Yustnust/AQUA-EXPO/docs/O1CN01f1KN331kBSWhVPPSg_!!385014645.webp

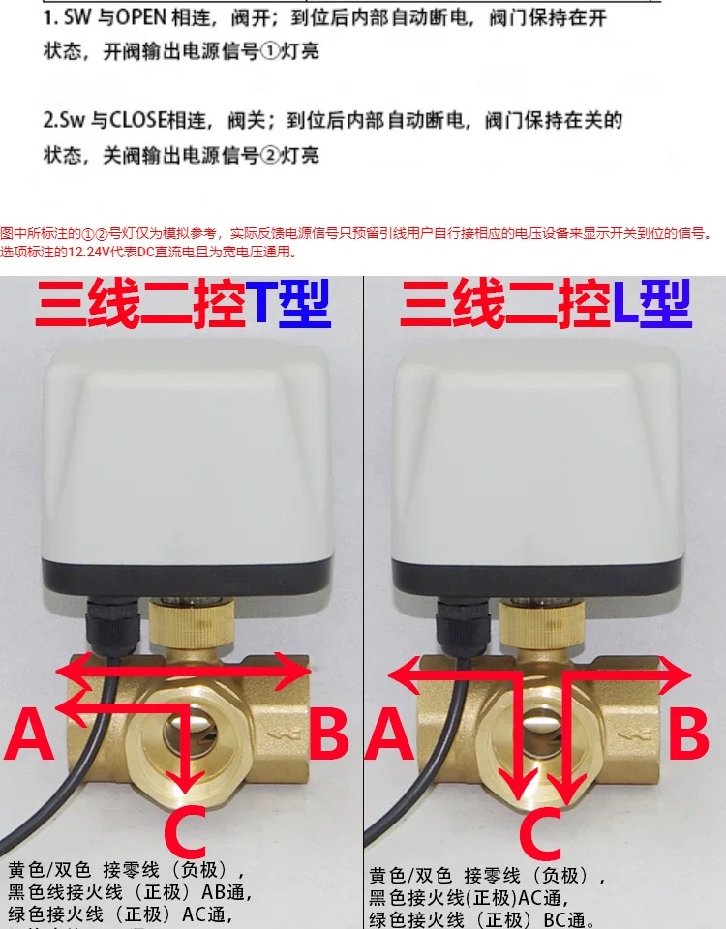
docs/O1CN01f1KN331kBSWhVPPSg_!!385014645.webp
