Yustnust/AQUA-EXPO/docs/picture/State_fail-1.jpg

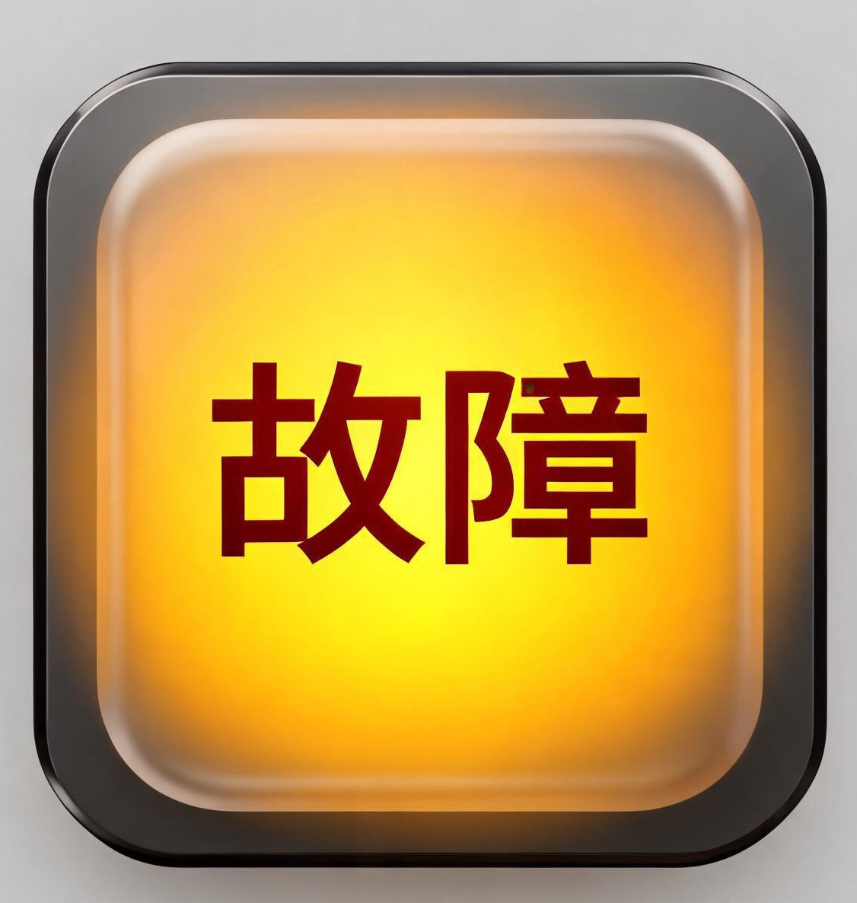
docs/picture/State_fail-1.jpg
