Yustnust/AQUA-EXPO/docs/需求追溯矩阵_v1.0.md

# 药液配置加注控制系统 — 需求追溯矩阵 v1.2

| 项目 | 内容 |
|---|---|
| 文档名称 | 需求追溯矩阵（RTM） |
| 版本号 | v1.2 |
| 编制日期 | 2026-07-18 |
| 修订日期 | 2026-08-27 |
| 修订内容 | v1.1: 新增 REQ-059;**v1.2: 新增 REQ-060 S4 等待计时、REQ-061 S4 等待超时报警、REQ-062 S6 转 S6 阈值补偿** |
| 适用范围 | 单套缸单元（8套架构中任一套，PLC程序完全相同，仅IP不同） |
| 修订日期 | 2026-08-27 |
| 修订内容 | 新增 REQ-059 S4 下缸空互锁需求;REQ-006(S4 上→下转移)实现说明补充 v1.1 互锁逻辑;测试用例基线增至 111 条(TC-04-013~017) |
| 追溯范围 | 需求 → Story → 代码（FC）→ 变量地址 → 测试用例 → 状态 |
| 配套文档 | 《药液配置加注控制系统_PLC设计文档》v9.3;《HMI-PLC变量地址表》v1.0;《SAT_FAT验收测试用例》v1.1;《项目交付文档总索引》v1.0;plc/stl/ 下20个FC源文件(v1.1) |
| PLC代码基线 | commit 48426d5(v1.0),v1.1 在 master 分支新增 S4 互锁 |
测试用例基线 | 114条(必测 109 + 选测 5)

---

## 0. 追溯范围说明与图例

### 0.1 追溯范围说明

本文档建立"需求→Story→代码→变量→测试用例→状态"的完整双向追溯链，覆盖：

1. **需求侧**：从《PLC设计文档》v9.3 第1~12章提取的功能需求（共58条，REQ-001~REQ-058）
2. **Story侧**：项目已规划的7个Story（Story 1.1~1.7，对应AQEX-2~AQEX-11，AQEX-1为项目设计文档定稿）
3. **代码侧**：plc/stl/ 下20个FC源文件（OB1 + FC0/1/2/3/4 + FC10~19 + FC30/31/32 + FC40）
4. **变量侧**：依据《HMI-PLC变量地址表》v1.0，逐FC映射关键变量地址（V区/I区/Q区/DT区）
5. **测试侧**：《SAT_FAT验收测试用例》v1.0 的106条用例（TC-03-001~TC-11-005）

### 0.2 状态图例

| 实现状态 | 含义 |
|---|---|
| ✅ 已实现 | 代码已完整实现该需求，逻辑正确 |
| 🟡 部分实现 | 代码骨架已搭建，但部分逻辑未完成（如FC4 Modbus轮询待Story 1.1填充） |
| ❌ 未实现 | 设计文档有要求，但代码尚未实现（如手动控制） |
| ➖ 不适用 | 该需求不在当前Story交付范围内 |

| 测试状态 | 含义 |
|---|---|
| ✅ 已覆盖 | 至少1条测试用例覆盖该需求 |
| ❌ 未覆盖 | 无任何测试用例覆盖该需求（风险项，见第6章） |

---

## 第1章 需求清单

从《PLC设计文档》v9.3 各章节提取的58条功能需求，每项含：需求ID、描述、来源章节、优先级、验收标准。

### 1.1 顶层状态机需求（REQ-001~REQ-011）

| 需求ID | 需求描述 | 来源（设计文档章节） | 优先级 | 验收标准 |
|---|---|---|---|---|
| REQ-001 | S0 初始化状态：上下缸状态强制置空，所有阀门/泵输出复位为OFF，等待HMI启动命令 | 第四章 S0 | 高 | VW2=0；V1.6=0；V1.7=0；QB0=0；CMD_Start上升沿转S1 |
| REQ-002 | S1 上缸进水：阀A开启，差值法计量进水量，达标关阀，漫溢监测 | 第四章 S1 | 高 | VW2=1；Q0.2=1；VD82=快照；VD90≥目标进水量→关阀 |
| REQ-003 | S2 潜水泵预循环搅拌：潜水泵1/2开启，按VD_S2_Target计时 | 第四章 S2 | 高 | VW2=2；Q0.0=1；Q0.1=1；T38≥VD_S2_Target→转S3 |
| REQ-004 | S3 加药：步数控制（VD_Dose_Steps）+Modbus下发抽/排液指令+状态码轮询 | 第四章 S3 | 高 | VW2=3；VW204/VW206写入步数；VW4=0→转S3.5 |
| REQ-005 | S3.5 静止等候：按VD_RestTime_Target计时沉降 | 第四章 S3.5 | 高 | VW2=4；T39≥VD_RestTime_Target→转S4 |
| REQ-006 | S4 上→下转移:阀B开启,四态诊断+液位计B漫溢保护,正常排空后转S5;**v1.1新增** 开阀B前需 V1.7=0(下缸已排空),否则静默等待 S6 排空后自动开阀,节拍保持并行 | 第四章 S4 | 高 | VW2=5;Q0.3=1;VW268=1→转S5;V1.7=1;DT10写入;**v1.1** `AN V1.7` 互锁;**v1.2** S4 等待时长记录到 VD380(VD_S4Wait_Time),S4 完成时清零;FC16 转 S6 阈值减去 VD380 补偿 |
| REQ-007 | S5 实验运行：换水周期计时（VD_S5_Elapsed）+实验时长累加+预规划上升沿触发 | 第四章 S5 | 高 | VW2=6；VD_S5_Elapsed累加；达周期→转S6；达实验时长→转S7 |
| REQ-008 | S6 下缸排水：阀C开启，四态诊断，正常排空后滚动更新VD_S6_Rolling并返回S5 | 第四章 S6 | 高 | VW2=7；Q0.4=1；VW270=1→转S5；VD78=实测时长；V1.7=0 |
| REQ-009 | S7 实验结束：状态机锁定，所有输出停，HMI确认CMD_Start才能回S0 | 第四章 S7 | 高 | VW2=8；QB0=0；CMD_Start上升沿→VW2=0 |
| REQ-010 | S_ERROR 故障锁定：急停/最高级报警触发，强制QB0=0，需系统复位 | 第四章 + 第九章 | 高 | VW2=99；QB0=0；V300.4置位；I0.3上升沿+I1.1=ON→回S0 |
| REQ-011 | 非法状态值处理：VW2为非法值（非0~8/99）时强制回S0 | FC1设计 | 中 | 强制VW2=50→下一扫描周期VW2=0 |

### 1.2 阀A诊断需求（REQ-012~REQ-015）

| 需求ID | 需求描述 | 来源（设计文档章节） | 优先级 | 验收标准 |
|---|---|---|---|---|
| REQ-012 | 阀A差值法计量：流量计无清零功能，阀A开瞬间快照VD_FlowMeter_Snapshot，差值计算进水量 | 第二章 + 第四章S1 + 第五章 | 高 | VD82=开阀瞬间值；VD90=VD86−VD82；VD90≥目标→关阀 |
| REQ-013 | 阀A关后延时验证4项并行：流量开关A=OFF / 内漏差值不增 / 关到位I8.1=ON / 关到位但仍有流交叉验证 | 第五章 | 高 | 4项全通过→VW266=1；任一失败→报警+S_ERROR |
| REQ-014 | 阀A开到位反馈交叉诊断：I8.0超时→V301.4；开到位但无流→V301.5 | 第五章 | 高 | I8.0超时→V301.4=1；I8.0=ON且I0.0=OFF→V301.5=1 |
| REQ-015 | 阀A漫溢保护：液位计A-高位I0.5=ON→关阀A+NC球阀上缸+报警 | 第五章 + 第八章 | 高 | I0.5=ON→V300.0=1；V300.2=1；Q0.5=1；Q0.2=0；VW2=99 |

### 1.3 阀B诊断需求（REQ-016~REQ-019）

| 需求ID | 需求描述 | 来源（设计文档章节） | 优先级 | 验收标准 |
|---|---|---|---|---|
| REQ-016 | 阀B四态诊断：流量开关B+液位计A-低位四态扫描，OFF+OFF→设备故障报警 | 第六章 阀B | 高 | I0.1=OFF且I0.6=OFF→V302.0=1+S_ERROR |
| REQ-017 | 阀B开关到位交叉诊断：I8.2开到位超时→V302.1；I8.3关到位但仍有流→V302.4 | 第六章 阀B | 高 | I8.2超时→V302.1；I8.3=ON且I0.1=ON→V302.4 |
| REQ-018 | 阀B超时保护：T53开到位超时+T54流量开关超时（两套独立判据） | 第六章 阀B | 高 | T53超时→V302.1；T54超时且I0.1=OFF→V302.2 |
| REQ-019 | 阀B漫溢保护：液位计B-高位I0.7=ON→关阀B+NC球阀下缸+报警 | 第六章 阀B | 高 | I0.7=ON→V300.1=1；V300.3=1；Q0.6=1；Q0.3=0；VW2=99 |

### 1.4 阀C诊断需求（REQ-020~REQ-022）

| 需求ID | 需求描述 | 来源（设计文档章节） | 优先级 | 验收标准 |
|---|---|---|---|---|
| REQ-020 | 阀C四态诊断：流量开关C+液位计B-低位四态扫描，OFF+OFF→设备故障报警 | 第六章 阀C | 高 | I0.2=OFF且I1.0=OFF→V302.5=1+S_ERROR |
| REQ-021 | 阀C开关到位交叉诊断：I8.4开到位超时→V302.6；I8.5关到位但仍有流→V303.1 | 第六章 阀C | 高 | I8.4超时→V302.6；I8.5=ON且I0.2=ON→V303.1 |
| REQ-022 | 阀C超时保护：T56开到位超时+T57流量开关超时（阀C无漫溢保护） | 第六章 阀C | 高 | T56超时→V302.6；T57超时且I0.2=OFF→V302.7 |

### 1.5 泵与Modbus通讯需求（REQ-023~REQ-026）

| 需求ID | 需求描述 | 来源（设计文档章节） | 优先级 | 验收标准 |
|---|---|---|---|---|
| ~~REQ-023~~ | ~~潜水泵1/2超时保护：启动后VD_Timeout_Pump1/2内流量开关未到→报警~~ | ~~第六章 泵超时~~ | ~~中~~ | **已移除**（潜水泵1/2流量开关取消，I0.3/I0.4不再使用） |
| REQ-024 | 注射泵Modbus寄存器读写：40002强停/40003复位/40006抽液/40007排液步数 | 第二章 + 第十一章 | 高 | VW200=1→40002=1；VW204=步数→40006；VW206=步数→40007 |
| REQ-025 | 注射泵状态码轮询：41001→VW4映射，0=完成/1=运行/2=抽液/3=排液/其他=错误→V303.4 | 第二章 + 第十一章 | 高 | VW4=0→可下发；VW4≥4→V303.4=1+S_ERROR |
| REQ-026 | 流量计Modbus差值法读取：0x0009累计值只读无清零，差值法计算 | 第二章 + 第十一章 | 高 | VD86=当前累计值；VD90=VD86−VD82 |

### 1.6 报警系统需求（REQ-027~REQ-034）

| 需求ID | 需求描述 | 来源（设计文档章节） | 优先级 | 验收标准 |
|---|---|---|---|---|
| REQ-027 | 32位报警字编码：VB300~VB303按位编码，HMI解析活动报警 | 第八章 8.1 + 变量表9.1 | 高 | 32位定义完整，VB300~303每位对应1个报警类型 |
| REQ-028 | 报警优先级链计算VW6：99>10~14>20~21>30~36>40~47>60~66 | 第八章 8.1 | 高 | 同步触发多个报警时VW6保存最高优先级 |
| REQ-029 | 消音逻辑：I0.4就地按钮或V0.4 HMI命令上升沿，仅关Q0.7声音，灯光报警保持 | 第八章 8.2 | 高 | I0.4/V0.4上升沿→Q0.7=0；Q8.0保持；V1.4=1握手 |
| REQ-030 | 消光逻辑：V0.3 HMI确认上升沿，根本原因消失才复位报警位+Q8.0 | 第八章 8.2 | 高 | V0.3上升沿+条件消失→R报警位；下周期VW6=0→Q8.0=0 |
| REQ-031 | 自动恢复模式（V200.0=0）：一般故障级条件消失自动复位 | 第八章 8.1 | 中 | V200.0=0时V301.x/V302.x/V303.x条件消失自动R |
| REQ-032 | 人工确认模式（V200.0=1）：一般故障级需HMI V0.3确认才复位 | 第八章 8.1 | 中 | V200.0=1时条件消失报警位保持，需V0.3确认 |
| REQ-033 | 高优先级强制人工确认：漫溢/节奏滞后/继电器故障不受V200.0模式影响 | 第八章 8.1 | 高 | V300.0~5/V300.6/7不受自动恢复影响，强制人工确认 |
| REQ-034 | 报警日志：新报警触发写入VB500~599缓冲区，含时间戳+单元+报警码+动作 | 第八章 8.3 | 低 | 新报警VW6由0变非0→VB500起写入日志条目 |

### 1.7 急停与安全需求（REQ-035~REQ-039）

| 需求ID | 需求描述 | 来源（设计文档章节） | 优先级 | 验收标准 |
|---|---|---|---|---|
| REQ-035 | 急停双通道：第一组常闭→安全继电器硬线切断动力；第二组常闭→I1.1 PLC感知 | 第九章 9.1 | 高 | I1.1=OFF→V300.4=1+VW2=99；硬线独立于PLC |
| REQ-036 | 安全继电器反馈延时校验：T35=2秒，2秒内I1.2=ON正常，超时→V300.5 | 第九章 9.2 | 高 | V300.4=1且I1.2=OFF→T35计时；T35到→V300.5=1 |
| REQ-037 | 继电器故障最高级报警（V300.5）：优先级99，不允许任何自动恢复 | 第九章 9.4 | 高 | V300.5=1→VW6=99；系统复位按钮无效 |
| REQ-038 | 急停解除+系统复位按钮（I0.3）：I1.1=ON+I0.3上升沿+V300.5=0→回S0 | 第九章 9.3 | 高 | 三条件全满足→V300.4=0；V1.6/V1.7=0；VW2=0 |
| REQ-039 | 继电器故障HMI高权限确认（V0.7+I1.2）：V0.7上升沿+I1.2=ON→清V300.5 | 第九章 9.4 | 高 | V0.7上升沿+I1.2=ON→R V300.5；I1.2=OFF则保持 |

### 1.8 节奏纠偏需求（REQ-040~REQ-044）

| 需求ID | 需求描述 | 来源（设计文档章节） | 优先级 | 验收标准 |
|---|---|---|---|---|
| REQ-040 | 三层纠偏算法：第0层压缩静止等候→第1层压缩S2→第2层顺延周期 | 第七章 7.2 | 高 | 三层额度VD162/VD166/VD170按序扣减，输出VD120/124/128 |
| REQ-041 | S5上升沿预规划触发：Available≤T_Rolling上升沿，本轮仅触发1次 | 第七章 7.2 | 高 | M10.7锁存；FC40模式0；本轮不再重复触发 |
| REQ-042 | S1完成后二次校正：用S1实测值重核VD_S2_Target/VD_RestTime_Target | 第七章 7.3 | 高 | VW266=1→FC40模式1；VW182=1；VD_T_Rolling更新 |
| REQ-043 | 节奏滞后人工介入报警（V300.6）：三层额度用尽→V300.6=1+VW2=99 | 第七章 7.4 | 高 | Δ>三层额度→V300.6=1；VW184=4；VW2=99 |
| REQ-044 | T_Rolling滚动更新：取标称值（S1实测+S2标称+S3估算+S3.5标称） | 第七章 7.5 | 中 | VD112=VD70+VD28+VD174+VD36（取标称不取压缩值） |

### 1.9 断电恢复需求（REQ-045~REQ-049）

| 需求ID | 需求描述 | 来源（设计文档章节） | 优先级 | 验收标准 |
|---|---|---|---|---|
| REQ-045 | 冷启动全部清零（V304.0=0）：VW2/V1.6/V1.7/QB0/V300~303/VW6/VW8清零 | 第十章 + FC0 | 高 | V304.0=0→全部清零；V304.0置1 |
| REQ-046 | 断电恢复状态策略：S0/S5/S7/S_ERROR保持，S1~S6转S_ERROR+V300.4 | 第十章 | 高 | VW2=1~5/7→VW2=99+V300.4=1+QB0=0 |
| REQ-047 | VD_S5_Elapsed重算：仅保持S5且下缸=满时VD178=RTC秒−DT10秒 | 第十章 + FC0 NETWORK6 | 高 | V1.7=1且VW2=6→VD178=VD186−VD190 |
| REQ-048 | RTC丢失检测：开机RTC<DT10→V303.5=1+S_ERROR，DT10未写入则跳过 | 第十章 | 高 | RTC<DT10→V303.5=1；VB10=0→跳过 |
| REQ-049 | 断电保持区配置：超级电容典型7天/最小6天保持 | 第十章 + 变量表附录A | 高 | VB0~9/10~149/150~199/200~229/300~304/500~599/DT10断电保持 |

### 1.10 换水周期与实验时长需求（REQ-050~REQ-052）

| 需求ID | 需求描述 | 来源（设计文档章节） | 优先级 | 验收标准 |
|---|---|---|---|---|
| REQ-050 | 下缸变满时间戳DT10：阀B正常关闭完成时READ_RTC写入DT10 | 第十章 | 高 | VW268=1→READ_RTC VB900→VB10~17 |
| REQ-051 | 实验时长累加：仅下缸=满期间VD96每分钟+1 | 第十章 | 高 | V1.7=1时T47每60秒→VD96+1；V1.7=0停止 |
| REQ-052 | 实验结束判定：VD96≥VD_ExperimentTarget→转S7 | 第四章 + 第十章 | 高 | VD96≥VD24→VW2=8；QB0=0；M10.6=1 |

### 1.11 手动控制与HMI接口需求（REQ-053~REQ-055）

| 需求ID | 需求描述 | 来源（设计文档章节） | 优先级 | 验收标准 |
|---|---|---|---|---|
| REQ-053 | HMI手动控制（V306.0~V307.3）：仅S0/S_ERROR响应，安全联锁仍生效 | 变量表4.4 | 中 | V306.0~V307.3上升沿+VW2=0/99→执行；联锁校验 |
| REQ-054 | 系统命令位V0区：CMD_Start/Stop/AckAlarm/Mute/ForceTank/SafetyRelayAck | 变量表4.1 | 高 | V0.0~V0.7上升沿+握手V1.x |
| REQ-055 | 系统状态位V1区握手：V1.0~V1.5命令确认，V1.6/V1.7上下缸状态 | 变量表4.2 | 高 | PLC置V1.x=1确认；HMI读V1.6/V1.7显示 |

### 1.12 漫溢保护与NC阀需求（REQ-056~REQ-058）

| 需求ID | 需求描述 | 来源（设计文档章节） | 优先级 | 验收标准 |
|---|---|---|---|---|
| REQ-056 | NC球阀-上缸失效安全保护：常闭型，阀A失效时第二道保护，得电打开/失电关闭 | 第二章 2.2 + 第五章 | 高 | I0.5=ON→Q0.5=1（得电打开保护）；失电关闭=安全 |
| REQ-057 | NC球阀-下缸失效安全保护：常闭型，阀B/液位计B报警时第二道保护 | 第二章 2.2 + 第六章 | 高 | I0.7=ON→Q0.6=1；失电关闭=安全 |
| REQ-058 | 故障态输出强制安全双保险：FC2 NETWORK3（急停锁存时）+FC19 NETWORK1（S_ERROR态）每周期强制QB0=0 | 第九章 + FC19 | 高 | V300.4=1或VW2=99→QB0=0；Q0.7=1声音 |
| REQ-059 | **v1.1新增** S4 下缸空互锁:FC15 进入 S4/开阀 B 前校验 V1.7=0,下缸未空时静默等待(不报错、不停机),每周期轮询直至 S6 排空完成自动放行;节拍保持并行——S1~S3.5 上缸配液可与 S6 下缸排水同时进行 | 第四章 S4 (v1.1) | 高 | V1.7=0 开阀B;V1.7=1 屏蔽本FC所有S/R/计时/赋值指令;每周期重检 |
| REQ-060 | **v1.2新增** S4 等待计时:FC15 NETWORK 1 等待计时分支,下缸未空期间 V1.7=1 持续时间累加到 VD_S4Wait_Time(VD380),S4 完成时清零 | 第四章 S4 (v1.2) | 高 | V1.7=1 期间 VD380 每秒 +1;S4 完成时 VD380=0 |
| REQ-061 | **v1.2新增** S4 等待超时报警:VD_S4Wait_Time >= VD_S4WaitTimeout(VD382,默认 1800s=30min)→ V303.2 + VW6=49;仅报警不强制 S_ERROR | 第四章 S4 (v1.2) | 高 | T61(100ms)到 → 置位 V303.2;VW6=49;S4 继续等待;操作员 HMI 提示 |
| REQ-062 | **v1.2新增** S5 转 S6 阈值补偿:FC16 NETWORK 4 转 S6 判据 = `VD_S5_Elapsed >= CycleSetpoint×60 - VD_S4Wait_Time`,保证下缸有效实验时间严格按 VD_CycleSetpoint 跑满,不被 S4 等待压缩 | 第四章 S5 (v1.2) | 高 | 阈值减去 VD380;S5 进入(V1.7=1 后)实际下缸跑满 VD_CycleSetpoint 后即转 S6 |
| REQ-059 | S4 下缸空互锁:v1.1 新增需求,FC15 进入 S4/开阀 B 前校验 V1.7=0,下缸未空时静默等待(不报错、不停机),每周期轮询直至 S6 排空完成自动放行;节拍保持并行——S1~S3.5 上缸配液可与 S6 下缸排水同时进行 | 第四章 S4 (v1.1) | 高 | V1.7=0 开阀B;V1.7=1 屏蔽本FC所有S/R/计时/赋值指令;每周期重检 |
---

## 第2章 Story清单

依据《项目交付文档总索引》v1.0 第三章（PLC程序规格书）与第四章（PLC程序代码），7个Story与AQEX编号对应关系如下：

| Story编号 | AQEX编号 | Story标题 | 覆盖的需求ID | 交付的FC文件 |
|---|---|---|---|---|
| Story 1.1 | AQEX-2 | Modbus通讯轮询详细设计 | REQ-024, REQ-025, REQ-026 | FC4_ModbusPolling.stl（**仅骨架，未完整交付**） |
| Story 1.2 | AQEX-6 | 状态机骨架 | REQ-001~011, REQ-050~052, REQ-054, REQ-055, REQ-058 | OB1_MAIN.stl, FC0_SysInit.stl, FC1_StateDispatcher.stl, FC2_EStopHandling.stl, FC3_AlarmHandling.stl, FC4_ModbusPolling.stl, FC10~FC18（共15个FC） |
| Story 1.3 | AQEX-7 | 阀门诊断 | REQ-012~022, REQ-056, REQ-057 | FC30_ValveA_Diag.stl, FC31_ValveB_Diag.stl, FC32_ValveC_Diag.stl（FC11/15/17集成调用） |
| Story 1.4 | AQEX-8 | 节奏纠偏 | REQ-040, REQ-041, REQ-042, REQ-043, REQ-044 | FC40_RhythmCorrection.stl（FC11/FC16集成调用） |
| Story 1.5 | AQEX-9 | 急停详细 | REQ-035, REQ-036, REQ-037, REQ-038, REQ-039 | FC2_EStopHandling.stl（改写）, FC19_State_Error.stl |
| Story 1.6 | AQEX-10 | 报警详细 | REQ-027, REQ-028, REQ-029, REQ-030, REQ-031, REQ-032, REQ-033, REQ-034 | FC3_AlarmHandling.stl（改写） |
| Story 1.7 | AQEX-11 | 断电恢复 | REQ-045, REQ-046, REQ-047, REQ-048, REQ-049 | FC0_SysInit.stl（改写为双路径） |
| Story 1.7 扩展 | AQEX-51 | PLC 长时间停机后 HMI 校时 | REQ-045 扩展（断电恢复时 RTC 异常不直接进 S_ERROR，置 V303.7 请求 HMI 校时，5 分钟超时后进 S_ERROR） | FC0_SysInit.stl（新增 RTC 合法性检查+DT10 合法性检查+请求校时分支）、FC22_RTC_Sync.stl（新增）、OB1_MAIN.stl（调度顺序调整）、McgsPro 侧 V303.7/V0.6/VB900~VB905 共 8 个变量 |

> **说明**：
> 1. AQEX-1 为项目需求与PLC设计文档v9.3定稿Story，无FC交付，本文档不单独追溯。
> 2. Story 1.1（AQEX-2）的FC4仅为骨架（MBUS_CTRL已调用，MBUS_MSG调用注释"待Story 1.1确认站号后填入"），完整Modbus轮询时序、错误处理、超时检测**未交付**，见第6章缺口。
> 3. Story 1.2~1.7 六个迭代已交付完整PLC程序，经2轮校验10个问题全修复（commit 48426d5）。

---

## 第3章 追溯矩阵（主表）

每行一个需求，列含：需求ID、需求描述、Story、实现FC、关键变量地址、测试用例、实现状态、测试状态、备注。

### 3.1 状态机主线（REQ-001~REQ-011）

| 需求ID | 需求描述 | Story | 实现FC | 关键变量地址 | 测试用例编号 | 实现状态 | 测试状态 | 备注 |
|---|---|---|---|---|---|---|---|---|
| REQ-001 | S0 初始化状态 | 1.2 | FC10_State_S0_Init.stl | VW2, V0.0, V1.0, V1.6, V1.7, QB0, VW6 | TC-04-001, TC-09-001 | ✅ 已实现 | ✅ 已覆盖 | 等HMI启动，无报警才转S1 |
| REQ-002 | S1 上缸进水 | 1.2 | FC11_State_S1_Inlet.stl | VW2, Q0.2, VD82, VD86, VD90, M10.2, T37 | TC-04-002, TC-04-003 | ✅ 已实现 | ✅ 已覆盖 | 调FC30诊断+FC40二次校正 |
| REQ-003 | S2 潜水泵预循环 | 1.2 | FC12_State_S2_PreMix.stl | VW2, Q0.0, Q0.1, VD120, VW252, T38 | TC-04-004 | ✅ 已实现 | ✅ 已覆盖 | A1修复：PT转换；潜水泵1/2流量开关取消，泵超时保护移除 |
| REQ-004 | S3 加药步数控制 | 1.2 | FC13_State_S3_Dosing.stl | VW2, VD10, VD14, VD18, VD90, VD98, VD102, VW204, VW206, VW4, V303.4, M10.3 | TC-04-005, TC-10-002, TC-10-003 | 🟡 部分实现 | ✅ 已覆盖 | 注射泵速度/复位/超时未实现（待Story 1.1） |
| REQ-005 | S3.5 静止等候 | 1.2 | FC14_State_S35_Rest.stl | VW2, VD124, VW254, T39 | TC-04-006 | ✅ 已实现 | ✅ 已覆盖 | A2修复：PT转换 |
| REQ-006 | S4 上→下转移 | 1.2 | FC15_State_S4_Transfer.stl | VW2, Q0.3, V1.6, V1.7, VW268, DT10, VD178, M10.7, VD50, VW274 | TC-04-007 | ✅ 已实现 | ✅ 已覆盖 | 调FC31诊断，记录DT10时间戳 |
| REQ-007 | S5 实验运行 | 1.2 | FC16_State_S5_Run.stl | VW2, V1.7, VD178, VD20, VD116, VD112, VD150, VD96, VD24, M10.7, T60, T47, V0.2 | TC-04-008, TC-06-008, TC-06-009 | ✅ 已实现 | ✅ 已覆盖 | 调FC40预规划，实验时长累加 |
| REQ-008 | S6 下缸排水 | 1.2 | FC17_State_S6_Drain.stl | VW2, Q0.4, VW270, VD78, VD116, V1.7, M10.6, VD54, VW276 | TC-04-009 | ✅ 已实现 | ✅ 已覆盖 | 调FC32诊断，更新VD_S6_Rolling |
| REQ-009 | S7 实验结束 | 1.2 | FC18_State_S7_End.stl | VW2, QB0, Q0.7, Q8.0, VD96, M10.6, V0.0 | TC-04-010, TC-04-011 | ✅ 已实现 | ✅ 已覆盖 | 锁定态，HMI确认重启 |
| REQ-010 | S_ERROR 故障锁定 | 1.2+1.5 | FC19_State_Error.stl, FC2_EStopHandling.stl | VW2, QB0, Q0.7, V300.4, V300.5, V0.7, I1.1, I1.2, I0.3, V1.6, V1.7 | TC-04-012, TC-07-001, TC-07-008 | ✅ 已实现 | ✅ 已覆盖 | 双保险强制QB0=0 |
| REQ-011 | 非法状态值强制回S0 | 1.2 | FC1_StateDispatcher.stl (NETWORK 12) | VW2 | TC-04-012 | ✅ 已实现 | ✅ 已覆盖 | ELSE分支MOVB 0,VB2 |

### 3.2 阀A诊断（REQ-012~REQ-015）

| 需求ID | 需求描述 | Story | 实现FC | 关键变量地址 | 测试用例编号 | 实现状态 | 测试状态 | 备注 |
|---|---|---|---|---|---|---|---|---|
| REQ-012 | 阀A差值法计量 | 1.2+1.3 | FC11_State_S1_Inlet.stl, FC30_ValveA_Diag.stl | VD82(快照), VD86(当前), VD90(差值), VD316(目标), VW260, VW266 | TC-04-002, TC-04-003, TC-10-006, TC-10-007 | ✅ 已实现 | ✅ 已覆盖 | 流量计无清零，差值法 |
| REQ-013 | 阀A关后延时验证4项 | 1.3 | FC30_ValveA_Diag.stl (NETWORK 7~9) | T51, VW280, VD308, VD312, I0.0, I8.1, V301.0, V301.1, V301.2, V301.3 | TC-05-003, TC-05-004, TC-05-005, TC-05-006 | ✅ 已实现 | ✅ 已覆盖 | 内漏阈值0.1L待现场整定 |
| REQ-014 | 阀A开到位反馈诊断 | 1.3 | FC30_ValveA_Diag.stl (NETWORK 4~5) | T50, VW278, I8.0, I0.0, T52, V301.4, V301.5 | TC-05-001, TC-05-002 | ✅ 已实现 | ✅ 已覆盖 | 2s延时确认避免瞬时波动 |
| REQ-015 | 阀A漫溢保护 | 1.3 | FC30_ValveA_Diag.stl (NETWORK 1) | I0.5, V300.0, V300.2, Q0.5, Q0.2, VW2 | TC-03-006 | ✅ 已实现 | ✅ 已覆盖 | 全程最高优先级，转S_ERROR |

### 3.3 阀B诊断（REQ-016~REQ-019）

| 需求ID | 需求描述 | Story | 实现FC | 关键变量地址 | 测试用例编号 | 实现状态 | 测试状态 | 备注 |
|---|---|---|---|---|---|---|---|---|
| REQ-016 | 阀B四态诊断 | 1.3 | FC31_ValveB_Diag.stl (NETWORK 6) | VW262, I0.1, I0.6, Q0.3, V302.0, VW268 | TC-05-007 | ✅ 已实现 | ✅ 已覆盖 | 状态4需排除瞬时，加延时确认（待现场） |
| REQ-017 | 阀B开关到位交叉诊断 | 1.3 | FC31_ValveB_Diag.stl (NETWORK 4, 7) | I8.2, I8.3, T53, T55, V302.1, V302.3, V302.4 | TC-05-008, TC-05-009 | ✅ 已实现 | ✅ 已覆盖 | 关到位但仍有流=内漏 |
| REQ-018 | 阀B超时保护 | 1.3 | FC31_ValveB_Diag.stl (NETWORK 4) | T53, T54, VW274, VD50, V302.1, V302.2 | TC-05-008 | ✅ 已实现 | ✅ 已覆盖 | 两套独立判据互相印证 |
| REQ-019 | 阀B漫溢保护 | 1.3 | FC31_ValveB_Diag.stl (NETWORK 1) | I0.7, V300.1, V300.3, Q0.6, Q0.3, VW2 | TC-03-008 | ✅ 已实现 | ✅ 已覆盖 | 不管四态处于哪个状态 |

### 3.4 阀C诊断（REQ-020~REQ-022）

| 需求ID | 需求描述 | Story | 实现FC | 关键变量地址 | 测试用例编号 | 实现状态 | 测试状态 | 备注 |
|---|---|---|---|---|---|---|---|---|
| REQ-020 | 阀C四态诊断 | 1.3 | FC32_ValveC_Diag.stl (NETWORK 5) | VW264, I0.2, I1.0, Q0.4, V302.5, VW270 | TC-05-010 | ✅ 已实现 | ✅ 已覆盖 | 阀C无漫溢保护 |
| REQ-021 | 阀C开关到位交叉诊断 | 1.3 | FC32_ValveC_Diag.stl (NETWORK 3, 6) | I8.4, I8.5, T56, T58, V302.6, V303.0, V303.1 | TC-05-011, TC-05-012 | ✅ 已实现 | ✅ 已覆盖 | VW270用MOVW写完整WORD |
| REQ-022 | 阀C超时保护 | 1.3 | FC32_ValveC_Diag.stl (NETWORK 3) | T56, T57, VW276, VD54, V302.6, V302.7 | TC-05-010 | ✅ 已实现 | ✅ 已覆盖 | 阀C无漫溢保护 |

### 3.5 泵与Modbus通讯（REQ-023~REQ-026）

| 需求ID | 需求描述 | Story | 实现FC | 关键变量地址 | 测试用例编号 | 实现状态 | 测试状态 | 备注 |
|---|---|---|---|---|---|---|---|---|
| ~~REQ-023~~ | ~~潜水泵1/2超时保护~~ | ~~1.2+1.3~~ | ~~FC12_State_S2_PreMix.stl (NETWORK 2)~~ | ~~Q0.0, Q0.1, I0.3, I0.4, T44, T45, VW282, VW284, VD58, VD62, V303.2, V303.3~~ | ~~TC-03-004, TC-03-005~~ | **已移除** | **已移除** | 潜水泵1/2流量开关取消，I0.3/I0.4不再使用 |
| REQ-024 | 注射泵Modbus寄存器读写 | 1.1+1.2 | FC4_ModbusPolling.stl, FC13_State_S3_Dosing.stl | VW200, VW202, VW204, VW206, VW208, VW210, VW212, M10.3 | TC-10-001, TC-10-002, TC-10-003, TC-10-005 | 🟡 部分实现 | ✅ 已覆盖 | FC4仅骨架，MBUS_MSG待填参数 |
| REQ-025 | 注射泵状态码轮询与故障 | 1.1+1.2 | FC4_ModbusPolling.stl, FC13_State_S3_Dosing.stl (NETWORK 3) | VW4, V303.4, VW2 | TC-10-004, TC-10-008 | 🟡 部分实现 | ✅ 已覆盖 | VW4≥4→V303.4已实现；超时检测未实现 |
| REQ-026 | 流量计Modbus差值法 | 1.1+1.2 | FC4_ModbusPolling.stl, FC11_State_S1_Inlet.stl, FC30_ValveA_Diag.stl | VD86, VD82, VD90, VW228 | TC-10-006, TC-10-007 | 🟡 部分实现 | ✅ 已覆盖 | FC4轮询骨架；差值法计算已实现 |

### 3.6 报警系统（REQ-027~REQ-034）

| 需求ID | 需求描述 | Story | 实现FC | 关键变量地址 | 测试用例编号 | 实现状态 | 测试状态 | 备注 |
|---|---|---|---|---|---|---|---|---|
| REQ-027 | 32位报警字编码 | 1.6 | FC3_AlarmHandling.stl (NETWORK 1) | VB300, VB301, VB302, VB303 | TC-08-001~012, TC-03-027, TC-03-028 | ✅ 已实现 | ✅ 已覆盖 | V303.7预留位见第6章 |
| REQ-028 | 报警优先级链VW6 | 1.6 | FC3_AlarmHandling.stl (NETWORK 1) | VW6, V300.0~V303.5 | TC-08-001, TC-08-002, TC-08-003 | ✅ 已实现 | ✅ 已覆盖 | JMP nCode10~nCode66逐位赋值 |
| REQ-029 | 消音逻辑 | 1.6 | FC3_AlarmHandling.stl (NETWORK 3) | I0.4, V0.4, Q0.7, M11.1, V1.4 | TC-08-004, TC-08-005, TC-08-006, TC-03-018 | ✅ 已实现 | ✅ 已覆盖 | I0.4/V0.4等效，新报警重鸣 |
| REQ-030 | 消光逻辑 | 1.6 | FC3_AlarmHandling.stl (NETWORK 4) | V0.3, V1.3, V300.0~V303.5 | TC-08-007, TC-08-008, TC-08-009, TC-08-010 | ✅ 已实现 | ✅ 已覆盖 | 条件消失才复位 |
| REQ-031 | 自动恢复模式 | 1.6 | FC3_AlarmHandling.stl (NETWORK 5) | V200.0, V301.x, V302.x, V303.x | TC-08-007, TC-08-012 | ✅ 已实现 | ✅ 已覆盖 | V200.0=0时条件消失自动R |
| REQ-032 | 人工确认模式 | 1.6 | FC3_AlarmHandling.stl (NETWORK 4~5) | V200.0, V0.3 | TC-08-008 | ✅ 已实现 | ✅ 已覆盖 | V200.0=1时不自动R，需V0.3 |
| REQ-033 | 高优先级强制人工确认 | 1.6 | FC3_AlarmHandling.stl (NETWORK 4~5) | V300.0~5, V300.6, V300.7 | TC-08-009 | ✅ 已实现 | ✅ 已覆盖 | 不受V200.0影响 |
| REQ-034 | 报警日志 | 1.6 | FC3_AlarmHandling.stl (NETWORK 6) | VB500~599, VW6, M11.2, VB508~510 | TC-08-011, TC-11-004 | 🟡 部分实现 | ✅ 已覆盖 | 简化版固定VB500起，完整环形缓冲区未实现 |

### 3.7 急停与安全（REQ-035~REQ-039）

| 需求ID | 需求描述 | Story | 实现FC | 关键变量地址 | 测试用例编号 | 实现状态 | 测试状态 | 备注 |
|---|---|---|---|---|---|---|---|---|
| REQ-035 | 急停双通道 | 1.5 | FC2_EStopHandling.stl (NETWORK 1) | I1.1, V300.4, VW2, M10.7 | TC-03-010, TC-07-001 | ✅ 已实现 | ✅ 已覆盖 | 硬线+PLC双通道独立 |
| REQ-036 | 安全继电器反馈延时T35 | 1.5 | FC2_EStopHandling.stl (NETWORK 2) | V300.4, I1.2, T35, V300.5 | TC-07-002, TC-07-003 | ✅ 已实现 | ✅ 已覆盖 | 2秒延时（PT=20×100ms） |
| REQ-037 | 继电器故障最高级报警 | 1.5 | FC2_EStopHandling.stl (NETWORK 2, 4), FC19_State_Error.stl (NETWORK 2) | V300.5, VW6 | TC-07-003, TC-08-001 | ✅ 已实现 | ✅ 已覆盖 | VW6=99最高优先级 |
| REQ-038 | 急停解除+系统复位按钮 | 1.5 | FC19_State_Error.stl (NETWORK 3) | I1.1, I0.3, V300.4, V300.5, V1.6, V1.7, VW2, VW6, Q0.7 | TC-07-004, TC-07-005, TC-03-019 | ✅ 已实现 | ✅ 已覆盖 | 三条件全满足才回S0 |
| REQ-039 | 继电器故障HMI高权限确认 | 1.5 | FC19_State_Error.stl (NETWORK 4) | V0.7, I1.2, V300.5 | TC-07-006, TC-07-007, TC-07-009 | ✅ 已实现 | ✅ 已覆盖 | V0.7+I1.2双确认 |

### 3.8 节奏纠偏（REQ-040~REQ-044）

| 需求ID | 需求描述 | Story | 实现FC | 关键变量地址 | 测试用例编号 | 实现状态 | 测试状态 | 备注 |
|---|---|---|---|---|---|---|---|---|
| REQ-040 | 三层纠偏算法 | 1.4 | FC40_RhythmCorrection.stl (NETWORK 1~5) | VD150, VD154, VD158, VD162, VD166, VD170, VD120, VD124, VD128, VW184, VD28, VD32, VD36, VD40, VD44 | TC-06-001, TC-06-002, TC-06-003, TC-06-004, TC-06-005 | ✅ 已实现 | ✅ 已覆盖 | 纯数学算法，第0/1/2层顺序扣减 |
| REQ-041 | S5上升沿预规划触发 | 1.4 | FC16_State_S5_Run.stl (NETWORK 2), FC40_RhythmCorrection.stl | VD150, VD112, M10.7, VW182, VW184, V1.6, V301.6 | TC-06-006, TC-06-010 | ✅ 已实现 | ✅ 已覆盖 | M10.7锁存，本轮只触发1次 |
| REQ-042 | S1完成后二次校正 | 1.4 | FC11_State_S1_Inlet.stl (NETWORK 3), FC40_RhythmCorrection.stl | VW266, VD150, VD154, VW182, VD120, VD124, VD174, VD112, VD70, VD28, VD36 | TC-06-007 | ✅ 已实现 | ✅ 已覆盖 | 用S1实测值重核 |
| REQ-043 | 节奏滞后人工介入报警 | 1.4 | FC40_RhythmCorrection.stl (NETWORK 5) | V300.6, VW184, VW2 | TC-06-005, TC-08-002 | ✅ 已实现 | ✅ 已覆盖 | 三层用尽→V300.6=1+VW2=99 |
| REQ-044 | T_Rolling滚动更新 | 1.4 | FC11_State_S1_Inlet.stl (NETWORK 3) | VD112, VD70, VD28, VD174, VD36 | TC-06-007, TC-11-002 | ✅ 已实现 | ✅ 已覆盖 | 取标称值不取压缩值 |

### 3.9 断电恢复（REQ-045~REQ-049）

| 需求ID | 需求描述 | Story | 实现FC | 关键变量地址 | 测试用例编号 | 实现状态 | 测试状态 | 备注 |
|---|---|---|---|---|---|---|---|---|
| REQ-045 | 冷启动全部清零 | 1.7 | FC0_SysInit.stl (NETWORK 2) | V304.0, VW2, V1.6, V1.7, QB0, QB1, V300.4, VB300~303, VW6, V1.0~V1.5, VW8, VD178, M10.7 | TC-09-001, TC-09-010 | ✅ 已实现 | ✅ 已覆盖 | V304.0=0走冷启动路径 |
| REQ-046 | 断电恢复状态策略 | 1.7 | FC0_SysInit.stl (NETWORK 7) | V304.0, VW2, QB0, V300.4 | TC-09-002, TC-09-003, TC-09-004, TC-09-005 | ✅ 已实现 | ✅ 已覆盖 | S0/S5/S7/S_ERROR保持，S1~S6转S_ERROR |
| REQ-047 | VD_S5_Elapsed重算 | 1.7 | FC0_SysInit.stl (NETWORK 4~6) | V1.7, VW2, VD186, VD190, VD178, VB900~907, VB10~17 | TC-09-002, TC-09-008 | ✅ 已实现 | ✅ 已覆盖 | P7修复：加VW2==6条件 |
| REQ-048 | RTC丢失检测 | 1.7 | FC0_SysInit.stl (NETWORK 3) | VB900~907, VB10~17, V303.5, VD178, VW2 | TC-09-006, TC-09-007 | ✅ 已实现 | ✅ 已覆盖 | VB10=0跳过检测 |
| REQ-049 | 断电保持区配置 | 1.7 | 系统块配置（非FC代码） | VB0~9, VB10~149, VB150~199, VB200~229, VB300~304, VB500~599, DT10 | TC-09-009, TC-11-003 | ✅ 已实现 | ✅ 已覆盖 | 超级电容典型7天/最小6天 |

### 3.10 换水周期与实验时长（REQ-050~REQ-052）

| 需求ID | 需求描述 | Story | 实现FC | 关键变量地址 | 测试用例编号 | 实现状态 | 测试状态 | 备注 |
|---|---|---|---|---|---|---|---|---|
| REQ-050 | 下缸变满时间戳DT10 | 1.2 | FC15_State_S4_Transfer.stl (NETWORK 3) | VW268, VB900~907, VB10~17 (DT10) | TC-04-007 | ✅ 已实现 | ✅ 已覆盖 | READ_RTC写入DT10 |
| REQ-051 | 实验时长累加 | 1.2 | FC16_State_S5_Run.stl (NETWORK 3) | V1.7, T47, VD96 | TC-04-010, TC-11-002 | ✅ 已实现 | ✅ 已覆盖 | 仅下缸=满期间累加 |
| REQ-052 | 实验结束判定 | 1.2 | FC16_State_S5_Run.stl (NETWORK 5), FC18_State_S7_End.stl | VD96, VD24, VW2, M10.6 | TC-04-010 | ✅ 已实现 | ✅ 已覆盖 | VD96≥VD24→VW2=8 |

### 3.11 手动控制与HMI接口（REQ-053~REQ-055）

| 需求ID | 需求描述 | Story | 实现FC | 关键变量地址 | 测试用例编号 | 实现状态 | 测试状态 | 备注 |
|---|---|---|---|---|---|---|---|---|
| REQ-053 | HMI手动控制（V2.4~V3.3） | 1.2（计划） | **无对应FC** | V2.4~V3.3 | 无 | ❌ 未实现 | ❌ 未覆盖 | 见第6章缺口，需新增FC |
| REQ-054 | 系统命令位V0区 | 1.2 | FC10_State_S0_Init.stl, FC16_State_S5_Run.stl, FC3_AlarmHandling.stl, FC18_State_S7_End.stl, FC19_State_Error.stl | V0.0, V0.2, V0.3, V0.4, V0.7, V1.0~V1.5 | TC-04-002, TC-04-011, TC-08-005, TC-08-008, TC-07-007 | ✅ 已实现 | ✅ 已覆盖 | V0.1暂停/V0.5/V0.6预留 |
| REQ-055 | 系统状态位V1区握手 | 1.2 | 各状态FC | V1.0~V1.5, V1.6, V1.7 | TC-04-001, TC-04-002, TC-04-007 | ✅ 已实现 | ✅ 已覆盖 | V1.6/V1.7上下缸状态 |

### 3.12 漫溢保护与NC阀（REQ-056~REQ-058）

| 需求ID | 需求描述 | Story | 实现FC | 关键变量地址 | 测试用例编号 | 实现状态 | 测试状态 | 备注 |
|---|---|---|---|---|---|---|---|---|
| REQ-056 | NC球阀-上缸失效安全 | 1.3 | FC30_ValveA_Diag.stl (NETWORK 1) | I0.5, Q0.5, V300.2 | TC-03-006, TC-03-025 | ✅ 已实现 | ✅ 已覆盖 | 常闭型，得电打开保护 |
| REQ-057 | NC球阀-下缸失效安全 | 1.3 | FC31_ValveB_Diag.stl (NETWORK 1) | I0.7, Q0.6, V300.3 | TC-03-008, TC-03-026 | ✅ 已实现 | ✅ 已覆盖 | 常闭型，得电打开保护 |
| REQ-058 | 故障态输出强制安全双保险 | 1.5 | FC2_EStopHandling.stl (NETWORK 3), FC19_State_Error.stl (NETWORK 1) | V300.4, VW2, QB0, Q0.7 | TC-07-008 | ✅ 已实现 | ✅ 已覆盖 | FC2+FC19双保险 |

---

## 第4章 代码-需求反向追溯

每个FC（共20个）对应实现的需求ID，确认无"游离FC"（无需求对应的代码）。

| FC文件名 | 功能描述 | Story | 实现的需求ID | 关键NETWORK | 反向追溯结论 |
|---|---|---|---|---|---|
| OB1_MAIN.stl | PLC主循环调度 | 1.2 | REQ-001~058（间接，调度所有FC） | NETWORK 1~5：FC0→FC2→FC4→FC3→FC1 | ✅ 非游离FC（调度入口） |
| FC0_SysInit.stl | 系统初始化（冷启动+断电恢复） | 1.2+1.7 | REQ-045, REQ-046, REQ-047, REQ-048, REQ-049 | NW1判路径/NW2冷启动/NW3 RTC检测/NW4~5 BCD转秒/NW6 Elapsed重算/NW7状态策略/NW8完成 | ✅ 非游离FC |
| FC1_StateDispatcher.stl | 状态机调度 | 1.2 | REQ-001~011（间接，按VW2调度各状态FC） | NW1状态比较/NW2~12各状态入口/NW12非法态处理 | ✅ 非游离FC |
| FC2_EStopHandling.stl | 急停处理 | 1.2+1.5 | REQ-035, REQ-036, REQ-037, REQ-058 | NW1急停检测锁存/NW2 T35延时校验/NW3输出强制安全/NW4报警码 | ✅ 非游离FC |
| FC3_AlarmHandling.stl | 报警处理 | 1.2+1.6 | REQ-027, REQ-028, REQ-029, REQ-030, REQ-031, REQ-032, REQ-033, REQ-034 | NW1优先级链/NW2输出管理/NW3消音/NW4消光确认/NW5自动恢复/NW6日志 | ✅ 非游离FC |
| FC4_ModbusPolling.stl | Modbus轮询骨架 | 1.2（1.1待完成） | REQ-024, REQ-025, REQ-026（🟡 部分实现） | NW1 MBUS_CTRL/NW2轮询骨架（MBUS_MSG参数待填） | 🟡 非游离FC，但仅骨架 |
| FC10_State_S0_Init.stl | S0初始化态 | 1.2 | REQ-001, REQ-054 | NW1安全输出/NW2启动命令检测 | ✅ 非游离FC |
| FC11_State_S1_Inlet.stl | S1上缸进水 | 1.2+1.3+1.4 | REQ-002, REQ-012, REQ-042, REQ-044 | NW1首次进入（快照+开阀）/NW2调FC30/NW3诊断结果+二次校正+转S2 | ✅ 非游离FC |
| FC12_State_S2_PreMix.stl | S2预循环 | 1.2 | REQ-003 | NW1开泵+PT转换/NW2转S3 | ✅ 非游离FC |
| FC13_State_S3_Dosing.stl | S3加药 | 1.2 | REQ-004, REQ-025 | NW1计算步数/NW2下发指令/NW3轮询状态码 | ✅ 非游离FC |
| FC14_State_S35_Rest.stl | S3.5静止等候 | 1.2 | REQ-005 | NW1 PT转换+启动T39/NW2转S4 | ✅ 非游离FC |
| FC15_State_S4_Transfer.stl | S4上→下转移 | 1.2+1.3+1.4 | REQ-006, REQ-050 | NW1首次进入（开阀B+PT转换）/NW2调FC31/NW3诊断结果+DT10+清Elapsed+转S5 | ✅ 非游离FC |
| FC16_State_S5_Run.stl | S5实验运行 | 1.2+1.4 | REQ-007, REQ-041, REQ-051, REQ-052, REQ-054 | NW1 Elapsed累加/NW2 Available+预规划/NW3实验时长累加/NW4换水周期转S6/NW5实验结束转S7/NW6手动停止 | ✅ 非游离FC |
| FC17_State_S6_Drain.stl | S6下缸排水 | 1.2+1.3 | REQ-008 | NW1首次进入（开阀C+PT转换）/NW2调FC32/NW3诊断结果+更新S6_Rolling/NW4排水后转S5或S7 | ✅ 非游离FC |
| FC18_State_S7_End.stl | S7实验结束 | 1.2 | REQ-009, REQ-054 | NW1安全停机/NW2 HMI确认重启 | ✅ 非游离FC |
| FC19_State_Error.stl | S_ERROR故障态 | 1.2+1.5 | REQ-010, REQ-038, REQ-039, REQ-058 | NW1输出强制安全/NW2继电器故障检测/NW3系统复位按钮/NW4 V0.7高权限确认 | ✅ 非游离FC |
| FC30_ValveA_Diag.stl | 阀A诊断 | 1.3 | REQ-012, REQ-013, REQ-014, REQ-015, REQ-056 | NW1漫溢保护/NW2子状态调度/NW3 S0空闲/NW4 S1等开到位/NW5 S2开启完成/NW6 S3运行中差值法/NW7 S5延时验证/NW8 4项校验/NW9结果判定 | ✅ 非游离FC |
| FC31_ValveB_Diag.stl | 阀B诊断 | 1.3 | REQ-016, REQ-017, REQ-018, REQ-019, REQ-057 | NW1漫溢保护/NW2子状态调度/NW3 S0空闲/NW4 S1等开到位/NW5 S2开启完成/NW6 S3四态诊断/NW7 S4等关到位 | ✅ 非游离FC |
| FC32_ValveC_Diag.stl | 阀C诊断 | 1.3 | REQ-020, REQ-021, REQ-022 | NW1子状态调度/NW2 S0空闲/NW3 S1等开到位/NW4 S2开启完成/NW5 S3四态诊断/NW6 S4等关到位 | ✅ 非游离FC |
| FC40_RhythmCorrection.stl | 节奏纠偏 | 1.4 | REQ-040, REQ-041, REQ-042, REQ-043 | NW1计算三层额度/NW2判断是否需纠偏/NW3第0层扣减/NW4第1层扣减/NW5第2层扣减/NW6无需纠偏/NW7结束 | ✅ 非游离FC |

**反向追溯结论**：20个FC全部可追溯到至少1个需求，**无游离FC**。FC4虽为骨架，但已对应REQ-024/025/026，待Story 1.1完整实现。

---

## 第5章 测试-需求覆盖统计

### 5.1 覆盖率统计

| 统计项 | 数值 |
|---|---|
| 需求总数 | 58 |
| 有测试覆盖的需求数 | 57 |
| 无测试覆盖的需求数 | 1 |
| 测试覆盖率 | **98.3%**（57/58） |
| 测试用例总数 | 106 |
| 必测用例数 | 101 |
| 选测用例数 | 5 |

### 5.2 各Story测试用例分布

| Story | 测试章节 | 用例ID范围 | 用例数 |
|---|---|---|---|
| 通用 | 第三章 DI/DO点位 | TC-03-001~028 | 28 |
| Story 1.2 | 第四章 状态机 | TC-04-001~012 | 12 |
| Story 1.3 | 第五章 阀门诊断 | TC-05-001~012 | 12 |
| Story 1.4 | 第六章 节奏纠偏 | TC-06-001~010 | 10 |
| Story 1.5 | 第七章 急停 | TC-07-001~009 | 9 |
| Story 1.6 | 第八章 报警 | TC-08-001~012 | 12 |
| Story 1.7 | 第九章 断电恢复 | TC-09-001~010 | 10 |
| Story 1.1/1.2 | 第十章 Modbus通讯 | TC-10-001~008 | 8 |
| Story 1.2~1.7 | 第十一章 长时稳定性 | TC-11-001~005 | 5 |
| **合计** | | | **106** |

### 5.3 无测试覆盖的需求（风险项）

| 需求ID | 需求描述 | 实现状态 | 风险说明 | 建议补测 |
|---|---|---|---|---|
| REQ-053 | HMI手动控制（V306.0~V307.3） | ✅ 已实现（FC20+FC21） | v1.8已修复VW2地址重叠，PLC侧实现完毕；缺TC-手动控制章节 | 待补TC：手开阀A/B/C、手启泵1/2、注射泵单次/循环、联锁校验（阀B需上满下空、阀C需下满） |

### 5.4 有实现但测试覆盖偏弱的需求（提示项）

| 需求ID | 需求描述 | 现有测试 | 偏弱说明 |
|---|---|---|---|
| REQ-024/025/026 | Modbus通讯 | TC-10-001~008 | FC4为骨架，测试用例假设完整实现，待Story 1.1完成后回归 |
| REQ-034 | 报警日志 | TC-08-011, TC-11-004 | 仅简化版固定VB500起，完整环形缓冲区未实现 |
| REQ-056/057 | NC球阀 | TC-03-025, TC-03-026（仅DO点位） | 缺NC阀失效安全场景测试（断电失电关闭验证） |

---

## 第6章 缺口与风险

### 6.1 未实现需求

| 需求ID | 需求描述 | 缺口说明 | 影响等级 | 责任Story | 整改建议 |
|---|---|---|---|---|---|
| REQ-053 | HMI手动控制（V306.0~V307.3） | 设计文档变量表4.4定义了12个手动命令位（v1.8地址从V2.4~V3.7迁移至V306.0~V307.3以避开VW2状态机重叠，详见变量表v1.8历史背景），FC20_ManualControl.stl已实现阀门/泵10个命令位响应（开/关阀A/B/C、启/停潜水泵1/2），FC21_ManualSyringePump.stl已实现注射泵2个命令位响应（启动/停止） | 高 | ✅ 已实现（FC20+FC21） | 仅S0态响应；安全联锁校验（阀B需上缸满下缸空、阀C需下缸满）；McgsPro CSV导入"通道地址"列须同步改为3（VB306/VB307） |
| V303.6 | ~~流量开关瞬时异常（M_Alarm_FlowSwitch_Instant）~~ | **已删除（2026-09-08）** | N/A | **已删除** | 三个流量开关各自有独立报警位（V301.0~V303.1），不再需要汇总抖动检测 |
| FC4 Modbus完整轮询 | REQ-024/025/026完整实现 | FC4_ModbusPolling.stl仅MBUS_CTRL初始化+骨架，MBUS_MSG参数（站号/地址/功能码/Done位处理/超时检测）注释"待Story 1.1确认站号后填入" | 高 | Story 1.1（AQEX-2）未交付 | 完成FC4：注射泵站号0x01+流量计站号0x02，轮询时序基于Done位顺序执行，超时2000ms/1000ms |

### 6.2 未测试需求

| 需求ID | 需求描述 | 未测试原因 | 风险 |
|---|---|---|---|
| REQ-053 | HMI手动控制 | 见6.1，未实现故无测试 | HMI手动调试页无法验收 |

### 6.3 需求变更待确认项

| 待确认项 | 来源 | 当前状态 | 影响 |
|---|---|---|---|
| IP地址规划 | 设计文档12.2 + 变量表12.1 | 示例网段192.168.2.101~108，"需现场网络环境确认后定型" | 影响HMI连接配置，不影响PLC程序 |
| PLC↔HMI通讯协议 | 变量表12.4 | S7协议（推荐）或Modbus TCP，"待HMI选型（AQEX-24）确认" | 影响HMI驱动选择，不影响PLC程序 |
| HMI品牌型号 | 设计文档12.6 | 昆仑通态MCGS（二轮确认中），变量点数/报警容量待确认 | 影响HMI组态，不影响PLC程序 |
| 注射泵单步分辨率（VD_StepResolution） | 设计文档11.1 + 变量表6.1 | 默认0.2083µL/步（5ml进样器），"需按实际选配进样器容量规格核实" | 影响加药精度，VD18为HMI可调参数 |
| 流量计实际配置单位（0x0012） | 设计文档11.3 + 变量表14.1 | 默认0x03=升L，"需现场读取确认" | 影响差值法单位，VW228可现场读 |
| 流量计"计量值"寄存器溢出行为 | 设计文档11.4 | 长期运行溢出行为（回绕/停止/报错）待厂商确认 | 长时运行（>数月）可能影响差值法 |
| 阀A内漏阈值0.1L | FC30 NETWORK 8 | "阈值暂定0.1L=100ml，现场整定" | 影响内漏报警灵敏度 |
| 阀B四态诊断状态4瞬时排除 | FC31 NETWORK 6 | "需排除刚开始转移时的瞬时，简化：直接判定状态4" | 转移初期可能误报警，需加延时确认 |
| 注射泵速度参数映射 | 变量表8.4 | VD132/136/140与40009/40010/40011对应关系"已确认"，但FC13未写入速度参数 | 影响注射泵抽排速度曲线 |

### 6.4 技术债务

| 项目 | 说明 | 来源文档 |
|---|---|---|
| FC4 Modbus轮询未完整 | Story 1.1未交付，FC4仅骨架 | FC4注释 + 第6.1章 |
| 报警日志环形缓冲区未完整 | FC3 NETWORK 6简化版固定VB500起，未用指针AR1实现6条环形 | FC3 NETWORK 6注释 |
| ~~V303.6流量开关瞬时异常未置位~~ | **2026-09-08已删除** | 第6.1章 |
| 手动控制未实现 | V2.4~V3.3无FC处理 | 第6.1章 |
| V303.7预留报警位 | 变量表9.1标注"预留扩展"，无对应需求 | 变量表 |

---

## 第7章 追溯链示例

挑3个典型需求完整展示"需求→Story→FC→NETWORK→变量→测试用例→状态"全链。

### 7.1 示例1：阀A差值法计量（REQ-012）

```
【需求】REQ-012 阀A差值法计量
   │ 来源：PLC设计文档v9.3 第二章（流量计Modbus寄存器表）+ 第四章S1 + 第五章
   │ 描述：流量计"计量值"寄存器(0x0009)持续累加、只读、无清零功能，
   │       阀A开启瞬间快照VD_FlowMeter_Snapshot，进水过程差值计算本次进水量
   │ 验收标准：VD82=开阀瞬间值；VD90=VD86−VD82；VD90≥目标进水量→关阀
   │ 优先级：高
   ↓
【Story】Story 1.2 状态机骨架（AQEX-6）+ Story 1.3 阀门诊断（AQEX-7）
   │ Story 1.2 交付FC11骨架，Story 1.3 交付FC30完整诊断（含差值法）
   ↓
【FC】FC11_State_S1_Inlet.stl + FC30_ValveA_Diag.stl
   │ FC11负责状态转移调度，FC30负责诊断（含差值法）
   ↓
【NETWORK】
   │ FC11 NETWORK 1（S1首次进入）：
   │   MOVD VD86, VD82     ← 快照流量计当前值到VD_FlowMeter_Snapshot
   │   S    Q0.2, 1        ← 开阀A
   │ FC30 NETWORK 6（子状态3运行中）：
   │   MOVD VD86, AC0       ← 读当前累计值
   │   -D   VD82, AC0       ← 减快照值
   │   MOVD AC0, VD90       ← 写入VD_Current_InletVolume
   │   AR>= VD90, VD316     ← 比较≥目标进水量
   │   R    Q0.2, 1         ← 达标关阀A
   │   MOVD VD86, VD308     ← 快照关阀瞬间值（供内漏检测）
   ↓
【变量】
   │ VD82  = VD_FlowMeter_Snapshot（阀A开启瞬间快照，断电保持）
   │ VD86  = VD_FlowMeter_Current（流量计当前累计值，Modbus 0x0009映射）
   │ VD90  = VD_Current_InletVolume（本次进水量=VD86−VD82）
   │ VD308 = VD_FlowMeter_CloseSnapshot（关阀瞬间快照，供内漏检测）
   │ VD316 = 目标进水量（HMI设定）
   │ Q0.2  = 阀A DO输出
   │ VW260 = 阀A诊断子状态（3=运行中）
   │ VW266 = 阀A诊断结果（0进行中/1正常/2故障）
   ↓
【测试用例】
   │ TC-04-002 S0→S1启动转移：验证VD82=流量计当前值（快照）
   │ TC-04-003 S1→S2进水完成转移：模拟流量计累计值增长使VD90≥目标进水量
   │ TC-10-006 流量计计量值差值法读取：VD82=开阀瞬间值；VD90随累计值增长递增
   │ TC-10-007 流量计无清零功能验证：0x0009无清零指令，只能用差值法
   ↓
【状态】✅ 已实现 / ✅ 已覆盖（4条测试用例）
   │ 备注：流量计无清零功能已确认（v8），差值法为唯一可行方案
```

### 7.2 示例2：阀B四态诊断（REQ-016）

```
【需求】REQ-016 阀B四态诊断
   │ 来源：PLC设计文档v9.3 第六章 阀B
   │ 描述：阀B关闭逻辑持续扫描流量开关B(I0.1)+液位计A-低位(I0.6)四态：
   │   状态1：流量开关B=ON  且 液位计A-低位=OFF  → 正常转移中
   │   状态2：流量开关B=ON  且 液位计A-低位=ON   → 上缸即将排空
   │   状态3：流量开关B=OFF 且 液位计A-低位=ON   → 上缸已排空 → 允许关阀B
   │   状态4：流量开关B=OFF 且 液位计A-低位=OFF  → 设备故障 → 报警
   │ 验收标准：I0.1=OFF且I0.6=OFF→V302.0=1+S_ERROR
   │ 优先级：高
   ↓
【Story】Story 1.3 阀门诊断（AQEX-7）
   ↓
【FC】FC31_ValveB_Diag.stl
   │ 调用方：FC15_State_S4_Transfer.stl（S4状态）
   ↓
【NETWORK】
   │ FC31 NETWORK 1（漫溢保护，优先级最高）：
   │   LD  I0.7  →  S V300.1, S V300.3, S Q0.6, R Q0.3, VW2=99
   │ FC31 NETWORK 6（子状态3运行中-四态诊断）：
   │   状态3：LD I0.6, AN I0.1 → R Q0.3（关阀B）, VW262=4（等关到位）
   │   状态4：LD I0.1, NOT, AN I0.6 → S V302.0, VW2=99, VW268=2
   │   状态1/2：LD I0.1 → JMP nDiagB_End（继续转移中）
   ↓
【变量】
   │ I0.1  = DI_FlowSwitch_B（流量开关B，无源常开）
   │ I0.6  = DI_LevelA_Low（液位计A-低位，无源常开）
   │ I0.7  = DI_LevelB_High（液位计B-高位，漫溢保护）
   │ Q0.3  = DO_ValveB（阀B）
   │ Q0.6  = DO_NCValve_Bottom（NC球阀下缸）
   │ VW262 = Diag_State_B（阀B诊断子状态，0~4）
   │ VW268 = Diag_Result_B（阀B诊断结果，0/1/2）
   │ V300.1 = M_Alarm_Overflow_BHigh（下缸漫溢，漫溢级）
   │ V300.3 = M_Alarm_NCValve_Bottom（NC阀下缸动作，漫溢级）
   │ V302.0 = M_Alarm_ValveB_Diag（阀B四态诊断异常，一般级）
   ↓
【测试用例】
   │ TC-05-007 阀B四态诊断异常（OFF/OFF设备故障）报警：
   │   模拟I0.1=OFF且I0.6=OFF → V302.0=1, VW2=99, VW6=40
   │ TC-03-007 DI_LevelA_Low点位测试（I0.6基础验证）
   │ TC-03-002 DI_FlowSwitch_B点位测试（I0.1基础验证）
   │ TC-03-008 DI_LevelB_High点位测试（漫溢保护基础验证）
   │ TC-05-008 阀B开到位超时报警（关联REQ-017/018）
   │ TC-05-009 阀B关到位但仍有流（内漏，关联REQ-017）
   ↓
【状态】✅ 已实现 / ✅ 已覆盖（6条测试用例）
   │ 备注：状态4判定"简化：直接判定状态4"，转移初期瞬时未加延时确认，
   │       FC31注释"需排除刚开始转移时的瞬时"，为已知技术债务（见第6.3章）
```

### 7.3 示例3：断电恢复（REQ-046）

```
【需求】REQ-046 断电恢复状态策略
   │ 来源：PLC设计文档v9.3 第十章 + FC0设计
   │ 描述：重新上电后根据VW2原值分类处理：
   │   S0(0)/S5(6)/S7(8)/S_ERROR(99) → 可恢复，保持原状态
   │   S1(1)/S2(2)/S3(3)/S3.5(4)/S4(5)/S6(7) → 转S_ERROR（阀门/泵动作中断不安全）
   │ 验收标准：VW2=1~5/7→VW2=99+V300.4=1+QB0=0
   │ 优先级：高
   ↓
【Story】Story 1.7 断电恢复（AQEX-11）
   │ 改写FC0_SysInit.stl为双路径（冷启动+断电恢复）
   ↓
【FC】FC0_SysInit.stl
   │ 调用方：OB1_MAIN.stl NETWORK 1（SM0.1首次扫描）
   ↓
【NETWORK】
   │ FC0 NETWORK 1（判断冷启动/断电恢复）：
   │   LD V304.0  →  JMP nWarmStart（V304.0=1断电恢复路径）
   │ FC0 NETWORK 2（冷启动路径，V304.0=0）：
   │   全部清零（VW2/V1.6/V1.7/QB0/V300.4/VB300~303/VW6/V1.0~V1.5/VW8/VD178/M10.7）
   │ FC0 NETWORK 3（断电恢复-RTC检测）：
   │   READ_RTC VB900，逐字段BCD比较RTC vs DT10
   │   RTC<DT10 → V303.5=1, VW2=99（RTC丢失）
   │   DT10=0（未写入）→ 跳过检测
   │ FC0 NETWORK 4~5（BCD转秒）：
   │   VD186 = RTC秒（时×3600+分×60+秒）
   │   VD190 = DT10秒
   │ FC0 NETWORK 6（VD_S5_Elapsed重算）：
   │   LD V1.7, AW= VW2, 6 → VD178 = VD186 − VD190（仅保持S5且下缸满时）
   │   P7修复：加VW2==6条件，避免V1.7=1但VW2已转S_ERROR时错误重算
   │ FC0 NETWORK 7（状态机恢复策略）：
   │   AW= VW2, 0  →  JMP nStateOK（保持S0）
   │   AW= VW2, 6  →  JMP nStateOK（保持S5，Elapsed已重算）
   │   AW= VW2, 8  →  JMP nStateOK（保持S7锁定态）
   │   AW= VW2, 99 →  JMP nStateOK（保持S_ERROR）
   │   其他（S1~S6）→ nStateError：QB0=0, VW2=99, V300.4=1
   │ FC0 NETWORK 8（初始化完成）：S V304.0, 1（置位InitDone）
   ↓
【变量】
   │ V304.0 = M_InitDone（初始化完成标志，断电保持）
   │ VW2    = 状态机当前状态
   │ V1.7   = M_TankB_State（下缸状态，1=满）
   │ V300.4 = M_EStop_Latch（急停锁存）
   │ V303.5 = M_Alarm_RTC_Lost（RTC丢失报警）
   │ VD178  = VD_S5_Elapsed（下缸满计时器，秒）
   │ VD186  = VD_RTC_Now_Sec（RTC转换总秒数）
   │ VD190  = VD_DT10_Sec（DT10转换总秒数）
   │ VB900~907 = RTC读取结果（BCD）
   │ VB10~17   = DT10下缸变满时间戳（BCD）
   │ QB0       = DO输出（强制安全）
   ↓
【测试用例】
   │ TC-09-001 冷启动全部清零（V304.0=0）→ 全部清零，V304.0置1
   │ TC-09-002 断电恢复保持S5（无阀门动作可恢复）→ VD_S5_Elapsed重算，VW2保持6
   │ TC-09-003 断电恢复S1阀A动作中断转S_ERROR → QB0=0, VW2=99, V300.4=1
   │ TC-09-004 断电恢复状态策略矩阵（S2/S3/S3.5/S4/S6转S_ERROR）→ 每态均VW2=99+V300.4=1
   │ TC-09-005 断电恢复S7保持（锁定态可恢复）→ VW2保持8
   │ TC-09-006 RTC丢失检测（V303.5）→ RTC<DT10时V303.5=1, VW2=99, VW6=65
   │ TC-09-007 RTC正常但DT10未写入跳过检测 → 不触发V303.5
   │ TC-09-008 下缸空时VD_S5_Elapsed不重算 → V1.7=0时VD178保持0
   │ TC-09-009 断电保持区数据保持验证 → VD10~VD66参数值保持不变
   │ TC-09-010 超级电容失效（>7天）走冷启动 → V304.0=0
   │ TC-11-003 断电恢复3次验证（S5/S1/S3态断电）→ S5恢复保持，S1/S3转S_ERROR
   ↓
【状态】✅ 已实现 / ✅ 已覆盖（11条测试用例）
   │ 备注：BCD转秒用当天秒数（时×3600+分×60+秒），跨天场景需补天数×86400，
   │       FC0注释"换水周期通常同天内，本版用当天秒数"，跨天为已知限制
```

---

## 附录A：需求与Story交叉矩阵

| Story | 覆盖需求ID | 需求数 |
|---|---|---|
| Story 1.1（AQEX-2，未完整交付） | REQ-024, REQ-025, REQ-026 | 3（部分实现） |
| Story 1.2（AQEX-6） | REQ-001~011, REQ-050~052, REQ-054, REQ-055, REQ-058 | 18 |
| Story 1.3（AQEX-7） | REQ-012~022, REQ-056, REQ-057 | 13 |
| Story 1.4（AQEX-8） | REQ-040~044 | 5 |
| Story 1.5（AQEX-9） | REQ-035~039, REQ-058 | 6 |
| Story 1.6（AQEX-10） | REQ-027~034 | 8 |
| Story 1.7（AQEX-11） | REQ-045~049 | 5 |
| 未分配Story | REQ-053（手动控制） | 2（未实现） |

> 注：部分需求被多个Story协同实现（如REQ-058由Story 1.2+1.5实现，REQ-012由Story 1.2+1.3实现），上表按主交付Story归类。

## 附录B：关键变量速查（追溯核对用）

| 地址 | 符号 | 含义 | 关联需求 |
|---|---|---|---|
| VW2 | 状态机 | 0=S0,1=S1...8=S7,99=S_ERROR | REQ-001~011 |
| VW4 | 注射泵状态码 | 映射41001 | REQ-025 |
| VW6 | 报警码 | 99>10~14>20~21>30~66 | REQ-028 |
| VW8 | 实验轮次 | 每完成S1~S6累加1 | REQ-007 |
| V0.0/V0.2/V0.3/V0.4/V0.7 | 命令位 | 启动/停止/确认/消音/继电器确认 | REQ-054 |
| V1.6/V1.7 | 上下缸状态 | 0=空,1=满 | REQ-055 |
| V200.0 | M_AlarmAckMode | 0=自动恢复,1=人工确认 | REQ-031/032 |
| V300.0~V300.7 | 报警字1 | 漫溢/NC阀/急停/继电器故障/节奏滞后 | REQ-015/019/027/035~037/043 |
| V301.0~V301.6 | 报警字2 | 阀A类故障 | REQ-013/014 |
| V302.0~V302.7 | 报警字3 | 阀B/C类故障 | REQ-016~022 |
| V303.0~V303.5 | 报警字4 | 阀C关类/泵/注射泵/RTC | REQ-021/022/023/025/048 |
| V304.0 | M_InitDone | 0=冷启动,1=断电恢复 | REQ-045/046 |
| VD82/VD86/VD90 | 流量计差值法 | 快照/当前/差值 | REQ-012 |
| VD96 | VD_ExperimentDuration_Accum | 实验时长累加 | REQ-051/052 |
| VD112/VD116 | VD_T_Rolling/VD_S6_Rolling | 滚动时长 | REQ-044 |
| VD120/VD124/VD128 | 纠偏目标 | S2/S3.5/周期顺延 | REQ-040 |
| VD178 | VD_S5_Elapsed | 下缸满计时 | REQ-041/047 |
| DT10 | DT_TankB_FullTime | 下缸变满时间戳 | REQ-050 |

---

**文档版本**：v1.0
**编制日期**：2026-07-18
**修订日期**：2026-08-27
**配套文档版本**：PLC设计文档v9.3、HMI-PLC变量地址表v1.0、SAT_FAT验收测试用例v1.1、项目交付文档总索引v1.0
**下次更新触发**：
1. Story 1.1（Modbus通讯）完整交付后，更新REQ-024/025/026状态为已实现
2. 手动控制Story新增后，更新REQ-053状态并补充测试用例
3. ~~V303.6流量开关瞬时异常~~ **2026-09-08已删除**
4. FAT/SAT执行后根据实测反馈修订追溯状态
5. 需求变更（IP/协议/HMI选型确认）时同步更新第6.3章
6. **v1.1新增** 后续 S4 互锁超时报警(S4-01 场景,P2 建议)实现后，更新 REQ-059 验收标准
