Yustnust/AQUA-EXPO/docs/项目交付文档总索引_v1.0.md

# 药液配置加注控制系统 — 项目交付文档总索引 v1.2

**项目**: 药液配置与加注控制系统(AQUA-EXPO)
**用途**: 项目全部交付文档的分类目录+用途说明+查阅指引,作为交付查阅入口
**文档总数**: 25份(不含历史版本achieve目录)
**更新日期**: 2026-07-15

---

## 一、文档分类总览

| 类别 | 文档数 | 用途 | 目录 |
|---|---|---|---|
| 1. 核心设计文档 | 3 | 项目设计依据,贯穿全周期 | docs/ |
| 2. PLC程序规格书 | 7 | 各Story详细设计规格 | plc/spec/ |
| 3. PLC程序代码 | 20 | STL源代码 | plc/stl/ |
| 4. PLC校验与测试 | 2 | 代码校验与验收测试 | docs/ |
| 5. HMI准备材料 | 11 | HMI组态实施准备 | docs/hmi_preparation/ |
| 6. 现场调试准备 | 3 | 调试与验收流程 | docs/commissioning/ |
| 7. 设备资料 | 4 | 注射泵/流量计协议 | 注射泵/、流量计/ |

---

## 二、核心设计文档(docs/)

| # | 文档名 | 版本 | 用途 | 查阅场景 |
|---|---|---|---|---|
| 1 | 药液配置加注控制系统_PLC设计文档.md | v9.3 | **项目设计总纲**,含系统概述/IO分配/状态机/阀门诊断/纠偏机制/报警/断电恢复 | 理解整体设计、IO地址、状态机流程 |
| 2 | HMI-PLC变量地址表_v1.0.md | v1.0 | HMI与PLC全部变量地址映射,PLC开发和HMI组态的共同接口契约 | 查变量地址、报警位定义、Modbus寄存器 |
| 3 | HMI画面架构规划文档.md | v9.3 | 8画面架构规划,画面层级与导航结构 | 理解HMI画面整体架构 |

---

## 三、PLC程序规格书(plc/spec/)

| # | 文档名 | Story | 用途 |
|---|---|---|---|
| 4 | Story1.2_状态机骨架_程序设计规格书_v1.2.md(文件名沿用 v1.0) | AQEX-6 | S0~S7+S_ERROR状态机+FC1调度+OB1架构;v1.1 含 S4 下缸空互锁 |
| 5 | Story1.2_状态机骨架_LAD梯形图说明_v1.0.md | AQEX-6 | 状态机LAD梯形图补充说明 |
| 6 | Story1.3_阀门诊断_程序设计规格书_v1.0.md | AQEX-7 | 阀A/B/C四态诊断+限位反馈交叉诊断 |
| 7 | Story1.4_节奏纠偏_程序设计规格书_v1.0.md | AQEX-8 | 三层纠偏(静止压缩→S2压缩→周期顺延) |
| 8 | Story1.5_急停详细_程序设计规格书_v1.0.md | AQEX-9 | 急停双通道+安全继电器反馈+FC19故障态 |
| 9 | Story1.6_报警详细_程序设计规格书_v1.0.md | AQEX-10 | 报警分级+消音消光+优先级编码+FC3 |
| 10 | Story1.7_断电恢复_程序设计规格书_v1.0.md | AQEX-11 | 断电保持+RTC检测+状态恢复+FC0双路径 |

---

## 四、PLC程序代码(plc/stl/)

| # | 文件名 | 功能 | Story |
|---|---|---|---|
| 11 | OB1_MAIN.stl | 主程序,调度FC1~FC4 | 1.2 |
| 12 | FC0_SysInit.stl | 系统初始化(冷启动/断电恢复双路径) | 1.2+1.7 |
| 13 | FC1_StateDispatcher.stl | 状态机调度器 | 1.2 |
| 14 | FC2_EStopHandling.stl | 急停处理 | 1.5 |
| 15 | FC3_AlarmHandling.stl | 报警处理(优先级链+消音消光) | 1.6 |
| 16 | FC4_ModbusPolling.stl | Modbus轮询(注射泵+流量计) | 1.2 |
| 17 | FC10_State_S0_Init.stl | S0初始化态 | 1.2 |
| 18 | FC11_State_S1_Inlet.stl | S1上缸进水(差值法) | 1.2 |
| 19 | FC12_State_S2_PreMix.stl | S2预循环 | 1.2 |
| 20 | FC13_State_S3_Dosing.stl | S3加药(步数控制) | 1.2 |
| 21 | FC14_State_S35_Rest.stl | S3.5静止等候 | 1.2 |
| 22 | FC15_State_S4_Transfer.stl | S4上→下转移 | 1.2 |
| 23 | FC16_State_S5_Run.stl | S5实验运行(换水周期) | 1.2 |
| 24 | FC17_State_S6_Drain.stl | S6下缸排水 | 1.2 |
| 25 | FC18_State_S7_End.stl | S7实验结束 | 1.2 |
| 26 | FC19_State_Error.stl | S_ERROR故障态 | 1.5 |
| 27 | FC30_ValveA_Diag.stl | 阀A诊断 | 1.3 |
| 28 | FC31_ValveB_Diag.stl | 阀B诊断 | 1.3 |
| 29 | FC32_ValveC_Diag.stl | 阀C诊断 | 1.3 |
| 30 | FC40_RhythmCorrection.stl | 节奏纠偏计算 | 1.4 |

---

## 五、PLC校验与测试(docs/)

| # | 文档名 | 用途 | 查阅场景 |
|---|---|---|---|
| 31 | PLC代码完整性校验报告_v1.0.md | 2轮静态校验,10个问题全修复记录 | 代码质量追溯、修复记录查阅 |
| 32 | SAT_FAT验收测试用例_v1.1.md | 106个验收测试用例(9组,含 v1.1 新增 TC-04-013~017) | 现场SAT/FAT验收执行 |

---

## 六、HMI准备材料(docs/hmi_preparation/)

### 6.1 选型无关材料(7份)

| # | 文档名 | 用途 |
|---|---|---|
| 33 | HMI变量导入CSV模板.csv | 91变量×7字段,组态时批量导入 |
| 34 | 报警字32位解析映射表.md | 32位报警×11字段(触发/复位/处置) |
| 35 | 画面变量绑定清单.md | 8画面253个UI元素绑定 |
| 36 | HMI组态导入说明.md | 选型适配+12步组态流程 |
| 37 | HMI画面布局线框图_v1.0.md | 8画面ASCII线框+1280×800布局规范 |
| 38 | HMI用户权限矩阵_v1.0.md | L1/L2/L3三级权限×功能交叉表 |
| 39 | 报警现场处置操作指引_v1.0.md | 32条报警×4步法+恢复时间 |

### 6.2 选型相关材料(4份,昆仑通态MCGS)

| # | 文档名 | 用途 |
|---|---|---|
| 40 | HMI选型技术问询单与备选方案对比_v1.0.md | 厂商4项必答+3款HMI对比(一轮) |
| 41 | HMI数据量估算与存储时长测算_v1.0.md | 241MB/年,4GB可存8.3年 |
| 42 | 昆仑通态MCGS二轮确认问询单_v1.0.md | 7项未明确技术细节确认 |
| 43 | 昆仑通态MCGS组态实施指南_v1.0.md | MCGS具体组态(8连接/变量/画面/脚本) |

---

## 七、现场调试准备(docs/commissioning/)

| # | 文档名 | 用途 | 查阅场景 |
|---|---|---|---|
| 44 | PLC首次下装与上电调试Checklist_v1.2.md(文件名沿用 v1.0) | 到货→验收5天完整流程+安全确认;v1.1 含 S4 互锁验证项 | 首次调试执行 |
| 45 | IO现场接线核对表_v1.0.md | 20DI+9DO+485逐点核对 | 接线施工与打点 |
| 46 | 现场调试SOP_v1.0.md | 开机/日常/参数/手动/急停复位全流程 | 调试与日常操作 |

---

## 八、设备资料

| # | 文件 | 用途 |
|---|---|---|
| 47 | 注射泵/泵阀一体 MODBUS协议_V1.7.pdf | 注射泵Modbus寄存器定义 |
| 48 | 注射泵/SY11全陶瓷(ASCII)_V1.8.pdf | 注射泵产品手册 |
| 49 | 流量计/微小流量计485通讯(Modbus协议)(4).docx | 流量计Modbus寄存器定义 |
| 50 | docs/药液配置加注控制系统_BOM清单_v2.xlsx | 物料清单 |

---

## 九、按角色查阅指引

### 9.1 PLC工程师

| 任务 | 查阅文档 |
|---|---|
| 理解整体设计 | #1 PLC设计文档 → #2 变量地址表 |
| 下装调试 | #44 调试Checklist → #45 IO核对表 → #31 校验报告 |
| 代码维护 | #4~#10 规格书 → #11~#30 STL代码 |
| 代码修改 | #32 校验报告(编址冲突教训) → 对应Story规格书 |

### 9.2 HMI组态工程师

| 任务 | 查阅文档 |
|---|---|
| 理解架构 | #3 画面架构文档 → #37 线框图 |
| 变量导入 | #33 CSV模板 → #2 变量地址表 |
| 画面组态 | #37 线框图 → #35 绑定清单 → #43 MCGS指南 |
| 报警配置 | #34 报警映射表 → #39 处置指引 |
| 权限配置 | #38 权限矩阵 |

### 9.3 现场调试工程师

| 任务 | 查阅文档 |
|---|---|
| 首次调试 | #44 Checklist(v1.1) → #45 IO核对表 → #46 SOP |
| 验收测试 | #32 SAT/FAT用例(v1.1) |
| 故障处理 | #39 报警处置指引 → #46 SOP急停复位章节 |

### 9.4 运维人员

| 任务 | 查阅文档 |
|---|---|
| 日常操作 | #46 现场调试SOP |
| 报警处置 | #39 报警现场处置操作指引 |
| 设备维护 | 设备维护手册(另文档) |

### 9.5 项目经理

| 任务 | 查阅文档 |
|---|---|
| 项目总览 | 本索引 → #1 PLC设计文档 |
| 交付管理 | 首期1套验收交付包(另文档) |
| 质量追溯 | #31 校验报告 → #32 SAT/FAT用例(v1.1) |
| HMI选型 | #40~#43 选型问询与组态指南 |

---

## 十、文档版本管理

### 10.1 当前版本

- PLC代码: 经2轮校验,10个问题全修复,commit 48426d5
- 核心文档: v9.3(PLC设计文档)/v1.0(变量表)
- HMI准备: v1.0(全部)

### 10.2 历史版本

历史版本PLC设计文档(rev1~rev8)存于 `achieve/` 目录,仅作追溯,不作交付使用。

### 10.3 更新规则

| 文档类型 | 更新触发 | 负责人 |
|---|---|---|
| PLC代码 | 代码修改 | PLC工程师 |
| 规格书 | 设计变更 | PLC工程师 |
| 变量地址表 | 变量增减 | PLC工程师+HMI工程师 |
| HMI材料 | 选型确认/组态变更 | HMI工程师 |
| 调试文档 | 现场调试反馈 | 调试工程师 |

---

## 十一、交付清单

### 11.1 软件交付

| 项 | 数量 | 位置 |
|---|---|---|
| PLC STL代码 | 20个文件 | plc/stl/ |
| PLC规格书 | 7份 | plc/spec/ |
| HMI组态工程 | 待组态 | (HMI到货后) |

### 11.2 文档交付

| 项 | 数量 | 位置 |
|---|---|---|
| 核心设计文档 | 3份 | docs/ |
| 校验与测试 | 2份 | docs/ |
| HMI准备材料 | 11份 | docs/hmi_preparation/ |
| 调试准备 | 3份 | docs/commissioning/ |
| 设备资料 | 4份 | 注射泵/、流量计/ |
| **合计** | **23份+20代码** | |

### 11.3 硬件交付(待采购)

| 项 | 数量 | 状态 |
|---|---|---|
| S7-200 SMART CPU ST20 | 8台 | 待采购 |
| EM DT16/DR16扩展 | 8块 | 待采购 |
| 昆仑通态MCGS 12寸HMI | 1台 | 待供应商确认 |
| 阀门/泵/传感器 | 8套 | 待采购 |

---

**文档版本**: v1.2
**说明**: 本索引随项目进展持续更新。新增文档时在对应类别追加,并更新文档总数。
