Yustnust/AQUA-EXPO/docs/reference/McgsProHelp_text/README.md

# McgsPro 3.3.6 官方帮助文档(纯文本版)

**来源**: McgsProHelp.chm(昆仑通态McgsPro 3.3.6.6354 SP1.3组态软件官方帮助文档)
**转换时间**: 2026-07-19
**转换方式**: archmage解压CHM → BeautifulSoup提取正文 → UTF-8纯文本
**文件数量**: 115个.txt文件,18章节
**总大小**: 约1MB
**编码**: UTF-8

## 转换工具

- `tools/parse_chm.py`: CHM二进制格式探测(标记定位)
- `tools/extract_chm_text.py`: 批量提取HTML章节为纯文本(BeautifulSoup)

转换流程:
```bash
# 1. 安装chm解压工具
apt-get install -y archmage chmlib

# 2. 解压chm到HTML目录(原gb2312编码)
archmage -x McgsProHelp.chm /tmp/chm_out

# 3. 转码gb2312→utf-8(用iconv或Python脚本)
# 4. 批量提取纯文本
python3 tools/extract_chm_text.py
```

## 章节索引(18章115节)

### 1. 组态结构
- [组态结构](组态结构/组态结构.txt)

### 2. 快速入门
- [制作组态工程](快速入门/制作组态工程.txt)
- [系统参数设置](快速入门/系统参数设置.txt)
- [下载组态工程](快速入门/下载组态工程.txt)
- [上传组态工程](快速入门/上传组态工程.txt)

### 3. 主控窗口
- [功能概述](主控窗口/功能概述.txt)
- [组态配置](主控窗口/组态配置.txt)

### 4. 用户窗口
- [功能概述](用户窗口/功能概述.txt)
- [创建窗口](用户窗口/创建窗口.txt)
- [窗口属性](用户窗口/窗口属性.txt)
- [窗口方法](用户窗口/窗口方法.txt)
- [窗口事件](用户窗口/窗口事件.txt)
- [组态配置](用户窗口/组态配置.txt)
- [组态编辑](用户窗口/组态编辑.txt)
- [构件多重复制](用户窗口/构件多重复制.txt)

### 5. 实时数据
- [功能概述](实时数据/功能概述.txt)
- [添加数据对象](实时数据/添加数据对象.txt)
- [数据对象属性](实时数据/数据对象属性.txt)
- [数据对象方法](实时数据/数据对象方法.txt)
- [数据对象存盘](实时数据/数据对象存盘.txt)
- [数据对象报警](实时数据/数据对象报警.txt)
- [变量选择](实时数据/变量选择.txt)
- [组态属性配置](实时数据/组态属性配置.txt)

### 6. 设备窗口
- [功能概述](设备窗口/功能概述.txt)
- [设备组态](设备窗口/设备组态.txt)
- [通用设备](设备窗口/通用设备.txt)

### 7. 运行策略
- [功能概述](运行策略/功能概述.txt)
- [策略类型](运行策略/策略类型.txt)
- [创建策略](运行策略/创建策略.txt)
- [编辑策略](运行策略/编辑策略.txt)
- [注意事项](运行策略/注意事项.txt)

### 8. 动画构件(25个构件)
- [构件管理](动画构件/构件管理.txt)
- [公共属性](动画构件/公共属性.txt)
- [标准按钮构件](动画构件/标准按钮构件.txt)
- [标签构件](动画构件/标签构件.txt)
- [输入框构件](动画构件/输入框构件.txt)
- [组合框构件](动画构件/组合框构件.txt)
- [滑动输入器构件](动画构件/滑动输入器构件.txt)
- [动画按钮构件](动画构件/动画按钮构件.txt)
- [动画显示构件](动画构件/动画显示构件.txt)
- [百分比填充](动画构件/百分比填充.txt)
- [旋转仪表构件](动画构件/旋转仪表构件.txt)
- [流动块构件](动画构件/流动块构件.txt)
- [基本图元构件](动画构件/基本图元构件.txt)
- [位图构件](动画构件/位图构件.txt)
- [gif构件](动画构件/gif构件.txt)
- [二维码构件](动画构件/二维码构件.txt)
- [实时曲线构件](动画构件/实时曲线构件.txt)
- [历史曲线构件](动画构件/历史曲线构件.txt)
- [xy曲线构件](动画构件/xy曲线构件.txt)
- [报警浏览构件](动画构件/报警浏览构件.txt)
- [报警条构件](动画构件/报警条构件.txt)
- [存盘数据浏览构件](动画构件/存盘数据浏览构件.txt)
- [报表构件](动画构件/报表构件.txt)
- [配方构件](动画构件/配方构件.txt)
- [键盘按钮构件](动画构件/键盘按钮构件.txt)

### 9. 脚本程序
- [功能概述](脚本程序/功能概述.txt)
- [编辑环境](脚本程序/编辑环境.txt)
- [语言要素](脚本程序/语言要素.txt)
- [基本语句](脚本程序/基本语句.txt)
- [组态查错](脚本程序/组态查错.txt)

### 10. 脚本函数(10类)
- [运行环境操作函数](脚本函数/运行环境操作函数.txt)
- [数据对象操作函数](脚本函数/数据对象操作函数.txt)
- [权限管理操作函数](脚本函数/权限管理操作函数.txt)
- [数学函数](脚本函数/数学函数.txt)
- [字符串操作函数](脚本函数/字符串操作函数.txt)
- [时间运算函数](脚本函数/时间运算函数.txt)
- [计时器操作脚本函数](脚本函数/计时器操作脚本函数.txt)
- [系统变量](脚本函数/系统变量.txt)
- [内存操作](脚本函数/内存操作.txt)
- [文件操作](脚本函数/文件操作.txt)

### 11. 报警配置
- [启动配置](报警配置/启动配置.txt)
- [新增报警](报警配置/新增报警.txt)
- [编辑报警](报警配置/编辑报警.txt)
- [删除报警](报警配置/删除报警.txt)
- [保存报警](报警配置/保存报警.txt)
- [导入报警](报警配置/导入报警.txt)
- [导出报警](报警配置/导出报警.txt)
- [文件说明](报警配置/文件说明.txt)
- [注意事项](报警配置/注意事项.txt)

### 12. 安全机制
- [功能概述](安全机制/功能概述.txt)
- [用户权限](安全机制/用户权限.txt)
- [系统权限](安全机制/系统权限.txt)
- [组态工程](安全机制/组态工程.txt)
- [工程文件保护](安全机制/工程文件保护.txt)

### 13. 操作日志
- [功能概述](操作日志/功能概述.txt)
- [组态设置](操作日志/组态设置.txt)
- [运行功能](操作日志/运行功能.txt)

### 14. 多语言
- [功能概述](多语言/功能概述.txt)
- [操作说明](多语言/操作说明.txt)
- [支持模块](多语言/支持模块.txt)
- [组态配置](多语言/组态配置.txt)
- [注意事项](多语言/注意事项.txt)

### 15. 组态辅助工具
- [文本查找与替换](组态辅助工具/文本查找与替换.txt)
- [对象使用浏览](组态辅助工具/对象使用浏览.txt)
- [使用计数检查](组态辅助工具/使用计数检查.txt)
- [数据对象改名](组态辅助工具/数据对象改名.txt)
- [清除未使用的变量](组态辅助工具/清除未使用的变量.txt)
- [工程文件压缩](组态辅助工具/工程文件压缩.txt)
- [元件图库管理](组态辅助工具/元件图库管理.txt)
- [动画构件管理](组态辅助工具/动画构件管理.txt)
- [用户文件区操作工具](组态辅助工具/用户文件区操作工具.txt)

### 16. 运行期限
- [功能概述](运行期限/功能概述.txt)
- [组态配置](运行期限/组态配置.txt)
- [组态编辑](运行期限/组态编辑.txt)
- [运行环境](运行期限/运行环境.txt)

### 17. 配方模块
- [功能概述](配方模块/功能概述.txt)
- [组态配置](配方模块/组态配置.txt)
- [脚本函数](配方模块/脚本函数.txt)

### 18. 物联网
- [18.1 功能概述](物联网/18.1_功能概述.txt)
- [18.2 无线通信](物联网/18.2_无线通信.txt)
- [18.3 远程调试](物联网/18.3_远程调试.txt)
- [18.4 本地调试](物联网/18.4_本地调试.txt)
- [18.5 注意事项](物联网/18.5_注意事项.txt)

## AQUA-EXPO HMI组态常用章节速查

| AQUA-EXPO需求 | 推荐章节 |
|---|---|
| 新建工程/选TPC型号 | 快速入门/制作组态工程 + 系统参数设置 |
| 8连接S7驱动 | 设备窗口/设备组态 + 通用设备 |
| 602变量批量添加 | 实时数据/添加数据对象 + 变量选择 + 组态属性配置 |
| 8画面组态 | 用户窗口/创建窗口 + 组态编辑 + 构件多重复制 |
| 按钮/标签/输入框 | 动画构件/标准按钮构件 + 标签构件 + 输入框构件 |
| 报警显示 | 动画构件/报警浏览构件 + 报警配置/新增报警 |
| 历史曲线 | 动画构件/历史曲线构件 + 实时曲线构件 + xy曲线构件 |
| 54个脚本 | 脚本程序/语言要素 + 基本语句 + 脚本函数/* |
| 用户权限 | 安全机制/用户权限 + 系统权限 |
| 操作日志 | 操作日志/* |
| 历史数据存盘 | 实时数据/数据对象存盘 + 动画构件/存盘数据浏览构件 |
| 下载到TPC | 快速入门/下载组态工程 + 上传组态工程 |

## 使用建议

1. **AI助手检索**: 直接读取需要的.txt文件即可,无需再解压chm
2. **关键章节**: 优先查看"脚本程序/基本语句.txt"和"脚本函数/运行环境操作函数.txt",这两章决定了脚本能否编译通过
3. **错误排查**: 出现脚本错误时,先查"脚本程序/语言要素.txt"的命名规则和"组态查错.txt"
4. **构件属性**: 每个构件的属性配置详见"动画构件/"目录下对应文件

## 原始CHM文件

原始CHM文件位于项目根目录: `McgsProHelp.chm` (9.2MB)
如需重新转换,使用 `tools/parse_chm.py` 和 `tools/extract_chm_text.py`。
