Yustnust/AQUA-EXPO/static_analysis_report.md

# PLC代码静态分析报告

| 项目 | 内容 |
|---|---|
| 分析对象 | S7-200 SMART STL代码(21个FC) |
| 分析工具 | stl_static_analyzer.py v1.0 |
| 变量表来源 | HMI-PLC变量地址表v1.0 + STL注释 |
| 分析日期 | 2026-07-18 |

## 一、分析摘要

- **问题总数**: 237 个
- **严重**: 0 个
- **警告**: 61 个
- **提示**: 176 个

## 二、STL文件统计

| FC名称 | 引用数 | 写入数 |
|---|---|---|
| FC0_SysInit | 98 | 42 |
| FC10_State_S0_Init | 7 | 4 |
| FC11_State_S1_Inlet | 44 | 34 |
| FC12_State_S2_PreMix | 27 | 18 |
| FC13_State_S3_Dosing | 16 | 13 |
| FC14_State_S35_Rest | 8 | 5 |
| FC15_State_S4_Transfer | 33 | 21 |
| FC16_State_S5_Run | 36 | 22 |
| FC17_State_S6_Drain | 17 | 13 |
| FC18_State_S7_End | 4 | 3 |
| FC19_State_Error | 11 | 9 |
| FC1_StateDispatcher | 13 | 2 |
| FC20_ManualControl | 21 | 8 |
| FC2_EStopHandling | 13 | 8 |
| FC30_ValveA_Diag | 52 | 32 |
| FC31_ValveB_Diag | 46 | 38 |
| FC32_ValveC_Diag | 41 | 33 |
| FC3_AlarmHandling | 183 | 84 |
| FC40_RhythmCorrection | 63 | 40 |
| FC4_ModbusPolling | 78 | 34 |
| OB1_MAIN | 0 | 0 |
| **合计** | **811** | **463** |

## 三、变量定义统计

- VB(字节): 0 个
- VW(字): 26 个
- VD(双字): 25 个
- Vbit(位): 25 个
- **合计**: 76 个变量定义

## 四、问题清单

### 警告(61个)

#### 跨FC写入冲突(51个)

1. **[警告]** 变量 VB2 被 17 个FC写入: ['FC0_SysInit', 'FC10_State_S0_Init', 'FC11_State_S1_Inlet', 'FC12_State_S2_PreMix', 'FC13_State_S3_Dosing', 'FC14_State_S35_Rest', 'FC15_State_S4_Transfer', 'FC16_State_S5_Run', 'FC17_State_S6_Drain', 'FC18_State_S7_End', 'FC19_State_Error', 'FC1_StateDispatcher', 'FC2_EStopHandling', 'FC30_ValveA_Diag', 'FC31_ValveB_Diag', 'FC32_ValveC_Diag', 'FC40_RhythmCorrection']
   - 同一变量被多个FC写入可能导致时序冲突,需确认调用顺序与互斥性

2. **[警告]** 变量 VB3 被 16 个FC写入: ['FC0_SysInit', 'FC10_State_S0_Init', 'FC11_State_S1_Inlet', 'FC12_State_S2_PreMix', 'FC13_State_S3_Dosing', 'FC14_State_S35_Rest', 'FC15_State_S4_Transfer', 'FC16_State_S5_Run', 'FC17_State_S6_Drain', 'FC18_State_S7_End', 'FC19_State_Error', 'FC1_StateDispatcher', 'FC2_EStopHandling', 'FC30_ValveA_Diag', 'FC31_ValveB_Diag', 'FC32_ValveC_Diag']
   - 同一变量被多个FC写入可能导致时序冲突,需确认调用顺序与互斥性

3. **[警告]** 变量 V1.6 被 5 个FC写入: ['FC0_SysInit', 'FC11_State_S1_Inlet', 'FC12_State_S2_PreMix', 'FC15_State_S4_Transfer', 'FC19_State_Error']
   - 同一变量被多个FC写入可能导致时序冲突,需确认调用顺序与互斥性

4. **[警告]** 变量 V1.7 被 4 个FC写入: ['FC0_SysInit', 'FC15_State_S4_Transfer', 'FC17_State_S6_Drain', 'FC19_State_Error']
   - 同一变量被多个FC写入可能导致时序冲突,需确认调用顺序与互斥性

5. **[警告]** 变量 V300.4 被 3 个FC写入: ['FC0_SysInit', 'FC19_State_Error', 'FC2_EStopHandling']
   - 同一变量被多个FC写入可能导致时序冲突,需确认调用顺序与互斥性

6. **[警告]** 变量 VB6 被 3 个FC写入: ['FC0_SysInit', 'FC19_State_Error', 'FC2_EStopHandling']
   - 同一变量被多个FC写入可能导致时序冲突,需确认调用顺序与互斥性

7. **[警告]** 变量 VB7 被 3 个FC写入: ['FC0_SysInit', 'FC19_State_Error', 'FC2_EStopHandling']
   - 同一变量被多个FC写入可能导致时序冲突,需确认调用顺序与互斥性

8. **[警告]** 变量 V1.0 被 3 个FC写入: ['FC0_SysInit', 'FC10_State_S0_Init', 'FC18_State_S7_End']
   - 同一变量被多个FC写入可能导致时序冲突,需确认调用顺序与互斥性

9. **[警告]** 变量 VD178 被 4 个FC写入: ['FC0_SysInit', 'FC11_State_S1_Inlet', 'FC15_State_S4_Transfer', 'FC16_State_S5_Run']
   - 同一变量被多个FC写入可能导致时序冲突,需确认调用顺序与互斥性

10. **[警告]** 变量 V303.5 被 2 个FC写入: ['FC0_SysInit', 'FC3_AlarmHandling']
   - 同一变量被多个FC写入可能导致时序冲突,需确认调用顺序与互斥性

11. **[警告]** 变量 VB260 被 2 个FC写入: ['FC11_State_S1_Inlet', 'FC30_ValveA_Diag']
   - 同一变量被多个FC写入可能导致时序冲突,需确认调用顺序与互斥性

12. **[警告]** 变量 VB261 被 2 个FC写入: ['FC11_State_S1_Inlet', 'FC30_ValveA_Diag']
   - 同一变量被多个FC写入可能导致时序冲突,需确认调用顺序与互斥性

13. **[警告]** 变量 VB266 被 2 个FC写入: ['FC11_State_S1_Inlet', 'FC30_ValveA_Diag']
   - 同一变量被多个FC写入可能导致时序冲突,需确认调用顺序与互斥性

14. **[警告]** 变量 VD150 被 3 个FC写入: ['FC11_State_S1_Inlet', 'FC16_State_S5_Run', 'FC40_RhythmCorrection']
   - 同一变量被多个FC写入可能导致时序冲突,需确认调用顺序与互斥性

15. **[警告]** 变量 VD116 被 3 个FC写入: ['FC11_State_S1_Inlet', 'FC16_State_S5_Run', 'FC17_State_S6_Drain']
   - 同一变量被多个FC写入可能导致时序冲突,需确认调用顺序与互斥性

16. **[警告]** 变量 VD154 被 2 个FC写入: ['FC11_State_S1_Inlet', 'FC16_State_S5_Run']
   - 同一变量被多个FC写入可能导致时序冲突,需确认调用顺序与互斥性

17. **[警告]** 变量 VD124 被 2 个FC写入: ['FC11_State_S1_Inlet', 'FC40_RhythmCorrection']
   - 同一变量被多个FC写入可能导致时序冲突,需确认调用顺序与互斥性

18. **[警告]** 变量 VW182 被 2 个FC写入: ['FC11_State_S1_Inlet', 'FC16_State_S5_Run']
   - 同一变量被多个FC写入可能导致时序冲突,需确认调用顺序与互斥性

19. **[警告]** 变量 VW252 被 2 个FC写入: ['FC12_State_S2_PreMix', 'FC4_ModbusPolling']
   - 同一变量被多个FC写入可能导致时序冲突,需确认调用顺序与互斥性

20. **[警告]** 变量 V303.2 被 2 个FC写入: ['FC12_State_S2_PreMix', 'FC3_AlarmHandling']
   - 同一变量被多个FC写入可能导致时序冲突,需确认调用顺序与互斥性

21. **[警告]** 变量 V303.3 被 2 个FC写入: ['FC12_State_S2_PreMix', 'FC3_AlarmHandling']
   - 同一变量被多个FC写入可能导致时序冲突,需确认调用顺序与互斥性

22. **[警告]** 变量 VD90 被 2 个FC写入: ['FC13_State_S3_Dosing', 'FC30_ValveA_Diag']
   - 同一变量被多个FC写入可能导致时序冲突,需确认调用顺序与互斥性

23. **[警告]** 变量 V303.4 被 3 个FC写入: ['FC13_State_S3_Dosing', 'FC3_AlarmHandling', 'FC4_ModbusPolling']
   - 同一变量被多个FC写入可能导致时序冲突,需确认调用顺序与互斥性

24. **[警告]** 变量 VW254 被 2 个FC写入: ['FC14_State_S35_Rest', 'FC4_ModbusPolling']
   - 同一变量被多个FC写入可能导致时序冲突,需确认调用顺序与互斥性

25. **[警告]** 变量 VB262 被 2 个FC写入: ['FC15_State_S4_Transfer', 'FC31_ValveB_Diag']
   - 同一变量被多个FC写入可能导致时序冲突,需确认调用顺序与互斥性

26. **[警告]** 变量 VB263 被 2 个FC写入: ['FC15_State_S4_Transfer', 'FC31_ValveB_Diag']
   - 同一变量被多个FC写入可能导致时序冲突,需确认调用顺序与互斥性

27. **[警告]** 变量 VB268 被 2 个FC写入: ['FC15_State_S4_Transfer', 'FC31_ValveB_Diag']
   - 同一变量被多个FC写入可能导致时序冲突,需确认调用顺序与互斥性

28. **[警告]** 变量 V301.6 被 2 个FC写入: ['FC16_State_S5_Run', 'FC3_AlarmHandling']
   - 同一变量被多个FC写入可能导致时序冲突,需确认调用顺序与互斥性

29. **[警告]** 变量 VB264 被 2 个FC写入: ['FC17_State_S6_Drain', 'FC32_ValveC_Diag']
   - 同一变量被多个FC写入可能导致时序冲突,需确认调用顺序与互斥性

30. **[警告]** 变量 VB265 被 2 个FC写入: ['FC17_State_S6_Drain', 'FC32_ValveC_Diag']
   - 同一变量被多个FC写入可能导致时序冲突,需确认调用顺序与互斥性

31. **[警告]** 变量 VW270 被 2 个FC写入: ['FC17_State_S6_Drain', 'FC32_ValveC_Diag']
   - 同一变量被多个FC写入可能导致时序冲突,需确认调用顺序与互斥性

32. **[警告]** 变量 V300.5 被 2 个FC写入: ['FC19_State_Error', 'FC2_EStopHandling']
   - 同一变量被多个FC写入可能导致时序冲突,需确认调用顺序与互斥性

33. **[警告]** 变量 V300.0 被 2 个FC写入: ['FC30_ValveA_Diag', 'FC3_AlarmHandling']
   - 同一变量被多个FC写入可能导致时序冲突,需确认调用顺序与互斥性

34. **[警告]** 变量 V301.4 被 2 个FC写入: ['FC30_ValveA_Diag', 'FC3_AlarmHandling']
   - 同一变量被多个FC写入可能导致时序冲突,需确认调用顺序与互斥性

35. **[警告]** 变量 V301.5 被 2 个FC写入: ['FC30_ValveA_Diag', 'FC3_AlarmHandling']
   - 同一变量被多个FC写入可能导致时序冲突,需确认调用顺序与互斥性

36. **[警告]** 变量 V301.0 被 2 个FC写入: ['FC30_ValveA_Diag', 'FC3_AlarmHandling']
   - 同一变量被多个FC写入可能导致时序冲突,需确认调用顺序与互斥性

37. **[警告]** 变量 V301.1 被 2 个FC写入: ['FC30_ValveA_Diag', 'FC3_AlarmHandling']
   - 同一变量被多个FC写入可能导致时序冲突,需确认调用顺序与互斥性

38. **[警告]** 变量 V301.2 被 2 个FC写入: ['FC30_ValveA_Diag', 'FC3_AlarmHandling']
   - 同一变量被多个FC写入可能导致时序冲突,需确认调用顺序与互斥性

39. **[警告]** 变量 V301.3 被 2 个FC写入: ['FC30_ValveA_Diag', 'FC3_AlarmHandling']
   - 同一变量被多个FC写入可能导致时序冲突,需确认调用顺序与互斥性

40. **[警告]** 变量 V300.1 被 2 个FC写入: ['FC31_ValveB_Diag', 'FC3_AlarmHandling']
   - 同一变量被多个FC写入可能导致时序冲突,需确认调用顺序与互斥性

41. **[警告]** 变量 V302.1 被 2 个FC写入: ['FC31_ValveB_Diag', 'FC3_AlarmHandling']
   - 同一变量被多个FC写入可能导致时序冲突,需确认调用顺序与互斥性

42. **[警告]** 变量 V302.2 被 2 个FC写入: ['FC31_ValveB_Diag', 'FC3_AlarmHandling']
   - 同一变量被多个FC写入可能导致时序冲突,需确认调用顺序与互斥性

43. **[警告]** 变量 V302.0 被 2 个FC写入: ['FC31_ValveB_Diag', 'FC3_AlarmHandling']
   - 同一变量被多个FC写入可能导致时序冲突,需确认调用顺序与互斥性

44. **[警告]** 变量 V302.4 被 2 个FC写入: ['FC31_ValveB_Diag', 'FC3_AlarmHandling']
   - 同一变量被多个FC写入可能导致时序冲突,需确认调用顺序与互斥性

45. **[警告]** 变量 V302.3 被 2 个FC写入: ['FC31_ValveB_Diag', 'FC3_AlarmHandling']
   - 同一变量被多个FC写入可能导致时序冲突,需确认调用顺序与互斥性

46. **[警告]** 变量 V302.6 被 2 个FC写入: ['FC32_ValveC_Diag', 'FC3_AlarmHandling']
   - 同一变量被多个FC写入可能导致时序冲突,需确认调用顺序与互斥性

47. **[警告]** 变量 V302.7 被 2 个FC写入: ['FC32_ValveC_Diag', 'FC3_AlarmHandling']
   - 同一变量被多个FC写入可能导致时序冲突,需确认调用顺序与互斥性

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
   - FC: FC40_RhythmCorrection, 行: 70
   - 位置: FC40_RhythmCorrection 第70行

70. **[提示]** 变量 VB250 在STL中引用但变量表/注释未定义
   - FC: FC4_ModbusPolling, 行: 76
   - 位置: FC4_ModbusPolling 第76行

71. **[提示]** 变量 VB251 在STL中引用但变量表/注释未定义
   - FC: FC4_ModbusPolling, 行: 77
   - 位置: FC4_ModbusPolling 第77行

72. **[提示]** 变量 VB520 在STL中引用但变量表/注释未定义
   - FC: FC4_ModbusPolling, 行: 247
   - 位置: FC4_ModbusPolling 第247行

73. **[提示]** 变量 VB530 在STL中引用但变量表/注释未定义
   - FC: FC4_ModbusPolling, 行: 250
   - 位置: FC4_ModbusPolling 第250行

## 五、跨FC变量访问矩阵(写入)

以下变量被多个FC写入(需确认调用顺序与互斥性):

| 变量 | 写入FC数 | FC列表 |
|---|---|---|
| VB2 | 17 | FC0_SysInit, FC10_State_S0_Init, FC11_State_S1_Inlet, FC12_State_S2_PreMix, FC13_State_S3_Dosing, FC14_State_S35_Rest, FC15_State_S4_Transfer, FC16_State_S5_Run, FC17_State_S6_Drain, FC18_State_S7_End, FC19_State_Error, FC1_StateDispatcher, FC2_EStopHandling, FC30_ValveA_Diag, FC31_ValveB_Diag, FC32_ValveC_Diag, FC40_RhythmCorrection |
| VB3 | 16 | FC0_SysInit, FC10_State_S0_Init, FC11_State_S1_Inlet, FC12_State_S2_PreMix, FC13_State_S3_Dosing, FC14_State_S35_Rest, FC15_State_S4_Transfer, FC16_State_S5_Run, FC17_State_S6_Drain, FC18_State_S7_End, FC19_State_Error, FC1_StateDispatcher, FC2_EStopHandling, FC30_ValveA_Diag, FC31_ValveB_Diag, FC32_ValveC_Diag |
| VB6 | 3 | FC0_SysInit, FC19_State_Error, FC2_EStopHandling |
| VB7 | 3 | FC0_SysInit, FC19_State_Error, FC2_EStopHandling |
| V1.0 | 3 | FC0_SysInit, FC10_State_S0_Init, FC18_State_S7_End |
| V1.6 | 5 | FC0_SysInit, FC11_State_S1_Inlet, FC12_State_S2_PreMix, FC15_State_S4_Transfer, FC19_State_Error |
| V1.7 | 4 | FC0_SysInit, FC15_State_S4_Transfer, FC17_State_S6_Drain, FC19_State_Error |
| VD90 | 2 | FC13_State_S3_Dosing, FC30_ValveA_Diag |
| VB260 | 2 | FC11_State_S1_Inlet, FC30_ValveA_Diag |
| VB261 | 2 | FC11_State_S1_Inlet, FC30_ValveA_Diag |
| VB262 | 2 | FC15_State_S4_Transfer, FC31_ValveB_Diag |
| VB263 | 2 | FC15_State_S4_Transfer, FC31_ValveB_Diag |
| VB264 | 2 | FC17_State_S6_Drain, FC32_ValveC_Diag |
| VB265 | 2 | FC17_State_S6_Drain, FC32_ValveC_Diag |
| VB266 | 2 | FC11_State_S1_Inlet, FC30_ValveA_Diag |
| VB268 | 2 | FC15_State_S4_Transfer, FC31_ValveB_Diag |
| VD116 | 3 | FC11_State_S1_Inlet, FC16_State_S5_Run, FC17_State_S6_Drain |
| VD124 | 2 | FC11_State_S1_Inlet, FC40_RhythmCorrection |
| VD150 | 3 | FC11_State_S1_Inlet, FC16_State_S5_Run, FC40_RhythmCorrection |
| VD154 | 2 | FC11_State_S1_Inlet, FC16_State_S5_Run |
| VD178 | 4 | FC0_SysInit, FC11_State_S1_Inlet, FC15_State_S4_Transfer, FC16_State_S5_Run |
| VW182 | 2 | FC11_State_S1_Inlet, FC16_State_S5_Run |
| VW252 | 2 | FC12_State_S2_PreMix, FC4_ModbusPolling |
| VW254 | 2 | FC14_State_S35_Rest, FC4_ModbusPolling |
| VW270 | 2 | FC17_State_S6_Drain, FC32_ValveC_Diag |
| V300.0 | 2 | FC30_ValveA_Diag, FC3_AlarmHandling |
| V300.1 | 2 | FC31_ValveB_Diag, FC3_AlarmHandling |
| V300.4 | 3 | FC0_SysInit, FC19_State_Error, FC2_EStopHandling |
| V300.5 | 2 | FC19_State_Error, FC2_EStopHandling |
| V301.0 | 2 | FC30_ValveA_Diag, FC3_AlarmHandling |
| V301.1 | 2 | FC30_ValveA_Diag, FC3_AlarmHandling |
| V301.2 | 2 | FC30_ValveA_Diag, FC3_AlarmHandling |
| V301.3 | 2 | FC30_ValveA_Diag, FC3_AlarmHandling |
| V301.4 | 2 | FC30_ValveA_Diag, FC3_AlarmHandling |
| V301.5 | 2 | FC30_ValveA_Diag, FC3_AlarmHandling |
| V301.6 | 2 | FC16_State_S5_Run, FC3_AlarmHandling |
| V302.0 | 2 | FC31_ValveB_Diag, FC3_AlarmHandling |
| V302.1 | 2 | FC31_ValveB_Diag, FC3_AlarmHandling |
| V302.2 | 2 | FC31_ValveB_Diag, FC3_AlarmHandling |
| V302.3 | 2 | FC31_ValveB_Diag, FC3_AlarmHandling |
| V302.4 | 2 | FC31_ValveB_Diag, FC3_AlarmHandling |
| V302.5 | 2 | FC32_ValveC_Diag, FC3_AlarmHandling |
| V302.6 | 2 | FC32_ValveC_Diag, FC3_AlarmHandling |
| V302.7 | 2 | FC32_ValveC_Diag, FC3_AlarmHandling |
| V303.0 | 2 | FC32_ValveC_Diag, FC3_AlarmHandling |
| V303.1 | 2 | FC32_ValveC_Diag, FC3_AlarmHandling |
| V303.2 | 2 | FC12_State_S2_PreMix, FC3_AlarmHandling |
| V303.3 | 2 | FC12_State_S2_PreMix, FC3_AlarmHandling |
| V303.4 | 3 | FC13_State_S3_Dosing, FC3_AlarmHandling, FC4_ModbusPolling |
| V303.5 | 2 | FC0_SysInit, FC3_AlarmHandling |
| ~~V303.6~~ | ~~2~~ | **2026-09-08已删除** |

## 六、V区使用热力图(引用次数Top20)

| 字节地址 | 引用次数 |
|---|---|
| VB2 | 72 |
| VB3 | 70 |
| VB6 | 50 |
| VB7 | 50 |
| VB302 | 50 |
| VB301 | 47 |
| VB303 | 44 |
| VB300 | 32 |
| VB250 | 26 |
| VB251 | 26 |
| VB1 | 25 |
| VB252 | 22 |
| VB253 | 22 |
| VB0 | 13 |
| VB158 | 12 |
| VB159 | 12 |
| VB160 | 12 |
| VB161 | 12 |
| VB150 | 11 |
| VB151 | 11 |

## 七、结论与建议

⚠️ 未发现严重问题,但存在 61 个警告,建议在下一轮迭代前修复。
ℹ️ 另有 176 个提示项,可择机处理。

---

*本报告由 stl_static_analyzer.py 自动生成,可重复执行以跟踪问题修复进度。*
