Yustnust/AQUA-EXPO/tools/static_analysis_report.md

# PLC代码静态分析报告

| 项目 | 内容 |
|---|---|
| 分析对象 | S7-200 SMART STL代码(25个FC) |
| 分析工具 | stl_static_analyzer.py v1.0 |
| 变量表来源 | HMI-PLC变量地址表v1.0 + STL注释 |
| 分析日期 | 2026-07-18 |

## 一、分析摘要

- **问题总数**: 339 个
- **严重**: 3 个
- **警告**: 92 个
- **提示**: 244 个

## 二、STL文件统计

| FC名称 | 引用数 | 写入数 |
|---|---|---|
| FC0_SysInit | 11 | 9 |
| FC10_State_S0_Init | 9 | 5 |
| FC11_State_S1_Inlet | 54 | 36 |
| FC12_State_S2_PreMix | 9 | 6 |
| FC13_State_S3_Dosing | 104 | 46 |
| FC14_State_S35_Rest | 7 | 4 |
| FC15_State_S4_Transfer | 52 | 29 |
| FC16_State_S5_Run | 29 | 16 |
| FC17_State_S6_Drain | 19 | 13 |
| FC18_State_S7_End | 5 | 5 |
| FC19_State_Error | 20 | 13 |
| FC1_StateDispatcher | 12 | 1 |
| FC20_ManualControl | 25 | 10 |
| FC21_ManualSyringePump | 93 | 34 |
| FC22_RTC_Sync | 9 | 6 |
| FC2_EStopHandling | 10 | 5 |
| FC30_ValveA_Diag | 41 | 27 |
| FC31_ValveB_Diag | 39 | 31 |
| FC32_ValveC_Diag | 35 | 27 |
| FC3_AlarmHandling | 156 | 72 |
| FC40_RhythmCorrection | 63 | 40 |
| FC4_ModbusPolling | 81 | 27 |
| OB1_MAIN | 20 | 7 |
| SBR25_ColdStart | 110 | 79 |
| SBR26_WarmRecovery | 83 | 29 |
| **合计** | **1096** | **577** |

## 三、变量定义统计

- VB(字节): 1 个
- VW(字): 23 个
- VD(双字): 25 个
- Vbit(位): 34 个
- **合计**: 83 个变量定义

## 四、问题清单

### 严重(3个)

#### VD编址冲突(3个)

1. **[严重]** VD362(VB362~VB365) 与 VD364(VB364~VB367) 地址重叠
   - VD362引用: ['SBR25_ColdStart:L71(VD362)', 'FC15_State_S4_Transfer:L53(VD362)', 'SBR25_ColdStart:L39(VD362)']
   - VD364引用: ['FC11_State_S1_Inlet:L112(VD364)', 'SBR25_ColdStart:L154(VD364)', 'FC18_State_S7_End:L44(VD364)']
   - 重叠字节: VB364~VB365

2. **[严重]** VD364(VB364~VB367) 与 VD366(VB366~VB369) 地址重叠
   - VD364引用: ['FC11_State_S1_Inlet:L112(VD364)', 'SBR25_ColdStart:L154(VD364)', 'FC18_State_S7_End:L44(VD364)']
   - VD366引用: ['FC16_State_S5_Run:L78(VD366)', 'FC16_State_S5_Run:L105(VD366)']
   - 重叠字节: VB366~VB367

3. **[严重]** VD372(VB372~VB375) 与 VD374(VB374~VB377) 地址重叠
   - VD372引用: ['FC18_State_S7_End:L46(VD372)', 'FC13_State_S3_Dosing:L358(VD372)', 'FC13_State_S3_Dosing:L99(VD372)', 'FC13_State_S3_Dosing:L52(VD372)', 'SBR25_ColdStart:L163(VD372)']
   - VD374引用: ['SBR25_ColdStart:L199(VD374)']
   - 重叠字节: VB374~VB375

### 警告(92个)

#### 跨FC写入冲突(72个)

1. **[警告]** 变量 VW198 被 3 个FC写入: ['FC0_SysInit', 'SBR25_ColdStart', 'SBR26_WarmRecovery']
   - 同一变量被多个FC写入可能导致时序冲突,需确认调用顺序与互斥性

2. **[警告]** 变量 VB378 被 2 个FC写入: ['FC0_SysInit', 'SBR25_ColdStart']
   - 同一变量被多个FC写入可能导致时序冲突,需确认调用顺序与互斥性

3. **[警告]** 变量 VB379 被 2 个FC写入: ['FC0_SysInit', 'SBR25_ColdStart']
   - 同一变量被多个FC写入可能导致时序冲突,需确认调用顺序与互斥性

4. **[警告]** 变量 VB380 被 2 个FC写入: ['FC0_SysInit', 'SBR25_ColdStart']
   - 同一变量被多个FC写入可能导致时序冲突,需确认调用顺序与互斥性

5. **[警告]** 变量 VB381 被 2 个FC写入: ['FC0_SysInit', 'SBR25_ColdStart']
   - 同一变量被多个FC写入可能导致时序冲突,需确认调用顺序与互斥性

6. **[警告]** 变量 VW390 被 4 个FC写入: ['FC0_SysInit', 'FC21_ManualSyringePump', 'OB1_MAIN', 'SBR25_ColdStart']
   - 同一变量被多个FC写入可能导致时序冲突,需确认调用顺序与互斥性

7. **[警告]** 变量 VD112 被 2 个FC写入: ['FC10_State_S0_Init', 'FC11_State_S1_Inlet']
   - 同一变量被多个FC写入可能导致时序冲突,需确认调用顺序与互斥性

8. **[警告]** 变量 VD116 被 4 个FC写入: ['FC10_State_S0_Init', 'FC11_State_S1_Inlet', 'FC16_State_S5_Run', 'FC17_State_S6_Drain']
   - 同一变量被多个FC写入可能导致时序冲突,需确认调用顺序与互斥性

9. **[警告]** 变量 VW2 被 20 个FC写入: ['FC10_State_S0_Init', 'FC11_State_S1_Inlet', 'FC12_State_S2_PreMix', 'FC13_State_S3_Dosing', 'FC14_State_S35_Rest', 'FC15_State_S4_Transfer', 'FC16_State_S5_Run', 'FC17_State_S6_Drain', 'FC18_State_S7_End', 'FC19_State_Error', 'FC1_StateDispatcher', 'FC22_RTC_Sync', 'FC2_EStopHandling', 'FC30_ValveA_Diag', 'FC31_ValveB_Diag', 'FC32_ValveC_Diag', 'FC40_RhythmCorrection', 'OB1_MAIN', 'SBR25_ColdStart', 'SBR26_WarmRecovery']
   - 同一变量被多个FC写入可能导致时序冲突,需确认调用顺序与互斥性

10. **[警告]** 变量 V1.0 被 4 个FC写入: ['FC10_State_S0_Init', 'FC18_State_S7_End', 'SBR25_ColdStart', 'SBR26_WarmRecovery']
   - 同一变量被多个FC写入可能导致时序冲突,需确认调用顺序与互斥性

11. **[警告]** 变量 V0.0 被 2 个FC写入: ['FC10_State_S0_Init', 'FC19_State_Error']
   - 同一变量被多个FC写入可能导致时序冲突,需确认调用顺序与互斥性

12. **[警告]** 变量 V1.6 被 5 个FC写入: ['FC11_State_S1_Inlet', 'FC12_State_S2_PreMix', 'FC15_State_S4_Transfer', 'FC19_State_Error', 'SBR25_ColdStart']
   - 同一变量被多个FC写入可能导致时序冲突,需确认调用顺序与互斥性

13. **[警告]** 变量 VD82 被 2 个FC写入: ['FC11_State_S1_Inlet', 'FC30_ValveA_Diag']
   - 同一变量被多个FC写入可能导致时序冲突,需确认调用顺序与互斥性

14. **[警告]** 变量 VB260 被 2 个FC写入: ['FC11_State_S1_Inlet', 'FC30_ValveA_Diag']
   - 同一变量被多个FC写入可能导致时序冲突,需确认调用顺序与互斥性

15. **[警告]** 变量 VB261 被 2 个FC写入: ['FC11_State_S1_Inlet', 'FC30_ValveA_Diag']
   - 同一变量被多个FC写入可能导致时序冲突,需确认调用顺序与互斥性

16. **[警告]** 变量 VB266 被 2 个FC写入: ['FC11_State_S1_Inlet', 'FC30_ValveA_Diag']
   - 同一变量被多个FC写入可能导致时序冲突,需确认调用顺序与互斥性

17. **[警告]** 变量 VW414 被 3 个FC写入: ['FC11_State_S1_Inlet', 'FC15_State_S4_Transfer', 'FC17_State_S6_Drain']
   - 同一变量被多个FC写入可能导致时序冲突,需确认调用顺序与互斥性

18. **[警告]** 变量 VD444 被 5 个FC写入: ['FC11_State_S1_Inlet', 'FC15_State_S4_Transfer', 'FC16_State_S5_Run', 'FC17_State_S6_Drain', 'SBR25_ColdStart']
   - 同一变量被多个FC写入可能导致时序冲突,需确认调用顺序与互斥性

19. **[警告]** 变量 VD150 被 3 个FC写入: ['FC11_State_S1_Inlet', 'FC16_State_S5_Run', 'FC40_RhythmCorrection']
   - 同一变量被多个FC写入可能导致时序冲突,需确认调用顺序与互斥性

20. **[警告]** 变量 VD178 被 5 个FC写入: ['FC11_State_S1_Inlet', 'FC15_State_S4_Transfer', 'FC16_State_S5_Run', 'SBR25_ColdStart', 'SBR26_WarmRecovery']
   - 同一变量被多个FC写入可能导致时序冲突,需确认调用顺序与互斥性

21. **[警告]** 变量 VD154 被 2 个FC写入: ['FC11_State_S1_Inlet', 'FC16_State_S5_Run']
   - 同一变量被多个FC写入可能导致时序冲突,需确认调用顺序与互斥性

22. **[警告]** 变量 VD124 被 2 个FC写入: ['FC11_State_S1_Inlet', 'FC40_RhythmCorrection']
   - 同一变量被多个FC写入可能导致时序冲突,需确认调用顺序与互斥性

23. **[警告]** 变量 VW182 被 2 个FC写入: ['FC11_State_S1_Inlet', 'FC16_State_S5_Run']
   - 同一变量被多个FC写入可能导致时序冲突,需确认调用顺序与互斥性

24. **[警告]** 变量 VD28 被 2 个FC写入: ['FC11_State_S1_Inlet', 'SBR25_ColdStart']
   - 同一变量被多个FC写入可能导致时序冲突,需确认调用顺序与互斥性

25. **[警告]** 变量 VD36 被 2 个FC写入: ['FC11_State_S1_Inlet', 'SBR25_ColdStart']
   - 同一变量被多个FC写入可能导致时序冲突,需确认调用顺序与互斥性

26. **[警告]** 变量 VD364 被 3 个FC写入: ['FC11_State_S1_Inlet', 'FC18_State_S7_End', 'SBR25_ColdStart']
   - 同一变量被多个FC写入可能导致时序冲突,需确认调用顺序与互斥性

27. **[警告]** 变量 VW226 被 3 个FC写入: ['FC12_State_S2_PreMix', 'FC13_State_S3_Dosing', 'SBR25_ColdStart']
   - 同一变量被多个FC写入可能导致时序冲突,需确认调用顺序与互斥性

28. **[警告]** 变量 VD372 被 3 个FC写入: ['FC13_State_S3_Dosing', 'FC18_State_S7_End', 'SBR25_ColdStart']
   - 同一变量被多个FC写入可能导致时序冲突,需确认调用顺序与互斥性

29. **[警告]** 变量 V303.4 被 3 个FC写入: ['FC13_State_S3_Dosing', 'FC3_AlarmHandling', 'FC4_ModbusPolling']
   - 同一变量被多个FC写入可能导致时序冲突,需确认调用顺序与互斥性

30. **[警告]** 变量 VD350 被 3 个FC写入: ['FC13_State_S3_Dosing', 'FC21_ManualSyringePump', 'SBR25_ColdStart']
   - 同一变量被多个FC写入可能导致时序冲突,需确认调用顺序与互斥性

31. **[警告]** 变量 VD102 被 2 个FC写入: ['FC13_State_S3_Dosing', 'FC21_ManualSyringePump']
   - 同一变量被多个FC写入可能导致时序冲突,需确认调用顺序与互斥性

32. **[警告]** 变量 VW204 被 2 个FC写入: ['FC13_State_S3_Dosing', 'FC21_ManualSyringePump']
   - 同一变量被多个FC写入可能导致时序冲突,需确认调用顺序与互斥性

33. **[警告]** 变量 VW206 被 2 个FC写入: ['FC13_State_S3_Dosing', 'FC21_ManualSyringePump']
   - 同一变量被多个FC写入可能导致时序冲突,需确认调用顺序与互斥性

34. **[警告]** 变量 VW230 被 3 个FC写入: ['FC13_State_S3_Dosing', 'FC21_ManualSyringePump', 'SBR25_ColdStart']
   - 同一变量被多个FC写入可能导致时序冲突,需确认调用顺序与互斥性

35. **[警告]** 变量 VD232 被 3 个FC写入: ['FC13_State_S3_Dosing', 'FC21_ManualSyringePump', 'SBR25_ColdStart']
   - 同一变量被多个FC写入可能导致时序冲突,需确认调用顺序与互斥性

36. **[警告]** 变量 VD440 被 3 个FC写入: ['FC13_State_S3_Dosing', 'FC18_State_S7_End', 'SBR25_ColdStart']
   - 同一变量被多个FC写入可能导致时序冲突,需确认调用顺序与互斥性

37. **[警告]** 变量 VB262 被 2 个FC写入: ['FC15_State_S4_Transfer', 'FC31_ValveB_Diag']
   - 同一变量被多个FC写入可能导致时序冲突,需确认调用顺序与互斥性

38. **[警告]** 变量 VB263 被 2 个FC写入: ['FC15_State_S4_Transfer', 'FC31_ValveB_Diag']
   - 同一变量被多个FC写入可能导致时序冲突,需确认调用顺序与互斥性

39. **[警告]** 变量 VB268 被 2 个FC写入: ['FC15_State_S4_Transfer', 'FC31_ValveB_Diag']
   - 同一变量被多个FC写入可能导致时序冲突,需确认调用顺序与互斥性

40. **[警告]** 变量 V1.7 被 4 个FC写入: ['FC15_State_S4_Transfer', 'FC17_State_S6_Drain', 'FC19_State_Error', 'SBR25_ColdStart']
   - 同一变量被多个FC写入可能导致时序冲突,需确认调用顺序与互斥性

41. **[警告]** 变量 V301.6 被 2 个FC写入: ['FC16_State_S5_Run', 'FC3_AlarmHandling']
   - 同一变量被多个FC写入可能导致时序冲突,需确认调用顺序与互斥性

42. **[警告]** 变量 VB264 被 2 个FC写入: ['FC17_State_S6_Drain', 'FC32_ValveC_Diag']
   - 同一变量被多个FC写入可能导致时序冲突,需确认调用顺序与互斥性

43. **[警告]** 变量 VB265 被 2 个FC写入: ['FC17_State_S6_Drain', 'FC32_ValveC_Diag']
   - 同一变量被多个FC写入可能导致时序冲突,需确认调用顺序与互斥性

44. **[警告]** 变量 VW270 被 2 个FC写入: ['FC17_State_S6_Drain', 'FC32_ValveC_Diag']
   - 同一变量被多个FC写入可能导致时序冲突,需确认调用顺序与互斥性

45. **[警告]** 变量 V300.4 被 4 个FC写入: ['FC19_State_Error', 'FC2_EStopHandling', 'SBR25_ColdStart', 'SBR26_WarmRecovery']
   - 同一变量被多个FC写入可能导致时序冲突,需确认调用顺序与互斥性

46. **[警告]** 变量 V300.0 被 3 个FC写入: ['FC19_State_Error', 'FC30_ValveA_Diag', 'FC3_AlarmHandling']
   - 同一变量被多个FC写入可能导致时序冲突,需确认调用顺序与互斥性

47. **[警告]** 变量 VW260 被 4 个FC写入: ['FC19_State_Error', 'OB1_MAIN', 'SBR25_ColdStart', 'SBR26_WarmRecovery']
   - 同一变量被多个FC写入可能导致时序冲突,需确认调用顺序与互斥性

48. **[警告]** 变量 VW6 被 4 个FC写入: ['FC19_State_Error', 'FC2_EStopHandling', 'FC3_AlarmHandling', 'SBR25_ColdStart']
   - 同一变量被多个FC写入可能导致时序冲突,需确认调用顺序与互斥性

49. **[警告]** 变量 V300.5 被 2 个FC写入: ['FC19_State_Error', 'FC2_EStopHandling']
   - 同一变量被多个FC写入可能导致时序冲突,需确认调用顺序与互斥性

50. **[警告]** 变量 VD392 被 2 个FC写入: ['FC21_ManualSyringePump', 'SBR25_ColdStart']
   - 同一变量被多个FC写入可能导致时序冲突,需确认调用顺序与互斥性

51. **[警告]** 变量 VD396 被 2 个FC写入: ['FC21_ManualSyringePump', 'SBR25_ColdStart']
   - 同一变量被多个FC写入可能导致时序冲突,需确认调用顺序与互斥性

52. **[警告]** 变量 V303.5 被 2 个FC写入: ['FC22_RTC_Sync', 'FC3_AlarmHandling']
   - 同一变量被多个FC写入可能导致时序冲突,需确认调用顺序与互斥性

53. **[警告]** 变量 V303.7 被 3 个FC写入: ['FC22_RTC_Sync', 'SBR25_ColdStart', 'SBR26_WarmRecovery']
   - 同一变量被多个FC写入可能导致时序冲突,需确认调用顺序与互斥性

54. **[警告]** 变量 V301.4 被 2 个FC写入: ['FC30_ValveA_Diag', 'FC3_AlarmHandling']
   - 同一变量被多个FC写入可能导致时序冲突,需确认调用顺序与互斥性

55. **[警告]** 变量 V301.5 被 2 个FC写入: ['FC30_ValveA_Diag', 'FC3_AlarmHandling']
   - 同一变量被多个FC写入可能导致时序冲突,需确认调用顺序与互斥性

56. **[警告]** 变量 V301.0 被 2 个FC写入: ['FC30_ValveA_Diag', 'FC3_AlarmHandling']
   - 同一变量被多个FC写入可能导致时序冲突,需确认调用顺序与互斥性

57. **[警告]** 变量 V301.2 被 2 个FC写入: ['FC30_ValveA_Diag', 'FC3_AlarmHandling']
   - 同一变量被多个FC写入可能导致时序冲突,需确认调用顺序与互斥性

58. **[警告]** 变量 V301.3 被 2 个FC写入: ['FC30_ValveA_Diag', 'FC3_AlarmHandling']
   - 同一变量被多个FC写入可能导致时序冲突,需确认调用顺序与互斥性

59. **[警告]** 变量 V300.1 被 2 个FC写入: ['FC31_ValveB_Diag', 'FC3_AlarmHandling']
   - 同一变量被多个FC写入可能导致时序冲突,需确认调用顺序与互斥性

60. **[警告]** 变量 V302.1 被 2 个FC写入: ['FC31_ValveB_Diag', 'FC3_AlarmHandling']
   - 同一变量被多个FC写入可能导致时序冲突,需确认调用顺序与互斥性

61. **[警告]** 变量 V302.2 被 2 个FC写入: ['FC31_ValveB_Diag', 'FC3_AlarmHandling']
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
   - FC: SBR25_ColdStart, 行: 71
   - 位置: SBR25_ColdStart 第71行

105. **[提示]** 变量 VD520 在STL中引用但变量表/注释未定义
   - FC: SBR25_ColdStart, 行: 72
   - 位置: SBR25_ColdStart 第72行

106. **[提示]** 变量 VD524 在STL中引用但变量表/注释未定义
   - FC: SBR25_ColdStart, 行: 73
   - 位置: SBR25_ColdStart 第73行

107. **[提示]** 变量 VD528 在STL中引用但变量表/注释未定义
   - FC: SBR25_ColdStart, 行: 74
   - 位置: SBR25_ColdStart 第74行

108. **[提示]** 变量 VB532 在STL中引用但变量表/注释未定义
   - FC: SBR25_ColdStart, 行: 77
   - 位置: SBR25_ColdStart 第77行

109. **[提示]** 变量 VB388 在STL中引用但变量表/注释未定义
   - FC: SBR25_ColdStart, 行: 77
   - 位置: SBR25_ColdStart 第77行

110. **[提示]** 变量 VB389 在STL中引用但变量表/注释未定义
   - FC: SBR25_ColdStart, 行: 78
   - 位置: SBR25_ColdStart 第78行

111. **[提示]** 变量 VB536 在STL中引用但变量表/注释未定义
   - FC: SBR25_ColdStart, 行: 81
   - 位置: SBR25_ColdStart 第81行

112. **[提示]** 变量 VW300 在STL中引用但变量表/注释未定义
   - FC: SBR25_ColdStart, 行: 139
   - 位置: SBR25_ColdStart 第139行

113. **[提示]** 变量 VB0 在STL中引用但变量表/注释未定义
   - FC: SBR25_ColdStart, 行: 147
   - 位置: SBR25_ColdStart 第147行

114. **[提示]** 变量 VD374 在STL中引用但变量表/注释未定义
   - FC: SBR25_ColdStart, 行: 199
   - 位置: SBR25_ColdStart 第199行

115. **[提示]** 变量 VD186 在STL中引用但变量表/注释未定义
   - FC: SBR26_WarmRecovery, 行: 100
   - 位置: SBR26_WarmRecovery 第100行

116. **[提示]** 变量 VD190 在STL中引用但变量表/注释未定义
   - FC: SBR26_WarmRecovery, 行: 117
   - 位置: SBR26_WarmRecovery 第117行

## 五、跨FC变量访问矩阵(写入)

以下变量被多个FC写入(需确认调用顺序与互斥性):

| 变量 | 写入FC数 | FC列表 |
|---|---|---|
| VW2 | 20 | FC10_State_S0_Init, FC11_State_S1_Inlet, FC12_State_S2_PreMix, FC13_State_S3_Dosing, FC14_State_S35_Rest, FC15_State_S4_Transfer, FC16_State_S5_Run, FC17_State_S6_Drain, FC18_State_S7_End, FC19_State_Error, FC1_StateDispatcher, FC22_RTC_Sync, FC2_EStopHandling, FC30_ValveA_Diag, FC31_ValveB_Diag, FC32_ValveC_Diag, FC40_RhythmCorrection, OB1_MAIN, SBR25_ColdStart, SBR26_WarmRecovery |
| VW6 | 4 | FC19_State_Error, FC2_EStopHandling, FC3_AlarmHandling, SBR25_ColdStart |
| V0.0 | 2 | FC10_State_S0_Init, FC19_State_Error |
| V1.0 | 4 | FC10_State_S0_Init, FC18_State_S7_End, SBR25_ColdStart, SBR26_WarmRecovery |
| V1.6 | 5 | FC11_State_S1_Inlet, FC12_State_S2_PreMix, FC15_State_S4_Transfer, FC19_State_Error, SBR25_ColdStart |
| V1.7 | 4 | FC15_State_S4_Transfer, FC17_State_S6_Drain, FC19_State_Error, SBR25_ColdStart |
| VD28 | 2 | FC11_State_S1_Inlet, SBR25_ColdStart |
| VD32 | 2 | FC40_RhythmCorrection, SBR25_ColdStart |
| VD36 | 2 | FC11_State_S1_Inlet, SBR25_ColdStart |
| VD40 | 2 | FC40_RhythmCorrection, SBR25_ColdStart |
| VD82 | 2 | FC11_State_S1_Inlet, FC30_ValveA_Diag |
| VB260 | 2 | FC11_State_S1_Inlet, FC30_ValveA_Diag |
| VB261 | 2 | FC11_State_S1_Inlet, FC30_ValveA_Diag |
| VB262 | 2 | FC15_State_S4_Transfer, FC31_ValveB_Diag |
| VB263 | 2 | FC15_State_S4_Transfer, FC31_ValveB_Diag |
| VB264 | 2 | FC17_State_S6_Drain, FC32_ValveC_Diag |
| VB265 | 2 | FC17_State_S6_Drain, FC32_ValveC_Diag |
| VB266 | 2 | FC11_State_S1_Inlet, FC30_ValveA_Diag |
| VB268 | 2 | FC15_State_S4_Transfer, FC31_ValveB_Diag |
| VB378 | 2 | FC0_SysInit, SBR25_ColdStart |
| VB379 | 2 | FC0_SysInit, SBR25_ColdStart |
| VB380 | 2 | FC0_SysInit, SBR25_ColdStart |
| VB381 | 2 | FC0_SysInit, SBR25_ColdStart |
| VD102 | 2 | FC13_State_S3_Dosing, FC21_ManualSyringePump |
| VD112 | 2 | FC10_State_S0_Init, FC11_State_S1_Inlet |
| VD116 | 4 | FC10_State_S0_Init, FC11_State_S1_Inlet, FC16_State_S5_Run, FC17_State_S6_Drain |
| VD124 | 2 | FC11_State_S1_Inlet, FC40_RhythmCorrection |
| VD150 | 3 | FC11_State_S1_Inlet, FC16_State_S5_Run, FC40_RhythmCorrection |
| VD154 | 2 | FC11_State_S1_Inlet, FC16_State_S5_Run |
| VD178 | 5 | FC11_State_S1_Inlet, FC15_State_S4_Transfer, FC16_State_S5_Run, SBR25_ColdStart, SBR26_WarmRecovery |
| VD232 | 3 | FC13_State_S3_Dosing, FC21_ManualSyringePump, SBR25_ColdStart |
| VD350 | 3 | FC13_State_S3_Dosing, FC21_ManualSyringePump, SBR25_ColdStart |
| VD364 | 3 | FC11_State_S1_Inlet, FC18_State_S7_End, SBR25_ColdStart |
| VD372 | 3 | FC13_State_S3_Dosing, FC18_State_S7_End, SBR25_ColdStart |
| VD392 | 2 | FC21_ManualSyringePump, SBR25_ColdStart |
| VD396 | 2 | FC21_ManualSyringePump, SBR25_ColdStart |
| VD440 | 3 | FC13_State_S3_Dosing, FC18_State_S7_End, SBR25_ColdStart |
| VD444 | 5 | FC11_State_S1_Inlet, FC15_State_S4_Transfer, FC16_State_S5_Run, FC17_State_S6_Drain, SBR25_ColdStart |
| VW182 | 2 | FC11_State_S1_Inlet, FC16_State_S5_Run |
| VW198 | 3 | FC0_SysInit, SBR25_ColdStart, SBR26_WarmRecovery |
| VW204 | 2 | FC13_State_S3_Dosing, FC21_ManualSyringePump |
| VW206 | 2 | FC13_State_S3_Dosing, FC21_ManualSyringePump |
| VW226 | 3 | FC12_State_S2_PreMix, FC13_State_S3_Dosing, SBR25_ColdStart |
| VW230 | 3 | FC13_State_S3_Dosing, FC21_ManualSyringePump, SBR25_ColdStart |
| VW260 | 4 | FC19_State_Error, OB1_MAIN, SBR25_ColdStart, SBR26_WarmRecovery |
| VW270 | 2 | FC17_State_S6_Drain, FC32_ValveC_Diag |
| VW290 | 2 | FC4_ModbusPolling, SBR25_ColdStart |
| VW390 | 4 | FC0_SysInit, FC21_ManualSyringePump, OB1_MAIN, SBR25_ColdStart |
| VW414 | 3 | FC11_State_S1_Inlet, FC15_State_S4_Transfer, FC17_State_S6_Drain |
| V300.0 | 3 | FC19_State_Error, FC30_ValveA_Diag, FC3_AlarmHandling |
| V300.1 | 2 | FC31_ValveB_Diag, FC3_AlarmHandling |
| V300.4 | 4 | FC19_State_Error, FC2_EStopHandling, SBR25_ColdStart, SBR26_WarmRecovery |
| V300.5 | 2 | FC19_State_Error, FC2_EStopHandling |
| V301.0 | 2 | FC30_ValveA_Diag, FC3_AlarmHandling |
| V301.2 | 2 | FC30_ValveA_Diag, FC3_AlarmHandling |
| V301.3 | 2 | FC30_ValveA_Diag, FC3_AlarmHandling |
| V301.4 | 2 | FC30_ValveA_Diag, FC3_AlarmHandling |
| V301.5 | 2 | FC30_ValveA_Diag, FC3_AlarmHandling |
| V301.6 | 2 | FC16_State_S5_Run, FC3_AlarmHandling |
| V302.0 | 2 | FC31_ValveB_Diag, FC3_AlarmHandling |
| V302.1 | 2 | FC31_ValveB_Diag, FC3_AlarmHandling |
| V302.2 | 2 | FC31_ValveB_Diag, FC3_AlarmHandling |
| V302.3 | 2 | FC31_ValveB_Diag, FC3_AlarmHandling |
| V302.4 | 2 | FC31_ValveB_Diag, FC3_AlarmHandling |
| V302.5 | 2 | FC32_ValveC_Diag, FC3_AlarmHandling |
| V302.6 | 2 | FC32_ValveC_Diag, FC3_AlarmHandling |
| V302.7 | 2 | FC32_ValveC_Diag, FC3_AlarmHandling |
| V303.0 | 2 | FC32_ValveC_Diag, FC3_AlarmHandling |
| V303.1 | 2 | FC32_ValveC_Diag, FC3_AlarmHandling |
| V303.4 | 3 | FC13_State_S3_Dosing, FC3_AlarmHandling, FC4_ModbusPolling |
| V303.5 | 2 | FC22_RTC_Sync, FC3_AlarmHandling |
| V303.7 | 3 | FC22_RTC_Sync, SBR25_ColdStart, SBR26_WarmRecovery |

## 六、V区使用热力图(引用次数Top20)

| 字节地址 | 引用次数 |
|---|---|
| VB2 | 70 |
| VB3 | 70 |
| VB303 | 53 |
| VB302 | 50 |
| VB226 | 48 |
| VB227 | 48 |
| VB7 | 45 |
| VB6 | 44 |
| VB300 | 43 |
| VB390 | 42 |
| VB391 | 42 |
| VB301 | 40 |
| VB1 | 30 |
| VB4 | 23 |
| VB5 | 23 |
| VB260 | 21 |
| VB261 | 16 |
| VB306 | 16 |
| VB0 | 14 |
| VB102 | 14 |

## 七、结论与建议

❌ 发现 3 个严重问题,必须立即修复后方可交付。
ℹ️ 另有 244 个提示项,可择机处理。

---

*本报告由 stl_static_analyzer.py 自动生成,可重复执行以跟踪问题修复进度。*
