Yustnust/AQUA-EXPO/plc/spec/Story1.2_状态机骨架_程序设计规格书_v1.0.md

# PLC程序设计规格书 — Story 1.2 状态机S0-S7骨架

**配套文档**：《药液配置加注控制系统_PLC设计文档》v9.3、《HMI-PLC变量地址表》v1.0
**Jira Issue**：AQEX-6
**程序架构**：西门子 S7-200 SMART，OB1主循环 + FC功能块
**本规格书范围**：状态机骨架（状态调度 + S0~S7各状态基本动作 + 状态转移条件）
**不含**：阀门诊断(Story 1.3)、节奏纠偏(Story 1.4)、急停详细逻辑(Story 1.5)、报警详细逻辑(Story 1.6)、断电恢复详细逻辑(Story 1.7)——这些在各状态FC中预留调用接口，后续Story填充
**v1.1 变更**：S4(FC15)增加"下缸已排空"互锁(V1.7=0),节拍保持并行,详见 2.6 节
**v10 变更**：FC10 启动前置条件新增硬件液位开关检查（I0.6 上缸低位+I1.0 下缸低位）；不满足时发 V301.7 提示报警（一般故障级，不加进 VW6 优先级链）；液位计硬件类型更正：低液位为 NPN 常闭、高液位为 NPN 常开（原文档错标为"常开"），详见《PLC设计文档》v10 DI 表

---

## 一、程序总体架构

### 1.1 程序组织块(POU)清单

| POU | 类型 | 名称 | 调用方式 | 功能 |
|---|---|---|---|---|
| OB1 | 主循环 | MAIN | 系统自动 | 主循环，调用各FC |
| **FC0** | **功能块** | **SysInit** | **首次扫描(SM0.1)** | **★ v1.1 拆分: 调度骨架 — Modbus清零 + 冷启/断电路径调度(JMP 1→CALL SBR26; CALL SBR25→LBL 2)** |
| **SBR25** | **子例程** | **ColdStart** | **FC0内 CALL** | **★ v1.1 新增: 冷启动路径 — 出厂硬编码 + 用户默认覆盖 + TODR读RTC + RTC合法性检查 + 安全初始化 + RET** |
| **SBR26** | **子例程** | **WarmRecovery** | **FC0内 CALL** | **★ v1.1 新增: 断电恢复路径 — TODR读RTC + 合法性检查 + BCD转秒 + VD_S5_Elapsed重算 + 状态机恢复 + RET** |
| FC1 | 功能块 | StateDispatcher | 每周期 | 状态机调度，根据VW2调用对应状态FC |
| FC10 | 功能块 | State_S0_Init | VW2=0时 | S0初始化状态 |
| FC11 | 功能块 | State_S1_Inlet | VW2=1时 | S1上缸进水 |
| FC12 | 功能块 | State_S2_PreMix | VW2=2时 | S2预循环搅拌 |
| FC13 | 功能块 | State_S3_Dosing | VW2=3时 | S3加药 |
| FC14 | 功能块 | State_S35_Rest | VW2=4时 | S3.5静止等候 |
| FC15 | 功能块 | State_S4_Transfer | VW2=5时 | S4上→下转移 |
| FC16 | 功能块 | State_S5_Run | VW2=6时 | S5实验运行中 |
| FC17 | 功能块 | State_S6_Drain | VW2=7时 | S6下缸排水 |
| FC18 | 功能块 | State_S7_End | VW2=8时 | S7实验结束 |
| FC19 | 功能块 | State_Error | VW2=99时 | 故障锁定 |
| FC2 | 功能块 | EStopHandling | 每周期 | 急停与安全处理（骨架预留） |
| FC3 | 功能块 | AlarmHandling | 每周期 | 报警处理（骨架预留） |
| FC4 | 功能块 | ModbusPolling | 每周期 | Modbus通讯轮询（骨架预留） |

### 1.2 OB1主循环结构

```
OB1 MAIN:
  // 首次扫描初始化
  IF SM0.1 THEN
    CALL FC0(SysInit)
  END_IF

  // 每周期调用：安全与通讯（优先级最高，任何状态都执行）
  CALL FC2(EStopHandling)    // 急停处理（可强制转移至S_ERROR）
  CALL FC4(ModbusPolling)    // Modbus轮询
  CALL FC3(AlarmHandling)    // 报警处理

  // 状态机调度（急停触发时FC2会强制VW2=99，跳过正常状态调度）
  CALL FC1(StateDispatcher)

  // 每周期刷新HMI握手状态等
  CALL FC99(HmiRefresh)      // HMI状态刷新（可选，骨架预留）
```

### 1.3 状态调度器FC1逻辑

```
FC1 StateDispatcher:
  // 根据VW2当前状态值调用对应FC
  CASE VW2 OF
    0:   CALL FC10(State_S0_Init)
    1:   CALL FC11(State_S1_Inlet)
    2:   CALL FC12(State_S2_PreMix)
    3:   CALL FC13(State_S3_Dosing)
    4:   CALL FC14(State_S35_Rest)
    5:   CALL FC15(State_S4_Transfer)
    6:   CALL FC16(State_S5_Run)
    7:   CALL FC17(State_S6_Drain)
    8:   CALL FC18(State_S7_End)
    99:  CALL FC19(State_Error)
    ELSE: VW2 := 0   // 非法状态值，强制回S0
  END_CASE
```

---

## 二、各状态FC规格

### 2.1 FC10 — S0初始化 (VW2=0)

**功能**：系统上电/复位后的初始状态，清空状态标志，复位所有输出，等待启动命令。

**进入条件**：
- 首次扫描(SM0.1)经FC0设置
- 急停解除后系统复位(I0.3按下)
- S7实验结束后物理系统复位(I0.3按下，v10重写：原V0.0软命令改I0.3硬按钮)

**动作**：
| 动作 | 说明 |
|---|---|
| 复位上下缸状态 | V1.6=0(上缸空), V1.7=0(下缸空) |
| 复位所有DO | Q0.0~Q1.0全部=0（潜水泵停、阀门关、报警停） |
| 复位急停锁存 | M_EStop_Latch(V300.4)=0 |
| 复位报警标志 | VB300~VB303清零, VW6=0 |
| 清除命令握手 | V1.0~V1.5=0（响应已完成的命令确认位） |

**转移条件**：
| 条件 | 目标状态 | 说明 |
|---|---|---|
| CMD_Start(V0.0)上升沿 AND 无活动报警(VW6=0) AND **上缸排空(I0.6=ON)** | →S1(VW2=1) | **v10新增硬件液位前置**：只查上缸I0.6=NPN常闭低液位（液体低于探针闭合=I=1），不查下缸。S1是上缸进水阶段，下缸有水不影响；下缸状态在S4(上→下转移)和S6(下缸排水)各自互锁。原实现只查VW6=0，遗漏缸未排空不能启动的设计约束 |
| 急停触发(I1.1=OFF) | →S_ERROR(VW2=99) | FC2强制转移 |

**退出动作**：置V1.0=1(启动命令已接收握手)

---

### 2.2 FC11 — S1上缸进水 (VW2=1)

**功能**：打开阀A向上缸进水，用差值法计量进水量，达到目标进水量后关闭阀A并验证。

**进入条件**：从S0接收CMD_Start

**进入动作**：
| 动作 | 变量 | 说明 |
|---|---|---|
| 记录流量计快照 | VD_FlowMeter_Snapshot(VD82) = MB_Flow_Total | 差值法基准 |
| 开启阀A | Q0.2=1 | 电动球阀A打开 |
| 启动S1实测计时 | T37开始计时 | 记录VD_S1_Actual |
| 置上缸状态 | V1.6=0(空) | 进水开始，仍为空 |

**周期动作**：
| 动作 | 说明 |
|---|---|
| 计算当前进水量 | VD_Current_InletVolume(VD90) = MB_Flow_Total − VD_FlowMeter_Snapshot |
| 漫溢保护检测 | 若I0.5(液位计A高位)=ON → 触发M_Alarm_Overflow_AHigh + NC电磁阀上缸(Q0.5)动作 → 转S_ERROR |
| 阀A开到位超时检测 | 若开启后VD_Timeout_ValveA时间内I1.3未ON → 报警 |
| 流量开关A检测 | 阀A开到位后I0.0应ON，否则报警 |

**转移条件**：
| 条件 | 目标状态 | 说明 |
|---|---|---|
| VD_Current_InletVolume ≥ 目标进水量 | →S2(VW2=2) | 进水达标（目标进水量待定义，暂用VD_Vol_Target或单独定义VD_Inlet_Target） |
| 阀A关闭超时/故障报警 | →S_ERROR | 故障锁定 |
| 急停触发 | →S_ERROR | FC2强制 |

**退出动作**：
| 动作 | 说明 |
|---|---|
| 关闭阀A | Q0.2=0 |
| 延时验证(VD_Delay_ValveA_Verify) | 验证流量开关A=OFF且流量计差值不再增长 |
| 记录VD_S1_Actual | T37当前值存入VD70 |
| 【预留】二次校正接口 | S1完成后触发纠偏二次校正(Story 1.4填充) |

**【骨架阶段简化】**：目标进水量暂用固定值或HMI设定，差值法计量逻辑实现，漫溢保护和延时验证实现，但阀门详细诊断(内漏/四态)留接口给Story 1.3。

---

### 2.3 FC12 — S2预循环 (VW2=2)

**功能**：开启潜水泵1和2对上缸溶液搅拌预循环。

**进入条件**：从S1进水完成

**进入动作**：
| 动作 | 变量 | 说明 |
|---|---|---|
| 启动潜水泵1 | Q0.0=1 | 搅拌泵1 |
| 启动潜水泵2 | Q0.1=1 | 搅拌泵2 |
| 启动S2计时 | T38计时 | 目标时长=VD_S2_Target(VD120) |
| 置上缸状态 | V1.6=1(满) | 进水完成，上缸满 |

**周期动作**：
| 动作 | 说明 |
|---|---|
| 潜水泵流量检测 | I0.3/I0.4应在VD_Timeout_Pump内ON，否则报警 |
| 计时到达检测 | T38 ≥ VD_S2_Target |

**转移条件**：
| 条件 | 目标状态 | 说明 |
|---|---|---|
| T38 ≥ VD_S2_Target | →S3(VW2=3) | 预循环完成 |
| 潜水泵故障报警 | →S_ERROR | 故障锁定 |
| 急停触发 | →S_ERROR | FC2强制 |

**退出动作**：
| 动作 | 说明 |
|---|---|
| 停潜水泵1 | Q0.0=0 |
| 停潜水泵2 | Q0.1=0 |

---

### 2.4 FC13 — S3加药 (VW2=3)

**功能**：根据目标浓度和进水量计算加药步数，控制注射泵抽液和排液。

**进入条件**：从S2预循环完成

**进入动作**：
| 动作 | 变量 | 说明 |
|---|---|---|
| 计算目标体积 | VD_Vol_Target(VD98) = VD_C_Set × VD_Current_InletVolume / VD_C_Stock | µL |
| 计算目标步数 | VD_Dose_Steps(VD102) = VD_Vol_Target / VD_StepResolution | 步 |
| 下发注射泵抽液指令 | MB_Pump_Aspirate(VW204) = VD_Dose_Steps | 写入40006 |
| 下发注射泵排液指令 | MB_Pump_Dispense(VW206) = VD_Dose_Steps | 写入40007 |
| 置泵工作标志 | 内部标志位 | 等待注射泵完成 |

**周期动作**：
| 动作 | 说明 |
|---|---|
| 轮询注射泵状态码 | VW4(映射自41001)，0=完成，1=运行中，2=抽液，3=排液，其他=错误 |
| 注射泵超时检测 | 长时间无响应或状态码报错 → 报警 |

**转移条件**：
| 条件 | 目标状态 | 说明 |
|---|---|---|
| VW4=0(注射泵完成) | →S3.5(VW2=4) | 加药完成 |
| 注射泵故障报警 | →S_ERROR | 故障锁定 |
| 急停触发 | →S_ERROR | FC2强制 |

**退出动作**：无（注射泵自动停止）

---

### 2.5 FC14 — S3.5静止等候 (VW2=4)

**功能**：加药完成后静止等候溶液沉降。

**进入条件**：从S3加药完成

**进入动作**：
| 动作 | 变量 | 说明 |
|---|---|---|
| 启动S3.5计时 | T39计时 | 目标时长=VD_RestTime_Target(VD124) |

**周期动作**：仅计时，无输出动作

**转移条件**：
| 条件 | 目标状态 | 说明 |
|---|---|---|
| T39 ≥ VD_RestTime_Target | →S4(VW2=5) | 静止等候完成 |
| 急停触发 | →S_ERROR | FC2强制 |

**退出动作**：无

---

### 2.6 FC15 — S4上→下转移 (VW2=5)

**功能**：打开阀B将上缸溶液转移至下缸。**v1.1起增加"下缸已排空"互锁:下缸未空时静默等待,直到S6排空完成后自动开阀,期间不报错、不停机。**

**进入条件**：从S3.5静止等候完成(VW2=5)

**进入动作**：见下表(每周期检测,见 v1.1 互锁逻辑)

**v1.1 互锁逻辑(关键变更)**：

> **业务约束**:S4启动前必须确认下缸已排空(V1.7=0)。否则**静默等待**(不报错、不停机、不进S_ERROR),S5的预规划已转S1~S3.5进行上缸配液,本FC每周期重新检测V1.7,**下缸一空立即开阀B转液**。

| 检测项 | 条件 | 动作 |
|---|---|---|
| 状态=S4 | `AW= VW2, 5` | 必备前置条件 |
| 下缸排空检查 | `AN V1.7` | V1.7=1(下缸满)→屏蔽本FC所有S/R/计时/赋值指令 |
| 互锁放行 | V1.7=0 | 进入动作分支:开阀B、启动计时、置上缸空、启动阀B诊断 |

> **实现要点**:
> - 触发条件用 `LD SM0.0 + AW= VW2, 5`,**不用 M10.4 EU**,避免首周期 V1.7=1 时错过启动
> - 用 `LPS` 嵌套 + `AN V1.7` 在同 NETWORK 内实现动态屏蔽,符合 S7-200 SMART 的 JMP/LBL 同 NETWORK 约束
> - FC31 阀B诊断的 NETWORK 1 漫溢保护(液位 B 高位)仍每周期无条件执行——下缸真高位时强制转 S_ERROR,这是该有的安全兜底
> - 当 Diag_State_B(VW262)=0(未启动)时,FC31 走子状态 0 空转,不会误报

**进入动作**(互锁放行后执行)：
| 动作 | 变量 | 说明 |
|---|---|---|
| 开启阀B | Q0.3=1 | 电动球阀B打开 |
| 开启下缸NC球阀 | Q0.6=1 | 与阀B串联,需得电导通 |
| 启动S4计时 | T40计时 | 记录VD_S4_Actual(VD74) |
| 置上缸状态 | V1.6=0(空) | 开始转移,上缸排空 |
| 启动阀B诊断 | VB262=1 | 置诊断子状态=1(等开到位) |
| 清诊断结果 | VW268=0 | 清空上次诊断结果 |

**周期动作**：
| 动作 | 说明 |
|---|---|
| **v1.1互锁轮询** | 每周期重新检测 V1.7,下缸一空立即开阀(无需 M10.4 EU) |
| 漫溢保护检测 | 若I0.7(液位计B高位)=ON → 触发M_Alarm_Overflow_BHigh + NC电磁阀下缸(Q0.6)动作 → 转S_ERROR |
| 阀B四态诊断 | 【Story 1.3填充】流量开关B + 液位计A低位组合判断 |
| 阀B超时检测 | VD_Timeout_ValveB时间内流量开关B未ON → 报警 |
| 上缸排空检测 | I0.6(液位计A低位)=ON → 上缸已排空（NPN常闭型，液体低于探针时闭合=I=1） |

**转移条件**：
| 条件 | 目标状态 | 说明 |
|---|---|---|
| 互锁放行 + I0.6(液位计A低位)=ON AND 流量开关B(I0.1)=OFF | →S5(VW2=6) | 转移完成（上缸空+无流量）。I0.6=NPN常闭（v10更正硬件类型） |
| **v1.1新增** 互锁等待(V1.7=1) | 保持S4 | 静默等待下缸排空,不报错、不停机 |
| 阀B故障报警 | →S_ERROR | 故障锁定 |
| 急停触发 | →S_ERROR | FC2强制 |

**时序示意**：

```
S5 (下缸跑)  ──┬─→ 换水周期到 ──→ S6 排水 (与上缸配液并行)
              │
              └─→ Available 触发 ──→ S1 → S2 → S3 → S3.5 (上缸配液)
                                          │
                                          ↓ 进入 S4
                                          ↓
                                    ┌─ V1.7=0(下缸空) ──→ 开阀B → 转S5
                                    │
                                    └─ V1.7=1(下缸满) ──→ 静默等待,每周期轮询
                                                       (直到 S6 排空完成)
```

**退出动作**：
| 动作 | 说明 |
|---|---|
| 关闭阀B | Q0.3=0 |
| 记录VD_S4_Actual | T40当前值存入VD74 |
| 置下缸状态 | V1.7=1(满) | 转移完成，下缸满 |
| 【关键】记录DT_TankB_FullTime | 当前RTC时间写入DT10 | 用于换水周期计算 |

---

### 2.7 FC16 — S5实验运行中 (VW2=6)

**功能**：实验主体运行阶段，按换水周期循环执行S1→S6，累计实验时长，触发节奏纠偏预规划。

**进入条件**：从S4转移完成（首次进入）

**进入动作**：
| 动作 | 变量 | 说明 |
|---|---|---|
| S5上升沿触发预规划 | 【Story 1.4填充】计算本轮S2/S3.5目标时长 | 纠偏算法 |
| 启动换水周期计时 | T41计时 | 周期=VD_CycleSetpoint(VD20) |
| 启动实验时长累加 | VD_ExperimentDuration_Accum(VD96)开始累加 | 仅下缸=满期间 |

**周期动作**：
| 动作 | 说明 |
|---|---|
| 换水周期到达检测 | T41 ≥ VD_CycleSetpoint → 启动新一轮S1 |
| 实验时长检测 | VD_ExperimentDuration_Accum ≥ VD_ExperimentTarget → 实验结束转S7 |
| 实验时长累加 | 每周期VW8(轮次)+1 |

**转移条件**：
| 条件 | 目标状态 | 说明 |
|---|---|---|
| 换水周期到达(T41≥VD_CycleSetpoint) AND 上缸状态=空 | →S1(VW2=1) | 新一轮换水 |
| 换水周期到达 AND 上缸状态≠空 | →S_ERROR | 异常（上缸未排空，比节奏滞后更严重） |
| VD_ExperimentDuration_Accum ≥ VD_ExperimentTarget | →S7(VW2=8) | 实验时长达标,结束 |
| CMD_Stop(V0.2)上升沿 | →S7(VW2=8) | HMI手动停止 |
| 急停触发 | →S_ERROR | FC2强制 |

> **v1.1 配套说明**:S5 的"换水周期到达 → S1" 预规划触发**不**检查下缸是否已排空——S1~S3.5 的上缸配液流程可以在下缸排水期间并行进行。仅 S4 入口增加 V1.7 互锁。详细见 2.6 节。

> **v1.2 配套说明**:FC16 NETWORK 4 转 S6 触发判据已由 `VD_S5_Elapsed >= CycleSetpoint×60` 改为 `VD_S5_Elapsed >= CycleSetpoint×60 - VD_S4Wait_Time`。这保证:
>
> - VD_S5_Elapsed 语义保持纯"下缸满的时长",不变
> - 但 S6 触发阈值被 S4 等待时长动态"减去"——等效于"把被等待占用的时间补偿回 S5 有效实验时间"
>
> **举例说明**:
> - 假设 CycleSetpoint = 60min, S4 等待 10min
> - 旧逻辑:VD178 累加 60min 后转 S6(但下缸在 50min 时就被 S4 互锁占着没跑实验)→ 实际有效实验 50min
> - 新逻辑:阈值 = 60min - 10min = 50min → VD178 累加 50min 即转 S6(下缸只跑了 50min 但被"补偿"回 10min 等待)
>
> **结论**:S5 的"下缸有效实验时间"严格按 VD_CycleSetpoint 跑满,不被 S4 等待压缩。

**退出动作**：
| 动作 | 说明 |
|---|---|
| 停止换水周期计时 | T41复位 |
| 【若转S1】保持实验时长累加 | S5返回S1时累加继续 |
| 【若转S7】停止实验时长累加 | 实验结束 |

---

### 2.8 FC17 — S6下缸排水 (VW2=7)

**功能**：实验结束后排空下缸溶液。

**进入条件**：从S5实验运行中（换水周期内）或S7实验结束

**进入动作**：
| 动作 | 变量 | 说明 |
|---|---|---|
| 开启阀C | Q0.4=1 | 电动球阀C打开 |
| 启动S6计时 | T42计时 | 记录VD_S6_Actual(VD78) |

**周期动作**：
| 动作 | 说明 |
|---|---|
| 阀C四态诊断 | 【Story 1.3填充】流量开关C + 液位计B低位组合判断 |
| 阀C超时检测 | VD_Timeout_ValveC时间内流量开关C未ON → 报警 |
| 下缸排空检测 | I1.0(液位计B低位)=ON → 下缸已排空（NPN常闭型，液体低于探针时闭合=I=1） |

**转移条件**：
| 条件 | 目标状态 | 说明 |
|---|---|---|
| I1.0(液位计B低位)=ON AND 流量开关C(I0.2)=OFF | →S5(VW2=6) | 排空完成，返回实验运行（换水周期内）。I1.0=NPN常闭（v10更正硬件类型） |
| 排水完成 AND 实验已结束标志 | →S7(VW2=8) | 实验结束后的最终排水 |
| 阀C故障报警 | →S_ERROR | 故障锁定 |
| 急停触发 | →S_ERROR | FC2强制 |

**退出动作**：
| 动作 | 说明 |
|---|---|
| 关闭阀C | Q0.4=0 |
| 记录VD_S6_Actual | T42当前值存入VD78 |
| 更新VD_S6_Rolling | 滚动更新S6排水时长 |
| 置下缸状态 | V1.7=0(空) | 排空完成 |

---

### 2.9 FC18 — S7实验结束 (VW2=8)

**功能**：实验全部完成，状态机锁定，提示人工按系统复位后回S0。

**进入条件**：实验时长达标(VD_ExperimentDuration_Accum ≥ VD_ExperimentTarget)或HMI手动停止(CMD_Stop)

**进入动作**：
| 动作 | 说明 |
|---|---|
| 复位DO安全状态 | 复位Q0.0~Q0.6(泵/阀),保留Q0.7 |
| 停止实验时长累加 | 停T47(1分钟基准计时),VD_ExperimentDuration_Accum锁定最终值 |
| 置实验结束标志 | S M10.6,1(供S6判断是否走最终排水→S7路径) |

**周期动作**：每周期 S V301.7,1（v10新增），HMI滚动条显示"⚠️ 实验已结束，请按【系统复位】按钮后再启动"。纯提示位，不加进VW6优先级链，不锁S_ERROR。

**转移条件**：
| 条件 | 目标状态 | 说明 |
|---|---|---|
| **I0.3上升沿 AND I1.1=OFF** | →S0(VW2=0) | **v10重写**：S7唯一出口为物理系统复位按钮(I0.3)，需急停已释放(I1.1=OFF)。**彻底屏蔽CMD_Start(V0.0)**，按钮名"启动实验"语义在S7回S0时不干净，改后V0.0只在S0有效。回S0后FC10接管，V0.0+I0.6=ON才能真正启动 |
| 急停触发(I1.1=OFF) | →S_ERROR | FC2强制 |

**退出动作**（按系统复位按钮时）：
| 动作 | 说明 |
|---|---|
| R M10.6,1 | 清实验结束标志 |
| R V1.0,1 | 清启动握手位 |
| R V301.7,1 | 清HMI提示位（滚动条消失） |
| 清零累计值 | VD364/VD378/VD372 全部 → 0 |
| MOVW 0, VW2 | 状态回S0，FC10接管后续启动检查 |

---

### 2.10 FC19 — S_ERROR故障锁定 (VW2=99)

**功能**：急停或最高级报警触发后的故障锁定状态，所有输出强制安全状态。

**进入条件**：急停触发(I1.1=OFF)或安全继电器故障或漫溢报警

**进入动作**：
| 动作 | 说明 |
|---|---|
| 复位所有DO（安全状态） | 潜水泵停、电动球阀关、报警声音/灯光开 |
| NC电磁阀保持失电(关闭) | Q0.5=0, Q0.6=0（常闭型，失电=关闭=安全） |
| 置急停锁存 | M_EStop_Latch(V300.4)=1 |
| 置故障状态标志 | 供HMI显示 |

**周期动作**：
| 动作 | 说明 |
|---|---|
| 等待急停解除 | I1.1=ON(急停按钮恢复) |
| 等待系统复位 | I2.3(系统复位按钮)按下 |

**转移条件**：
| 条件 | 目标状态 | 说明 |
|---|---|---|
| I1.1=ON(急停解除) AND I2.3上升沿(系统复位) | →S0(VW2=0) | 急停解除并系统复位，回S0 |
| 安全继电器故障未消除 | 保持S_ERROR | 不允许离开故障态 |

**退出动作**：清除M_EStop_Latch（由S0执行）

---

## 三、FC2急停处理（骨架预留）

```
FC2 EStopHandling:
  // 检测急停触发
  IF I1.1 = OFF THEN  // 急停按钮按下（常闭触点断开）
    VW2 := 99          // 强制转故障态
    M_EStop_Latch := 1
  END_IF

  // 安全继电器反馈检测
  IF M_EStop_Latch AND (I1.2超时未反馈) THEN
    M_Alarm_SafetyRelay := 1  // 最高级报警
  END_IF

  // 【详细逻辑由Story 1.5填充】
```

---

## 四、FC3报警处理（骨架预留）

```
FC3 AlarmHandling:
  // 扫描报警字，计算最高优先级报警码写入VW6
  // 【详细逻辑由Story 1.6填充】

  // 骨架：简单示例
  IF M_Alarm_SafetyRelay THEN
    VW6 := 99
  ELSIF M_Alarm_Overflow_AHigh OR M_Alarm_Overflow_BHigh THEN
    VW6 := 10
  ELSIF M_Alarm_ScheduleLag THEN
    VW6 := 20
  END_IF
```

---

## 五、FC4 Modbus通讯轮询（骨架预留）

```
FC4 ModbusPolling:
  // 轮询注射泵状态码(41001) → VW4
  // 轮询流量计累计值(0x0009) → VD86
  // 【详细逻辑由Story 1.1填充，含MBUS_MSG指令调用】
```

---

## 六、变量使用清单（本骨架涉及的变量）

| 变量 | 类型 | 用途 | 来源 |
|---|---|---|---|
| VW2 | INT | 状态机当前状态 | 变量表5.1 |
| VW4 | INT | 注射泵状态码 | 变量表5.2 |
| VW6 | INT | 当前最高优先级报警码 | 变量表5.3 |
| VW8 | INT | 实验轮次计数 | 变量表5.4 |
| V0.0 | BOOL | CMD_Start | 变量表4.1 |
| V0.2 | BOOL | CMD_Stop | 变量表4.1 |
| V1.0~V1.5 | BOOL | 命令握手确认 | 变量表4.2 |
| V1.6/V1.7 | BOOL | 上下缸状态 | 变量表4.2 |
| I0.0~I2.3 | BOOL | 19点DI | 变量表2 |
| Q0.0~Q1.0 | BOOL | 9点DO | 变量表3 |
| V300.4 | BOOL | M_EStop_Latch | 变量表9.1 |
| V300.5 | BOOL | M_Alarm_SafetyRelay | 变量表9.1 |
| V300.0/1 | BOOL | M_Alarm_Overflow_AHigh/BHigh | 变量表9.1 |
| VD20 | REAL | VD_CycleSetpoint | 变量表6.2 |
| VD24 | REAL | VD_ExperimentTarget | 变量表6.2 |
| VD48/50/54 | REAL | 阀A/B/C超时 | 变量表6.3 |
| VD58/62 | REAL | 泵1/2超时 | 变量表6.3 |
| VD66 | REAL | 阀A延时验证 | 变量表6.3 |
| VD70/74/78 | REAL | S1/S4/S6实测时长 | 变量表7.1 |
| VD82 | DWORD | 流量计快照 | 变量表7.2 |
| VD86 | DWORD | 流量计当前值 | 变量表7.2 |
| VD90 | REAL | 当前进水量 | 变量表7.2 |
| VD96 | REAL | 实验时长累加 | 变量表7.3 |
| VD98 | REAL | 目标母液体积 | 变量表7.4 |
| VD102 | REAL | 加药目标步数 | 变量表7.4 |
| VD120 | REAL | VD_S2_Target | 变量表8.3 |
| VD124 | REAL | VD_RestTime_Target | 变量表8.3 |
| VW204/206 | INT | 注射泵抽/排液步数 | 变量表11.2 |
| DT10 | DT | DT_TankB_FullTime | 变量表10 |
| T37~T42 | TIMER | 各状态计时器 | 本规格书定义 |

---

## 七、计时器分配

| 计时器 | 类型 | 用途 | 时基 |
|---|---|---|---|
| T37 | TON | S1进水计时(→VD_S1_Actual) | 100ms |
| T38 | TON | S2预循环计时(对比VD_S2_Target) | 100ms |
| T39 | TON | S3.5静止等候计时(对比VD_RestTime_Target) | 100ms |
| T40 | TON | S4转移计时(→VD_S4_Actual) | 100ms |
| T41 | TON | S5换水周期计时(对比VD_CycleSetpoint) | 100ms |
| T42 | TON | S6排水计时(→VD_S6_Actual) | 100ms |

**注**：S7-200 SMART定时器T37~T63为100ms时基(最大3276.7s≈54.6min)，若VD_CycleSetpoint可能超过此范围需用计数器+定时器组合或改用1s时基T65~T73。

---

## 八、与后续Story的接口预留

| 后续Story | 预留接口 | 位置 |
|---|---|---|
| Story 1.1 I/O配置 | FC4 Modbus轮询详细实现 | FC4 |
| Story 1.3 阀门诊断 | 各状态FC中的"四态诊断"调用点 | FC11/FC15/FC17 |
| Story 1.4 节奏纠偏 | FC16 S5上升沿预规划 + FC11 S1完成二次校正 | FC16/FC11 |
| Story 1.5 急停详细 | FC2完整实现 | FC2 |
| Story 1.6 报警详细 | FC3完整实现 | FC3 |
| Story 1.7 断电恢复 | FC0初始化中的RTC检测 + DT_TankB_FullTime恢复 | FC0/FC10 |

---

**规格书版本**：v1.2
**编制日期**：2026-07-15
**修订日期**：2026-08-27
**修订内容**：v1.2 新增 S4 等待计时(VD_S4Wait_Time)与超时报警(V303.2),FC16 NETWORK 4 转 S6 阈值动态减去等待时间补偿
**修订内容**：S4 上→下转移增加"下缸已排空"互锁(V1.7=0),节拍保持并行,具体见 2.6 节
**配套**：STL代码文件见 plc/stl/ 目录
