Yustnust/AQUA-EXPO/plc/spec/Story1.6_报警详细_程序设计规格书_v1.0.md

# Story 1.6 报警分级与消音/消光逻辑 — 程序设计规格书 v1.0

**Jira**: AQEX-10
**关联文档**: PLC设计文档 v9.3 第八章(报警分级)、第二章(I/O)、HMI-PLC变量地址表 v1.0 第九章
**前置依赖**: Story 1.2 状态机骨架(FC3骨架)、Story 1.3 阀门诊断(18项报警位)、Story 1.4 节奏纠偏(V300.6/7)、Story 1.5 急停(V300.4/5)
**产出**: 本规格书 + FC3 STL代码重写 + 编址冲突修复 + FC19/变量表同步更新

---

## 一、概述与设计决策闭环

### 1.1 范围

实现 PLC 设计文档第八章定义的报警完整功能:
- **8.1 报警分级**:漫溢风险级/节奏滞后级/一般故障级/最高级(继电器故障)的优先级与处理方式
- **8.2 消音/消光独立处理**:I2.1就地消音+V0.4 HMI消音 → 只关声音;V0.3 HMI报警确认 → 根本原因消失后才消光+清锁存
- **8.3 报警日志**:时间戳+单元编号+报警类型+动作(触发/消音/已知晓/复位),写入断电保持区
- **9.3 报警确认模式**:M_AlarmAckMode(0=自动恢复/1=人工确认),漫溢/节奏滞后/继电器故障不受此模式影响

### 1.2 设计决策闭环(10项)

| # | 决策项 | 结论 | 依据 |
|---|---|---|---|
| 1 | FC3职责边界 | **FC3负责报警码计算VW6+消音消光输出管理+确认命令处理+日志记录**;不负责报警位的置位(由各FC置位)、不负责状态机锁定(由FC2/FC19) | FC3是报警"汇总+输出+确认"中枢,各报警源独立置位 |
| 2 | 优先级链实现方式 | **用LPS/LPP+AW=比较+条件跳转**,非纯JMP链 | S7-200 SMART STL的JMP是栈顶条件跳转,需先LD压栈;骨架原写法语法不严谨,重写为规范的"比较→跳转"结构 |
| 3 | 报警码细分编码 | **十位=类别,个位=细分序号**(如阀A关到位超时=32);VW6保存最高优先级未确认报警码 | 变量表9.2已定义编码规则;细分编码让HMI能精确定位报警类型 |
| 4 | 消音触发源 | **I2.1就地按钮(上升沿) OR V0.4 HMI命令(上升沿)**,两者都关Q0.7 | 第八章8.2"就地按钮或HMI命令";新报警重新鸣响(消音不锁存) |
| 5 | 消光(报警确认)条件 | **V0.3上升沿 AND 报警根本原因已消失(VW6=0 OR 对应报警位=0)**;高优先级需HMI二次确认(HMI侧实现,PLC只收V0.3) | 8.2"根本原因消失后确认才消光";8.2说明高优先级二次确认由HMI实现 |
| 6 | M_AlarmAckMode编址 | **改用V200.0**(独立位),弃用变量表建议的V124.0 | V124.0与VD124(VD_RestTime_Target,Story1.4用)冲突;V200.0独立无冲突 |
| 7 | CMD_SafetyRelayAck编址 | **改用V0.7**(Story1.5误用V0.5,与变量表CMD_ForceTankA_Empty冲突) | 变量表V0.5=CMD_ForceTankA_Empty,V0.6=CMD_ForceTankA_Full;V0.7原预留,继电器故障确认属安全关键,优先占用 |
| 8 | 自动恢复模式处理 | **M_AlarmAckMode=0时,一般故障级报警位在条件消失后自动R复位**;漫溢/节奏滞后/继电器故障不受此模式影响,保持锁存 | 8.1"自动恢复模式→条件消失后自动清除";仅一般故障级适用 |
| 9 | 报警日志存储 | **VB500~VB599环形缓冲区,16字节/条,最多6条**;新报警触发时写入,满则覆盖最旧 | 8.3要求记录;S7-200 SMART V区有限,6条够HMI轮询读取;详细历史由HMI侧存储 |
| 10 | 报警输出Q0.7/Q1.0管理权 | **FC3统一管理Q1.0灯光;Q0.7声音由FC2(急停)/FC19(故障态)置位+FC3管理消音** | 避免多FC双写;FC3每周期根据VW6管理Q1.0,FC2/FC19只置Q0.7不碰Q1.0 |

### 1.3 待确认项(0项)

本Story所有逻辑依据第八章规格,无新增待确认项。

---

## 二、编址冲突修复(关键)

### 2.1 M_AlarmAckMode 编址修正

| 项 | 原方案(冲突) | 修正方案 |
|---|---|---|
| 地址 | V124.0 | **V200.0** |
| 冲突原因 | V124.0属于VD124(VD_RestTime_Target,Story1.4已用) | V200.0独立位,无冲突 |
| 类型 | BOOL | BOOL |
| 说明 | 0=自动恢复,1=人工确认 | 同 |

### 2.2 CMD_SafetyRelayAck 编址修正

| 项 | Story1.5原方案(冲突) | 修正方案 |
|---|---|---|
| 地址 | V0.5 | **V0.7** |
| 冲突原因 | V0.5=CMD_ForceTankA_Empty(变量表已定义) | V0.7原预留,安全关键功能优先占用 |
| 影响文件 | FC19_State_Error.stl | 需同步更新FC19 |

### 2.3 V0区命令位最终编址

| 地址 | 符号 | 说明 | 状态 |
|---|---|---|---|
| V0.0 | CMD_Start | 启动实验 | 不变 |
| V0.1 | CMD_Pause | 暂停(预留) | 不变 |
| V0.2 | CMD_Stop | 停止实验 | 不变 |
| V0.3 | CMD_AckAlarm | 报警确认(HMI) | 不变 |
| V0.4 | CMD_Mute | 消音命令(HMI) | 不变 |
| V0.5 | CMD_ForceTankA_Empty | 强制上缸=空 | 不变(恢复变量表原定义) |
| V0.6 | CMD_ForceTankA_Full | 强制上缸=满 | 不变 |
| V0.7 | **CMD_SafetyRelayAck** | 继电器故障高权限确认(Story1.5修正) | **新增定义** |

---

## 三、程序架构

### 3.1 修改POU

| POU | 类型 | 动作 | 职责 |
|---|---|---|---|
| FC3 AlarmHandling | 修改 | 重写 | 报警码计算+消音消光+确认处理+自动恢复+日志 |
| FC19 State_Error | 修改 | 编址修正 | V0.5→V0.7(SafetyRelayAck) |

### 3.2 新增变量分配

| 地址 | 符号 | 类型 | 说明 |
|---|---|---|---|
| V200.0 | M_AlarmAckMode | BOOL | 报警确认模式(0=自动恢复/1=人工确认) |
| VW202 | VW_Log_Index | WORD | 日志缓冲区当前写入索引(0~5) |
| VB500~VB599 | 报警日志缓冲区 | BYTE | 6条×16字节,环形 |
| M11.0 | M_NewAlarm_Flag | BOOL | 新报警触发标志(本周期置位,日志写入用) |
| M11.1 | M_Sound_Latched | BOOL | 声音已消音标志(新报警时清,实现"新报警重新鸣响") |

### 3.3 报警日志条目结构(16字节/条)

| 偏移 | 字段 | 长度 | 说明 |
|---|---|---|---|
| +0 | 时间戳 | 8 | DT格式(年月日时分秒星期,BCD) |
| +8 | 单元编号 | 1 | 本PLC固定=1(8套独立,各PLC自己=1) |
| +9 | 报警码 | 1 | VW6低字节(如99/10/30等) |
| +10 | 动作 | 1 | 1=触发/2=消音/3=已知晓/4=复位 |
| +11~+15 | 预留 | 5 | 扩展用 |

### 3.4 计时器分配

无新增计时器(消音/确认用上升沿,无延时需求)。

---

## 四、FC3 报警处理规格

### 4.1 NETWORK结构

| NETWORK | 功能 |
|---|---|
| 1 | 优先级链计算VW6(最高优先级未确认报警码) |
| 2 | 报警输出管理:有报警→灯光Q1.0常亮;新报警→声音Q1.0重新鸣响 |
| 3 | 消音处理(I2.1 OR V0.4 → 关声音,置M_Sound_Latched) |
| 4 | 报警确认处理(V0.3 → 根本原因消失才消光+清锁存) |
| 5 | 自动恢复模式(M_AlarmAckMode=0时,一般故障级条件消失自动R复位) |
| 6 | 新报警检测+日志写入(优先级链变化且新报警→写日志) |

### 4.2 NETWORK 1: 优先级链计算VW6

```
// 优先级: 99(继电器故障) > 10~14(漫溢/急停) > 20(节奏滞后严重) > 21(节奏滞后提示)
//         > 30~39(阀A) > 40~44(阀B) > 50~53(阀C) > 60~61(泵) > 70(注射泵) > 80(RTC) > 90(流量开关)
// 用LPS压栈+条件跳转实现,跳转到nAlarmCodeDone

// 最高级: 安全继电器故障
LD     V300.5
JMP    nCode99

// 漫溢级
LD     V300.0                        // 上缸漫溢
JMP    nCode10
LD     V300.1                        // 下缸漫溢
JMP    nCode11
LD     V300.2                        // NC阀上缸动作
JMP    nCode12
LD     V300.3                        // NC阀下缸动作
JMP    nCode13
LD     V300.4                        // 急停锁存
JMP    nCode14

// 节奏滞后级
LD     V300.6                        // 严重滞后
JMP    nCode20
LD     V300.7                        // 滞后提示
JMP    nCode21

// 阀A类(30~36)
LD     V301.0                        // 关后仍有流
JMP    nCode30
LD     V301.1                        // 内漏
JMP    nCode31
... (V301.2~V301.6 → 32~36)

// 阀B/C/泵类(40~47)
LD     V302.0                        // 阀B诊断异常
JMP    nCode40
... (V302.1~V302.7 → 41~47)

// 其他(60~66)
LD     V303.0                        // 阀C关到位超时
JMP    nCode60
... (V303.1~V303.6 → 61~66)

// 无报警
LD     SM0.0
MOVW   0, VW6
JMP    nAlarmCodeDone

// 报警码赋值标签
nCode99:  MOVW 99, VW6   JMP nAlarmCodeDone
nCode10:  MOVW 10, VW6   JMP nAlarmCodeDone
... (依次类推)

nAlarmCodeDone:
```

### 4.3 NETWORK 2: 报警输出管理

```
// 有活动报警(VW6≠0) → 灯光Q1.0常亮
// 新报警(VW6由0变非0) → 清M_Sound_Latched,声音重新鸣响
LD     VW6
LPS
AW<>   VW6, 0
S      Q1.0, 1                        // 灯光常亮
LPP

// 新报警检测: VW6上升沿(0→非0) → 清消音标志,声音重鸣
LD     VW6
EU                                  // 上升沿(注意:VW6是字,EU按位检测,改用比较)
// 改用: 上一周期VW6=0 且 本周期VW6≠0
// 用M11.2保存上一周期VW6状态
LD     M11.2                        // 上一周期有报警
AN     M11.2                        // 本逻辑需调整,见STL实现
// 简化: 本周期VW6≠0且M_Sound_Latched=0 → 声音开
LD     VW6
AW<>   VW6, 0
AN     M11.1                        // 未消音
S      Q0.7, 1                       // 声音开
// 更新上一周期标志
LD     VW6
AW<>   VW6, 0
=      M11.2                        // 记录本周期有报警
```

### 4.4 NETWORK 3: 消音处理

```
// 消音源: I2.1就地按钮(上升沿) OR V0.4 HMI命令(上升沿)
LD     I2.1
EU
O      V0.4
EU
R      Q0.7, 1                       // 关声音
S      M11.1, 1                      // 置消音标志(新报警时清)
S      V1.4, 1                       // STA_MuteDone握手
R      V0.4, 1                       // 清HMI消音命令
// 注: 消音只关声音,灯光Q1.0和报警锁存保持;新报警(VW6变化)时M11.1清,声音重鸣
```

### 4.5 NETWORK 4: 报警确认处理(消光)

```
// V0.3上升沿 = HMI报警确认命令
// 确认规则:
//   1. 高优先级(漫溢/节奏滞后/继电器故障):HMI侧二次确认,PLC只收V0.3,根本原因消失后才消光+清锁存
//   2. 一般故障级:M_AlarmAckMode=1(人工)时需V0.3确认;M_AlarmAckMode=0(自动)时条件消失自动清(见NETWORK5)
LD     V0.3
EU
S      V1.3, 1                       // STA_AlarmAckDone握手
R      V0.3, 1                       // 清确认命令
// 检查根本原因是否消失: VW6=0(所有报警位已清)才允许消光
LD     VW6
AW=    VW6, 0
R      Q1.0, 1                       // 根本原因消失,关灯光
// 注: 根本原因未消失(VW6≠0)时,确认只记录"已知晓",灯光保持
```

### 4.6 NETWORK 5: 自动恢复模式

```
// M_AlarmAckMode=0(自动恢复)时,一般故障级报警位条件消失自动R复位
// 漫溢/节奏滞后/继电器故障不受此模式影响,保持锁存
LD     V200.0                        // M_AlarmAckMode=0(自动)
NOT                                     // 取反:=0时执行
// 阀A类一般故障自动复位(条件:对应DI恢复正常)
// 例如V301.0(阀A关后仍有流): 阀A已关到位且流量开关A=OFF时复位
LD     V301.0                        // 阀A关后仍有流报警
AN     I0.0                          // 流量开关A已OFF(条件消失)
R      V301.0, 1                     // 自动复位
// ... 其他一般故障级同理,按各自条件复位
// 注: 漫溢(V300.0~V300.3)/急停(V300.4)/继电器故障(V300.5)/节奏滞后(V300.6/7)不在此处理
```

### 4.7 NETWORK 6: 新报警检测+日志写入

```
// VW6由0变非0(新报警触发) → 写日志
LD     M11.2                        // 上一周期VW6=0(无报警)
AN     M11.2                        // (逻辑调整,见STL)
// 简化: VW6≠0且M11.3(上一周期无报警)=1 → 新报警
LD     VW6
AW<>   VW6, 0
A      M11.3                        // 上一周期无报警
EU                                  // 上升沿
// 写日志: READ_RTC → VB500+索引×16
CALL   FC50:V AlarmLog              // 日志写入子程序(可选,或内联)
// 简化内联: 索引VW202 × 16 + VB500 = 起始地址
// 实际STL用指针AR1实现
```

> **注**: NETWORK 6 的日志写入涉及间接寻址(指针),STL实现较复杂。本Story给出规格,STL实现用简化版(固定地址+索引比较),完整环形缓冲区可在后续优化。

---

## 五、优先级与编码完整表

### 5.1 报警码完整编码(本Story细化)

| VW6 | 优先级 | 报警位 | 报警类型 | 强制人工确认 |
|---|---|---|---|---|
| 99 | 最高级 | V300.5 | 安全继电器故障 | 是 |
| 10 | 漫溢级 | V300.0 | 上缸漫溢(液位计A-高位) | 是 |
| 11 | 漫溢级 | V300.1 | 下缸漫溢(液位计B-高位) | 是 |
| 12 | 漫溢级 | V300.2 | NC电磁阀-上缸动作 | 是 |
| 13 | 漫溢级 | V300.3 | NC电磁阀-下缸动作 | 是 |
| 14 | 漫溢级 | V300.4 | 急停触发锁存 | 是 |
| 20 | 节奏级 | V300.6 | 节奏严重滞后(三层纠偏用尽) | 是 |
| 21 | 一般级 | V300.7 | 节奏滞后提示(第2层顺延) | 按模式 |
| 30 | 一般级 | V301.0 | 阀A关后仍有流 | 按模式 |
| 31 | 一般级 | V301.1 | 阀A内漏 | 按模式 |
| 32 | 一般级 | V301.2 | 阀A关到位超时 | 按模式 |
| 33 | 一般级 | V301.3 | 阀A关到位但仍有流 | 按模式 |
| 34 | 一般级 | V301.4 | 阀A开到位超时 | 按模式 |
| 35 | 一般级 | V301.5 | 阀A开到位但无流 | 按模式 |
| 36 | 一般级 | V301.6 | S5触发S1时上缸≠空 | 按模式 |
| 40 | 一般级 | V302.0 | 阀B四态诊断异常 | 按模式 |
| 41 | 一般级 | V302.1 | 阀B开到位超时 | 按模式 |
| 42 | 一般级 | V302.2 | 阀B开到位但无流 | 按模式 |
| 43 | 一般级 | V302.3 | 阀B关到位超时 | 按模式 |
| 44 | 一般级 | V302.4 | 阀B关到位但仍有流 | 按模式 |
| 45 | 一般级 | V302.5 | 阀C四态诊断异常 | 按模式 |
| 46 | 一般级 | V302.6 | 阀C开到位超时 | 按模式 |
| 47 | 一般级 | V302.7 | 阀C开到位但无流 | 按模式 |
| 60 | 一般级 | V303.0 | 阀C关到位超时 | 按模式 |
| 61 | 一般级 | V303.1 | 阀C关到位但仍有流 | 按模式 |
| 62 | 一般级 | V303.2 | 潜水泵1超时无流 | 按模式 |
| 63 | 一般级 | V303.3 | 潜水泵2超时无流 | 按模式 |
| 64 | 一般级 | V303.4 | 注射泵通讯/动作异常 | 按模式 |
| 65 | 一般级 | V303.5 | RTC时钟丢失 | 按模式 |
| 66 | 一般级 | V303.6 | 流量开关瞬时异常 | 按模式 |

### 5.2 优先级判定逻辑

```
最高级(99) > 漫溢级(10~14) > 节奏级(20) > 一般级(21,30~66)
VW6始终保存当前最高优先级未确认报警码
同时多个报警时,取优先级最高的一个编码
```

---

## 六、消音/消光/确认完整时序

### 6.1 消音时序

```
T0: 报警触发,VW6=30(阀A故障),Q0.7=1(声音),Q1.0=1(灯光),M11.1=0
T1: 操作员按I2.1(就地消音) 或 HMI下发V0.4=1
  → FC3 NETWORK3: R Q0.7(关声音), S M11.1(消音标志), S V1.4(握手)
  → 灯光Q1.0保持,报警位V301.0保持,VW6=30保持
T2: 新报警触发(VW6变化,如新增V301.1)
  → FC3 NETWORK2: M11.1被清(新报警重鸣逻辑),Q0.7=1(声音重鸣)
  → 操作员需再次消音
```

### 6.2 消光(报警确认)时序

```
场景A: 一般故障级,M_AlarmAckMode=1(人工确认)
T0: 阀A故障V301.0置位,VW6=30,Q1.0=1
T1: 操作员在HMI查看报警详情,现场修复阀A
T2: 阀A恢复正常(流量开关A=OFF),但V301.0仍锁存(人工确认模式)
T3: HMI下发V0.3=1(报警确认)
  → FC3 NETWORK4: S V1.3(握手), 检查VW6
  → 此时V301.0仍置位,VW6=30≠0 → 根本原因未消失,只记录"已知晓",Q1.0保持
  → 注: 人工确认模式下,报警位需先自动/手动复位,VW6才变0
  → 实际: NETWORK5自动恢复模式关闭,需操作员先消缺,再由NETWORK5? 不,人工模式下NETWORK5不执行
  → 修正: 人工确认模式下,报警位复位也需V0.3确认触发(见6.2修正)

修正时序(人工确认模式):
T0: V301.0置位,VW6=30,Q1.0=1
T1: 现场修复阀A(流量开关A=OFF)
T2: HMI下发V0.3=1
  → FC3 NETWORK4: 检查VW6, V301.0仍置位→VW6=30≠0 → 记录"已知晓"
  → 但此时条件已消失(流量开关A=OFF),NETWORK4应增加"条件消失则复位报警位"
  → 修正: NETWORK4在V0.3上升沿时,先检查每个报警位的条件,条件消失的复位报警位,再重算VW6
T3: V301.0复位后,VW6=0
T4: Q1.0=0(消光)

简化方案: NETWORK4收到V0.3后,执行"条件消失的所有报警位复位"(不区分模式),然后重算VW6,若VW6=0则消光
```

### 6.3 自动恢复时序

```
场景B: 一般故障级,M_AlarmAckMode=0(自动恢复)
T0: 阀A故障V301.0置位,VW6=30,Q1.0=1
T1: 现场修复阀A(流量开关A=OFF)
T2: FC3 NETWORK5: M_AlarmAckMode=0,检查V301.0条件(I0.0=OFF)
  → 条件消失 → R V301.0(自动复位)
T3: 下一周期NETWORK1重算: VW6=0
T4: NETWORK2: VW6=0 → Q1.0保持(因未收到V0.3确认?)
  → 修正: 自动模式下VW6=0应自动消光
  → NETWORK2增加: VW6=0且M_AlarmAckMode=0 → R Q1.0

修正: 自动恢复模式下,VW6变0即自动消光,无需V0.3确认
```

### 6.4 高优先级报警时序(漫溢/节奏滞后/继电器故障)

```
T0: 漫溢报警V300.0置位,VW6=10,Q1.0=1,状态机转S_ERROR(由FC2/诊断FC触发)
T1: 现场处理,液位下降,液位计A-高位=OFF
T2: 但V300.0强制人工确认,NETWORK5不自动复位(漫溢级不受M_AlarmAckMode影响)
T3: HMI二次确认(长按/高权限)后下发V0.3
  → NETWORK4: 检查V300.0条件(液位计A-高位=OFF)→条件消失→R V300.0
  → 重算VW6=0 → R Q1.0(消光)
T4: 系统复位按钮(I2.3)回S0(由FC19处理)
```

---

## 七、FC19 编址修正

### 7.1 修改内容

FC19 NETWORK4 中 `V0.5` 改为 `V0.7`:

```
// 原代码(Story1.5,有冲突):
LD     V0.5
EU
A      I1.2
R      V300.5, 1
R      V0.5, 1

// 修正代码:
LD     V0.7                         // CMD_SafetyRelayAck(修正编址)
EU
A      I1.2
R      V300.5, 1
R      V0.7, 1
```

### 7.2 FC19 文件头注释同步更新

V0.5 → V0.7,文件头符号说明同步。

---

## 八、变量表文档同步更新

### 8.1 需更新项

| 位置 | 原内容 | 修正内容 |
|---|---|---|
| 9.3章 M_AlarmAckMode | "建议V124.0" | "V200.0(独立位,避开VD124冲突)" |
| 11.x章 V0.7 | "预留" | "CMD_SafetyRelayAck 继电器故障高权限确认" |
| 14章待确认事项 | V0.7预留 | V0.7已用于CMD_SafetyRelayAck |

---

## 九、验证要点

1. **优先级链**:同时置位V300.5和V301.0,VW6=99(最高级优先)
2. **消音**:I2.1按下,Q0.7=0,Q1.0保持,VW6不变
3. **新报警重鸣**:消音后新报警触发,Q0.7=1(声音重鸣)
4. **消光(自动模式)**:M_AlarmAckMode=0,条件消失→报警位自动复位→VW6=0→Q1.0=0
5. **消光(人工模式)**:M_AlarmAckMode=1,条件消失+V0.3确认→报警位复位→VW6=0→Q1.0=0
6. **高优先级强制人工**:漫溢报警,即使M_AlarmAckMode=0,条件消失也不自动复位,必须V0.3确认
7. **编址修复**:V200.0(M_AlarmAckMode)与VD124无冲突;V0.7(SafetyRelayAck)与V0.5/0.6无冲突
8. **日志写入**:新报警触发,VB500+索引×16写入时间戳+报警码+动作=1

---

// ============================================================
// 规格书结束
// ============================================================
