Yustnust/AQUA-EXPO/docs/S2-S4流程重构设计方案_v2.1.md

# S2-S4 流程重构与 24h 换水次数硬约束设计方案 v2.1

> **配套文档**：《药液配置加注控制系统_PLC设计文档》v9.x、《HMI-PLC变量地址表_v1.8+》、《PLC_完整寄存器映射表_v1.1》  
> **适用范围**：8套缸单元（S7-200 SMART CPU ST20 + EM DT16/DR16），1台本地集中HMI  
> **文档性质**：设计调整方案（已按用户后续8点意见修正），待用户确认后实施  

---

## 一、设计目标

本次调整解决三个核心问题：

1. **取消独立预循环环节**：S1 上缸注水结束后，直接进入 **S2 搅拌 + 加药** 合并阶段；S2 时间到达后进入 **S3 配完等待转移**；接到下缸排空信号后进入 S4 上下缸转移。
2. **实现上下缸并行工作**：在单 VW2 状态机下无法真正并行，新增上缸配液子流程状态字 **VW208** + 触发标志 **M10.3**。下缸实验（S4~S6）与上缸配液（S1~S3）并行。
3. **引入 24h 换水次数硬约束**：用户设定 24h 内下缸必须完成的换水次数 `VD414`。第一轮后的循环必须严格满足；搅拌时间严格固定；S5 实验时间覆盖 S4~S6 全过程，作为弹性量自动调节周期。

---

## 二、状态机重新定义

### 2.1 VW2（下缸主状态机）

| 值 | 状态 | 说明 |
|---|---|---|
| 0 | S0 初始化 | 待机、等待启动 |
| 5 | S4 转移 | 上缸 → 下缸转移（交汇点） |
| 6 | S5 实验运行 | 下缸内有液或正在转移/排水，实验计时中 |
| 7 | S6 下缸排水 | 下缸排空 |
| 8 | S7 实验结束 | 全部结束 |
| 99 | S_ERROR | 报警停机 |

> S5 计时区间：**从 S4 启动开始，到 S6 排水结束为止**。  
> S6 启动采用**倒计时**：在 S5 目标时长剩余 S6_est 时启动排水，确保总周期 = VD418。

### 2.2 VW208（上缸配液子流程）

| 值 | 状态 | 说明 |
|---|---|---|
| 0 | 空闲 | 上缸无配液任务 |
| 1 | S1 上缸进水 | 阀A开，流量计累计 |
| 2 | S2 搅拌 + 加药 | 潜水泵运行，同时注射泵加药 |
| 3 | S3 配完等待转移 | 已完成，等下缸排空 |
| 4 | 已转移 | 本轮完成，准备下一轮触发 |

### 2.3 正常时序

```
时间轴 ──────────────────────────────────────────────────────────────→

VW2  │S0│        S5（S4+S5+S6）         │        S5（S4+S5+S6）         │...│S7│
     └──┘   ↑_____↑_________↑_________↑   ↑_____↑_________↑_________↑
           S4启动  上缸启动S1   S6启动     S4启动  上缸启动S1   S6启动
                  (FC40预规划)            (FC40预规划)

VW208│0│  1→2→3                    1→2→3                    1→2→3
     ──┘  ↑   ↑                    ↑   ↑
         S4启动触发首轮           S4启动触发下一轮
```

### 2.4 关键规则

- **S4 转移是唯一的上下缸交汇点**：必须同时满足“下缸排空（V1.7=0）”和“上缸已配完（VW208=3）”。
- **S4 启动瞬间即开始 S5 计时**，S5 覆盖 S4/S5/S6 全过程。
- **上缸启动时机由 FC40 预规划**：保证上缸 S1+S2 完成时刻 ≤ S6 启动时刻。
- **S6 采用倒计时启动**：当 S5 剩余时间 = S6_est 时启动排水，确保单次总周期 = VD418。
- **S6 结束后上缸未配完**：直接报警“24h换水次数无法保证”，不再回 S5 空等。
- **搅拌时间严格固定**：VD28 为 HMI 设定参数，不可压缩。
- **结束条件**：总换水次数 ≥ VD414 **且** 总实验时间 ≥ VD_ExperimentTarget，同时满足才进 S7。

---

## 三、变量定义（已查映射表无冲突）

### 3.1 新增变量

| 地址 | 符号 | 类型 | 断电保持 | 默认值 | 说明 |
|---|---|---|---|---|---|
| **VW208** | State_UpTank | INT | 是 | 0 | 上缸配液子流程状态 |
| **VW212** | VW_CycleCount | INT | 是 | 0 | 已完成下缸换水次数 |
| **VD414** | VD_24h_Target | REAL | 是 | 24.0 | HMI设定：24小时内下缸换水目标次数 |
| **VD418** | VD_S5_Elapsed_Target | REAL | 是 | 0.0 | PLC计算：本轮S5目标总时长（秒），每轮S4启动时重算 |
| **VD422** | VD_S5_MinSafe | REAL | 是 | 60.0 | HMI设定：S5最小安全时长（秒） |
| **VD426** | VD_Transfer_Margin | REAL | 是 | 30.0 | HMI设定：S4转移余量（秒） |
| **VD430** | VD_Prep_Safety_Margin | REAL | 是 | 10.0 | HMI设定：上缸配液安全余量（秒） |
| **M10.3** | M_PrepCycleTrigger | BOOL | 否 | 0 | 上缸新一轮配液触发脉冲（FC40置1，VW208进入S1后清0） |
| **T120** | T_MixTotal | TON | — | — | S2搅拌总时长定时器（100ms时基） |

### 3.2 复用变量

| 地址 | 符号 | 用途 |
|---|---|---|
| VD28 | VD_PreMixTime | S2搅拌严格固定时长 |
| VD70 | VD_S1_Actual | S1实测时长，用于FC40预规划 |
| VD108 | VD_S6_Default | S6默认时长，首轮估算用 |
| VD116 | VD_S6_Rolling | S6滚动实测，后续轮次估算用 |
| VD178 | VD_S5_Elapsed | S5已运行时长，计时范围S4启动→S6结束 |
| VD316 | VD_TargetInletVolume | 目标进水量，不变 |
| VD584 | VD_Vol_Target | 目标加药量，不变 |
| VD448 | VD_S4WaitTimeout | 复用为“上缸未在S6启动前完成”超时报警 |

### 3.3 废弃变量（保留地址，程序中不再使用）

| 地址 | 符号 |
|---|---|
| VD32 | VD_PreMixTime_MinSafe |
| VD36 | VD_RestTime |
| VD40 | VD_RestTime_Min |
| VD44 | VD_CycleExtend_Max |
| VD112 | VD_T_Rolling |
| VD120 | VD_S2_Target |
| VD124 | VD_RestTime_Target |
| VD128 | VD_CycleExtend_Target |
| VD144 | VD_T_Default |
| VD150 | VD_Available |
| VD154 | VD_Corr_Needed |
| VD158~VD174 | FC40原内部变量 |
| VW182~VW184 | FC40原输入输出 |
| VD354 | VD_CycleSetpoint |

---

## 四、关键算法

### 4.1 单次周期与 S5 目标总时长计算

每轮 **S4 启动瞬间**执行一次：

```
T_single = 86400.0 / VD414          // 单次目标周期（秒）

S6_est = VD116
IF S6_est < 1.0 THEN S6_est = VD108 // 首轮无滚动值用默认值

VD418 = T_single - S6_est - VD426   // S5目标总时长 = 单次周期 - S6 - S4转移余量

IF VD418 < VD422 THEN
    报警 V303.6 = 24h换水次数设置过激进
    VD418 = VD422                   // 安全兜底
END_IF
```

### 4.2 S6 启动倒计时

```
S6_Start_Countdown = VD418 - S6_est

IF VD_S5_Elapsed >= S6_Start_Countdown THEN
    MOVW 7, VW2                     // 转S6排水
END_IF
```

### 4.3 上缸启动预规划（FC40 新功能）

FC40 每周期调用，计算是否触发上缸新一轮配液。

```
S1_est = VD70
IF S1_est < 1.0 THEN S1_est = 20.0

Prep_Needed = S1_est + VD28 + VD430 // 上缸配液所需时间 + 安全余量

Remaining_To_S6 = (VD418 - S6_est) - VD_S5_Elapsed
// 即：距离S6启动还有多少秒

IF Remaining_To_S6 <= Prep_Needed THEN
    IF VW208 = 0 AND VW6 = 0 THEN
        S M10.3, 1                  // 触发上缸配液
    END_IF
END_IF
```

> 注：FC40 也负责在首轮 S0 启动时尽早触发上缸配液。S0 启动后立即置 M10.3，FC40 同时持续监控。

### 4.4 S6 结束后逻辑

```
IF V1.7 = 0 THEN                    // 下缸排空
    IF VW208 = 3 THEN               // 上缸已配完
        IF 结束条件满足 THEN
            MOVW 8, VW2             // 进S7
        ELSE
            MOVW 5, VW2             // 转S4转移
            INCW VW212              // 换水次数+1
        END_IF
    ELSE
        // 上缸未配完
        报警 = 上缸配液未完成，24h换水次数无法保证
        MOVW 99, VW2                // 或保持S6等待，视报警策略
    END_IF
END_IF
```

### 4.5 结束条件

```
结束条件（同时满足）:
    VW212 >= VD414                    // 换水次数达标
    AND VD_ExperimentDuration_Accum >= VD_ExperimentTarget  // 总实验时间达标

满足后:
    等当前这一轮 S4→S6 正常收尾
    MOVW 8, VW2                       // 进S7实验结束
```

---

## 五、逐FC改动清单

### 5.1 FC40_RhythmCorrection.stl — 功能重构

**删除原功能**：三层纠偏。

**新增功能**：上缸配液启动预规划。

```stl
NETWORK 1: 计算距离S6启动的剩余时间
  LD     SM0.0
  MOVR   VD418, VD186               // S5目标总时长
  -R     VD116, VD186               // - S6_est = S6启动前总时长
  -R     VD178, VD186               // - S5已运行 = 剩余到S6启动

NETWORK 2: 计算上缸配液所需时间
  MOVR   VD70, VD194
  AR<    VD194, 1.0
  MOVR   20.0, VD194                // S1默认
  +R     VD28, VD194                // + 搅拌
  +R     VD430, VD194               // + 安全余量

NETWORK 3: 触发上缸启动
  LD     SM0.0
  AR<=   VD186, VD194               // 剩余到S6 <= 配液所需
  LDW=   VW208, 0                   // 上缸空闲
  ALD
  AW=    VW6, 0
  S      M10.3, 1
```

### 5.2 新建 FC1A_State_S2_MixDose.stl

由 **FC12 + FC13 合并**而来。

**NETWORK 1：首次进入 S2**
```stl
LDW=   VW208, 2
AN     M10.4                        // S2首次进入标志
S      M10.4, 1
S      Q0.0, 1                      // 开潜水泵1
S      Q0.1, 1                      // 开潜水泵2
MOVR   VD28, VD336
*R     10.0, VD336
ROUND  VD336, AC0
MOVW   AC0, VW252
TON    T120, VW252                  // 搅拌总时长
MOVW   0, VW226                     // 加药子状态机初始化
R      V303.4, 1
MOVR   VD584, VD372                 // 剩余量=目标量
MOVR   0.0, VD440                   // 累计加药量清零
```

**NETWORK 2~N：加药子状态机**
复用 FC13 全部状态机逻辑（VW226 0~9），去掉原潜水泵启停和转 S3.5 逻辑。

**NETWORK X：完成判定**
```stl
LDW=   VW226, 9                     // 加药完成
A      T120                         // 搅拌时间到
R      Q0.0, 1
R      Q0.1, 1
R      T120, 1
MOVW   3, VW208                     // 进S3等转移
```

**NETWORK X+1：搅拌到但加药未完**
```stl
LD     T120
AN     VW226.9                      // 加药未完成
// 继续等待加药完成，不报警
```

### 5.3 FC11_State_S1_Inlet.stl

**删除**：
- NETWORK 7 二次校正 FC40 调用
- NETWORK 97/105 中对 VD174 的引用
- 原 S1 完成后 `MOVW 2, VW2` 转 S2

**修改**：
- S1 完成后 `MOVW 2, VW208`（进入上缸 S2）
- `R T120, 1`
- `R M10.4, 1`

### 5.4 FC15_State_S4_Transfer.stl

**NETWORK 1 启动条件**：
```stl
LDW=   VW2, 5                       // 主状态机请求转移（从S6转入）
AN     V1.7                         // 下缸排空
LDW=   VW208, 3                     // 上缸已配完
ALD
AW=    VW6, 0
// 启动阀B + NC下缸阀
MOVW   4, VW208                     // 上缸标记“已转移”
```

**NETWORK 2：S5计时启动 + S5目标重算**
```stl
LD     SM0.0
// 计算VD418（见4.1）
TON    T40, VW286                   // VW286 = VD418×10
```

**NETWORK 3 完成后**：
```stl
// 原代码：置V1.7=1, TODR DT10, 转S5
// S5计时已在S4启动时开始
```

### 5.5 FC16_State_S5_Run.stl

**删除**：
- 原 `MOVW 1, VW2` 启动上缸S1
- 与 VD354 的比较

**新增 NETWORK 2：S6倒计时启动**
```stl
LD     SM0.0
MOVR   VD418, VD200
-R     VD116, VD200                 // S6启动倒计时
-R     VD178, VD200                 // 剩余到S6启动
AR<=   VD200, 0.0
AW=    VW6, 0
MOVW   7, VW2                       // 转S6
```

### 5.6 FC17_State_S6_Drain.stl

**NETWORK 4 状态转移**：
```stl
// 排水完成后
LD     V1.7                         // 下缸排空（取反，按实际液位开关类型）
// 注意：I1.0为NPN常闭，排空=1，此处用实际地址

// 上缸已配完
LDW=   VW208, 3
AW=    VW6, 0

// 结束条件
AR>=   VD366, VD_ExperimentTarget
AW>=   VW212, VD414
→ MOVW 8, VW2

// 未结束
LDW=   VW208, 3
AW=    VW6, 0
AN     (结束条件)
→ MOVW 5, VW2
INCW   VW212

// 上缸未配完
LDW<>  VW208, 3
→ 报警并转S_ERROR
```

### 5.7 FC1_StateDispatcher.stl

**删除**：S1/S2/S3/S3.5 的 LBL 调度  
**保留**：S0/S4/S5/S6/S7/S_ERROR  
**新增**：VW208 子流程调度（或直接写在OB1）

### 5.8 FC10_State_S0_Init.stl

```stl
LD     V0.0
EU
AW=    VW6, 0
A      I0.6                         // 上缸排空
MOVW   0, VW208
R      M10.3, 1
S      M10.3, 1                     // 触发首轮上缸配液
MOVW   6, VW2                       // 下缸直接进S5空等
S      V1.0, 1
```

### 5.9 FC0_SysInit.stl / SBR25_ColdStart.stl

**新增初始化**：
```stl
MOVW   0, VW208
MOVW   0, VW212
R      M10.3, 1
R      M10.4, 1
MOVR   24.0, VD414
MOVR   60.0, VD422
MOVR   30.0, VD426
MOVR   10.0, VD430
MOVR   0.0, VD418
```

**删除初始化**：VD32/36/40/44/112/120/124/128/144/150/154/158~174/354

### 5.10 SBR26_WarmRecovery.stl

**新增上缸状态恢复**：
```stl
LDW=   VW208, 3
// 保持VW208=3（已配完，有机会直接进S4）

LDW<>  VW208, 3
MOVW   0, VW208                     // 其他状态强制回空闲
```

### 5.11 OB1_MAIN.stl

**NETWORK 3 停止命令**：
```stl
MOVW   0, VW208
MOVW   0, VW212
R      M10.3, 1
R      M10.4, 1
R      T120, 1
```

**NETWORK 7 上缸子流程调度**：
```stl
LDW=   VW208, 1 → CALL FC11_State_S1_Inlet
LDW=   VW208, 2 → CALL FC1A_State_S2_MixDose
```

**NETWORK X 调用 FC40**：
```stl
CALL   FC40_RhythmCorrection
```

---

## 六、HMI 变更

### 6.1 参数设定页

| 操作 | 变量 | 说明 |
|---|---|---|
| 新增 | VD414 | 24h换水次数（1~48，默认24） |
| 新增 | VD422 | S5最小安全时长（秒，默认60） |
| 新增 | VD426 | S4转移余量（秒，默认30） |
| 新增 | VD430 | 上缸配液安全余量（秒，默认10） |
| 删除 | VD354 | 原换水周期设定 |
| 删除 | VD32/VD36/VD40/VD44 | 原纠偏参数 |
| 保留 | VD28 | 搅拌时间（严格固定） |
| 保留 | VD316 | 目标进水量 |
| 保留 | VD584 | 目标加药量 |

### 6.2 状态显示页

| 操作 | 变量 | 说明 |
|---|---|---|
| 新增 | VW208 | 上缸配液状态显示 |
| 新增 | VD418 | 本轮S5目标总时长显示 |
| 新增 | VW212 | 已完成换水次数 |
| 新增 | V303.6 | 24h换水次数过激进报警 |
| 删除 | 原S2/S3.5状态显示 | 不再存在 |

### 6.3 MCGS CSV 导入

- 新增 VD414/VD422/VD426/VD430/VW208/VW212 通道
- 删除 VD354/VD32/VD36/VD40/VD44/VD112/VD120/VD124/VD128/VD144

---

## 七、断电保持区调整

新增需要断电保持的变量：
- VW208（上缸配液状态，恢复用）
- VW212（换水计数，配合结束判断）
- VD414/VD422/VD426/VD430（HMI设定）
- VD584（目标加药量，已有）

当前断电保持范围 VB0~VB600 已覆盖，无需调整系统块。

---

## 八、文档修改清单

| 文档 | 修改内容 |
|---|---|
| 《药液配置加注控制系统_PLC设计文档》 | 第四章状态流重构；第七章FC40功能重写；变量表更新 |
| 《HMI-PLC变量地址表》 | 新增VW208/VW212/VD414/VD418/VD422/VD426/VD430；删除废弃变量 |
| 《PLC_完整寄存器映射表》 | 更新新增/废弃变量；释放M10.3/VB208~VB213/VB414~VB433 |
| STEP7符号表CSV | 新增/删除符号 |
| 故障代码字典 | 新增 V303.6 = 24h换水次数设置过激进 |
| 报警现场处置指引 | 新增该报警及“上缸未完成”报警处置说明 |
| MCGS CSV | 新增/删除HMI变量通道 |

---

## 九、待确认事项

1. **上缸未在S6启动前完成时的报警码**：建议用 V303.7 或复用其他未用位。
2. **FC15 中 TODR DT10 时间戳是否保留？** 建议保留，用于调试和日志。
3. **首轮 S0 启动后，FC40 与 FC10 同时触发 M10.3 是否冲突？** FC10 直接置位，FC40 条件满足也置位；VW208=0 时两者不冲突，但需确保只进入一次 S1。
4. **VD418 首轮计算时 VD70=0，S1_est 取默认20s，是否合理？**
5. **S6_est 用 VD116 滚动值，首轮 VD116=0 取 VD108=180s，是否合理？**

---

## 十、工作量评估

| 类别 | 项 | 工作量 |
|---|---|---|
| 新建FC | FC1A_State_S2_MixDose | ★★★ |
| 大改FC | FC40（功能重构）、FC15、FC16、FC17 | ★★★ |
| 中改FC | FC1、FC11、FC10、FC0/SBR25/SBR26、OB1 | ★★ |
| 小改FC | FC2、FC18、FC19 | ★ |
| HMI | 变量表、画面、CSV | ★★ |
| 文档 | 设计文档、地址表、映射表 | ★★★ |

**总体**：中等偏大，风险可控；底层诊断/通讯/急停层不变。
