Yustnust/AQUA-EXPO/docs/HMI-PLC变量地址表_v1.0.md

# 药液配置与加注控制系统 — HMI-PLC 变量地址表 v1.8

**配套文档**：《药液配置加注控制系统\_PLC设计文档》v9.3、《HMI画面架构规划文档》v9.3
**适用范围**：8套缸单元（每套1台S7-200 SMART CPU ST20 + EM DT16/DR16），1台本地集中HMI
**本文档目的**：定义HMI与PLC之间的全部变量地址映射，作为PLC程序开发和HMI组态开发的共同接口契约
**编址规范**：西门子S7-200 SMART V区编址（VB字节/VW字/VD双字/M位/DT日期时间）

> **v1.8变更（2026-09-03，重大修复）**：① **【P0级地址重叠修复】** 手动控制命令位从V2.4~~V3.7**全部迁移至V306.0\~V307.3**。原地址VB2+VB3与VW2（状态机当前状态）物理地址完全重叠，联机调试时写入V3.1会改写VW2=2=S2预循环，导致两台循环泵同时启动；V3.2=1会进入S4并报"阀B开到位超时"；手动控制FC20从未被调用过（VW2≠0时条件不满足）。② 4.4节表格、1.2节地址区规划、附录B快速索引同步更新。③ McgsPro CSV导入文件中"通道地址"列须同步迁移到3（VB306~~VB307），**变量名不变，HMI侧脚本无须改动**。
>
> **v1.9变更（2026-09-11，现场联机Bug定位，方案待实施）**：① **【P0级地址重叠发现】** VB380~~VB383（FC4的4个MBUS\_MSG Error输出）与VD380(VB380~~VB383)/VD382(VB382~~VB385)/VD384(VB384~~VB387)/VW380(VB380~~VB381)物理地址重叠，导致VD382(S4WaitTimeout)被Error=0反复改写VB382→IEEE-754浮点指数位清零→值变4.23E-37；②~~ **~~【P0级代码Bug发现】~~** ~~FC15 L77-79借用VD384(ManualDose\_Target)当临时变量计算T61 PT；③~~ **~~【P2级CSV Bug发现】~~** ~~VD316在MCGS CSV中误标"只读"，HMI无法写入；④ 1.2节地址区规划已标注三个Bug和v1.9待迁移区；⑤ 11.5节修正文档与代码不一致（MBUS\_MSG Error实际占用VB380~~VB383，原文档误写VB384）；⑥ 附录B新增VB378~~VB383/VD380~~387/VD440\~VD452三行。完整重排方案见《VD参数区重排说明 v2.0》第六章，技术债务登记见《技术债务清单 v1.0》TD025/TD026/TD027（Jira AQEX-49）。
>
> **v1.7变更（2026-09-03）**：① FC0\_SysInit冷启动（V304.0=0）时新增24个HMI设定参数的安全默认值初始化（含VD358/VD362/VD54阀超时保护参数，防止TON PT=0立即触发超时报警）；② VD384手动注射泵总加药量冷启动默认值10mL（10000µL），VW388模式默认单次（0）；③ 停用FC4任务3（注射泵速度读40009/40010/40011到VW208/VW210/VW212），轮询路径简化为0→1→2→(4→)→0，注射泵速度完全由泵自身默认值决定，PLC不再干预；④ VD132/VD136/VD140（注射泵速度设定）和VW208/VW210/VW212（速度读取缓冲）保留地址但功能停用。
>
> **v1.6变更（2026-09-02）**：新增VB305系统总状态字（0=良好/1=故障/2=急停），由OB1 NETWORK 10每周期计算，供McgsPro画面顶部"良好"状态指示灯三态动画绑定。
>
> **v1.5变更（2026-09-02）**：新增V304.1/V304.2作为Modbus RTU从站在线状态位（注射泵/流量计），供HMI画面7\_通讯维护显示从站通讯状态；V304.0仍保留为M\_InitDone，避免地址冲突。
>
> **v1.4变更（2026-08-24）**：VD\_T\_Default由VD104迁移至VD144（VD104与VD102 VD\_Dose\_Steps重叠VB104\~105，FC13/FC21写步数会破坏T值）；T/S6默认值由"PLC自动计算"改为"HMI设定参数"（时间周期组），实验启动时FC10播种至VD112/VD116。

***

## 目录

1. [编址总则与地址区规划](#一编址总则与地址区规划)
2. [数字量输入DI映射](#二数字量输入di映射)
3. [数字量输出DO映射](#三数字量输出do映射)
4. [系统命令位与状态位](#四系统命令位与状态位hmi-plc交互)
5. [状态机与泵状态](#五状态机与泵状态)
6. [HMI设定参数（VD区）](#六hmi设定参数vd区)
7. [PLC实测值与计算值（VD区）](#七plc实测值与计算值vd区)
8. [配液节奏纠偏变量](#八配液节奏纠偏变量)
9. [报警标志与报警码定义](#九报警标志与报警码定义)
10. [断电保持时间戳](#十断电保持时间戳)
11. [Modbus从站寄存器映射](#十一modbus从站寄存器映射)
12. [8套PLC网络编址规范](#十二8套plc网络编址规范)
13. [HMI-PLC变量交互总表](#十三hmi-plc变量交互总表)
14. [待确认事项](#十四待确认事项)

***

## 一、编址总则与地址区规划

### 1.1 编址总则

1. **8套PLC程序完全相同**：每台PLC使用相同的变量地址表，区别仅在IP地址（192.168.2.101\~108）。HMI通过不同IP连接不同单元，变量地址在各PLC内一致。
2. **断电保持**：所有需要断电保持的V区变量，需在STEP 7-Micro/WIN SMART的"系统块→断电保持"中配置对应V区范围为断电保持。
3. **HMI访问方式**：HMI通过以太网（S7协议或Modbus TCP，待HMI选型确认）读写PLC的V区变量，按本表地址直接映射。
4. **命名规范**：变量符号采用 `类型_功能_细分` 命名，如 `VD_C_Set`（VD双字/浓度/设定值）、`M_Alarm_Overflow`（M位/报警/漫溢）。
5. **单元编号**：本表适用于1\~8号任一单元，HMI侧按单元编号区分（如"1号单元的VD\_C\_Set"通过连接PLC#1的192.168.2.101读取）。

### 1.2 地址区规划

| 地址区 | 用途 | 数据类型 | 断电保持 |
| --- | --- | --- | --- |
| I0.0 \~ I8.7 | DI物理输入（DR32扩展I8.x） | BOOL | — |
| Q0.0 \~ Q8.0 | DO物理输出（9点） | BOOL | — |
| V0.0 \~ V0.7 | 系统命令位（HMI→PLC） | BOOL | 是 |
| V1.0 \~ V1.7 | 系统状态位（PLC→HMI） | BOOL | 是 |
| **VB2+VB3 = VW2/VW4** | **状态字/状态码（⚠VB2/VB3已被手动控制命令位V2.4~~V3.7 v1.0~~v1.7误占用，v1.8起命令位移至V306.0\~V307.3，VB2/VB3专用于VW2状态机与VW4注射泵状态码）** | **WORD** | **是** |
| V306.0 \~ V307.3 | 手动控制命令位（v1.8新增：HMI→PLC，阀门/泵/注射泵12个命令位；避开VB2/VB3防止与VW2重叠） | BOOL | 是 |
| VW2 | 状态机当前状态 | WORD(INT)  | 是 |
| VW4 | 注射泵状态码（映射自41001） | WORD(INT)  | 否 |
| VW6 | 当前报警码（最高优先级） | WORD(INT)  | 是 |
| VW8 | 当前实验轮次计数 | WORD(INT)  | 是 |
| VD10 \~ VD49 | HMI设定参数（浮点；⚠v2.0 删除VD10(目标浓度)/VD14(母液浓度)；VD18/VD48已迁移至VD350/VD358；VD316目标进水量/VD174 S3估算等见第六节） | REAL | 是(VD10/VD14已删) |
| VD50 \~ VD99 | HMI超时参数（VD50/VD52已迁移至VD358/VD362）+ PLC实测值/计算值 | REAL | 是 |
| VD100 \~ VD119 | 配液节奏纠偏变量（VD102 Dose\_Steps见7.4；VD108 S6\_Default为HMI设定；VD112/VD116滚动实测，见第八节） | REAL | 是 |
| VD120 \~ VD128 | 预规划/校正目标值（VD124 RestTime\_Target、VD128 CycleExtend\_Target） | REAL | 是 |
| VD132 \~ VD140 | 注射泵速度设定（已停用：使用泵自身默认速度，PLC不再干预；冷启动时VD132/136/140不再初始化） | REAL | 是 |
| VD144 | VD\_T\_Default T默认值（HMI设定；原VD104与VD102重叠VB104\~105，v2.3迁移至此） | REAL | 是 |
| VD150 \~ VD199 | 断电恢复、节奏纠偏运算中间值（VD150 Available、VD154 Needed、VD178 S5\_Elapsed、VD186/190 RTC转换等） | REAL | 是 |
| VD308 \~ VD344 | 阀门诊断与状态机运算中间变量（VD308关阀快照保留供HMI查看、VD312已删除、VD316目标进水量【⚠v1.8 CSV通道属性误标"只读"，见TD027；FC0 L128初始化默认10.0L】、VD320\~VD344转换中间值） | REAL/DWORD | 否 |
| VD350 \~ VD379 | AQEX-36迁移的6个VD参数(VD350/354/358/362/366/370)+ 内部降级(VD374流量计上一有效值) | REAL | 是 |
| **VB378 \~ VB383** | **MBUS\_MSG Error 输出区（FC4的4个CALL MBUS\_MSG Error引脚）：VB378=MBUS\_CTRL Error、VB379=任务0、VB380=任务2、VB381=任务1、VB382=任务3、VB383=任务4【⚠v1.9前文档曾误写VB384，现更正】** | BYTE×6 | 否 |
| **VD380 \~ VD387** | **【⚠v2.0 已迁出，AQEX-49】VD380→VD444、VD382→VD448、VD384→VD452。原地址让给 MBUS\_MSG Error** | REAL | 否 |
| **VW380** | **【⚠v2.0 已迁出，AQEX-49】共享定时器暂存→VB414** | WORD | 否 |
| VW388/VW390 | 手动注射泵模式（VW388：0单次/1循环）与子状态（VW390：0空闲/1抽液/2排液/3回零/4完成/99错误） | WORD | 是 |
| VD392/VD396 | 手动注射泵内部累计量(VD392)与剩余量(VD396)，FC21内部变量 | REAL | 否 |
| **VD440 \~ VD455** | **【✅v2.0 本次新增区，AQEX-49】完整迁移清单：VD440=迁自VD378(Dosed\_Volume\_Total)、VD444=迁自VD380(S4Wait\_Time)、VW414=迁自VW380(定时器暂存)、VD448=迁自VD382(S4WaitTimeout,HMI)、VD452=迁自VD384(ManualDose\_Target,HMI)。完整占用全景见《VD参数区重排说明 v2.0》第六章** | REAL/WORD  | VD448/452是 |
| VB300 \~ VB303 | 报警字（4 字节 32 位，按位编码；HMI 经 Modbus 读取 VW300/VW302 后拆分为 VB300\~VB303） | BYTE×4 | 是 |
| **VB305** | **系统总状态字（0=良好/1=故障/2=急停，OB1 NETWORK 10每周期计算）** | **BYTE** | **否** |
| VB500 \~ VB599 | 报警日志缓冲区（FC3，6条×16字节） | BYTE | 是 |
| VB600 \~ VB6xx | Modbus RTU Master库占用区（见STEP7系统块配置） | BYTE | 否 |
| DT区域 | 断电保持时间戳（DT10 = VB10\~VB17） | DT | 是 |

***

## 二、数字量输入DI映射

**接线原则**：流量开关、液位计、急停常闭触点、安全继电器反馈触点为无源触点，直接接入PLC自身24VDC回路；阀门限位反馈为有源正极输出，必须经中间继电器转换后接入。

| 物理地址 | 符号 | 信号来源  | 信号类型 | 用途 |
| ---- | --- | ----- | ---- | --- |
| I0.0 | DI\_FlowSwitch\_A | 流量开关A | 无源常开 | 阀A开启后有水流（上缸进水）  |
| I0.1 | DI\_FlowSwitch\_B | 流量开关B | 无源常开 | 阀B开启后有水流（上→下转移） |
| I0.2 | DI\_FlowSwitch\_C | 流量开关C | 无源常开 | 阀C开启后有水流（下缸排水）  |

\| I0.5 | DI\_LevelA\_High | 液位计A-高位 | 无源常开 | 上缸液位达最高警戒（防漫溢） |
\| I0.6 | DI\_LevelA\_Low | 液位计A-低位 | 无源常开 | 上缸已排空（阀B四态诊断用） |
\| I0.7 | DI\_LevelB\_High | 液位计B-高位 | 无源常开 | 下缸液位达最高警戒（防漫溢） |
\| I1.0 | DI\_LevelB\_Low | 液位计B-低位 | 无源常开 | 下缸已排空（阀C四态诊断用） |
\| I1.1 | DI\_EStop | 急停信号反馈 | **常开 NO** | 急停按钮 NO 触点(v1.3 接法);ON=急停触发,OFF=正常 |
\| I1.2 | DI\_SafetyRelay\_FB | 安全继电器反馈 | 干接点(NO) | MSR-P 13/14(v1.3);急停触发时闭合,ON=动力已切断 |
\| I8.0 | DI\_ValveA\_Open | 阀A开到位反馈 | 有源→继电器转换 | 阀A全开位置确认 |
\| I8.1 | DI\_ValveA\_Close | 阀A关到位反馈 | 有源→继电器转换 | 阀A全关位置确认 |
\| I8.2 | DI\_ValveB\_Open | 阀B开到位反馈 | 有源→继电器转换 | 阀B全开位置确认 |
\| I8.3 | DI\_ValveB\_Close | 阀B关到位反馈 | 有源→继电器转换 | 阀B全关位置确认 |
\| I8.4 | DI\_ValveC\_Open | 阀C开到位反馈 | 有源→继电器转换 | 阀C全开位置确认 |
\| I8.5 | DI\_ValveC\_Close | 阀C关到位反馈 | 有源→继电器转换 | 阀C全关位置确认 |
\| I0.4 | DI\_Btn\_Mute | 消音按钮 | 无源常开点动 | 就地面板消音，仅关声音DO |
\| I2.2 | —（备用） | 预留 | — | 原规划报警确认，v9.1改由HMI执行，暂备用 |
\| I0.3 | DI\_Btn\_SystemReset | 系统复位按钮 | 无源常开点动 | 急停解除后的系统复位，清除M\_EStop\_Latch回S0 |

**容量**：本体12DI（I0.0~~I0.7, I1.0~~I8.0）+ DR32扩展8DI（I8.0\~I8.7）= 20DI，使用17点，I8.0/I2.2/I8.6/I8.7预留4点备用。

***

## 三、数字量输出DO映射

**接线原则**：全部DO点不直接驱动负载，均先驱动继电器线圈，由继电器触点接通实际负载电源。急停回路执行环节用强制导向型安全继电器（220V线圈规格）。

| 物理地址 | 符号 | 驱动负载 | 继电器转换  | 失效安全 | 用途 |
| ---- | --- | --- | --- | --- | --- |
| Q0.0 | DO\_Pump1 | 潜水泵1 | 是 | — | 上缸搅拌泵1 |
| Q0.1 | DO\_Pump2 | 潜水泵2 | 是 | — | 上缸搅拌泵2 |
| Q0.2 | DO\_ValveA | 电动球阀A | 是 | — | 上缸进水 |
| Q0.3 | DO\_ValveB | 电动球阀B | 是 | — | 上→下转移 |
| Q0.4 | DO\_ValveC | 电动球阀C | 是 | — | 下缸排水 |
| Q0.5 | DO\_NCValve\_Top | NC球阀-上缸 | 是 | 常闭型，得电打开/失电关闭 | 阀A失效的第二道保护 |
| Q0.6 | DO\_NCValve\_Bottom | NC球阀-下缸 | 是 | 常闭型，失效安全 | 阀B/液位计B最高报警时的第二道保护 |
| Q0.7 | DO\_Alarm\_Sound | 报警-声音 | 无源触点驱动 | — | 报警蜂鸣器，独立消音控制 |
| Q8.0 | DO\_Alarm\_Light | 报警-灯光 | 无源触点驱动 | — | 报警指示灯，独立消光控制（需人工确认复位） |

***

## 四、系统命令位与状态位（HMI-PLC交互）

### 4.1 系统命令位（V0区，HMI→PLC，断电保持）

HMI下发的命令位，PLC扫描周期内响应。采用"上升沿触发+握手确认"机制，防止重复执行。

| 地址 | 符号 | 说明 | 握手确认 |
| ---- | --- | --- | --- |
| V0.0 | CMD\_Start | 启动实验（从S0进入S1） | PLC置V1.0=1确认 |
| V0.1 | CMD\_Pause | 暂停实验（保留，当前状态机无暂停态，预留） | PLC置V1.1=1确认 |
| V0.2 | CMD\_Stop | 停止实验（进入S7实验结束） | PLC置V1.2=1确认 |
| V0.3 | CMD\_AckAlarm | 报警确认（HMI报警详情页下发） | PLC置V1.3=1确认，清除灯光DO（仅根本原因消失后） |
| V0.4 | CMD\_Mute | 消音命令（HMI执行对应单元消音） | PLC置V1.4=1确认，声音DO置OFF |
| V0.5 | CMD\_ForceTankA\_Empty | 强制修正上缸状态=空 | PLC置V1.5=1确认 |
| V0.6 | CMD\_RTC\_Sync【AQEX-51】 | HMI 校时命令（上升沿触发） | PLC 清 V0.6=0 确认 |
| V0.7 | CMD\_SafetyRelayAck【Story1.5/1.6修正】 | 继电器故障HMI高权限确认（需二次确认/高权限，配合I1.2清除V300.5） | PLC清V0.7=0确认 |

**注**：`V0.1`（暂停）、`V0.5`（强制上缸空）在PLC当前程序中**未实现**，首期HMI可保留占位但不下发有效命令；`V0.6` 已于 AQEX-51 启用为 RTC 校时命令位。

### 4.2 系统状态位（V1区，PLC→HMI，断电保持）

PLC当前状态反馈给HMI，用于画面显示。

| 地址 | 符号 | 说明 |
| ---- | --- | --- |
| V1.0 | STA\_StartAck | 启动命令已接收 |
| V1.1 | STA\_PauseAck | 暂停命令已接收（预留）  |
| V1.2 | STA\_StopAck | 停止命令已接收 |
| V1.3 | STA\_AlarmAckDone | 报警确认已执行 |
| V1.4 | STA\_MuteDone | 消音已执行 |
| V1.5 | STA\_ForceDone | 状态强制修正已执行 |
| V1.6 | STA\_TankA\_State | 上缸状态：0=空，1=满 |
| V1.7 | STA\_TankB\_State | 下缸状态：0=空，1=满 |

### 4.3 急停与安全状态（直接映射DI，供HMI读取）

| 信号 | 来源 | HMI显示 |
| --- | --- | --- |
| 急停触发 | **I1.1=ON**(v1.3 NO 接法) | 红色"急停触发" |
| 安全继电器反馈  | I1.2 | 正常/故障（I1.1=OFF且I1.2超时未反馈→继电器故障最高报警） |
| 急停已解除待复位 | I1.1=ON 且 M\_EStop\_Latch=1 | 黄色"急停已释放，等待系统复位" |

### 4.4 手动控制命令位（V306.0\~V307.3区，HMI→PLC，断电保持）【v1.8 重大修复】

V0区8位已满（系统命令位），手动调试用命令位扩展至V306.0\~V307.3区（地址表标记为"预留扩展区"）。仅S0态响应（避免运行中误操作），阀门/泵由OB1条件调用FC20，注射泵由OB1条件调用FC21。对应HMI画面3"手动控制"。

**【v1.8历史背景】**：v1.0~~v1.7将手动命令位分配在V2.4~~V3.7，**与VW2（状态机当前状态）物理地址完全重叠**——VB2+VB3同址。实际联机调试时发现：STEP 7写入V3.1=1后两台循环泵同时启动（VW2被改写为2=S2预循环，FC12自动启动双泵）；V3.2=1会进入S4并报"阀B开到位超时"（VW2=4=S4转移，FC15开阀B）。手动控制FC20从未被调用过（因为VW2≠0）。**v1.8已全部迁移至V306.0\~V307.3**。

| 地址 | 符号 | 说明 | 响应条件 | 握手确认 |
| --- | --- | --- | --- | --- |
| V306.0 | CMD\_Manual\_ValveA\_Open | 手动开阀A | VW2=0 | PLC置V306.0=0确认 |
| V306.1 | CMD\_Manual\_ValveA\_Close | 手动关阀A | VW2=0 | PLC置V306.1=0确认 |
| V306.2 | CMD\_Manual\_ValveB\_Open | 手动开阀B | VW2=0 AND V1.6=1 AND V1.7=0 | PLC置V306.2=0确认 |
| V306.3 | CMD\_Manual\_ValveB\_Close | 手动关阀B | VW2=0 | PLC置V306.3=0确认 |
| V306.4 | CMD\_Manual\_ValveC\_Open | 手动开阀C | VW2=0 AND V1.7=1 | PLC置V306.4=0确认 |
| V306.5 | CMD\_Manual\_ValveC\_Close | 手动关阀C | VW2=0 | PLC置V306.5=0确认 |
| V306.6 | CMD\_Manual\_Pump1\_On | 手动启动潜水泵1 | VW2=0 | PLC置V306.6=0确认 |
| V306.7 | CMD\_Manual\_Pump1\_Off | 手动停止潜水泵1 | VW2=0 | PLC置V306.7=0确认 |
| V307.0 | CMD\_Manual\_Pump2\_On | 手动启动潜水泵2 | VW2=0 | PLC置V307.0=0确认 |
| V307.1 | CMD\_Manual\_Pump2\_Off | 手动停止潜水泵2 | VW2=0 | PLC置V307.1=0确认 |
| V307.2 | CMD\_Manual\_SyringePump\_Start | 手动注射泵启动 | VW2=0 | PLC置V307.2=0确认 |
| V307.3 | CMD\_Manual\_SyringePump\_Stop  | 手动注射泵停止/回零 | VW2=0 | PLC置V307.3=0确认 |

**注1**：手动命令位采用"上升沿触发+PLC清零握手"机制（区别于V0区的置位握手），避免HMI侧残留1值导致重复触发。
**注2**：潜水泵2手动启停由V307.0/V307.1控制，FC20中映射到Q0.1。
**注3**：手动操作时安全联锁仍生效（如阀B开启需上缸=满下缸=空，阀C开启需下缸=满），由PLC在响应逻辑中校验，HMI侧仅下发命令不负责联锁。
**注4**：McgsPro CSV导入文件中"通道地址"列须同步更新——U1\_CMD\_Manual\_ValveA\_Open等位变量的通道号从2（VB2旧地址的第N位）改为3（VB3=VB306的新第N位）。变量名不变，HMI侧脚本无须改动。
**注5**：注射泵手动控制由新增FC21实现，参数为VD384（总加药量）和VW388（模式），状态反馈为VW390。

### 4.5 调试模式开关（V309.0，HMI→PLC，断电保持）【v1.8 新增】

空缸联机调试时上下缸状态位 V1.6/V1.7 均为 0（空），阀B/阀C手动操作永远被"上缸满下缸空"/"下缸满"联锁卡死。V309.0=1 时旁路阀B/阀C的液位联锁；V309.0=0 时恢复生产模式液位保护。**调试结束必须切回 0**（PLC冷启动/STOP→RUN 时 V309.0 自动清零作为安全默认）。

| 地址 | 符号 | 说明 | 默认值 | 用途 |
| --- | --- | --- | --- | --- |
| **V309.0** | **M\_DebugMode\_BypassInterlock** | **调试模式开关** | **0（生产）** | **0=生产模式（液位联锁生效）；1=调试模式（旁路阀B/阀C液位联锁，仅限空缸联机调试）** |

**约束与安全**：

1. **仅影响手动控制链路**（FC20），自动流程任何安全保护完全独立、完整保留（急停I1.1、上缸漫溢I0.5、下缸漫溢I0.7、阀超时FC30/FC31、报警系统V300\~V303）
2. OB1 仅在 S0 态调用 FC20，自动流程运行时手动控制自动失效
3. V309.0 默认 0，PLC STOP→RUN 自动恢复生产模式，即使忘记清零，PLC 重启即回到安全状态
4. **生产前必须 V309.0=0**，切换时需二次确认
5. 注：V303.5 已被 FC3 占用为"RTC时钟丢失"报警位，故选用 V309.0 空位

**注**：HMI侧对应变量名 `U1_V309_0_DebugMode` \~ `U8_V309_0_DebugMode`，8 套单元各有一份独立值（每个PLC单元有自己的V区，不是全局共享）。画面3「手动控制页」右上角/右下角放置切换按钮，顶部条幅显示"生产模式（绿）"/"⚠ 调试模式（橙）"。

***

## 五、状态机与泵状态

### 5.1 状态机当前状态（VW2，WORD/INT，断电保持）

| 值  | 状态 | 说明 |
| -- | --- | --- |
| 0  | S0 | 初始化（上下缸状态置空，输出复位） |
| 1  | S1 | 上缸进水（阀A差值法计量，液位计A高位漫溢保护） |
| 2  | S2 | 预循环（潜水泵1/2搅拌） |
| 3  | S3 | 加药（注射泵抽液→排液） |
| 4  | S3.5 | 静止等候（溶液沉降） |
| 5  | S4 | 上→下转移（阀B四态诊断+液位计B高位漫溢保护） |
| 6  | S5 | 实验运行中（换水周期计时+实验时长累加+S5上升沿触发预规划） |
| 7  | S6 | 下缸排水（阀C四态诊断+S6实测时长滚动更新） |
| 8  | S7 | 实验结束（状态机锁定，需人工HMI确认重启） |
| 99 | S\_ERROR | 故障锁定（急停或最高级报警触发，需系统复位） |

### 5.2 注射泵状态码（VW4，WORD/INT，非断电保持）

映射自Modbus寄存器41001，PLC轮询后更新。HMI读取用于判断抽/排液动作状态。

| 状态码  | 含义 | HMI处理 |
| ---- | --- | --- |
| 0 | 空闲/完成 | 可下发新指令 |
| 1 | 运行中 | 等待 |
| 2 | 抽液中 | 显示"加药中" |
| 3 | 排液中 | 显示"排液中" |
| 其他非0 | 错误码（按泵厂商定义） | 触发注射泵故障报警 |

### 5.3 当前报警码（VW6，WORD/INT，断电保持）

当前最高优先级未确认报警的编码，详见第九章。0=无报警。

### 5.4 实验轮次计数（VW8，WORD/INT，断电保持）

每完成一个换水周期（S1→S6）累加1，用于HMI显示和趋势曲线X轴。

***

## 六、HMI设定参数（VD区）

HMI可读写设定的参数，全部REAL浮点，断电保持。HMI画面4"参数设置页"对应。

### 6.1 浓度与容量参数

| 地址 | 符号 | 单位 | 默认值 | 说明 | HMI画面 |
| ----- | --- | ---- | --- | --- | --- |
| VD10  | VD\_C\_Set | % | 5.0 | ~~目标浓度设定值~~ 【⚠v2.0 删除！浓度参数整体移除，简化为用户直接输入加药量】 | ~~画面4-浓度组~~ |
| VD14  | VD\_C\_Stock | % | 100.0  | ~~母液浓度~~ 【⚠v2.0 删除！】 | ~~画面4-浓度组~~ |
| VD350 | VD\_StepResolution | µL/步 | 4.1667 | 注射泵单步分辨率（按进样器规格核实，25ml进样器标准6000步模式默认值；原VD18，AQEX-36迁移） | 画面4-浓度组 |

### 6.2 时间周期参数

| 地址 | 符号 | 单位  | 默认值 | 说明 | HMI画面 |
| ----- | --- | --- | ----- | --- | --- |
| VD354 | VD\_CycleSetpoint | min | 30.0  | 换水周期设定值（原VD20，AQEX-36迁移） | 画面4-时间周期组 |
| VD24  | VD\_ExperimentTarget | min | 480.0 | 实验时长目标设定值 | 画面4-时间周期组 |
| VD28  | VD\_PreMixTime | s | 120.0 | 潜水泵预循环标称时长（S2） | 画面4-时间周期组 |
| VD32  | VD\_PreMixTime\_MinSafe | s | 30.0  | S2压缩下限（纠偏第1层最低安全值） | 画面4-时间周期组 |
| VD36  | VD\_RestTime | s | 60.0  | 静止等候标称时长（S3.5） | 画面4-时间周期组 |
| VD40  | VD\_RestTime\_Min | s | 15.0  | 静止等候压缩下限（纠偏第0层最低值） | 画面4-时间周期组 |
| VD44  | VD\_CycleExtend\_Max | min | 5.0 | 换水周期顺延最大允许幅度（纠偏第2层上限） | 画面4-时间周期组 |
| VD144 | VD\_T\_Default | s | 300.0 | 首轮配液总时长T默认值（仅首轮预规划用，首轮后自动学习实测值；原VD104与VD102冲突，v2.3迁移至此） | 画面4-时间周期组 |
| VD108 | VD\_S6\_Default | s | 180.0 | 首轮S6排水时长默认值（仅首轮使用，首轮后自动学习实测值） | 画面4-时间周期组 |

### 6.3 超时保护参数

| 地址 | 符号 | 单位 | 默认值  | 说明 | HMI画面 |
| ----- | --- | -- | ---- | --- | --- |
| VD358 | VD\_Timeout\_ValveA | s  | 60.0 | 阀A动作超时保护时长（原VD48，AQEX-36迁移） | 画面4-超时组 |
| VD362 | VD\_Timeout\_ValveB | s  | 60.0 | 阀B动作超时保护时长（原VD50，AQEX-36迁移） | 画面4-超时组 |
| VD54  | VD\_Timeout\_ValveC | s  | 60.0 | 阀C动作超时保护时长 | 画面4-超时组 |
| VD58  | VD\_Timeout\_Pump1 | s  | 10.0 | 预留未用（原潜水泵1动作超时保护，水流开关取消） | — |
| VD62  | VD\_Timeout\_Pump2 | s  | 10.0 | 预留未用（原潜水泵2动作超时保护，水流开关取消） | — |
| VD66  | VD\_Delay\_ValveA\_Verify | s  | 5.0  | 阀A关闭后延时验证时长 | 画面4-超时组 |

### 6.4 报警模式参数

| 地址 | 符号 | 类型 | 默认值 | 说明 |
| --- | -- | -- | --- | -- |
| M\_AlarmAckMode见第九章（V200.0） | —  | —  | — | —  |

***

## 七、PLC实测值与计算值（VD区）

PLC内部记录、HMI只读的实测值和计算结果，REAL浮点，断电保持。

### 7.1 实测时长

| 地址 | 符号 | 单位 | 说明 |
| ---- | --- | -- | --- |
| VD70 | VD\_S1\_Actual | s  | S1上缸进水实测时长（阀A关闭且验证通过后记录） |
| VD74 | VD\_S4\_Actual | s  | S4上→下转移实测时长 |
| VD78 | VD\_S6\_Actual | s  | S6下缸排水实测时长（单次实测，用于更新VD\_S6\_Rolling） |

### 7.2 流量与进水量

| 地址 | 符号 | 类型 | 说明 |
| ---- | --- | --- | --- |
| VD82 | VD\_FlowMeter\_Snapshot  | DWORD | 阀A开启瞬间的流量计"计量值"快照（差值法基准） |
| VD86 | VD\_FlowMeter\_Current | DWORD | 流量计当前"计量值"（轮询读取） |
| VD90 | VD\_Current\_InletVolume | REAL(L) | 本次进水量=VD\_FlowMeter\_Current−VD\_FlowMeter\_Snapshot |
| VD94 | VD\_FlowRate\_Instant | REAL(L/min) | 瞬时流速（映射自0x0017，仅供监测） |

### 7.3 实验进度

| 地址 | 符号 | 单位  | 说明 |
| ----- | --- | --- | --- |
| VD366 | VD\_ExperimentDuration\_Accum | min | 实验时长累加值（仅下缸=满期间累加；原VD96，AQEX-36迁移） |
| VW8 | （见5.4） | — | 实验轮次计数 |

### 7.4 加药计算

| 地址 | 符号 | 单位 | 说明 | <br /> | <br /> |
| ----- | --- | -- | --- | :--- | :--- |
| VD584 | VD\_Vol\_Target | µL | 本轮目标抽取母液体积=VD\_C\_Set×进水量/VD\_C\_Stock（原VD98，AQEX-36迁移） | <br /> | <br /> |
| VD380 | VD\_S4Wait\_Time  | s  | 0.0 | **【⚠v2.0 迁出】** 原地址与MBUS\_MSG Error VB380~~383物理重叠。**新地址：VD444**（VB444~~VB447），见《VD参数区重排说明 v2.0》6.5.3 | ~~画面4-时间周期组(只读)~~ 迁后不变 |
| VD382 | VD\_S4WaitTimeout | s  | 1800.0 | **【⚠v2.0 迁出】** 原地址与MBUS\_MSG Error VB382~~383物理重叠。**新地址：VD448**（VB448~~VB451），新增断电保持。Bug A(FC15借用VD384)独立修复为用VD324，见《VD参数区重排说明 v2.0》6.5.3B | ~~画面4-时间周期组~~ 迁后不变 |
| VD102 | VD\_Dose\_Steps | 步  | 本轮加药目标步数=VD\_Vol\_Target÷VD\_StepResolution，写入注射泵40006/40007 | <br /> | <br /> |

***

## 八、配液节奏纠偏变量

S5上升沿触发预规划、S1完成后二次校正使用的中间变量，REAL浮点，断电保持。

### 8.1 标称时长与默认值（HMI设定，v2.3）

实验启动时（FC10收到启动命令）由PLC播种到滚动值：VD112←VD144、VD116←VD108，首轮预规划/排水使用；首轮完成后由实测值自动学习覆盖。

| 地址 | 符号 | 单位 | 说明 |
| ----- | --- | -- | --- |
| VD144 | VD\_T\_Default  | s  | T的初始默认值（首轮无历史数据时预规划使用）。HMI设定，默认300.0，范围60~~900。\*\*原地址VD104与VD102(VD\_Dose\_Steps)重叠VB104~~105（FC13/FC21每次加药写步数即破坏VD104），v2.3迁移至VD144\*\* |
| VD108 | VD\_S6\_Default | s  | S6排水时长初始默认值（首轮Available计算使用）。HMI设定，默认180.0，范围30\~600 |

### 8.2 滚动实测值

| 地址 | 符号 | 单位 | 说明 |
| ----- | --- | -- | --- |
| VD112 | VD\_T\_Rolling  | s  | 滚动实测的S1-S3+静止等候总时长T（取标称值，不用纠偏压缩值） |
| VD116 | VD\_S6\_Rolling | s  | 滚动实测的S6排水时长 |

### 8.3 本轮预规划/校正后的实际执行目标

| 地址 | 符号 | 单位  | 说明 |
| ----- | --- | --- | --- |
| VD120 | VD\_S2\_Target | s | 本轮S2实际执行目标时长（预规划/二次校正后） |
| VD124 | VD\_RestTime\_Target | s | 本轮S3.5实际执行目标时长（预规划/二次校正后）  |
| VD128 | VD\_CycleExtend\_Target | min | 本轮预规划算出的允许"下缸空等"时长（0=无需空等） |

### 8.4 注射泵速度参数（已停用：使用泵自身默认速度，PLC不再干预）

**注射泵速度参数（已停用，使用泵自身默认速度）**：

- PLC不再硬编码默认值，也不再写泵的40009/40010/40011速度寄存器

- FC4原任务3（周期读速度寄存器到VW208/210/212）已停用

- VD132/VD136/VD140保留地址占位，未来恢复时由HMI参数设置页的"恢复默认"功能写入

| 地址 | 符号 | 单位 | 默认值 | 范围 | 说明 |
| ----- | --- | -- | --- | --- | --- |
| VD132 | VD\_PumpSpeed\_Start  | Hz | — | 100\~6000 | 启动速度（已停用，PLC不干预；如需恢复请手动写泵40009） |
| VD136 | VD\_PumpSpeed\_Max | Hz | — | 100\~6000 | 最高速度（已停用；如需恢复请手动写泵40010） |
| VD140 | VD\_PumpSpeed\_Cutoff | Hz | — | 50\~5400  | 截止速度（已停用；如需恢复请手动写泵40011） |

***

## 九、报警标志与报警码定义

### 9.1 报警字（VB300\~VB303，4字节32位，断电保持，按位编码）

32位报警字，每位对应一个报警类型。HMI 经 Modbus 读取 **VW300**（含 VB300+VB301）和 **VW302**（含 VB302+VB303）两个 16 位字后，拆分为 **VB300\~VB303** 四个字节，再用位运算解析当前所有活动报警。

**【地址规划说明】**：报警字原计划使用VD120~~VD123，但与第八章纠偏变量VD120~~VD140地址冲突，现调整至VB300~~VB303独立区域，避免冲突。PLC 程序以字节为单位操作报警位（如~~ ~~`FILL 0, VW300, 4`~~ ~~清零 VB300~~VB303），HMI 侧按 VB300\~VB303 抽象更符合程序语义。

**报警字1（VB300，地址V300.0\~V300.7）**

| 位 | 符号 | 报警类型 | 优先级 | 强制人工确认 |
| --- | --- | --- | --- | --- |
| V300.0 | M\_Alarm\_Overflow\_AHigh | 上缸漫溢（液位计A-高位） | 漫溢风险级 | 是 |
| V300.1 | M\_Alarm\_Overflow\_BHigh | 下缸漫溢（液位计B-高位） | 漫溢风险级 | 是 |
| V300.2 | M\_Alarm\_NCValve\_Top | NC球阀-上缸动作（阀A失效保护触发） | 漫溢风险级 | 是 |
| V300.3 | M\_Alarm\_NCValve\_Bottom | NC球阀-下缸动作（阀B/液位计B报警触发） | 漫溢风险级 | 是 |
| V300.4 | M\_EStop\_Latch | 急停触发锁存 | 漫溢风险级 | 是 |
| V300.5 | M\_Alarm\_SafetyRelay | 安全继电器/接触器故障（最高优先级） | **最高级** | 是 |
| V300.6 | M\_Alarm\_ScheduleLag | 配液节奏严重滞后（三层纠偏用尽） | 节奏滞后级 | 是 |
| V300.7 | M\_Alarm\_ScheduleLag\_Warn | 配液节奏滞后提示（第2层顺延触发） | 一般故障级 | 按模式 |

**报警字2（VB301，一般故障级-阀门A类）**

| 位 | 符号 | 报警类型 |
| --- | --- | --- |
| V301.0 | M\_Alarm\_ValveA\_CloseFlow | 阀A关后延时验证仍有流（流量开关A=ON） |
| V301.1 | — | 已删除（原流量计差值法内漏判定，2026-09-14废弃） |
| V301.2 | M\_Alarm\_ValveA\_CloseTimeout | 阀A关到位反馈（I8.1）超时 |
| V301.3 | M\_Alarm\_ValveA\_CloseLeak | 阀A关到位但仍有流（内漏） |
| V301.4 | M\_Alarm\_ValveA\_OpenTimeout  | 阀A开到位反馈（I8.0）超时 |
| V301.5 | M\_Alarm\_ValveA\_OpenNoFlow | 阀A开到位但无流（上游缺水/堵塞） |
| V301.6 | M\_Alarm\_ValveA\_S1Start | S5触发新一轮S1时上缸状态≠空 |

**报警字3（VB302，一般故障级-阀门B/C/泵类）**

| 位 | 符号 | 报警类型 |
| --- | --- | --- |
| V302.0 | M\_Alarm\_ValveB\_Diag | 阀B四态诊断异常（流量开关B=OFF 且 液位计A-低位=OFF） |
| V302.1 | M\_Alarm\_ValveB\_OpenTimeout  | 阀B开到位反馈（I8.2）超时 |
| V302.2 | M\_Alarm\_ValveB\_OpenNoFlow | 阀B开到位但无流 |
| V302.3 | M\_Alarm\_ValveB\_CloseTimeout | 阀B关到位反馈（I8.3）超时 |
| V302.4 | M\_Alarm\_ValveB\_CloseLeak | 阀B关到位但仍有流（内漏） |
| V302.5 | M\_Alarm\_ValveC\_Diag | 阀C四态诊断异常 |
| V302.6 | M\_Alarm\_ValveC\_OpenTimeout  | 阀C开到位反馈（I8.4）超时 |
| V302.7 | M\_Alarm\_ValveC\_OpenNoFlow | 阀C开到位但无流 |

**报警字4（VB303，一般故障级-其他（阀C关/注射泵/RTC/流量））**

| 位 | 符号 | 报警类型 |
| --- | --- | --- |
| V303.0 | M\_Alarm\_ValveC\_CloseTimeout | 阀C关到位反馈（I8.5）超时 |
| V303.1 | M\_Alarm\_ValveC\_CloseLeak | 阀C关到位但仍有流（内漏） |

\| V303.4 | M\_Alarm\_SyringePump | 注射泵通讯/动作异常（状态码报错或无响应） |
\| V303.5 | M\_Alarm\_RTC\_Lost【AQEX-51更新】 | RTC时钟丢失（V303.7 持续 5 分钟未同步触发） |
\| V303.6 | ~~M\_Alarm\_FlowSwitch\_Instant~~ | **已删除（2026-09-08）**：三个流量开关各自有独立报警位（V301.0\~V303.1），不再需要汇总抖动检测 |
\| V303.7 | M\_Need\_RTC\_Sync【AQEX-51】 | PLC 请求 HMI 同步 RTC（FC0 检测到 RTC 异常时置位） |

### 9.4 Modbus RTU从站在线状态位（VB304，BOOL，非断电保持）

**背景**：画面7\_通讯维护需要分别显示注射泵（RTU站号1）和流量计（RTU站号2）的通讯在线状态。由于RTU轮询由PLC侧FC4完成，HMI无法直接检测从站，故在PLC侧维护两个在线标志位，HMI只读。

**在线判定逻辑**：FC4对应任务本轮轮询成功（Done=1）时置位；连续失败进入降级模式或超时≥3次时复位。

| 位 | 符号 | 说明 | HMI变量名（单单元示例） | 数据方向 |
| --- | --- | --- | --- | --- |
| V304.0 | M\_InitDone | 系统初始化完成标志（Story1.7已有，不要覆盖） | — | PLC→HMI |
| **V304.1** | **M\_CommStatus\_Syringe** | **注射泵RTU从站在线（1=在线，0=离线）**  | **U1\_CommStatus\_Syringe** | **PLC→HMI** |
| **V304.2** | **M\_CommStatus\_Flow** | **流量计RTU从站在线（1=在线，0=离线）**  | **U1\_CommStatus\_Flow** | **PLC→HMI** |
| V304.3\~V304.7 | — | 预留扩展 | — | — |

> **注意**：V304.0 已被 `M_InitDone` 占用，新增在线标志位从 V304.1 开始，避免地址冲突。

### 9.5 系统总状态字（VB305，BYTE，非断电保持）

**背景**：McgsPro画面顶部状态指示灯需要单一数值驱动三态动画（良好/故障/急停）。若HMI侧用多个BOOL变量组合判断会导致表达式复杂且容易遗漏条件，故在PLC侧统一计算后输出一个状态字。

**计算位置**：OB1 NETWORK 10，每周期扫描更新。

**状态值定义**：

| VB305值 | 状态 | 含义 | HMI动画建议  |
| --- | -- | --- | --- |
| 0 | 良好 | 系统正常运行，无急停触发、无活动报警 | 绿色，常亮 |
| 1 | 故障 | 有活动报警（VW6≠0），但未触发急停级 | 黄色，常亮或闪烁 |
| 2 | 急停 | 急停触发（I1.1=OFF / V300.4=1 / V300.5=1） | 红色，常亮 |

**判断逻辑（优先级从高到低）**：

1. **急停级（VB305=2）**：以下任一条件满足即置2

   - I1.1 = OFF（急停按钮常闭触点断开，物理急停触发）

   - V300.4 = 1（急停锁存）

   - V300.5 = 1（安全继电器故障）
2. **故障级（VB305=1）**：非急停级时，VW6 ≠ 0（有未确认活动报警）
3. **良好（VB305=0）**：既非急停也无报警

**McgsPro配置要点**：

- 数据类型：**8位无符号二进制**

- 寄存器类型：**V数据寄存器**

- 通道地址：**305**

- 动画绑定：状态指示灯组件→值动画→填充颜色，按VB305值配置三档颜色

> **注意**：VB305仅用于HMI视觉指示，不作为PLC逻辑判断依据。PLC内部仍使用VW6（报警码）、V300.4（急停锁存）等原变量做状态判断。

### 9.2 报警码定义（VW6，当前最高优先级未确认报警）

| 编码 | 报警 | 优先级 |
| --- | --- | --- |
| 0 | 无报警 | — |
| 99 | 安全继电器故障（M\_Alarm\_SafetyRelay） | 最高级 |
| 10\~14 | 漫溢类（M\_Alarm\_Overflow\_xxx / NC阀 / 急停） | 漫溢级 |
| 20\~21 | 节奏滞后类（M\_Alarm\_ScheduleLag / \_Warn） | 节奏级/一般级 |
| 30,32\~36 | 阀A类故障（V301.0/V301.2\~V301.6；报警码31/V301.1已删除） | 一般级 |
| 40\~44 | 阀B类故障（V302.0\~V302.4，含四态诊断/开超时/开无流/关超时/关漏） | 一般级 |
| 45\~47 | 阀C开类故障（V302.5\~V302.7，含四态诊断/开超时/开无流）【已同步FC3】 | 一般级 |
| 60\~61 | 阀C关类故障（V303.0\~V303.1，含关超时/关漏）【已同步FC3】 | 一般级 |

\| 64 | 注射泵故障（V303.4）【已同步FC3】 | 一般级 |
\| 65 | RTC时钟丢失（V303.5）【已同步FC3】 | 一般级 |
\| 66 | 流量开关瞬时异常（V303.6）【已同步FC3】 | 一般级 |

**编码规则**：十位数=类别，个位数=细分。VW6始终保存当前最高优先级未确认报警码（优先级：99>10系列>20系列>30~~61、64~~66系列）。报警码以FC3 STL的JMP标签nCode10~~nCode66逐位赋值为权威实现，本表已与FC3同步（原概要编码50~~53/60~~61/70/80/90已修正为FC3实际编码45~~47/60~~61/64~~66；新方案取消62/63潜水泵类报警码）。

### 9.3 报警确认模式（M\_AlarmAckMode，V200.0【Story1.6修正】）

| 地址 | 符号 | 说明 |
| --- | --- | --- |
| M\_AlarmAckMode（V200.0）【Story1.6修正】 | 报警确认模式 | 0=自动恢复，1=人工确认（漫溢/节奏滞后/安全继电器故障不受此项影响，始终强制人工确认） |

***

## 十、断电保持时间戳

| 地址 | 符号 | 类型 | 说明 |
| ---- | --- | --- | --- |
| DT10 | DT\_TankB\_FullTime | DT(日期时间) | 下缸变满时刻时间戳（阀B正常关闭完成后写入）。换水周期计算：下缸预计排空时刻=DT\_TankB\_FullTime+VD\_ |

**【AQEX-51 新增：RTC 校时缓冲区（VB900\~VB907）】**

| 地址 | 名称 | 类型 | 说明 |
| ----- | --- | --- | --- |
| VB900 | RTC\_Year | BYTE(BCD) | 年（00\~99） |
| VB901 | RTC\_Month | BYTE(BCD) | 月（01\~12） |
| VB902 | RTC\_Day | BYTE(BCD) | 日（01\~31） |
| VB903 | RTC\_Hour | BYTE(BCD) | 时（00\~23） |
| VB904 | RTC\_Minute | BYTE(BCD) | 分（00\~59） |
| VB905 | RTC\_Second | BYTE(BCD) | 秒（00\~59） |
| VB906 | RTC\_Weekday  | BYTE | 星期（0 表示不使用） |
| VB907 | RTC\_Reserved | BYTE | 保留 |

> HMI 通过 McgsPro 将当前时间（BCD 格式）写入 VB900\~VB905，置位 V0.6 触发 FC22 调用 TODW 写入 PLC RTC。CycleSetpoint+VD\_S6\_Rolling。断电恢复：RTC−DT\_TankB\_FullTime重算已运行时长 |

**RTC丢失检测（AQEX-51 更新）**：FC0 开机时检查 RTC 自身合法性（月>12、分>59 等）及 RTC 与 DT\_TankB\_FullTime 的先后关系，异常时置 **V303.7=1**（M\_Need\_RTC\_Sync）请求 HMI 校时，不再直接进 S\_ERROR；V303.7 持续 5 分钟未同步时，FC22 置 **V303.5=1**（M\_Alarm\_RTC\_Lost）并将 VW2 置 99。

**超级电容保持能力**：CPU ST20超级电容典型保持7天/最小6天，DT\_TankB\_FullTime等断电保持变量在此期限内不丢失。

***

## 十一、Modbus从站寄存器映射

每套PLC通过CPU本体RS485口（Port0）连接2个Modbus RTU从站：注射泵、流量计。

### 11.1 通讯参数（已确认）

**依据**：南京润泽《泵阀一体MODBUS协议V1.7》、BPM32FC积算仪《MODBUS RTU协议说明》（AQEX-42由K24微小流量计变更）

| 参数 | 注射泵 | 流量计 | 备注 |
| --- | --- | --- | --- |
| 协议 | Modbus RTU | Modbus RTU | 注射泵需确认出厂协议是否为RTU（可通过专用命令查询/切换，见协议V1.7第2章） |
| 波特率 | 9600（默认，寄存器40019=0x0000） | 9600（BPM32FC默认） | 注射泵支持9600/19200/38400/57600/115200（40019值0\~4）；BPM32FC积算仪支持2400/4800/9600/19200；首期统一9600 |
| 站号 | 0x01（默认，范围0x01\~0xFE，0=广播） | 0x02（BPM32FC范围00\~99） | 两个从站站号不能冲突；注射泵站号存40001(0x0000)，BPM32FC仪表地址见其菜单设置 |
| 数据位/停止位/校验 | 8/N/1（RTU标准） | 8/N/1（RTU标准） | 两从站一致，PLC Port0配8/N/1 |
| 通讯超时 | 状态码轮询超时（建议2000ms，按动作周期估算）  | 读累积流量超时（建议1000ms） | 注射泵按"状态码轮询超时"判定，积算仪单次读取应<500ms |
| Modbus类型 | RS485+RTU（40020=3，可切换） | RS485+RTU（固定） | 注射泵40020：0=RS232+ASCII/1=RS232+RTU/2=RS485+ASCII/3=RS485+RTU，需确认出厂为3 |
| 功能码 | FC03读/FC06单写/FC16多写 | FC03读/FC04读（BPM32FC测量值同时支持03/04） | 注射泵RW区0x0000~~0x0021，R区0x03E8~~0x0400；BPM32FC测量值区0x0000\~0x0014 |

### 11.2 注射泵寄存器映射

**写寄存器（PLC→注射泵，功能码FC06单写）**

| PLC侧地址 | Modbus寄存器 | HEX | 符号 | 单位 | 说明 |
| --- | --- | --- | --- | ---- | --- |
| VW200  | 40002 | 0x0001 | MB\_Pump\_ForceStop | — | 强停：0=空闲，1=强停 |
| VW202  | 40003 | 0x0002 | MB\_Pump\_Reset | — | 复位：0=空闲，1=复位（泵上电后必须先执行一次） |
| VW204  | 40006 | 0x0005 | MB\_Pump\_Aspirate | 步 | 抽液目标步数（0\~最大行程） |
| VW206  | 40007 | 0x0006 | MB\_Pump\_Dispense | 步 | 排液目标步数 |
| VW208  | 40009 | 0x0008 | MB\_Pump\_SpeedStart | Hz | 启动速度 |
| VW210  | 40010 | 0x0009 | MB\_Pump\_SpeedMax | Hz | 最高速度 |
| VW212  | 40011 | 0x000A | MB\_Pump\_SpeedCutoff  | Hz | 截止速度 |
| VW214  | 40015 | 0x000E | MB\_Pump\_CurrentRun | 1-31 | 运行电流 |
| VW216  | 40016 | 0x000F | MB\_Pump\_CurrentReset | 1-31 | 复位电流 |
| VW218  | 40017 | 0x0010 | MB\_Pump\_ValveIn | — | 阀输入口（泵阀一体内部阀，抽取母液流路切换） |
| VW220  | 40018 | 0x0011 | MB\_Pump\_ValveOut | — | 阀输出口（泵阀一体内部阀，排放流路切换） |

**读寄存器（注射泵→PLC，功能码FC03/FC04读）**

| PLC侧地址 | Modbus寄存器 | HEX | 符号 | 单位 | 说明 |
| --- | --- | --- | --- | -- | --- |
| VW4（见5.2） | 41001 | 0x03E8 | MB\_Pump\_Status | —  | 状态码：0=空闲/完成，1=运行中，2=抽液，3=排液，其他=错误码 |
| VW222 | 41007 | 0x03EE | MB\_Pump\_Position | 半步 | 注射泵位置反馈（核实实际抽排步数） |

### 11.3 流量计寄存器映射

> **AQEX-42 选型变更说明（2026-07-20）**：流量计由 K24 微小流量计（Modbus 寄存器 0x0009）改为 **BPM32FC 积算仪 + 涡轮流量计**组合。BPM32FC 累积流量在寄存器地址 0x08，同时支持 FC03/FC04 读，数据格式为 32 位 IEEE-754 浮点。PLC 侧仅 FC4 的 Modbus 地址从 `40010` 改为 `40009`，其余逻辑（差值法计量、降级、报警）完全不变。温度/压力/密度修正参数不启用。

**读寄存器（积算仪→PLC，功能码FC03读，BPM32FC同时支持FC04）**

| PLC侧地址 | Modbus地址 | 寄存器地址(HEX) | 符号 | 类型 | 说明 |
| --- | --- | --- | --- | --- | --- |
| VD86（见7.2） | 40009 | 0x0008 | MB\_Flow\_Total | REAL(32位IEEE-754浮点) | 累积流量（总量），持续累加，用差值法（VD90=VD86-VD82） |
| —（未启用） | 40001 | 0x0000 | — | REAL | 温度（AQEX-42不启用修正） |
| —（未启用） | 40003 | 0x0002 | — | REAL | 压力（AQEX-42不启用修正） |
| —（未启用） | 40005 | 0x0004 | — | REAL | 补偿前流量（瞬时，AQEX-42不启用） |
| —（未启用） | 40007 | 0x0006 | — | REAL | 补偿后流量（瞬时，AQEX-42不启用） |
| —（未启用） | 40011 | 0x000A | — | REAL | 流体密度（AQEX-42不启用） |
| —（备选高精度） | 40021 | 0x0014 | — | REAL(64位) | 累积流量高精度64位浮点（首期不启用，32位足够） |

**可读写寄存器**

| PLC侧地址 | Modbus寄存器 | HEX | 符号 | 说明 | 待确认 |
| --- | --- | --- | --- | --- | --- |
| VD232  | — | — | PumpWrite\_Addr | 注射泵FC06写目标Modbus地址（DWORD），由FC13写入40006/40007 | 否 |

### 11.4 差值法进水计量逻辑（S1阶段）

```
阀A开启瞬间：
  VD_FlowMeter_Snapshot = MB_Flow_Total（当前累计流量快照）

进水过程中（周期轮询）：
  VD_Current_InletVolume = MB_Flow_Total − VD_FlowMeter_Snapshot

阀A关闭且验证通过：
  本轮进水量最终值 = VD_Current_InletVolume（锁定）
  用于计算 VD_Vol_Target = VD_C_Set × 本轮进水量 / VD_C_Stock
  用于计算 VD_Dose_Steps = VD_Vol_Target ÷ VD_StepResolution
```

**【⚠v2.0 新增迁出】** VD378 累计加药量 (FC13/FC0/FC18 内部) 原地址与 MBUS\_CTRL Error VB378 + 任务0 Error VB379 物理重叠。**新地址：VD440**（VB440\~VB443），见《VD参数区重排说明 v2.0》6.5.3C。

### 11.5 Modbus通讯状态字（FC4 LAD指令引脚输出，2026-07-27新增）

**背景**：MBUS\_CTRL和MBUS\_MSG指令盒的Done/Error引脚必须连接到具体地址，不能留空（否则编译错误32）。本节登记FC4中LAD指令盒所占用的Done位和Error错误码地址。

**地址分配原则**：

- Done位用M区（BOOL），Error错误码用VB区（BYTE，错误码0\~255）

- **【⚠v1.9更正】** MBUS\_MSG Error 实际占用 **VB380\~VB383**（FC4的4个CALL MBUS\_MSG Error引脚硬编码），不是原文档11.5节写的VB384。v1.9前这四个Error字节与VD380(VB380~~383)/VD382(VB382~~385)/VW380(VB380\~381)物理重叠，是Bug B的根因之一（见TD026/AQEX-49）。

- v1.9 修复方案：让 VB378~~VB383 完全归 MBUS\_MSG Error 使用，把冲突的 VD380/382/384/VW380 迁移到 VD440~~VD452（详见《VD参数区重排说明 v2.0》第六章）。

- 避开VB500\~599报警日志区和VB600+ Modbus库区

| 地址 | 符号 | 类型 | 用途 | 来源 |
| --- | --- | --- | --- | --- |
| M10.0 | M\_FC4\_Done\_Pump | BOOL | MBUS\_MSG任务0(注射泵状态码)Done位 | LAD引脚输出 |
| M10.1 | M\_FC4\_Done\_Flow | BOOL | MBUS\_MSG任务1(流量计累计值)Done位 | LAD引脚输出 |
| M10.2 | M\_FC4\_Done\_PumpStep | BOOL | MBUS\_MSG任务2(注射泵步数)Done位，预留 | LAD引脚输出 |
| M10.3 | M\_FC4\_Done\_PumpSpeed | BOOL | MBUS\_MSG任务3(注射泵速度)Done位，预留 | LAD引脚输出 |
| M10.4 | M\_FC4\_Degraded\_Pump | BOOL | 注射泵降级模式标志（连续5次失败） | FC4内部逻辑 |
| M10.5 | M\_FC4\_Degraded\_Flow | BOOL | 流量计降级模式标志 | FC4内部逻辑 |
| M11.0 | M\_MBUS\_CTRL\_Done | BOOL | MBUS\_CTRL Done位（每周期脉冲） | LAD引脚输出 |
| VB378 | VB\_MBUS\_CTRL\_Error | BYTE | MBUS\_CTRL Error错误码 | LAD引脚输出 |
| VB379 | VB\_MBUS\_MSG\_Task0\_Error | BYTE | MBUS\_MSG任务0 Error（注射泵状态码读，FC4 CALL第1个Error参数） | LAD引脚输出 |
| **VB380** | **VB\_MBUS\_MSG\_Task2\_Error** | **BYTE** | **【⚠v1.9前文档误写VB384】** MBUS\_MSG任务2 Error（流量计读数，FC4 CALL第2个Error参数） | LAD引脚输出 |
| **VB381** | **VB\_MBUS\_MSG\_Task1\_Error** | **BYTE** | **MBUS\_MSG任务1 Error（注射泵位置，FC4 CALL第3个Error参数）** | **LAD引脚输出** |
| **VB382** | **VB\_MBUS\_MSG\_Task3\_Error** | **BYTE** | **MBUS\_MSG任务3 Error（流量计瞬时流量，FC4 CALL第4个Error参数）** | **LAD引脚输出** |
| **VB383** | **VB\_MBUS\_MSG\_Task4\_Error** | **BYTE** | **MBUS\_MSG任务4 Error（FC06写命令，FC4 CALL第5个Error参数）** | **LAD引脚输出** |

> **【代码引用证据】** FC4\_ModbusPolling.stl 的 5 个 CALL MBUS\_MSG：
>
> - L28: `CALL MBUS_MSG, ..., M10.0, VB379` （任务0 Error→VB379）
>
> - L38: `CALL MBUS_MSG, ..., M14.0, VB380` （任务2 Error→VB380）
>
> - L48: `CALL MBUS_MSG, ..., M10.1, VB381` （任务1 Error→VB381）
>
> - L58: `CALL MBUS_MSG, ..., M14.1, VB382` （任务3 Error→VB382）
>
> - L227: `CALL MBUS_MSG, ..., M12.0, VB383` （任务4 Error→VB383）

**错误码含义**（参考西门子Modbus RTU Master库手册）：

- 0 = 无错误

- 1 = 从站无响应（超时）

- 2 = 接收校验错误（CRC/奇偶）

- 3 = 从站返回异常码（Modbus Exception）

- 4 = 请求队列满

- 5\~6 = 库内部错误

- 101+ = 参数错误（Addr/Count/DataPtr配置非法）

**HMI读取建议**：HMI可通过VB378~~VB383读取通讯错误码，在"通讯维护页"显示Modbus总线状态。VB380~~VB383【⚠v1.9前与VD382/384重叠】与用户参数同区，**HMI读取时需在v1.9迁移后避免误读迁移前的冲突值**。当错误码≠0持续超过10秒，建议HMI提示"通讯异常"。

### 11.6 FC4 Modbus 轮询内部计数器（2026-07-28 修正）

**背景**：原 FC4 使用 VW250/VW252/VW254/VW256 作为轮询计数器/重试计数/连续失败计数，但运行中发现：

- VD250（目标进水量，HMI 设定区；地址表规划已迁移至 VD316，需确认 HMI 侧已同步）占用 VB250\~VB253，覆盖 VW250/VW252；

- FC12 的 T38 PT 转换值使用 VW252；

- FC14 的 T39 PT 转换值使用 VW254。

以上冲突会导致轮询计数器被意外覆盖、轮询状态机卡死。AQEX-48 修复后迁移至 VW290\~VW297 空闲区。

| 地址 | 符号 | 类型 | 用途 | 备注 |
| ----- | --- | --- | --- | --- |
| VW290 | VW\_FC4\_PollIndex | INT/WORD | 轮询从站计数器（0=注射泵状态码，1=流量计累计值，2=注射泵步数，3=注射泵速度） | 当前 STEP7 中仅实现任务 1（流量计），泵任务待硬件到货后补充 |
| VW292 | VW\_FC4\_RetryCount | INT/WORD | 当前任务重试计数（0\~3，超 3 次标记本任务失败并报警） | 每次任务成功清零 |
| VW294 | VW\_FC4\_PumpFailCount | INT/WORD | 注射泵连续失败计数（≥5 次进入降级模式，使用上一有效值） | 通讯恢复后清零；HMI变量 U1\_VW294\_PumpContFail 只读，画面7显示 |
| VW296 | VW\_FC4\_FlowFailCount | INT/WORD | 流量计连续失败计数（≥5 次进入降级模式） | 通讯恢复后清零；HMI变量 U1\_VW296\_FlowContFail 只读，画面7显示 |

**注意**：VW290\~VW297 由 FC0 在首次扫描时初始化，不配置断电保持。

***

## 十二、8套PLC网络编址规范

### 12.1 IP地址规划

| 设备 | IP地址 | 子网掩码 | 说明 |
| --- | --- | --- | --- |
| PLC#1（1号缸单元） | 192.168.2.101 | 255.255.255.0 | 固定IP，与单元编号一一对应 |
| PLC#2（2号缸单元） | 192.168.2.102 | 255.255.255.0 | 同上 |
| PLC#3（3号缸单元） | 192.168.2.103 | 255.255.255.0 | 同上 |
| PLC#4（4号缸单元） | 192.168.2.104 | 255.255.255.0 | 同上 |
| PLC#5（5号缸单元） | 192.168.2.105 | 255.255.255.0 | 同上 |
| PLC#6（6号缸单元） | 192.168.2.106 | 255.255.255.0 | 同上 |
| PLC#7（7号缸单元） | 192.168.2.107 | 255.255.255.0 | 同上 |
| PLC#8（8号缸单元） | 192.168.2.108 | 255.255.255.0 | 同上 |
| 本地集中HMI | 192.168.2.10 | 255.255.255.0 | 固定IP |
| 工业以太网交换机 | 192.168.2.1（网管型）/无（非网管型） | — | 非网管型即可，9口及以上 |

**说明**：IP地址为示例网段，子网掩码按C类255.255.255.0，需现场网络环境确认后定型。

### 12.2 HMI连接配置

HMI工程中配置8个PLC连接（站点），每个连接对应1台PLC：

| HMI连接名  | 目标IP | 单元编号 | 单元使能（HMI内部变量） |
| --- | --- | ---- | --- |
| PLC\_01 | 192.168.2.101 | 1 | Unit1\_Enabled（断电保持） |
| PLC\_02 | 192.168.2.102 | 2 | Unit2\_Enabled |
| PLC\_03 | 192.168.2.103 | 3 | Unit3\_Enabled |
| PLC\_04 | 192.168.2.104 | 4 | Unit4\_Enabled |
| PLC\_05 | 192.168.2.105 | 5 | Unit5\_Enabled |
| PLC\_06 | 192.168.2.106 | 6 | Unit6\_Enabled |
| PLC\_07 | 192.168.2.107 | 7 | Unit7\_Enabled |
| PLC\_08 | 192.168.2.108 | 8 | Unit8\_Enabled |

### 12.3 单元使能（HMI内部变量，不写入PLC）

单元使能存储在HMI断电保持区，不写入PLC（使能是HMI侧管理概念）。详见HMI画面架构文档第九章。

- 首期交付：仅Unit1\_Enabled=TRUE，2\~8号=FALSE

- 三态显示：已使能+在线→彩色；已使能+离线→黄色"通讯中断"；未使能→灰色"未接入"

### 12.4 PLC↔HMI通讯协议（待HMI选型确认）

| 协议选项 | 说明 | 适用HMI |
| --- | --- | --- |
| S7协议（推荐） | S7-200 SMART CPU本体以太网口原生支持，HMI需有S7-200 SMART驱动 | 昆仑通态MCGS、威纶通等主流品牌 |
| Modbus TCP | S7-200 SMART可作为Modbus TCP服务器，HMI作客户端 | 通用性好，但需PLC侧额外编程配置 |

**建议**：优先选用支持S7协议的HMI，减少PLC侧编程工作量。待HMI选型（AQEX-24）确认后定型。

***

## 十三、HMI-PLC变量交互总表

按HMI画面分组，列出每个画面需要读写的PLC变量。

### 13.1 画面1-总览页（8单元卡片）

每单元卡片读取：

- VW2（状态机状态）、V1.6/V1.7（上下缸状态）、I1.1（急停）、VW6（报警码）、VW8（轮次）、VD366（实验时长，原VD96，AQEX-36迁移）

### 13.2 画面2-单元详情页

读取：VW2、V1.6/V1.7、VW4（泵状态）、VD90（当前进水量）、VD94（瞬时流速）、VD366（实验时长，原VD96，AQEX-36迁移）、VB300\~VB303（报警字，经 VW300/VW302 拆分）、VW8

### 13.3 画面3-手动控制页

写入：V0.0\~V0.7（命令位），手动操作阀门/泵/注射泵（需二次确认）

### 13.4 画面4-参数设置页

读写：VD10~~VD66（全部设定参数）、VD132~~VD140（泵速度，待确认）、M\_AlarmAckMode（V200.0）

### 13.5 画面5-报警日志页

读取：VW6（当前报警码）、VB300\~VB303（报警字，经 VW300/VW302 拆分）、写入V0.3（报警确认）、V0.4（消音）

### 13.6 画面6-趋势曲线页

读取：VD70/VD74/VD78（实测时长）、VD90（进水量）、VD94（流速）、VD366（实验时长，原VD96，AQEX-36迁移）、VD112/VD116（滚动T/S6）

### 13.7 画面7-通讯维护页

读取：各PLC连接状态（HMI驱动层）、VW4（泵状态）、VW222（泵位置）、VD86（流量计当前值）

### 13.8 画面8-系统设置页

读写：Unit1\~8\_Enabled（HMI内部）、M\_AlarmAckMode（V200.0）、系统时间、权限设置

***

## 十四、待确认事项

本变量地址表在编址定义过程中，以下事项需在后续开发中确认或由厂商提供：

### 14.1 通讯参数类（需厂商确认）

1. **RS485通讯参数**：注射泵/流量计的波特率、站号、数据位/停止位/校验、通讯超时
2. **Modbus功能码**：注射泵写寄存器是否用FC06、读寄存器是否用FC03/FC04，流量计读寄存器功能码
3. **注射泵单步分辨率（VD\_StepResolution）**：需按实际选配进样器容量规格核实（参考SY11文档2.4节）
4. **流量计实际配置单位（0x0012）**：需现场读取确认，默认按0x03=升L假设
5. **流量计寄存器溢出行为（0x0009）**：长期运行溢出行为（回绕/停止/报错）待厂商确认
6. **注射泵速度参数映射**：VD\_PumpSpeed\_Start/Max/Cutoff（VD132\~140）与40009/40010/40011的对应关系已确认（见8.4章）

### 14.2 网络配置类（需现场/HMI选型确认）

1. **PLC↔HMI通讯协议**：S7协议或Modbus TCP，待HMI选型（AQEX-24）确认
2. **子网掩码**：默认255.255.255.0，需现场网络环境确认
3. **HMI品牌型号**：需确认S7-200 SMART驱动兼容性、8站点同时通讯、变量点数、报警/历史记录容量

### 14.3 变量细化类（可在PLC编程阶段细化）

1. **V0.7命令位**：已用于CMD\_SafetyRelayAck（继电器故障HMI高权限确认，Story1.5/1.6）。若后续需扩展下缸强制修正等命令，需新增命令位（当前V0.0\~V0.7已全部占用，可考虑扩展至V0区字节边界或复用握手机制）
2. **V303.7**：AQEX-51 已启用为 M\_Need\_RTC\_Sync（PLC 请求 HMI 同步 RTC）

### 14.4 后续版本规划

本表为v1.0初版，以下情况需更新版本：

- 待确认事项闭环后，更新对应地址定义

- HMI选型确认后，补充通讯协议相关配置

- PLC编程过程中如需调整地址分配，同步更新本表并升版本号

***

## 附录A：断电保持区配置建议

在STEP 7-Micro/WIN SMART的"系统块→断电保持"中，建议配置以下V区范围为断电保持：

| 起始 | 结束 | 字节数 | 内容 |
| --- | --- | ----- | --- |
| VB0 | VB9 | 10 | 系统命令位/状态位/状态机/泵状态/报警码/轮次 |
| VB18 | VB149 | 132 | HMI设定参数+实测值+纠偏变量（⚠v2.0 删除VD10/VD14，起始从VB18开始；VD144为v2.3新增T默认值） |
| VB150 | VB199 | 50 | 纠偏中间变量（VD150\~VD190）+断电恢复中间量（VD194/VW198）【Story1.4/1.7新增】 |
| VB200 | VB235 | 36 | Modbus寄存器映射缓冲区（VW200\~VW230 + VD232 PumpWrite\_Addr） |
| VB230 | VB289 | 60 | 阀门诊断子状态/结果/PT转换值（VW230\~VW289）【Story1.3新增，2026-07-18静态分析修复】 |
| VB300 | VB303 | 4 | 报警字（4字节32位按位编码；HMI经VW300/VW302拆分读取） |
| VB304 | VB304 | 1 | M\_InitDone初始化完成标志（V304.0，Story1.7新增）+ RTU从站在线标志位（V304.1/V304.2，AQEX-49新增，非断电保持） |
| **VB305** | **VB305** | **1** | **系统总状态字（0=良好/1=故障/2=急停，OB1 NETWORK 10每周期计算，AQEX-50新增，非断电保持）** |
| VB306 | VB307 | 2 | 预留扩展 |
| VB308 | VB347 | 40 | 阀门诊断数据/运算中间变量（VD308~~VD344）【2026-07-18静态分析修复：原VD250~~VD296区间编址冲突，迁移至此】 |
| VB348 | VB349 | 2 | 预留（原错误描述为“VB305\~VB349”，已修正） |
| VB350 | VB373 | 24 | AQEX-36迁移的6个VD参数（VD350/354/358/362/366/370，原VD18/20/48/50/96/98，避免步长2冲突） |
| VB384 | VB399 | 16 | 手动注射泵参数（⚠v2.0 VD384已迁出至VD452，本区域仅余 VD392/VD396 + VW388/VW390） |
| VB500 | VB599 | 100 | 报警日志缓冲区（FC3 NETWORK6，Story1.6新增） |
| DT10 | DT10 | 8 | DT\_TankB\_FullTime时间戳 |

**注**：具体断电保持范围以系统块配置为准，CPU ST20超级电容典型保持7天/最小6天。

***

## 附录B：变量地址快速索引

按地址排序的快速查找表：

| 地址 | 符号 | 类型 | 说明 |
| --- | --- | --- | --- |
| I0.0\~I0.3 | DI\_xxx | BOOL | 17点数字量输入（I0.3/I0.4未使用） |
| Q0.0\~Q8.0 | DO\_xxx | BOOL | 9点数字量输出 |
| V0.0\~V0.7 | CMD\_xxx | BOOL | 8个系统命令位（HMI→PLC） |
| V1.0\~V1.7 | STA\_xxx | BOOL | 8个系统状态位（PLC→HMI） |
| V2.4\~V3.7 | CMD\_Manual\_xxx（v1.0\~v1.7旧地址，与VW2物理重叠已停用） | BOOL | ~~手动控制命令位~~ ⚠ v1.8已迁移至V306.0\~V307.3 |
| **V306.0\~V307.3** | **CMD\_Manual\_xxx** | **BOOL** | **手动控制命令位（v1.8：阀/泵/注射泵12个命令位；避开VW2防止状态机被误改写）** |
| VW2 | — | INT | 状态机当前状态（0\~8, 99） |
| VW4 | — | INT | 注射泵状态码（映射自41001） |
| VW6 | — | INT | 当前最高优先级报警码 |
| VW8 | — | INT | 实验轮次计数 |
| VD10\~VD66 | VD\_xxx | REAL | HMI设定参数（浓度/时间/超时；VD18/VD48/VD50已迁移至VD350/358/362） |
| VD70\~VD102 | VD\_xxx | REAL/DWORD | PLC实测值（时长/流量/加药计算；VD96/VD98已迁移至VD366/370） |
| VD104\~VD144 | VD\_xxx | REAL | 纠偏变量(VD108 S6默认值HMI设定)+泵速度(VD132/136/140已停用,PLC不干预,使用泵自身默认速度)+VD144 T默认值(HMI设定,v2.3由VD104迁移,VD104与VD102重叠) |
| VD350\~VD584 | VD\_xxx | REAL | AQEX-36迁移的6个VD参数（VD350=StepResolution/VD354=CycleSetpoint/VD358=Timeout\_ValveA/VD362=Timeout\_ValveB/VD366=ExperimentDuration\_Accum/VD584=Vol\_Target，原VD18/20/48/50/96/98） |
| VD384 | ~~VD\_ManualDose\_Target~~ | REAL | **【⚠v2.0 迁出】** 原地址让给MBUS Error，迁到VD452 |
| **VD440** | **VD\_Dosed\_Volume\_Total** | **REAL** | **【✅v2.0 新增】** 累计加药量（FC13写，HMI只读显示，迁自VD378） |
| **VD444** | **VD\_S4Wait\_Time** | **REAL** | **【✅v2.0 新增】** S4等待时长内部变量（迁自VD380） |
| **VW414** | 定时器暂存 | WORD | **【✅v2.0 新增】** FC11/15/17 定时器暂存（迁自VW380） |
| **VD448** | **VD\_S4WaitTimeout** | **REAL** | **【✅v2.0 新增，断电保持】** S4等待超时阈值HMI参数（迁自VD382） |
| **VD452** | **VD\_ManualDose\_Target** | **REAL** | **【✅v2.0 新增，断电保持】** 手动注射泵总加药量HMI参数（迁自VD384） |
| VD392 | VD\_ManualDose\_Dosed | REAL | 手动注射泵累计加药量（µL，FC21内部） |
| VD396 | VD\_ManualDose\_Remaining | REAL | 手动注射泵剩余加药量（µL，FC21内部） |
| VW388 | VW\_ManualDose\_Mode | INT | 手动注射泵模式：0=单次，1=循环 |
| VW390 | VW\_ManualDose\_State | INT | 手动注射泵子状态：0空闲/1抽液/2排液/3回零/4完成/99错误 |
| VB300\~VB303 | M\_Alarm\_xxx | BYTE×4 | 报警字（4 字节 32 位按位编码；经 VW300/VW302 拆分读取） |
| **VB305** | **VB\_SystemStatus** | **BYTE** | **系统总状态字（0=良好/1=故障/2=急停，OB1 NETWORK 10每周期计算，AQEX-50新增）** |
| **V304.1** | **M\_CommStatus\_Syringe** | **BOOL** | **注射泵RTU从站在线（1=在线，0=离线，AQEX-49新增）** |
| **V304.2** | **M\_CommStatus\_Flow** | **BOOL** | **流量计RTU从站在线（1=在线，0=离线，AQEX-49新增）** |
| VW200\~VW230 / VD232 | MB\_xxx / PumpWrite\_Addr | INT/WORD / DWORD | Modbus寄存器映射缓冲区（VW230=PumpWrite\_Data, VD232=PumpWrite\_Addr） |
| VW230\~VW289 | Diag\_xxx | INT/WORD | 阀门诊断子状态/结果/PT转换值（VW252 S2 PT/VW254 S3.5 PT/VW260~~270诊断子状态结果/VW274~~284超时PT） |
| VW290\~VW297 | FC4\_Poll\_xxx | INT/WORD | FC4 Modbus轮询内部计数器（VW290轮询计数/VW292重试计数/VW294泵连续失败/VW296流量计连续失败）【AQEX-48修复：原VW250\~VW256与VD250/FC12/FC14冲突，迁移至此】 |
| VD308\~VD344 | Diag\_Data\_xxx | REAL/DWORD | 阀门诊断数据/运算中间变量（VD308阀A快照/VD312阀A差值/VD316目标进水量/VD320\~344各FC运算中间变量） |
| M10.0\~M10.5 | M\_FC4\_xxx | BOOL | FC4 Modbus轮询Done位(M10.0~~3)+降级标志(M10.4~~5)，详见11.5节 |
| M10.6 | M\_ExpEnd\_Flag | BOOL | 实验结束标志（FC17置位/FC18复位） |
| M10.7 | M\_PrePlan\_Trig | BOOL | 预规划触发标志（FC15/FC16/FC17用） |
| M11.0 | M\_MBUS\_CTRL\_Done | BOOL | MBUS\_CTRL Done位（LAD引脚输出） |
| M11.1\~M11.5 | M\_xxx\_Edge | BOOL | FC3边沿检测/消音标志（M11.1消音/M11.2报警/M11.3~~5 I0.0~~I0.2边沿） |
| VB378 | VB\_MBUS\_CTRL\_Error | BYTE | MBUS\_CTRL Error错误码（LAD引脚输出） |
| VB379 | VB\_MBUS\_MSG\_Pump\_Error | BYTE | MBUS\_MSG注射泵轮询错误码（LAD引脚输出） |
| VB384 | — | — | **【⚠v1.9前文档Bug】** MBUS\_MSG Error 实际占用 VB380~~VB383，不是 VB384。v2.0 已更正。VB384~~387 在 VD384 迁出后暂时空闲。 |
| DT10 | DT\_TankB\_FullTime | DT | 下缸变满时间戳 |

***

**文档版本**：v2.0
**编制日期**：2026-07-15（v1.0）/ 2026-07-27（v1.1新增11.5节Modbus通讯状态字+附录B索引更新）/ 2026-07-28（v1.2修正FC4轮询计数器地址VW250→VW290~~VW296，标注VD250/VW250冲突）/ 2026-08-17（v1.3新增手动注射泵控制变量V3.6/V3.7/VD384/VW388/VW390/VD392/VD396）/ 2026-08-24（v1.4修正VD\_T\_Default迁移至VD144）/ 2026-09-02（v1.5新增V304.1/V304.2 RTU从站在线标志位）/ 2026-09-02（v1.6新增VB305系统总状态字）/ 2026-09-03（v1.7 FC0冷启动安全默认值+停用注射泵速度PLC干预）/ 2026-09-03（v1.8 【重大修复】手动控制命令位V2.4~~V3.7→V306.0~~V307.3，避开VW2状态机地址重叠）
**修订日期**: 2026-09-03
**修订内容**:~~ **~~【v1.8 P0级修复】~~** ~~① 手动控制命令位V2.4~~V3.7（VB2/VB3区）与VW2状态机当前状态物理地址重叠，导致V3.1=1直接改写VW2=2（S2预循环）触发两台循环泵同时启动、V3.2=1进入S4并报"阀B开到位超时"；现全部迁移至V306.0\~V307.3（预留扩展区），FC20/FC21/OB1代码同步更新，McgsPro CSV导入文件中"通道地址"列须同步迁移（变量名不变，HMI侧脚本无须改动）；② **新增V309.0调试模式开关（4.5节）**——空缸联机调试时旁路阀B/阀C的液位联锁；③ McgsPro CSV导入文件中"通道地址"列已全部同步：U1/U2/U3/U4/U5/U6/U7/U8 8套单元均补充泵2/注射泵/V309.0共5个变量（原仅阀/泵1共8个变量），合计每个单元13条手动控制记录。
**配套文档版本**：PLC设计文档v9.3、HMI画面架构规划文档v9.3
**下次更新触发**：待确认事项闭环、HMI选型确认、PLC编程地址调整时
