Yustnust/AQUA-EXPO/docs/药液配置加注控制系统_PLC设计文档.md

# 药液配置与加注控制系统 — PLC设计文档 v10.2【AQEX-51 更新】

**本文档描述范围【v9新增】**：本文档描述**单套缸控制单元**的完整设计。系统共由**8套完全相同、彼此独立运行**的此类单元组成（8套上下玻璃缸），每套单元各配1台PLC、1条独立485总线、1套I/O，互不依赖、互不影响。8套单元之间的联网与集中监控方案见第十二章。

**PLC型号**：西门子 S7-200 SMART CPU ST20（标准型，内置RTC，超级电容保持典型7天/最小6天）+ 1块EM DT16/DR16数字量扩展模块（8DI+8DO，覆盖本体12DI/8DO之外的缺口），**每套单元各1台，共8台**
**人机界面【v9.1更新】**：不再采用每套单元1个12寸触摸屏，也不采用远程/中控室SCADA方案；改为"现场1台本地集中触摸屏HMI + 每套单元独立物理急停/系统复位按钮 + 可选就地消音按钮"。HMI用于8套单元总览、报警详情、报警确认、参数设定、历史记录和手动调试；PLC仍负责各单元完整控制逻辑与安全联锁，详见第十二章。

**术语说明【v9.1更新】**：本文档中"HMI"均指现场本地集中触摸屏，不指远程上位机或中控室SCADA。急停、急停后的系统复位为现场物理操作；报警详情查看、报警确认/消光、参数设定、状态强制修正、历史数据查看等由本地HMI完成。
**文档状态**：核心逻辑已确认定稿；485通讯从站（注射泵、流量计）接口已确认【v9.2更新】；本地集中HMI画面和变量表待细化
**版本说明**：v2.0 相对 v1.0 新增/修改内容已用【v2新增】标注；v3更正内容（急停触点类型、安全继电器反馈）已用【v3更正】/【v3新增】标注；v4将节奏纠偏触发点由S6改回S5（上升沿触发），已用【v4更新】标注；v5澄清"方案A/B"实为报警确认模式（非流程分支）并补充DI/DO；v10.2/AQEX-51：RTC 异常不再直接进 S_ERROR，改置 V303.7 请求 HMI 校时（5 分钟超时进 S_ERROR）；FC0 全部 JMP/LBL 合并到单 NETWORK；FC2 I1.2 逻辑按实际接线取反（I1.2=1=动力接通）；新增 FC22_RTC_Sync 处理 TODW 校时接线原则；v6根据注射泵Modbus协议文档确认其为柱塞式泵阀一体计量泵，S3加药逻辑由时长控制改为步数控制+状态轮询；v7根据阀门实际接线图确认限位反馈为有源信号，新增阀A/B/C开到位/关到位共6个DI点及交叉诊断逻辑；v8根据流量计Modbus协议文档确认"计量值"寄存器无清零功能，S1进水判断改为差值法；v9确定8套缸整体架构为"每套缸独立PLC+集中监控"；v9.1将集中监控形式由中控室SCADA调整为现场本地集中HMI，并将报警确认从就地物理按钮调整为HMI报警详情页确认，系统复位仍保留为每套单元物理按钮；v9.2根据客户要求取消温度计、pH计两个Modbus从站，RS485从站数量由4个减为2个（注射泵+流量计），同步移除S5状态机中的温/pH采集、第二章通讯从站表、第十一章待确认事项及第十二章485总线从站描述中的相关内容；v9.3客户决定首期先实施1套单元验证效果、后续按需扩展至8套，PLC程序本身8套完全相同无需修改（使能是HMI侧管理概念，不写入PLC），仅在第十二章补充HMI分期接入动态显隐的引用说明；v9.4移除潜水泵1/2流量开关I0.3/I0.4（由流量开关A/B/C反映泵工作状态）；v10新增第十章"手动控制逻辑"，明确手动控制仅S0态可用，新增阀门/潜水泵手动控制（FC20，M13.0~M13.4锁存 + NC阀联动）与注射泵手动控制（FC21，单次/循环模式，V3.6/V3.7命令位，VD384总加药量/VW388模式/VW390状态），并补充手动命令位V2.4~V3.7地址表；**v10.1【关键Bug修复 2026-09-04】**：① **FC3_NETWORK4 报警确认处理缺V0.3上升沿门控**——NETWORK4每周期无条件执行所有报警位复位逻辑，导致报警位置位后同一周期被清除（如RTC丢失V303.5被清），VW6重算=0、VB305=0、报警灯/蜂鸣器不工作，但VW2=99卡S_ERROR状态机；修复：在NETWORK4开头加`LD V0.3; EU; JMP 40`门控和LBL 40跳转目标，确保仅V0.3上升沿时执行确认复位；② **FC4_NETWORK6 Modbus任务4 MBUS_MSG缺M11.6门控**——任务4进入后EN/First条件为`VW290=4`常通，每个扫描周期MBUS_MSG被反复触发，从站收到乱序命令后M10.3不置位、VW290永远卡4、FC21/FC13永远等不到M12.0；影响手动注射泵VW390卡3（回零中）和自动S3加药必触发S_ERROR；修复：EN/First各加`A M11.6 + AN M11.7`条件，确保仅写请求有效时执行且防重发。

---

## 一、系统概述

设备为上下两层玻璃缸的实验室配液加注系统：
- **上部玻璃缸**：药剂配液缸，负责进纯净水、搅拌、加药
- **下部玻璃缸**：实验缸，接收配好的溶液，按换水周期定期更换

系统长期**无人值守**运行，因此所有异常检测、报警处理、断电恢复逻辑均按"最坏情况有人不在场"的原则设计。

**多单元架构原则【v9新增】**：全系统共8套上述缸体，各自独立成套（各1台PLC、1条485总线、1套阀门/泵/传感器），彼此之间**没有工艺耦合**，任一单元的故障、停机、程序下装/调试均不影响其余7套单元的实验运行。这一原则也延伸到安全设计：8套单元的急停回路、报警回路各自独立，不设集中联动急停或跨单元联动报警（详见第九章、第十二章）。

---

## 二、I/O 地址分配表

### 2.1 数字量输入 DI（共 **17点使用 + 3点备用**，v9.1更新：报警确认改为HMI软命令；v9.4更新：移除潜水泵1/2流量开关I0.3/I0.4）

**接线原则**：流量开关、液位计（高低位）、急停常闭触点、安全继电器反馈触点均按**无源触点**处理，直接接入PLC自身24VDC回路，不经继电器转换。**阀门限位反馈信号（开到位/关到位）经现场接线图确认为有源正极输出**，与PLC 24V DI输入电平/驱动方式不匹配，**必须经中间继电器转换**（有源信号驱动继电器线圈，再用继电器无源触点接给PLC DI）后才能接入，不能直接接线。若后续其他现场器件确认为有源输出或220V信号，同样必须加装中间继电器做电气隔离，绝不允许220V信号直接接入DI端子。

| 地址(示例) | 名称 | 类型 | 说明 |
|---|---|---|---|
| I0.0 | 流量开关A | 常开 | 监测电动球阀A开启后是否有水流（上缸进水） |
| I0.1 | 流量开关B | 常开 | 监测电动球阀B开启后是否有水流（上→下转移） |
| I0.2 | 流量开关C | 常开 | 监测电动球阀C开启后是否有水流（下缸排水） |
| I0.5 | 液位计A-高位【v2】 | NPN 常开 | 液体没过探针时闭合=I=1（上缸液位达最高警戒，防漫溢）；液体低于探针时断开=I=0 |
| I0.6 | 液位计A-低位【v2】 | **NPN 常闭** | ⚠️ **原文档错标为"常开"，v10更正**：液体低于探针时闭合=I=1（上缸已排空）；液体没过探针时断开=I=0（上缸有液）。PLC逻辑 `A I0.6` = 上缸排空 |
| I0.7 | 液位计B-高位【v2新增】 | NPN 常开 | 液体没过探针时闭合=I=1（下缸液位达最高警戒，防漫溢，对称保护）；液体低于探针时断开=I=0 |
| I1.0 | 液位计B-低位【v2】 | **NPN 常闭** | ⚠️ **原文档错标为"常开"，v10更正**：液体低于探针时闭合=I=1（下缸已排空）；液体没过探针时断开=I=0（下缸有液）。PLC逻辑 `A I1.0` = 下缸排空 |
| I1.1 | 急停信号反馈【v3更正】 | **常闭** | 急停按钮独立第二组常闭触点接入PLC自身24VDC回路（不接220V）；正常运行时闭合=ON，急停触发后断开=OFF。PLC逻辑按"OFF=急停触发"判断（见第九章） |
| I1.2 | 安全继电器反馈【v3新增】 | 常开/常闭视选型 | 强制导向型安全继电器的辅助反馈触点，确认执行机构220V/380V动力回路是否已真实切断（见第九章） |
| I8.0 | 阀A开到位反馈【v7新增】 | 有源→继电器转换 | 阀门厂商限位反馈信号（正极输出），需经继电器转为无源触点后接入 |
| I8.1 | 阀A关到位反馈【v7新增】 | 有源→继电器转换 | 同上 |
| I8.2 | 阀B开到位反馈【v7新增】 | 有源→继电器转换 | 同上 |
| I8.3 | 阀B关到位反馈【v7新增】 | 有源→继电器转换 | 同上 |
| I8.4 | 阀C开到位反馈【v7新增】 | 有源→继电器转换 | 同上 |
| I8.5 | 阀C关到位反馈【v7新增】 | 有源→继电器转换 | 同上 |
| I0.4 | 消音按钮【v9.1保留】 | 常开，点动 | 就地面板按钮，可按单套消音；按下后仅将声音DO置OFF，灯光DO和报警锁存保持原状态（见第八章8.2）。若最终HMI设置公共消音，本点可改作备用 |
| I2.2 | 备用输入【v9.1调整】 | 预留 | 原规划为就地报警确认/复位按钮；v9.1确认报警确认改由本地HMI报警详情页执行，本DI点暂作备用 |
| I0.3 | 系统复位按钮【v9新增/v9.1确认】 | 常开，点动 | 就地面板按钮，专用于急停解除后的系统复位（见第九章9.3）。急停按钮旋转释放只表示硬件触点恢复，不等同于PLC系统复位；按下本按钮后PLC才清除急停锁存并回到S0初始化 |

**接线原则补充【v9.1更新】**：I0.3、I0.4就地按钮均为无源常开点动触点，接线原则与本节其余DI点一致，直接接入PLC自身24VDC回路。I2.2暂作备用输入，建议端子和线号保留，便于后续现场扩展。

**容量提示【v9.4更新】**：本体12DI（I0.0~I0.7, I1.0~I8.0）+EM DR32扩展模块8DI（I8.0~I8.7）＝20DI；当前使用17点，I8.0、I2.2、I8.6、I8.7预留4点。若后续现场调试阶段还需增加更多DI点（如额外诊断点、钥匙开关、门禁联锁等），可利用DR32剩余I/O或加装额外扩展模块。

### 2.2 数字量输出 DO（共 **9点**，v5更新）

**接线原则**：PLC全部DO点不直接驱动泵、阀、报警器等负载，均先驱动一个继电器线圈，由继电器触点接通实际负载电源，避免PLC输出电流不足烧毁输出点。急停回路的执行环节沿用第九章已定的**强制导向型安全继电器**（220V线圈规格，非普通继电器）。

| 地址(示例) | 名称 | 说明 |
|---|---|---|
| Q0.0 | 潜水泵1 | 上缸搅拌泵 |
| Q0.1 | 潜水泵2 | 上缸搅拌泵 |
| Q0.2 | 电动球阀A | 上缸进水 |
| Q0.3 | 电动球阀B | 上→下转移 |
| Q0.4 | 电动球阀C | 下缸排水 |
| Q0.5 | NC球阀-上缸 | 常闭型，得电打开/失电关闭（失效安全）；阀A失效的独立第二道保护 |
| Q0.6 | NC球阀-下缸【v2新增】 | 同上，阀B/液位计B最高报警时的独立第二道保护 |
| Q0.7 | 报警-声音 | 无源触点驱动，独立消音控制 |
| Q8.0 | 报警-灯光 | 无源触点驱动，独立消光控制（需人工确认复位） |

### 2.3 RS485 / Modbus 通讯从站（共 **2个**，v9.2更新：取消温度计、pH计）

| 从站 | 用途 | 备注 |
|---|---|---|
| 注射泵【v6更新】 | 柱塞式泵阀一体注射泵，Modbus协议（已确认，非出厂默认ASCII） | 详见下方"注射泵Modbus寄存器表" |
| 流量计【v8更新】 | 上缸进水精确计量（连续量，区别于DI的流量开关开关量） | Modbus RTU协议，详见下方"流量计Modbus寄存器表" |

**流量计Modbus寄存器表（节选，与本设计相关部分）：**

| 寄存器 | 地址(HEX) | 含义 | 说明 |
|---|---|---|---|
| 0x0009 | 计量值 | 0~99999999，**只读**，低3位为小数部分 | 持续累加，**无清零/复位寄存器**，需用差值法计算单次进水量（见第四章S1） |
| 0x000F | 平均流速 | 只读，低2位小数 | 近1分钟平均流量，仅供监测参考 |
| 0x0017 | 瞬时流速 | 只读，低2位小数 | 实时流速，仅供监测参考 |
| 0x0012 | 单位 | 可读写，默认按"升(L)"=0x03假设 | 需现场核实实际配置值 |

**重要澄清（v8）**：该流量计"计量值"寄存器为**持续累加、只读**，设备本身**不提供清零/复位功能**（0x0011~0x0015等可写寄存器均为通讯地址/波特率/单价/单位/校正参数等配置项，与累计流量清零无关）。因此PLC无法像常见做法那样"进水前清零、进水后直接读增量"，必须改用**差值法**：阀A开启瞬间先读取并快照当前"计量值"，进水过程中用"当前计量值 − 快照值"计算本次实际进水量，详见第四章S1。

**注射泵Modbus寄存器表（节选，与本设计相关部分）：**

| 寄存器 | 地址(HEX) | 含义 | 说明 |
|---|---|---|---|
| 40002 | 0x0001 | 强停 | 0空闲，1强停 |
| 40003 | 0x0002 | 复位 | 0空闲，1复位（即初始化，泵上电后必须先执行一次） |
| 40006 | 0x0005 | 抽液 | 0~最大行程，**单位：步数**，写入目标抽取步数 |
| 40007 | 0x0006 | 排液 | 0~最大行程，**单位：步数**，写入目标排放步数 |
| 40009-11 | 0x0008-A | 启动/最高/截止速度 | 单位Hz，控制抽排速度曲线。**默认值**：启动450Hz、最高700Hz、截止450Hz（依据SY-03BM说明书，25mL进样器半步模式）。**范围**：启动100~6000、最高100~6000、截止50~5400。PLC侧VD132/VD136/VD140为HMI设定的REAL值，FC4通讯时转INT写入VW208/210/212。
| 40015-16 | 0x000E-F | 运行/复位电流 | 1-31 |
| 40017-18 | 0x0010-11 | 阀输入口/阀输出口 | 泵阀一体内部阀（抽取母液/排放到管路两个流路间切换，与外部电动球阀ABC无关） |
| 41001 | 0x03E8 | 状态码 | 含错误码，PLC轮询此寄存器判断动作是否完成/是否故障 |
| 41007 | 0x03EE | 注射泵位置反馈 | 单位：半步，可用于核实实际抽排步数是否到位 |

**重要澄清（v6）**：该泵为**柱塞式计量泵**（丝杆推动活塞，一次行程完成固定体积的抽取或排放），**不是**连续流动的蠕动泵/隔膜泵。控制方式是**直接写入目标步数**，泵完成后停止，没有"持续运行时长"的概念。因此第四章S3的加药逻辑改为"计算目标步数→下发抽/排液指令→轮询状态码确认完成"，不再是"运行时长计算"，详见下方S3更新。

---

## 三、内部标志位（断电保持区）

> **【v11.0 2026-09-13 关于 FC0_SysInit 的拆分 + 冷启动 RTC 修复】**
> FC0 原单一 POU 12KB 导致 STEP7 下载误报"块过大"。**拆分为 3 个 POU**:
> - **FC0 SysInit**: 调度骨架，负责 Modbus 清零 + 冷启/断电路径调度（LBL 1→CALL SBR26；CALL SBR25→LBL 2）
> - **SBR25 ColdStart**: 冷启动完整逻辑（出厂硬编码 + 用户默认覆盖 + ★ TODR VB900 冷启动读 RTC + RTC 合法性检查 + 安全初始化 + RET）
> - **SBR26 WarmRecovery**: 断电恢复完整逻辑（TODR VB900 + RTC 合法性检查 + DT10 比较 + BCD 转秒 + VD_S5_Elapsed 重算 + 状态机恢复 + RET）
> 跨 POU 无 JMP/LBL 依赖，各 POU 内部 LBL 编号独立（FC0 用 1/2；SBR25 用 8/9/10/88/89；SBR26 用 1/3/4/5/6/7）。
> **冷启动路径新增 TODR + RTC 合法性检查**，解决原冷启动路径无 TODR 导致 VB900~VB905 全 0 的问题（FC22 自动校时无法触发）。
> VD_Vol_Target（原 VD370，与 VD372 字节冲突）迁移至 VD584（VB584~VB587），断电保持区扩展为 VB1~VB600 连续覆盖。

| 符号 | 说明 |
|---|---|
| M_TankA_State | 上缸状态：0=空，1=满（软件标志位，非实体I/O，HMI可手动强制修正） |
| M_TankB_State | 下缸状态：0=空，1=满（软件标志位，非实体I/O，HMI可手动强制修正） |
| M_EStop_Latch | 急停锁存标志，需HMI人工复位才能清除 |
| M_Alarm_Overflow | 漫溢类报警标志（液位计A/B最高报警、任一NC阀动作），强制人工确认 |
| M_Alarm_ScheduleLag【v2新增】 | 配液节奏滞后提示标志，达到"人工介入"层级时锁存，需人工确认 |
| M_Manual_ValveA/B/C_Latch【v10新增】 | 手动阀门锁存（M13.0~M13.2），仅S0态有效 |
| M_Manual_Pump1/2_Latch【v10新增】 | 手动潜水泵锁存（M13.3/M13.4），仅S0态有效 |
| DT_TankB_FullTime | 下缸变满时刻的时间戳，用于换水周期计算 |
| VD_CycleSetpoint | 换水周期设定值（HMI可调） |
| VD_Timeout_ValveA/B/C | 阀A/B/C各自的动作超时保护时长（HMI独立可调） |
| VD_Delay_ValveA_Verify | 阀A关闭后延时验证时长（HMI可调） |
| VD_PreMixTime【v2】 | 潜水泵预循环标称时长（HMI可调，用于T的计算，取标称值不取压缩后实际值） |
| VD_PreMixTime_MinSafe【v2新增】 | S2预循环压缩下限（HMI可调，纠偏第1层可压缩到的最低安全值，不能到0） |
| VD_RestTime【v2新增】 | 静止等候标称时长（HMI可调，S3完成后、阀B转移前，用于溶液沉降） |
| VD_RestTime_Min【v2新增】 | 静止等候压缩下限（HMI可调，纠偏第0层最低不能低于此值，不能到0） |
| VD_CycleExtend_Max【v2新增】 | 换水周期顺延最大允许幅度（HMI可调，纠偏第2层超过此值则升级人工介入） |
| VD_S2_Target【v3新增】 | 本轮S2预规划/二次校正后的实际执行目标时长（断电保持，S5触发时初算，S1完成后二次校正） |
| VD_RestTime_Target【v3新增】 | 本轮S3.5预规划/二次校正后的实际执行目标时长（断电保持，S5触发时初算，S1完成后二次校正） |
| VD_CycleExtend_Target【v3新增】 | 本轮预规划算出的允许"下缸空等"时长（断电保持，0表示无需空等） |
| VD_T_Rolling【v2新增】 | 滚动实测的S1-S3+静止等候总时长T（断电保持，首轮无历史数据时取VD_T_Default） |
| VD_T_Default【v2新增】 | T的初始默认值（**v2.3起改为HMI设定参数**，默认300.0s、范围60~900，位于时间周期组；仅供第一轮无历史数据时使用。**地址由VD104迁移至VD144**——VD104与VD_Dose_Steps(VD102)字节重叠VB104~105，FC13/FC21每次写加药步数都会破坏VD104） |
| VD_S6_Rolling【v2新增】 | 滚动实测的S6排水时长（断电保持，首轮取VD_S6_Default） |
| VD_S6_Default【v2新增】 | S6排水时长初始默认值（**v2.3起改为HMI设定参数**，默认180.0s、范围30~600，位于时间周期组。实验启动时FC10播种：VD112←VD144、VD116←VD108，首轮后由实测值自动学习覆盖） |
| VD_ExperimentTarget【v2新增】 | 实验时长目标设定值（HMI设置，作为实验停止条件） |
| VD_ExperimentDuration_Accum【v2新增】 | 实验时长累加值（断电保持，仅累加下缸="满"的时间段） |
| M_AlarmAckMode | 报警确认模式：0=自动恢复，1=人工确认（人工确认由本地HMI报警详情页下发确认命令；漫溢类报警及节奏滞后人工介入报警不受此项影响，始终强制人工确认） |
| VD_C_Set【v6新增】 | 目标浓度设定值（HMI输入，如5%） |
| VD_C_Stock【v6新增】 | 母液浓度（HMI人工输入，人工配置后录入，非在线检测） |
| VD_Vol_Target【v6新增】 | 本轮目标抽取母液体积 = VD_C_Set×上缸注水量/VD_C_Stock（µL） |
| VD_StepResolution【v6新增】 | 注射泵单步分辨率（µL/步），取决于所选进样器规格，HMI参数，需按实际进样器容量核实（参考SY11文档2.4节换算方式） |
| VD_Dose_Steps【v6新增】 | 本轮加药目标步数 = VD_Vol_Target ÷ VD_StepResolution，写入注射泵抽液/排液寄存器 |
| M_Pump_Status【v6新增】 | 注射泵状态码轮询结果（映射自Modbus寄存器41001），用于判断抽/排液动作完成或故障 |
| VD_FlowMeter_Snapshot【v8新增】 | 阀A开启瞬间的流量计"计量值"快照，用于差值法计算本次进水量（该流量计无清零功能，见第二章说明） |
| M_InitDone（V304.0）【Story1.7新增】 | 初始化完成标志（断电保持，首次成功初始化后置1；=0冷启动，=1断电恢复） |
| M_CommStatus_Syringe（V304.1）【AQEX-49新增】 | 注射泵RTU从站在线标志（FC4任务0轮询成功置1，超时/降级复位0；HMI画面7_通讯维护使用） |
| M_CommStatus_Flow（V304.2）【AQEX-49新增】 | 流量计RTU从站在线标志（FC4任务1轮询成功置1，超时/降级复位0；HMI画面7_通讯维护使用） |
| VW252【Story1.2修复】 | S2计时T38的PT转换值（VD_S2_Target×10，由FC12进入时计算写入，100ms时基） |
| VW254【Story1.2修复】 | S3.5计时T39的PT转换值（VD_RestTime_Target×10，由FC14进入时计算写入，100ms时基） |
| VW278【校验修复】 | 阀A T50超时PT转换值（VD_Timeout_ValveA×10，由FC11计算写入，FC30读取，与FC32 VW270隔离） |
| VW280【校验修复】 | 阀A T51延时验证PT转换值（VD_Delay_ValveA_Verify×10，由FC11计算写入，FC30读取） |
| VD290/VD292/VD294/VD296【校验修复】 | 运算中间变量（避免修改HMI设定参数：VD290=VD48运算/VD292=VD120运算/VD294=VD124运算/VD296=VD58/62运算） |

---

## 四、顶层状态机（实验流程主状态）【v2更新：新增静止等候子步骤、节奏滞后判断、实验结束终态】

```
S0 初始化
   → 上下缸状态强制置"空"（开机默认，也可HMI手动强制）
   → 所有阀门/泵输出复位为OFF
   ↓
S1 上缸进水（阀A开启条件成立）【v8更新：流量计差值法】
   → 阀A开，同步启动"S1实测计时器"
   → 阀A开启瞬间，读取流量计"计量值"寄存器(0x0009)，快照为 VD_FlowMeter_Snapshot
   → 持续读取当前"计量值"，计算 本次进水量 = 当前计量值 − VD_FlowMeter_Snapshot
   → 本次进水量 ≥ HMI设定进水量 → 立即关阀A（关闭后延时验证，见第五章）
   → 液位计A-高位全程监测，一旦触发 → 立即关阀A+关NC球阀-上缸，转入漫溢报警
   ↓（阀A关闭且验证通过，上缸状态置"满"，S1实测计时器停止，记录本次S1实测时长S1_actual，
     本次进水量同时作为S3加药公式"上缸注水量"的输入）
   → 【v3新增】用S1_actual执行一次二次校正计算（见第七章7.3），
      重新核定本轮 VD_S2_Target / VD_RestTime_Target
S2 潜水泵预循环
   → 开启潜水泵1、潜水泵2，仅搅拌，不加药
   → 按 VD_S2_Target 计时（该目标值已在S5触发时预规划、S1完成后二次校正，见第七章）
   ↓
S3 加药【v6重写：步数控制+状态轮询，非时长控制】
   → 计算目标抽取体积：V目标 = (目标浓度×上缸注水量) / 母液浓度
   → 换算为步数：N步 = V目标(µL) ÷ 单步分辨率(µL/步)，单步分辨率取决于所选进样器规格
   → 写入注射泵"抽液"寄存器(40006)=N步，下发抽取母液指令
   → 轮询状态码寄存器(41001)，确认抽取动作完成/无错误
   → 写入注射泵"排液"寄存器(40007)=N步，下发排放到管路指令（泵阀一体内部阀自动切换流路）
   → 轮询状态码寄存器(41001)，确认排放动作完成/无错误
   → 潜水泵在整个S3期间持续运行（搅拌+加药同时进行）
   → S3完成判定：以状态码反馈为准，不是固定时长；S3计算值用于T的预估时仍可给出理论估算
     （N步×单步耗时的理论值），但实际完成时刻以轮询结果为准，逻辑上与S1"以流量计读数
     判断完成"是同一模式
   ↓
S3.5 静止等候【v2新增】
   → 溶液沉降缓冲，按 VD_RestTime_Target 计时（该目标值已在S5触发时预规划、S1完成后二次校正）
   ↓（S1实测 + S2标称 + S3计算 + 静止等候标称 = 本轮总时长，滚动更新 VD_T_Rolling）
S4 上→下转移（阀B开启条件成立，见第六章四态诊断）
   → 阀B开，监测流量开关B+液位计A-低位，正常排空后关阀B
   → 液位计B-高位全程监测，一旦触发 → 立即关阀B+关NC球阀-下缸，转入漫溢报警（不管四态诊断处于哪个状态）
   → 上缸状态置"空"，下缸状态置"满"
   → 记录下缸变满时间戳 DT_TankB_FullTime
   → 下缸"满"状态开始期间，持续累加 VD_ExperimentDuration_Accum
   ↓
S5 实验运行中（等待换水周期）【v4更新：调度预规划计算触发点改回S5，上升沿触发；v9.2更新：移除温度/pH采集】
   → 持续计算：下缸预计排空时刻 = DT_TankB_FullTime + VD_CycleSetpoint + VD_S6_Rolling
   → 持续比较：(下缸预计排空时刻 − 当前时间) ≤ VD_T_Rolling ？
     该条件由"不满足"变为"满足"的**上升沿**（仅触发一次，非逐扫描周期重复触发）：
       1. 立即执行一次性节奏预规划计算（可用时间=下缸预计排空时刻−当前时间 vs
          所需时间=VD_T_Rolling），按三层纠偏算法（见第七章）算出本轮
          VD_S2_Target / VD_RestTime_Target / VD_CycleExtend_Target
       2. 若上缸状态=空，同时启动新一轮S1；若上缸状态≠空，说明上一轮尚未收尾完成，
          属于比"节奏滞后"更严重的异常，单独报警（不在第七章讨论范围内）
   → 持续判断：VD_ExperimentDuration_Accum ≥ VD_ExperimentTarget？
              → 是 → 转入 S7 实验结束
   ↓（达到换水周期，下缸状态="满"，阀C/流量开关C无报警）
S6 下缸排水（阀C开启条件成立，见第六章四态诊断）
   → 阀C开，同步启动"S6实测计时器"，监测流量开关C+液位计B-低位，正常排空后关阀C
   → 下缸状态置"空"，S6实测计时器停止，滚动更新 VD_S6_Rolling
   → 下缸"满"状态结束，本轮满液时长已计入累加值
   ↓（下缸排空）
   → 若新一轮S1-S3.5已完成（阀B转移就绪）→ 直接返回S4转移
   → 若新一轮S1-S3.5尚未完成 → 下缸空等，空等时长不得超过 VD_CycleExtend_Target
     （第二层纠偏额度内视为正常；超出仍未就绪则已在第七章触发人工介入报警）

S7 实验结束【v2新增、v10重写】
   → 状态机锁定，所有阀门/泵停止
   → HMI滚动条提示"⚠️ 实验已结束，请按【系统复位】按钮后再启动"
   → **v10重写出口**：S7唯一出口为**物理系统复位按钮I0.3**（就地面板按钮），不再接受HMI启动软命令(V0.0)
   → 按I0.3后清计数器(V10.6/VD364/VD378/VD372) + 回S0，后续由FC10接管
   → 回S0后再按HMI启动→ FC10查I0.6上缸排空→ 进S1新一轮
```

> S0~S7 为完整的实验流程主线，已双方确认定稿。**v10变更**：S7出口从HMI软命令V0.0改为物理硬按钮I0.3；FC10启动前置新增硬件液位检查I0.6（上缸排空）；液位计硬件类型更正（低液位为NPN常闭）。

---

## 五、阀A"关闭后延时验证"逻辑【v7更新：加入限位反馈交叉诊断】

```
运行中：
  持续计算 本次进水量 = 当前流量计"计量值" − VD_FlowMeter_Snapshot（差值法，见第四章S1）
  → 本次进水量 ≥ HMI设定进水量：立即下达"关阀A"指令，锁存此刻"计量值"读数，启动延时 VD_Delay_ValveA_Verify

延时到达后校验：
  - 流量开关A应变为OFF：若仍为ON → 报警"阀A关闭异常或流量开关A故障"
  - 若阀已关闭但流量计"计量值"仍在持续增长（即差值仍在扩大）→ 报警"阀A内漏或流量计异常"

限位反馈交叉诊断【v7新增】：
  - 阀A关到位反馈(I8.1) 应在延时内变ON：
    若超时仍未ON → 报警"阀A执行机构关闭故障"（与流量开关无关，直接定位到阀体/执行器）
    若已ON但流量开关A仍显示有流 → 报警"阀A关到位但仍有流量，怀疑内漏"（与上面"流量计仍增长"是同一类问题，两个信号源交叉验证，提高判断可信度）
  - 阀A开启时同理：下达开阀指令后，阀A开到位反馈(I8.0)应在超时内变ON：
    若超时仍未ON → 报警"阀A执行机构开启故障"
    若已ON但流量开关A始终无流 → 报警"阀A已开到位但无流量，怀疑上游缺水/管路堵塞/流量开关故障"（排除阀本身故障的可能）

全程安全监测（独立于上面逻辑，优先级最高）：
  液位计A-高位闭合 → 立即关阀A + 关NC球阀-上缸 + 触发漫溢类报警（强制人工确认）
```

---

## 六、阀门 A / B / C 四态诊断逻辑【v7更新：新增开到位/关到位限位反馈交叉诊断】

### 阀A（上缸进水）
开启/关闭逻辑及限位反馈交叉诊断见第五章。

### 阀B（上缸→下缸转移）

```
开启条件：上缸状态=满，下缸状态=空，流量开关C/阀C关闭，循环泵关闭，注射泵关闭，
          阀B/流量开关B关闭，液位计A-低位ON（上缸此时应为满，低位应为OFF——
          此处沿用原表述，实际以"上缸状态=满"这一软件标志为准），无报警，实验进行中

关闭逻辑（四态诊断，持续扫描流量开关B + 液位计A-低位）：
  流量开关B=ON  且 液位计A-低位=OFF  → 正常转移中
  流量开关B=ON  且 液位计A-低位=ON   → 上缸即将排空
  流量开关B=OFF 且 液位计A-低位=ON   → 上缸已排空 → 允许关阀B，上缸状态置"空"
  流量开关B=OFF 且 液位计A-低位=OFF  → 设备故障（阀卡滞/流量开关故障）→ 报警

限位反馈交叉诊断【v7新增】：
  阀B开启后，阀B开到位反馈(I8.2)应在 VD_Timeout_ValveB 内变ON：
    超时未ON → 报警"阀B执行机构开启故障"（直接定位阀体，与流量开关无关）
    已ON但流量开关B始终无流 → 报警"阀B已开到位但无流量，怀疑上缸无液/管路堵塞/流量开关故障"
  阀B关闭后，阀B关到位反馈(I8.3)应在延时内变ON：
    超时未ON → 报警"阀B执行机构关闭故障"
    已ON但流量开关B仍有流 → 报警"阀B关到位但仍有流量，怀疑内漏"

独立漫溢保护【v2新增】：
  液位计B-高位闭合 → 不管四态诊断处于哪个状态，立即强制关阀B + 关NC球阀-下缸
                      + 触发漫溢类报警（强制人工确认）

超时保护：阀B开启后，若在 VD_Timeout_ValveB 时间内流量开关B始终未变ON → 报警"阀B或流量开关B异常"
         （此超时判据与上方限位反馈交叉诊断为两套独立判据，可互相印证故障定位）
```

### 阀C（下缸排水）

```
开启条件：换水周期计时达到（含节奏调度判断，见第四章S5），下缸状态=满，
          阀C/流量开关C关闭，无报警，实验进行中

关闭逻辑（四态诊断，持续扫描流量开关C + 液位计B-低位）：
  流量开关C=ON  且 液位计B-低位=OFF  → 正常排水中
  流量开关C=ON  且 液位计B-低位=ON   → 下缸即将排空
  流量开关C=OFF 且 液位计B-低位=ON   → 下缸已排空 → 允许关阀C，下缸状态置"空"
  流量开关C=OFF 且 液位计B-低位=OFF  → 设备故障 → 报警

限位反馈交叉诊断【v7新增】：
  阀C开启后，阀C开到位反馈(I8.4)应在 VD_Timeout_ValveC 内变ON：
    超时未ON → 报警"阀C执行机构开启故障"
    已ON但流量开关C始终无流 → 报警"阀C已开到位但无流量，怀疑下缸无液/管路堵塞/流量开关故障"
  阀C关闭后，阀C关到位反馈(I8.5)应在延时内变ON：
    超时未ON → 报警"阀C执行机构关闭故障"
    已ON但流量开关C仍有流 → 报警"阀C关到位但仍有流量，怀疑内漏"

超时保护：阀C开启后，若在 VD_Timeout_ValveC 时间内流量开关C始终未变ON → 报警"阀C或流量开关C异常"
         （此超时判据与上方限位反馈交叉诊断为两套独立判据，可互相印证故障定位）
```

### 注射泵 超时保护

```
注射泵【v6更新】：泵阀一体自带状态码反馈(41001)，超时保护改为"轮询状态码超时未返回完成/故障"判定，
          不需要额外串联流量开关；若长时间无响应或状态码持续报错，触发"注射泵通讯/动作异常"报警
```

---

## 七、配液节奏滞后 — 三层自动纠偏机制【v4更新：触发点改回S5上升沿，预规划+S1后二次校正】

### 7.1 设计原则：预先规划，而非执行中逐层试错

三层纠偏（压缩静止等候→压缩S2→顺延周期）中，**S2排在S3.5之前执行**——如果等到S3.5阶段才发现"纠偏不够用"，S2早已按标称时长跑完，来不及回头压缩。因此纠偏方案**必须在S1开始之前就一次性规划好本轮S2、S3.5各自要用多少时长**，而不是走一步看一步。

### 7.2 预规划计算触发点：S5阶段调度条件达成的上升沿

```
持续比较（第四章S5）：(下缸预计排空时刻 − 当前时间) ≤ VD_T_Rolling ？
该条件由"不满足"变为"满足"的上升沿触发一次计算（非逐扫描周期重复触发，PLC用
比较指令+边沿检测指令实现，与"固定节点算一次"实现难度相同）：

可用时间 Available = 下缸预计排空时刻 − 当前时间（触发那一刻的值，理论上正常情况下
                     应约等于 VD_T_Rolling，因为条件刚好在这一刻达成）
所需时间 Needed = VD_T_Rolling（本轮S1-S3.5标称总时长）

正常情况下 Available ≈ Needed，Δ≈0，本轮无需纠偏，直接按标称参数执行——
纠偏机制真正派上用场的场景，主要是"S1完成后二次校正"（见7.3）阶段捕捉到的
实际执行偏差，而不是这一步的预规划计算本身。

若 Available ≥ Needed（含近似相等情况）：
  → VD_S2_Target = VD_PreMixTime，VD_RestTime_Target = VD_RestTime，
    VD_CycleExtend_Target = 0
  → 若上缸状态=空，立即启动新一轮S1

若 Available < Needed（例如上一轮转移收尾延后、导致这一刻上缸还不能立即开始S1，
                       使实际可用时间比理论值更紧张），缺口 Δ = Needed − Available，
按顺序分层扣减：

  第0层额度 = VD_RestTime − VD_RestTime_Min
    若 Δ ≤ 第0层额度：
      VD_RestTime_Target = VD_RestTime − Δ
      VD_S2_Target = VD_PreMixTime
      VD_CycleExtend_Target = 0 → 规划完成
    否则：
      VD_RestTime_Target = VD_RestTime_Min（第0层用满）
      Δ = Δ − 第0层额度，继续第1层

  第1层额度 = VD_PreMixTime − VD_PreMixTime_MinSafe
    若 Δ ≤ 第1层额度：
      VD_S2_Target = VD_PreMixTime − Δ
      VD_CycleExtend_Target = 0 → 规划完成
    否则：
      VD_S2_Target = VD_PreMixTime_MinSafe（第1层用满）
      Δ = Δ − 第1层额度，继续第2层

  第2层额度 = VD_CycleExtend_Max
    若 Δ ≤ 第2层额度：
      VD_CycleExtend_Target = Δ（即预计下缸排空后允许"空等" Δ 这么久，
                                 等新溶液经S1-S3.5配好、阀B转移完成，见第四章S6末尾）
      → 规划完成，同时触发"配液节奏滞后"提示报警（一般故障级，非漫溢级）
    否则：
      → 三层额度全部用尽仍不够，触发【人工介入】报警（见7.4），
        M_Alarm_ScheduleLag 置位，停止自动纠偏，本轮不再规划，等待人工处理

若上缸状态=空，规划完成后立即启动新一轮S1。
```

### 7.3 S1完成后二次校正（提高精度，主要纠偏场景）

S1的实际耗时存在波动（如水压变化），是本机制真正需要应对的主要不确定性来源。S1真正跑完、上缸状态置"满"的那一刻，用实测值S1_actual重新校正一次剩余的S2、S3.5目标：

```
S1完成时刻，重新计算：
  剩余可用时间 Available' = 下缸预计排空时刻 − 当前时间（此刻重新取值，已扣除S1实际耗时）
  剩余所需时间 Needed' = VD_S2_Target（7.2已定的目标） + S3计算值 + VD_RestTime_Target（7.2已定的目标）

  按7.2同样的三层分层算法，用 Available' 和 Needed' 重新算一次 Δ'，
  重新核定 VD_S2_Target、VD_RestTime_Target（VD_CycleExtend_Target若在7.2已经定过，
  此处只做微调，不重复触发滞后报警，除非二次校正后发现缺口进一步扩大到超出已定额度）

  → 这一步用S1的确定性实测值替换了预规划阶段基于估算的假设，消除了S1本身波动带来的误差，
    使S2/S3.5的压缩量更精确，避免"压缩过头"或"压缩不够"
```

### 7.4 人工介入报警（触发条件：7.2预规划阶段或7.3二次校正阶段，三层额度用尽仍无法覆盖缺口）

```
处理方式：
  → 停止自动纠偏，M_Alarm_ScheduleLag 置位（需人工确认复位）
  → HMI提示"配液节奏严重滞后，已超出自动纠偏范围，需人工检查"
  → 系统保持当前状态等待人工处理，不再擅自继续顺延或空等
```

### 7.5 T的计算原则（沿用v2，无变化）

VD_T_Rolling滚动更新时仍取**标称值**（S1实测 + VD_PreMixTime标称 + S3计算 + VD_RestTime标称），不使用纠偏后的压缩值——因为它代表"正常无干扰情况下的基准耗时"，供下一轮预规划时估算所需时间用。

---

## 八、报警分级与消音/消光逻辑（沿用v1，无实质变化，漫溢类报警来源已扩展至上下两缸对称保护）

### 8.1 报警分级

| 级别 | 触发条件示例 | 处理方式 |
|---|---|---|
| **漫溢风险级（强制人工确认）** | 液位计A/B高位报警、任一NC球阀动作 | 无论 M_AlarmAckMode 设成什么，始终强制人工确认才能复位 |
| **节奏滞后级（强制人工确认）【v2新增】** | 三层纠偏用尽仍无法追平节奏 | 停止自动纠偏，强制人工确认后才能继续 |
| **一般故障级（按模式处理）** | 阀B/C四态诊断异常、超时保护触发、流量开关瞬时异常 | 按 M_AlarmAckMode 设定：人工确认模式→需在HMI执行报警确认；自动恢复模式→条件消失后自动清除 |

### 8.2 消音 / 消光独立处理（v9.1更新：消音与报警确认分离）

```
消音：操作员按下就地面板"消音按钮"(I0.4)，或在HMI报警页执行对应单元/全局消音命令，
      仅将声音DO置OFF，灯光DO、报警锁存和状态机锁定保持原状态；
      消音仅对当前已知报警生效，新报警重新鸣响
报警确认/消光：操作员必须先在本地HMI查看具体报警详情，再对指定单元/指定报警执行确认。
      报警根本原因未消失时，确认只记录"已知晓"，不得清除报警锁存或解锁流程；
      报警根本原因消失后，HMI下发报警确认命令，PLC才允许灯光DO置OFF、清除锁存并解锁状态机。
```

> 【v9.1说明】报警确认按钮放在HMI上，是因为操作员必须先通过屏幕看到具体报警类型、所属单元和可能原因后才能确认。HMI报警确认必须明确对象，默认不设置"一键确认全部8套"；高优先级报警（漫溢、节奏滞后人工介入、安全继电器故障等）应弹出二次确认或采用长按确认，避免误清除。

### 8.3 报警日志

记录字段：**时间戳 + 单元编号 + 报警类型 + 动作（触发/消音/已知晓/复位）**，写入断电保持区或HMI历史报警记录区。不做登录系统时不记录操作人员身份；若后续HMI启用权限登录，可扩展记录操作员名称。

---

## 九、急停逻辑（硬件断电 + 软件感知复位 + 安全继电器反馈确认，v3更新）

### 9.1 接线原则：双触点分离，PLC监测回路与动力回路物理独立

急停按钮本身必须为**常闭型**触点（断线即安全：接线松脱或电缆断裂时效果等同于按下急停，系统自动进入安全停止状态，不会因故障而"检测不到急停"）。急停按钮至少需要两组独立常闭触点，分别用于两条完全独立的回路：

```
【第一组常闭触点】—— 安全回路，不经过PLC
  → 串入安全继电器（强制导向/force-guided型）的输入回路
  → 安全继电器线圈失电后，其主触点断开，切断潜水泵/注射泵/电动球阀的
    220V/380V动力电源（纯硬件动作，与PLC逻辑完全无关，PLC死机/程序卡死时仍生效）

【第二组常闭触点】—— PLC监测回路
  → 独立走PLC自身的24VDC电源，不接触220V
  → 接入 I1.1，供PLC感知"急停已被按下"，用于软件层面的状态机锁定与复位判断
```

两组触点物理独立、互不影响，即使PLC监测回路出现故障（断线、DI点损坏等），也不影响第一组触点直接切断动力电这一最基础的安全保障。

### 9.2 安全继电器反馈确认（新增，解决"动力回路是否真正切断"的确认问题）

普通接触器/继电器存在主触点因电弧烧蚀而粘连熔焊的风险——线圈已失电、控制回路已正确动作，但主触点可能仍卡死在闭合状态，动力电实际未断开，且PLC和操作员对此毫不知情。因此安全继电器必须选用**强制导向型（force-guided）**规格：其主触点（切动力电）与辅助反馈触点在机械结构上强制联动，主触点若粘连闭合，辅助反馈触点绝不可能同时显示"已断开"——这是判断动力回路是否真正切断的可靠依据。

```
安全继电器的强制导向辅助触点 → 独立接入PLC I1.2【v10.2纠正实际接线：I1.2=1 表示动力回路已接通；I1.2=0 表示动力回路已断开】

急停真正生效的判定条件（双重确认）：
  I1.1 = OFF（急停按钮已触发）
  AND I1.2 = 0（安全继电器辅助触点反馈动力回路已切实断开）
  → 才判定"急停真正生效"

若 I1.1 已触发（OFF），但延时一定时间后 I1.2 仍未反馈"已断开"：
  → 判定"安全继电器/接触器故障，主触点可能粘连（动力应断开但仍接通）"
  → 触发【继电器故障】最高优先级报警（见9.4），不允许任何自动恢复尝试，
    必须立即人工检修
```

> 建议选型时优先考虑符合 EN ISO 13849-1 / IEC 60204-1 标准、内置双通道冗余自检功能的安全继电器模块（如Pilz、Schmersal等品牌的对应产品），这类模块能周期性自检两路通道状态是否一致，进一步降低隐性故障风险。

### 9.3 急停触发与解除流程

```
急停触发：
  【硬件通道】安全继电器切断潜水泵、注射泵、电动球阀的动力回路（不经过PLC逻辑，物理层面立即生效）
  【软件通道】I1.1检测到OFF后：
    1. 强制所有阀门/泵内部输出线圈复位为OFF（M_EStop_Latch置位）
    2. 顶层状态机锁定，禁止任何自动状态切换
    3. 触发报警：灯光DO常亮（漫溢级处理）；声音DO按消音逻辑处理
    4. HMI显示"急停触发，等待释放急停按钮；释放后仍需按现场系统复位"
    5. 延时校验 I1.2 是否已变为 0（动力断开确认），I1.2 仍为 1 则升级为【继电器故障】最高级报警（见9.4）【v10.2 纠正】

急停解除【v9.1确认：急停释放不等于系统复位】：
  → I1.1恢复ON（触点重新闭合）后，状态机不自动恢复，M_EStop_Latch保持置位
  → 急停按钮旋转/拔起释放只代表硬件急停触点恢复，不清除PLC急停锁存，也不恢复自动流程
  → 操作员确认现场安全后，按下就地面板"系统复位按钮"(I0.3)
  → 复位后：上下缸状态强制置"空"，流程回到S0初始化重新开始
  → 不支持从中断点继续运行
```

### 9.4 继电器故障报警（新增，最高优先级）

```
触发条件：I1.1已确认急停触发（OFF），但超过设定延时后 I1.2 仍为 1（动力回路未断开）【v10.2 纠正】

处理方式：
  → 优先级高于漫溢风险级，不受 M_AlarmAckMode 影响，不允许任何形式的自动恢复
  → 状态机保持锁定，HMI持续提示"安全继电器/接触器故障，动力回路可能未真正切断，
    请立即人工检修，禁止在故障排除前尝试复位"
  → 该报警的确认/复位应设置为需要更高权限或更明确的二次确认操作（具体交互方式待后续
    HMI画面设计阶段细化），避免被误当作普通报警随手清除
```

---

## 十、换水周期与实验时长计时（时间戳方案）【v2：新增实验时长累加逻辑】

```
下缸状态由"空"变为"满"瞬间（阀B正常关闭完成后）：
  → 读取PLC当前RTC时间，写入 DT_TankB_FullTime（断电保持区）
  → 开始累加 VD_ExperimentDuration_Accum（仅在下缸="满"期间累加）

下缸状态由"满"变为"空"瞬间（阀C排空完成后）：
  → 停止累加，本轮满液时长已计入 VD_ExperimentDuration_Accum

实验停止判断（持续进行）：
  → VD_ExperimentDuration_Accum ≥ VD_ExperimentTarget（HMI设定）→ 转入S7实验结束

断电恢复：
  → DT_TankB_FullTime、VD_ExperimentDuration_Accum 均在断电保持区，
    前提是断电时长未超过CPU ST20超级电容保持能力（典型7天/最小6天）
  → 重新上电后用"当前RTC − DT_TankB_FullTime"重新算出已运行时长，累加值不受断电影响
  → 若断电时长超过6~7天导致RTC停走，FC0 在下次上电时检测到 RTC 自身非法（分>59、月>12等）
    或 RTC 早于 DT_TankB_FullTime，**置 V303.7=1（M_Need_RTC_Sync）请求 HMI 校时**，
    状态机保持 S0，不再直接进 S_ERROR【v10.2/AQEX-51 更新】
  → HMI（McgsPro）检测到 V303.7=1 后弹窗提示，操作员点击"同步"按钮，
    McgsPro 将本机时间（BCD 格式）写入 VB900~VB905，置 V0.6=1 触发 FC22 调用 TODW 写入 PLC RTC
  → 若 V303.7=1 持续 **5 分钟** 未同步，FC22 置 V303.5=1（M_Alarm_RTC_Lost）并将 VW2 置 99（S_ERROR），
    报警码 VW6=65【AQEX-51 新增】
```

---

### 10.2 RTC 时间同步机制（AQEX-51 新增，FC22_RTC_Sync）【v10.2 新增】

FC22 处理 HMI 校时请求与超时保护，每周期在 FC3（报警处理）之后、FC1（状态调度）之前由 OB1 调用：

`
OB1 调度顺序: FC0 → FC2 → FC4 → FC3 → FC22 → FC1 → FC20/FC21
`

**FC22 核心逻辑**：

1. 检测 V0.6（HMI 校时命令位）上升沿：
   - 将 VB906（星期）、VB907（保留）清零
   - 调用 TODW VB900 将 VB900~VB907（BCD 格式）写入 PLC RTC
   - 复位 V303.7 和 V0.6

2. 5 分钟超时保护：
   - 当 V303.7=1（请求校时）时，启动 T59（100ms 时基，PT=3000）
   - T59 计时到后，置 V303.5=1（M_Alarm_RTC_Lost），VW2=99（S_ERROR）

**涉及变量**：

| PLC 地址 | 名称 | 类型 | 说明 |
|---|---|---|---|
| V0.6 | CMD_RTC_Sync | 位 | HMI 校时命令位（上升沿触发） |
| V303.5 | M_Alarm_RTC_Lost | 位 | RTC 丢失报警（5 分钟超时后置位） |
| V303.7 | M_Need_RTC_Sync | 位 | 请求 HMI 校时标志 |
| VB900~VB905 | RTC_Year/Month/Day/Hour/Minute/Second | BYTE(BCD) | HMI 写入后 PLC TODW 的源缓冲区 |
| VB906 | RTC_Weekday | BYTE | 星期（不使用，固定清零） |
| VB907 | RTC_Reserved | BYTE | 保留 |
| T59 | 校时超时定时器 | 100ms TON | 5 分钟（3000×100ms） |

---

## 十·五、手动控制逻辑【v10新增】

手动控制用于现场调试、阀门/泵检修、管路吹扫等场景，**仅在 S0 初始化态可用**（由 OB1 条件调用，非 S0 态不响应，返回 S0 前自动清除全部手动锁存）。手动控制划分为两部分：**阀门/潜水泵手动控制（FC20）** 与 **注射泵手动控制（FC21）**。

### 10.5.1 手动命令位（V306.0~V307.3）【v9.4 重大修复】

手动命令位采用"上升沿触发 + PLC 清零握手"机制，区别于 V0 区系统命令位的置位握手，避免 HMI 侧残留 1 值导致重复触发。仅 VW2=0（S0）态响应。

**【v9.4历史背景】**：v1.0~v9.3将手动命令位分配在 V2.4~V3.7，**与 VW2 状态机当前状态物理地址完全重叠**（VB2+VB3 同址）。联机调试时发现 STEP 7 写入 V3.1=1 会改写 VW2=2=S2 预循环，导致两台循环泵同时启动；V3.2=1 会进入 S4 并报"阀B开到位超时"。v9.4 已全部迁移至 V306.0~V307.3（预留扩展区），FC20/FC21/OB1 同步更新。

| 地址 | 符号 | 说明 | 响应条件 |
|---|---|---|---|
| V306.0 | CMD_Manual_ValveA_Open | 手动开阀A | VW2=0 |
| V306.1 | CMD_Manual_ValveA_Close | 手动关阀A | VW2=0 |
| V306.2 | CMD_Manual_ValveB_Open | 手动开阀B | VW2=0 AND V1.6=1 AND V1.7=0 |
| V306.3 | CMD_Manual_ValveB_Close | 手动关阀B | VW2=0 |
| V306.4 | CMD_Manual_ValveC_Open | 手动开阀C | VW2=0 AND V1.7=1 |
| V306.5 | CMD_Manual_ValveC_Close | 手动关阀C | VW2=0 |
| V306.6 | CMD_Manual_Pump1_On | 手动启动潜水泵1 | VW2=0 |
| V306.7 | CMD_Manual_Pump1_Off | 手动停止潜水泵1 | VW2=0 |
| V307.0 | CMD_Manual_Pump2_On | 手动启动潜水泵2 | VW2=0 |
| V307.1 | CMD_Manual_Pump2_Off | 手动停止潜水泵2 | VW2=0 |
| V307.2 | CMD_Manual_SyringePump_Start | 手动注射泵启动 | VW2=0 |
| V307.3 | CMD_Manual_SyringePump_Stop | 手动注射泵停止/回零 | VW2=0 |

**互锁说明**：手动操作时安全联锁仍生效（如阀B开启需上缸=满且下缸=空，阀C开启需下缸=满），由 PLC 在响应逻辑中校验。

### 10.5.2 阀门/潜水泵手动控制（FC20）

FC20 使用中间存储 M13.0~M13.4 锁存手动输出状态，每周期映射到 Q 点，解决 S0 状态 FC 每周期清零 QB0 导致输出无法保持的问题。**仅 S0 态调用，非 S0 态由 OB1 清除 M13.0~M13.4**。

| 锁存位 | 输出映射 | 说明 |
|---|---|---|
| M13.0 | Q0.2 + Q0.5 | 手动开阀A，同时联动打开上缸NC阀 |
| M13.1 | Q0.3 + Q0.6 | 手动开阀B，同时联动打开下缸NC阀 |
| M13.2 | Q0.4 | 手动开阀C（不联动NC阀） |
| M13.3 | Q0.0 | 手动启动潜水泵1 |
| M13.4 | Q0.1 | 手动启动潜水泵2 |

**NC 电磁阀联动规则【同步DO映射】**：
- 手动开阀 A → Q0.5 跟随 Q0.2（上缸 NC 阀打开）
- 手动开阀 B → Q0.6 跟随 Q0.3（下缸 NC 阀打开）
- 手动开阀 C → **不打开任何 NC 阀**（排水不经 NC 阀）
- 关阀后 NC 阀自动关闭

### 10.5.3 注射泵手动控制（FC21）【v10新增】

注射泵手动控制允许客户在 S0 态通过 HMI 手动启停注射泵，按参数页设定的总加药量执行**单次**或**循环**吸液/排液。由 OB1 仅在 S0 态调用。

**参数与反馈变量：**

| 地址 | 符号 | 说明 |
|---|---|---|
| VD384 | VD_ManualDose_Target | 手动总加药量（µL，HMI 设定），循环模式下为累积目标 |
| VW388 | VW_ManualDose_Mode | 模式选择：0=单次模式，1=循环模式 |
| VW390 | VW_ManualDose_State | 手动子状态反馈 |
| VD392 | VD_ManualDose_Dosed | 手动本轮累计加药量（µL，内部） |
| VD396 | VD_ManualDose_Remaining | 手动剩余待加药量（µL，内部） |
| VD350 | VD_StepResolution | 单步分辨率（µL/步），用于按总加药量折算步数 |

**子状态定义（VW390）：**

| 值 | 状态 | 说明 |
|---|---|---|
| 0 | 空闲 | 等待启动命令 |
| 1 | 抽液中 | 已下发 40006 抽液步数，等待完成 |
| 2 | 排液中 | 已下发 40007 排液步数，等待完成 |
| 3 | 回零中 | 已下发 40003 复位命令，等待完成 |
| 4 | 完成 | 单次 / 循环已结束并回零 |
| 99 | 错误 | 注射泵通讯 / 状态异常 |

**动作流程：**

```
启动(V3.6 上升沿)
  ↓
初始化：VD_ManualDose_Dosed=0，VD_ManualDose_Remaining=VD_ManualDose_Target
  ↓
子状态1：折算本次步数 = min(VD_Remaining / VD_StepResolution, 6000)
          写 40006 = 本次步数
  ↓
子状态2：等待抽液完成（VW4 从忙变就绪）
  ↓
子状态3：写 40007 = 本次步数
  ↓
子状态4：等待排液完成，累加 VD_ManualDose_Dosed
  ↓
子状态5：判断
  ├─ 停止请求(V3.7)=1           → 子状态6回零
  ├─ 单次模式                   → 子状态6回零
  ├─ 循环模式且累计≥目标量        → 子状态6回零
  └─ 循环模式且累计<目标量        → 返回子状态1继续下一周期
  ↓
子状态6：写 40003 = 1（复位 / 回零）
  ↓
子状态7：等待回零完成，VW390=4，结束
```

**关键行为：**
- **停止按钮是"软停止"**：非急停，置位停止请求后当前吸/排液周期仍完成，随后回零结束。
- **运行中再次按启动无效**，防止重置当前周期。
- **通讯异常兜底**：注射泵通讯失败（V303.4）或状态码错误（VW4≥4）时立即停止并置 VW390=99。
- **与自动 S3 隔离**：手动模式使用独立累计/剩余变量（VD392/VD396），不影响自动 S3 加药的 VD584/VD372/VD378。总加药量（VD384）仅供手动模式，**不用于 S3**，S3 目标量仍由工艺计算写入 VD584。

### 10.5.4 手动控制与自动工艺隔离

- 手动控制仅在 S0 态有效；进入 S1~S7、S_ERROR 时，OB1 清除全部手动锁存（M13.0~M13.4）与注射泵手动状态，确保返回 S0 前不残留手动输出。
- 急停、漫溢报警时，手动输出与自动输出一并强制失效，NC 阀按安全逻辑关闭。

---

## 十一、待确认/待补充事项

1. **注射泵单步分辨率（VD_StepResolution）**：已按实际选配的25ml进样器核实（参考SY-03BM说明书：25ml进样器标准6000步模式下约4.1667µL/步），不同进样器容量分辨率不同
2. **流量计"计量值"寄存器(0x0009)是否支持清零**：建议向厂商二次确认；若确认不支持，第四章S1"差值法"判断逻辑维持不变
3. **流量计实际配置单位**：需确认现场设备0x0012寄存器实际配置值（默认按"升(L)"=0x03假设）
4. **流量计"计量值"寄存器长期运行溢出行为**（回绕/停止/报错）：待厂商确认或现场观察

以下事项已解决：
- ~~温度计、pH计接口文档~~ → 【v9.2】客户决定取消温度计、pH计，不再配置该两个Modbus从站，相关接口文档不再需要
- ~~5个流量开关、液位计A/B高低位信号类型~~ → 已确认无源触点，直接接DI
- ~~电动球阀A/B/C限位反馈~~ → 已确认为有源正极输出，需经继电器转换后接DI（见第二章2.1、第六章）
- ~~下缸是否需要额外进水失效保护阀~~ → 已确认无需
- ~~8套缸整体架构：单PLC集中控制 or 多PLC独立控制~~ → 已确认为"每套缸1台独立PLC，互不依赖"（见第十二章）
- ~~就地人机界面形式~~ → 已确认采用现场1台本地集中触摸屏HMI管理8套单元；报警确认放在HMI报警详情页，急停和急停后的系统复位保留为每套单元物理按钮（见第十二章）
- ~~急停/报警是否集中联动~~ → 已确认不做跨单元联动，各套缸急停/报警完全独立

---

## 十二、多机联网与本地集中HMI架构【v9新增/v9.1更新】

### 12.1 总体拓扑

```
                        ┌─────────────────────────┐
                        │   现场本地集中触摸屏 HMI   │
                        │ （10~15寸，建议12寸以上）  │
                        └───────────┬─────────────┘
                                    │ 工业以太网交换机
        ┌───────────┬───────────┬──┴────────┬───────────┬───────────┐
      PLC#1        PLC#2       PLC#3   ...  PLC#6       PLC#7       PLC#8
    （1号缸单元） （2号缸单元）（3号缸单元）      （6号缸单元） （7号缸单元） （8号缸单元）
```

每套缸单元的PLC通过CPU本体自带的以太网口接入交换机，与现场本地集中HMI组成同一以太网网段。HMI只做人机界面、参数设定、报警详情显示和确认，不承担实时控制逻辑；每套PLC内部仍完整保存本单元的状态机、报警锁存、急停处理、断电恢复、485设备轮询和泵阀控制逻辑。

每套单元自身的485总线（挂接注射泵/流量计2个从站【v9.2更新：原4个从站中的温度计、pH计已取消】）保持独立，不与其他单元共享，也不经过以太网转发。HMI或交换机故障时，PLC应继续按本地程序运行；需要人工操作的报警确认、参数修改等功能在HMI恢复前不可用，但不得影响急停硬件回路和PLC内部安全联锁。

### 12.2 IP地址规划（示例，需现场网络环境确认后定型）

| 设备 | IP地址（示例网段） | 说明 |
|---|---|---|
| PLC#1 ~ PLC#8 | 192.168.2.101 ~ 192.168.2.108 | 各PLC固定IP，与单元编号一一对应，便于故障定位 |
| 本地集中HMI | 192.168.2.10 | 固定IP |
| 工业以太网交换机 | 192.168.2.1（管理IP，若为网管型） | 8套缸同处一个实验室、彼此距离不远，1台9口及以上交换机即可满足组网需求，非网管型即可，无需分级级联 |

### 12.3 通讯协议与HMI选型

```
PLC↔HMI通讯协议：S7-200 SMART CPU本体以太网口支持S7通信协议、Modbus TCP（作为服务器）等；
                  具体采用哪种协议需与HMI品牌驱动支持情况匹配，待HMI选型阶段确认。

HMI选型建议：优先选用支持S7-200 SMART以太网通讯、支持多PLC站点连接、组态软件免费或随屏提供的
              工业触摸屏（如昆仑通态MCGS触摸屏、威纶通、步科、显控等同类产品）。
              屏幕尺寸建议不小于10寸，推荐12寸或以上，以便同时显示8套单元总览和报警摘要。
              需向厂家确认：是否支持同时连接8台S7-200 SMART PLC、变量点数、报警记录容量、
              历史趋势/数据记录能力、断电保存能力、工程软件下载授权方式。
```

### 12.4 就地物理操作与HMI操作分工

| 操作类型 | 执行位置 | 说明 |
|---|---|---|
| 急停 | 就地（各单元物理急停按钮） | 硬件安全回路，见第九章，不经过网络 |
| 急停后的系统复位 | 就地（各单元物理系统复位按钮，I0.3） | 急停旋转释放不等于系统复位；操作员确认现场安全后按本按钮，PLC回到S0初始化，见第九章9.3 |
| 消音 | 就地物理按钮I0.4，或HMI消音命令 | 只关闭声音，不清除报警、不解锁流程；可按单元消音，也可设置全局消音 |
| 报警详情查看、报警确认/消光 | 本地集中HMI | 操作员先查看具体报警内容、所属单元和可能原因，再对指定单元/指定报警确认；高优先级报警需二次确认或长按确认 |
| 参数设定（VD_xxx系列）、状态强制修正、历史数据查看、8套单元运行总览 | 本地集中HMI | 集中管理，便于统一维护和现场操作 |
| 手动控制（仅S0态） | 本地集中HMI | 阀门/潜水泵手动启停（FC20，V2.4~V3.5）与注射泵手动启动/停止/回零（FC21，V3.6/V3.7） |

### 12.5 单机故障隔离原则

任一PLC故障、断网、或程序下装调试期间，仅影响其对应的1套缸单元；其余7套单元的实验运行不受影响。HMI对该单元仅表现为"通讯中断"提示，不触发其余单元的任何联动动作。

HMI故障、重启或断网时，8套PLC不得依赖HMI继续执行实时控制；正在运行的自动流程应按PLC内部逻辑继续或按故障策略进入安全状态。急停和急停后的系统复位均为就地物理回路/按钮，不依赖HMI；报警确认、参数修改、状态强制修正等HMI操作在HMI恢复前暂停。

### 12.6 待确认事项

1. **控制柜布置方案**：8套独立小柜（就近安装于各缸边）或1个大柜内部隔8个分区，需现场勘察玻璃缸实际摆放布局后确定
2. **HMI品牌与型号**：需确认其S7-200 SMART以太网驱动兼容性、8站点同时通讯能力、变量点数、报警/历史记录容量、组态软件授权方式
3. **HMI画面结构与变量表**：需后续细化总览页、单元详情页、报警页、参数页、手动调试页、历史记录页，以及PLC↔HMI变量地址表
4. ~~交换机口数与现场布线距离~~ → 已确认8套缸同处一个实验室、彼此距离不远，1台9口及以上非网管以太网交换机即可满足8台PLC+1台本地HMI的组网需求，无需分级级联或光纤转换

### 12.7 分期接入与HMI动态显隐【v9.3新增】

客户决定首期先实施1套单元验证效果，后续按需扩展至8套。本节说明分期接入对PLC侧的影响及与HMI侧动态显隐的配合。

**PLC程序侧（无需修改）**：
8套单元的PLC程序完全相同（本设计核心原则，见第一章"多单元架构原则"），每台PLC独立运行、不依赖其他PLC或HMI。PLC程序本身不需要知道自己"是否被HMI使能"——使能是HMI侧的管理概念，用于控制HMI画面显示哪些单元，不影响PLC内部状态机、安全联锁、485轮询等任何逻辑。

**首期实施（1套）**：
- 仅1号缸单元的PLC上电运行，2~8号缸单元的PLC不上电
- 1号PLC程序完整执行S0~S7流程，与全量8套时完全一致
- HMI工程按8套架构开发，但运行时仅1号单元使能并显示，2~8号灰显"未接入"（HMI侧机制，详见HMI画面架构规划文档第九章）

**后续扩展**：
- 新增单元的PLC上电、接入以太网交换机、配置IP（192.168.2.10X）
- PLC程序无需重新下装或修改，8套PLC程序完全相同
- 在HMI画面8系统设置页勾选新单元使能开关，该单元在HMI总览页自动转为正常显示
- 扩展过程不影响已运行单元，符合"任一单元故障、停机、程序下装/调试均不影响其余单元"的架构原则

**HMI动态显隐机制概述**（详见《HMI画面架构规划文档》第九章）：
- HMI通过"单元使能（HMI内部位变量，断电保持）+ PLC通讯在线（HMI驱动自动检测）"双条件判定每个单元的显示状态
- 三态显示：已使能+在线→彩色正常；已使能+离线→黄色"通讯中断"占位；未使能→灰色"未接入"占位
- 8个单元卡片位置固定，不随接入数量重新排列，便于操作员形成固定位置记忆
- 单元使能变量存储在HMI断电保持区，不写入PLC

**对BOM的影响**：
PLC、缸体设备等按套采购的条目天然支持分期（首期1套、后续按需增加）；交换机、HMI等公共设备需按全量8套规划容量，避免扩展时更换硬件。详见BOM清单分期标注。

---

*本文档为双方讨论确认的正式记录，作为后续PLC程序实施与本地HMI画面开发的依据。*
