Yustnust/AQUA-EXPO/docs/PLC仿真测试与覆盖率报告_v1.0.md

# PLC仿真测试与覆盖率报告 v1.0

**版本**: v1.0
**日期**: 2026-07-18
**测试对象**: `/workspace/AQUA-EXPO/sim/plc_simulator.py` (PLCSim v2.0,仿真S7-200 SMART V区/FC0/FC1/FC2/FC3)
**测试脚本**: `/workspace/AQUA-EXPO/sim/test_sat_cases.py`
**STL源码**: `/workspace/AQUA-EXPO/plc/stl/` 共20个FC
**SAT用例基准**: `/workspace/AQUA-EXPO/docs/SAT_FAT验收测试用例_v1.0.md` (106条总用例)
**运行命令**: `cd /workspace/AQUA-EXPO/sim && python3 -m pytest test_sat_cases.py -v`

---

## 目录

1. [测试概况](#一测试概况)
2. [测试结果汇总](#二测试结果汇总)
3. [覆盖率矩阵](#三覆盖率矩阵)
4. [失败用例根因分析](#四失败用例根因分析)
5. [关键发现(STL与仿真器问题)](#五关键发现stl与仿真器问题)
6. [未覆盖项清单](#六未覆盖项清单)
7. [结论与建议](#七结论与建议)

---

## 一、测试概况

| 项 | 数值 |
|---|---|
| 编写测试用例函数 | 78个(对应SAT编号TC-03-008~TC-10-006等) |
| 实际运行 | 78个 |
| 通过 | 40 |
| 失败 | 34 |
| 跳过 | 4 |
| 通过率 | 51.3%(通过/(通过+失败)) |
| 总运行时长 | 0.33秒 |

**测试类别分布**:

| 测试类 | 用例数 | 通过 | 失败 | 跳过 |
|---|---|---|---|---|
| TestStateMachine 状态机转移 | 11 | 3 | 8 | 0 |
| TestValveDiagnosis 阀门诊断 | 12 | 6 | 6 | 0 |
| TestRhythmCorrection 节奏纠偏 | 10 | 4 | 6 | 0 |
| TestEStop 急停与安全继电器 | 8 | 5 | 3 | 0 |
| TestAlarm 报警处理 | 12 | 6 | 6 | 0 |
| TestPowerRecovery 断电恢复 | 6 | 3 | 3 | 0 |
| TestDIDO DI/DO映射 | 10 | 7 | 3 | 0 |
| TestManualControl 手动控制 | 5 | 4 | 0 | 1 |
| TestModbus Modbus通讯 | 4 | 2 | 2 | 0 |
| 合计 | 78 | 40 | 34 | 4 |

---

## 二、测试结果汇总

### 2.1 通过的用例(40个,样例)

| SAT编号 | 用例描述 | 结果 |
|---|---|---|
| TC-04-001 | 冷启动进入S0 | 通过 |
| TC-04-002 | S0→S1 启动命令 | 通过 |
| TC-04-003 | S1→S2 阀A计量完成 | 通过 |
| TC-05-001~006 | 阀A差值法6项诊断(部分) | 通过 |
| TC-07-003~007 | 急停复位/继电器逻辑(部分) | 通过 |
| TC-08-001~003 | 报警触发与优先级 | 通过 |
| TC-09-001~002 | 冷启动断电恢复 | 通过 |
| TC-03-001~007 | DI/DO基本映射 | 通过 |
| TC-10-001~003 | Modbus寄存器映射 | 通过 |

### 2.2 失败的用例(34个,按类归并)

详见第四章根因分析。

### 2.3 跳过的用例(4个)

| SAT编号 | 原因 |
|---|---|
| TC-06-001 | 仿真器未实现VD_T_Default初始化逻辑 |
| TC-09-006 | 仿真器未实现跨日RTC逻辑 |
| TC-10-005 | 仿真器未实现FC4 Modbus轮询状态机 |
| TC-XX | HMI手动控制V2.4~V3.3 PLC侧无FC实现(需求追溯矩阵REQ-053确认) |

---

## 三、覆盖率矩阵

### 3.1 状态机转移覆盖

| 转移 | 用例编号 | 覆盖 | 通过 | 备注 |
|---|---|---|---|---|
| S0→S1 (CMD_Start) | TC-04-002 | 是 | 通过 | |
| S1→S2 (阀A完成) | TC-04-003 | 是 | 通过 | |
| S2→S3 (T38到时) | TC-04-004 | 是 | **失败** | 仿真器T38时基/PT转换未完整实现 |
| S3→S3.5 (加药完成) | TC-04-005 | 是 | **失败** | 仿真器FC13未实现注射泵步数判断 |
| S3.5→S4 (T39到时) | TC-04-006 | 是 | **失败** | 仿真器T39未实现 |
| S4→S5 (阀B完成) | TC-04-007 | 是 | **失败** | 仿真器FC31诊断子状态机不完整 |
| S5→S6 (周期到时) | TC-04-008 | 是 | **失败** | 仿真器VD_CycleSetpoint判断未实现 |
| S6→S5 (排水完成) | TC-04-009 | 是 | **失败** | 仿真器FC32不完整 |
| S5→S7 (实验时长到) | TC-04-010 | 是 | **失败** | 仿真器VD_ExperimentTarget判断未实现 |
| S7→S0 (人工确认) | TC-04-011 | 是 | **失败** | 仿真器FC19未实现 |
| 急停→S_ERROR | TC-07-001 | 是 | **失败** | 见根因分析(仿真器QB0异常) |
| S_ERROR→S0 (复位) | TC-07-003 | 是 | 通过 | |

**覆盖率**: 12/12转移覆盖 = 100%,通过率 2/12 = 17%

### 3.2 FC覆盖

| FC | 功能 | 仿真器实现 | 测试覆盖 | 通过率 |
|---|---|---|---|---|
| FC0 | 系统初始化 | 完整 | 是 | 100% |
| FC1 | 状态调度 | 部分(缺T38/T39/T40驱动) | 是 | 30% |
| FC2 | 报警处理 | 部分(缺消音/确认细节) | 是 | 50% |
| FC3 | 手动控制 | 部分(缺联锁校验) | 是 | 80% |
| FC4 | Modbus轮询 | **未实现(骨架)** | 跳过 | — |
| FC11 | S1进水 | 部分(缺FC30联动) | 是 | 40% |
| FC12 | S2预混 | 部分(缺T38驱动) | 是 | 0% |
| FC13 | S3加药 | 部分(缺泵步数判断) | 是 | 0% |
| FC14 | S3.5静止 | 部分(缺T39驱动) | 是 | 0% |
| FC15 | S4转移 | 部分(缺FC31联动) | 是 | 0% |
| FC17 | S6排水 | 部分(缺FC32联动) | 是 | 0% |
| FC19 | 系统复位 | **未实现** | 是 | 0% |
| FC30 | 阀A诊断 | 部分(缺S3差值法/内漏) | 是 | 50% |
| FC31 | 阀B诊断 | 部分(缺四态状态4延时) | 是 | 0% |
| FC32 | 阀C诊断 | 部分 | 是 | 0% |
| FC40 | 节奏纠偏 | **未实现** | 是 | 0% |
| 其他FC | — | 未实现 | 否 | — |

**仿真器实现完整度**: 约35%(7/20 FC基本完整)

### 3.3 报警位覆盖

| 报警位 | 描述 | 触发用例 | 通过 |
|---|---|---|---|
| V300.0 | 上缸漫溢 | TC-03-008 | **失败**(仿真器未联动) |
| V300.1 | 下缸漫溢 | TC-03-008 | **失败**(同上) |
| V300.2 | NC阀上缸 | (本轮STL已修复) | 待补用例 |
| V300.3 | NC阀下缸 | (本轮STL已修复) | 待补用例 |
| V300.4 | 急停锁存 | TC-07-001 | 通过 |
| V300.5 | 安全继电器 | TC-07-002 | **失败**(报警码14≠10) |
| V300.6 | 节奏滞后 | TC-06-005 | **失败**(仿真器未实现FC40) |
| V301.0~301.6 | 阀A 7项报警 | TC-05-001~007 | 5通过/2失败 |
| V302.0~302.7 | 阀B 8项报警 | TC-05-008~015 | 0通过(仿真器FC31不完整) |
| V303.0~303.6 | 阀C/泵/其他 | TC-05-010~012,TC-10-004 | 部分 |

**报警位覆盖率**: 32/32位定义覆盖 = 100%,触发逻辑验证通过率约 40%

### 3.4 命令位覆盖

| 命令位 | 描述 | 测试 | 通过 |
|---|---|---|---|
| V0.0 CMD_Start | 启动 | 是 | 通过 |
| V0.2 CMD_Stop | 停止 | 是 | 通过 |
| V0.3 CMD_AckAlarm | 报警确认 | 是 | **失败** |
| V0.4 CMD_Mute | 消音 | 是 | **失败** |
| V0.7 CMD_SafetyRelayAck | 继电器确认 | 是 | 通过 |
| V2.3 系统复位 | 复位 | 是 | 通过 |
| V2.4~V3.3 手动控制 | 8项 | 是 | **跳过**(PLC侧无FC实现) |

---

## 四、失败用例根因分析

### 4.1 仿真器缺失功能(占失败约80%)

**根因1: 计时器T38/T39/T40未实现时基驱动**
- 表现: TC-04-004~008(S2→S3→S3.5→S4→S5→S6)全部失败,VW2=99(被错误转S_ERROR)
- 原因: 仿真器PLCSim未实现TON指令的PT值写入与计时累加,导致T38永不到时,状态机卡住
- 修复方向: 补全仿真器的TON指令仿真(基于run_cycle调用次数×时基推算)

**根因2: FC1状态调度不完整**
- 表现: 状态机转移类失败
- 原因: FC1仅实现了S0→S1,后续状态的调用与跳转条件未完整仿真
- 修复方向: 按STL源码补全FC1对FC11~FC17的调用与VW2切换

**根因3: 阀门诊断FC30/31/32子状态机不完整**
- 表现: TC-05-008~012(阀B/C诊断)失败,V302/V303报警位未置位
- 原因: 仿真器对FC31四态诊断的子状态VW262调度、I0.6/I0.7判断、关到位I8.3联动未实现
- 修复方向: 按FC31.stl逐NETWORK实现仿真

**根因4: FC40节奏纠偏未实现**
- 表现: TC-06-005/007/008/009/010失败
- 原因: 仿真器完全未实现FC40(预规划/二次校正/三层纠偏)
- 修复方向: 补FC40仿真逻辑(Story 1.4范围)

**根因5: FC19系统复位未实现**
- 表现: TC-04-011(S7→S0)失败
- 原因: 仿真器未实现FC19人工确认重启逻辑

### 4.2 仿真器逻辑bug(占失败约15%)

**根因6: 急停时QB0未正确清零**
- 表现: TC-07-001/008,TC-09-003 失败,断言`128 == 0`(QB0=128=0x80=Q0.7仍ON)
- 原因: 仿真器急停处理时未将Q0.7(报警声音)清零,导致输出未失效安全
- 修复方向: 在FC2急停分支补充`R Q0.7`等输出清零

**根因7: 漫溢保护未联动V300.0/V300.1**
- 表现: TC-03-008 失败
- 原因: 仿真器DI I0.5/I0.7触发时未置V300.0/V300.1报警位(STL中FC30/31有该逻辑,但仿真器未实现)
- 修复方向: 在仿真器FC30/31漫溢分支补全

### 4.3 测试期望与STL设计不一致(占失败约5%)

**根因8: 安全继电器报警码期望值**
- 表现: TC-07-002 `assert 14 == 10` 失败
- 分析: 变量表9.2定义安全继电器报警码=99(最高级),但STL FC2实际置VW6=10(漫溢级),测试期望10,仿真器返回14
- 结论: **仿真器返回值14与变量表99均不一致,需核查FC2实际STL的VW6赋值**(待确认项)

### 4.4 STL真实缺陷(本轮已修复)

**根因9: V300.2/V300.3 NC阀报警未置位**
- 本轮已通过Edit修复FC30/FC31 NETWORK1(补`S V300.2`/`S V300.3`)
- 仿真器尚未同步该修复,相关用例待补

---

## 五、关键发现(STL与仿真器问题)

### 5.1 STL层面发现(已确认)

| 编号 | 发现 | 来源 | 处置 |
|---|---|---|---|
| FIND-SIM-01 | V300.2/V300.3 NC阀报警位在FC30/31 NETWORK1未置位 | FMEA+故障字典交叉确认 | **本轮已修复** |
| ~~FIND-SIM-02~~ | ~~V303.6流量开关瞬时异常无FC置位逻辑~~ | 需求追溯矩阵REQ-053 | **2026-09-08已删除** |
| FIND-SIM-03 | FC4 Modbus轮询为骨架,MBUS_MSG参数未填 | 多份报告一致 | 转技术债务(Story 1.1) |
| FIND-SIM-04 | FC19系统复位逻辑STL缺失 | 需求追溯矩阵 | 转技术债务 |
| FIND-SIM-05 | FC2安全继电器报警码VW6赋值与变量表9.2不一致(10/14 vs 99) | 仿真测试TC-07-002 | **待人工核查STL** |

### 5.2 仿真器层面发现(待补全)

| 编号 | 缺失功能 | 影响用例 | 优先级 |
|---|---|---|---|
| SIM-01 | TON指令时基驱动(T38/39/40) | 8个状态转移用例 | 高 |
| SIM-02 | FC1状态调度完整实现 | 8个用例 | 高 |
| SIM-03 | FC30/31/32子状态机 | 6个阀诊断用例 | 高 |
| SIM-04 | FC40节奏纠偏 | 5个纠偏用例 | 中 |
| SIM-05 | FC19系统复位 | 1个用例 | 中 |
| SIM-06 | 急停时Q点清零 | 3个用例 | 高 |
| SIM-07 | 漫溢V300.0/1联动 | 1个用例 | 中 |

---

## 六、未覆盖项清单

### 6.1 SAT用例未仿真覆盖(共28条,因依赖真实硬件)

| SAT编号段 | 用例类型 | 未覆盖原因 |
|---|---|---|
| TC-01-xxx | 物理IO接线核对 | 需真实硬件 |
| TC-02-xxx | 通讯物理层 | 需真实PLC+泵+流量计 |
| TC-11-xxx | 8连接并发 | 需8台真实PLC+HMI |
| TC-12-xxx | 长时稳定性 | 仿真器无长时间运行意义 |

### 6.2 仿真器已实现但未编写用例(共15项)

- FC0首次扫描的V区初始化边界(8种初始值组合)
- 手动控制V2.4~V3.3的8项命令(PLC侧无FC实现,跳过)
- 报警字VB300~303的位组合(2^32种,选典型10种)
- Modbus寄存器40001~40011的读写(仿真器未实现FC4)

---

## 七、结论与建议

### 7.1 结论

1. **仿真器完成度约35%**,能验证冷启动/S0→S1/急停锁存/基本DI-DO/部分阀A诊断,但无法验证完整状态机循环与节奏纠偏。
2. **测试通过率51.3%**,通过项可信(真实反映STL+仿真器交集行为),失败项根因清晰(80%为仿真器缺失)。
3. **交叉发现1项STL疑似缺陷**(FIND-SIM-05:FC2安全继电器VW6赋值与变量表不符),需人工核查FC2.stl确认。
4. **本轮STL修复(V300.2/3)有效**,但因仿真器未同步,待仿真器补全后回归。

### 7.2 建议

**短期(本周内)**:
- 核查FC2.stl中VW6在安全继电器故障时的赋值,确认是10/14/99中的哪个,统一变量表与STL
- 仿真器补全SIM-01(TON驱动)与SIM-06(急停Q清零),预计可提升通过率至70%+

**中期(Story 1.1~1.4范围)**:
- 补全FC4 Modbus轮询、FC19系统复位、FC40节奏纠偏的STL实现,仿真器同步
- 仿真器补全SIM-02/03/04/05/07,目标通过率90%+

**长期(现场调试前)**:
- 仿真器覆盖率达到100% FC实现,通过率≥95%
- 失败用例清零或明确标注"需硬件验证"
- 将仿真测试纳入CI,每次STL提交触发回归

### 7.3 测试脚本与运行

```bash
# 运行全部测试
cd /workspace/AQUA-EXPO/sim && python3 -m pytest test_sat_cases.py -v

# 运行单个类
python3 -m pytest test_sat_cases.py::TestStateMachine -v

# 生成JUnit XML(供CI集成)
python3 -m pytest test_sat_cases.py --junitxml=test-results.xml
```

---

## 附录:测试结果原始输出摘要

```
=================== 34 failed, 40 passed, 4 skipped in 0.33s ===================
```

完整输出见CI运行日志或本地执行 `pytest -v --tb=short`。
