Yustnust/AQUA-EXPO/docs/版本发布说明_v1.0.md

# 药液配置加注控制系统 — PLC代码版本发布说明 v1.2

**项目**: AQUA-EXPO 药液配置与加注控制系统(8套缸单元,8台S7-200 SMART CPU ST20 + 1台HMI集中监控)
**发布版本**: v1.2.0(PLC代码补丁版本,基于 v1.1.0)
**发布日期**: 2026-07-18
**代码Commit**: 48426d5
**发布类型**: 里程碑发布(Story 1.2~1.7六轮迭代交付)
**版本号存储位置**: VW0(BCD编码,FC0 NETWORK0首次扫描写入)— 见第6节部署说明
**配套文档**: PLC代码完整性校验报告v1.0、PLC代码静态分析报告v1.0、HMI-PLC变量地址表v1.0、PLC程序版本管理规范v1.0、变更管理流程v1.0

---

## 第1节 版本概述

### 1.1 发布背景

本版本为AQUA-EXPO药液配置加注控制系统PLC代码的**首个里程碑版本(v1.0.0)**,完成Story 1.2~1.7六轮迭代的全部STL代码开发,涵盖状态机骨架、阀门诊断、节奏纠偏、急停、报警、断电恢复六大功能模块。代码经2轮完整性校验+静态分析,8个严重VD编址冲突已修复5个,2轮校验发现的10个问题(P1~P7 + A1~A3)全部修复。

### 1.2 版本性质

| 项 | 说明 |
|---|---|
| 版本类型 | 里程碑发布(X=1,Y=0,Z=0) |
| 适用范围 | 8台S7-200 SMART CPU ST20(程序完全相同,仅IP不同:192.168.2.101~108) |
| 成熟度 | **预发布候选版**:代码逻辑完整,但含3项已知严重VD编址冲突与若干P0/P1级STL缺陷待修复(见第3节),不建议直接用于生产环境;适用于内部联调与首期1套调试 |
| 下一里程碑 | release-1.1:修复3个VD编址冲突+手动控制FC+参数范围校验(计划2026-08-30) |

### 1.3 版本号编码

| 字段 | 值 | 说明 |
|---|---|---|
| 主版本(X) | 1 | 首个里程碑 |
| 次版本(Y) | 0 | Story 1.2~1.7基线 |
| 修订版本(Z) | 0 | 首次发布 |

**VW0 BCD编码值**: `16#0100`(主=01,次=00,修订=00)

> 注意:TD029(FC0 NETWORK0 VW0版本号写入)为已知技术债务,本版本发布前需完成VW0赋值实现,否则HMI无法显示版本号。若发布时TD029未偿还,本字段降级为"未写入"并在第3节已知问题中标注。

### 1.4 发布摘要

本版本交付20个FC的STL源代码(OB1 + FC0~FC4 + FC10~FC19 + FC30~FC32 + FC40),实现S0~S7+S_ERROR状态机、阀A/B/C四态诊断、三层节奏纠偏、急停双通道处理、32位报警优先级链、断电恢复双路径等核心功能。经2轮校验修复10个问题(含2个严重:VW270跨FC冲突、FC32 MOVB误用),静态分析识别225个问题(3严重/59警告/163提示)。本版本含3项已知严重VD编址冲突(待release-1.1修复)及4项已知STL缺陷(V300.2/V300.3/V303.6/FC4超时),详细见第3节。

---

## 第2节 功能清单

### 2.1 已实现功能(20个FC)

| # | FC文件 | Story | 功能描述 | 实现状态 |
|---|---|---|---|---|
| 1 | OB1_MAIN.stl | 1.2 | 主程序,调度FC0(SM0.1)/FC2/FC4/FC3/FC1(SM0.0) | ✅完成(校验5项全通过) |
| 2 | FC0_SysInit.stl | 1.2+1.7 | 系统初始化(冷启动/断电恢复双路径)+RTC检测+版本号登记 | ✅完成(VW0赋值待实现,见TD029) |
| 3 | FC1_StateDispatcher.stl | 1.2 | 状态机调度器(S0~S7+S_ERROR按VW2分发) | ✅完成 |
| 4 | FC2_EStopHandling.stl | 1.5 | 急停处理(I1.1下降沿锁存V300.4+安全继电器T35延时校验V300.5) | ✅完成 |
| 5 | FC3_AlarmHandling.stl | 1.6 | 报警处理(优先级链+消音消光V200.0+VW6编码) | ✅完成(引用数182/写入83,最大FC) |
| 6 | FC4_ModbusPolling.stl | 1.2 | Modbus轮询(注射泵VW4+流量计VD86) | ⚠️骨架(超时未实现,见TD003) |
| 7 | FC10_State_S0_Init.stl | 1.2 | S0初始化态(启动命令V0.0+VW6=0校验) | ✅完成 |
| 8 | FC11_State_S1_Inlet.stl | 1.2 | S1上缸进水(差值法VD86-VD82≥VD18目标) | ✅完成 |
| 9 | FC12_State_S2_PreMix.stl | 1.2 | S2预循环(T38计时VW252+T44/T45泵启动) | ✅完成(A1修复VW252) |
| 10 | FC13_State_S3_Dosing.stl | 1.2 | S3加药(步数控制VD_Dose_Steps→VW204/206) | ⚠️完成(步数精度未校验,见TD012) |
| 11 | FC14_State_S35_Rest.stl | 1.2 | S3.5静止等候(T39计时VW254) | ✅完成(A2修复VW254) |
| 12 | FC15_State_S4_Transfer.stl | 1.2 | S4上→下转移(阀B+液位校验V1.7) | ✅完成 |
| 13 | FC16_State_S5_Run.stl | 1.2 | S5实验运行(换水周期VD20+VD_S5_Elapsed累计) | ✅完成(A3修复T44/T45 PT) |
| 14 | FC17_State_S6_Drain.stl | 1.2 | S6下缸排水(阀C+液位B低位) | ✅完成 |
| 15 | FC18_State_S7_End.stl | 1.2 | S7实验结束(VW8轮次+数据归档) | ✅完成 |
| 16 | FC19_State_Error.stl | 1.5 | S_ERROR故障态(急停锁存清除V0.7+I1.2双确认) | ✅完成(P1注释残留V0.5,见TD021) |
| 17 | FC30_ValveA_Diag.stl | 1.3 | 阀A诊断(四态+差值法+限位交叉+漫溢V300.0+NC球阀Q0.5) | ⚠️完成(NC球阀报警V300.2未置位,见TD001) |
| 18 | FC31_ValveB_Diag.stl | 1.3 | 阀B诊断(四态+漫溢V300.1+NC球阀Q0.6) | ⚠️完成(NC球阀报警V300.3未置位+四态缺延时,见TD001/TD006) |
| 19 | FC32_ValveC_Diag.stl | 1.3 | 阀C诊断(四态+内漏V303.1) | ⚠️完成(四态缺延时,P5 MOVB误用已修复,见TD006) |
| 20 | FC40_RhythmCorrection.stl | 1.4 | 节奏纠偏(三层:静止压缩/S2压缩/周期顺延VD150) | ✅完成 |

### 2.2 功能模块交付状态

| 模块 | Story | 交付状态 | 校验结论 |
|---|---|---|---|
| 状态机骨架 | 1.2 | ✅完成 | OB1调度5项全通过,S0~S7+S_ERROR转移完整 |
| 阀门诊断 | 1.3 | ⚠️基本完成 | 四态诊断+漫溢保护完成;NC球阀报警位+延时确认待修复 |
| 节奏纠偏 | 1.4 | ✅完成 | 三层纠偏逻辑实现,VD150预规划 |
| 急停处理 | 1.5 | ✅完成 | 双通道+安全继电器T35延时+V300.5最高级报警 |
| 报警处理 | 1.6 | ✅完成 | 32位报警字+优先级链+消音消光V200.0 |
| 断电恢复 | 1.7 | ⚠️基本完成 | 冷启动/热启动双路径完成;跨天RTC计算缺陷待修复 |

### 2.3 报警字实现状态(32位报警)

| 报警位 | 报警码 | 含义 | STL实现状态 |
|---|---|---|---|
| V300.0 | 10 | 上缸漫溢(液位计A高位) | ✅已实现(FC30) |
| V300.1 | 11 | 下缸漫溢(液位计B高位) | ✅已实现(FC31) |
| V300.2 | 12 | NC球阀-上缸动作报警 | ❌预留接口未置位(见TD001) |
| V300.3 | 13 | NC球阀-下缸动作报警 | ❌预留接口未置位(见TD001) |
| V300.4 | 20 | 急停触发 | ✅已实现(FC2) |
| V300.5 | 21 | 安全继电器故障 | ✅已实现(FC2 T35) |
| V301.0~V301.4 | 30~34 | 阀A诊断报警(内漏/超时等) | ✅已实现(FC30) |
| V302.0~V302.6 | 40~46 | 阀B诊断报警 | ✅已实现(FC31) |
| V303.0~V303.5 | 50~55 | 阀C诊断+通讯+RTC报警 | ⚠️部分实现(V303.4部分实现,见TD003) |
| V303.6 | 56 | 流量开关瞬时异常 | ~~已删除(2026-09-08)~~ |
| V303.7 | 99 | 系统未就绪 | ✅已实现 |

> 报警实现汇总:已实现28条 / 预留接口2条(V300.2/V300.3) + 已删除1条(V303.6) / 部分实现1条(V303.4)

---

## 第3节 已知问题

### 3.1 严重问题(3项)— 静态分析严重项,待release-1.1修复

| # | 问题 | 来源 | 影响 | 修复计划 |
|---|---|---|---|---|
| 1 | VD18(VB18~21)与VD20(VB20~23)地址重叠 | 静态分析严重#1 | FC13(S3加药)与FC11/FC16共用VB20~21,参数区写入污染 | release-1.1参数区步长迁移 |
| 2 | VD48(VB48~51)与VD50(VB50~53)地址重叠 | 静态分析严重#2 | FC11(S1进水VD48超时)与FC15(S4转移VD50)共用VB50~51 | release-1.1参数区步长迁移 |
| 3 | VD96(VB96~99)与VD98(VB98~101)地址重叠 | 静态分析严重#3 | FC16(S5运行VD96)与FC13(S3加药VD98)共用VB98~99 | release-1.1参数区步长迁移 |

> 说明:8个严重VD编址冲突已修复5个(校验报告P2 VW270冲突/P5 FC32 MOVB误用等),剩余3个为参数区(VD10~VD140)步长未按4字节对齐导致,需专用迭代整体迁移,工作量较大,计划在release-1.1修复。

### 3.2 STL缺陷(4项)— FMEA P0/P1级,待v1.0修复迭代

| # | 缺陷 | 来源 | RPN | 影响 | 修复计划 |
|---|---|---|---|---|---|
| 1 | NC球阀报警位V300.2/V300.3未置位 | FMEA 5.1项1/2(P0);边界条件EXT-03 | 384(最高) | 漫溢时HMI不显示NC球阀动作报警 | v1.0修复(2026-07-25) |
| 2 | ~~V303.6流量开关瞬时异常未实现~~ | FMEA 5.1项14/15(P1);边界条件SEN-03 | 200/160 | **2026-09-08已删除**：三个流量开关各自有独立报警位，不再需要汇总抖动检测 | N/A |
| 3 | FC4 Modbus通讯超时骨架未实现 | FMEA 5.1项3(P1);边界条件COM-01 | 240 | S3加药通讯中断无超时保护 | v1.0修复(2026-07-30) |
| 4 | FC0跨日RTC计算缺陷 | 边界条件PWR-08/CLK-03 | — | 断电跨天VD_S5_Elapsed计算错误 | v1.0修复(2026-08-05) |

### 3.3 其他已知限制

| # | 限制 | 来源 | 影响 | 处置 |
|---|---|---|---|---|
| 1 | 静态分析59警告(48跨FC写入+11参数区写入) | 静态分析报告 | 调用顺序依赖,潜在时序冲突 | release-1.1评审整改 |
| 2 | 静态分析163提示(87对齐+73未定义+3未使用) | 静态分析报告 | 代码质量,不影响功能 | release-1.2分批整改 |
| 3 | FMEA诊断覆盖率40%已覆盖/28%部分/32%未覆盖 | FMEA 4.1节 | 32%失效模式无诊断 | 按P0/P1/P2路线图逐步补强 |
| 4 | 阀B/阀C四态诊断缺延时确认 | FMEA 5.1项6/16;边界条件VAL-05 | 转移/排水初期瞬时误报 | v1.0修复(2026-07-30) |
| 5 | FC13注射泵步数精度未校验 | FMEA 5.1项4;边界条件EXT-04 | 失步导致加药量不准 | v1.0修复(2026-08-05) |
| 6 | FC12运行中停转未持续监测 | FMEA 5.1项8 | 泵运行中停转不报警 | v1.0修复(2026-07-30) |
| 7 | 限位信号互斥校验未实现 | FMEA 5.1项7 | 限位粘连误判到位 | v1.0修复(2026-07-30) |
| 8 | 手动控制FC未实现(V2.4~V3.3) | 边界条件OPR-03 | 手动操作无法执行 | release-1.1新增FC |
| 9 | 参数范围校验未实现 | 边界条件OPR-04 | 参数越界导致超时或周期=0 | release-1.1新增校验 |
| 10 | 性能未实测(扫描周期/8连接并发) | 性能基准测试方案v1.0 | SAT无实测数据 | 硬件到货后测试 |
| 11 | HMI未定(供应商二轮确认中) | HMI选型问询单 | HMI组态无法启动 | 7/22厂商回复后决策 |

### 3.4 已修复问题(2轮校验10项,全部修复)

| 轮次 | 问题编号 | 严重等级 | 描述 | 修复状态 |
|---|---|---|---|---|
| 第1轮 | P1 | 警告 | FC19第82行注释残留V0.5 | ⚠️注释待修复(TD021) |
| 第1轮 | P2 | 严重 | FC30与FC32共用VW270跨FC冲突 | ✅已修复(新增VW278/VW280) |
| 第1轮 | P3 | 警告 | FC31 VW252未写入 | ✅已修复 |
| 第1轮 | P4 | 警告 | FC14 VW254未写入 | ✅已修复 |
| 第1轮 | P5 | 严重 | FC32 MOVB误用(写字地址应为MOVW) | ✅已修复 |
| 第1轮 | P6 | 警告 | FC11 VD48运算 | ✅已修复(改用VD290中间变量) |
| 第1轮 | P7 | 警告 | FC0 NETWORK6缺VW2==6条件 | ✅已修复 |
| 第2轮 | A1 | — | FC12 VW252未写入S2计时T38失效 | ✅已修复 |
| 第2轮 | A2 | — | FC14 VW254未写入S3.5计时T39失效 | ✅已修复 |
| 第2轮 | A3 | — | FC12 T44/T45用固定+100而非VD58/VD62×10 | ✅已修复(新增VW282/VW284) |

> 注:P1为注释残留,代码已正确使用V0.7,仅注释待更新,不影响功能,列入技术债务TD021。

---

## 第4节 交付物

### 4.1 软件交付

| 项 | 数量 | 位置 | 说明 |
|---|---|---|---|
| PLC STL代码 | 20个文件 | plc/stl/ | OB1+FC0~FC4+FC10~FC19+FC30~FC32+FC40 |
| PLC程序规格书 | 7份 | plc/spec/ | Story 1.2~1.7程序设计规格书 |
| 代码Commit | 48426d5 | Git仓库 | Story 1.7完成节点 |

### 4.2 文档交付

| 类别 | 数量 | 位置 | 关键文档 |
|---|---|---|---|
| 核心设计文档 | 3份 | docs/ | PLC设计文档v9.3、HMI-PLC变量地址表v1.0、HMI画面架构规划v9.3 |
| 校验与测试 | 2份 | docs/ | PLC代码完整性校验报告v1.0、SAT_FAT验收测试用例v1.0(101用例) |
| 可靠性分析 | 3份 | docs/reliability/ | FMEA失效模式分析v1.0、边界条件与异常场景清单v1.0、安全联锁矩阵v1.0 |
| HMI准备材料 | 11份 | docs/hmi_preparation/ | 选型问询单、CSV模板、报警映射表、线框图、权限矩阵等 |
| 调试准备 | 3份 | docs/commissioning/ | 首次下装Checklist、IO核对表、现场调试SOP |
| 版本与变更管理 | 2份 | docs/ | PLC程序版本管理规范v1.0、变更管理流程v1.0 |
| 代码评审 | 1份 | docs/ | 代码评审checklist v1.0 |
| **合计** | **25份+20代码** | | (详见项目交付文档总索引v1.0) |

### 4.3 本次发布新增交付物

| 文档 | 版本 | 用途 |
|---|---|---|
| 项目风险登记册_v1.0.md | v1.0 | 25项风险登记,11项红色风险清单 |
| 技术债务清单_v1.0.md | v1.0 | 30项技术债务,15项高优先级清单 |
| 版本发布说明_v1.0.md(本文档) | v1.0 | v1.0.0里程碑发布说明 |

### 4.4 硬件交付(待采购)

| 项 | 数量 | 状态 |
|---|---|---|
| S7-200 SMART CPU ST20 | 8台 | 待采购(R011) |
| EM DT16/DR16扩展 | 8块 | 待采购(EM型号待确认) |
| 昆仑通态MCGS 12寸HMI | 1台 | 待供应商确认(R010) |
| 阀门/泵/传感器 | 8套 | 待采购 |

---

## 第5节 部署

### 5.1 部署前提条件

| # | 条件 | 状态 | 说明 |
|---|---|---|---|
| 1 | HMI选型确认 | ❌未定 | 供应商二轮确认中(R010),7/22截止 |
| 2 | 硬件到货 | ❌未采购 | 采购未启动(R011) |
| 3 | VW0版本号写入实现 | ❌待实现 | TD029,FC0 NETWORK0赋值 |
| 4 | 静态分析严重项归零 | ❌3项剩余 | 待release-1.1(本版本含3项已知严重项) |
| 5 | P0缺陷修复(TD001) | ❌待修复 | NC球阀报警位,计划2026-07-25 |
| 6 | 现场网络就绪 | ❌未实施 | 网络架构与IP规划v1.0待现场实施 |

> **重要提示**:本版本(v1.0.0)含3项严重VD编址冲突与P0级STL缺陷,不建议直接部署到生产环境。本版本适用于:①内部代码评审与联调 ②首期1套调试(需人工规避已知问题) ③作为release-1.1修复的基线。生产环境部署建议等待release-1.1。

### 5.2 部署环境

| 项 | 要求 |
|---|---|
| PLC型号 | 西门子S7-200 SMART CPU ST20(标准型,内置RTC+超级电容+以太网+RS485) |
| 扩展模块 | EM DT16(8DI+8DO晶体管)或EM DR16(8DI+8DO继电器)— 与整机选型一致 |
| 编程软件 | STEP 7-Micro/WIN SMART V2.5+ |
| 网络环境 | 192.168.2.0/24网段,8台PLC(.101~.108)+1台HMI(.100)+16口管理型交换机 |
| 下装方式 | 以太网下装(通过STEP 7-Micro/WIN SMART) |

### 5.3 8台PLC部署清单

| PLC编号 | IP地址 | 状态 | 备注 |
|---|---|---|---|
| PLC#1 | 192.168.2.101 | 待下装 | 8台程序完全相同,仅IP不同 |
| PLC#2 | 192.168.2.102 | 待下装 | |
| PLC#3 | 192.168.2.103 | 待下装 | |
| PLC#4 | 192.168.2.104 | 待下装 | |
| PLC#5 | 192.168.2.105 | 待下装 | |
| PLC#6 | 192.168.2.106 | 待下装 | |
| PLC#7 | 192.168.2.107 | 待下装 | |
| PLC#8 | 192.168.2.108 | 待下装 | |

### 5.4 下装步骤

详见《PLC首次下装与上电调试Checklist_v1.0.md》。核心步骤:

1. **下装前准备**: ①硬件到货验收 ②IO现场接线核对(《IO现场接线核对表》) ③网络连通性测试 ④系统块配置(IP+断电保持范围,见变量表附录A)
2. **下装顺序**: PLC#1 → PLC#2 → ... → PLC#8(按IP 101→108),相邻间隔≤30分钟
3. **单台下装**: STEP 7-Micro/WIN SMART连接PLC → 下装.mwp → PLC重启进入S0
4. **下装后自检**: ①PLC进入S0 ②HMI读取VW0比对版本号 ③急停功能测试
5. **8台同步验证**: 24小时内完成8台下装,HMI画面8验证版本号一致

### 5.5 版本号登记

FC0 NETWORK0首次扫描(SM0.1)应写入版本号到VW0:

```
// FC0_SysInit NETWORK 0 — 版本号登记(首次扫描)
LD     SM0.1
MOVW   16#0100, VW0    // 版本号 v1.0.0 (主=01, 次=00, 修订=00)
```

> 注意:TD029尚未实现,本字段需在下装前完成实现。若未实现,HMI无法显示版本号,8台版本一致性检测无法执行。

---

## 第6节 升级与回滚

### 6.1 升级路径

| 升级场景 | 当前版本 | 目标版本 | 升级方式 |
|---|---|---|---|
| 首次部署 | (无) | v1.0.0 | 首次下装.mwp |
| 本版本内修复 | v1.0.0 | v1.0.1+ | 重新下装修复后.mwp(Z位递增) |
| 下一里程碑 | v1.0.x | v1.1.0 | release-1.1下装(Y位递增) |

### 6.2 回滚方案

| 项 | 说明 |
|---|---|
| 上一稳定版本 | 无(v1.0.0为首版) |
| 回滚触发条件 | ①缺陷可重现且影响安全/工艺 ②8台PLC无法运行 ③SAT/FAT关键用例阻塞 |
| 回滚方式 | 本版本为首版,无上一版本可回滚;若v1.0.0部署后出现严重问题,执行"紧急变更流程"(变更管理流程第4章),hotfix分支修复后下装v1.0.1 |
| 回滚审批 | L3管理员(口头先行)+ 项目负责人(事后补签) |
| 参数回滚 | HMI设定参数(VD10~VD66)从备份CSV重新下发;实测值(VD70~VD102)不需回滚 |

### 6.3 回滚决策树

```
现场反馈异常
    │
    ├── 缺陷可重现且影响安全/工艺 → 紧急变更(hotfix)
    │       │
    │       ├── 8台全部异常 → 8台同步下装hotfix版本
    │       └── 单台异常 → 单台下装hotfix版本
    │
    ├── 缺陷偶发或可规避 → 评估后决定
    │       ├── 影响小,可手工规避 → 缺陷单流程,下个版本修复
    │       └── 影响大,无法规避 → 紧急变更
    │
    └── 缺陷无法重现 → 观察期,数据收集后决策
```

### 6.4 单台紧急回滚流程

仅当单台PLC出现严重故障(无法进入S0/急停无法复位/与HMI通讯中断),且其他7台正常时,允许单台回滚(详见版本管理规范5.4节):

| 步骤 | 操作 | 审批 |
|---|---|---|
| 1 | 故障确认+版本号核对 | L2维护 |
| 2 | 选择回滚目标版本 | L3管理员 |
| 3 | 取得旧版.mwp(Git LFS或achieve/) | 实施人 |
| 4 | 单台PLC进入STOP | 实施人 |
| 5 | 下装旧版.mwp | 实施人 |
| 6 | PLC重启,HMI读取VW0确认版本 | 实施人+HMI操作员 |
| 7 | 急停+手动阀门测试 | 调试工程师 |
| 8 | 单台转手动模式观察2小时 | 调试工程师 |
| 9 | 24小时内补登变更单AQEX-CHG-E | 实施人 |

> 注意:本版本(v1.0.0)为首版,achieve/目录尚未建立(TD030),单台回滚无旧版.mwp可用。建议v1.0.0下装后立即备份8台.mwp至achieve/目录,作为后续回滚基线。

---

## 第7节 后续计划

### 7.1 版本路线图

| 版本 | 计划日期 | 主要内容 | 状态 |
|---|---|---|---|
| **v1.0.0**(本版本) | 2026-07-18 | Story 1.2~1.7六轮迭代交付,20个FC STL代码 | 📌里程碑发布 |
| v1.0.1 | 2026-07-30 | P0/P1级STL缺陷修复(TD001/TD002/TD003/TD005/TD006/TD012~TD014/TD026/TD029) | 计划中 |
| v1.1.0(release-1.1) | 2026-08-30 | 3个VD编址冲突修复+手动控制FC+参数范围校验+跨FC写入评审 | 计划中 |
| v1.2.0(release-1.2) | 2026-09+ | 静态分析提示项整改+测试用例设计+NC球阀反馈DI硬件改动 | 待规划 |
| **v1.3.0(hotfix)** | **2026-09-04** | **【P0级关键Bug修复】①FC3_NETWORK4报警确认处理缺V0.3上升沿门控——每周期无条件清报警位导致报警状态"一闪而过"丢失(VW2=99但报警灯不亮)；②FC4_NETWORK6任务4 MBUS_MSG缺M11.6门控——反复触发导致注射泵写命令卡死(VW290卡4,手动注射泵卡3,自动S3必S_ERROR) | ✅已修复** |
| **v10.2 / AQEX-51** | **2026-09-04** | **RTC 时间同步机制 + FC0 JMP/LBL 跨 NETWORK 修复 + FC2 I1.2 逻辑纠正** | ✅已发布 |

### 7.2 v1.0.1修复计划(2026-07-19~2026-08-05)

| 周次 | 修复内容 | 关联债务/风险 |
|---|---|---|
| W30(7/19~7/25) | NC球阀报警位V300.2/V300.3置位+FC3复位逻辑 | TD001/R001(P0) |
| W31(7/26~8/01) | FC4 Modbus超时+V303.6抖动检测+四态延时确认+运行中停转监测+限位互斥+VW0版本号+CHANGELOG+Git LFS | TD002~TD006/TD013/TD014/TD022/TD023/TD029 |
| W32(8/02~8/05) | FC0跨日RTC+注射泵步数精度+液位计延时确认 | TD005/TD012/TD026 |

### 7.3 release-1.1计划(2026-08-06~2026-08-30)

| 内容 | 关联债务/风险 |
|---|---|
| 3个VD编址冲突修复(参数区步长迁移) | TD004/R004 |
| 48跨FC写入冲突评审+11参数区写入整改 | TD007/TD008/R008 |
| 手动控制FC新增(V2.4~V3.3响应) | TD027 |
| 参数范围校验新增(OPR-04) | TD028 |
| 性能基准测试执行(硬件到货后) | TD015/R007 |
| 8台PLC版本一致性测试+同步下装工具 | TD019/TD030 |

### 7.4 待决策事项

| 事项 | 决策时间 | 负责人 |
|---|---|---|
| HMI选型(昆仑通态/威纶通/西门子) | 2026-07-24(7/22厂商回复后48小时) | 项目经理 |
| EM DT16/DR16扩展模块选型 | 控制柜方案确认后 | PLC工程师+硬件 |
| 整机采购订单下达 | HMI选型确认后立即 | 采购工程师 |
| NC球阀到位反馈DI(评估I2.2余量) | release-1.2前 | PLC工程师 |

---

## 第8节 验收标准

### 8.1 本版本(v1.0.0)验收标准

| # | 验收项 | 验收标准 | 实际结果 | 通过 |
|---|---|---|---|---|
| 1 | 代码完整性校验 | OB1调度5项全通过;2轮校验10问题全修复 | ✅全通过(校验报告v1.0) | ✅ |
| 2 | 静态分析 | 严重项归零(目标) | ❌3项严重剩余(已知问题) | ⚠️部分 |
| 3 | STL代码20个FC | 全部FC文件存在且可编译 | ✅20个FC完成 | ✅ |
| 4 | 状态机完整性 | S0~S7+S_ERROR转移完整 | ✅完整(校验报告) | ✅ |
| 5 | 报警字实现 | 32位报警全部实现(目标) | ⚠️28已实现/3预留/1部分 | ⚠️部分 |
| 6 | 代码评审 | PR至少1人评审通过 | 待评审(代码评审checklist v1.0) | ⏳待定 |
| 7 | 变量地址表同步 | 变量表v1.0与代码一致 | ✅一致(校验报告交叉核对) | ✅ |

> 验收结论:本版本为里程碑发布,允许带已知问题(第3节)发布,但须在v1.0.1修复P0/P1缺陷。静态分析严重项3项与P0缺陷(TD001)不达标,标记为"有条件通过",条件为2026-08-05前完成v1.0.1修复。

### 8.2 SAT/FAT验收标准(硬件到货后)

| # | 验收组 | 用例数 | 验收标准 | 关联文档 |
|---|---|---|---|---|
| 1 | 状态机流程 | — | S0→S1→S2→S3→S3.5→S4→S5→S6→S7完整无卡死 | SAT_FAT用例v1.0 |
| 2 | 急停功能 | — | 8台急停均能转S_ERROR+报警+QB0=0 | SAT_FAT用例v1.0 |
| 3 | 阀门诊断 | — | 阀A/B/C四态诊断+漫溢保护+超时报警 | SAT_FAT用例v1.0 |
| 4 | 报警功能 | — | 32位报警正确置位/复位+消音消光 | SAT_FAT用例v1.0 |
| 5 | Modbus通讯 | — | 注射泵VW4+流量计VD86通讯正常 | SAT_FAT用例v1.0 |
| 6 | HMI通讯 | — | 8台PLC均能从HMI访问+版本号显示 | SAT_FAT用例v1.0 |
| 7 | 断电恢复 | — | S5断电恢复VD_S5_Elapsed连续不跳变 | SAT_FAT用例v1.0 |
| 8 | 8台版本一致性 | — | HMI画面8显示8台VW0一致 | 版本管理规范5.2 |
| **合计** | 9组 | **101用例** | 全部通过 | SAT_FAT验收测试用例v1.0 |

### 8.3 发布检查清单(版本管理规范4.3节,14项)

| # | 检查项 | 通过条件 | 本版本状态 |
|---|---|---|---|
| 1 | 代码评审 | PR至少1人评审通过 | ⏳待评审 |
| 2 | 静态分析 | 严重问题=0 | ❌3项严重(已知) |
| 3 | 完整性校验 | 检查项全部通过 | ✅通过 |
| 4 | 变量地址表 | 变量表同步本次变更 | ✅同步 |
| 5 | CHANGELOG.md | 已更新 | ❌未建立(TD022) |
| 6 | 版本号字段 | FC0 NETWORK0写入VW0 | ❌未实现(TD029) |
| 7 | 8台PLC部署清单 | 标签说明含8台IP | ✅含(第5.3节) |
| 8 | 回滚预案 | 明确上一稳定版本+步骤 | ⚠️首版无上一版本(第6.2节) |
| 9 | 变更单闭环 | 变更单状态"待发布" | ⏳待创建 |
| 10 | HMI同步 | HMI变量表同步 | ⏳HMI未定 |
| 11 | 文档同步 | 规格书/校验报告/SOP更新 | ✅已更新 |
| 12 | 验收用例 | SAT/FAT用例回归 | ⏳硬件未到 |
| 13 | 现场准备 | 现场工程师收到通知 | ⏳硬件未到 |
| 14 | 备份 | 8台旧版.mwp归档 | ⚠️首版无旧版 |

> 发布检查结论:14项中3项通过(3/4/7/11)、5项不通过(2/5/6/8/14)、6项待定(1/9/10/12/13)。本版本作为里程碑基线发布,标记为"预发布候选",正式生产部署需等待v1.0.1修复后重新通过发布检查清单。

---

## 第9节 签发

### 9.1 发布签发

| 角色 | 姓名 | 签字 | 日期 |
|---|---|---|---|
| PLC工程师(编制) | __________ | __________ | 2026-07-18 |
| 调试工程师(评审) | __________ | __________ | __________ |
| L3管理员(审批) | __________ | __________ | __________ |
| 项目负责人(批准) | __________ | __________ | __________ |

### 9.2 发布记录

| 项 | 内容 |
|---|---|
| 发布版本 | v1.0.0 |
| 发布日期 | 2026-07-18 |
| 代码Commit | 48426d5 |
| Git标签 | v1.0.0(附注标签,待创建) |
| 发布性质 | 里程碑发布(预发布候选) |
| 8台PLC下装记录 | 待硬件到货后下装 |
| 版本一致性验证 | 待下装后验证 |

### 9.3 配套文档索引

| 文档 | 版本 | 路径 |
|---|---|---|
| PLC代码完整性校验报告 | v1.0 | docs/PLC代码完整性校验报告_v1.0.md |
| PLC代码静态分析报告 | v1.0 | docs/PLC代码静态分析报告_v1.0.md |
| HMI-PLC变量地址表 | v1.0 | docs/HMI-PLC变量地址表_v1.0.md |
| FMEA失效模式分析 | v1.0 | docs/reliability/FMEA失效模式分析_v1.0.md |
| 边界条件与异常场景清单 | v1.0 | docs/reliability/边界条件与异常场景清单_v1.0.md |
| PLC程序版本管理规范 | v1.0 | docs/PLC程序版本管理规范_v1.0.md |
| 变更管理流程 | v1.0 | docs/变更管理流程_v1.0.md |
| SAT_FAT验收测试用例 | v1.0 | docs/SAT_FAT验收测试用例_v1.0.md |
| 项目交付文档总索引 | v1.0 | docs/项目交付文档总索引_v1.0.md |
| 项目风险登记册 | v1.0 | docs/项目风险登记册_v1.0.md |
| 技术债务清单 | v1.0 | docs/技术债务清单_v1.0.md |

### 9.4 变更单与关联

| 变更单 | 类型 | 说明 |
|---|---|---|
| AQEX-CHG-R-001(待创建) | 需求变更 | Story 1.2~1.7六轮迭代交付(L3) |
| AQEX-CHG-B-001(待创建) | 缺陷修复 | v1.0.1 P0/P1缺陷修复(L3/L4) |
| AQEX-CHG-O-001(待创建) | 优化重构 | release-1.1 VD编址迁移(L3) |

### 9.5 下装工具与步骤

| 项 | 说明 |
|---|---|
| 下装工具 | STEP 7-Micro/WIN SMART V2.5+ |
| 下装步骤 | 详见《PLC首次下装与上电调试Checklist_v1.0.md》 |
| 网络规划 | 详见《网络架构与IP规划_v1.0.md》 |
| 8台同步下装 | 详见《PLC程序版本管理规范_v1.0.md》第5章 |

---

**文档版本**: v1.0
**发布版本**: v1.0.0
**编制日期**: 2026-07-18
**下次发布**: v1.0.1(计划2026-08-05)
**审批人**: 项目负责人

---

# 附录 v1.1 补丁说明（2026-08-27）

## A.1 版本信息

| 项 | 说明 |
|---|---|
| 补丁版本 | v1.1.0 |
| 发布日期 | 2026-08-27 |
| 基础版本 | v1.0.0 (commit 48426d5) |
| 代码变更 | FC15_State_S4_Transfer.stl NETWORK 1 |
| 文档变更 | plc/spec/Story1.2_状态机骨架_程序设计规格书 v1.0→v1.1；docs/reliability/安全联锁矩阵 v1.0→v1.1；docs/reliability/边界条件与异常场景清单 v1.0→v1.1；docs/reliability/FMEA失效模式分析 v1.0→v1.1；docs/SAT_FAT验收测试用例 v1.0→v1.1；docs/需求追溯矩阵 v1.0→v1.1 |

## A.2 变更内容

### A.2.1 业务变更
S4（上→下转移）增加「下缸已排空」互锁。**修改前** S4 启动时无下缸状态校验（仅依赖状态机序列隐式保证）；**修改后** FC15 NETWORK 1 增加 `AN V1.7` 显式校验，下缸未空（V1.7=1）时**静默等待**（不报错、不停机），每周期轮询直至 S6 排空完成自动开阀。**节拍保持并行**——S1~S3.5 上缸配液可与 S6 下缸排水同时进行。

### A.2.2 STL 变更（FC15_State_S4_Transfer.stl）
- **NETWORK 1 重写**：将原 `LD M10.4 EU` 单次触发改为 `LD SM0.0 + AW= VW2,5 + LPS + AN V1.7` 周期检测结构
- **触发条件变更**：每周期检测 `VW2=5 AND V1.7=0`，避免首周期 V1.7=1 时错过启动的隐患（原 M10.4 EU 仅首周期有效）
- **未变更**：NETWORK 2/3 保持原样（FC31 调用 + 诊断结果处理 + DT10 时间戳 + VD_S5_Elapsed 清零 + 转 S5）

### A.2.3 文档变更（共 7 份）
1. **plc/spec/Story1.2_状态机骨架_程序设计规格书_v1.0.md** → v1.1：§2.6 FC15 新增 v1.1 互锁逻辑小节（实现要点、进入动作、周期动作、转移条件、时序示意）；§2.7 FC16 新增 v1.1 配套说明
2. **docs/reliability/安全联锁矩阵_v1.0.md** → v1.1：§2.1 阀门动作联锁矩阵「开阀B」列 C4 升级 △ 隐式 → △ 显式；§3.1 显式联锁逻辑溯源表新增「v1.1新增」项；§4.2 遗漏联锁核对「进入S4前校验下缸=空」标 v1.1已实现；§5.3 P1-4 标 v1.1已实现；§5.4 一致性核对更新
3. **docs/reliability/边界条件与异常场景清单_v1.0.md** → v1.1：新增第九类 S4 互锁场景（S4-01/02/03）；OPR-06 标 v1.1已覆盖；场景总数 46→49
4. **docs/reliability/FMEA失效模式分析_v1.0.md** → v1.1：§2.2 阀B 新增 v1.1 失效模式（"上→下转移时下缸未排空"），RPN 从 420 降至 56
5. **docs/SAT_FAT验收测试用例_v1.0.md** → v1.1：第四章新增 TC-04-013~017 S4 互锁测试用例（5 条必测）
6. **docs/需求追溯矩阵_v1.0.md** → v1.1：新增 REQ-059 S4 下缸空互锁需求；REQ-006 实现说明补充 v1.1 互锁；测试用例基线 106→111
7. **docs/项目交付文档总索引_v1.0.md** → v1.1：v1.1 文档清单更新（待补）

## A.3 影响面评估

| 维度 | 影响 | 评估 |
|---|---|---|
| **节拍** | 几乎无影响 | S1~S3.5 与 S6 仍并行；S4 仅在 V1.7=1 时延迟启动，延迟时间 = S6 剩余排水时间（通常 <60s） |
| **安全** | 正面影响 | "上→下转移时下缸未排空" 失效模式 RPN 从 420（极高）降至 56（中低） |
| **现有报警/诊断** | 无冲突 | FC31 NETWORK 1 漫溢保护仍无条件执行；FC16 预规划逻辑未动 |
| **断电恢复** | 无影响 | FC0 断电恢复逻辑未动；VW2=5（S4）中断电仍转 S_ERROR |
| **HMI 侧** | 无需改动 | 不新增报警位/不修改变量表；HMI 可读 V1.7 显示等待状态 |
| **测试用例** | 新增 5 条 | TC-04-013~017（必测），覆盖正常/异常/边界场景 |

## A.4 验证要求

- FAT 阶段必须执行 TC-04-013 ~ TC-04-017 全部 5 条新增【必测】项
- SAT 阶段作为【回归】复测
- 重点验证：S4 入口 V1.7=1 时不进入 S_ERROR、S4 静默等待期间 S1~S3.5 可正常启动、S4 静默等待期间 FC31 漫溢保护仍生效

## A.5 升级说明

1. 现场升级前备份当前 PLC 程序（项目 → 导出 → 备份文件）
2. 替换 plc/stl/FC15_State_S4_Transfer.stl 文件，重新编译并下装
3. 同步更新现场 HMI 文档（v1.0 → v1.1）
4. 执行 TC-04-013 ~ TC-04-017 FAT 回归
5. 现场 SAT 复测 5 条新增用例

## A.6 已知问题（v1.1 仍未解决）

| 编号 | 描述 | 优先级 | 计划 |
|---|---|---|---|
| ISS-006 (v1.0) | S4 静默等待无超时报警（S6 长时间排不空时 S4 持续等待无提示） | P2 | 后续补丁 |
| TD-029 (v1.0) | FC0 NETWORK0 VW0 版本号写入未实现 | P1 | release-1.1 修复 |
| VD-001/002/003 (v1.0) | 3 个 VD 编址冲突 | P0 | release-1.1 修复 |
| V300.2/V300.3 (v1.0) | NC 球阀动作报警位未置位 | P0 | release-1.1 修复 |
| V303.6 (v1.0) | 流量开关抖动检测未实现 | P1 | **2026-09-08已删除** |

> v1.1 补丁**未引入新问题**，所有 v1.0 已知问题按原计划处理。

---

# v1.2 补丁说明（2026-08-27）

## A. 版本信息

| 项 | 说明 |
|---|---|
| 基础版本 | v1.1.0 (commit 5e1a625) |
| 发布日期 | 2026-08-27 |
| 代码变更 | FC15_State_S4_Transfer.stl NETWORK 1 加等待计时+超时报警分支、NETWORK 3 加清零段;FC16_State_S5_Run.stl NETWORK 4 改转 S6 阈值(减去 VD_S4Wait_Time) |
| 文档变更 | 共 11 份文档升至 v1.2,新增报警码 49、V303.2 报警位、VD380/VD382 变量 |

## B. 业务变更

### B.1 问题背景
v1.1 引入 S4 互锁(下缸未空时静默等待)后,虽然解决了"下缸未排空时开阀"的安全问题,但引入了**"实验时间被压缩"** 的次生问题:
- VD_S5_Elapsed 在 V1.7=1 期间持续累加
- 但 V1.7=1 期间若 S4 互锁生效,实际下缸"被占用但没跑实验"
- 用户设的 VD_CycleSetpoint=60min 是"下缸有效实验时间",不是"下缸被占用的时间"
- 结果:S4 等 30min,下缸只跑 30min 实验,但 VD_S5_Elapsed 仍按 60min 触发转 S6 → 有效实验时间被压缩 30min

### B.2 修复方案 (A2)
VD_S5_Elapsed 语义保持纯"下缸满的时长",但**FC16 转 S6 阈值动态减去 S4 等待时长**:

```
转 S6 触发条件(旧):VD_S5_Elapsed >= VD_CycleSetpoint×60
转 S6 触发条件(新):VD_S5_Elapsed >= VD_CycleSetpoint×60 - VD_S4Wait_Time
```

### B.3 新增 S4 等待超时报警
S4 等待超过 VD_S4WaitTimeout(默认 1800s=30min)→ V303.2 报警(VW6=49,一般级,仅提示不强制 S_ERROR)。

## C. 变更内容

### C.1 STL 变更
- **FC15_State_S4_Transfer.stl**:
  - NETWORK 1 加 S4 等待计时+超时报警分支(T61 超时计时 + T62 1s 累加 + V303.2 报警 + VW6=49)
  - NETWORK 3 S4 完成时 R T61 + R T62 + MOVR 0.0 VD380 + R V303.2 全部清零
- **FC16_State_S5_Run.stl**:
  - NETWORK 4 改 `AC0 = AC0 - VD_S4Wait_Time` 让阈值动态

### C.2 新增变量
| 变量 | 类型 | 默认 | 用途 |
|---|---|---|---|
| VD380 VD_S4Wait_Time | REAL, 秒 | 0 | S4 等待时长 |
| VD382 VD_S4WaitTimeout | REAL, 秒 | 1800 | S4 等待超时阈值 |
| V303.2 M_Alarm_S4TransferWaitTimeout | BOOL | 0 | 等待超时报警 |
| T61 | TIMER, 100ms | — | 等待超时计时器 |
| T62 | TIMER, 100ms | — | 1s 累加脉冲 |
| VW286 | INT | — | VD_S4WaitTimeout×10 转换值 |

### C.3 文档变更 (11 份升至 v1.2)
1. plc/spec/Story1.2_状态机骨架_程序设计规格书 v1.0→v1.2
2. docs/reliability/安全联锁矩阵 v1.0→v1.2
3. docs/reliability/边界条件与异常场景清单 v1.0→v1.2 (新增 S4-04/05)
4. docs/reliability/FMEA失效模式分析 v1.0→v1.2 (RPN 56→42)
5. docs/SAT_FAT验收测试用例 v1.0→v1.2 (新增 TC-04-018/019/020)
6. docs/需求追溯矩阵 v1.0→v1.2 (新增 REQ-060/061/062)
7. docs/版本发布说明 v1.0→v1.2 (本文档)
8. docs/commissioning/PLC首次下装与上电调试Checklist v1.0→v1.2
9. docs/项目交付文档总索引 v1.0→v1.2
10. docs/hmi_preparation/报警字32位解析映射表 (新增 V303.2 行)
11. docs/HMI-PLC变量地址表 (新增 VD380/VD382)
12. docs/commissioning/故障代码字典 (新增 §3.26 报警码 49)

## D. 影响面评估

| 维度 | 影响 |
|---|---|
| 节拍 | 改善 — 下缸有效实验时间严格按 VD_CycleSetpoint 跑满,不被 S4 等待压缩 |
| 安全 | 改善 — 操作员可及时知道 S6 排水异常(V303.2 报警) |
| 现有报警/诊断 | 无冲突 — V303.2 是新增位 |
| 断电恢复 | 无影响 — VD_S4Wait_Time 在 S4 完成时已清零,FC0 不需额外处理 |
| HMI 侧 | 需新增画面显示 VD380/VD382 + V303.2 指示灯 |
| 测试用例 | 新增 3 条必测 (TC-04-018/019/020) |

## E. 验证要求

- FAT 必须执行 TC-04-018/019/020 全部 3 条新增必测项
- SAT 阶段作为【回归】复测
- 重点验证:S4 等待 30min 后 V303.2 报警触发、FC16 转 S6 阈值 = 60min - 10min(等待时间)

## F. 升级说明

1. 现场升级前备份当前 PLC 程序
2. 替换 plc/stl/FC15_State_S4_Transfer.stl 和 plc/stl/FC16_State_S5_Run.stl
3. **新数据块**:需要在符号表/数据块添加 VD380、VD382、V303.2
4. **HMI 侧**:画面4-时间周期组新增 VD_S4Wait_Time(只读) + VD_S4WaitTimeout(可调);画面5报警指示灯新增 V303.2 位
5. 执行 TC-04-018/019/020 FAT 回归

## G. 已知问题 (v1.2 仍未解决)

继承自 v1.0/v1.1:
- TD-029 FC0 VW0 版本号写入未实现 (P1)
- VD-001/002/003 三个 VD 编址冲突 (P0)
- V300.2/V300.3 NC 球阀报警位未置位 (P0)
- ~~V303.6 流量开关抖动检测未实现 (P1)~~ **2026-09-08已删除**

> v1.2 补丁**未引入新问题**,v1.0/v1.1 已知问题按原计划处理。

---

# v10.2 / AQEX-51 补丁说明（2026-09-04）

## A. 版本信息

| 项 | 说明 |
|---|---|
| 补丁版本 | v10.2 / AQEX-51 |
| 发布日期 | 2026-09-04 |
| 基础版本 | v1.2（hotfix 版本已部分整合） |
| 代码变更 | **FC0_SysInit.stl**（重写 RTC 检测逻辑、合并 JMP/LBL 到单 NETWORK）、**FC2_EStopHandling.stl**（I1.2 逻辑按实际接线纠正）、**OB1_MAIN.stl**（调度顺序插入 FC22）、**新增 FC22_RTC_Sync.stl**（RTC 校时 + 5 分钟超时） |
| 文档变更 | PLC设计文档 v10.1→v10.2、PLC代码完整性校验报告 v1.0→v1.1、HMI-PLC变量地址表 v1.0→v1.1、SAT_FAT验收测试用例 v1.0→v1.1、需求追溯矩阵 v1.0→v1.1、版本发布说明 v1.0→v10.2 |

## B. 问题背景

现场调试发现 PLC 停机后重启（STOP→RUN）状态机被误判进 S_ERROR，具体排查链路：

1. FC0 中 JMP/LBL 跨 NETWORK 跳转导致 S7-Smart200 编译后运行时程序流混乱
2. FC0 RTC 检测因历史垃圾时间戳（DT10 VB11=160、VB15=200 非法值）误触发
3. FC2 I1.2 逻辑与实际接线相反（代码写"未断开即故障"，实际 I1.2=1 表示动力接通）
4. 三个问题叠加导致 STOP→RUN 后 VW2 持续被写成 99

## C. 变更内容

### C.1 STL 变更

**FC0_SysInit.stl（重写）**：
- 所有 JMP/LBL 合并到单一 NETWORK（与 FC1_StateDispatcher 修复方法一致）
- 新增 RTC 自身合法性检查（月>12、分>59、秒>59 等）
- 新增 DT10 合法性检查（防止历史垃圾时间戳误触发）
- **RTC 异常处理策略变更**：由原来的"置 V303.5 + 直接转 S_ERROR"改为"置 **V303.7=1**（M_Need_RTC_Sync）请求 HMI 校时，**保持 S0**"
- 仅 DT10 合法性检查通过后才做 RTC<DT10 比较

**FC2_EStopHandling.stl（纠正）**：
- NETWORK 2（继电器故障判定）条件由 AN I1.2 改为 A I1.2
- 纠正后逻辑：急停锁存后，若 2 秒内 **I1.2 仍为 1（动力未断开）** → 报继电器故障

**新增 FC22_RTC_Sync.stl**：
- NETWORK 1：检测 V0.6 上升沿 → 调用 TODW VB900 写入 PLC RTC → 复位 V303.7 和 V0.6
- NETWORK 1：V303.7=1 时启动 T59（5 分钟，3000×100ms），超时后置 V303.5=1 并 VW2=99

**OB1_MAIN.stl（调度调整）**：
- 调度顺序：FC0 → FC2 → FC4 → FC3 → **FC22** → FC1 → FC20/FC21
- FC22 在 FC3 之后、FC1 之前，保证 RTC 校时命令不影响状态机判断

### C.2 新增/修改变量

| PLC 地址 | 名称 | 类型 | 变更 |
|---|---|---|---|
| **V0.6** | CMD_RTC_Sync | 位 | 原 Reserved_CMD_ForceTankA_Full 已替换 |
| **V303.5** | M_Alarm_RTC_Lost | 位 | 含义变更：原"RTC 丢失即置位"→ 现"V303.7 5 分钟未同步后置位" |
| **V303.7** | M_Need_RTC_Sync | 位 | 原预留位，AQEX-51 启用 |
| **VB900** ~ **VB905** | RTC_Year/Month/Day/Hour/Minute/Second | BYTE(BCD) | 新增校时源缓冲区 |
| **VB906** ~ **VB907** | RTC_Weekday / RTC_Reserved | BYTE | 新增，FC22 固定清零 |
| **T59** | 校时超时定时器 | 100ms TON | 5 分钟（3000×100ms），FC22 专用 |

### C.3 文档变更（7 份）

1. **PLC设计文档 v10.1→v10.2**：版本说明追加 AQEX-51 条目、文档标题改 v10.2、I1.2 逻辑全章纠正（6 处）、第十章 RTC 断电恢复更新、新增 §10.2 FC22 RTC 同步小节、加 FC0 JMP/LBL 修复注记、V303.7 描述更新
2. **HMI-PLC变量地址表 v1.0→v1.1**：V0.6/V303.5/V303.7 描述更新、VB900~VB907 区域表新增、RTC 检测说明更新、地址汇总表补 VB900~VB907
3. **PLC代码完整性校验报告 v1.0→v1.1**：STL 文件总数 20→21、OB1 调度顺序加 FC22、FC 调用表/统计表/定时器表更新、V 区编址加 FC22、JMP/LBL 章节补充跨 NETWORK 问题、FC0 NETWORK7 注记、新增 P8/P9/P10 问题条目、三轮修复总结
4. **SAT_FAT验收测试用例 v1.0→v1.1**：TC-09-006/007 描述更新、**新增 TC-09-011/012/013**（校时正常流程、5 分钟超时、实际 RTC 更新验证）
5. **需求追溯矩阵 v1.0→v1.1**：追加 AQEX-51 追溯条目、验收测试汇总章节用例数 10→13
6. **版本发布说明 v1.0→v10.2**：新增本章节
7. **McgsPro_RTC校时组态说明 v1.0 新建**：独立 McgsPro 侧组态操作说明

### C.4 McgsPro 侧变更

- 新增 8 个 PLC 变量：V0.6、V303.7、VB900~VB905（BCD 格式、8 位无符号）
- 新建用户窗口 RTC_Sync_Wnd（400×200），含提示文本 + "同步"按钮
- 新建循环策略 RTC_Sync_Poll（1000ms 周期）：检测 V303.7=1 弹窗，校时完成自动关闭
- "同步"按钮脚本：取本机时间 → 十进制转 BCD → 写入 VB900~VB905 → 置 V0.6=1

## D. 影响面评估

| 维度 | 影响 | 评估 |
|---|---|---|
| 状态机安全 | **正面** | RTC 异常不再直接转 S_ERROR，改为请求校时，状态机保持 S0 可操作；5 分钟超时保护保留安全兜底 |
| 急停安全 | **正面** | I1.2 逻辑纠正后继电器故障报警不会在真急停时误触发（原代码 I1.2=0 即报故障，但实际急停时 I1.2 就是 0） |
| 断电恢复 | **修复** | JMP/LBL 跨 NETWORK 问题彻底消除，S0/S5/S7/S_ERROR 保持策略正确执行 |
| HMI 侧 | 需组态 | McgsPro 需新建窗口 + 循环策略 + 按钮脚本 + 导入 8 个变量，详见 rchive/mcgspro/McgsPro_RTC校时组态说明_v1.0.md |
| 测试用例 | 新增 3 条必测 | TC-09-011/012/013，覆盖正常校时、超时保护、实际 RTC 更新 |

## E. 验证要求

- 现场 STOP→RUN 后 VW2 不再误进 S_ERROR（核心修复验证）
- FAT 必须执行 TC-09-006/007/011/012/013 全部 5 条 RTC 相关用例
- 急停功能回归：按下急停 → VW2=99、V300.4=1、V300.5 不应在 2 秒后误报（I1.2 逻辑纠正后）

## F. 升级说明

1. **PLC 侧下装顺序**：
   - FC0_SysInit（重写）
   - FC2_EStopHandling（纠正）
   - FC22_RTC_Sync（**新建**）
   - OB1_MAIN（调度顺序调整）
2. **符号表更新**：FC22 命名为 RTC_Sync
3. **McgsPro 侧**：
   - 导入更新后的变量 CSV（西门子_S7_Smart200_以太网.csv）
   - 新建 RTC_Sync_Wnd 窗口
   - 新建循环策略 RTC_Sync_Poll
   - 组态 "同步" 按钮脚本
4. **现场调试**：
   - PLC STOP→RUN 确认 VW2 不进 S_ERROR
   - 强制 VB904=70（非法分）→ 上电确认 HMI 弹窗
   - 点击 "同步" → 确认 RTC 时间正确更新
   - 强制 I1.2 逻辑回归：按下急停确认 V300.5 不误报

## G. 已知问题（v10.2 仍未解决）

| 编号 | 描述 | 优先级 | 计划 |
|---|---|---|---|
| TD-029 (v1.0) | FC0 VW0 版本号写入未实现 | P1 | release-1.1 修复 |
| VD-001/002/003 (v1.0) | 3 个 VD 编址冲突 | P0 | release-1.1 修复 |
| V300.2/V300.3 (v1.0) | NC 球阀动作报警位未置位 | P0 | release-1.1 修复 |
| V303.6 (v1.0) | 流量开关抖动检测未实现 | P1 | **2026-09-08已删除** |
| ISS-006 (v1.1) | S4 静默等待无超时报警 | P2 | 后续补丁 |

> v10.2/AQEX-51 **未引入新问题**，所有历史已知问题按原计划处理。
