Yustnust/AQUA-EXPO/docs/项目风险登记册_v1.0.md

# 药液配置加注控制系统 — 项目风险登记册 v1.0

**项目**: AQUA-EXPO 药液配置与加注控制系统(8套缸单元,8台S7-200 SMART CPU ST20 + 1台HMI集中监控)
**项目背景一句话**: PLC代码Story 1.7已完成(20个FC的STL代码),经2轮完整性校验+静态分析,8个严重VD编址冲突已修复5个(剩余3个参数区步长冲突待专用迭代);HMI初步选型昆仑通态MCGS 12寸(供应商二轮确认中),采购未启动。
**版本**: v1.0
**编制日期**: 2026-07-18
**编制人**: 项目经理
**配套文档**: PLC代码静态分析报告v1.0、PLC代码完整性校验报告v1.0、FMEA失效模式分析v1.0、边界条件与异常场景清单v1.0、HMI选型技术问询单与备选方案对比v1.0、网络架构与IP规划v1.0、备品备件清单v1.0

---

## 一、风险评级标准

### 1.1 概率等级(Probability)

| 等级 | 描述 | 判定依据 |
|---|---|---|
| 高 | 极可能发生 | 已有缺陷确证/现场工况常见/采购周期已超期 |
| 中 | 可能发生 | 偶发工况/特定条件触发/依赖外部决策 |
| 低 | 较少发生 | 罕见工况/多重保护存在/已制定缓解措施 |

### 1.2 影响程度(Impact)

| 等级 | 描述 | 判定依据 |
|---|---|---|
| 严重 | 人身/漫溢/安全功能失效/项目里程碑无法达成 | S=9~10 / 阻塞验收 / 安全联锁失效 |
| 高 | 单元停机/实验失败/采购关键路径延误 | S=7~8 / 需长时间检修 |
| 中 | 单周期失败/需人工介入可恢复/进度小幅滑移 | S=5~6 |
| 低 | 短时停机/仅提示/自动恢复 | S=3~4 |

### 1.3 风险等级矩阵

| 风险等级 | 颜色 | 判定 | 处置要求 |
|---|---|---|---|
| **红色(高)** | 🔴 | 概率高+影响严重/高;或P0级缺陷;或RPN≥150且影响安全 | 立即处置,项目负责人跟踪,每周复盘 |
| **橙色(中)** | 🟠 | 概率中+影响中/高;或RPN 80~149 | 列入计划,限期处置 |
| **黄色(低)** | 🟡 | 概率低+影响低;或RPN<80 | 持续监控,定期复盘 |

---

## 二、风险登记表

> 共识别风险 **25 项**:技术类 9 / 采购类 4 / 进度类 3 / 质量类 3 / 安全类 3 / 外部类 3。其中红色(高)风险 **11 项**,橙色(中)风险 **12 项**,黄色(低)风险 **2 项**。

| 编号 | 风险描述 | 类别 | 触发条件 | 影响 | 概率 | 影响程度 | 风险等级 | 应对策略 | 应对措施 | 责任人 | 状态 | 目标关闭日期 | 跟踪记录 |
|---|---|---|---|---|---|---|---|---|---|---|---|---|---|
| R001 | NC球阀报警位V300.2/V300.3未置位(STL缺陷) | 技术 | FC30/FC31 NETWORK1 NC球阀动作时仅`S Q0.5/Q0.6`未置报警位 | 漫溢时HMI仅显示液位报警不显示NC球阀动作,运维误判;FMEA RPN=384(最高) | 高 | 严重 | 🔴红 | 减轻+修复 | FC30 NETWORK1补`S V300.2,1`;FC31 NETWORK1补`S V300.3,1`;FC3 NETWORK4/5补复位逻辑(FMEA P0立即修复) | PLC工程师 | 待修复 | 2026-07-25 | FMEA 5.1项1/2 P0;边界条件EXT-03 P0;故障代码字典预留接口 |
| R002 | FC4 Modbus通讯超时骨架未实现 | 技术 | FC4为骨架,无MBUS_MSG超时/Error处理;485接线断/泵掉电/干扰 | S3加药停滞等待无超时,或误判完成转S3.5;FMEA RPN=240 | 高 | 高 | 🔴红 | 减轻+修复 | FC4实现Done/Error/超时计数,连续失败N次→V303.4报警转S_ERROR;FC13增加VW4长时间无变化检测(FMEA P1高) | PLC工程师 | 待修复 | 2026-07-30 | FMEA 5.1项3;边界条件COM-01高风险 |
| R003 | ~~V303.6流量开关瞬时异常未实现~~ | 技术 | **2026-09-08已删除** | N/A | N/A | N/A | ✅已处理 | N/A | 三个流量开关各自有独立报警位(V301.0~V303.1)，不再需要汇总抖动检测 | PLC工程师 | **已删除** | 2026-09-08 | FMEA 5.1项14/15;边界条件SEN-03 |
| R004 | 3个VD编址冲突未修复(参数区步长冲突) | 技术 | VD18与VD20重叠(VB20~21);VD48与VD50重叠(VB50~51);VD96与VD98重叠(VB98~99) | 参数区写入污染,运算结果错误,可能导致状态机误转移 | 中 | 高 | 🔴红 | 修复+迁移 | 专用迭代重新规划参数区步长(VD10~VD140按4字节对齐);引入中间变量VD290~VD296;静态分析严重项#1~#3归零 | PLC工程师 | 待迭代 | 2026-08-15 | 静态分析严重#1/#2/#3;8个严重已修复5个剩余3个 |
| R005 | FC0跨日RTC计算缺陷 | 技术 | 断电跨越午夜,BCD转秒仅用当天秒数未补天数×86400 | VD_S5_Elapsed计算错误(负数或巨大值),S5实验时长累计失效 | 中 | 高 | 🔴红 | 修复+规避 | FC0 NETWORK4/5增加日期差换算(年月日→总天数×86400);或限制跨天转S_ERROR强制人工校时 | PLC工程师 | 待修复 | 2026-08-05 | 边界条件PWR-08/CLK-03高风险;FC0注释已承认此局限 |
| R006 | 静态分析225问题存量 | 技术 | 3严重+59警告(48跨FC写入+11参数区写入)+163提示(87对齐+73未定义+3未使用) | 代码质量隐患累积,后续维护成本上升,潜在运行时冲突 | 中 | 中 | 🟠橙 | 减轻+计划修复 | 发布前严重项归零;警告项按跨FC写入矩阵逐一确认互斥性;提示项分批整改 | PLC工程师 | 进行中 | 2026-08-20 | 静态分析报告v1.0;严重3/警告59/提示163 |
| R007 | 性能未实测(扫描周期/8连接并发) | 技术 | 8台PLC并发连接HMI,扫描周期与通讯负载未实测 | 实际运行可能扫描超时或HMI响应延迟,影响FAT/SAT验收 | 中 | 中 | 🟠橙 | 测试+验证 | 按性能基准测试方案v1.0执行扫描周期测试+8连接并发压测;HMI到货后实测 | 调试工程师 | 待测试 | 2026-09-15 | 性能基准测试方案v1.0已备;HMI未到货 |
| R008 | 48跨FC写入冲突(VB2被17FC/VB3被16FC写入) | 技术 | VB2/VB3状态字被多个FC写入,依赖调用顺序保证互斥 | 调用顺序变更或新增FC可能引入时序冲突,状态污染 | 中 | 中 | 🟠橙 | 减轻+评审 | 按静态分析跨FC写入矩阵逐一确认互斥性;OB1调用顺序固化(FC2>FC4>FC3>FC1);新增FC写入VB2/VB3须评审 | PLC工程师 | 进行中 | 2026-08-20 | 静态分析警告#1~#48;VB2=17FC/VB3=16FC |
| R009 | 阀B/阀C四态诊断缺延时确认 | 技术 | FC31/FC32子状态3"简化直接判定状态4",转移初期流量开关未ON瞬时 | 转移/排水刚开始瞬时误报故障,实验中断;FMEA RPN=180(B)/150(C) | 中 | 中 | 🟠橙 | 修复 | FC31/FC32子状态3增加2~3s确认延时,排除转移初期流量开关未ON瞬时(FMEA P1高) | PLC工程师 | 待修复 | 2026-07-30 | FMEA 5.1项6/16;边界条件VAL-05高风险 |
| R010 | HMI选型未定 | 采购 | 昆仑通态MCGS二轮确认7项未明确;厂商回复截止7/22 | 阻塞HMI采购与组态实施;若Q1~Q4不满足需切换备选方案 | 高 | 严重 | 🔴红 | 规避+决策 | 7/22厂商回复后48小时内完成选型决策;备选威纶通cMT-3092X/西门子KTP1200 Comfort;触发变更单AQEX-CHG-R | 项目经理 | 进行中 | 2026-07-27 | HMI选型问询单Q1~Q4;昆仑通态二轮确认问询单7项 |
| R011 | 整机采购未启动 | 采购 | 8台PLC+8套缸单元硬件+1台HMI均未下单 | 关键路径延误,首期1套调试节点与全量8套交付节点均受影响 | 高 | 严重 | 🔴红 | 规避+加速 | 选型确认后立即下达采购订单;长周期件优先下单;首期1套与全量8套分批采购 | 采购工程师 | 待启动 | 2026-07-30 | 备品备件清单v1.0;BOM清单v2 |
| R012 | 长周期进口件采购周期3~8周 | 采购 | 安全继电器3~6周(Pilz/Schmersal);CPU ST20 2~4周;电动球阀3~6周 | 关键器件到货晚于调试节点,现场无备件无法应对故障 | 高 | 高 | 🔴红 | 规避+提前备货 | 长周期件首批订单即翻倍备件量(A类要求);安全继电器备件1个先行采购;同步联系多家代理比价 | 采购工程师 | 待启动 | 2026-08-15 | 备品备件清单#9安全继电器A类3~6周;#1 CPU 2~4周;#15球阀3~6周 |
| R013 | 备品备件14项待确认 | 采购 | 备件清单中14项型号"待确认"(EM DT16/DR16选型/接触器/12V电源等) | 备件型号未定阻塞备件采购,故障时无适配备件 | 中 | 中 | 🟠橙 | 减轻+确认 | 控制柜方案与负载核算完成后确认14项型号;待确认项不影响首期1套调试的可延后 | 采购工程师 | 进行中 | 2026-08-10 | 备品备件清单v1.0 14项待确认 |
| R014 | HMI决策阻塞组态与FAT启动 | 进度 | HMI未定→组态工程无法启动→FAT用例中HMI相关项无法执行 | HMI组态工期压缩,FAT验收节点延误 | 高 | 高 | 🔴红 | 规避+并行 | 选型未定期间先完成选型无关材料(CSV模板/权限矩阵/线框图);HMI到货即启动组态;FAT用例HMI项标记待定 | HMI工程师 | 进行中 | 2026-08-30 | HMI准备材料11份中7份选型无关可并行 |
| R015 | 剩余3个VD冲突待专用迭代影响v1.0发布质量 | 进度 | 3个VD编址冲突需参数区整体迁移,工作量大 | v1.0发布带已知严重项,或延期至专用迭代完成 | 中 | 中 | 🟠橙 | 接受+计划 | v1.0发布说明已知问题列明3个VD冲突;专用迭代release-1.1修复后重新发布 | 项目经理 | 进行中 | 2026-08-15 | 静态分析严重#1~#3;变更等级L3 |
| R016 | 性能基准测试未执行影响SAT验收节点 | 进度 | 性能测试方案已备但硬件未到货,无法实测 | SAT验收时扫描周期/并发指标无实测数据,可能阻塞验收 | 中 | 中 | 🟠橙 | 规避+前置 | 硬件到货后立即执行性能基准测试;SAT前完成测试报告;不达标项触发优化迭代 | 调试工程师 | 待测试 | 2026-09-30 | 性能基准测试方案v1.0;SAT_FAT验收测试用例v1.0 |
| R017 | FMEA诊断覆盖率不足 | 质量 | 58失效模式中40%已覆盖/28%部分覆盖/32%未覆盖 | 32%未覆盖失效模式无诊断,现场故障不可探测,实验数据失真风险 | 高 | 高 | 🔴红 | 减轻+补强 | 按FMEA P0/P1路线图优先修复STL可实现的诊断;P2硬件改动项列入后续迭代 | PLC工程师 | 进行中 | 2026-08-30 | FMEA 4.1节;16项RPN≥150高风险 |
| R018 | 静态分析163提示(代码质量隐患) | 质量 | 87地址对齐+73未定义变量+3未使用变量 | 未定义变量可能运行时异常;地址对齐影响通讯效率 | 中 | 低 | 🟡黄 | 接受+计划 | 提示项不阻塞发布;分批在后续迭代整改;未定义变量优先补定义 | PLC工程师 | 待计划 | 2026-09-30 | 静态分析提示163个 |
| R019 | 注射泵步数精度未校验 | 质量 | FC13下发VD_Dose_Steps后无位置反馈核对;失步风险 | 加药量不准,浓度偏差,实验数据失效;FMEA RPN=192 | 中 | 中 | 🟠橙 | 修复 | FC13增加读取41007位置反馈(VW222)与VD_Dose_Steps核对,偏差超限→报警(FMEA P1高) | PLC工程师 | 待修复 | 2026-08-05 | FMEA 5.1项4;边界条件EXT-04 |
| R020 | 漫溢保护液位计无延时确认 | 安全 | FC30/FC31 NETWORK1 I0.5/I0.7直接触发,无TON滤波 | 浪涌/浮球弹跳误触漫溢报警,误关阀误转S_ERROR,实验中断 | 中 | 中 | 🟠橙 | 减轻+修复 | FC30/FC31 NETWORK1增加2~3s确认延时(TON),延时内持续ON才触发 | PLC工程师 | 待修复 | 2026-08-05 | 边界条件SEN-01/SEN-02中风险;FMEA P2中#14 |
| R021 | NC球阀无到位反馈DI | 安全 | NC球阀得电拒动作无反馈,故障不可探测;FMEA RPN=162 | NC球阀拒动作时第二道漫溢保护失效,漫溢风险 | 中 | 高 | 🟠橙 | 减轻+评估 | 评估DI点数余量(I2.2备用可用),增加NC球阀到位反馈DI;暂通过NC球阀报警位(R001修复后)间接提示 | PLC工程师 | 待评估 | 2026-09-15 | FMEA 5.1项11/12 P2中;备品备件#18 |
| R022 | S3加药中注射泵通讯中断无超时安全保护 | 安全 | COM-01:FC13轮询VW4无超时,通讯中断S3停滞或误判完成 | 加药量错误或实验停滞,注射泵可能停在半行程 | 高 | 高 | 🔴红 | 减轻+修复 | 依赖R002(FC4超时)修复;FC13增加下发指令后VW4长时间无变化检测;恢复后人工核查泵位置VW222 | PLC工程师 | 待修复 | 2026-07-30 | 边界条件COM-01高风险;PWR-03部分覆盖 |
| R023 | IP地址差异(.100 vs .10设计文档) | 外部 | 网络架构规划HMI IP=.100,PLC设计文档v9.3/变量表v12.1示例IP=.10 | 现场实施混淆,HMI或PLC配置错误IP导致通讯失败 | 中 | 中 | 🟠橙 | 规避+统一 | 以网络架构与IP规划v1.0为准(.100);PLC设计文档/变量表后续版本同步;现场实施前核对 | 网络工程师 | 进行中 | 2026-08-10 | 网络架构v1.0 1.2节差异说明 |
| R024 | Git LFS未配置/CHANGELOG未建立 | 外部 | 版本管理规范要求Git LFS跟踪.mwp/.sdfp/.pdf;CHANGELOG.md未建 | 大体积二进制文件污染仓库;版本变更无结构化记录 | 中 | 低 | 🟡黄 | 减轻+建立 | 配置.gitattributes跟踪.mwp/.sdfp/.pdf/.docx/.xlsx;建立CHANGELOG.md(Keep a Changelog风格) | 配置管理 | 待执行 | 2026-08-10 | PLC程序版本管理规范v1.0第8章;第7章 |
| R025 | 流量计溢出行为未确认 | 外部 | EXT-05:流量计累计值达99999999回绕行为待厂商确认;FC30差值法VD86-VD82 | 流量计回绕则差值为负,进水量判断失效,S1无限等待 | 中 | 中 | 🟠橙 | 规避+确认 | 向厂商确认溢出行为;FC30增加差值负数检测(VD90<0→报警/重新快照);定期人工复位流量计基准 | PLC工程师 | 待确认 | 2026-08-15 | 边界条件EXT-05高风险;设计文档第11章待确认事项4 |

---

## 三、红色风险(高风险)清单与详细应对计划

> 红色风险共 **11 项**,均为P0级缺陷、RPN≥150影响安全、或阻塞采购关键路径,须立即处置并由项目负责人每周跟踪。

### R001 — NC球阀报警位V300.2/V300.3未置位 🔴

| 项 | 内容 |
|---|---|
| 风险等级 | 红色(高)— FMEA RPN=384(全项目最高),P0立即修复 |
| 来源依据 | FMEA 5.1项1/2(P0);边界条件EXT-03(P0);故障代码字典预留接口 |
| 根因 | FC30 NETWORK1仅`S Q0.5,1`未`S V300.2,1`;FC31 NETWORK1仅`S Q0.6,1`未`S V300.3,1` |
| 影响 | 漫溢时NC球阀动作但HMI不显示NC球阀报警,运维人员误判仅液位报警,延误排查 |
| 应对计划 | ①FC30 NETWORK1补`S V300.2,1` ②FC31 NETWORK1补`S V300.3,1` ③FC3 NETWORK4/5补V300.2/V300.3复位条件(人工确认+阀恢复正常) ④校验报告回归 ⑤变更单AQEX-CHG-B |
| 责任人 | PLC工程师 |
| 目标关闭 | 2026-07-25 |
| 验证标准 | FC30/FC31置位逻辑通过;HMI报警字解析显示NC球阀动作报警码;FMEA复评RPN降至<80 |

### R002 — FC4 Modbus通讯超时骨架未实现 🔴

| 项 | 内容 |
|---|---|
| 风险等级 | 红色(高)— FMEA RPN=240,P1高 |
| 来源依据 | FMEA 5.1项3;边界条件COM-01高风险 |
| 根因 | FC4为骨架,引用数2/写入数0,无MBUS_MSG超时/Error处理 |
| 影响 | S3加药中通讯中断→VW4保持上次值停滞等待无超时,或VW4=0误判完成转S3.5 |
| 应对计划 | ①FC4实现Done/Error/超时计数(连续N次失败) ②超时→V303.4报警转S_ERROR ③FC13增加"下发指令后VW4长时间无变化"检测 ④Modbus通讯专项测试 |
| 责任人 | PLC工程师 |
| 目标关闭 | 2026-07-30 |
| 验证标准 | 模拟485断线,FC4在N周期内触发V303.4;HMI显示通讯中断报警;S3安全转S_ERROR |

### R003 — ~~V303.6流量开关瞬时异常未实现~~ **2026-09-08已删除**

| 项 | 内容 |
|---|---|
| 风险等级 | 红色(高)— FMEA RPN=200(B)/160(A),P1高 |
| 来源依据 | FMEA 5.1项14/15;边界条件SEN-03 |
| 根因 | **2026-09-08已删除**：三个流量开关各自有独立报警位，不再需要汇总抖动检测 |
| 影响 | 流量开关抖动导致FC30/31/32四态诊断瞬时误判,实验中断 |
| 应对计划 | **已删除** |
| 责任人 | PLC工程师 |
| 目标关闭 | 2026-07-30 |
| 验证标准 | N/A |

### R004 — 3个VD编址冲突未修复 🔴

| 项 | 内容 |
|---|---|
| 风险等级 | 红色(高)— 静态分析严重#1~#3 |
| 来源依据 | 静态分析报告严重项;8个严重已修复5个剩余3个 |
| 根因 | VD18/VD20(VB20~21重叠);VD48/VD50(VB50~51重叠);VD96/VD98(VB98~99重叠)参数区步长未按4字节对齐 |
| 影响 | 参数区写入污染,运算结果错误,可能导致状态机误转移 |
| 应对计划 | ①专用迭代release-1.1重新规划参数区步长(VD10~VD140按4字节对齐) ②引入中间变量VD290~VD296 ③静态分析严重项归零 ④变更等级L3,8台PLC同步下装 |
| 责任人 | PLC工程师 |
| 目标关闭 | 2026-08-15 |
| 验证标准 | 静态分析0严重;完整性校验V区无冲突;8台PLC同步下装验证 |

### R005 — FC0跨日RTC计算缺陷 🔴

| 项 | 内容 |
|---|---|
| 风险等级 | 红色(高)— 边界条件PWR-08/CLK-03高风险 |
| 来源依据 | 边界条件PWR-08/CLK-03;FC0 NETWORK4/5注释已承认局限 |
| 根因 | BCD转秒仅用"时×3600+分×60+秒"(当天秒数),未补天数×86400 |
| 影响 | 断电跨天则VD_S5_Elapsed计算错误(负数或巨大值),S5实验时长累计失效 |
| 应对计划 | ①FC0 NETWORK4/5增加日期差换算(年月日→总天数×86400) ②或限制跨天转S_ERROR强制人工校时 ③跨天场景专项测试 |
| 责任人 | PLC工程师 |
| 目标关闭 | 2026-08-05 |
| 验证标准 | 模拟跨天断电恢复,VD_S5_Elapsed计算正确;或跨天安全转S_ERROR |

### R010 — HMI选型未定 🔴

| 项 | 内容 |
|---|---|
| 风险等级 | 红色(高)— 阻塞采购与组态 |
| 来源依据 | HMI选型技术问询单Q1~Q4;昆仑通态MCGS二轮确认问询单7项 |
| 根因 | 昆仑通态MCGS原生Modbus为主,S7协议8连接需确认;厂商二轮回复截止7/22 |
| 影响 | 阻塞HMI采购与组态实施;若Q1~Q4不满足需切换备选方案,工期延误 |
| 应对计划 | ①7/22厂商回复后48小时内完成选型决策 ②备选威纶通cMT-3092X(12寸)/西门子KTP1200 Comfort(支持脚本) ③触发变更单AQEX-CHG-R ④选型未定期间推进选型无关材料 |
| 责任人 | 项目经理 |
| 目标关闭 | 2026-07-27 |
| 验证标准 | 选型决策书签发;Q1(8连接)/Q2(728点)/Q3(脚本)/Q4(存储)全部满足 |

### R011 — 整机采购未启动 🔴

| 项 | 内容 |
|---|---|
| 风险等级 | 红色(高)— 关键路径 |
| 来源依据 | 备品备件清单v1.0;BOM清单v2;项目交付文档总索引11.3硬件交付待采购 |
| 根因 | HMI未定+采购流程未启动;8台PLC+8套缸单元硬件+1台HMI均未下单 |
| 影响 | 首期1套调试节点与全量8套交付节点均受影响 |
| 应对计划 | ①HMI选型确认后立即下达采购订单 ②长周期件优先下单 ③首期1套与全量8套分批采购 ④备品备件A类同步采购 |
| 责任人 | 采购工程师 |
| 目标关闭 | 2026-07-30(订单下达) |
| 验证标准 | 采购订单签发;长周期件到货计划纳入进度表 |

### R012 — 长周期进口件采购周期3~8周 🔴

| 项 | 内容 |
|---|---|
| 风险等级 | 红色(高)— 采购关键路径 |
| 来源依据 | 备品备件清单#1(CPU 2~4周)/#9(安全继电器3~6周)/#15(球阀3~6周) |
| 根因 | 进口件采购周期长,现场无备件无法应对故障 |
| 影响 | 关键器件到货晚于调试节点;故障时无备件导致长时间停机 |
| 应对计划 | ①首批订单即翻倍备件量(A类要求) ②安全继电器备件1个先行采购 ③同步联系多家代理比价 ④国产替代方案评估 |
| 责任人 | 采购工程师 |
| 目标关闭 | 2026-08-15(备件到货) |
| 验证标准 | A类备件现场常备1套;长周期件订单确认交期 |

### R014 — HMI决策阻塞组态与FAT启动 🔴

| 项 | 内容 |
|---|---|
| 风险等级 | 红色(高)— 进度阻塞 |
| 来源依据 | HMI准备材料11份;SAT_FAT验收测试用例v1.0 |
| 根因 | HMI未定→组态工程无法启动→FAT用例HMI相关项无法执行 |
| 影响 | HMI组态工期压缩,FAT验收节点延误 |
| 应对计划 | ①选型未定期间先完成选型无关材料(CSV模板/权限矩阵/线框图/报警映射表) ②HMI到货即启动组态 ③FAT用例HMI项标记待定 ④组态实施指南按MCGS先行准备 |
| 责任人 | HMI工程师 |
| 目标关闭 | 2026-08-30 |
| 验证标准 | HMI组态工程启动;FAT用例HMI项可执行 |

### R017 — FMEA诊断覆盖率不足 🔴

| 项 | 内容 |
|---|---|
| 风险等级 | 红色(高)— 质量系统性风险 |
| 来源依据 | FMEA 4.1节(58失效模式,40%已覆盖/28%部分/32%未覆盖);16项RPN≥150 |
| 根因 | STL骨架阶段部分诊断未实现;部分失效模式无诊断设计 |
| 影响 | 32%未覆盖失效模式无诊断,现场故障不可探测,实验数据失真风险 |
| 应对计划 | ①按FMEA P0/P1路线图优先修复STL可实现的诊断(R001/R002/R003/R009/R019) ②P2硬件改动项(漏水检测/NC球阀反馈/液位计冗余)列入后续迭代 ③未覆盖项纳入现场调试SOP人工巡检 |
| 责任人 | PLC工程师 |
| 目标关闭 | 2026-08-30 |
| 验证标准 | P0/P1项全部修复;未覆盖率降至<20%;FMEA复评 |

### R022 — S3加药中注射泵通讯中断无超时安全保护 🔴

| 项 | 内容 |
|---|---|
| 风险等级 | 红色(高)— 安全风险 |
| 来源依据 | 边界条件COM-01高风险;PWR-03部分覆盖 |
| 根因 | FC13轮询VW4无超时,通讯中断S3停滞或误判完成;依赖R002(FC4超时)修复 |
| 影响 | 加药量错误或实验停滞,注射泵可能停在半行程,实验数据失效 |
| 应对计划 | ①依赖R002(FC4超时)修复 ②FC13增加下发指令后VW4长时间无变化检测 ③恢复后人工核查泵位置VW222,必要时手动复位泵(40003) ④S3通讯中断专项测试 |
| 责任人 | PLC工程师 |
| 目标关闭 | 2026-07-30 |
| 验证标准 | 模拟S3加药中485断线,FC13安全转S_ERROR;HMI显示通讯中断报警 |

---

## 四、风险分类汇总

| 类别 | 风险数 | 红色 | 橙色 | 黄色 | 风险编号 |
|---|---|---|---|---|---|
| 技术 | 9 | 5 | 4 | 0 | R001~R009 |
| 采购 | 4 | 3 | 1 | 0 | R010~R013 |
| 进度 | 3 | 1 | 2 | 0 | R014~R016 |
| 质量 | 3 | 1 | 1 | 1 | R017~R019 |
| 安全 | 3 | 1 | 2 | 0 | R020~R022 |
| 外部 | 3 | 0 | 2 | 1 | R023~R025 |
| **合计** | **25** | **11** | **12** | **2** | — |

> 说明:本册橙色风险12项(R006/R007/R008/R009/R013/R015/R016/R019/R020/R021/R023/R025),黄色风险2项(R018/R024)。红色风险11项已在第三章详列。

---

## 五、风险趋势分析

### 5.1 本期(2026-07-18)风险态势

- **风险总量**: 25项,其中红色11项(44%)、橙色12项(48%)、黄色2项(8%)
- **风险集中域**: 技术类(9项,36%)与采购类(4项,16%)合计占52%,反映当前项目处于"代码完成待修复+硬件待采购"的过渡期
- **安全相关风险**: R001/R020/R021/R022共4项涉及漫溢/NC球阀/注射泵安全功能,其中R001(P0,RPN=384)为全项目最高风险
- **采购关键路径**: R010/R011/R012/R013四项采购风险互为依赖,HMI未定(R010)是采购链的源头阻塞点

### 5.2 风险趋势(近3周)

| 周次 | 新增风险 | 关闭风险 | 红色风险数 | 趋势说明 |
|---|---|---|---|---|
| W28(7/7~7/13) | — | — | — | PLC代码Story 1.7完成,2轮校验修复10问题,8严重VD冲突修复5个 |
| W29(7/14~7/18) | +25(本期首次识别) | 0 | 11 | 静态分析+FMEA+边界条件三报告发布,系统性识别风险;HMI二轮问询发出 |
| W30(7/19~7/25,预测) | 预计+2~3 | 预计R001关闭 | 预计10 | HMI厂商7/22回复;R001(NC球阀报警)计划7/25修复;采购订单预计下达 |

### 5.3 风险演化预判

- **预计上升风险**: R007(性能未实测)在硬件到货后转为可测试状态,若实测不达标将升级;R021(NC球阀反馈)在DI点数评估后若余量不足将升级
- **预计下降风险**: R010/R011/R012采购风险在订单下达后逐步降级;R001/R002/R003在STL修复后降为橙色
- **新增风险预警**: HMI选型确认后可能新增组态实施风险;性能测试后可能新增扫描周期优化风险

---

## 六、下周(2026-07-19~2026-07-25)关注重点

### 6.1 必须完成项(P0)

| 优先级 | 风险编号 | 任务 | 责任人 | 截止日期 |
|---|---|---|---|---|
| P0 | R001 | FC30/FC31补`S V300.2/V300.3,1`+FC3复位逻辑(NC球阀报警P0修复) | PLC工程师 | 2026-07-25 |
| P0 | R010 | 7/22 HMI厂商回复后48小时内完成选型决策 | 项目经理 | 2026-07-24 |
| P0 | R011 | HMI选型确认后立即下达整机采购订单 | 采购工程师 | 2026-07-30 |

### 6.2 重点推进项(P1)

| 优先级 | 风险编号 | 任务 | 责任人 | 截止日期 |
|---|---|---|---|---|
| P1 | R002 | FC4实现Modbus通讯超时检测+V303.4报警 | PLC工程师 | 2026-07-30 |
| ~~P1~~ | ~~R003~~ | ~~FC30/31/32增加V303.6流量开关抖动检测~~ | PLC工程师 | **2026-09-08已删除** |
| P1 | R009 | FC31/FC32四态诊断增加2~3s延时确认 | PLC工程师 | 2026-07-30 |
| P1 | R022 | FC13增加VW4长时间无变化检测(依赖R002) | PLC工程师 | 2026-07-30 |
| P1 | R013 | 启动备品备件14项待确认型号核实 | 采购工程师 | 2026-08-10 |

### 6.3 持续跟踪项

- R004:启动专用迭代release-1.1规划参数区步长迁移方案
- R005:FC0跨日RTC修复方案设计
- R014:HMI组态选型无关材料并行推进(CSV模板/权限矩阵/线框图)
- R017:FMEA P0/P1路线图按周跟踪修复进度

### 6.4 风险复盘机制

- **每周一项目例会**: 红色风险逐项复盘,更新状态与跟踪记录
- **每周五风险周报**: 本册更新版本号(v1.0→v1.1...),归档至`docs/achieve/risk/`
- **红色风险变更触发**: 任何红色风险状态变更(新增/关闭/升级/降级)24小时内通知项目负责人
- **变更单关联**: 风险应对措施涉及代码/参数变更的,必须走变更管理流程(变更单AQEX-CHG-B/R/P/E),变更等级按变更管理流程v1.0第1.3节判定

---

## 七、风险登记册维护规则

| 项 | 规则 |
|---|---|
| 更新频率 | 每周至少1次(每周五);红色风险状态变更即时更新 |
| 版本号 | vX.Y,X=结构性重构,Y=风险增减/状态变更 |
| 风险编号 | R001~R999顺序编号,不复用;关闭风险保留编号标注"已关闭" |
| 来源追溯 | 每项风险必须引用具体报告问题编号(静态分析#/校验P#/FMEA项/边界条件XXX) |
| 关联文档 | FMEA失效模式分析v1.0、边界条件与异常场景清单v1.0、PLC代码静态分析报告v1.0、PLC代码完整性校验报告v1.0 |
| 归档 | 历史版本存于`docs/achieve/risk/项目风险登记册_vX.Y_<date>.md` |

---

**文档版本**: v1.0
**编制日期**: 2026-07-18
**下次更新**: 2026-07-25(每周五风险周报)
**审批人**: 项目负责人
