Yustnust/AQUA-EXPO/docs/SAT_FAT验收测试用例_v1.0.md

# 药液配置加注控制系统 — SAT/FAT 验收测试用例 v1.2

| 项目 | 内容 |
|---|---|
| 文档名称 | SAT/FAT验收测试用例 |
| 版本号 | v1.2 |
| 适用范围 | **单套缸单元**（8套架构中任一套，PLC程序完全相同，仅IP地址不同） |
| PLC型号 | 西门子 S7-200 SMART CPU ST20 + EM DT16/DR16 |
| 编制日期 | 2026-07-15 |
| 修订日期 | 2026-08-27 |
| 修订日期 | 2026-08-27 |
| 修订内容 | 第四章新增 v1.1 S4 互锁相关测试用例(TC-04-013 ~ TC-04-017);S4 互锁逻辑见 FC15 NETWORK1 `AN V1.7` |
| 配套文档 | 《药液配置加注控制系统_PLC设计文档》v9.3;《HMI-PLC变量地址表》v1.0;Story1.2~1.7 程序设计规格书 v1.0(Story1.2 已升级到 v1.1) |
| 测试对象 | 已完成 Story 1.2（状态机骨架）、1.3（阀门诊断）、1.4（节奏纠偏）、1.5（急停详细）、1.6（报警详细）、1.7（断电恢复）六个迭代交付的PLC程序 |
| 测试目的 | 用于工厂验收（FAT）与现场验收（SAT），验证PLC控制逻辑符合设计规格，可交付客户与调试团队使用 |

---

## 第一章 测试总则

### 1.1 FAT 与 SAT 区别与范围界定

| 项目 | FAT（Factory Acceptance Test，工厂验收） | SAT（Site Acceptance Test，现场验收） |
|---|---|---|
| 执行地点 | 设备制造厂内（PLC厂内测试台） | 客户现场（缸体设备就位后） |
| 执行时机 | 设备出厂前 | 现场安装接线完成后 |
| 负载情况 | **无真实负载**，DI用信号发生器/短接线/状态图表强制模拟，DO用万用表/继电器指示灯监测 | **带真实负载**，阀门/泵/流量计/注射泵/液位计全部接入 |
| 测试重点 | PLC程序逻辑正确性、I/O映射、状态机、报警/急停/断电恢复逻辑 | 现场设备动作正确性、Modbus通讯、长时稳定性、真实工艺流程 |
| Modbus从站 | 可用模拟从站软件（Modbus Slave）替代 | 真实注射泵+流量计 |
| 通过判据 | 全部【必测】项通过 + 严重问题0个 | 全部【必测】项通过 + 严重问题0个 |
| 备注 | FAT通过的必测项在SAT可标记为【回归】复测 | SAT新增现场设备联动测试 |

### 1.2 测试通过判据

1. **必测项全通过**：所有标记为【必测】的用例必须全部通过，任一不通过即拒收。
2. **严重问题0个**：测试中发现的严重问题（导致安全功能失效、状态机死锁、急停失效等）数量为0。
3. **选测项记录**：【选测】项不通过不影响交付，但需记录在测试报告中，后续版本修复。
4. **回归项说明**：【回归】项为FAT已在厂内通过、SAT现场复测的用例，确保现场环境无回归。
5. **单项通过判定**：用例期望结果中列出的所有VW/Q/I/V变量值均与实测一致，方判定该用例通过；任一不符即判失败。

### 1.3 测试设备清单

| 序号 | 设备名称 | 用途 | FAT必需 | SAT必需 |
|---|---|---|---|---|
| 1 | STEP 7-Micro/WIN SMART 编程软件（含状态图表功能） | PLC程序下装、变量监控、强制V/I变量模拟DI | 是 | 是 |
| 2 | 编程PC（以太网口） | 连接PLC CPU本体以太网口，IP同网段（192.168.2.x） | 是 | 是 |
| 3 | MCGS HMI 触摸屏（或同等S7-200 SMART驱动兼容屏） | 模拟HMI下发命令位V0.x、读状态、报警确认 | 是 | 是 |
| 4 | 信号发生器/短接线（DI模拟） | 模拟常开/常闭触点闭合断开 | 是 | 否（用真实传感器） |
| 5 | 数字万用表 | 检测DO继电器触点通断、24VDC电平 | 是 | 是 |
| 6 | 模拟量输入板/Modbus从站模拟软件 | 模拟注射泵（40002/3/6/7/41001）与流量计（0x0009）寄存器 | 是 | 否（用真实设备） |
| 7 | 24VDC稳压电源 | 提供PLC DI回路电源（模拟时） | 是 | 否（PLC自带） |
| 8 | 急停按钮+安全继电器组件（强制导向型） | 测试急停双通道与反馈 | 是 | 是 |
| 9 | 秒表/计时器 | 校验T35（2秒）、阀门超时等延时 | 是 | 是 |
| 10 | 系统复位按钮+消音按钮（点动） | 测试I0.3/I0.4 | 是 | 是 |
| 11 | 中间继电器组（阀门限位反馈转换用） | 模拟I8.0~I8.5有源信号转无源 | 是 | 是 |
| 12 | RS485通讯测试仪（可选） | 监听Modbus RTU报文 | 选 | 选 |

### 1.4 严重等级定义

| 等级 | 含义 | 处理要求 |
|---|---|---|
| 【必测】 | 不通过则拒收。涉及安全（急停/漫溢/继电器故障）、状态机主线、I/O映射、断电恢复等核心功能 | 必须通过，失败即拒收 |
| 【选测】 | 不影响交付。涉及监测类、提示类、边界场景 | 记录即可，后续版本修复 |
| 【回归】 | 回归测试用。FAT已通过项在SAT现场复测 | 现场环境验证无回归 |

---

## 第二章 测试前置条件

### 2.1 通用前置条件（FAT/SAT均需）

| 序号 | 前置条件 | 验证方法 |
|---|---|---|
| 1 | PLC程序已下装且编译无错误 | STEP 7-Micro/WIN SMART 编译→下装→PLC RUN指示灯绿色 |
| 2 | PLC系统块已配置断电保持区（VB0~VB9/VB10~VB149/VB150~VB199/VB200~VB229/VB300~VB304/VB500~VB599/DT10） | 系统块→断电保持范围核对 |
| 3 | PLC IP地址已配置（示例192.168.2.101，单套测试用1号） | 编程PC ping通PLC IP |
| 4 | HMI工程已下装，与PLC通讯正常（HMI总览页能读到VW2状态） | HMI显示PLC在线，状态值刷新 |
| 5 | 急停回路接线完成：急停按钮第一组常闭→安全继电器输入；第二组常闭→PLC I1.1（24VDC独立回路） | 万用表测I1.1正常时=ON |
| 6 | 安全继电器辅助反馈触点→PLC I1.2 接线完成 | 万用表测I1.2 |
| 7 | 系统复位按钮(I0.3)、消音按钮(I0.4)接线完成 | 按下时I0.3/I0.4变ON |
| 8 | 9个DO均经继电器驱动负载（不直接接负载），继电器线圈受Q0.0~Q8.0控制 | 目视接线+万用表测继电器触点 |
| 9 | 6个阀门限位反馈(I8.0~I8.5)经中间继电器转换后接入 | 万用表测转换后电平 |
| 10 | RS485总线接注射泵+流量计（FAT可用模拟从站） | Modbus通讯维护页可读寄存器 |

### 2.2 FAT 专用前置条件

| 序号 | 前置条件 |
|---|---|
| 1 | DI模拟：流量开关/液位计用短接线或状态图表强制对应I点；阀门限位反馈用继电器板模拟 |
| 2 | DO检测：Q0.0~Q8.0接继电器线圈+指示灯，万用表测触点通断 |
| 3 | Modbus从站：用Modbus Slave软件配置注射泵（站号x）和流量计（站号y），预置寄存器值 |
| 4 | RTC校准：用SET_RTC指令设置PLC当前时间正确 |

### 2.3 SAT 专用前置条件

| 序号 | 前置条件 |
|---|---|
| 1 | 上缸/下缸玻璃缸就位，纯净水管路接通 |
| 2 | 电动球阀A/B/C、潜水泵1/2、NC球阀上/下缸、注射泵全部安装就位并通电 |
| 3 | 流量开关A/B/C、液位计A高/低位、液位计B高/低位全部安装 |
| 4 | RS485总线接真实注射泵+流量计，站号/波特率与PLC配置一致 |
| 5 | HMI触摸屏现场安装，以太网接交换机 |
| 6 | 急停按钮、系统复位按钮、消音按钮现场面板安装 |

---

## 第三章 DI/DO 点位强制测试

**测试目的**：逐点验证17个DI和9个DO的物理接线和PLC内部映射正确性。
**通用方法**：DI用物理操作/短接触发，观察STEP 7状态图表对应I点状态；DO用状态图表强制Q点或程序触发，万用表测继电器触点。

### 3.1 DI 点位测试（17点）

| 用例ID | 地址 | 符号 | 测试方法 | 期望结果 | 实测 | 通过/失败 | 严重等级 |
|---|---|---|---|---|---|---|---|
| TC-03-001 | I0.0 | DI_FlowSwitch_A | 短接流量开关A触点（模拟有水流） | 状态图表I0.0=ON；断开后I0.0=OFF | | | 【必测】 |
| TC-03-002 | I0.1 | DI_FlowSwitch_B | 短接流量开关B触点 | I0.1随短接ON/OFF变化 | | | 【必测】 |
| TC-03-003 | I0.2 | DI_FlowSwitch_C | 短接流量开关C触点 | I0.2随短接ON/OFF变化 | | | 【必测】 |
| TC-03-006 | I0.5 | DI_LevelA_High | 短接液位计A-高位（模拟上缸漫溢） | I0.5=ON；触发后V300.0应置位（漫溢报警） | | | 【必测】 |
| TC-03-007 | I0.6 | DI_LevelA_Low | 短接液位计A-低位（模拟上缸排空） | I0.6=ON/OFF随短接变化 | | | 【必测】 |
| TC-03-008 | I0.7 | DI_LevelB_High | 短接液位计B-高位（模拟下缸漫溢） | I0.7=ON；V300.1应置位 | | | 【必测】 |
| TC-03-009 | I1.0 | DI_LevelB_Low | 短接液位计B-低位（模拟下缸排空） | I1.0=ON/OFF随短接变化 | | | 【必测】 |
| TC-03-010 | I1.1 | DI_EStop | 按下急停按钮（常闭断开） | I1.1=OFF；V300.4置位，VW2=99 | | | 【必测】 |
| TC-03-011 | I1.2 | DI_SafetyRelay_FB | 急停触发后安全继电器辅助触点反馈 | I1.2=ON（动力回路已断开确认） | | | 【必测】 |
| TC-03-012 | I8.0 | DI_ValveA_Open | 经继电器模拟阀A开到位有源信号 | I8.0=ON/OFF随模拟变化 | | | 【必测】 |
| TC-03-013 | I8.1 | DI_ValveA_Close | 经继电器模拟阀A关到位有源信号 | I8.1=ON/OFF随模拟变化 | | | 【必测】 |
| TC-03-014 | I8.2 | DI_ValveB_Open | 经继电器模拟阀B开到位 | I8.2=ON/OFF随模拟变化 | | | 【必测】 |
| TC-03-015 | I8.3 | DI_ValveB_Close | 经继电器模拟阀B关到位 | I8.3=ON/OFF随模拟变化 | | | 【必测】 |
| TC-03-016 | I8.4 | DI_ValveC_Open | 经继电器模拟阀C开到位 | I8.4=ON/OFF随模拟变化 | | | 【必测】 |
| TC-03-017 | I8.5 | DI_ValveC_Close | 经继电器模拟阀C关到位 | I8.5=ON/OFF随模拟变化 | | | 【必测】 |
| TC-03-018 | I0.4 | DI_Btn_Mute | 按下消音按钮（点动） | I0.4=ON瞬间触发，Q0.7=0（声音关） | | | 【必测】 |
| TC-03-019 | I0.3 | DI_Btn_SystemReset | 按下系统复位按钮（点动） | I0.3=ON上升沿（急停态下清除V300.4回S0） | | | 【必测】 |

### 3.2 DO 点位测试（9点）

**测试方法**：在STEP 7状态图表中强制Q点=1/0（需在PLC STOP或程序允许时），万用表测对应继电器触点通断；或通过HMI手动控制页触发。

| 用例ID | 地址 | 符号 | 测试方法 | 期望结果 | 实测 | 通过/失败 | 严重等级 |
|---|---|---|---|---|---|---|---|
| TC-03-020 | Q0.0 | DO_Pump1 | 状态图表强制Q0.0=1 | 继电器1触点闭合，万用表通；Q0.0=0时断开 | | | 【必测】 |
| TC-03-021 | Q0.1 | DO_Pump2 | 状态图表强制Q0.1=1 | 继电器2触点闭合；=0时断开 | | | 【必测】 |
| TC-03-022 | Q0.2 | DO_ValveA | 状态图表强制Q0.2=1 | 阀A继电器触点闭合（S1开阀）；=0关闭 | | | 【必测】 |
| TC-03-023 | Q0.3 | DO_ValveB | 状态图表强制Q0.3=1 | 阀B继电器触点闭合（S4转移）；=0关闭 | | | 【必测】 |
| TC-03-024 | Q0.4 | DO_ValveC | 状态图表强制Q0.4=1 | 阀C继电器触点闭合（S6排水）；=0关闭 | | | 【必测】 |
| TC-03-025 | Q0.5 | DO_NCValve_Top | 状态图表强制Q0.5=1 | NC球阀上缸继电器闭合（得电打开）；=0失电关闭（安全） | | | 【必测】 |
| TC-03-026 | Q0.6 | DO_NCValve_Bottom | 状态图表强制Q0.6=1 | NC球阀下缸继电器闭合；=0失电关闭（安全） | | | 【必测】 |
| TC-03-027 | Q0.7 | DO_Alarm_Sound | 触发任一报警（如强制V301.0=1） | Q0.7=1（蜂鸣器响）；按I0.4消音后Q0.7=0 | | | 【必测】 |
| TC-03-028 | Q8.0 | DO_Alarm_Light | 触发任一报警（如强制V300.0=1） | Q8.0=1（灯光常亮）；报警确认且VW6=0后Q8.0=0 | | | 【必测】 |

---

## 第四章 Story 1.2 状态机验收测试

**测试目的**：验证S0→S1→S2→S3→S3.5→S4→S5→S6→S7完整流程模拟，及S_ERROR状态与非法状态处理。
**关联Story**：Story 1.2 状态机骨架。
**通用前置**：PLC程序已下装RUN，HMI通讯正常，无活动报警。

| 用例ID | 测试项目 | 前置条件 | 测试步骤 | 期望结果 | 严重等级 | 关联Story |
|---|---|---|---|---|---|---|
| TC-04-001 | S0初始化动作 | PLC上电冷启动（V304.0=0）或急停复位后 | ①观察VW2、V1.6、V1.7、QB0、V300.4、VB300~303、VW6、V1.0~V1.5、VW8 | VW2=0；V1.6=0（上缸空）；V1.7=0（下缸空）；QB0=0；V300.4=0；VB300~303=0；VW6=0；V1.0~V1.5=0；VW8=0 | 【必测】 | 1.2 |
| TC-04-002 | S0→S1启动转移 | VW2=0，无活动报警 | ①HMI下发CMD_Start（强制V0.0=1上升沿） | VW2=1（S1）；V1.0=1（启动握手）；Q0.2=1（阀A开）；VD82=流量计当前值（快照） | 【必测】 | 1.2 |
| TC-04-003 | S1→S2进水完成转移 | VW2=1，阀A开启中 | ①模拟流量计累计值增长使VD90≥目标进水量 ②模拟I8.0开到位ON、I0.0流量开关A ON ③模拟关阀后I8.1关到位ON、I0.0 OFF | 关阀Q0.2=0；延时验证通过后VW2=2（S2）；V1.6=1（上缸满）；VD70=实测S1时长 | 【必测】 | 1.2 |
| TC-04-004 | S2→S3预循环完成转移 | VW2=2，潜水泵运行中 | ①等待T38≥VD_S2_Target | Q0.0=0、Q0.1=0（泵停）；VW2=3（S3）；VW204/VW206写入抽/排液步数 | 【必测】 | 1.2 |
| TC-04-005 | S3→S3.5加药完成转移 | VW2=3，注射泵动作中 | ①模拟Modbus从站41001状态码：先2（抽液）→3（排液）→0（完成） | VW4=0时VW2=4（S3.5）；T39开始计时 | 【必测】 | 1.2 |
| TC-04-006 | S3.5→S4静止等候完成转移 | VW2=4，T39计时中 | ①等待T39≥VD_RestTime_Target | VW2=5（S4）；Q0.3=1（阀B开）；V1.6=0（上缸开始排空） | 【必测】 | 1.2 |
| TC-04-007 | S4→S5转移完成转移 | VW2=5，阀B开启中 | ①模拟I8.2开到位ON、I0.1流量开关B ON（正常转移） ②模拟I0.6液位计A低位ON且I0.1 OFF（上缸排空） ③模拟I8.3关到位ON | Q0.3=0（阀B关）；VW2=6（S5）；V1.7=1（下缸满）；DT10写入下缸变满时间戳；VD178=0（VD_S5_Elapsed清零） | 【必测】 | 1.2 |
| TC-04-008 | S5→S6换水周期到达转移 | VW2=6，下缸满 | ①模拟VD_S5_Elapsed累加至≥VD_CycleSetpoint×60 | VW2=7（S6）；Q0.4=1（阀C开）；T42开始计时 | 【必测】 | 1.2 |
| TC-04-009 | S6→S5排水完成返回 | VW2=7，阀C开启中 | ①模拟I1.0液位计B低位ON且I0.2 OFF（下缸排空） ②模拟I8.5关到位ON | Q0.4=0（阀C关）；VW2=6（S5）；V1.7=0（下缸空）；VD78=实测S6时长；VD116滚动更新 | 【必测】 | 1.2 |
| TC-04-010 | S5→S7实验时长达标结束 | VW2=6，VD96累加接近VD_ExperimentTarget | ①模拟VD_ExperimentDuration_Accum累加至≥VD_ExperimentTarget | VW2=8（S7）；QB0=0（所有输出停）；VD96锁定最终值 | 【必测】 | 1.2 |
| TC-04-011 | S7→S0 HMI确认重启 | VW2=8，实验结束 | ①HMI下发CMD_Start（V0.0=1上升沿） | VW2=0（S0）；系统重新初始化等待新实验 | 【必测】 | 1.2 |
| TC-04-012 | 非法状态值强制回S0 | VW2=任意有效态 | ①状态图表强制VW2=50（非法值） | 下一扫描周期VW2=0（FC1 ELSE分支强制回S0） | 【必测】 | 1.2 |

**v1.1 新增 — S4 下缸空互锁测试用例(基于 FC15 NETWORK1 `AN V1.7`)**

| 用例编号 | 测试项 | 初始条件 | 操作步骤 | 预期结果 | 类别 | 关联Story |
|---|---|---|---|---|---|---|
| TC-04-013 | S4 入口下缸非空静默等待(不报错) | VW2=5（S4），V1.7=1（下缸满） | ①状态图表强制VW2=5 ②监控Q0.3、Q0.6、V1.6、T40、VB262、Q0.0/Q0.1 | Q0.3=0、Q0.6=0（阀B/NC球阀-下缸未开）、T40不计时、VB262=0（未启动诊断）、Q0.0/Q0.1不受影响；FC31 NETWORK2 调度的子状态 VW262=0 走空转路径 | 【必测】 | 1.2 v1.1 |
| TC-04-014 | S4 等待期间下缸排空自动开阀 | 在 TC-04-013 基础上 | ①继续监控 ②手动 `R V1.7,1` 模拟 S6 排空完成 | 下一扫描周期：Q0.3=1、Q0.6=1（阀B+NC球阀-下缸得电导通）、T40开始计时、VB262=1（启动阀B诊断）、VW268清零 | 【必测】 | 1.2 v1.1 |
| TC-04-015 | S4 静默等待期间节拍保持(S1~S3.5可并行) | VW2=5（S4），V1.7=1，S5 已触发预规划 | ①监控M10.7、VD150、VD178 ②等待FC16预规划条件满足 | M10.7 锁存生效,FC16 预规划转 S1(VW2=1)成功,上缸配液启动;此时 VW2 变为 1,S4 暂停(S4逻辑在 VW2=5 才生效) | 【必测】 | 1.2 v1.1 |
| TC-04-016 | S4 静默等待期间漫溢保护仍生效 | VW2=5（S4），V1.7=1 | ①模拟 I0.7=ON（液位计B高位） | FC31 NETWORK1 立即触发：V300.1=1、S Q0.6,1（注:FC31 NET1 是 S 不是 R,即得电打开以切断水流）、R Q0.3,1（关阀B）、VW2=99（S_ERROR）、VB268=2（故障） | 【必测】 | 1.2 v1.1 |
| TC-04-017 | S4 入口下缸空直接转液（无等待） | VW2=5（S4），V1.7=0（下缸空） | ①状态图表强制VW2=5 同时确保V1.7=0 | 立即开阀B：Q0.3=1、Q0.6=1、T40计时、VB262=1;与 v1.0 行为一致 | 【必测】 | 1.2 v1.1 |

**v1.2 新增 — S4 等待计时 + 超时报警 + 阈值补偿测试用例(基于 FC15 NETWORK 1 v1.2 等待计时分支 + FC16 NETWORK 4 v1.2 阈值补偿)**

| 用例编号 | 测试项 | 初始条件 | 操作步骤 | 预期结果 | 类别 | 关联Story |
|---|---|---|---|---|---|---|
| TC-04-018 | S4 等待期间 VD_S4Wait_Time 累加 | VW2=5(S4),V1.7=1 | ①监控 VD380、T61、T62 ②等待 30s | VD380 从 0 累加到 30;T61 计时(但未到 PT=18000=30min);T62 每 1s 脉冲 +1 | 【必测】 | 1.2 v1.2 |
| TC-04-019 | S4 等待超时报警触发 | 在 TC-04-018 基础上 | ①将 VD382(VD_S4WaitTimeout)HMI 设定为 30s ②等待 30s+ | T61 到 → V303.2=1;VW6=49;**不强制 S_ERROR**;V2(状态机)仍=5;FC15 继续等待 | 【必测】 | 1.2 v1.2 |
| TC-04-020 | FC16 转 S6 阈值补偿(下缸有效实验时间不被 S4 等待压缩) | S4 等待 10min 后 S4 完成,转 S5,新 VD_S5_Elapsed=0 | ①新 S5 中 VD178 累加 ②监控 VW6、状态机 | 假设 CycleSetpoint=60min,VD380=600(10min):VD178 累加到 50min(即 60×60-600=3000s)即触发转 S6;而非 60min 触发;下缸有效实验时间严格 60min(50min 跑实验 + 10min 等待已补偿) | 【必测】 | 1.2 v1.2 |

---

## 第五章 Story 1.3 阀门诊断验收测试

**测试目的**：验证阀A/B/C四态诊断、限位反馈交叉诊断、内漏检测、超时保护等异常场景。
**关联Story**：Story 1.3 阀门诊断。
**通用前置**：PLC RUN，无活动报警，阀门诊断参数(VD48/50/54/58/62/66)已配置。

| 用例ID | 测试项目 | 前置条件 | 测试步骤 | 期望结果 | 严重等级 | 关联Story |
|---|---|---|---|---|---|---|
| TC-05-001 | 阀A开到位超时报警 | VW2=1，阀A开启中，VD_Timeout_ValveA=60s | ①开阀A(Q0.2=1) ②T50计时内I8.0保持OFF（模拟开到位反馈超时） | T50超时后V301.4=1（M_Alarm_ValveA_OpenTimeout）；VW2=99（S_ERROR）；VW6=34 | 【必测】 | 1.3 |
| TC-05-002 | 阀A开到位但无流报警 | VW2=1，阀A开启中 | ①模拟I8.0=ON（开到位） ②保持I0.0=OFF（流量开关A无流） | V301.5=1（M_Alarm_ValveA_OpenNoFlow）；VW2=99；VW6=35 | 【必测】 | 1.3 |
| TC-05-003 | 阀A关后仍有流（流量开关）报警 | VW2=1，进水达标关阀中 | ①进水达标关阀A ②T51延时后保持I0.0=ON（流量开关A仍ON） | V301.0=1（M_Alarm_ValveA_CloseFlow）；VW2=99；VW6=30 | 【必测】 | 1.3 |
| TC-05-004 | 阀A内漏（流量计差值增长）报警 | VW2=1，关阀延时验证中 | ①关阀后T51延时到达 ②模拟流量计VD86持续增长使VD264>阈值 | V301.1=1（M_Alarm_ValveA_Leak）；VW2=99；VW6=31 | 【必测】 | 1.3 |
| TC-05-005 | 阀A关到位但仍有流（交叉诊断）报警 | VW2=1，关阀验证中 | ①模拟I8.1=ON（关到位） ②同时I0.0=ON（仍有流） | V301.3=1（M_Alarm_ValveA_CloseLeak）；VW2=99；VW6=33 | 【必测】 | 1.3 |
| TC-05-006 | 阀A关到位反馈超时报警 | VW2=1，关阀验证中 | ①关阀后T51延时到达 ②I8.1保持OFF（关到位未反馈） | V301.2=1（M_Alarm_ValveA_CloseTimeout）；VW2=99；VW6=32 | 【必测】 | 1.3 |
| TC-05-007 | 阀B四态诊断异常（OFF/OFF设备故障）报警 | VW2=5，阀B运行中 | ①模拟I0.1=OFF（流量开关B无流） ②同时I0.6=OFF（液位计A低位未到，上缸未排空） | V302.0=1（M_Alarm_ValveB_Diag）；VW2=99；VW6=40 | 【必测】 | 1.3 |
| TC-05-008 | 阀B开到位超时报警 | VW2=5，阀B开启中 | ①开阀B(Q0.3=1) ②T53计时内I8.2保持OFF | V302.1=1（M_Alarm_ValveB_OpenTimeout）；VW2=99；VW6=41 | 【必测】 | 1.3 |
| TC-05-009 | 阀B关到位但仍有流（内漏）报警 | VW2=5，阀B关阀中 | ①模拟I8.3=ON（关到位） ②I0.1=ON（流量开关B仍有流） | V302.4=1（M_Alarm_ValveB_CloseLeak）；VW2=99；VW6=44 | 【必测】 | 1.3 |
| TC-05-010 | 阀C四态诊断异常+关到位超时报警 | VW2=7，阀C运行中 | ①模拟I0.2=OFF且I1.0=OFF（设备故障） | V302.5=1（M_Alarm_ValveC_Diag）；VW2=99；VW6=45 | 【必测】 | 1.3 |
| TC-05-011 | 阀C开到位但无流报警 | VW2=7，阀C开启中 | ①模拟I8.4=ON（开到位） ②I0.2=OFF（无流） | V302.7=1（M_Alarm_ValveC_OpenNoFlow）；VW2=99；VW6=47 | 【必测】 | 1.3 |
| TC-05-012 | 阀C关到位但仍有流（内漏）报警 | VW2=7，阀C关阀中 | ①模拟I8.5=ON（关到位） ②I0.2=ON（仍有流） | V303.1=1（M_Alarm_ValveC_CloseLeak）；VW2=99；VW6=61 | 【必测】 | 1.3 |

---

## 第六章 Story 1.4 节奏纠偏验收测试

**测试目的**：验证三层纠偏机制（压缩静止等候→压缩S2→顺延周期）各层触发条件与人工介入报警。
**关联Story**：Story 1.4 节奏纠偏。
**通用前置**：PLC RUN，参数配置：VD_RestTime=60s、VD_RestTime_Min=15s、VD_PreMixTime=120s、VD_PreMixTime_MinSafe=30s、VD_CycleExtend_Max=5min、VD_T_Rolling=300s。

| 用例ID | 测试项目 | 前置条件 | 测试步骤 | 期望结果 | 严重等级 | 关联Story |
|---|---|---|---|---|---|---|
| TC-06-001 | 正常无需纠偏（Available≥Needed） | VW2=6，下缸满，VD_S5_Elapsed小 | ①模拟VD_Available≥VD_T_Rolling（无缺口） ②触发预规划上升沿 | VD_S2_Target=VD_PreMixTime(120s)；VD_RestTime_Target=VD_RestTime(60s)；VD_CycleExtend_Target=0；VW_Corr_Result=1（正常） | 【必测】 | 1.4 |
| TC-06-002 | 第0层纠偏（压缩静止等候） | VW2=6，缺口Δ≤(VD_RestTime−VD_RestTime_Min)=45s | ①模拟VD_Available使Δ=30s（仅压缩静止等候可覆盖） ②触发预规划 | VD_RestTime_Target=VD_RestTime−Δ=30s；VD_S2_Target=VD_PreMixTime不变；VD_CycleExtend_Target=0；VW_Corr_Result=2（已纠偏） | 【必测】 | 1.4 |
| TC-06-003 | 第1层纠偏（压缩S2，第0层用满） | 缺口Δ>45s但Δ≤45s+(120−30)s=135s | ①模拟Δ=80s ②触发预规划 | VD_RestTime_Target=VD_RestTime_Min(15s)（第0层满）；VD_S2_Target=VD_PreMixTime−(Δ−45s)=120−35=85s；VD_CycleExtend_Target=0；VW_Corr_Result=2 | 【必测】 | 1.4 |
| TC-06-004 | 第2层纠偏（顺延周期，前两层满） | Δ>135s但Δ≤135s+300s(5min×60)=435s | ①模拟Δ=200s ②触发预规划 | VD_RestTime_Target=15s；VD_S2_Target=30s（前两层满）；VD_CycleExtend_Target=Δ−135s=65s→÷60≈1.08min；V300.7=1（滞后提示）；VW_Corr_Result=3 | 【必测】 | 1.4 |
| TC-06-005 | 三层用尽触发人工介入报警 | Δ>435s（超出第2层额度） | ①模拟Δ=500s ②触发预规划 | V300.6=1（M_Alarm_ScheduleLag严重滞后）；VW2=99（S_ERROR）；VW_Corr_Result=4（人工介入）；VW6=20 | 【必测】 | 1.4 |
| TC-06-006 | 预规划上升沿只触发一次 | VW2=6，M10.7=0 | ①VD_Available降到≤VD_T_Rolling ②观察多个扫描周期 | M10.7置1锁存，FC40仅被调用一次（非每周期重复）；本轮换水周期内不再重复触发 | 【必测】 | 1.4 |
| TC-06-007 | S1完成后二次校正 | VW2=1→S1完成 | ①模拟S1完成（阀A诊断正常VW266=1） ②观察FC40模式1调用 | VW182=1（二次校正模式）；VD_Available用S1实测重算；VD_S2_Target/VD_RestTime_Target二次核定；VD_T_Rolling更新（取标称值=VD_S1_Actual+VD_PreMixTime+VD_S3_Estimate+VD_RestTime） | 【必测】 | 1.4 |
| TC-06-008 | VD_S5_Elapsed秒累加正确 | VW2=6，V1.7=1 | ①观察T60每1秒触发 ②VD_S5_Elapsed每秒+1.0 | 60秒后VD178≈60.0；下缸空(V1.7=0)时不累加 | 【必测】 | 1.4 |
| TC-06-009 | 换水周期到达转S6（非T41判据） | VW2=6，VD_S5_Elapsed累加 | ①模拟VD_S5_Elapsed≥VD_CycleSetpoint×60 | VW2=7（S6）；M10.7清零；T60复位 | 【必测】 | 1.4 |
| TC-06-010 | S5触发S1时上缸≠空异常报警 | VW2=6，V1.6=1（上缸满，异常） | ①触发预规划上升沿 ②检测上缸状态 | V301.6=1（M_Alarm_ValveA_S1Start上缸未排空）；VW2=99；VW6=36 | 【必测】 | 1.4 |

---

## 第七章 Story 1.5 急停验收测试

**测试目的**：验证急停双通道触发、安全继电器反馈延时2秒（T35）、继电器故障最高级报警（V300.5）、系统复位按钮恢复流程、HMI高权限V0.7确认。
**关联Story**：Story 1.5 急停详细。
**通用前置**：急停回路接线完成，安全继电器为强制导向型，I1.1常闭、I1.2反馈、I0.3复位按钮就绪。

| 用例ID | 测试项目 | 前置条件 | 测试步骤 | 期望结果 | 严重等级 | 关联Story |
|---|---|---|---|---|---|---|
| TC-07-001 | 急停触发锁存与转S_ERROR | VW2=任意运行态，I1.1=ON | ①按下急停按钮（I1.1由ON→OFF） | V300.4=1（M_EStop_Latch）；VW2=99（S_ERROR）；QB0=0（输出强制安全）；Q0.7=1（声音）；VW6=10 | 【必测】 | 1.5 |
| TC-07-002 | 安全继电器反馈正常（2秒内I1.2=ON） | 急停已触发V300.4=1 | ①急停后2秒内模拟I1.2=ON（动力回路已断开） | T35计时中I1.2变ON→T35复位；V300.5保持0（不触发继电器故障） | 【必测】 | 1.5 |
| TC-07-003 | 安全继电器故障最高级报警（T35超时） | 急停已触发V300.4=1，I1.2=OFF | ①急停后保持I1.2=OFF ②等待T35计时2秒到达 | T35到达后V300.5=1（M_Alarm_SafetyRelay）；VW6=99（最高级优先）；HMI提示"立即人工检修" | 【必测】 | 1.5 |
| TC-07-004 | 急停释放不自动复位 | V300.4=1，VW2=99，V300.5=0 | ①旋转释放急停按钮（I1.1由OFF→ON） | I1.1=ON但V300.4保持1（锁存不清）；VW2保持99；HMI显示"急停已释放，等待系统复位" | 【必测】 | 1.5 |
| TC-07-005 | 系统复位按钮恢复回S0（无继电器故障） | V300.4=1，V300.5=0，I1.1=ON | ①按下系统复位按钮I0.3（上升沿） | V300.4=0（清锁存）；V1.6=0、V1.7=0（上下缸置空）；VW2=0（S0）；VW6=0；Q0.7=0 | 【必测】 | 1.5 |
| TC-07-006 | 继电器故障时系统复位按钮无效 | V300.5=1，I1.1=ON | ①按下系统复位按钮I0.3 | V300.5保持1（FC19 NETWORK2跳过复位）；VW2保持99；复位按钮无效，必须先清除V300.5 | 【必测】 | 1.5 |
| TC-07-007 | HMI高权限V0.7确认清除继电器故障 | V300.5=1，I1.2=ON（已检修反馈正常） | ①HMI下发V0.7=1（CMD_SafetyRelayAck上升沿） ②确认I1.2=ON | V300.5=0（清除继电器故障）；V0.7=0（清命令）；之后I0.3方可复位回S0 | 【必测】 | 1.5 |
| TC-07-008 | 输出强制安全双保险 | VW2=99（S_ERROR态） | ①观察FC2 NETWORK3（每周期）与FC19 NETWORK1（S_ERROR态） | 两者均强制QB0=0；即使状态FC误写也覆盖；Q0.7声音由FC2置位 | 【必测】 | 1.5 |
| TC-07-009 | V0.7确认时I1.2异常则不清除 | V300.5=1，I1.2=OFF（反馈仍异常） | ①HMI下发V0.7=1 | V300.5保持1（I1.2异常不允许清除）；V0.7保持1等待条件满足 | 【必测】 | 1.5 |

---

## 第八章 Story 1.6 报警验收测试

**测试目的**：验证32位报警字逐位触发、优先级链（99>10系列>20系列>30~90系列）、消音（I0.4/V0.4只关声音）、消光（V0.3确认+条件消失）、自动恢复与人工确认模式对比。
**关联Story**：Story 1.6 报警详细。
**通用前置**：PLC RUN，M_AlarmAckMode(V200.0)可配置，报警字VB300~303初始为0。

| 用例ID | 测试项目 | 前置条件 | 测试步骤 | 期望结果 | 严重等级 | 关联Story |
|---|---|---|---|---|---|---|
| TC-08-001 | 优先级链：最高级99>漫溢10 | VB300~303=0 | ①同时强制V300.5=1（继电器故障）和V300.0=1（上缸漫溢） | VW6=99（最高级优先）；Q8.0=1（灯光常亮） | 【必测】 | 1.6 |
| TC-08-002 | 优先级链：漫溢10>节奏滞后20 | V300.5=0 | ①同时强制V300.0=1和V300.6=1（节奏严重滞后） | VW6=10（漫溢优先于节奏滞后）；Q8.0=1 | 【必测】 | 1.6 |
| TC-08-003 | 优先级链：节奏20>阀A类30 | V300.0/5=0 | ①同时强制V300.6=1和V301.0=1（阀A关后仍有流） | VW6=20（节奏级优先于一般级阀A） | 【必测】 | 1.6 |
| TC-08-004 | 消音I0.4只关声音不清报警 | VW6=30，Q0.7=1，Q8.0=1 | ①按下消音按钮I0.4（上升沿） | Q0.7=0（声音关）；Q8.0=1（灯光保持）；V301.0=1（报警位保持）；VW6=30保持；V1.4=1（消音握手） | 【必测】 | 1.6 |
| TC-08-005 | HMI消音V0.4等效I0.4 | VW6=30，Q0.7=1 | ①HMI下发V0.4=1（上升沿） | Q0.7=0；V1.4=1；V0.4=0（清命令）；灯光报警位保持 | 【必测】 | 1.6 |
| TC-08-006 | 新报警重新鸣响（消音后） | 已消音M11.1=1，Q0.7=0 | ①触发新报警（如新增V301.1=1使VW6变化） | M11.1被清；Q0.7=1（声音重鸣）；操作员需再次消音 | 【必测】 | 1.6 |
| TC-08-007 | 自动恢复模式（V200.0=0）条件消失自动清 | V200.0=0，V301.0=1（阀A关后仍有流） | ①模拟条件消失（I0.0流量开关A=OFF） | FC3 NETWORK5自动R V301.0；下一周期VW6=0；Q8.0=0（自动消光）；无需V0.3确认 | 【必测】 | 1.6 |
| TC-08-008 | 人工确认模式（V200.0=1）需V0.3确认 | V200.0=1，V301.0=1 | ①模拟条件消失（I0.0=OFF） ②V301.0保持锁存（人工模式不自动清） ③HMI下发V0.3=1 | 收到V0.3后检查条件消失→R V301.0；VW6=0；Q8.0=0（消光）；V1.3=1（确认握手） | 【必测】 | 1.6 |
| TC-08-009 | 高优先级强制人工确认（不受模式影响） | V200.0=0（自动模式），V300.0=1（漫溢） | ①模拟液位下降I0.5=OFF（条件消失） | V300.0保持1（漫溢级不受自动恢复影响）；必须HMI二次确认V0.3后才清；Q8.0保持亮 | 【必测】 | 1.6 |
| TC-08-010 | 根本原因未消失确认只记录已知晓 | V301.0=1（条件仍存在I0.0=ON） | ①HMI下发V0.3=1 | V301.0保持1（条件未消失）；VW6=30≠0；Q8.0保持亮（只记录已知晓，不消光） | 【必测】 | 1.6 |
| TC-08-011 | 报警日志写入（新报警触发） | VB500~599缓冲区，VW202=0 | ①触发新报警VW6由0变30 | VB500+0×16写入日志条目：时间戳(RTC)+单元编号1+报警码30+动作1(触发) | 【选测】 | 1.6 |
| TC-08-012 | 编址修复验证（V200.0与VD124无冲突） | 程序运行中 | ①设置V200.0=1（人工模式） ②检查VD124（VD_RestTime_Target）未被破坏 | V200.0=1生效；VD124保持Story1.4计算的值，无冲突 | 【必测】 | 1.6 |

---

## 第九章 Story 1.7 断电恢复验收测试

**测试目的**：验证冷启动（V304.0=0全部清零）、断电恢复（V304.0=1）各状态恢复策略、RTC异常检测与 HMI 校时（AQEX-51）、VD_S5_Elapsed重算。
**关联Story**：Story 1.7 断电恢复。
**通用前置**：PLC断电保持区已配置，McgsPro HMI 已完成 RTC 校时窗口组态（AQEX-51），V304.0 状态可观察。

| 用例ID | 测试项目 | 前置条件 | 测试步骤 | 期望结果 | 严重等级 | 关联Story |
|---|---|---|---|---|---|---|
| TC-09-001 | 冷启动全部清零（V304.0=0） | 长期断电后V304.0=0（超级电容失效） | ①PLC上电SM0.1触发 ②观察FC0 NETWORK2冷启动路径 | VW2=0（S0）；V1.6=0、V1.7=0；QB0=0；VB300~303=0；VW6=0；VW8=0；VD178=0；V304.0置1 | 【必测】 | 1.7 |
| TC-09-002 | 断电恢复保持S5（无阀门动作可恢复） | V304.0=1，VW2=6，V1.7=1（下缸满），DT10已写入 | ①断电后重新上电 ②FC0检测V304.0=1走断电恢复路径 ③RTC≥DT10 | VD_S5_Elapsed重算=RTC秒−DT10秒（断电期间时长计入）；VW2保持6（S5）；不转S_ERROR；实验继续 | 【必测】 | 1.7 |
| TC-09-003 | 断电恢复S1阀A动作中断转S_ERROR | V304.0=1，VW2=1（S1进水中） | ①断电后重新上电 ②FC0 NETWORK7检测VW2=1 | QB0=0（阀A强制关）；VW2=99（S_ERROR）；V300.4=1（急停锁存）；需人工检查后系统复位 | 【必测】 | 1.7 |
| TC-09-004 | 断电恢复状态策略矩阵（S2/S3/S3.5/S4/S6转S_ERROR） | V304.0=1 | 分别强制VW2=2/3/4/5/7后断电重启 | 每个阀门/泵动作态均转VW2=99（S_ERROR）+V300.4=1（安全起见人工处理） | 【必测】 | 1.7 |
| TC-09-005 | 断电恢复S7保持（锁定态可恢复） | V304.0=1，VW2=8（S7实验结束） | ①断电后重新上电 | VW2保持8（S7）；等待HMI确认CMD_Start回S0 | 【必测】 | 1.7 |
| TC-09-006 | RTC异常检测（AQEX-51 更新） | V304.0=1，DT10有效，RTC时间<DT10（停走）或RTC字段非法（如分>59） | ①上电FC0 NETWORK1 READ_RTC ②检查RTC自身合法性 ③比较RTC与DT10 | **V303.7=1（M_Need_RTC_Sync）**；V303.5=0（仅超时后置位）；VW2=0（S0，不进S_ERROR）；VD_S5_Elapsed=0；HMI弹窗"请同步PLC时钟" | 【必测】 | 1.7/AQEX-51 |
| TC-09-007 | RTC正常且DT10未写入跳过检测 | V304.0=1，DT10=0（全0未写入，如冷启动后未运行过S4），RTC字段合法 | ①上电FC0检测DT10=0 | 跳过RTC丢失检测；V303.7=0；VD_S5_Elapsed=0；状态恢复正常 | 【必测】 | 1.7/AQEX-51 |
| TC-09-008 | 下缸空时VD_S5_Elapsed不重算 | V304.0=1，V1.7=0（下缸空），VW2=6 | ①断电重启 | FC0 NETWORK6检测V1.7=0→VD_S5_Elapsed保持0（不重算） | 【必测】 | 1.7 |
| TC-09-009 | 断电保持区数据保持验证 | V304.0=1，VD参数已设定 | ①断电30秒后重启 ②检查VD10~VD66设定参数 | VD10~VD66参数值保持不变（超级电容保持）；VW8轮次计数保持 | 【必测】 | 1.7 |
| TC-09-010 | 超级电容失效（>7天）走冷启动 | PLC断电>7天 | ①重新上电 | V304.0=0（丢失）→走冷启动路径；全部清零；HMI需重新校准RTC（若RTC也停走） | 【选测】 | 1.7 |
| TC-09-011 | RTC校时正常流程（AQEX-51） | PLC RTC非法（强制VB904=70使分>59），McgsPro已组态RTC_Sync_Wnd窗口 | ①PLC STOP→RUN ②HMI自动弹窗 ③点击同步按钮 | V303.7=1→HMI写VB900~VB905(BCD)置V0.6=1→PLC FC22 TODW→V303.7清0→弹窗关闭→VW2保持0(S0) | 【必测】 | AQEX-51 |
| TC-09-012 | RTC校时超时保护（AQEX-51） | PLC RTC非法，V303.7=1 | ①上电后不点击同步 ②等待5分钟 | FC22 T59计时到→V303.5=1→VW2=99(S_ERROR)→VW6=65 | 【必测】 | AQEX-51 |
| TC-09-013 | HMI校时后PLC RTC实际更新验证 | 已完成TC-09-011同步 | ①STEP7读VB900~VB907 ②与McgsPro本机时间对比 | PLC RTC与HMI本机时间误差<1秒；下次开机不再触发校时弹窗 | 【必测】 | AQEX-51 |

---

## 第十章 Modbus 通讯验收测试

**测试目的**：验证注射泵（40002/40003/40006/40007/41001）与流量计（0x0009差值法）读写测试。
**关联Story**：Story 1.2（FC4骨架）+ 设计文档第二章。
**通用前置**：RS485总线接从站（FAT用Modbus Slave模拟软件，SAT用真实设备），站号/波特率已配置。

| 用例ID | 测试项目 | 前置条件 | 测试步骤 | 期望结果 | 严重等级 | 关联Story |
|---|---|---|---|---|---|---|
| TC-10-001 | 注射泵复位寄存器写入（40003） | 通讯正常 | ①PLC置MB_Pump_Reset(VW202)=1 ②Modbus从站监控0x0002 | 从站收到FC06写0x0002=1；PLC侧VW202=1；泵执行复位 | 【必测】 | 1.2 |
| TC-10-002 | 注射泵抽液步数写入（40006） | VW2=3（S3加药） | ①PLC计算VD_Dose_Steps ②写入VW204=MB_Pump_Aspirate | 从站0x0005收到步数值；VW204=VD_Dose_Steps计算值 | 【必测】 | 1.2 |
| TC-10-003 | 注射泵排液步数写入（40007） | 抽液完成 | ①PLC写入VW206=MB_Pump_Dispense | 从站0x0006收到步数值；VW206=VD_Dose_Steps | 【必测】 | 1.2 |
| TC-10-004 | 注射泵状态码读取（41001） | 通讯正常 | ①PLC轮询41001 ②模拟从站返回0/1/2/3/错误码 | VW4正确映射：0=完成，1=运行中，2=抽液，3=排液，其他=错误→V303.4=1(注射泵故障) | 【必测】 | 1.2 |
| TC-10-005 | 注射泵强停寄存器写入（40002） | 通讯正常 | ①PLC置VW200=1（MB_Pump_ForceStop） | 从站0x0001收到=1；泵强停 | 【必测】 | 1.2 |
| TC-10-006 | 流量计计量值差值法读取（0x0009） | VW2=1（S1进水） | ①阀A开瞬间快照VD82=VD86 ②模拟从站0x0009累计值增长 ③计算VD90=VD86−VD82 | VD82=开阀瞬间值；VD90随累计值增长递增；VD90≥目标进水量时关阀A | 【必测】 | 1.2 |
| TC-10-007 | 流量计无清零功能验证 | 通讯正常 | ①尝试查找清零寄存器 ②确认0x0009只读持续累加 | 0x0009无清零指令；只能用差值法（VD90=VD86−VD82） | 【选测】 | 1.2 |
| TC-10-008 | Modbus通讯超时/故障报警 | 通讯断开 | ①断开RS485线或关闭从站 ②等待通讯超时 | V303.4=1（M_Alarm_SyringePump注射泵通讯异常）；VW6=64 | 【必测】 | 1.2 |

---

## 第十一章 长时稳定性测试

**测试目的**：验证连续运行24小时无异常、断电恢复3次验证。
**通用前置**：系统已完成前述功能测试，参数配置合理，可连续运行。

| 用例ID | 测试项目 | 前置条件 | 测试步骤 | 期望结果 | 严重等级 | 关联Story |
|---|---|---|---|---|---|---|
| TC-11-001 | 24小时连续运行无异常 | 系统正常运行中（VW2=6循环换水） | ①连续运行24小时 ②每小时记录VW2/VW6/VW8/VD96/VB300~303 | 24小时内无未预期S_ERROR；VW6=0（无报警）；VW8轮次正常递增；VD96正常累加；无内存泄漏/死锁 | 【必测】 | 1.2~1.7 |
| TC-11-002 | 24小时内换水周期循环验证 | VW2=6，下缸满 | ①运行24小时观察S1→S6多轮完整循环 | 每轮S1→S2→S3→S3.5→S4→S5→S6状态切换正常；VD_T_Rolling/VD_S6_Rolling滚动更新；DT10每轮更新 | 【必测】 | 1.2/1.4 |
| TC-11-003 | 断电恢复3次验证 | 系统运行中 | ①在S5态断电→恢复 ②在S1态断电→恢复 ③在S3态断电→恢复 | S5恢复保持继续；S1/S3转S_ERROR需人工复位；3次断电后断电保持数据无丢失 | 【必测】 | 1.7 |
| TC-11-004 | 报警日志连续记录验证 | 长时运行 | ①运行中人为触发多次报警 ②检查VB500~599日志缓冲区 | 日志环形写入正常；满6条覆盖最旧；每条含时间戳+单元+报警码+动作 | 【选测】 | 1.6 |
| TC-11-005 | HMI长时间通讯稳定性 | HMI与PLC通讯 | ①HMI持续监控24小时 | HMI无通讯中断；变量刷新正常；报警弹窗正常 | 【选测】 | 1.2 |

---

## 第十二章 验收签字页

### 12.1 FAT 工厂验收签字

| 角色 | 姓名 | 签字 | 日期 | 备注 |
|---|---|---|---|---|
| 客户代表 | | | | |
| 厂方代表 | | | | |
| 调试工程师 | | | | |
| PLC开发工程师 | | | | |
| 质量检验员 | | | | |

**FAT 结论**：□ 全部通过，同意出厂  □ 部分不通过，整改后复验  □ 拒收

**遗留问题清单**：

| 序号 | 问题描述 | 关联用例ID | 严重等级 | 责任人 | 整改期限 |
|---|---|---|---|---|---|
| 1 | | | | | |
| 2 | | | | | |

### 12.2 SAT 现场验收签字

| 角色 | 姓名 | 签字 | 日期 | 备注 |
|---|---|---|---|---|
| 客户代表 | | | | |
| 厂方代表 | | | | |
| 调试工程师 | | | | |
| 现场操作员 | | | | |
| PLC开发工程师 | | | | |

**SAT 结论**：□ 全部通过，验收合格交付  □ 部分不通过，整改后复验  □ 拒收

**遗留问题清单**：

| 序号 | 问题描述 | 关联用例ID | 严重等级 | 责任人 | 整改期限 |
|---|---|---|---|---|---|
| 1 | | | | | |
| 2 | | | | | |

### 12.3 验收统计汇总

| 统计项 | 数量 |
|---|---|
| 总用例数 | 106 |
| 【必测】用例数 | 101 |
| 【选测】用例数 | 5 |
| 【回归】用例数 | SAT阶段由调试团队从FAT通过项中标记复测 |
| 通过用例数 | ___ |
| 失败用例数 | ___ |
| 严重问题数 | ___（要求为0方可交付） |
| DI/DO点位覆盖 | 28点（19 DI + 9 DO）全覆盖 |
| 覆盖Story清单 | Story 1.2 / 1.3 / 1.4 / 1.5 / 1.6 / 1.7（每Story用例≥8） |

### 12.4 用例分布统计

| 章节 | 内容 | 用例数 | 用例ID范围 |
|---|---|---|---|
| 第三章 | DI/DO点位强制测试 | 28 | TC-03-001 ~ TC-03-028 |
| 第四章 | Story 1.2 状态机验收 | 12 | TC-04-001 ~ TC-04-012 |
| 第五章 | Story 1.3 阀门诊断验收 | 12 | TC-05-001 ~ TC-05-012 |
| 第六章 | Story 1.4 节奏纠偏验收 | 10 | TC-06-001 ~ TC-06-010 |
| 第七章 | Story 1.5 急停验收 | 9 | TC-07-001 ~ TC-07-009 |
| 第八章 | Story 1.6 报警验收 | 12 | TC-08-001 ~ TC-08-012 |
| 第九章 | Story 1.7 断电恢复验收 | 13 | TC-09-001 ~ TC-09-013 |
| 第十章 | Modbus通讯验收 | 8 | TC-10-001 ~ TC-10-008 |
| 第十一章 | 长时稳定性测试 | 5 | TC-11-001 ~ TC-11-005 |
| **合计** | | **106** | |

> **说明**：实际编制总用例数为106个（含28点I/O + 65个Story功能 + 8个Modbus + 5个长时稳定性），其中【必测】101个、【选测】5个，覆盖全部6个Story（1.2~1.7）。每个Story功能用例数均≥8个，满足"每个Story至少8个用例"要求。

---

## 附录A：测试用例与设计文档追溯矩阵

| Story | 规格书章节 | 对应用例章节 | 核心验证点 |
|---|---|---|---|
| Story 1.2 状态机骨架 | S0~S7状态调度、FC0/FC1/FC10~FC19 | 第四章 TC-04-001~012 | 状态转移、握手、非法态处理 |
| Story 1.3 阀门诊断 | FC30/31/32、四态诊断、限位交叉、内漏 | 第五章 TC-05-001~012 | 阀A/B/C全诊断场景 |
| Story 1.4 节奏纠偏 | FC40三层纠偏、预规划/二次校正、V300.6/7 | 第六章 TC-06-001~010 | 三层额度、人工介入 |
| Story 1.5 急停详细 | FC2/FC19、T35延时、V300.4/5、I0.3/V0.7 | 第七章 TC-07-001~009 | 双通道、继电器故障、复位流程 |
| Story 1.6 报警详细 | FC3、优先级链、消音消光、V200.0模式 | 第八章 TC-08-001~012 | 32位报警字、优先级、模式对比 |
| Story 1.7 断电恢复 | FC0双路径、V304.0、RTC检测、状态策略 | 第九章 TC-09-001~010 | 冷启动/恢复、RTC丢失、状态矩阵 |

## 附录B：关键变量速查表（测试核对用）

| 地址 | 符号 | 含义 | 关键取值 |
|---|---|---|---|
| VW2 | 状态机 | 当前状态 | 0=S0,1=S1,2=S2,3=S3,4=S3.5,5=S4,6=S5,7=S6,8=S7,99=S_ERROR |
| VW4 | 注射泵状态码 | 映射41001 | 0=完成,1=运行,2=抽液,3=排液,其他=错误 |
| VW6 | 报警码 | 最高优先级 | 99>10~14>20>21>30~66 |
| VW8 | 实验轮次 | 计数 | 每完成S1~S6累加1 |
| V300.4 | M_EStop_Latch | 急停锁存 | 1=急停触发，需I0.3复位 |
| V300.5 | M_Alarm_SafetyRelay | 继电器故障 | 1=最高级报警，需V0.7+I1.2清除 |
| V300.6 | M_Alarm_ScheduleLag | 节奏严重滞后 | 1=三层用尽，强制人工确认 |
| V304.0 | M_InitDone | 初始化完成 | 0=冷启动,1=断电恢复 |
| V200.0 | M_AlarmAckMode | 报警确认模式 | 0=自动恢复,1=人工确认 |
| V0.0/V0.2/V0.3/V0.4/V0.7 | 命令位 | HMI→PLC | 启动/停止/报警确认/消音/继电器故障确认 |
| V1.6/V1.7 | 上下缸状态 | PLC→HMI | 0=空,1=满 |
| VD178 | VD_S5_Elapsed | 下缸满计时 | 秒，断电恢复RTC重算 |
| DT10 | DT_TankB_FullTime | 下缸变满时间戳 | 换水周期计算基准 |

---

**文档版本**：v1.1
**编制日期**：2026-07-15
**修订日期**：2026-08-27
**配套文档版本**：PLC设计文档v9.3、HMI-PLC变量地址表v1.0、Story1.2~1.7规格书v1.0(Story1.2 已升级 v1.1,新增 S4 互锁测试用例 TC-04-013~017)
**下次更新触发**：FAT/SAT执行后根据实测反馈修订；规格书变更时同步更新

> 本文档为药液配置加注控制系统PLC项目的验收测试依据，FAT在厂内模拟负载环境执行全部【必测】项，SAT在现场带真实负载执行全部【必测】项并复测FAT关键项作为【回归】。测试通过判据为：全部【必测】项通过且严重问题数为0。
