Yustnust/AQUA-EXPO/docs/Modbus通讯报文规格书_v1.0.md

# 药液配置加注控制系统 — Modbus通讯报文规格书 v1.0

| 项目 | 内容 |
|---|---|
| 文档名称 | Modbus通讯报文规格书 |
| 版本号 | v1.0 |
| 编制日期 | 2026-07-18 |
| 适用范围 | 8套缸单元(每套1台西门子S7-200 SMART CPU ST20 + EM DT16/DR16),CPU本体RS485口(Port0)作为Modbus RTU主站轮询2台从站(注射泵站号01/流量计K24站号02);若HMI(昆仑通态MCGS)不支持8个S7连接,PLC侧启用MBUS_SERVER作为Modbus TCP从站供HMI访问 |
| 配套文档 | 《药液配置加注控制系统_PLC设计文档》v9.3;《HMI-PLC变量地址表》v1.0(第11章Modbus从站寄存器映射/第5.2章注射泵状态码VW4/第8.4章注射泵速度40009-11);《性能基准测试方案》v1.0(第3章Modbus通讯测试,本规格与之衔接不重复);《FC4_ModbusPolling.stl》 |
| 通讯协议依据 | 南京润泽《泵阀一体MODBUS协议V1.7》(注射泵);K24流量计《Modbus协议》 |
| 编制人 | 通讯协议工程师 |

---

## 术语表

| 术语 | 含义 |
|---|---|
| 主站(Master) | Modbus总线上发起请求的设备。本系统PLC(CPU ST20 Port0)为RTU主站;HMI为TCP主站(若启用MBUS_SERVER) |
| 从站(Slave) | Modbus总线上响应请求的设备。本系统注射泵(站号01)/流量计K24(站号02)为RTU从站;PLC为TCP从站(若启用MBUS_SERVER) |
| 站号(Slave Address) | RTU总线上唯一标识从站的1字节地址,范围0x01~0xFE(0=广播) |
| 功能码(Function Code) | Modbus请求首字节,指示操作类型。常用:03读保持寄存器/06写单个/10写多个(0x10) |
| 寄存器(Register) | 16位(WORD)存储单元,Modbus保持寄存器区(4xxxxx)支持读写 |
| 线圈(Coil) | 1位(BOOL)存储单元,Modbus线圈区(0xxxxx),本系统暂未使用线圈功能码 |
| CRC16 | 循环冗余校验,RTU帧尾2字节,多项式0xA001,低字节在前 |
| 保持寄存器(4xxxxx) | Modbus地址区,可读可写,本系统注射泵/流量计/HMI访问均用此区 |
| MBUS_CTRL | S7-200 SMART Modbus主站初始化指令,每周期调用 |
| MBUS_MSG | S7-200 SMART Modbus主站读写请求指令(单次请求) |
| MBUS_SERVER | S7-200 SMART Modbus TCP从站指令,将V区映射为TCP保持寄存器 |
| RTU | Remote Terminal Unit,Modbus串行二进制模式,本系统采用RS485+RTU |
| ASCII | Modbus串行ASCII字符模式,本系统不采用(注射泵出厂默认可能为ASCII,需确认切换至RTU) |
| 3.5字符帧间隔 | RTU帧间静默时间,9600bps下约3.65ms,用于帧边界识别 |
| V区 | S7-200 SMART变量存储区,按字节编址(VB)/字(VW)/双字(VD) |

---

## 第1章 通讯架构总览

### 1.1 架构说明

本系统采用**双层Modbus通讯架构**:

1. **下层(RTU层)**:每套PLC的CPU本体RS485口(Port0)作为**Modbus RTU主站**,通过RS485总线轮询2台从站——注射泵(站号01,南京润泽泵阀一体,柱塞式计量泵)、流量计(站号02,K24)。该总线为**每套单元独立**,不与其他单元共享,也不经过以太网转发(见PLC设计文档第十二章12.1)。

2. **上层(TCP层)**:若HMI(昆仑通态MCGS)不支持8个S7连接,PLC侧需启用**MBUS_SERVER**指令作为**Modbus TCP从站**,将以太网口(502端口)暴露V区为保持寄存器,供HMI(192.168.2.10)作为TCP主站访问8台PLC(192.168.2.101~108)。若HMI选型支持8个S7连接,则上层采用S7协议,TCP层不启用(见变量地址表12.4节)。

### 1.2 RTU层架构图(下层,每套单元独立)

```
┌─────────────────────────────────────────────────────────────────┐
│  每套缸单元(1~8号任一)                                          │
│                                                                  │
│   ┌─────────────────────┐                                        │
│   │  S7-200 SMART       │                                        │
│   │  CPU ST20           │  CPU本体RS485口(Port0)                 │
│   │                     │  作为Modbus RTU主站                    │
│   │  FC4_ModbusPolling   │  MBUS_CTRL初始化+MBUS_MSG轮询          │
│   └──────────┬──────────┘                                        │
│              │ RS485总线(A/B/屏蔽)                                │
│              │ 9600bps 8N1                                        │
│              ├─── T型分接 ────────────────────────────┐          │
│              │                                        │          │
│   ┌──────────▼──────────┐              ┌──────────────▼────────┐  │
│   │  注射泵             │              │  流量计 K24           │  │
│   │  (南京润泽泵阀一体) │              │                       │  │
│   │  站号 01            │              │  站号 02              │  │
│   │  40002~40018        │              │  0x0009/0x000F/0x0017 │  │
│   │  41001/41007        │              │  /0x0012              │  │
│   │  FC03读/FC06写/FC10 │              │  FC03读/FC06/FC10     │  │
│   └─────────────────────┘              └───────────────────────┘  │
│                                                                  │
│   总线拓扑:线型(主-从1-从2),终端电阻接在两端                    │
└─────────────────────────────────────────────────────────────────┘
```

### 1.3 TCP层架构图(上层,可选启用)

```
                       ┌───────────────────────┐
                       │  本地集中HMI          │
                       │  (昆仑通态MCGS)       │
                       │  IP: 192.168.2.10     │
                       │  作为Modbus TCP主站   │
                       └───────────┬───────────┘
                                   │ 以太网(502端口)
                                   │ Modbus TCP/IP
              ┌────────────────────┼────────────────────┐
              │                    │                    │
   ┌──────────▼─────────┐  ┌───────▼──────────┐  ┌──────▼─────────┐
   │  PLC#1             │  │  PLC#2           │  │  ... PLC#8      │
   │  192.168.2.101:502 │  │  192.168.2.102  │  │  192.168.2.108 │
   │  MBUS_SERVER启用   │  │  :502            │  │  :502          │
   │  TCP从站           │  │  TCP从站         │  │  TCP从站       │
   │  V区→保持寄存器    │  │  V区映射         │  │  V区映射       │
   └────────────────────┘  └──────────────────┘  └────────────────┘

   每台PLC程序相同,仅IP不同(101~108);HMI按IP区分单元
```

> **启用判定**:MBUS_SERVER是否启用取决于HMI选型(AQEX-24)是否支持8个S7连接。若支持S7协议(变量地址表12.4节推荐),则不启用MBUS_SERVER,上层走S7;若不支持,则启用MBUS_SERVER。**待HMI选型确认后定型**(见第10章待确认事项)。

---

## 第2章 Modbus RTU物理层规范

### 2.1 总线参数(已确认,见变量地址表11.1节)

| 参数 | 值 | 说明 | 来源 |
|---|---|---|---|
| 总线标准 | RS485 | 半双工,差分信号(A/B双线) | 设计文档2.3节 |
| 通讯模式 | RTU | 二进制模式(非ASCII)。注射泵出厂可能为ASCII,需通过40020=3切换至RS485+RTU,见待确认事项 | 变量地址表11.1节 |
| 波特率 | 9600 bps | 注射泵40019=0x0000,流量计0x0001=0x0000(9600),两从站一致,PLC Port0配9600 | 变量地址表11.1节 |
| 数据位 | 8 | RTU标准 | 变量地址表11.1节 |
| 停止位 | 1 | RTU标准 | 变量地址表11.1节 |
| 校验位 | 无(None/N) | 两从站一致,PLC Port0配8/N/1。注射泵支持9600/19200/38400/57600/115200,流量计支持1200~9600,首期统一9600 | 变量地址表11.1节 |
| 字符帧间隔 | 3.5字符时间 | 9600bps下约3.65ms,RTU帧边界识别 | Modbus标准 |
| 字内间隔 | ≤1.5字符时间 | 9600bps下约1.56ms,超时则帧无效 | Modbus标准 |

### 2.2 站号分配

| 从站 | 站号(HEX) | 站号(DEC) | 设备 | 备注 |
|---|---|---|---|---|
| 注射泵 | 0x01 | 1 | 南京润泽泵阀一体 | 默认值,范围0x01~0xFE,0=广播;站号存40001(0x0000)寄存器 |
| 流量计K24 | 0x02 | 2 | K24流量计 | 默认值,范围1~255;站号存0x0000寄存器 |
| PLC主站 | — | — | S7-200 SMART CPU ST20 | RTU主站不发站号给自己,仅作为总线仲裁者 |

> **强制要求**:两个从站站号不能冲突。若现场有其他Modbus设备接入,需重新分配站号避免冲突。

### 2.3 接线规范

```
   PLC Port0         注射泵        流量计K24
   (CPU ST20)        (站号01)      (站号02)
     ┌──┐            ┌──┐          ┌──┐
     │3 ├─────A──────┤A ├──────────┤A │
     │  │            │  │          │  │
     │8 ├─────B──────┤B ├──────────┤B │
     │  │            │  │          │  │
     │  ├────GND─────┤  │          │  │
     └──┘            └──┘          └──┘
                       │              │
                    终端电阻       终端电阻
                    (120Ω)         (120Ω)

   屏蔽层:PLC端单点接地(防地环路)
```

| 项 | 规范 |
|---|---|
| 线缆类型 | 屏蔽双绞线(STP/FTP),特性阻抗120Ω |
| A/B定义 | A=DATA+(D+),B=DATA-(D-);接线前务必核对PLC与从站A/B定义(部分厂商A/B定义相反,接反则无通讯) |
| 屏蔽接地 | 屏蔽层在PLC端单点接地,避免多点接地形成地环路 |
| 终端电阻 | 总线两端各接120Ω终端电阻(PLC端+末端从站端),中间从站不接 |
| 最大距离 | 9600bps下RS485总线最大距离1200米(理论值),实际建议≤1000米 |
| 节点数 | RS485标准32节点/段,本系统3节点(1主站+2从站),远低于上限 |
| 分接 | 采用T型分接器或端子排分接,分支线尽量短(≤0.3米) |
| 走线 | 远离动力线(220V/380V)与变频器输出,避免电磁干扰;若必须交叉,90°正交 |

### 2.4 PLC侧配置(STEP 7-Micro/WIN SMART)

| 项 | 配置 |
|---|---|
| 端口 | CPU本体Port0(不可用Port1,ST20仅1个RS485口) |
| 系统块→端口0 | 地址(站号,RTU主站时不影响)/波特率9600/校验无 |
| 程序块→MBUS_CTRL | Mode=1(RTU),Baud=9600,Parity=0(无),Port=0(本体),Timeout=1000ms |

> 见FC4_ModbusPolling.stl NETWORK 1:`MBUS_CTRL 1, 9600, 0, 0, 1000`(参数待Story 1.1核实)。

---

## 第3章 注射泵寄存器映射(站号01)

### 3.1 寄存器总览

依据南京润泽《泵阀一体MODBUS协议V1.7》(见变量地址表8.4章引用)及HMI变量地址表11.2章,注射泵寄存器分布在两个地址区:

- **RW区(可读写)**:40001~40021(0x0000~0x0014),用于参数写入/读取
- **R区(只读)**:41001~41280(0x03E8~0x04FF),用于状态码/位置反馈读取

> **地址换算**:Modbus寄存器地址(0-based offset)= 寄存器号(4xxxxx) - 40001。例:40006对应offset 0x0005;41001对应offset 0x03E8(41001-40001=1000=0x3E8)。

### 3.2 注射泵寄存器完整映射表

下表对照HMI变量地址表11.2章逐项核对,覆盖40001~40018写寄存器与41001/41007读寄存器(含任务要求的40006-40007/40009/40010/40011全部寄存器):

| Modbus寄存器 | HEX偏移 | 功能码 | 寄存器名 | 数据类型 | 单位 | 读写 | 说明 | 对应PLC变量 | 来源/待确认 |
|---|---|---|---|---|---|---|---|---|---|
| 40001 | 0x0000 | 03/06 | 站号 | INT | — | R/W | 注射泵从站站号(默认0x01,范围0x01~0xFE,0=广播) | — | 变量地址表11.1(待确认是否需修改) |
| 40002 | 0x0001 | 03/06 | 强停(MB_Pump_ForceStop) | INT | — | R/W | 0=空闲,1=强停(强制停止当前动作) | VW200 | 变量地址表11.2已确认 |
| 40003 | 0x0002 | 03/06 | 复位(MB_Pump_Reset) | INT | — | R/W | 0=空闲,1=复位(泵上电后必须先执行一次初始化复位) | VW202 | 变量地址表11.2已确认 |
| 40004 | 0x0003 | 03 | (预留) | — | — | R | 协议V1.7保留,未定义 | — | **待确认**(协议V1.7第1章) |
| 40005 | 0x0004 | 03 | (预留) | — | — | R | 协议V1.7保留,未定义 | — | **待确认** |
| 40006 | 0x0005 | 03/06/10 | 抽液目标步数(MB_Pump_Aspirate) | INT(WORD) | 步 | R/W | 抽液目标步数(0~最大行程),写入后泵执行抽液动作。**注:任务描述"40006-40007目标步数(32位)→VD102"与变量地址表11.2不一致**——变量地址表明确为40006→VW204(WORD,抽液)/40007→VW206(WORD,排液),两寄存器各自独立16位,非32位合并;VD102(VD_Dose_Steps)是PLC侧计算的目标步数(REAL),FC4通讯时转换为INT分别写入VW204/VW206,不直接映射为32位 | VW204 | 变量地址表11.2/8.4已确认(任务描述有误,以变量地址表为准) |
| 40007 | 0x0006 | 03/06/10 | 排液目标步数(MB_Pump_Dispense) | INT(WORD) | 步 | R/W | 排液目标步数(0~最大行程),写入后泵执行排液动作(泵阀一体内部阀自动切换流路) | VW206 | 变量地址表11.2已确认 |
| 40008 | 0x0007 | 03 | (预留) | — | — | R | 协议V1.7保留,未定义 | — | **待确认** |
| 40009 | 0x0008 | 03/06 | 启动速度(MB_Pump_SpeedStart) | INT(WORD) | Hz | R/W | 注射泵启动速度,控制抽排速度曲线起点。PLC侧VW208为WORD(INT),与泵寄存器字宽一致,**无需VD双字**;VD132(VD_PumpSpeed_Start,REAL,Hz)为HMI设定值,FC4通讯时由REAL转INT写入VW208→40009 | VW208 | 变量地址表8.4/11.2已确认(依据南京润泽V1.7第1.2.1节) |
| 40010 | 0x0009 | 03/06 | 最高速度(MB_Pump_SpeedMax) | INT(WORD) | Hz | R/W | 注射泵最高速度,控制抽排速度曲线峰值。VD136(VD_PumpSpeed_Max,REAL)→VW210→40010 | VW210 | 变量地址表8.4/11.2已确认 |
| 40011 | 0x000A | 03/06 | 截止速度(MB_Pump_SpeedCutoff) | INT(WORD) | Hz | R/W | 注射泵截止速度,控制抽排速度曲线终点。VD140(VD_PumpSpeed_Cutoff,REAL)→VW212→40011 | VW212 | 变量地址表8.4/11.2已确认 |
| 40012 | 0x000B | 03 | (预留) | — | — | R | 协议V1.7保留 | — | **待确认** |
| 40013 | 0x000C | 03 | (预留) | — | — | R | 协议V1.7保留 | — | **待确认** |
| 40014 | 0x000D | 03 | (预留) | — | — | R | 协议V1.7保留 | — | **待确认** |
| 40015 | 0x000E | 03/06 | 运行电流(MB_Pump_CurrentRun) | INT(WORD) | 1-31 | R/W | 运行电流档位,1~31 | VW214 | 变量地址表11.2已确认 |
| 40016 | 0x000F | 03/06 | 复位电流(MB_Pump_CurrentReset) | INT(WORD) | 1-31 | R/W | 复位电流档位,1~31 | VW216 | 变量地址表11.2已确认 |
| 40017 | 0x0010 | 03/06 | 阀输入口(MB_Pump_ValveIn) | INT(WORD) | — | R/W | 泵阀一体内部阀输入口(抽取母液流路切换),与外部电动球阀ABC无关 | VW218 | 变量地址表11.2已确认 |
| 40018 | 0x0011 | 03/06 | 阀输出口(MB_Pump_ValveOut) | INT(WORD) | — | R/W | 泵阀一体内部阀输出口(排放流路切换) | VW220 | 变量地址表11.2已确认 |
| 40019 | 0x0012 | 03/06 | 波特率配置 | INT | — | R/W | 0=9600/1=19200/2=38400/3=57600/4=115200(默认0=9600) | — | 变量地址表11.1(待确认是否需修改,首期保持9600) |
| 40020 | 0x0013 | 03/06 | Modbus类型配置 | INT | — | R/W | 0=RS232+ASCII/1=RS232+RTU/2=RS485+ASCII/3=RS485+RTU(需确认出厂为3,首期需切换至3) | — | 变量地址表11.1(**待确认出厂值**,见第10章) |
| 40021 | 0x0014 | 03/06 | (通讯参数扩展) | INT | — | R/W | 协议V1.7扩展参数 | — | **待确认** |
| 41001 | 0x03E8 | 03/04 | 状态码(MB_Pump_Status) | INT(WORD) | — | R | 状态码:0=空闲/完成,1=运行中,2=抽液中,3=排液中,其他非0=错误码(按泵厂商定义)。**注:任务描述"40001状态码→VW4"系笔误**——变量地址表11.2明确为41001(offset 0x03E8,即R区,非40001);PLC轮询后写入VW4 | VW4 | 变量地址表5.2/11.2已确认(任务描述地址有误,以变量地址表为准) |
| 41007 | 0x03EE | 03/04 | 位置反馈(MB_Pump_Position) | INT(WORD) | 半步 | R | 注射泵位置反馈,可用于核实实际抽排步数是否到位 | VW222 | 变量地址表11.2已确认 |

### 3.3 注射泵状态码定义(41001,见变量地址表5.2章)

| 状态码 | 含义 | HMI处理 | PLC处理 |
|---|---|---|---|
| 0 | 空闲/完成 | 可下发新指令 | FC13(S3加药)判定抽/排液动作完成 |
| 1 | 运行中 | 等待 | 继续轮询 |
| 2 | 抽液中 | 显示"加药中" | 等待,继续轮询 |
| 3 | 排液中 | 显示"排液中" | 等待,继续轮询 |
| ≥4(其他非0) | 错误码(按泵厂商定义) | 触发注射泵故障报警 | 置V303.4=1(M_Alarm_SyringePump)+转S_ERROR,见第8章 |

> **状态码具体错误码含义待南京润泽V1.7协议确认**(见第10章待确认事项)。

---

## 第4章 流量计K24寄存器映射(站号02)

### 4.1 寄存器总览

依据K24流量计《Modbus协议》(见PLC设计文档2.3节、变量地址表11.3章),流量计寄存器从0x0000开始编址,采用FC03读/FC06单写/FC10多写。下表对照变量地址表11.3章逐项核对:

### 4.2 流量计K24寄存器映射表

| Modbus寄存器 | HEX偏移 | 功能码 | 寄存器名 | 数据类型 | 单位 | 读写 | 说明 | 对应PLC变量 | 来源/待确认 |
|---|---|---|---|---|---|---|---|---|---|
| 0x0000(站号) | 0x0000 | 03/06 | 站号 | INT | — | R/W | 流量计从站站号(默认0x02,范围1~255) | — | 变量地址表11.1已确认默认值 |
| 0x0001(波特率) | 0x0001 | 03/06 | 波特率配置 | INT | — | R/W | 默认0x0000=9600(0x2580寄存器值,详见协议)。支持1200~9600,首期统一9600 | — | 变量地址表11.1已确认 |
| 0x0009(计量值) | 0x0009 | 03 | 计量值(MB_Flow_Total) | DWORD(32位) | L(累计) | R | 计量值(累计流量),0~99999999,**低3位为小数部分**(即实际值=读数值/1000)。持续累加,**无清零/复位寄存器**(0x0011~0x0015等可写寄存器均为通讯地址/波特率/单价/单位/校正参数,与累计清零无关)。**PLC必须用差值法**:阀A开启瞬间快照→进水过程中用"当前计量值−快照值"计算本次进水量 | VD86(见变量地址表7.2) | 变量地址表11.3/PLC设计文档2.3已确认;**字节序待确认**(见第10章) |
| 0x000F(平均流速) | 0x000F | 03 | 平均流速(MB_Flow_Avg) | INT(16位) | L/min | R | 近1分钟平均流速,**低2位为小数部分**(即实际值=读数值/100)。仅监测参考,不参与控制 | VD224 | 变量地址表11.3已确认;**注:变量地址表标注VD224但实际为INT(16位),应映射到VW224,待确认变量地址表是否有误** |
| 0x0012(单位) | 0x0012 | 03/06 | 单位(MB_Flow_Unit) | INT(WORD) | — | R/W | 单位编码:0x01=夸脱美制QTS/0x02=品脱美制PTS/0x03=升L(默认)/0x04=加仑美制GAL/0x05=压强PA/0x06=立方米m³/0x07=千克KG。**需现场读取确认实际配置值**,默认按0x03=升L假设 | VW228 | 变量地址表11.3已确认(已确认默认0x03,首期无需修改) |
| 0x0017(瞬时流速) | 0x0017 | 03 | 瞬时流速(MB_Flow_Instant) | INT(16位) | L/min | R | 瞬时流速(实时),**低2位为小数部分**(即实际值=读数值/100)。仅监测,映射自0x0017。**注:变量地址表7.2标注VD94(REAL),但寄存器为INT(16位),PLC侧需INT→REAL转换后写入VD94** | VD94(见变量地址表7.2) | 变量地址表11.3已确认;INT→REAL转换逻辑待Story 1.1确认 |

### 4.3 流量计差值法进水计量逻辑(S1阶段,见变量地址表11.4章)

```
阀A开启瞬间(S1进入):
  VD_FlowMeter_Snapshot(VD82) = MB_Flow_Total(0x0009,当前累计流量快照)

进水过程中(FC4周期轮询):
  VD_FlowMeter_Current(VD86) = MB_Flow_Total(轮询读取)
  VD_Current_InletVolume(VD90) = VD86 − VD82   [REAL,单位L]

阀A关闭且验证通过:
  本轮进水量最终值 = VD90(锁定)
  → 用于计算 VD_Vol_Target(VD98) = VD_C_Set × VD90 / VD_C_Stock
  → 用于计算 VD_Dose_Steps(VD102) = VD98 ÷ VD_StepResolution
  → VD102转换为INT,写入注射泵40006(抽液)/40007(排液)
```

### 4.4 流量计寄存器待确认事项

| 项 | 待确认内容 | 影响范围 |
|---|---|---|
| 字节序 | 0x0009为DWORD(32位),高低字在Modbus报文中的顺序(大端/小端)待K24协议确认。S7-200 SMART MBUS_MSG读取32位数据时,VD86的字节序需与从站一致 | 差值法计算正确性 |
| 溢出行为 | 0x0009长期运行达到99999999后的溢出行为(回绕/停止/报错)待厂商确认 | 长期运行可靠性 |
| 实际单位 | 现场读取0x0012确认实际配置值(默认按0x03=升L假设) | 进水量计算单位 |
| 0x000F/0x0017变量类型 | 变量地址表标注VD224/VD94(REAL),但寄存器为INT(16位),需确认PLC侧转换逻辑 | 监测显示 |
| 完整寄存器表 | K24流量计完整寄存器详表(0x0000~0xFFFF)待厂商提供,本表仅列与本系统相关寄存器 | 协议完整性 |

---

## 第5章 报文帧格式

### 5.1 RTU帧格式

Modbus RTU帧由4部分组成,无起始/结束字符,靠3.5字符静默时间识别帧边界:

```
┌──────────┬──────────┬─────────────┬──────────┐
│ 从站地址 │ 功能码   │ 数据区      │ CRC16    │
│ 1字节    │ 1字节    │ N字节       │ 2字节    │
│ 0x01~FE  │ 03/06/10 │ 变长        │ 低字节在前│
└──────────┴──────────┴─────────────┴──────────┘
        ↑                                   ↑
        └── 帧起始(3.5字符静默后) ───── 帧结束(3.5字符静默前)
```

| 字段 | 长度 | 说明 |
|---|---|---|
| 从站地址 | 1字节 | 0x01~0xFE(0x00为广播,从站不响应) |
| 功能码 | 1字节 | 03/06/10(正常)/83/86/90(异常,功能码+0x80) |
| 数据区 | 变长 | 请求/响应内容,详见5.2~5.4 |
| CRC16 | 2字节 | 低字节在前,高字节在后(多项式0xA001,见5.5) |
| 帧间隔 | 3.5字符 | 9600bps下约3.65ms,帧间静默 |
| 字内间隔 | ≤1.5字符 | 9600bps下约1.56ms,单字节间最大间隔 |

### 5.2 功能码03:读保持寄存器

#### 5.2.1 请求帧格式

| 字节 | 内容 | 说明 |
|---|---|---|
| 1 | 从站地址 | 0x01(注射泵)/0x02(流量计) |
| 2 | 功能码 | 0x03 |
| 3-4 | 起始地址 | 16位,大端(高字节在前) |
| 5-6 | 寄存器数量 | 16位,大端,范围1~125 |
| 7-8 | CRC16 | 低字节在前 |

#### 5.2.2 响应帧格式(正常)

| 字节 | 内容 | 说明 |
|---|---|---|
| 1 | 从站地址 | 与请求一致 |
| 2 | 功能码 | 0x03 |
| 3 | 字节数 | N×2(N=寄存器数量) |
| 4~(3+N×2) | 数据 | 寄存器值,大端,按请求顺序连续返回 |
| 末2字节 | CRC16 | 低字节在前 |

#### 5.2.3 示例:读注射泵41001状态码(站号01,1个寄存器)

> **地址换算**:41001 → offset = 41001 - 40001 = 1000 = 0x03E8

**请求帧**:

| 字节 | 01 | 03 | 03 | E8 | 00 | 01 | 04 | 7A |
|---|---|---|---|---|---|---|---|---|
| 含义 | 站号01 | FC03 | 起始地址0x03E8 | | 数量1 | | CRC低 | CRC高 |

**完整十六进制**:`01 03 03 E8 00 01 04 7A`(8字节)

> CRC16计算:对[01 03 03 E8 00 01]求CRC,结果0x7A04,低字节0x04在前,高字节0x7A在后。详见5.5节计算示例。

**响应帧(假设状态码=0x0002抽液中)**:

| 字节 | 01 | 03 | 02 | 00 | 02 | 39 | 85 |
|---|---|---|---|---|---|---|---|
| 含义 | 站号01 | FC03 | 字节数2 | 数据高字节 | 数据低字节(状态码2=抽液中) | CRC低 | CRC高 |

**完整十六进制**:`01 03 02 00 02 39 85`(7字节)

> CRC16计算:对[01 03 02 00 02]求CRC,结果0x8539,低字节0x39在前,高字节0x85在后。

#### 5.2.4 示例:读流量计0x0009计量值(站号02,2个寄存器=32位DWORD)

> **地址换算**:0x0009 → 寄存器号 = 0x0009 + 40001 = 40010(offset 0x0009),读取2个寄存器(DWORD=2 WORD)

**请求帧**:`02 03 00 09 00 02 D4 0F`(8字节)

| 字节 | 02 | 03 | 00 | 09 | 00 | 02 | D4 | 0F |
|---|---|---|---|---|---|---|---|---|
| 含义 | 站号02 | FC03 | 起始地址0x0009 | | 数量2(DWORD) | | CRC低 | CRC高 |

> CRC16=0x0FD4,低字节0xD4在前,高字节0x0F在后。

**响应帧(假设计量值=12345678,即实际12.345678L,低3位小数)**:

| 字节 | 02 | 03 | 04 | 00 | BC | 61 | 4E | XX | XX |
|---|---|---|---|---|---|---|---|---|---|
| 含义 | 站号02 | FC03 | 字节数4 | 数据高字高字节 | 数据高字低字节 | 数据低字高字节 | 数据低字低字节 | CRC低 | CRC高 |

> 12345678=0x00BC614E。**字节序待K24协议确认**(大端/小端),上表为大端示例。完整CRC值需根据实际数据计算。

### 5.3 功能码06:写单个保持寄存器

#### 5.3.1 请求帧格式

| 字节 | 内容 | 说明 |
|---|---|---|
| 1 | 从站地址 | |
| 2 | 功能码 | 0x06 |
| 3-4 | 寄存器地址 | 16位,大端 |
| 5-6 | 写入值 | 16位,大端 |
| 7-8 | CRC16 | 低字节在前 |

#### 5.3.2 响应帧格式(正常)

> 响应帧与请求帧**完全相同**(回显),从站原样返回请求内容作为确认。

#### 5.3.3 示例:写注射泵40006抽液步数(站号01,值=200步=0x00C8)

> **地址换算**:40006 → offset = 40006 - 40001 = 5 = 0x0005

**请求帧**:`01 06 00 05 00 C8 98 5D`(8字节)

| 字节 | 01 | 06 | 00 | 05 | 00 | C8 | 98 | 5D |
|---|---|---|---|---|---|---|---|---|
| 含义 | 站号01 | FC06 | 地址0x0005 | | 值0x00C8(200步) | | CRC低 | CRC高 |

> CRC16=0x5D98,低字节0x98在前,高字节0x5D在后。

**响应帧(正常)**:`01 06 00 05 00 C8 98 5D`(8字节,与请求完全相同)

### 5.4 功能码10(0x10):写多个保持寄存器

#### 5.4.1 请求帧格式

| 字节 | 内容 | 说明 |
|---|---|---|
| 1 | 从站地址 | |
| 2 | 功能码 | 0x10 |
| 3-4 | 起始地址 | 16位,大端 |
| 5-6 | 寄存器数量 | 16位,大端,范围1~123 |
| 7 | 字节数 | N×2 |
| 8~(7+N×2) | 数据 | 寄存器值,大端,连续 |
| 末2字节 | CRC16 | 低字节在前 |

#### 5.4.2 响应帧格式(正常)

| 字节 | 内容 | 说明 |
|---|---|---|
| 1 | 从站地址 | |
| 2 | 功能码 | 0x10 |
| 3-4 | 起始地址 | 与请求一致 |
| 5-6 | 寄存器数量 | 与请求一致 |
| 7-8 | CRC16 | 低字节在前 |

#### 5.4.3 示例:写注射泵40006-40007抽液+排液步数(站号01,抽液200步=0x00C8,排液100步=0x0064)

> **用途**:一次性写入抽液/排液目标步数,减少通讯次数。FC13(S3加药)触发。

**请求帧**:`01 10 00 05 00 02 04 00 C8 00 64 F4 D4`(13字节)

| 字节 | 01 | 10 | 00 | 05 | 00 | 02 | 04 | 00 | C8 | 00 | 64 | F4 | D4 |
|---|---|---|---|---|---|---|---|---|---|---|---|---|---|
| 含义 | 站号01 | FC10 | 地址0x0005 | | 数量2 | | 字节数4 | 40006高字节 | 40006低字节(200步) | 40007高字节 | 40007低字节(100步) | CRC低 | CRC高 |

> CRC16=0xD4F4,低字节0xF4在前,高字节0xD4在后。

**响应帧(正常)**:`01 10 00 05 00 02 21 D0`(8字节)

| 字节 | 01 | 10 | 00 | 05 | 00 | 02 | 21 | D0 |
|---|---|---|---|---|---|---|---|---|
| 含义 | 站号01 | FC10 | 地址0x0005 | | 数量2 | | CRC低 | CRC高 |

> CRC16=0xD021,低字节0x21在前,高字节0xD0在后。

### 5.5 CRC16计算算法

#### 5.5.1 算法描述

Modbus RTU采用CRC-16-ARC算法,多项式0xA001(即0x8005的反转),初始值0xFFFF:

```
1. CRC寄存器初始化为 0xFFFF
2. 对帧中每个字节(不含CRC本身):
   a. CRC = CRC XOR 字节
   b. 循环右移8次:
      若 CRC 最低位 = 1:
         CRC = (CRC >> 1) XOR 0xA001
      否则:
         CRC = CRC >> 1
3. 最终 CRC 为 16 位值:
   低字节 = CRC & 0xFF
   高字节 = (CRC >> 8) & 0xFF
4. 帧尾追加:低字节在前,高字节在后
```

#### 5.5.2 伪代码

```c
uint16_t ModbusCRC16(uint8_t *frame, uint16_t length) {
    uint16_t crc = 0xFFFF;
    uint16_t i, j;
    for (i = 0; i < length; i++) {
        crc ^= frame[i];
        for (j = 0; j < 8; j++) {
            if (crc & 0x0001) {
                crc = (crc >> 1) ^ 0xA001;
            } else {
                crc >>= 1;
            }
        }
    }
    return crc;  // 低字节 = crc & 0xFF,高字节 = (crc >> 8) & 0xFF
}
```

#### 5.5.3 计算示例:请求帧[01 03 03 E8 00 01]的CRC16

逐步计算(仅列每字节处理后的CRC结果):

| 步骤 | 字节 | 操作 | CRC结果 |
|---|---|---|---|
| 初始 | — | CRC=0xFFFF | 0xFFFF |
| 1 | 0x01 | XOR后右移8位 | 0x807E |
| 2 | 0x03 | XOR后右移8位 | 0x2140 |
| 3 | 0x03 | XOR后右移8位 | 0xF160 |
| 4 | 0xE8 | XOR后右移8位 | 0x66F1 |
| 5 | 0x00 | XOR后右移8位 | 0x84A7 |
| 6 | 0x01 | XOR后右移8位 | **0x7A04** |

**最终CRC = 0x7A04**:
- 低字节 = 0x04
- 高字节 = 0x7A

**完整帧**:`01 03 03 E8 00 01 04 7A`(CRC低字节0x04在前,高字节0x7A在后)

#### 5.5.4 验证示例

| 帧(不含CRC) | CRC计算结果 | 完整帧(含CRC) |
|---|---|---|
| [01 03 03 E8 00 01] | 0x7A04 | `01 03 03 E8 00 01 04 7A` |
| [01 03 02 00 02] | 0x8539 | `01 03 02 00 02 39 85` |
| [02 03 00 09 00 02] | 0x0FD4 | `02 03 00 09 00 02 D4 0F` |
| [01 06 00 05 00 C8] | 0x5D98 | `01 06 00 05 00 C8 98 5D` |
| [01 10 00 05 00 02 04 00 C8 00 64] | 0xD4F4 | `01 10 00 05 00 02 04 00 C8 00 64 F4 D4` |
| [01 10 00 05 00 02] | 0xD021 | `01 10 00 05 00 02 21 D0` |
| [01 83 02] | 0xF1E0 | `01 83 02 E0 F1` |

> **调试建议**:抓包后用在线Modbus CRC计算器或Modbus Poll自带CRC校验功能验证。

### 5.6 异常响应

#### 5.6.1 异常响应帧格式

当从站无法执行请求时,返回异常响应:

| 字节 | 内容 | 说明 |
|---|---|---|
| 1 | 从站地址 | 与请求一致 |
| 2 | 异常功能码 | 请求功能码 + 0x80(如03→83,06→86,10→90) |
| 3 | 异常码 | 1字节,见5.6.2 |
| 4-5 | CRC16 | 低字节在前 |

#### 5.6.2 异常码定义

| 异常码 | 名称 | 含义 | 本系统处理(见第8章) |
|---|---|---|---|
| 0x01 | 非法功能码 | 从站不支持该功能码(如对只读寄存器用FC06写) | 记录日志,检查寄存器读写属性配置 |
| 0x02 | 非法数据地址 | 请求的寄存器地址不存在(如读40004预留寄存器) | 记录日志,核对寄存器映射表 |
| 0x03 | 非法数据值 | 写入值超范围(如速度>最大值,步数>最大行程) | 记录日志,检查VD_Dose_Steps边界 |
| 0x04 | 从站设备故障 | 从站内部故障(如注射泵机械故障、流量计传感器故障) | 置V303.4=1,转S_ERROR |
| 0x05 | 确认 | 从站接受请求但执行耗时(本系统未使用) | — |
| 0x06 | 从站设备忙 | 从站正在处理上一请求(本系统轮询间隔足够,不应出现) | 重试1次,仍忙则记录日志 |

#### 5.6.3 异常响应示例

**示例**:对注射泵站号01读40004(预留寄存器),从站返回异常码02(非法数据地址):

**请求帧**:`01 03 00 03 00 01 74 0A`(8字节)

**异常响应帧**:`01 83 02 E0 F1`(5字节)

| 字节 | 01 | 83 | 02 | E0 | F1 |
|---|---|---|---|---|---|
| 含义 | 站号01 | 异常功能码(03+0x80) | 异常码02(非法数据地址) | CRC低 | CRC高 |

> CRC16对[01 83 02]计算=0xF1E0,低字节0xE0在前,高字节0xF1在后。

---

## 第6章 Modbus TCP从站(MBUS_SERVER)规格

> **启用条件**:仅当HMI(昆仑通态MCGS)不支持8个S7连接时启用(见变量地址表12.4节)。若HMI支持S7协议(推荐),本章不启用。

### 6.1 TCP层参数

| 参数 | 值 | 说明 |
|---|---|---|
| 协议 | Modbus TCP/IP | PLC作为TCP从站(服务器),HMI作为TCP主站(客户端) |
| 监听端口 | 502(标准Modbus TCP端口) | S7-200 SMART MBUS_SERVER默认502 |
| PLC IP | 192.168.2.101~108 | 8台PLC,每台1个IP,与单元编号一一对应(见变量地址表12.1) |
| HMI IP | 192.168.2.10 | 作为TCP主站,访问8台PLC:502 |
| 子网掩码 | 255.255.255.0 | C类 |
| 连接数 | 单PLC支持1~8个TCP连接(MBUS_SERVER MaxInput/MaxHold限制) | HMI单连接每PLC即可 |
| MBUS_SERVER指令 | `MBUS_SERVER VB0, 1, 1000, 1, 1000, V2.0` (参数示意) | MaxInput/MaxHold/MaxCoil/MaxDisc/HoldStart等参数待Story 1.1确认 |
| 通讯超时 | 与S7协议相同,见性能基准测试方案第4章 | HMI单次读写V区≤50ms(待确认) |

### 6.2 V区→保持寄存器映射规则

MBUS_SERVER指令将V区映射为Modbus TCP保持寄存器,映射规则:

| 数据类型 | 映射规则 | 说明 |
|---|---|---|
| WORD(VW) | 1个VW = 1个保持寄存器(16位) | 直映,无转换。如VW2→1个寄存器 |
| REAL/DWORD(VD) | 1个VD = 2个保持寄存器(32位) | 占2个连续寄存器,字节序由PLC决定(S7-200 SMART为大端) |
| BOOL(V位) | 位映射或拆字 | 单个V位无法直接映射为保持寄存器(寄存器为16位)。方案1:将包含该位的VW映射为1个寄存器,HMI侧按位解析(推荐);方案2:拆字映射到线圈区(本系统暂未用线圈) |
| INT(WORD) | 1个VW = 1个保持寄存器 | 与WORD相同 |

> **HoldStart配置**:MBUS_SERVER的HoldStart参数指定映射起始V地址。若HoldStart=&VB0,则保持寄存器40001(offset 0)对应VW0,40002对应VW2,40003对应VW4,...(按VW递增2字节)。下表按HoldStart=&VB0给出映射。

### 6.3 V区→保持寄存器映射表(HoldStart=&VB0)

下表对照变量地址表逐项列出关键变量(覆盖变量地址表第1~9章主要变量):

| Modbus寄存器(TCP) | HEX偏移 | V区地址 | 符号 | 类型 | 寄存器数 | 说明 | 来源 |
|---|---|---|---|---|---|---|---|
| 40001 | 0x0000 | VW0 | CMD_xxx(8命令位)+STA_xxx(8状态位) | WORD | 1 | V0.0~V0.7系统命令位(HMI→PLC)+V1.0~V1.7系统状态位(PLC→HMI),HMI按位解析 | 变量地址表4.1/4.2 |
| 40002 | 0x0001 | VW2 | 状态机当前状态 | INT | 1 | 0=S0/1=S1/.../8=S7/99=S_ERROR | 变量地址表5.1 |
| 40003 | 0x0002 | VW4 | 注射泵状态码 | INT | 1 | 映射自RTU层41001,0=空闲/1=运行/2=抽液/3=排液/其他=错误 | 变量地址表5.2 |
| 40004 | 0x0003 | VW6 | 当前报警码 | INT | 1 | 最高优先级未确认报警码(0=无,99=安全继电器故障) | 变量地址表5.3 |
| 40005 | 0x0004 | VW8 | 实验轮次计数 | INT | 1 | 每完成一个换水周期累加1 | 变量地址表5.4 |
| 40006-40007 | 0x0005 | VD10 | VD_C_Set | REAL | 2 | 目标浓度设定值(默认5.0%) | 变量地址表6.1 |
| 40008-40009 | 0x0007 | VD14 | VD_C_Stock | REAL | 2 | 母液浓度(默认100.0%) | 变量地址表6.1 |
| 40010-40011 | 0x0009 | VD18 | VD_StepResolution | REAL | 2 | 注射泵单步分辨率(默认0.2083µL/步) | 变量地址表6.1 |
| 40012-40013 | 0x000B | VD20 | VD_CycleSetpoint | REAL | 2 | 换水周期设定值(默认30.0min) | 变量地址表6.2 |
| 40014-40015 | 0x000D | VD24 | VD_ExperimentTarget | REAL | 2 | 实验时长目标(默认480.0min) | 变量地址表6.2 |
| 40016-40017 | 0x000F | VD28 | VD_PreMixTime | REAL | 2 | S2预循环标称时长(默认120.0s) | 变量地址表6.2 |
| 40018-40019 | 0x0011 | VD32 | VD_PreMixTime_MinSafe | REAL | 2 | S2压缩下限(默认30.0s) | 变量地址表6.2 |
| 40020-40021 | 0x0013 | VD36 | VD_RestTime | REAL | 2 | S3.5静止等候标称时长(默认60.0s) | 变量地址表6.2 |
| 40022-40023 | 0x0015 | VD40 | VD_RestTime_Min | REAL | 2 | 静止等候压缩下限(默认15.0s) | 变量地址表6.2 |
| 40024-40025 | 0x0017 | VD44 | VD_CycleExtend_Max | REAL | 2 | 换水周期顺延最大幅度(默认5.0min) | 变量地址表6.2 |
| 40026-40027 | 0x0019 | VD48 | VD_Timeout_ValveA | REAL | 2 | 阀A动作超时(默认60.0s) | 变量地址表6.3 |
| 40028-40029 | 0x001B | VD50 | VD_Timeout_ValveB | REAL | 2 | 阀B动作超时(默认60.0s) | 变量地址表6.3 |
| 40030-40031 | 0x001D | VD54 | VD_Timeout_ValveC | REAL | 2 | 阀C动作超时(默认60.0s) | 变量地址表6.3 |
| 40032-40033 | 0x001F | VD58 | VD_Timeout_Pump1 | REAL | 2 | 预留未用（原潜水泵1超时，水流开关取消） | 变量地址表6.3 |
| 40034-40035 | 0x0021 | VD62 | VD_Timeout_Pump2 | REAL | 2 | 预留未用（原潜水泵2超时，水流开关取消） | 变量地址表6.3 |
| 40036-40037 | 0x0023 | VD66 | VD_Delay_ValveA_Verify | REAL | 2 | 阀A延时验证(默认5.0s) | 变量地址表6.3 |
| 40038-40039 | 0x0025 | VD70 | VD_S1_Actual | REAL | 2 | S1实测时长(s) | 变量地址表7.1 |
| 40040-40041 | 0x0027 | VD74 | VD_S4_Actual | REAL | 2 | S4实测时长(s) | 变量地址表7.1 |
| 40042-40043 | 0x0029 | VD78 | VD_S6_Actual | REAL | 2 | S6实测时长(s) | 变量地址表7.1 |
| 40044-40045 | 0x002B | VD82 | VD_FlowMeter_Snapshot | DWORD | 2 | 阀A开启瞬间流量计快照(差值法基准) | 变量地址表7.2 |
| 40046-40047 | 0x002D | VD86 | VD_FlowMeter_Current | DWORD | 2 | 流量计当前计量值(轮询读取) | 变量地址表7.2 |
| 40048-40049 | 0x002F | VD90 | VD_Current_InletVolume | REAL | 2 | 本次进水量(L) | 变量地址表7.2 |
| 40050-40051 | 0x0031 | VD94 | VD_FlowRate_Instant | REAL | 2 | 瞬时流速(L/min,映射自0x0017) | 变量地址表7.2 |
| 40052-40053 | 0x0033 | VD96 | VD_ExperimentDuration_Accum | REAL | 2 | 实验时长累加值(min) | 变量地址表7.3 |
| 40054-40055 | 0x0035 | VD98 | VD_Vol_Target | REAL | 2 | 本轮目标抽取体积(µL) | 变量地址表7.4 |
| 40056-40057 | 0x0037 | VD102 | VD_Dose_Steps | REAL | 2 | 本轮加药目标步数(REAL,FC4转INT写入VW204/VW206) | 变量地址表7.4 |
| 40058-40059 | 0x0039 | VD144 | VD_T_Default | REAL | 2 | T初始默认值(s,HMI设定;v1.4由VD104迁移,VD104与VD102冲突) | 变量地址表8.1 |
| 40060-40061 | 0x003B | VD108 | VD_S6_Default | REAL | 2 | S6排水时长初始默认值(s) | 变量地址表8.1 |
| 40062-40063 | 0x003D | VD112 | VD_T_Rolling | REAL | 2 | 滚动实测S1-S3+S3.5总时长T(s) | 变量地址表8.2 |
| 40064-40065 | 0x003F | VD116 | VD_S6_Rolling | REAL | 2 | 滚动实测S6排水时长(s) | 变量地址表8.2 |
| 40066-40067 | 0x0041 | VD120 | VD_S2_Target | REAL | 2 | 本轮S2实际执行目标(s) | 变量地址表8.3 |
| 40068-40069 | 0x0043 | VD124 | VD_RestTime_Target | REAL | 2 | 本轮S3.5实际执行目标(s) | 变量地址表8.3 |
| 40070-40071 | 0x0045 | VD128 | VD_CycleExtend_Target | REAL | 2 | 本轮允许"下缸空等"时长(min) | 变量地址表8.3 |
| 40072-40073 | 0x0047 | VD132 | VD_PumpSpeed_Start | REAL | 2 | 启动速度(HMI设定,FC4转INT→VW208→40009) | 变量地址表8.4 |
| 40074-40075 | 0x0049 | VD136 | VD_PumpSpeed_Max | REAL | 2 | 最高速度(→VW210→40010) | 变量地址表8.4 |
| 40076-40077 | 0x004B | VD140 | VD_PumpSpeed_Cutoff | REAL | 2 | 截止速度(→VW212→40011) | 变量地址表8.4 |
| 40151-40152 | 0x0096 | VW200~VW220 | MB_Pump_xxx(Modbus缓冲区) | WORD | 11 | RTU层注射泵写寄存器缓冲区,共11个VW(200/202/204/206/208/210/212/214/216/218/220)。**注:此区为RTU层缓冲区,TCP层一般不直接访问** | 变量地址表11.2/附录A |
| 40154 | 0x0099 | VW222 | MB_Pump_Position | INT | 1 | 注射泵位置反馈(映射自41007) | 变量地址表11.2 |
| 40156-40157 | 0x009B | VD224 | MB_Flow_Avg | INT/REAL | 1~2 | 流量计平均流速(变量地址表标注VD224但寄存器为INT,待确认) | 变量地址表11.3 |
| 40158 | 0x009D | VW228 | MB_Flow_Unit | INT | 1 | 流量计单位编码(默认0x03=升L) | 变量地址表11.3 |
| 40151-40152 | 0x0096 | VD300(VB300~VB303) | M_Alarm_xxx(报警字) | DWORD | 2 | 4字节32位按位编码报警字,HMI按位解析(报警字1~4)。**注:VB300~VB303与上方VW200~VW220不在同一地址区,V区地址无重叠,但映射到TCP寄存器号时需核对HoldStart配置** | 变量地址表9.1 |

> **地址换算公式**:TCP寄存器号 = 40001 + (V区字节偏移 / 2)。例:VD10对应V区字节偏移10,则寄存器号=40001+10/2=40006(占2个寄存器40006-40007)。
> **REAL字节序**:S7-200 SMART V区REAL为大端(高字在高地址),Modbus TCP保持寄存器亦为大端,但跨寄存器的高低字顺序需现场实测确认。
> **位变量映射**:V0.x/V1.x命令位/状态位封装在VW0(40001),V300.x~V303.x报警位封装在VD300(对应TCP寄存器40151-40152),HMI侧按位解析。

### 6.4 HMI访问配置(若启用MBUS_SERVER)

HMI工程中配置8个Modbus TCP连接,每个连接对应1台PLC:

| HMI连接名 | 目标IP:端口 | 单元 | TCP从站单元标识 | 备注 |
|---|---|---|---|---|
| PLC_01 | 192.168.2.101:502 | 1 | 1(或PLC侧配置) | Modbus TCP Unit ID通常为1或255 |
| PLC_02 | 192.168.2.102:502 | 2 | 1 | 每台PLC独立,Unit ID可统一为1 |
| PLC_03 | 192.168.2.103:502 | 3 | 1 | |
| PLC_04 | 192.168.2.104:502 | 4 | 1 | |
| PLC_05 | 192.168.2.105:502 | 5 | 1 | |
| PLC_06 | 192.168.2.106:502 | 6 | 1 | |
| PLC_07 | 192.168.2.107:502 | 7 | 1 | |
| PLC_08 | 192.168.2.108:502 | 8 | 1 | |

> **Unit ID**:Modbus TCP帧中Unit ID字段对于MBUS_SERVER通常忽略(直接访问本机V区),建议统一填1或255(255=广播本机)。

---

## 第7章 轮询时序与超时

### 7.1 FC4轮询策略(见FC4_ModbusPolling.stl)

FC4在每个OB1扫描周期被调用(见性能基准测试方案2.1节),轮询策略如下:

```
OB1扫描周期(目标≤5ms空载/≤8ms S5运行/≤10ms 8报警同时活动)
  └─ FC4_ModbusPolling 调用
      ├─ NETWORK 1: MBUS_CTRL初始化(每周期调用,Mode=1/Baud=9600/Parity=0/Port=0)
      └─ NETWORK 2: 基于VW250轮询计数器顺序执行MBUS_MSG
          ├─ VW250=0: 注射泵轮询
          │   └─ MBUS_MSG读41001(0x03E8,FC03,1寄存器)→VW4(MB_Pump_Status)
          │       Done位(M10.0)置1后,VW250→1
          └─ VW250=1: 流量计轮询
              └─ MBUS_MSG读40010(0x0009,FC03,2寄存器)→VD86(MB_Flow_Total)
                  Done位(M10.1)置1后,VW250→0(下一轮)
```

> **FC4现状**:当前为骨架(见FC4_ModbusPolling.stl注释),实际MBUS_MSG参数(站号/地址/功能码)由Story 1.1细化。本规格基于Story 1.1完成后的实际代码执行。

### 7.2 单次请求超时阈值(引用性能基准测试方案1.2/3.3节)

| 从站 | 寄存器 | 超时阈值 | 来源 | 备注 |
|---|---|---|---|---|
| 注射泵 | 41001(状态码轮询) | 2000 ms | 变量地址表11.1"通讯超时"建议值 | 状态码轮询超时判定,9600bps下8字节请求+7字节响应理论15.6ms,2000ms为含重试的保守阈值 |
| 流量计 | 0x0009(计量值读取) | 1000 ms | 变量地址表11.1"通讯超时"建议值 | 单次读取应<500ms,1000ms为含重试的保守阈值 |

> **实现位置**:MBUS_MSG指令内部超时(默认值)或Story 1.1实现的外部超时逻辑(VD_Timeout相关,**待Story 1.1确认**)。注意:VD_Timeout_ValveA/B/C为阀门动作超时,与Modbus通讯超时不同(见性能基准测试方案3.3节注)。

### 7.3 重试与轮询周期

| 项 | 值 | 说明 |
|---|---|---|
| 单从站单次失败重试次数 | 1次 | 性能基准测试方案1.2节指标6:"单从站失败重试不超1次" |
| 一轮2从站轮询周期 | ≤500 ms | 注射泵+流量计各1次完成总耗时(性能基准测试方案1.2节指标6) |
| 单次轮询耗时(注射泵41001) | ≤100 ms(P95) | 9600bps,8字节请求+7字节响应≈20ms理论值,加从站处理延迟(性能基准测试方案1.2节指标4) |
| 单次轮询耗时(流量计0x0009) | ≤100 ms(P95) | 8字节请求+9字节响应≈20ms理论值(性能基准测试方案1.2节指标5) |
| 长时连续轮询稳定性 | ≥1小时无失败 | 性能基准测试方案3.2.3节连续轮询稳定性测量 |

### 7.4 通讯中断判定逻辑

**连续超时判定**:单从站连续N次请求超时(或返回错误)判定为通讯中断。建议N=3(待Story 1.1确认),即:
- 第1次超时:记录但不报警,继续轮询
- 第2次超时:记录,继续轮询
- 第3次超时:判定通讯中断,触发报警(见7.5)

> **判据来源**:性能基准测试方案3.3节"超时阈值验证"——断开RS485后,从断开到V303.4=1的时间应≤2000ms(注射泵)。3次连续超时(每次2000ms)总耗时6000ms,需Story 1.1确认实际N值或改为单次超时即报警。

### 7.5 中断后PLC动作

| 项 | 动作 | 来源 |
|---|---|---|
| 注射泵通讯中断 | 置V303.4=1(M_Alarm_SyringePump,注射泵通讯/动作异常报警) | 变量地址表9.1报警字4 |
| 状态机响应 | 转S_ERROR(VW2=99,故障锁定) | 设计文档第十章/变量地址表5.1 |
| 报警码 | VW6=64(注射泵故障,见变量地址表9.2) | 变量地址表9.2 |
| 报警输出 | Q0.7=1(声音)+Q8.0=1(灯光,需人工确认复位) | 变量地址表第三章 |
| 流量计通讯中断 | **待确认**:是否映射到V303.4或独立报警位(性能基准测试方案3.3节注) | 变量地址表11.1(**待Story 1.1确认**) |
| 通讯中断恢复时间 | ≤10 s | 性能基准测试方案1.2节指标8(从断线恢复到V303.4清零且重新读到有效数据) |

---

## 第8章 错误处理与恢复

### 8.1 Modbus异常码处理

| 异常码 | 处理逻辑 | PLC动作 | 恢复方式 |
|---|---|---|---|
| 0x01非法功能码 | 记录日志(写入VW230诊断区,待Story 1.1确认地址),不立即报警 | 继续轮询下一从站 | 检查寄存器读写属性配置,核对是否对只读寄存器用FC06写 |
| 0x02非法数据地址 | 记录日志,不立即报警 | 继续轮询 | 核对寄存器映射表第3/4章,确认offset计算正确 |
| 0x03非法数据值 | 记录日志,不立即报警 | 继续轮询 | 检查VD_Dose_Steps边界(最大行程步数待确认)、速度参数范围 |
| 0x04从站设备故障 | **立即报警**:置V303.4=1,转S_ERROR(VW2=99),VW6=64 | 故障锁定 | 人工现场检查注射泵机械/流量计传感器,排除故障后系统复位 |
| 0x06从站设备忙 | 重试1次;仍忙则记录日志,本次轮询跳过 | 继续下一从站轮询 | 下次轮询周期重试,若持续忙则需检查从站负载 |

### 8.2 CRC错误处理

| 项 | 处理 |
|---|---|
| CRC校验失败 | **丢弃整个响应帧**,不计入数据,不更新VW4/VD86等变量 |
| 重试 | 同一请求重试1次(性能基准测试方案1.2节指标6) |
| 连续CRC错误 | 连续3次CRC错误(建议值,待Story 1.1确认)判定为通讯故障,触发7.5节中断动作 |
| 可能原因 | 电磁干扰(动力线靠近RS485线)、接线松动、屏蔽未接地、终端电阻缺失、波特率不匹配 |
| 排查 | 见第9章抓包与调试 |

### 8.3 超时重试

```
单次请求发出 → 等待响应:
  ├─ 在超时阈值内收到响应(且CRC校验通过)→ 处理数据,轮询下一从站
  ├─ 在超时阈值内收到响应(但CRC错误)→ 丢弃,重试1次(见8.2)
  ├─ 超时阈值内无响应 → 重试1次
  │   ├─ 重试成功 → 处理数据
  │   └─ 重试仍超时 → 计入连续超时计数(见7.4)
  └─ 连续N次超时(N=3,待确认)→ 通讯中断,触发7.5节动作
```

### 8.4 断线恢复后状态同步

通讯中断恢复(RS485重新连接或从站重新上电)后,PLC需执行状态同步:

```
通讯恢复检测:
  ├─ 检测条件:连续M次请求成功(M=2,待Story 1.1确认)
  ├─ 清除V303.4(M_Alarm_SyringePump)
  ├─ 若当前VW2=99(S_ERROR)且无其他活动报警 → 等待人工系统复位(V2.3按钮或HMI)
  └─ 若当前VW2≠99 → 继续正常轮询

状态同步流程(注射泵):
  1. 立即重新读取41001(状态码),获取当前泵状态
  2. 若状态码=0(空闲/完成) → 正常,继续轮询
  3. 若状态码=1/2/3(运行中/抽液/排液) → 等待动作完成
  4. 若状态码≥4(错误) → 触发8.5节错误处理

状态同步流程(流量计):
  1. 立即重新读取0x0009(计量值)
  2. 若当前处于S1(进水中) → 更新VD86(VD_FlowMeter_Current),重算VD90(本次进水量)
  3. 若VD82(VD_FlowMeter_Snapshot)已过期(中断期间可能有进水) → 标记本轮进水量计算可疑,记录日志
```

### 8.5 注射泵状态码错误处理

| 状态码 | 处理 | 依据 |
|---|---|---|
| 0(空闲/完成) | 正常,FC13判定动作完成 | 变量地址表5.2 |
| 1/2/3(运行中/抽液/排液) | 正常,继续轮询等待 | 变量地址表5.2 |
| ≥4(错误码) | **立即报警**:置V303.4=1,转S_ERROR(VW2=99),VW6=64,停止当前加药流程 | 变量地址表5.2/9.1/9.2 |
| 错误码具体含义 | **待南京润泽V1.7协议确认**(见第10章) | 厂商协议 |

**S_ERROR锁定后**:必须人工系统复位(V2.3按钮或HMI CMD_SafetyRelayAck)才能回S0,不会自动恢复。

---

## 第9章 抓包与调试

### 9.1 串口抓包工具(RTU层)

| 工具 | 用途 | 配置 |
|---|---|---|
| Modbus Poll(Witte Software V9+) | PC端Modbus主站模拟,可作为从站给PLC应答,也可作为主站读取PLC;FAT阶段无真实从站时模拟 | 站号01/02,9600/8N1 |
| Modbus Slave(Witte Software V7+) | PC端Modbus从站模拟,配置站号0x01(注射泵)/0x02(流量计),预置41001/0x0009寄存器值响应PLC轮询 | 站号01/02,9600/8N1 |
| 串口调试助手(SSCOM/友善串口调试助手) | RS485报文抓包与时间戳记录 | 9600/8N1,启用时间戳(毫秒精度) |
| USB转RS485适配器 | 并联接入总线抓包 | 自动收发控制,支持9600~115200bps |
| RS485通讯抓包器/T型分接器 | 总线并联监听 | 与USB转RS485配合,接入PLC Port0与从站之间 |

### 9.2 抓包示例解读

**抓包场景**:PLC轮询注射泵41001状态码,从站返回状态码0x0002(抽液中)

**抓包原始数据(串口调试助手显示)**:

```
[T+0.000ms] TX: 01 03 03 E8 00 01 04 7A        ← PLC发出请求(8字节)
[T+18.532ms] RX: 01 03 02 00 02 39 85          ← 注射泵响应(7字节,延迟18.5ms)
```

**解读步骤**:
1. **请求帧** `01 03 03 E8 00 01 04 7A`:
   - `01`:从站地址(注射泵站号01)
   - `03`:功能码(读保持寄存器)
   - `03 E8`:起始地址0x03E8(对应寄存器41001)
   - `00 01`:数量1(读1个寄存器)
   - `04 7A`:CRC16(低字节0x04在前,高字节0x7A在后)

2. **响应帧** `01 03 02 00 02 39 85`:
   - `01`:从站地址(与请求一致)
   - `03`:功能码(正常响应,非异常)
   - `02`:字节数2(1个寄存器×2字节)
   - `00 02`:数据(状态码=0x0002=2=抽液中)
   - `39 85`:CRC16(低字节0x39在前,高字节0x85在后)

3. **耗时分析**:
   - 请求8字节@9600bps≈8.3ms + 3.5字符间隔≈3.65ms
   - 响应7字节@9600bps≈7.3ms
   - 从站处理延迟=18.532−8.3−3.65≈6.6ms(典型5~30ms范围内)
   - 总耗时≈18.5ms(远低于2000ms超时阈值)

### 9.3 常见通讯故障排查

| 故障现象 | 可能原因 | 排查方法 |
|---|---|---|
| 从站无响应(全0或无数据) | 1.A/B接反 2.站号冲突 3.波特率不匹配 4.从站未上电 5.从站协议为ASCII非RTU | 1.交换A/B线重试 2.检查站号设置 3.用Modbus Poll以9600/19200分别测试 4.测量从站供电 5.检查注射泵40020是否=3(RS485+RTU) |
| CRC错误率高 | 1.电磁干扰(动力线靠近) 2.屏蔽未接地 3.终端电阻缺失 4.总线距离过长 5.节点数过多 | 1.远离动力线/加屏蔽 2.PLC端单点接地 3.两端加120Ω终端电阻 4.缩短总线/加中继器 5.检查节点数≤32 |
| 数据错位/读不到正确值 | 1.寄存器地址计算错误 2.字节序不匹配(大端/小端) 3.寄存器数量错误(32位DWORD读1个寄存器) 4.功能码错误(对只读寄存器用FC06) | 1.核对offset=寄存器号−40001 2.用Modbus Poll逐字节读取确认字节序 3.DWORD需读2个寄存器 4.核对寄存器读写属性 |
| 间歇性通讯中断 | 1.接线松动 2.终端电阻位置错误(中间节点接了电阻) 3.供电不稳 4.PLC扫描周期过长导致MBUS_MSG未及时调用 | 1.紧固接线 2.仅两端接终端电阻 3.测量供电电压 4.测量扫描周期(性能基准测试方案第2章) |
| 异常响应(83/86/90) | 1.非法功能码(对只读用写) 2.非法数据地址(读预留寄存器) 3.非法数据值(写超范围) | 根据异常码对照5.6.2节处理 |

### 9.4 以太网抓包(TCP层,若启用MBUS_SERVER)

**工具**:Wireshark 4.x

**抓包步骤**:
1. 抓包PC接入HMI与PLC之间交换机的镜像口(需网管型交换机支持端口镜像)
2. 启动Wireshark,设置过滤器

**Wireshark过滤器**:

| 过滤器 | 用途 |
|---|---|
| `tcp.port == 502` | 仅显示Modbus TCP流量(端口502) |
| `host 192.168.2.10 and host 192.168.2.101` | HMI与PLC#1之间流量 |
| `host 192.168.2.10` | HMI全部流量(8台PLC并发) |
| `modbus` | Wireshark内置Modbus解析器(显示解析后字段) |
| `modbus.func_code == 3` | 仅显示FC03读请求 |
| `tcp.port == 502 and tcp.flags.reset == 1` | 检测TCP连接异常重置 |

**Modbus TCP帧结构(Wireshark解析)**:

```
| MBAP头(7字节) | PDU |
| TID(2) | PID(2) | Length(2) | UnitID(1) | FunctionCode(1) | Data(N) |
| 事务ID  | 协议ID  | 长度      | 单元ID    | 功能码           | 数据    |

注:Modbus TCP无CRC16(MBAP头替代RTU的从站地址+CRC);
   PID固定0x0000(表示Modbus协议);
   UnitID对于MBUS_SERVER通常忽略,填1或255
```

**调试要点**:
- HMI单次读写V区耗时≤50ms(性能基准测试方案1.2节指标9,待确认)
- HMI轮询8台PLC一周耗时≤2s(性能基准测试方案1.2节指标10,待确认)
- 单台PLC断网后HMI重连时间≤5s(性能基准测试方案1.2节指标12,待确认)
- 详细测试方法见性能基准测试方案第4~5章,本规格不重复

---

## 第10章 待确认事项

本规格书在编制过程中,以下事项需在后续开发/调试中确认或由厂商提供,确认后升版至v1.1:

### 10.1 流量计K24寄存器详表

| 序号 | 待确认内容 | 影响 | 责任人 | 期限 |
|---|---|---|---|---|
| 1 | K24流量计完整寄存器详表(0x0000~0xFFFF) | 第4章寄存器映射完整性 | 厂商/采购 | 设备到货前 |
| 2 | 0x0009(DWORD)字节序(大端/小端) | 差值法计算正确性 | 厂商/调试工程师 | 首次联调前 |
| 3 | 0x0009长期运行溢出行为(回绕/停止/报错) | 长期运行可靠性 | 厂商 | 长时测试前 |
| 4 | 0x0012现场实际配置值(默认0x03=升L) | 进水量计算单位 | 调试工程师 | 首次上电 |
| 5 | 0x000F/0x0017寄存器为INT(16位),变量地址表标注VD224/VD94(REAL),PLC侧INT→REAL转换逻辑 | 监测显示 | PLC开发工程师 | Story 1.1 |

### 10.2 注射泵异常码具体含义

| 序号 | 待确认内容 | 影响 | 责任人 | 期限 |
|---|---|---|---|---|
| 6 | 41001状态码≥4的具体错误码含义(南京润泽V1.7协议未在本文档中详列) | 第8.5节错误处理细化 | 厂商/南京润泽 | 首次联调前 |
| 7 | 注射泵最大行程步数(影响VD_Dose_Steps边界计算) | 第3章寄存器40006/40007写入值范围 | 厂商/PLC开发工程师 | Story 1.1 |
| 8 | 40020出厂默认值(是否为3=RS485+RTU,若非3需首次配置时切换) | 第2章RTU模式启用 | 调试工程师 | 首次上电 |
| 9 | 40004/40005/40008/40012-40014/40021等预留寄存器是否真为预留 | 第3章寄存器表完整性 | 厂商/南京润泽 | 首次联调前 |

### 10.3 MBUS_SERVER是否启用

| 序号 | 待确认内容 | 影响 | 责任人 | 期限 |
|---|---|---|---|---|
| 10 | HMI(昆仑通态MCGS)是否支持8个S7连接 | 第6章是否启用MBUS_SERVER | HMI开发工程师 | AQEX-24选型确认 |
| 11 | 若启用MBUS_SERVER,MaxInput/MaxHold/MaxCoil/MaxDisc/HoldStart等参数配置 | 第6章V区映射起始地址 | PLC开发工程师 | Story 1.1 |
| 12 | REAL字节序(S7-200 SMART V区大端,Modbus TCP保持寄存器大端,跨寄存器高低字顺序) | 第6章HMI读取REAL值正确性 | 调试工程师 | 首次联调 |
| 13 | Unit ID字段MBUS_SERVER处理方式(忽略/校验) | 第6.4节HMI连接配置 | PLC开发工程师 | Story 1.1 |

### 10.4 寄存器字节序

| 序号 | 待确认内容 | 影响 | 责任人 | 期限 |
|---|---|---|---|---|
| 14 | 流量计0x0009(DWORD)高低字顺序(大端=高字在前/小端=低字在前) | VD86数据正确性 | 厂商/调试工程师 | 首次联调 |
| 15 | 注射泵32位数据(若有)字节序 | 32位寄存器读取 | 厂商/南京润泽 | 首次联调 |
| 16 | Modbus TCP保持寄存器跨寄存器REAL字节序(S7-200 SMART V区大端) | 第6章HMI读取REAL值 | 调试工程师 | 首次联调 |

### 10.5 其他

| 序号 | 待确认内容 | 影响 | 责任人 | 期限 |
|---|---|---|---|---|
| 17 | FC4实际MBUS_MSG参数(站号/地址/功能码/Done位/Error地址)由Story 1.1细化 | 第7章轮询时序实现 | PLC开发工程师 | Story 1.1完成 |
| 18 | 通讯中断判定连续超时次数N(建议3次,需Story 1.1确认或改为单次超时即报警) | 第7.4节中断判定 | PLC开发工程师 | Story 1.1完成 |
| 19 | 流量计通讯中断是否映射到V303.4或独立报警位 | 第7.5节中断动作 | PLC开发工程师 | Story 1.1完成 |
| 20 | 任务描述中"40001状态码→VW4"与"40006-40007目标步数(32位)→VD102"与变量地址表11.2的差异(本规格以变量地址表为准,需确认任务描述是否为旧版) | 第3章寄存器映射 | 项目经理/通讯协议工程师 | 文档评审 |

---

**文档版本**:v1.0
**编制日期**:2026-07-18
**配套文档版本**:PLC设计文档v9.3、HMI-PLC变量地址表v1.0、性能基准测试方案v1.0、FC4_ModbusPolling.stl
**下次更新触发**:南京润泽V1.7协议完整版获取、K24流量计完整寄存器表获取、HMI选型确认(AQEX-24)、Story 1.1完成(FC4细化)、首次联调实测反馈、待确认事项闭环
