Yustnust/AQUA-EXPO/docs/代码评审checklist_v1.0.md

# 药液配置加注控制系统 — 代码评审checklist v1.0

**项目**: AQUA-EXPO 药液配置与加注控制系统
**适用范围**: PLC STL代码(20个FC文件)+ HMI变量接口
**评审依据**: PLC代码完整性校验报告v1.0、PLC代码静态分析报告v1.0、HMI-PLC变量地址表v1.0、PLC设计文档v9.3
**版本**: v1.0
**日期**: 2026-07-18
**适用阶段**: Story 1.2~1.7迭代交付、缺陷修复、发布前回归、紧急变更

---

## 第1章 评审流程

### 1.1 评审时机

| 时机 | 触发条件 | 评审范围 | 强制等级 |
|---|---|---|---|
| 提交PR时 | feature-*/fix-*/hotfix-* 合并到 develop/main | PR涉及的全部STL文件+变量表 | 强制 |
| 发布前 | release-x.y 合并到 main | 全部20个FC+变量表+CHANGELOG | 强制 |
| 缺陷修复后 | 校验报告/静态分析问题修复 | 修复涉及的FC+回归相关FC | 强制 |
| 紧急变更后 | hotfix 修复现场缺陷 | 修复涉及的FC(简化评审) | 强制(简化) |
| 重大架构变更 | 状态机重构/编址区迁移/通讯协议切换 | 全部FC+全部文档 | 强制(扩大) |
| 定期评审 | 每季度一次 | 全部FC+文档同步性 | 建议 |

### 1.2 评审人

| 评审类型 | 评审人要求 | 备注 |
|---|---|---|
| 常规PR评审 | 至少1名PLC工程师 | 评审人不得是提交人 |
| 发布前评审 | 至少1名PLC工程师 + 1名HMI工程师 | 跨专业评审变量接口 |
| 缺陷修复评审 | 至少1名PLC工程师 + 1名调试工程师 | 调试工程师关注现场可执行性 |
| 紧急变更评审 | 至少1名L3管理员(事后补评) | 紧急变更可先合并后评审,但24小时内必须补评 |
| 重大架构变更 | 项目负责人 + 至少2名PLC工程师 + HMI工程师 | 需召开评审会议 |

### 1.3 评审工具

| 工具 | 用途 |
|---|---|
| GitHub Pull Request | PR提交/评审/讨论/合并 |
| GitHub PR Review | 逐行评论/批准/请求修改 |
| `tools/stl_static_analyzer.py` | 自动静态分析(225类问题自动检出) |
| 校验报告v1.0(人工部分) | JMP/LBL/定时器/状态机一致性等需人工判断项 |
| 本checklist | 评审人逐项勾选 |
| GitHub Actions CI | PR自动触发静态分析,失败禁止合并 |

### 1.4 评审周期

| 评审类型 | 周期 |
|---|---|
| 常规PR评审 | 提交后2个工作日内响应 |
| 紧急变更评审 | 现场合并后24小时内补评 |
| 发布前评审 | release分支创建后5个工作日内完成 |
| 缺陷修复评审 | 修复提交后1个工作日内响应 |
| 评审意见修改后复审 | 修改提交后1个工作日内复审 |

### 1.5 评审流程

```
开发者提交PR
    ↓
CI自动运行 stl_static_analyzer.py
    ↓
CI通过 → 评审人收到通知 → 进入人工评审(第2~4章checklist)
CI失败 → 开发者修复 → 重新触发CI
    ↓
人工评审
    ├── 通过 → 评审人Approve → 合并到目标分支
    ├── 需修改 → 评审人Request Changes → 开发者修改 → 复审
    └── 拒绝 → 评审人Close PR + 说明原因
    ↓
合并后归档评审记录(PR链接存入变更单)
```

---

## 第2章 STL代码评审检查项

### 2.A 编址规范

| # | 检查点 | 是 | 否 | 不适用 | 备注 |
|---|---|---|---|---|---|
| A1 | V区地址是否与《HMI-PLC变量地址表v1.0》一致 | □ | □ | □ | |
| A2 | VD编址步长4字节(如VD10/VD14/VD18...,不允许VD10与VD12重叠) | □ | □ | □ | |
| A3 | VW编址步长2字节(如VW2/VW4/VW6...,不允许VW2与VW3重叠) | □ | □ | □ | |
| A4 | VB编址步长1字节(如VB200/VB201/VB202...,不允许VB200与VB200.4位混用) | □ | □ | □ | |
| A5 | V区位编址不与字/双字地址冲突(如V0.0~V0.7不与VW0/VW1冲突) | □ | □ | □ | |
| A6 | 断电保持区是否在系统块配置范围内(见变量表附录A: VB0~VB9/VB10~VB149/VB150~VB199/VB200~VB229/VB230~VB289/VB300~VB303/VB304/VB305~VB349/VB500~VB599) | □ | □ | □ | |
| A7 | 故事1.6编址修复无残留(V0.5不再用于CMD_SafetyRelayAck,V124.0不再用于M_AlarmAckMode) | □ | □ | □ | |
| A8 | 跨FC共用的V区地址无含义冲突(如VW270不被FC30/FC32同时用作不同含义) | □ | □ | □ | 对照静态分析报告"跨FC写入冲突"清单 |
| A9 | 新增变量是否已登记到变量地址表(防止静态分析"未定义变量"73个提示类问题) | □ | □ | □ | |
| A10 | 阀诊断变量区VW230~VW289使用是否与校验报告v1.0修复后规划一致 | □ | □ | □ | |
| A11 | 阀诊断中间变量VD308~VD344(2026-07-18静态分析修复后新增区)使用是否合规 | □ | □ | □ | |

### 2.B 数据类型与对齐

| # | 检查点 | 是 | 否 | 不适用 | 备注 |
|---|---|---|---|---|---|
| B1 | VD双字4字节对齐(地址%4==0,如VD10/VD14/VD18...,VD178/VD186/VD190为非对齐历史遗留) | □ | □ | □ | |
| B2 | VW字2字节对齐(地址%2==0) | □ | □ | □ | |
| B3 | REAL(浮点)与DWORD(双字)区分使用(VD82/VD86流量计为DWORD,VD90进水量为REAL) | □ | □ | □ | |
| B4 | 有符号/无符号使用正确(VW2状态机/VW6报警码无符号,VW208泵速度等需确认) | □ | □ | □ | |
| B5 | MOVB写字节地址,VW/MOVW写字地址,VD/MOVD写双字地址(校验P5: MOVB 1,VW270误用) | □ | □ | □ | |
| B6 | MOVR写REAL,MOVD写DWORD,不混用 | □ | □ | □ | |
| B7 | ROUND/LROUND等指令的源/目操作数类型匹配(REAL→INT/INT→REAL转换) | □ | □ | □ | |
| B8 | 字/双字高低字节序处理正确(S7-200 SMART为小端) | □ | □ | □ | |
| B9 | AC0/AC1等累加器在REAL/INT混用时已正确切换 | □ | □ | □ | |

### 2.C 读写握手

| # | 检查点 | 是 | 否 | 不适用 | 备注 |
|---|---|---|---|---|---|
| C1 | V0区命令位采用"上升沿触发+握手确认"(EU/ED指令前置LD) | □ | □ | □ | |
| C2 | V0区命令位置位后,PLC在下一周期置对应V1.x状态位确认 | □ | □ | □ | |
| C3 | V2.4~V3.3区手动命令位采用"上升沿触发+PLC清零握手"(区别于V0区置位握手) | □ | □ | □ | |
| C4 | 防止重复触发: 命令位处理完成后必须由PLC清除或HMI撤销 | □ | □ | □ | |
| C5 | EU/ED指令前置LD(校验4.4节确认全部合规) | □ | □ | □ | |
| C6 | 命令位响应条件正确(如手动命令仅VW2=0或99时响应) | □ | □ | □ | |
| C7 | V0.7 CMD_SafetyRelayAck 需高权限+I1.2双确认(变量表4.1节) | □ | □ | □ | |
| C8 | HMI侧未在V0区残留1值导致重复触发 | □ | □ | □ | |

### 2.D 断电保持

| # | 检查点 | 是 | 否 | 不适用 | 备注 |
|---|---|---|---|---|---|
| D1 | 关键状态VW2(状态机)断电保持 | □ | □ | □ | |
| D2 | VW6(报警码)断电保持 | □ | □ | □ | |
| D3 | VW8(轮次计数)断电保持 | □ | □ | □ | |
| D4 | VD10~VD140(HMI设定参数+纠偏变量)断电保持 | □ | □ | □ | |
| D5 | V300~V303(报警字32位)断电保持 | □ | □ | □ | |
| D6 | DT10(下缸变满时间戳)断电保持 | □ | □ | □ | |
| D7 | V1.6/V1.7(上下缸状态)断电保持 | □ | □ | □ | |
| D8 | 中间变量(VB260~VB269诊断子状态/VW270~VW289 PT转换值/VD290~VD296运算中间变量)不应断电保持 | □ | □ | □ | |
| D9 | 系统块断电保持配置覆盖变量表附录A所有区段 | □ | □ | □ | |
| D10 | CPU ST20超级电容保持能力(7天典型/6天最小)在项目预期停电时长内 | □ | □ | □ | |

### 2.E 扫描周期与效率

| # | 检查点 | 是 | 否 | 不适用 | 备注 |
|---|---|---|---|---|---|
| E1 | 无长循环(FOR/NEXT 步数有上限) | □ | □ | □ | |
| E2 | 无阻塞指令(避免在主循环中用长延时指令) | □ | □ | □ | |
| E3 | 计时器时基正确: 100ms时基×10=1秒(T37/T38/T39/T40/T42等) | □ | □ | □ | |
| E4 | 计时器PT值转换链完整(VD58×10→VW282等,校验A3曾发现PT未转换问题) | □ | □ | □ | |
| E5 | FC调用层次≤3层(OB1→FC1/FC2/FC3/FC4→FC10~FC19→FC30~FC40) | □ | □ | □ | |
| E6 | 二级FC(FC30~FC40)由状态FC调用,不在OB1直接调用 | □ | □ | □ | |
| E7 | OB1调用顺序合理(校验2.2节: FC0→FC2急停→FC4 Modbus→FC3报警→FC1状态调度) | □ | □ | □ | |
| E8 | JMP/LBL标签平衡,无悬空JMP,无死标签(校验4.1节) | □ | □ | □ | |
| E9 | 定时器号跨FC无冲突(校验4.2节: T35/T37/T38/T39/T40/T42/T50~T58各FC专用) | □ | □ | □ | |
| E10 | Modbus轮询超时设置合理(注射泵2000ms/流量计1000ms) | □ | □ | □ | |

### 2.F 安全联锁

| # | 检查点 | 是 | 否 | 不适用 | 备注 |
|---|---|---|---|---|---|
| F1 | 阀A开启联锁: 上缸未满(I0.5=OFF) + 阀A关到位(I8.1=ON) | □ | □ | □ | |
| F2 | 阀B开启联锁: 上缸满(I0.5=ON) + 下缸未满(I0.7=OFF) | □ | □ | □ | |
| F3 | 阀C开启联锁: 下缸满(I0.7=ON) + 下缸非空保护 | □ | □ | □ | |
| F4 | 急停响应: I1.1=OFF触发同周期转S_ERROR(FC2在FC1之前调用) | □ | □ | □ | |
| F5 | 安全继电器反馈: I1.2超时未反馈→V300.5最高级报警 | □ | □ | □ | |
| F6 | NC球阀失效安全: 阀A失效时Q0.5(NC球阀上缸)得电打开泄压 | □ | □ | □ | |
| F7 | NC球阀失效安全: 阀B/液位计B最高报警时Q0.6(NC球阀下缸)得电打开 | □ | □ | □ | |
| F8 | 急停锁存V300.4需系统复位(I0.3)才能清除 | □ | □ | □ | |
| F9 | 漫溢保护: I0.5(上缸高位)/I0.7(下缸高位)直接触发报警+NC球阀动作 | □ | □ | □ | |
| F10 | 手动操作时安全联锁仍生效(变量表4.4注3) | □ | □ | □ | |
| F11 | 急停按钮双通道: I1.1(常闭触点)+I1.2(安全继电器反馈) | □ | □ | □ | |
| F12 | S_ERROR态需V0.7高权限+I1.2双确认才能清除(FC19) | □ | □ | □ | |

### 2.G 报警处理

| # | 检查点 | 是 | 否 | 不适用 | 备注 |
|---|---|---|---|---|---|
| G1 | 报警位置位与复位逻辑清晰(置位由故障源FC,复位由FC3或人工确认) | □ | □ | □ | |
| G2 | 报警优先级链正确(FC3 NETWORK1: 99>10系列>20系列>30~66系列) | □ | □ | □ | |
| G3 | VW6报警码与V300~V303报警位同步(FC3 JMP标签nCode10~nCode66逐位赋值) | □ | □ | □ | |
| G4 | 漫溢类(V300.0~V300.4)/安全继电器(V300.5)/节奏滞后(V300.6)强制人工确认 | □ | □ | □ | |
| G5 | M_AlarmAckMode(V200.0)模式生效: 0=自动恢复,1=人工确认 | □ | □ | □ | |
| G6 | 消音(V0.4)/消光(V0.3)命令处理正确(消音仅关声音DO,消光需根本原因消失) | □ | □ | □ | |
| G7 | 报警日志缓冲(VB500~VB509)写入逻辑正确,无溢出 | □ | □ | □ | |
| G8 | 报警码VW6变量表9.2定义与FC3 STL实际编码一致(校验P4已修复) | □ | □ | □ | |
| G9 | 32位报警字按位严格分配,无位定义冲突(变量表9.1) | □ | □ | □ | |
| G10 | V303.7预留报警位未被误用 | □ | □ | □ | |

### 2.H 注释与可维护性

| # | 检查点 | 是 | 否 | 不适用 | 备注 |
|---|---|---|---|---|---|
| H1 | 文件头注释含: 文件名/功能/Story编号/版本/编制日期/修改记录 | □ | □ | □ | |
| H2 | 文件头注释含: 变量地址表引用/相关规格书引用 | □ | □ | □ | |
| H3 | NETWORK注释清晰(NETWORK N: <功能简述>) | □ | □ | □ | |
| H4 | 关键变量使用符号名(如 VD_C_Set 而非 VD10) | □ | □ | □ | |
| H5 | 注释与代码一致(校验P1: FC19 L82注释"V0.5"与代码"V0.7"不一致) | □ | □ | □ | |
| H6 | 复杂逻辑段含算法说明(如差值法进水计量/三层纠偏) | □ | □ | □ | |
| H7 | 魔数(如 +100, ×10)有注释说明来源(校验A3: T44/T45固定+100无说明) | □ | □ | □ | |
| H8 | 待办/已知问题用 TODO/FIXME 标注(如校验P7观察项) | □ | □ | □ | |
| H9 | 跨FC共用的变量在引用处注释"由FCx写入"(如VW270由FC32写入) | □ | □ | □ | |
| H10 | 修改记录在文件头维护(日期/修改人/修改内容/关联变更单) | □ | □ | □ | |

---

## 第3章 跨FC评审检查项

### 3.1 跨FC写入冲突检查

依据静态分析报告"五、跨FC变量访问矩阵(写入)",重点检查以下高频冲突变量:

| # | 检查点 | 是 | 否 | 不适用 | 备注 |
|---|---|---|---|---|---|
| X1 | VB2/VB3 被17/16个FC写入: 确认各FC写入互斥(状态机唯一态) | □ | □ | □ | |
| X2 | V1.6/V1.7 被5/4个FC写入: 确认调用顺序合理(FC0初始化→状态FC更新→FC19故障清除) | □ | □ | □ | |
| X3 | V300.4 急停锁存 被3个FC写入(FC0/FC19/FC2): 确认置位优先于复位 | □ | □ | □ | |
| X4 | V300.5 安全继电器故障 被2个FC写入(FC19/FC2): 确认双通道一致 | □ | □ | □ | |
| X5 | V301.x/V302.x/V303.x 报警位 被诊断FC+FC3写入: 确认诊断FC置位,FC3读取后处理 | □ | □ | □ | |
| X6 | VW270 阀C诊断结果 被FC17/FC32写入: 确认FC17清零→FC32写入时序(校验P2已修复) | □ | □ | □ | |
| X7 | VB260~VB269 阀诊断子状态 被状态FC+诊断FC写入: 确认状态FC初始化→诊断FC更新 | □ | □ | □ | |
| X8 | VD116/VD150/VD178 纠偏中间量 被多FC写入: 确认调用顺序与读写时序 | □ | □ | □ | |
| X9 | 跨FC共用的中间变量(如VD290/VD292/VD294/VD296运算专用)未被其他FC误写 | □ | □ | □ | |

### 3.2 FC边界清晰度

| # | 检查点 | 是 | 否 | 不适用 | 备注 |
|---|---|---|---|---|---|
| X10 | 每个FC的输入/输出变量在文件头明确列出 | □ | □ | □ | |
| X11 | FC调用链不形成环(无FC A调用FC B又调用FC A) | □ | □ | □ | |
| X12 | 二级FC(FC30~FC40)仅由对应状态FC调用(FC11→FC30/FC40,FC15→FC31,FC16→FC40,FC17→FC32) | □ | □ | □ | |
| X13 | FC4 ModbusPolling 仅 OB1 调用,不在其他FC中调用 | □ | □ | □ | |
| X14 | FC1 StateDispatcher 仅根据VW2调用对应状态FC,无其他副作用 | □ | □ | □ | |
| X15 | FC0 SysInit 仅 SM0.1 首次扫描调用,无重复初始化 | □ | □ | □ | |

### 3.3 共享变量读写时序

| # | 检查点 | 是 | 否 | 不适用 | 备注 |
|---|---|---|---|---|---|
| X16 | 命令位V0.x的"写-读-清"时序: HMI写→PLC读+处理→PLC清/置确认 | □ | □ | □ | |
| X17 | VW2状态机的"读-调度-写"时序: FC1读VW2→调用FCx→FCx写新VW2 | □ | □ | □ | |
| X18 | 报警位的"置位-读取-处理"时序: 诊断FC置位→FC3读取→FC3写VW6报警码 | □ | □ | □ | |
| X19 | VD82流量计快照的"读-存-差值"时序: FC4读取→FC11存快照→FC11计算差值 | □ | □ | □ | |
| X20 | 跨FC共享变量的读写发生在同一扫描周期或明确跨周期同步机制 | □ | □ | □ | |

---

## 第4章 HMI接口评审

### 4.1 变量地址与HMI变量表一致性

| # | 检查点 | 是 | 否 | 不适用 | 备注 |
|---|---|---|---|---|---|
| H1.1 | PLC侧V区地址与HMI变量地址表v1.0完全一致 | □ | □ | □ | |
| H1.2 | HMI画面1总览页读取变量(VW2/V1.6/V1.7/I1.1/VW6/VW8/VD96)与PLC定义一致 | □ | □ | □ | |
| H1.3 | HMI画面2单元详情页读取变量(VW2/V1.6/V1.7/VW4/VD90/VD94/VD96/VB300~VB303/VW8)一致 | □ | □ | □ | |
| H1.4 | HMI画面3手动控制页写入V0.0~V0.7及V2.4~V3.3命令位与PLC定义一致 | □ | □ | □ | |
| H1.5 | HMI画面4参数设置页读写VD10~VD66/VD132~VD140/V200.0与PLC定义一致 | □ | □ | □ | |
| H1.6 | HMI画面5报警日志页读写VW6/VB300~VB303/V0.3/V0.4与PLC定义一致 | □ | □ | □ | |
| H1.7 | HMI画面6趋势曲线页读取VD70/VD74/VD78/VD90/VD94/VD96/VD112/VD116与PLC定义一致 | □ | □ | □ | |
| H1.8 | HMI画面7通讯维护页读取VW4/VW222/VD86与PLC定义一致 | □ | □ | □ | |
| H1.9 | HMI画面8系统设置页读写V200.0/Unit1~8_Enabled与PLC/HMI定义一致 | □ | □ | □ | |

### 4.2 数据类型匹配

| # | 检查点 | 是 | 否 | 不适用 | 备注 |
|---|---|---|---|---|---|
| H2.1 | VW2/VW4/VW6/VW8 PLC侧WORD(INT)与HMI侧16位有符号整数匹配 | □ | □ | □ | |
| H2.2 | VD10~VD140 PLC侧REAL与HMI侧32位浮点匹配 | □ | □ | □ | |
| H2.3 | VD82/VD86 PLC侧DWORD与HMI侧32位无符号整数匹配(非REAL) | □ | □ | □ | |
| H2.4 | V0.x/V1.x/V300.x PLC侧BOOL与HMI侧布尔匹配 | □ | □ | □ | |
| H2.5 | VW200~VW228 Modbus寄存器映射PLC侧WORD与HMI侧16位整数匹配 | □ | □ | □ | |
| H2.6 | DT10 PLC侧DT与HMI侧日期时间类型匹配(注意BCD格式) | □ | □ | □ | |

### 4.3 读写权限

| # | 检查点 | 是 | 否 | 不适用 | 备注 |
|---|---|---|---|---|---|
| H3.1 | HMI设定参数(VD10~VD66)仅L2维护/L3管理员可写,L1操作员只读 | □ | □ | □ | 对照HMI用户权限矩阵v1.0 |
| H3.2 | HMI命令位(V0.0~V0.7)按权限分级: V0.0启动/V0.2停止/V0.4消音L1可操作,V0.5/V0.6强制修正/V0.7继电器确认需L3 | □ | □ | □ | |
| H3.3 | HMI手动命令(V2.4~V3.3)仅L2维护/L3管理员可操作 | □ | □ | □ | |
| H3.4 | HMI实测值(VD70~VD102)全部只读 | □ | □ | □ | |
| H3.5 | HMI报警字(VB300~VB303)只读,通过V0.3/V0.4命令位控制 | □ | □ | □ | |
| H3.6 | M_AlarmAckMode(V200.0)仅L3管理员可写 | □ | □ | □ | |

### 4.4 命令握手

| # | 检查点 | 是 | 否 | 不适用 | 备注 |
|---|---|---|---|---|---|
| H4.1 | HMI下发V0.0启动后,PLC置V1.0确认,HMI收到V1.0后撤销V0.0 | □ | □ | □ | |
| H4.2 | HMI下发V0.3报警确认后,PLC置V1.3确认,HMI收到V1.3后撤销V0.3 | □ | □ | □ | |
| H4.3 | HMI下发V2.4~V3.3手动命令后,PLC清零对应位确认,HMI检测到清零即视为执行 | □ | □ | □ | |
| H4.4 | HMI下发V0.7继电器确认需高权限登录+二次确认弹窗 | □ | □ | □ | |
| H4.5 | 命令位握手超时处理(HMI下发后3秒未收到确认的提示) | □ | □ | □ | |

---

## 第5章 评审清单模板

### 5.1 评审封面

```
==========================================
代码评审清单
==========================================
项目: AQUA-EXPO 药液配置加注控制系统
评审类型: □PR评审 □发布前评审 □缺陷修复评审 □紧急变更评审 □定期评审
PR/变更单号: ____________________
评审日期: YYYY-MM-DD
被评审代码:
  - 分支/Tag: ____________________
  - 涉及文件: ____________________
评审人: ____________________
开发者: ____________________
评审结论: □通过 □需修改 □拒绝
```

### 5.2 评审检查项汇总表(可打印)

| 章节 | 检查项数 | 通过 | 不通过 | 不适用 | 备注 |
|---|---|---|---|---|---|
| 2.A 编址规范 | 11 | ___ | ___ | ___ | |
| 2.B 数据类型与对齐 | 9 | ___ | ___ | ___ | |
| 2.C 读写握手 | 8 | ___ | ___ | ___ | |
| 2.D 断电保持 | 10 | ___ | ___ | ___ | |
| 2.E 扫描周期与效率 | 10 | ___ | ___ | ___ | |
| 2.F 安全联锁 | 12 | ___ | ___ | ___ | |
| 2.G 报警处理 | 10 | ___ | ___ | ___ | |
| 2.H 注释与可维护性 | 10 | ___ | ___ | ___ | |
| 3 跨FC评审 | 20 | ___ | ___ | ___ | |
| 4 HMI接口评审 | 24 | ___ | ___ | ___ | |
| **合计** | **124** | ___ | ___ | ___ | |

### 5.3 不通过项明细

| # | 章节 | 检查项编号 | 问题描述 | 严重等级 | 修改建议 | 责任人 | 修复期限 |
|---|---|---|---|---|---|---|---|
| 1 | 2.A | A8 | VW270跨FC冲突 | 严重 | 改用VW278 | 张三 | 即时 |
| 2 | 2.B | B5 | MOVB写字地址 | 严重 | 改用MOVW | 李四 | 即时 |
| 3 | ... | | | | | | |

**严重等级**: 严重(阻塞合并)/警告(可合并但下版本修复)/提示(建议改进)

### 5.4 评审人签字

```
评审人签字: ____________________ 日期: __________
开发者签字: ____________________ 日期: __________
项目经理签字(发布前必填): ____________________ 日期: __________
```

### 5.5 评审记录归档

| 评审记录 | 存档位置 |
|---|---|
| 评审清单(本文档填写版) | GitHub PR 评论附件 + docs/achieve/review/ |
| 评审意见讨论 | GitHub PR 评论历史 |
| 评审结论 | 变更单"评审记录"栏引用PR链接 |

---

## 第6章 常见缺陷速查

基于 PLC代码完整性校验报告v1.0(10个问题)和 PLC代码静态分析报告v1.0(225个问题)归纳,供评审人快速识别常见模式:

### 6.1 严重类(阻塞合并)

| # | 缺陷模式 | 典型案例 | 检查方法 |
|---|---|---|---|
| 1 | VD编址步长冲突(4字节重叠) | 静态分析#1: VD18(VB18~VB21)与VD20(VB20~VB23)重叠;#2: VD48/VD50;#3: VD96/VD98 | 静态分析器自动检出 + 人工核对地址表 |
| 2 | 跨FC共用V区地址含义冲突 | 校验P2: VW270被FC30用作T50 PT值,被FC32用作诊断结果 | 静态分析"跨FC写入冲突"清单 + 人工核对用途 |
| 3 | MOVB/MOVW/MOVR 操作数类型不匹配 | 校验P5: FC32 L138/L159 `MOVB 1, VW270`(字节指令写字地址) | 人工通读 + 静态分析器 |
| 4 | 计时器PT值从未被写入 | 校验A1/A2: FC12 VW252/FC14 VW254从未被写入,导致T38/T39失效 | 人工核对计时器PT变量写入链 |
| 5 | 计时器PT值未做×10转换 | 校验A3: FC12 T44/T45用固定+100(10秒)而非VD58/VD62×10 | 人工核对REAL秒→INT 100ms转换 |
| 6 | 直接修改HMI设定参数 | 校验P6: FC11直接修改VD48(HMI设定),虽还原但有异常风险 | 静态分析"参数区写入"清单 |

### 6.2 警告类(可合并,下版本修复)

| # | 缺陷模式 | 典型案例 | 检查方法 |
|---|---|---|---|
| 7 | 注释与代码不一致 | 校验P1: FC19 L82注释"V0.5"但代码用"V0.7";校验P3: VW272注释归属不清 | 人工通读 |
| 8 | 变量表与STL实际编码不一致 | 校验P4: 变量表9.2报警码定义与FC3实际编码不符(已修复) | 变量表与FC3 STL交叉核对 |
| 9 | 跨FC写入冲突(状态机类) | 静态分析: VB2/VB3被17/16个FC写入(状态机合法但需确认互斥) | 静态分析 + 人工核对状态机互斥 |
| 10 | 报警位跨FC写入(诊断FC+FC3) | 静态分析: V301.0~V302.7被诊断FC+FC3写入(合法,FC3只读) | 静态分析 + 人工核对FC3只读 |
| 11 | HMI参数区被FC直接写入 | 静态分析: 11处FC直接写入VD10~VD140 HMI设定参数区 | 静态分析"参数区写入"清单 |

### 6.3 提示类(建议改进)

| # | 缺陷模式 | 典型案例 | 检查方法 |
|---|---|---|---|
| 12 | VD地址非4字节对齐 | 静态分析: 87处VD地址非对齐(VD178/VD186/VD190/VD150等历史遗留) | 静态分析器自动检出 |
| 13 | 变量定义未登记到变量表 | 静态分析: 73处"未定义变量"(VB2/VB3/VW300等) | 静态分析"未定义变量"清单 + 补登变量表 |
| 14 | 已定义但未使用的变量 | 静态分析: VD194/VD250/VW8 定义但未引用 | 静态分析"未使用变量"清单 |
| 15 | 状态恢复策略边界条件 | 校验P7: FC0 NETWORK6 缺VW2==6条件,断电恢复时可能错误重算(已修复) | 人工核对断电恢复逻辑 |
| 16 | 魔数无说明 | T44/T45固定+100无注释(校验A3曾发现) | 人工核对魔数来源 |

### 6.4 评审人快速识别清单

评审STL代码时,优先关注以下"高发问题"信号:

| 信号 | 可能问题 | 立即检查 |
|---|---|---|
| 出现 `MOVB x, VWyyy` | 字节指令写字地址 | 改 `MOVW x, VWyyy` |
| 出现 `MOVD x, VDyyy` 且 yyy%4≠0 | VD非4字节对齐 | 评估是否可调整地址 |
| 计时器 `TON Tn, VWm` 但VWm未在该FC内赋值 | PT值可能未写入 | 检查写入链(如VD→VW转换) |
| 计时器 `TON Tn, +N`(立即数) | 可能未做×10转换 | 确认N=期望秒数×10 |
| 出现 `*R 10.0, VDxxx`(xxx为HMI参数) | 直接修改HMI参数 | 改用中间变量 |
| 同一VW/VD地址在多个FC中出现 | 跨FC写入冲突 | 查静态分析"跨FC写入冲突"清单 |
| 注释中出现旧地址(如V0.5/V124.0) | Story1.6修复残留 | 改为新地址 |
| 文件头无修改记录 | 可追溯性缺失 | 补登修改记录 |
| NETWORK无注释 | 可维护性差 | 补充NETWORK注释 |
| JMP标签无对应LBL | 悬空JMP | 静态分析器自动检出 |

### 6.5 评审通过判定

| 严重等级 | 数量限制 | 处理 |
|---|---|---|
| 严重 | 必须为 0 | 阻塞合并,必须修复 |
| 警告 | ≤3 且无安全相关 | 可合并,但下版本必须修复,在PR中标注"已知警告" |
| 提示 | 不限 | 建议修复,不阻塞合并 |
| 静态分析严重问题 | 必须为 0 | CI阻塞合并 |
| 静态分析警告 | ≤5 | 可合并,但需在PR说明 |
| 静态分析提示 | 不限 | 不阻塞合并 |

---

**文档版本**: v1.0
**编制日期**: 2026-07-18
**编制人**: 配置管理与质量保证工程师
**配套使用**: PLC程序版本管理规范v1.0、变更管理流程v1.0、PLC代码完整性校验报告v1.0、PLC代码静态分析报告v1.0
**下次更新触发**: ①每次发布后回顾实际评审问题补充速查清单 ②静态分析器版本升级后同步检查项 ③新增Story迭代后补充评审检查点
