Yustnust/AQUA-EXPO/docs/操作员培训材料_v1.0.md

# AQUA-EXPO 药液配置加注控制系统 — 操作员培训材料 v1.0

**项目**：AQUA-EXPO 药液配置与加注控制系统
**版本**：v1.0
**编制日期**：2026-07-18
**适用范围**：8 套缸单元 + 1 台昆仑通态 MCGS 12 寸 HMI 集中监控
**培训对象**：以 L1 操作员为主，L2 维护人员补充
**配套文档**：
- 《药液配置加注控制系统_PLC设计文档》v9.3
- 《HMI-PLC变量地址表》v1.0
- 《HMI画面布局线框图》v1.0
- 《HMI用户权限矩阵》v1.0
- 《报警现场处置操作指引》v1.0
- 《故障代码字典》v1.0

---

## 培训目标

完成本课程后，受训人员应能做到：

1. **认知层面**：口述系统组成、状态机 S0~S7+S_ERROR 流程、3 级权限与失效安全理念。
2. **操作层面**：独立完成日常开机检查、启动实验、运行监控、正常结束、参数设置查看、关机操作。
3. **应急层面**：正确识别 32 条报警分级，按"识别→现场检查→HMI 操作→恢复"四步法处置，正确执行急停与系统复位。
4. **手动操作（L2）**：在 S0/S_ERROR 态下完成阀 A/B/C、潜水泵 1 的手动开闭，理解联锁限制。
5. **维护层面（L2）**：完成参数整定、诊断数据查看、断电恢复处理、备份等维护操作。

**考核合格标准**：理论题 ≥ 80 分 + 操作题 ≥ 90 分（详见第 10 章）。

---

## 第 1 章 培训大纲与课时安排

### 1.1 总课时

总课时 **10 课时**（每课时 45 分钟），按"基础→操作→应急→维护"四段式编排，可在 2 个工作日内完成。

### 1.2 课程表

| 课次 | 主题 | 课时 | 对象 | 方式 |
|---|---|---|---|---|
| 1 | 系统认知与安全规范 | 1.0 | L1+L2 | 课堂讲授+现场参观 |
| 2 | HMI 画面导航与权限使用 | 1.0 | L1+L2 | HMI 实机演示 |
| 3 | 日常操作 SOP（开机/启停/关机） | 1.5 | L1+L2 | 实机演练 |
| 4 | 参数设置与换水周期理解 | 1.0 | L1+L2 | 实机演练 |
| 5 | 手动操作与联锁（L2） | 1.0 | L2 | 实机演练 |
| 6 | 报警识别与现场处置（Top10） | 1.5 | L1+L2 | 案例分析+实机 |
| 7 | 急停与系统复位 | 1.0 | L1+L2 | 实机演练 |
| 8 | L2 维护补充（诊断/参数整定/备份） | 1.0 | L2 | 实机演练 |
| 9 | 理论考核 | 1.0 | L1+L2 | 闭卷笔试 |
| 10 | 操作与应急处置考核 | 1.0 | L1+L2 | 现场操作评分 |
| **合计** | | **10.0** | | |

### 1.3 课程分类

- **基础课（课次 1~2）**：系统认知 + 安全规范 + HMI 导航
- **操作课（课次 3~5）**：启停 + 参数 + 手动
- **应急处置课（课次 6~7）**：报警处置 + 急停复位
- **维护课（课次 8）**：仅 L2

---

## 第 2 章 系统认知培训

### 2.1 系统组成

本系统为上下两层玻璃缸的实验室配液加注系统，整体架构如下：

```
                    ┌─────────────────────────┐
                    │   现场本地集中触摸屏 HMI   │
                    │   （昆仑通态 MCGS 12寸）  │
                    └───────────┬─────────────┘
                                │ 工业以太网交换机
        ┌───────────┬───────────┴──┬───────────┬───────────┐
      PLC#1        PLC#2   ...   PLC#7       PLC#8
    （1号缸单元） （2号缸单元）   （7号缸单元）（8号缸单元）
```

**三大部分**：

1. **8 套缸单元（执行层）**：每套含上下两层玻璃缸 + 1 台西门子 S7-200 SMART CPU ST20 PLC + 1 套阀门/泵/传感器 + 1 条独立 485 总线（挂注射泵、流量计 2 个 Modbus 从站）。8 套单元彼此独立、互不影响，任一单元故障/停机/调试不影响其余 7 套。
2. **1 台本地集中 HMI（监控层）**：昆仑通态 MCGS 12 寸触摸屏，固定 IP 192.168.2.10。承担 8 套单元总览、报警详情/确认/消音、参数设定、历史记录、手动调试画面，不承担实时控制逻辑。HMI 故障时 PLC 仍按本地程序继续运行。
3. **PLC（控制层）**：每套单元 1 台，IP 192.168.2.101~108，与单元编号一一对应。PLC 内部完整保存本单元状态机、报警锁存、急停处理、断电恢复、485 轮询、泵阀控制逻辑。

**每套缸单元的执行器件**：

| 类别 | 设备 | 物理地址 | 说明 |
|---|---|---|---|
| 阀门 | 电动球阀 A | Q0.2 | 上缸进水 |
| | 电动球阀 B | Q0.3 | 上→下转移 |
| | 电动球阀 C | Q0.4 | 下缸排水 |
| | NC 球阀-上缸 | Q0.5 | 常闭型失效安全，阀 A 第二道保护 |
| | NC 球阀-下缸 | Q0.6 | 常闭型失效安全，阀 B/液位计 B 第二道保护 |
| 泵 | 潜水泵 1 | Q0.0 | 上缸搅拌 |
| | 潜水泵 2 | Q0.1 | 上缸搅拌 |
| | 注射泵（柱塞式计量泵，Modbus） | 485 从站 01 | 加药（步数控制） |
| 传感器 | 流量开关 A/B/C | I0.0~I0.2 | 无源常开，开关量 |
| | （I0.3/I0.4 预留未用） | — | — |
| | 液位计 A 高/低位 | I0.5/I0.6 | 防漫溢/排空判定 |
| | 液位计 B 高/低位 | I0.7/I1.0 | 对称保护 |
| | 阀门限位反馈 A/B/C 开/关到位 | I8.0~I8.5 | 有源信号经继电器转换 |
| 报警 | 声音/灯光 | Q0.7/Q8.0 | 独立消音/消光 |
| 安全 | 急停按钮（双触点） | I1.1 | 常闭，断线即安全 |
| | 安全继电器反馈 | I1.2 | 强制导向型，主触点粘连检测 |
| | 系统复位按钮 | I0.3 | 急停后现场物理复位 |
| | 消音按钮 | I0.4 | 仅关声音 |

### 2.2 工作原理：状态机 S0~S7 + S_ERROR

系统主控状态机有 9 个状态，操作员需理解每个状态含义。HMI 画面 1 总览页和画面 2 单元详情页都会显示 `VW2` 当前状态值。

| VW2 | 状态 | 含义 |
|---|---|---|
| 0 | S0 | 初始化（上下缸状态置空，输出复位） |
| 1 | S1 | 上缸进水（阀 A 差值法计量，液位计 A 高位漫溢保护） |
| 2 | S2 | 预循环（潜水泵 1/2 搅拌，不加药） |
| 3 | S3 | 加药（注射泵抽液→排液，按步数控制+状态轮询） |
| 4 | S3.5 | 静止等候（溶液沉降） |
| 5 | S4 | 上→下转移（阀 B 四态诊断+液位计 B 高位漫溢保护） |
| 6 | S5 | 实验运行中（换水周期计时+实验时长累加+预规划上升沿触发） |
| 7 | S6 | 下缸排水（阀 C 四态诊断+S6 实测时长滚动更新） |
| 8 | S7 | 实验结束（状态机锁定，需人工 HMI 确认重启） |
| 99 | S_ERROR | 故障锁定（急停或最高级报警触发，需现场物理系统复位） |

**流程图讲解**（简化版，便于操作员记忆）：

```
S0 初始化
   ↓ (操作员 V0.0 CMD_Start)
S1 上缸进水 → S2 潜水泵搅拌 → S3 注射泵加药 → S3.5 静止沉降
   ↓
S4 上→下转移 → S5 实验运行（等换水周期）
                    ↓ (周期到)
                 S6 下缸排水
                    ↓ (若新液已配好)
                 S4 → S5 → S6 ... 循环
                    ↓ (实验时长达标 V0.2 CMD_Stop)
                 S7 实验结束
                    ↓ (HMI 确认重启)
                 S0

任何状态下：急停 → S_ERROR（VW2=99），需现场物理复位回 S0
```

**关键概念（操作员必知）**：

- **S5 期间**：换水周期 = VD_CycleSetpoint（默认 30 min）；实验时长累加值 VD_ExperimentDuration_Accum 仅在下缸="满"期间累加，达 VD_ExperimentTarget（默认 480 min=8h）转入 S7。
- **节奏纠偏（三层）**：第 0 层压缩静止等候 → 第 1 层压缩 S2 → 第 2 层顺延换水周期。三层用尽触发"配液节奏严重滞后"报警（VW6=20），需 L2 介入。
- **S_ERROR 不可自动恢复**：必须现场按 I0.3 系统复位按钮才回 S0，HMI 不下发复位命令。

### 2.3 安全理念

系统设计遵循"长期无人值守、最坏情况有人不在场"原则，三大安全理念操作员必须理解：

1. **失效安全（Fail-Safe）**：所有 NC 电磁阀为常闭型，得电打开、失电关闭。一旦断电/断线，NC 阀自动关闭阻断液流，不会"故障时仍在进水"。
2. **常闭触点（NC）急停**：急停按钮 I1.1 为常闭型，正常运行 ON，急停触发 OFF。接线松脱或电缆断裂时等同按下急停，系统自动进入安全停止状态，不会"故障时检测不到急停"。
3. **双重确认急停**：急停按钮必须为双触点。第一组常闭触点串入安全继电器输入回路（不经 PLC，纯硬件切断 220V/380V 动力电）；第二组常闭触点接入 PLC I1.1（软件感知+状态机锁定）。即使 PLC 死机/程序卡死，硬件急停仍生效。

### 2.4 HMI 画面导航

HMI 共 8 个画面，顶部导航栏 80px 全局固定，从左到右依次为：**[总览][详情][手动][参数][报警][趋势][通讯][设置]**。底部状态栏 60px 显示全局报警横幅、时间、当前权限。

| 画面 | 名称 | L1 可见 | L1 可操作 | 用途 |
|---|---|---|---|---|
| 1 | 总览首页 | ✅ | ✅ 只读+导航 | 8 单元卡片 2×4 网格，三态显示（在线/通讯中断/未接入） |
| 2 | 单元详情 | ✅ | ✅ 监控+基础操作 | 状态概览+实时数据+启动/停止/确认/消音按钮 |
| 3 | 手动控制 | ❌ 禁止进入 | — | 阀门/泵手动控制，仅 S0/S_ERROR 可操作 |
| 4 | 参数设置 | ❌ 禁止进入 | — | 浓度/时间周期/超时/报警模式 4 组参数 |
| 5 | 报警与日志 | ✅ | ✅ 查看消音确认 | 当前报警+32 位指示灯阵列+历史日志 |
| 6 | 趋势曲线 | ✅ | ✅ 只读 | 实验时长/T 滚动/S6 滚动等曲线 |
| 7 | 通讯与维护 | ❌ 禁止进入 | — | PLC 连接状态+Modbus 从站状态 |
| 8 | 系统设置 | ✅ | ✅ 仅登录/注销 | 单元使能/系统/权限/版本 |

**画面导航操作步骤**：

1. 开机后 HMI 自动进入画面 1 总览首页，权限默认 L1。
2. 点击顶部导航栏任一画面按钮即可切换。
3. 画面 2~7 进入后，需先用单元选择器（导航栏下方 40px）选择要操作的单元号（1~8），未使能单元灰显不可选。
4. 画面 3/4/7 需 L2 以上权限，L1 进入会提示"权限不足"。
5. 写入类按钮（启动/停止/参数保存等）均会弹出二次确认窗，需确认后才执行。

---

## 第 3 章 安全规范

### 3.1 急停按钮位置与使用

- **位置**：每套缸单元独立配置 1 个红色蘑菇头急停按钮，就近安装于缸边控制柜面板，按下后自锁。
- **何时使用**：①发现漫溢液体外溢且自动保护未触发；②人员触电/卷入运动部件；③火灾/化学品泄漏；④其他紧急情况。
- **如何使用**：用手掌垂直按下蘑菇头到底，听到"咔哒"自锁声表示已触发。触发后：硬件回路立即切断 220V/380V 动力电（不经 PLC）；PLC I1.1=OFF 软件感知后状态机锁 S_ERROR、所有阀门/泵输出复位、灯光 DO 常亮、声音 DO 鸣响（可消音）。
- **解除**：顺时针旋转蘑菇头约 30° 即可弹起释放。注意：**释放急停 ≠ 系统复位**！释放后 I1.1=ON，但状态机仍锁 S_ERROR，必须再按就地面板"系统复位按钮"I0.3 才回 S0。

### 3.2 安全继电器

- **作用**：急停回路执行环节，强制导向型（force-guided），主触点与辅助反馈触点机械联动。主触点粘连时辅助触点绝不可能显示"已断开"。
- **反馈确认**：辅助触点接入 PLC I1.2。急停按下后 2 秒内 I1.2 应反馈"已断开"，否则触发**最高级报警 VW6=99**（红闪），禁止任何自动恢复，必须 L3 管理员 HMI 高权限确认+现场检修。
- **操作员须知**：发现 99 红闪报警，立即撤离现场至安全位置并报告班长/维护，不得自行尝试复位。

### 3.3 个人防护

进入实验室必须穿戴：

1. 防酸碱化学护目镜（防飞溅）。
2. 丁腈手套（耐弱酸碱；母液强腐蚀时改用氯丁橡胶手套）。
3. 实验服/防化围裙。
4. 防滑密闭鞋（不能露脚趾）。
5. 长发须束起，禁戴松散首饰、领带等易被运动部件卷入的物品。

### 3.4 化学品（母液）操作安全

- **母液**：人工配制后录入浓度值至 VD_C_Stock（VD14，默认 100%）。注射泵按 VD_C_Set × 上缸注水量 / VD_C_Stock 计算抽取体积。
- **操作要求**：
  1. 母液配制必须在通风橱内进行，禁止开放操作。
  2. 移取母液使用专用移液器/量筒，禁止口吸。
  3. 母液溅到皮肤立即用大量清水冲洗 ≥ 15 分钟，溅入眼睛冲洗后送医。
  4. 母液容器必须粘贴标签（名称、浓度、配制日期、配制人），未贴标签液体按危废处理。
  5. 母液储存在指定阴凉避光区，远离电器与热源。

### 3.5 禁带物品

- 禁带明火、打火机、电热器具进入实验室。
- 禁带易燃易爆溶剂（如甲醇、丙酮）与系统母液混放。
- 禁止在系统附近饮食、喝水、化妆。
- 禁带非本系统设备的大功率电器（避免电路过载）。

### 3.6 应急疏散

- 熟悉实验室紧急出口位置与疏散路线。
- 火灾/泄漏报警拉响后：①立即按下就近缸单元急停按钮；②关闭母液容器盖；③按疏散指示牌撤离；④至集合点清点人数；⑤通知 EHS 与项目经理。
- 灭火器类型：电器火灾用 CO₂ 灭火器；化学品火灾按 MSDS 要求选用，禁止用水扑救带电设备火灾。

---

## 第 4 章 日常操作 SOP（分步骤）

### 4.1 开机检查清单

每次开机前必须逐项确认（建议打印此清单贴于机柜）：

| 序号 | 检查项 | 标准 | 勾选 |
|---|---|---|---|
| 1 | 总电源开关 | 已合闸，电压表 220V±10% | ☐ |
| 2 | 急停按钮 | 全部处于释放（弹出）状态 | ☐ |
| 3 | 各单元 PLC | POWER 绿灯亮，ERROR 红灯灭 | ☐ |
| 4 | HMI 触摸屏 | 开机进入画面 1 总览页，权限默认 L1 | ☐ |
| 5 | 系统复位按钮 | 弹出状态，无机械卡滞 | ☐ |
| 6 | 上下玻璃缸 | 无可见异物、无裂纹、液位无异常 | ☐ |
| 7 | 母液容器 | 标签齐全、液位充足、密封良好 | ☐ |
| 8 | 注射泵 | 电源指示灯亮，丝杆无卡阻，进样器规格与 VD18 一致 | ☐ |
| 9 | 流量计 | 显示正常，单位 = L（0x03） | ☐ |
| 10 | 排水管路 | 无堵塞、无渗漏 | ☐ |
| 11 | 通风橱 | 运转正常 | ☐ |
| 12 | 个人防护 | 已穿戴齐全 | ☐ |

**全部勾选后方可进入下一步。任一不合格须先处理。**

### 4.2 启动实验（V0.0 CMD_Start）

启动前确认：

- 目标单元 VW2 = 0（S0 初始化态）或 8（S7 实验结束态需先 HMI 确认重启回 S0）。
- 上缸状态 V1.6 = 0（空），下缸状态 V1.7 = 0（空）。
- 报警码 VW6 = 0（无未确认报警）。
- 参数已正确设置（详见 4.5）。

**操作步骤**：

1. 在 HMI 画面 1 总览页点击目标单元卡片右下角"详情"按钮，进入画面 2 单元详情页。
2. 确认画面 2"状态概览"面板显示：当前状态 S0、上缸空、下缸空、报警无。
3. 点击"操作按钮"面板的【启动实验】按钮。
4. 弹出二次确认窗"将启动 X 号单元实验，确认？"，点击【确认】。
5. PLC 收到 V0.0 CMD_Start 上升沿，进入 S1（VW2=1），并自动置 V1.0=1 握手确认。
6. HMI 画面 2 状态行更新为"S1 上缸进水"，画面 1 总览页该单元卡片显示蓝色"运行中"。
7. 操作员可点击【进入趋势曲线】查看 S1 实测时长 VD70 等数据。

**注意事项**：

- 启动后请勿立即离开，至少观察 30 秒确认阀 A 已开（I8.0 应 ON）且有水流（流量开关 A I0.0 应 ON），否则可能触发报警码 34（开到位超时）或 35（开到位无流）。
- 启动失败常见原因：报警未清除（VW6≠0）、上缸状态错（V1.6=1）、急停未复位（I1.1=OFF）。

### 4.3 运行监控

实验启动后系统自动按 S1→S2→S3→S3.5→S4→S5→S6→S4 循环，操作员需定期监控：

**画面 1 总览页**（建议每 30 分钟查看一次）：

- 8 单元卡片三态：绿色"在线"为正常，红色边框"报警"需立即进入画面 5 处置，黄色"通讯中断"需通知 L2。
- 每卡片显示：状态（S5 运行中/S1 进水等）、上下缸状态、轮次 VW8、实验时长 VD96、报警状态。

**画面 2 单元详情页**（运行异常时进入）：

- 状态概览（240px）：当前状态、急停状态、注射泵状态 VW4、报警码。
- 实时数据（200px）：本次进水量 VD90、瞬时流速 VD94、实测 S1/S4/S6 时长 VD70/VD74/VD78、滚动 T/S6 VD112/VD116、换水周期。
- 操作按钮：启动/停止/报警确认/消音/进入报警详情/进入趋势曲线。

**画面 6 趋势曲线页**（每周或报警分析时查看）：

- 时间范围：1h / 24h / 7 天 / 自定义。
- 曲线选择：实验时长、T 滚动、S6 滚动、S1/S4/S6 实测、进水量。
- X 轴 = 实验轮次 VW8，Y 轴自适应量程。
- 异常判断：T 滚动持续上升说明泵/阀效率下降；S1 实测突增说明上游水压异常；S6 实测突增说明排水管路堵塞。

### 4.4 正常结束（V0.2 CMD_Stop）

**主动结束（操作员判断已达到实验目的时）**：

1. 在画面 2 点击【停止实验】按钮。
2. 二次确认窗"将停止 X 号单元实验，进入 S7 实验结束态，确认？"，点击【确认】。
3. PLC 收到 V0.2 CMD_Stop，进入 S7（VW2=8），状态机锁定，所有阀门/泵停止。
4. HMI 提示"实验时长已达标，实验结束"。
5. 操作员确认现场阀门已关闭、泵已停止后，可进行关机操作（见 4.7）。

**自动结束（实验时长达标）**：

- 系统累加实验时长 VD_ExperimentDuration_Accum ≥ VD_ExperimentTarget（默认 480 min=8h）时自动转入 S7，HMI 弹窗提示。
- 需操作员在 HMI 确认后才能重新进入 S0 开始新实验（不自动重启）。

### 4.5 参数设置（画面 4，VD10~VD140 各参数含义与典型值）

> **权限提示**：L1 操作员**禁止进入画面 4**。如需调整参数请通知 L2 维护人员或 L3 管理员。本节供操作员理解参数含义以便巡检发现异常时上报。

参数共分 4 组：

#### 4.5.1 浓度组（仅 L3 管理员可改）

| 地址 | 符号 | 单位 | 默认 | 含义 | 典型值 |
|---|---|---|---|---|---|
| VD10 | VD_C_Set | % | 5.0 | 目标浓度设定值 | 1.0~10.0 |
| VD14 | VD_C_Stock | % | 100.0 | 母液浓度（人工配置后录入） | 按实际 |
| VD18 | VD_StepResolution | µL/步 | 0.2083 | 注射泵单步分辨率（5ml 进样器默认） | 按进样器规格 |

**理解要点**：加药量 = VD_C_Set × 上缸注水量 / VD_C_Stock；步数 = 加药量 / VD_StepResolution。修改 VD10 或 VD14 后下一轮加药即生效。

#### 4.5.2 时间周期组（L2 可改）

| 地址 | 符号 | 单位 | 默认 | 含义 | 典型值 |
|---|---|---|---|---|---|
| VD20 | VD_CycleSetpoint | min | 30.0 | 换水周期 | 20~60 |
| VD24 | VD_ExperimentTarget | min | 480.0 | 实验时长目标 | 240~1440 |
| VD28 | VD_PreMixTime | s | 120.0 | S2 预循环标称时长 | 60~300 |
| VD32 | VD_PreMixTime_MinSafe | s | 30.0 | S2 压缩下限（纠偏第 1 层最低安全值，不能 0） | 20~60 |
| VD36 | VD_RestTime | s | 60.0 | S3.5 静止等候标称时长 | 30~120 |
| VD40 | VD_RestTime_Min | s | 15.0 | 静止等候压缩下限（不能 0） | 10~30 |
| VD44 | VD_CycleExtend_Max | min | 5.0 | 换水周期顺延最大幅度（纠偏第 2 层上限） | 3~10 |

**理解要点**：换水周期 VD20 必须大于 T 滚动（VD112）+S6 滚动（VD116）才有冗余。下限值（VD32/VD40）不可为 0，否则纠偏无空间。

#### 4.5.3 超时组（L2 可改）

| 地址 | 符号 | 单位 | 默认 | 含义 | 典型值 |
|---|---|---|---|---|---|
| VD48 | VD_Timeout_ValveA | s | 60.0 | 阀 A 动作超时保护 | 实测×1.5 |
| VD50 | VD_Timeout_ValveB | s | 60.0 | 阀 B 动作超时保护 | 实测×1.5 |
| VD54 | VD_Timeout_ValveC | s | 60.0 | 阀 C 动作超时保护 | 实测×1.5 |
| VD58 | VD_Timeout_Pump1 | s | 10.0 | 预留未用（原潜水泵 1 动作超时，水流开关取消） | — |
| VD62 | VD_Timeout_Pump2 | s | 10.0 | 预留未用（原潜水泵 2 动作超时，水流开关取消） | — |
| VD66 | VD_Delay_ValveA_Verify | s | 5.0 | 阀 A 关闭后延时验证时长 | 5~10 |

#### 4.5.4 报警模式组（仅 L3 可改）

| 地址 | 符号 | 默认 | 含义 |
|---|---|---|---|
| V200.0 | M_AlarmAckMode | 1 | 0=自动恢复（一般级条件消失自动复位）；1=人工确认（需 HMI V0.3 确认）|

**建议**：现场默认 = 1（人工确认），避免一般故障级报警自动复位导致操作员忽略故障。漫溢级/节奏级/继电器故障不受此模式影响，始终强制人工确认。

### 4.6 换水周期理解

**核心规则**：下缸变满时刻（DT_TankB_FullTime）+ 换水周期（VD_CycleSetpoint）+ S6 排水时长滚动值（VD_S6_Rolling）= 下缸预计排空时刻。达到该时刻系统自动转入 S6 排水。

**操作员需理解**：

1. 换水周期由 VD20 设定（默认 30 min），不是固定的，可由 L2 调整。
2. 系统会自动监测配液节奏，正常情况下提前在 S5 阶段触发预规划算出本轮 S2/S3.5 时长，保证下缸排水时新溶液已配好。
3. 出现"配液节奏滞后提示"VW6=21（黄色）属正常纠偏，1 个周期内会自恢复，无需操作。
4. 出现"配液节奏严重滞后"VW6=20（橙色）说明三层纠偏用尽，需 L2 介入调整 VD_CycleSetpoint 等参数。

### 4.7 关机

**短时关机（如午休、换班）**：

1. 确认所有运行的单元 VW2 = 6（S5 实验运行中）或 8（S7 实验结束）。
2. 短时关机无需停止实验，PLC 超级电容可保持数据 6~7 天，重新上电后断电恢复策略自动处理（仅 S0/S5/S7/S_ERROR 可恢复，阀门动作态断电会转 S_ERROR）。
3. 关闭 HMI 显示器电源（HMI 主机保持通电以维持与 PLC 通讯）。

**长时间关机（如周末、维护）**：

1. 主动结束实验：画面 2 点击【停止实验】→ 二次确认 → 等待 VW2=8（S7）。
2. 等待所有阀门/泵停止（约 30 秒）。
3. HMI 画面 8 注销当前权限（特别是 L2/L3 防止遗留高权限）。
4. 关闭 HMI 主机电源。
5. 关闭各单元 PLC 主电源（注意：超过 6~7 天可能丢失 RTC，重新开机需校时，详见 8.4）。
6. 关闭总电源开关。
7. 关闭母液容器盖，整理现场。

**禁止**：实验运行中（VW2=1~7）直接关闭 PLC 电源！会导致阀门动作态中断，FC0 会将 V300.4 置位（急停锁存类比），重新上电后需系统复位。

---

## 第 5 章 手动操作

> **权限提示**：本章仅 L2 维护及以上权限可操作，L1 操作员禁止进入画面 3。

### 5.1 手动控制画面 3 使用

**进入条件**：

1. L2 维护或 L3 管理员已登录 HMI（画面 8 → 登录维护/管理员）。
2. 目标单元 VW2 = 0（S0）或 99（S_ERROR），运行中（VW2=1~7）所有手动按钮灰色禁用。

**画面布局**：

- 左半（580px）：阀 A/B/C 控制，每个阀门显示当前状态、限位反馈，提供"手动开阀 X"和"手动关阀 X"两个按钮。
- 右半（580px）：潜水泵 1/2、NC 电磁阀-上缸/下缸控制，每个设备显示状态和启停按钮。
- 底部红色警示文字："⚠ 手动操作需维护级权限。运行中（VW2=1~7）禁止手动操作。"

### 5.2 阀 A/B/C 手动开闭

**手动命令位**（V2.4~V3.1 区，HMI→PLC，上升沿触发+PLC 清零握手）：

| 命令 | 地址 | 功能 | 响应条件 |
|---|---|---|---|
| 手动开阀 A | V2.4 | 开阀 A 进水 | VW2=0 或 99 |
| 手动关阀 A | V2.5 | 关阀 A 停水 | VW2=0 或 99 |
| 手动开阀 B | V2.6 | 开阀 B 转移 | VW2=0 或 99 + 联锁 |
| 手动关阀 B | V2.7 | 关阀 B | VW2=0 或 99 |
| 手动开阀 C | V3.0 | 开阀 C 排水 | VW2=0 或 99 + 联锁 |
| 手动关阀 C | V3.1 | 关阀 C | VW2=0 或 99 |

**操作步骤（以手动开阀 A 排空上缸为例）**：

1. 确认 VW2=0 或 99，无未确认报警。
2. 画面 3 左半"阀 A"区域，点击【手动开阀 A】。
3. 弹出二次确认窗"将手动开启阀 A（上缸进水），确认现场已就绪？"，点击【确认】。
4. PLC 收到 V2.4 上升沿，置 Q0.2=1 开阀，PLC 自动清 V2.4=0 握手。
5. 观察画面 3"阀 A"状态行：限位反馈"开到位"应变为 ON（绿色），流量开关 A I0.0 应变为 ON。
6. 上缸进水到目标液位后，点击【手动关阀 A】，二次确认后关阀。
7. 确认限位反馈"关到位"变为 ON，流量开关 A I0.0 变为 OFF。

### 5.3 泵手动启停（V3.2/V3.3）

| 命令 | 地址 | 功能 | 二次确认 |
|---|---|---|---|
| 手动启潜水泵 1 | V3.2 | 启潜水泵 1 搅拌 | 是 |
| 手动停潜水泵 1 | V3.3 | 停潜水泵 1 | 否 |

**注**：潜水泵 2 手动启停复用 V3.2/V3.3 对称设计待定，首期单泵手动足够，扩展时用 V3.4/V3.5。

**操作步骤**：

1. 确认上缸有液（潜水泵空转易损）。
2. 画面 3 右半"潜水泵 1"区域，点击【手动启动】。
3. 二次确认后 PLC 置 Q0.0=1，泵启动。
4. 观察上缸水流/听泵运行声音确认泵正常工作。
5. 测试完毕点击【手动停止】，PLC 清 Q0.0=0，泵停止。

### 5.4 联锁限制说明

手动操作时**安全联锁仍生效**，由 PLC 在响应逻辑中校验，HMI 侧仅下发命令不负责联锁：

- **阀 B 开启需满足**：上缸状态=满、下缸状态=空、阀 C/流量开关 C 关闭、循环泵关闭、注射泵关闭、阀 B/流量开关 B 关闭、液位计 A-低位 ON、无报警、实验进行中（自动模式）。手动模式仅校验联锁条件不校验"实验进行中"。
- **阀 C 开启需满足**：下缸状态=满、阀 C/流量开关 C 关闭、无报警。
- **不满足联锁时**：HMI 按钮灰色禁用+提示"联锁条件不满足"，PLC 拒绝执行。

### 5.5 何时用手动（调试/排障）

**适用场景**：

1. **首期调试**：注射泵/流量计通讯测试、阀门动作验证、泵效率测试。
2. **排障**：阀卡滞需手动开闭验证机械状态；上缸非空需排空后再启动（配合 V0.5 强制上缸=空）。
3. **维护后验证**：更换密封圈后手动开闭阀验证密封性；更换泵后手动启动验证流量。
4. **断电恢复后处理**：阀门动作态断电转 S_ERROR 后，需手动将阀门复位到安全位置。

**禁止场景**：

- 实验运行中（VW2=1~7）— 会破坏自动流程，强制进入 S_ERROR。
- 漫溢报警触发后未处理 — NC 阀已动作，手动开阀可能加剧漫溢。
- 注射泵加药期间（S3）手动操作阀 A 会破坏浓度配比。

---

## 第 6 章 报警处置

### 6.1 报警分级

系统共 32 个报警位（VB300~VB303，4 字节按位编码），分 4 级，操作员需记忆各级响应要求：

| 等级 | 报警码 | HMI 颜色 | 响应时效 | 处置原则 |
|---|---|---|---|---|
| 最高级 | 99 | 红色闪烁 | 立即（秒级） | 立即停机检查动力回路，禁止单独消音，撤离并报告 |
| 漫溢级 | 10~14 | 红色 | 立即（分钟级） | 立即关阀检查液位，防液体外溢 |
| 节奏级 | 20 | 橙色 | 尽快（小时内） | 评估节奏滞后原因，L2 介入调整参数 |
| 一般级 | 21、30~66 | 黄色 | 择机（班次内） | 记录并择机处理，不强制停机 |

**优先级链**（PLC 自动按此顺序在 VW6 中保存最高级未确认报警码）：

```
99 (V300.5 安全继电器)
  > 10~14 (V300.0~V300.4 漫溢/急停)
    > 20 (V300.6 节奏严重)
      > 21 (V300.7 节奏提示)
        > 30~36 (V301.x 阀 A 类)
          > 40~47 (V302.x 阀 B/C 开类)
            > 60~66 (V303.x 阀 C 关/泵/其他)
```

### 6.2 报警确认（V0.3）

**报警确认 = 消光**，作用是清除报警灯光 Q8.0 和报警锁存位，让 VW6 重算。**重要原则**：

1. **根本原因未消失时**，确认只记录"已知晓"，**不得清除报警锁存或解锁流程**。
2. **根本原因消失后**，HMI 下发 V0.3 CMD_AckAlarm，PLC 才允许灯光 DO 置 OFF、清除锁存并解锁状态机。
3. **强制人工确认类**（漫溢级 10~14、节奏严重 20、继电器故障 99）**不受 V200.0 报警模式影响**，始终需人工确认。
4. 一般级（21、30~66）按 V200.0：=0 自动复位，=1 需人工确认。

**操作步骤**：

1. 画面 5 顶部"当前报警"面板查看报警码 VW6、报警名称、处置建议。
2. 现场按处置建议处理（见 6.4）。
3. 条件消除后（如 I0.5=OFF 表示液位已下降），点击画面 5【报警确认(消光)】按钮。
4. 弹出二次确认窗（高优先级报警可能需长按 2 秒或 L3 密码二次验证），按提示操作。
5. PLC 收到 V0.3 上升沿，执行 FC3 NETWORK4 复位报警位，下一周期 VW6 重算。
6. 报警指示灯由红/橙/黄变绿，状态机解锁（若已转 S_ERROR 还需按 I0.3 系统复位）。

### 6.3 消音（V0.4 / 消音按钮 I0.4）

**消音 ≠ 消除报警**！消音只关声音 DO Q0.7，不影响灯光、报警锁存、状态机。

**两种消音方式**：

1. **就地面板消音按钮 I0.4**：常开点动，按下后仅对当前单元消音，松开后保持消音状态。
2. **HMI 画面 5 消音按钮 V0.4**：可按单元消音，也可在画面 1 总览页底部状态栏长按 2 秒"全局消音"（循环写各使能单元 V0.4）。

**注意**：消音仅对当前已知报警生效，**新报警重新鸣响**！操作员需再次消音。

### 6.4 常见报警现场处置（引用故障代码字典 Top10）

> 以下 10 条为高频/高优先级报警，操作员必须熟记处置步骤。完整 30 条详见《故障代码字典 v1.0》。

#### Top1：报警码 99 — 安全继电器故障（最高级，红闪）

| 项 | 内容 |
|---|---|
| 触发 | 急停按下后 2 秒内 I1.2 反馈未到（主触点粘连/继电器故障） |
| 现场 | 立即撤离至安全位置；检查安全继电器线圈、主触点、220V 回路、I1.2 接线 |
| HMI | L3 管理员登录 → 画面 5 点击"继电器高权限确认" → 输入密码二次验证 |
| 恢复 | 30 分钟~2 小时；禁止用 I0.3 系统复位按钮清除，必须 HMI 高权限确认 |

#### Top2：报警码 10 — 上缸漫溢（漫溢级，红）

| 项 | 内容 |
|---|---|
| 触发 | S1/S2 期间液位计 A-高位 I0.5=ON |
| 现场 | 查看上缸实际液位；检查液位计 A 是否误动作；检查阀 A 是否关到位；确认 NC 阀-上缸 Q0.5 已动作 |
| HMI | 消音；液位下降 I0.5=OFF 后报警确认 V0.3 |
| 恢复 | 15~30 分钟；PLC 已自动关阀 A+开 NC 阀-上缸保护 |

#### Top3：报警码 11 — 下缸漫溢（漫溢级，红）

| 项 | 内容 |
|---|---|
| 触发 | S4 期间液位计 B-高位 I0.7=ON |
| 现场 | 查看下缸实际液位；检查液位计 B；检查阀 B 是否关到位；确认 NC 阀-下缸 Q0.6 已动作 |
| HMI | 消音；液位下降 I0.7=OFF 后报警确认 V0.3 |
| 恢复 | 15~30 分钟 |

#### Top4：报警码 14 — 急停触发锁存（漫溢级，红）

| 项 | 内容 |
|---|---|
| 触发 | 急停按钮按下 I1.1=OFF |
| 现场 | 确认急停原因已排除；旋转释放急停按钮 I1.1=ON |
| HMI | HMI 仅显示黄色"急停已释放，等待系统复位"；**现场按下物理系统复位按钮 I0.3** |
| 恢复 | 5~15 分钟；继电器故障 V300.5 同时存在时复位无效 |

#### Top5：报警码 20 — 配液节奏严重滞后（节奏级，橙）

| 项 | 内容 |
|---|---|
| 触发 | 三层纠偏用尽（S2 压缩到 MinSafe+静止压缩到 Min+顺延到 Max 仍超时） |
| 现场 | 画面 6 趋势曲线分析 T 滚动/S6 滚动异常；检查泵/阀效率；评估是否调大 VD_CycleSetpoint |
| HMI | L2 维护登录 → 画面 4 调整时间周期参数 → 画面 5 报警确认 |
| 恢复 | 1~4 小时（需分析原因调整参数） |

#### Top6：报警码 30 — 阀 A 关后仍有流（一般级，黄）

| 项 | 内容 |
|---|---|
| 触发 | 阀 A 关闭后延时验证期间流量开关 A I0.0=ON |
| 现场 | 检查阀 A 是否完全关闭；听阀 A 处是否有水流声；检查流量开关 A 是否误动作 |
| HMI | 消音；I0.0=OFF 后自动复位或人工确认 V0.3 |
| 恢复 | 15~30 分钟 |

#### Top7：报警码 34 — 阀 A 开到位超时（一般级，黄）

| 项 | 内容 |
|---|---|
| 触发 | 阀 A 开命令下发后 VD_Timeout_ValveA 内 I8.0（开到位反馈）未到位 |
| 现场 | 检查阀 A 执行机构是否动作；检查限位开关 I8.0；检查阀 A 机械是否卡滞 |
| HMI | 消音；I8.0 到位后自动复位或人工确认 V0.3 |
| 恢复 | 15~45 分钟 |

#### Top8：报警码 64 — 注射泵通讯/动作异常（一般级，黄）

| 项 | 内容 |
|---|---|
| 触发 | 注射泵状态码 VW4 ≥ 4（错误码）或 Modbus 通讯超时无响应 |
| 现场 | 检查注射泵 485 接线（A/B 极性、终端电阻 120Ω）；检查站号/波特率配置；画面 7 查看通讯状态 |
| HMI | 消音；VW4=0 且通讯恢复后自动复位或人工确认 V0.3 |
| 恢复 | 30 分钟~1 小时（可能需重启泵/检查 485） |

#### Top10：报警码 65 — RTC 时钟丢失（一般级，黄）

| 项 | 内容 |
|---|---|
| 触发 | 开机时 PLC RTC 时间早于 DT_TankB_FullTime（断电超过 6~7 天超级电容失效） |
| 现场 | 检查 PLC 超级电容是否失效；确认 PLC RTC 是否需更换电池 |
| HMI | L3 管理员登录 → 画面 8 点击"RTC 校时"同步时间至 PLC → 画面 5 报警确认 V0.3 |
| 恢复 | 5~10 分钟；RTC 丢失后 VD_S5_Elapsed 无法重算，FC0 已转 S_ERROR，需校时后系统复位 |

### 6.5 报警后恢复流程

**通用四步法**：

```
[1] 识别
    ↓ 画面 5 查看 VW6 报警码+指示灯位置+处置建议
[2] 现场检查
    ↓ 按"现场检查"列到现场核实设备状态
    ↓ 能立即处理 → 现场处理
    ↓ 需停机检修 → 报告班长/维护
[3] HMI 操作
    ↓ 消音（I0.4 或 V0.4）
    ↓ 条件消除（DI 恢复正常）
    ↓ 报警确认 V0.3（最高级 V0.7）
[4] 恢复
    ↓ 报警指示灯变绿
    ↓ 若已转 S_ERROR → 现场按 I0.3 系统复位按钮回 S0
    ↓ 重新启动实验 V0.0
```

**紧急情况（最高级/漫溢级）专用流程**：

```
99 红闪 / 10~14 红 报警触发
    ↓ 立即消音（不影响处置）
    ↓ 现场确认是否需进一步急停（如漫溢严重）
    ↓ 需急停 → 现场按急停 → PLC 转 S_ERROR
    ↓ 无需急停 → 现场检查处理
    ↓ 按本指引"HMI 操作"列执行
    ↓ 报警确认（需相应权限）
    ↓ 系统复位回 S0（物理按钮 I0.3）
    ↓ 恢复运行
```

---

## 第 7 章 急停与复位

### 7.1 急停触发后果

按下任一缸单元急停按钮后，该单元发生以下变化（其他 7 套单元**不受影响**，因为 8 套急停回路完全独立）：

1. **硬件通道**（不经过 PLC，纯硬件动作）：
   - 安全继电器线圈失电。
   - 主触点断开，切断潜水泵/注射泵/电动球阀的 220V/380V 动力电源。
   - 即使 PLC 死机/程序卡死时仍生效。
2. **软件通道**（PLC I1.1=OFF 后）：
   - 强制所有阀门/泵内部输出线圈复位为 OFF。
   - 顶层状态机锁 S_ERROR（VW2=99，V300.4=M_EStop_Latch 置位）。
   - 禁止任何自动状态切换。
   - 触发报警：灯光 DO Q8.0 常亮（漫溢级处理）；声音 DO Q0.7 鸣响（可消音）。
   - HMI 显示红色"急停触发，等待释放急停按钮；释放后仍需按现场系统复位"。
3. **延时校验**：2 秒内 I1.2 应反馈"已断开"。若未反馈，升级为继电器故障报警 VW6=99（最高级，红闪），禁止任何自动恢复。

### 7.2 急停解除步骤

> **核心原则**：急停按钮旋转释放 ≠ 系统复位！释放只表示硬件触点恢复，不清除 PLC 急停锁存，也不恢复自动流程。

**正确解除步骤**：

1. **现场确认急停原因已排除**（紧急情况已处理/维护完成/接线修复）。
2. **顺时针旋转急停按钮蘑菇头**约 30°，听到"咔哒"声后按钮弹起，I1.1 恢复 ON。
3. **检查 HMI 画面 2/5**：应显示黄色"急停已释放，等待系统复位"。
4. **检查 V300.5（继电器故障）是否 = 1**：
   - 若 V300.5=0（无继电器故障）：直接执行步骤 5。
   - 若 V300.5=1（有继电器故障）：先按 7.4 处理继电器故障，再执行步骤 5。
5. **现场按下物理"系统复位按钮" I0.3**（HMI 不直接下发复位命令）。
6. PLC 执行 FC19 NETWORK3：I1.1=ON + I0.3 上升沿 + V300.5=0 → R V300.4（清除急停锁存）+ R V1.6（上缸强制置空）+ R V1.7（下缸强制置空）+ VW2=0（回 S0）+ VW6=0 + R Q0.7。
7. HMI 状态自动更新为"S0 初始化"。
8. 操作员可重新启动实验 V0.0。

**注意**：系统复位后不支持从中断点继续运行，必须从 S0 重新开始。

### 7.3 系统复位（V2.3 按钮 / I0.3）

**复位按钮规格**：

- 物理地址：I0.3。
- 类型：无源常开点动触点。
- 位置：每套缸单元就地面板，与急停按钮并列。
- 接线：直接接入 PLC 自身 24VDC 回路，与急停按钮独立。

**复位生效条件**（PLC 在 FC19 NETWORK3 校验）：

1. I1.1=ON（急停按钮已释放）。
2. V300.5=0（继电器故障已清除）。
3. I0.3 上升沿（按下瞬间触发，非长按）。

**复位效果**：

- 清除 V300.4 急停锁存。
- 强制上下缸状态置空（R V1.6, R V1.7）。
- VW2 = 0（回到 S0 初始化）。
- VW6 = 0（清除报警码，但报警锁存位 V300.0~V303.x 不被 I0.3 清除，需通过 V0.3/V0.7 HMI 确认）。
- R Q0.7（关声音 DO）。
- 灯光 DO Q8.0 仍按报警状态保持，需 HMI 报警确认后清光。

### 7.4 安全继电器故障高权限确认（V0.7）

> 仅 L3 管理员可执行，是最高级报警 VW6=99 的唯一清除方式。

**触发场景**：急停按下后 2 秒内 I1.2 反馈未到，判定安全继电器主触点粘连或反馈回路故障。

**处置流程**：

1. **现场检修**（L2/L3 配合）：
   - 检查安全继电器线圈是否得电（指示灯）。
   - 万用表测量 I1.2 端子电压：ON=24V（动力回路已断开确认），OFF=0V。
   - 断电后用通断挡测主触点，正常应开路；若短路表示粘连熔焊，需更换继电器。
   - 检查 220V 动力回路绝缘，排除短路。
   - 检查 I1.2 反馈接线（强制导向触点→中间继电器→PLC DI）。
2. **现场修复后**：旋转释放急停按钮 I1.1 恢复 ON，I1.2 应反馈为 ON。
3. **HMI 高权限确认**：
   - L3 管理员登录 HMI（画面 8 → 登录管理员）。
   - 画面 5 当前报警面板点击【继电器高权限确认】按钮。
   - 弹窗提示"此操作将清除继电器故障报警，需管理员权限确认"。
   - 输入 L3 管理员密码二次验证。
   - PLC 执行 FC19 NETWORK4：`LD V0.7 EU A I1.2 R V300.5`——必须 I1.2=ON 才清除 V300.5。
4. **系统复位**：V300.5 清除后，按就地面板 I0.3 系统复位按钮回 S0。
5. **预防**：每月执行 1 次急停按钮测试验证 I1.2 反馈时序 < 2 秒；每年检查继电器主触点烧蚀情况。

**禁止操作**：

- 禁止用 I0.3 系统复位按钮直接清除 V300.5（FC19 NETWORK2 会跳过复位逻辑）。
- 若 I1.2 仍 OFF（检修未完成），V0.7 无法清除报警，必须继续检修。

---

## 第 8 章 L2 维护人员培训补充

> 本章仅 L2 维护及以上权限需掌握，L1 操作员了解即可。

### 8.1 维护权限操作

**L2 维护可执行**（向下兼容 L1）：

- 画面 2 全部操作（含 V0.5/V0.6 强制修正上下缸状态）。
- 画面 3 全部手动操作（阀 A/B/C、潜水泵 1）。
- 画面 4 时间周期组+超时组参数修改（浓度组需 L3）。
- 画面 5 全部操作（消音、报警确认，但继电器高权限确认需 L3）。
- 画面 7 通讯维护页查看+诊断。
- 画面 8 除单元使能、RTC 校时外的操作。
- 审计日志查看（仅自己操作记录）。

**L2 维护禁止**：

- 浓度组参数修改（VD10/VD14/VD18，仅 L3）。
- 报警模式修改（V200.0，仅 L3）。
- 单元使能配置、RTC 校时（仅 L3）。
- 继电器高权限确认 V0.7（仅 L3）。
- 用户密码管理（仅本人可改自己密码，他人需 L3 重置）。

**超时自动注销**：L2 登录后启动 15 分钟倒计时，任意操作重置倒计时；倒计时结束自动降级为 L1，弹窗提示"权限已超时降级为操作员"。

### 8.2 参数整定（超时/阈值）

**整定原则**：

| 参数 | 默认 | 整定方法 | 整定频率 |
|---|---|---|---|
| VD48 VD_Timeout_ValveA | 60s | 现场实测阀 A 开/关时间 × 1.5 倍 | 首次调试+年度 |
| VD50 VD_Timeout_ValveB | 60s | 同上 | 同上 |
| VD54 VD_Timeout_ValveC | 60s | 同上 | 同上 |
| VD58 VD_Timeout_Pump1 | 10s | 预留未用（原潜水泵 1 动作超时，水流开关取消） | — |
| VD62 VD_Timeout_Pump2 | 10s | 预留未用（原潜水泵 2 动作超时，水流开关取消） | — |
| VD66 VD_Delay_ValveA_Verify | 5s | 关阀后水流惯性完全消除（建议 5~10s） | 同上 |
| VD20 VD_CycleSetpoint | 30min | 与 VD_T_Rolling 保持 ≥ 10% 余量 | 节奏滞后时调整 |
| VD32 VD_PreMixTime_MinSafe | 30s | 不可为 0，纠偏空间预留 | 季度 |
| VD40 VD_RestTime_Min | 15s | 不可为 0 | 季度 |
| VD44 VD_CycleExtend_Max | 5min | 换水周期的 15~20% | 季度 |
| T35 继电器反馈延时 | 2s | STL 修改（PT=20），机械慢可延至 3s | 更换继电器时 |
| 内漏阈值 | 0.1L | FC30 NETWORK8 STL 硬编码，按现场实际渗漏允许值修改 | 季度 |

**整定步骤**（以 VD48 阀 A 超时为例）：

1. L2 维护登录 HMI。
2. 画面 4 → 超时组 → 找到 VD48 VD_Timeout_ValveA。
3. 修改为新值（如 90s），点击【保存参数】。
4. 二次确认窗"将修改 1 个参数，确认保存？"，点击【确认】。
5. PLC 写入 VD48，下一周期生效。
6. 观察下一轮 S1 阀 A 动作，确认不再误报 32/34 超时。

### 8.3 诊断数据查看（VW260~270 阀门诊断）

PLC 内部维护阀门诊断子状态/结果，便于 L2 排查故障：

| 地址 | 符号 | 说明 |
|---|---|---|
| VW260 | Diag_State_A | 阀 A 诊断状态（1=开到位等待/2=开启完成/3=关到位等待/4=关到位完成/5=延时验证） |
| VW262 | Diag_State_B | 阀 B 诊断状态（同上） |
| VW264 | Diag_State_C | 阀 C 诊断状态（同上） |
| VW266 | Diag_Result_A | 阀 A 诊断结果（0=待测/1=正常/2=故障） |
| VW268 | Diag_Result_B | 阀 B 诊断结果 |
| VW270 | Diag_Result_C | 阀 C 诊断结果 |

**查看方法**：

1. L2 维护登录 HMI。
2. 画面 7 通讯维护页 → 诊断信息面板（120px）。
3. 查看 Diag_State/Diag_Result 当前值。
4. 配合画面 2 单元详情页的 DI 状态（I0.x/I1.x/I8.5）交叉验证。

**故障定位示例**：

- Diag_State_A=3（关到位等待）+ Diag_Result_A=2（故障）+ I8.1=OFF → 阀 A 关到位超时报警码 32。
- Diag_State_B=4（关到位完成）+ Diag_Result_B=2（故障）+ I0.1=ON → 阀 B 关到位仍有流报警码 44（内漏）。

### 8.4 断电恢复处理

**超级电容保持能力**：CPU ST20 典型 7 天/最小 6 天。在此期限内断电保持变量不丢失。

**断电恢复策略（FC0 实现）**：

| 断电时状态 | 恢复行为 |
|---|---|
| S0 初始化 | 重新进入 S0，正常启动 |
| S1/S2/S3/S3.5/S4/S6（阀门动作态） | 转入 S_ERROR（V300.4 急停锁存类比置位），需现场 I0.3 系统复位 |
| S5 实验运行中 | 用 RTC − DT_TankB_FullTime 重算已运行时长，继续 S5 |
| S7 实验结束 | 保持 S7，需 HMI 确认重启 |
| S_ERROR | 保持 S_ERROR，需现场 I0.3 系统复位 |

**断电超过 6~7 天的特例**：

- PLC RTC 停走，重新上电后开机检测 RTC 时间早于 DT_TankB_FullTime，触发报警码 65（RTC 时钟丢失）。
- FC0 已转 S_ERROR，VD_S5_Elapsed 无法重算（置 0）。
- 必须由 L3 管理员在画面 8 执行 RTC 校时同步时间至 PLC，然后报警确认 V0.3，再现场 I0.3 系统复位。

**断电恢复处理 SOP（L2）**：

1. 上电后查看 HMI 画面 1 总览页，确认各单元通讯在线。
2. 画面 2 进入每个单元，查看 VW2 当前状态。
3. 若 VW2=99（S_ERROR）：
   - 检查 V300.4（急停锁存）和 V300.5（继电器故障）。
   - 若 V300.4=1 且 V300.5=0：现场按 I0.3 系统复位回 S0。
   - 若 V300.5=1：按 7.4 处理继电器故障后再复位。
4. 若报警码 65（RTC 丢失）：通知 L3 校时。
5. 重新启动实验前，确认参数无丢失（VD10~VD66 应保持原值，断电保持区已配置）。

### 8.5 备份操作

**需备份的内容**：

1. **PLC 程序**：使用 STEP 7-Micro/WIN SMART 上载 PLC 程序至电脑，保存为 .smart 文件。
2. **PLC 系统块配置**：断电保持区范围、IP 地址等。
3. **HMI 工程**：使用昆仑通态 MCGS 组态软件上载 HMI 工程，保存为工程文件。
4. **参数当前值**：在画面 4 截图或手抄所有 VD 参数当前值（尤其浓度组、超时组），便于恢复。
5. **报警日志**：画面 5 历史日志，导出为 CSV 或截图。
6. **审计日志**：画面 8 审计日志，导出 CSV。

**备份频率建议**：

- 首次调试完成后：完整备份 1 份存档。
- 参数调整后：立即备份参数当前值。
- 月度：报警日志+审计日志导出。
- 年度：PLC 程序+HMI 工程完整备份。
- 升级前/紧急维护前：完整备份。

**备份存储**：

- 至少 2 份存储介质（电脑硬盘+U 盘/网盘）。
- 标签注明：项目名、备份日期、备份人、备份内容、PLC/HMI 版本号。
- 保留至少 1 年，关键备份（首次调试、版本升级）永久保留。

---

## 第 9 章 考核题库

### 9.1 理论题（30 题，含答案）

#### 单选题（20 题，每题 3 分，共 60 分）

**1. 本系统共由多少套缸单元组成？**
A. 4 套
B. 6 套
C. 8 套
D. 12 套

**答案**：C

**2. HMI 触摸屏的尺寸与品牌是？**
A. 10 寸 威纶通
B. 12 寸 昆仑通态 MCGS
C. 15 寸 步科
D. 8 寸 显控

**答案**：B

**3. 状态机共有几个状态（含 S_ERROR）？**
A. 7 个
B. 8 个
C. 9 个
D. 10 个

**答案**：C（S0~S7 共 8 个 + S_ERROR = 9 个）

**4. 启动实验的命令位是？**
A. V0.0 CMD_Start
B. V0.1 CMD_Pause
C. V0.2 CMD_Stop
D. V0.3 CMD_AckAlarm

**答案**：A

**5. 急停按钮的触点类型是？**
A. 常开
B. 常闭
C. 双触点常开
D. 双触点常闭（独立两组）

**答案**：D

**6. 急停按钮第二组常闭触点接入 PLC 的哪个 DI？**
A. I0.5
B. I1.0
C. I1.1
D. I1.2

**答案**：C

**7. 安全继电器反馈信号接入 PLC 的哪个 DI？**
A. I1.1
B. I1.2
C. I8.0
D. I0.3

**答案**：B

**8. 系统复位按钮的物理地址是？**
A. I0.4
B. I2.2
C. I0.3
D. I2.4

**答案**：C

**9. L2/L3 登录后多久无操作自动注销？**
A. 5 分钟
B. 10 分钟
C. 15 分钟
D. 30 分钟

**答案**：C

**10. 最高级报警 VW6=99 对应什么故障？**
A. 上缸漫溢
B. 急停触发
C. 安全继电器故障
D. 配液节奏严重滞后

**答案**：C

**11. 漫溢级报警的报警码范围是？**
A. 10~14
B. 20~21
C. 30~36
D. 60~66

**答案**：A

**12. 一般级报警按什么模式复位？**
A. 始终自动复位
B. 始终人工确认
C. 按 M_AlarmAckMode（V200.0）：0=自动 1=人工
D. 按 VW2 状态决定

**答案**：C

**13. 消音按钮按下后的效果是？**
A. 关闭声音+清除报警
B. 关闭声音+清除灯光
C. 仅关闭声音 DO，灯光和报警锁存保持
D. 重置状态机

**答案**：C

**14. 报警确认 V0.3 在什么条件下才能清除报警锁存？**
A. 任何时候
B. 报警根本原因消失后
C. 急停释放后
D. 系统复位后

**答案**：B

**15. 阀 B 开启需满足的联锁条件是？**
A. 上缸=满、下缸=空
B. 上缸=空、下缸=满
C. 上下缸均=满
D. 上下缸均=空

**答案**：A

**16. 注射泵加药的控制方式是？**
A. 时长控制
B. 步数控制+状态轮询
C. 体积连续控制
D. 流量反馈控制

**答案**：B

**17. 流量计的"计量值"寄存器有什么特点？**
A. 可清零
B. 持续累加、无清零功能，需用差值法
C. 每次进水后自动清零
D. 由 PLC 命令清零

**答案**：B

**18. 手动控制画面 3 在什么状态下可操作？**
A. 任何状态
B. 仅 S0/S_ERROR
C. 仅 S5
D. 仅 S7

**答案**：B

**19. 长时间关机前应先做什么？**
A. 直接关电源
B. 主动停止实验等待 VW2=8
C. 拔掉 PLC 网线
D. 关闭 HMI 显示器

**答案**：B

**20. PLC 超级电容的断电保持能力是？**
A. 典型 7 天/最小 6 天
B. 典型 30 天/最小 20 天
C. 永久保持
D. 仅 24 小时

**答案**：A

#### 判断题（10 题，每题 4 分，共 40 分，对打 √，错打 ×）

**21. 急停按钮旋转释放后，系统会自动恢复运行。**

**答案**：×。释放只表示硬件触点恢复，PLC 急停锁存仍保持，必须再按就地面板"系统复位按钮"I0.3 才回 S0。

**22. 8 套缸单元的急停回路是联动的，按下任一急停会切断全部 8 套动力电。**

**答案**：×。8 套单元急停回路完全独立，按下任一急停仅切断该套动力电，不影响其余 7 套。

**23. NC 电磁阀是常闭型，得电打开、失电关闭，符合失效安全原则。**

**答案**：√

**24. L1 操作员可以修改浓度组参数（VD10/VD14/VD18）。**

**答案**：×。浓度组参数仅 L3 管理员可修改，L1 禁止进入画面 4 参数设置页。

**25. 报警确认 V0.3 可以清除所有报警，包括根本原因未消失的报警。**

**答案**：×。根本原因未消失时，确认只记录"已知晓"，不得清除报警锁存或解锁流程。

**26. 消音按钮 I0.4 是无源常开点动触点，直接接入 PLC 自身 24VDC 回路。**

**答案**：√

**27. 实验运行中（VW2=1~7）可以进入画面 3 进行手动操作。**

**答案**：×。运行中所有手动按钮灰色禁用，仅 S0/S_ERROR 态可操作。

**28. HMI 故障时，PLC 仍按本地程序继续运行，急停和系统复位不受影响。**

**答案**：√。急停和系统复位均为就地物理回路/按钮，不依赖 HMI。

**29. 配液节奏滞后提示 VW6=21（黄色）是严重故障，必须立即停机。**

**答案**：×。VW6=21 是一般级报警，1 个换水周期内会自恢复，无需停机。VW6=20（橙色）才是节奏严重滞后需 L2 介入。

**30. 阀门限位反馈信号是有源正极输出，必须经中间继电器转换后才能接入 PLC DI。**

**答案**：√

### 9.2 操作题（10 题，场景化操作步骤评分，每题 10 分，共 100 分，≥90 分合格）

> 评分标准：步骤完整正确 10 分，关键步骤遗漏或顺序错误扣 2~3 分，操作导致安全风险直接 0 分不合格。

**操作题 1：完成 1 号单元开机检查并启动实验**

评分要点：
1. 完成开机检查清单 12 项逐项确认（5 分，漏 1 项扣 0.5 分）。
2. 进入画面 1 总览页，点击 1 号单元卡片"详情"进入画面 2（1 分）。
3. 确认 VW2=0、上下缸空、VW6=0（2 分）。
4. 点击【启动实验】并在二次确认窗点击【确认】（1 分）。
5. 观察 30 秒确认阀 A 开到位 I8.0=ON 且有流 I0.0=ON（1 分）。

**操作题 2：监控运行中的 1 号单元并查看趋势曲线**

评分要点：
1. 画面 1 总览页确认 1 号单元卡片显示绿色"在线"且状态正常（2 分）。
2. 进入画面 2 查看状态概览与实时数据（2 分）。
3. 点击【进入趋势曲线】进入画面 6（2 分）。
4. 选择时间范围 24h，勾选实验时长+T 滚动+S6 滚动曲线（2 分）。
5. 正确解读曲线趋势（如 T 滚动是否稳定）（2 分）。

**操作题 3：正常停止 1 号单元实验并关机**

评分要点：
1. 画面 2 点击【停止实验】并二次确认（2 分）。
2. 等待 VW2=8（S7 实验结束）（2 分）。
3. 确认阀门/泵已停止（2 分）。
4. 画面 8 注销当前权限（2 分）。
5. 关闭 HMI 主机+PLC 电源+总电源顺序正确（2 分）。

**操作题 4：处置报警码 10（上缸漫溢）**

评分要点：
1. 画面 5 识别报警码 10 红色，读取处置建议（2 分）。
2. 立即现场查看上缸实际液位（2 分）。
3. 确认阀 A 已关、NC 阀-上缸 Q0.5 已动作（2 分）。
4. 消音（I0.4 或 V0.4）（1 分）。
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
