Yustnust/AQUA-EXPO/docs/O1CN01AHIHFY1kBSWqAkPyY_!!385014645.webp

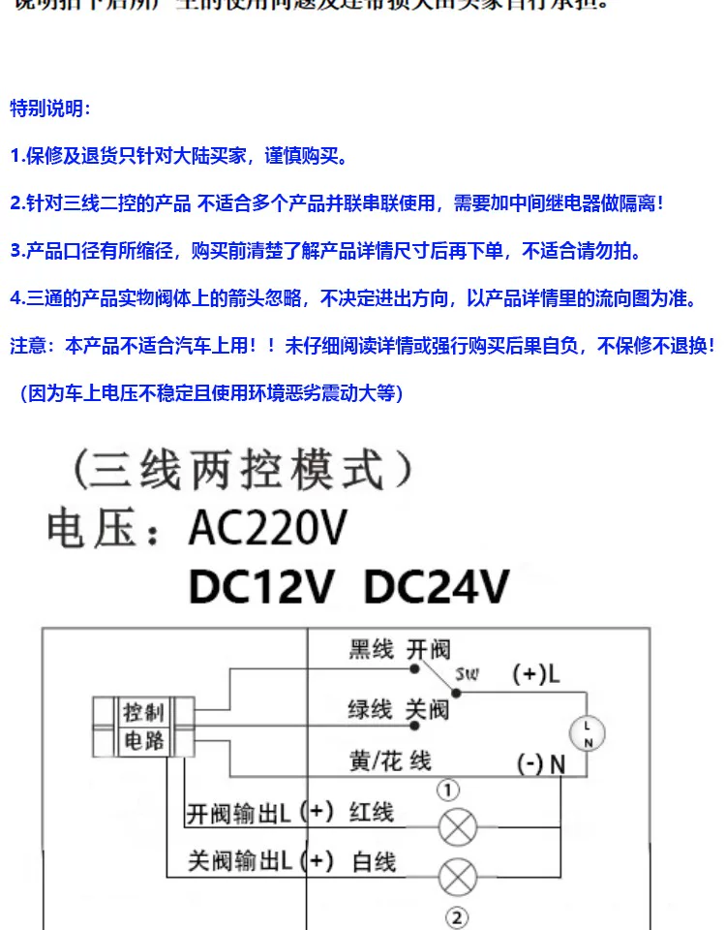
docs/O1CN01AHIHFY1kBSWqAkPyY_!!385014645.webp
