Yustnust/AQUA-EXPO/docs/picture/State_estop1.jpg

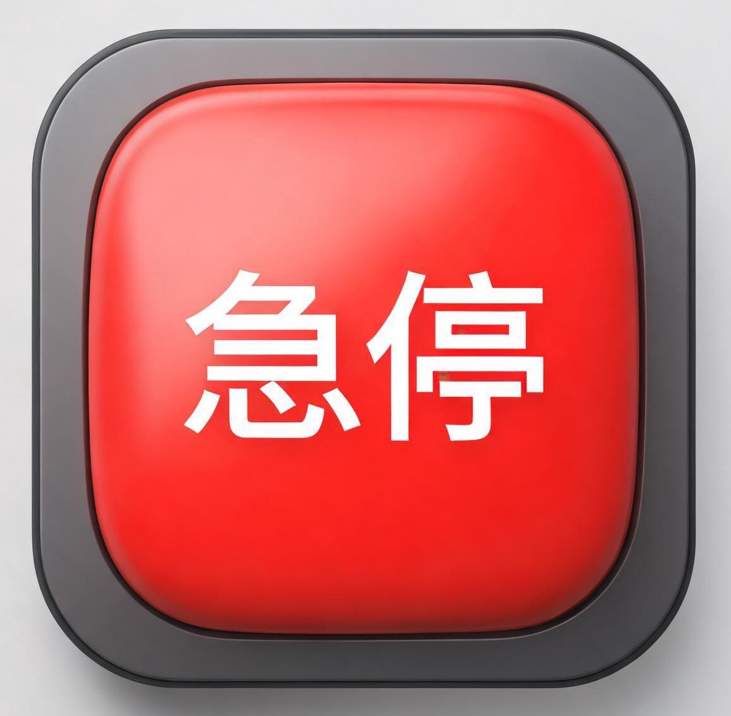
docs/picture/State_estop1.jpg
