Yustnust/AQUA-EXPO/docs/picture/State_estop.jpg

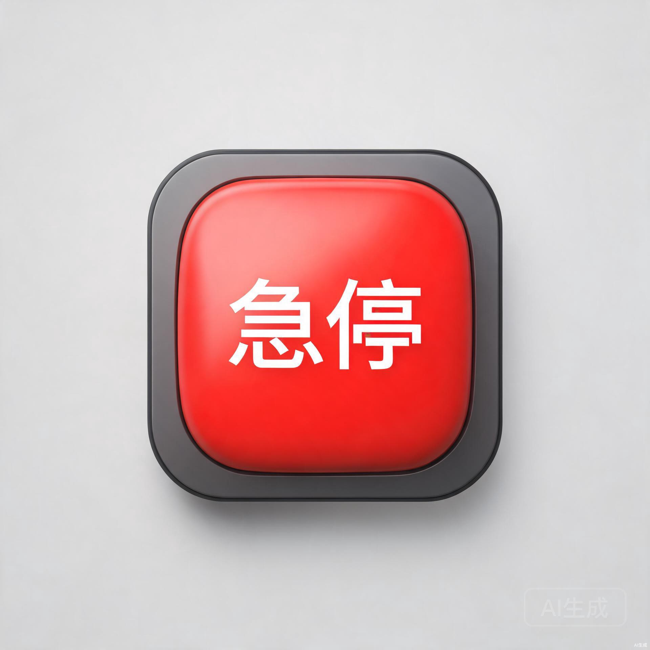
docs/picture/State_estop.jpg
