Yustnust/AQUA-EXPO/docs/picture/State_fail.jpg

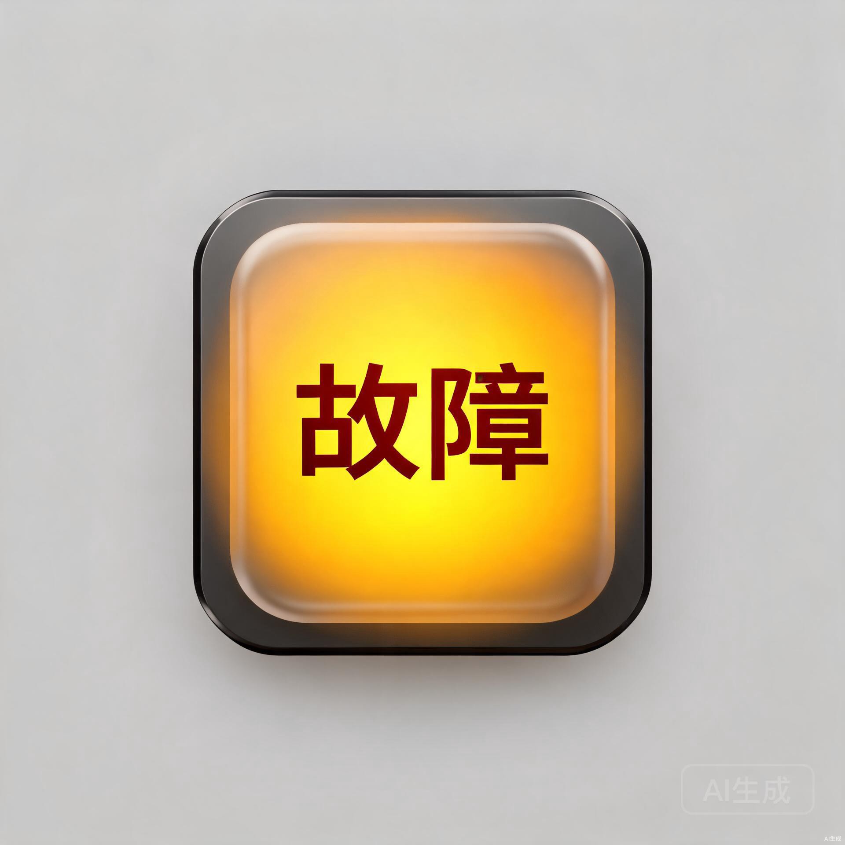
docs/picture/State_fail.jpg
