Yustnust/AQUA-EXPO/docs/picture/State_good-1.jpg

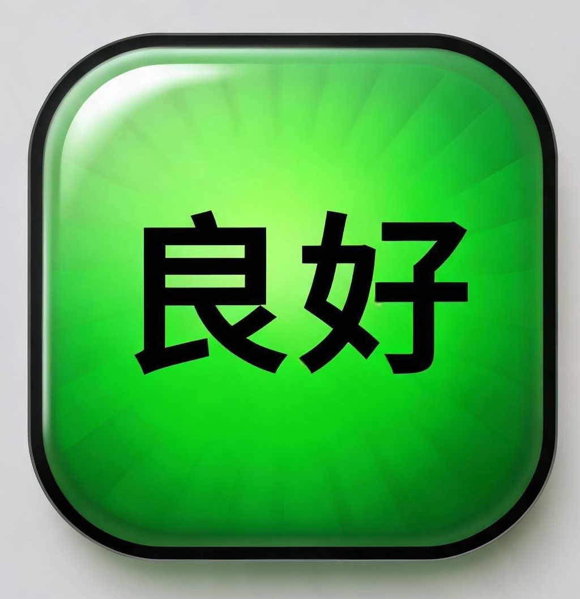
docs/picture/State_good-1.jpg
