Yustnust/AQUA-EXPO/docs/picture/State_good.jpg

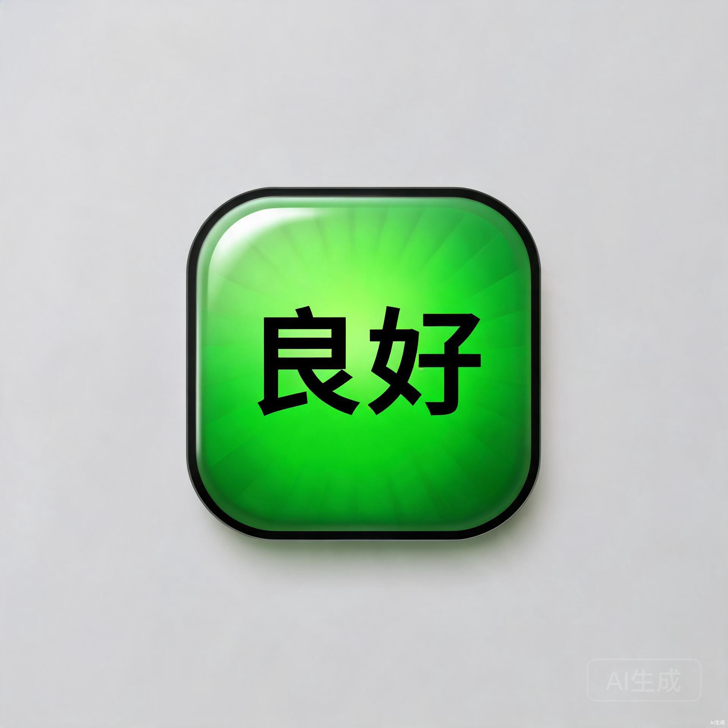
docs/picture/State_good.jpg
