Yustnust/AQUA-EXPO/注射泵/南京润泽注射泵.png

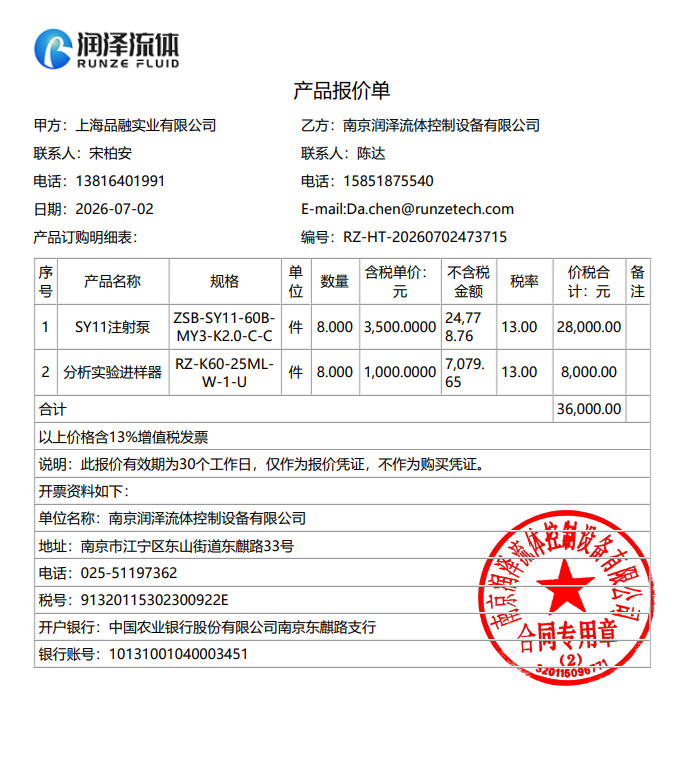
注射泵/南京润泽注射泵.png
