Yustnust/AQUA-EXPO/docs/技术债务清单_v1.0.md

# 药液配置加注控制系统 — 技术债务清单 v1.0

**项目**: AQUA-EXPO 药液配置与加注控制系统(8套缸单元,8台S7-200 SMART CPU ST20 + 1台HMI集中监控)
**项目背景一句话**: PLC代码Story 1.7已完成(20个FC的STL代码),经2轮完整性校验+静态分析,8个严重VD编址冲突已修复5个(剩余3个参数区步长冲突待专用迭代);HMI初步选型昆仑通态MCGS 12寸(供应商二轮确认中),采购未启动。
**版本**: v1.0
**编制日期**: 2026-07-18
**编制人**: 项目经理
**配套文档**: PLC代码静态分析报告v1.0、PLC代码完整性校验报告v1.0、FMEA失效模式分析v1.0、边界条件与异常场景清单v1.0、PLC程序版本管理规范v1.0、变更管理流程v1.0

***

## 一、技术债务分类与评级标准

### 1.1 债务分类

| 类别 | 说明 | 典型来源 |
| --- | --- | --- |
| 代码债务 | STL代码缺陷/未实现逻辑/编址冲突/变量问题 | 静态分析报告、FMEA、边界条件清单  |
| 测试债务 | 未执行的测试/缺失的测试用例/未设计的验收场景 | 性能基准测试方案、SAT\_FAT用例 |
| 文档债务 | 文档不一致/缺失/过时/注释错误 | 校验报告、版本管理规范、设计文档 |
| 设计债务 | 设计层面未实现的功能/缺失的诊断设计/硬件反馈缺失 | FMEA P2、边界条件清单 |
| 基础设施债务 | 版本管理工具/部署脚本/备份归档/版本号机制未建立 | 版本管理规范、变更管理流程 |

### 1.2 优先级评级

| 优先级 | 判定 | 处置要求 |
| --- | --- | --- |
| **P0立即** | 安全功能缺陷/FMEA RPN≥150的P0项/阻塞发布  | 24小时内启动修复,v1.0发布前必修 |
| **P1高**  | FMEA RPN≥150的P1项/静态分析严重项/影响验收 | v1.0发布前或release-1.1前修复 |
| **P2中**  | 静态分析警告项/影响可维护性/需硬件改动 | 计划性修复,列入迭代backlog |
| **P3低**  | 静态分析提示项/不影响功能/优化类 | 长期跟踪,择机整改 |

### 1.3 债务利息说明

技术债务若不及时偿还,将产生"利息":

- **代码债务利息**: 缺陷累积导致现场故障排查成本指数上升;编址冲突可能引发状态机误转移

- **测试债务利息**: 未测试项在SAT/FAT现场暴露,返工成本远高于内部测试

- **文档债务利息**: 文档不一致导致现场实施错误,重复沟通成本

- **设计债务利息**: 安全诊断缺失可能导致漫溢/实验数据失效等不可逆后果

- **基础设施债务利息**: 版本管理混乱导致8台PLC版本不一致,现场事故风险

***

## 二、技术债务总览

> 共登记技术债务 **35 项**:代码债务 17 / 测试债务 5 / 文档债务 5 / 设计债务 4 / 基础设施债务 2。其中P0立即 **0 项**(v2.0全部已修复),P1高 **13 项**,P2中 **11 项**,P3低 **6 项**。**已修复 4 项**(TD004/AQEX-36 + TD025/026/027/AQEX-49 + TD029/AQEX-49),已删除 2 项(TD002/TD013)。

| 类别 | 债务数 | P0 | P1 | P2 | P3 |
| --- | --- | ----- | --- | ----- | ----- |
| 代码债务 | 16 | 3 | 7 | 3 | 3 |
| 测试债务 | 5 | 0 | 1 | 3 | 1 |
| 文档债务 | 5 | 0 | 2 | 2 | 1 |
| 设计债务 | 4 | 0 | 2 | 2 | 0 |
| 基础设施债务 | 2 | 0 | 1 | 0 | 1 |
| **合计** | **32** | **3** | **13** | **10** | **6** |

***

## 三、代码债务(13项)

| 编号 | 债务描述 | 来源依据 | 影响 | 优先级 | 责任人 | 目标版本 | 状态 |
| --- | --- | --- | --- | --- | --- | --- | --- |
| TD001 | NC球阀报警位V300.2/V300.3未置位:FC30/FC31 NETWORK1仅`S Q0.5/Q0.6`未置报警位 | FMEA 5.1项1/2(P0,RPN=384);边界条件EXT-03;故障代码字典预留接口 | 漫溢时HMI不显示NC球阀动作报警,运维误判  | **P0** | PLC工程师 | v1.0 | 待修复 |
| TD002 | ~~V303.6流量开关瞬时异常未实现~~ | FMEA 5.1项14/15(P1,RPN=200/160);边界条件SEN-03 | 流量开关抖动导致四态诊断瞬时误判 | **已删除(2026-09-08)** | PLC工程师 | v1.0 | **已删除**：三个流量开关各自有独立报警位(V301.0~V303.1)，不再需要汇总抖动检测 |
| TD003 | FC4 Modbus通讯超时骨架未实现:FC4引用数2/写入数0,无MBUS\_MSG超时/Error处理 | FMEA 5.1项3(P1,RPN=240);边界条件COM-01;静态分析FC4写入数=0 | S3加药通讯中断无超时,停滞或误判完成 | **P1** | PLC工程师 | v1.0 | 待修复 |
| TD004 | ~~3个VD编址冲突未修复:VD18/VD20(VB20~~21)、VD48/VD50(VB50~~51)、VD96/VD98(VB98\~99)参数区步长冲突~~ | 静态分析严重#1\~#3;AQEX-36(VD参数区重排说明v1.0)已将6个变量迁移至VD350~VD584 | 参数区写入污染,运算错误,状态机误转移 | **已修复(AQEX-36,2026-07-18)** | PLC工程师 | release-1.1 | **已修复**：VD18→VD350、VD20→VD354、VD48→VD358、VD50→VD362、VD96→VD366、VD98→VD584，详见《VD参数区重排说明 v1.0》 |
| TD005 | FC0跨日RTC计算缺陷:BCD转秒仅用当天秒数,未补天数×86400 | 边界条件PWR-08/CLK-03高风险;FC0 NETWORK4/5注释已承认 | 断电跨天VD\_S5\_Elapsed计算错误 | **P1** | PLC工程师 | v1.0 | 待修复 |
| TD006 | 阀B/阀C四态诊断缺延时确认:FC31/FC32子状态3"简化直接判定状态4" | FMEA 5.1项6/16(P1,RPN=180/150);边界条件VAL-05 | 转移/排水初期瞬时误报故障 | **P1** | PLC工程师 | v1.0 | 待修复 |
| TD007 | 48跨FC写入冲突:VB2被17个FC写入、VB3被16个FC写入,依赖调用顺序互斥 | 静态分析警告#1\~#48(48个跨FC写入冲突) | 调用顺序变更或新增FC引入时序冲突 | **P2** | PLC工程师 | release-1.1 | 评审中 |
| TD008 | 11个参数区写入警告:参数区(VD10\~VD140)被多FC写入 | 静态分析警告(11个参数区写入) | 参数默认值被运行时逻辑覆盖风险 | **P2** | PLC工程师 | release-1.1 | 评审中 |
| TD009 | 73个未定义变量:STL中使用但变量表未定义 | 静态分析提示(73个未定义变量) | 变量无符号定义,可维护性差,潜在运行时异常 | **P3** | PLC工程师 | release-1.2 | 待计划 |
| TD010 | 87个地址对齐问题:VD/VW地址未按自然边界对齐 | 静态分析提示(87个对齐问题) | 通讯效率影响,非功能性问题 | **P3** | PLC工程师 | release-1.2 | 待计划 |
| TD011 | 3个未使用变量:已定义但STL中未引用 | 静态分析提示(3个未使用变量) | 死代码,可维护性 | **P3** | PLC工程师 | release-1.2 | 待计划 |
| TD012 | FC13注射泵步数精度未校验:下发VD\_Dose\_Steps后无位置反馈(VW222)核对 | FMEA 5.1项4(P1,RPN=192);边界条件EXT-04 | 失步导致加药量不准,浓度偏差 | **P1** | PLC工程师 | v1.0 | 待修复 |
| ~~TD013~~ | ~~FC12 S2/S3运行中停转未持续监测:仅启动时T44检测,运行中无I0.3/I0.4持续监测~~ | ~~FMEA 5.1项8(P1,RPN=168);泵1运行中停转不可探测~~ | ~~潜水泵运行中停转不报警,搅拌失效~~ | **~~P1~~** | ~~PLC工程师~~ | ~~v1.0~~ | **已移除**（潜水泵1/2流量开关取消，I0.3/I0.4不再使用） |
| TD014 | 限位信号互斥校验未实现:无开到位/关到位互斥校验(I8.0\&I8.1不应同时ON) | FMEA 5.1项7(P1,RPN=168);限位信号粘滞 | 限位粘连误判到位,内漏风险 | **P1** | PLC工程师 | v1.0 | 待修复 |
| TD025 | FC15借用VD384当临时变量覆盖手动注射泵参数:FC15 L77-79用`MOVR VD382,VD384`/`*R 10.0,VD384`/`ROUND VD384,AC0`计算T61 PT,但VD384是HMI参数ManualDose_Target | 2026-09-11现场联机调试:手动注射泵总加药量设5000后,进S4状态被覆盖为VD382×10≈18000 | 手动注射泵参数保存后丢失,FC21启动时取错误剩余药量 | **P0** | PLC工程师 | v1.0 | 待修复(AQEX-49) |
| TD026 | VB380~VB383(MBUS_MSG Error)与VD380/382/384(V区变量)物理重叠:FC4 4个CALL MBUS_MSG Error输出到VB380~383,同时VD382(VB382~VB385)是HMI参数S4WaitTimeout,VD384是ManualDose_Target,VB380~381还被VW380(FC11/15/17定时器暂存)覆盖 | 2026-09-11现场联机调试:VD382写入1800后被MBUS_MSG Error=0改写VB382,浮点指数位清零→值变4.23E-37;VD384被FC15 Bug A叠加破坏 | HMI参数无法保存,MBUS_MSG每轮询一次就污染一次(200~500ms周期),IEEE-754浮点指数位被Error=0清零是确定性破坏 | **P0** | PLC工程师 | v1.0 | 待修复(AQEX-49) |
| TD027 | MCGS CSV中VD316通道属性误标为"只读":`只读VDF316`导致MCGS不下发写命令,目标进水量始终为默认值10 | 2026-09-11现场联机调试:U1_VD_TargetInletVolume HMI输入框改值无效 | VD316无法由HMI调整,固定为FC0默认值10.0L | **P2** | HMI工程师 | v1.0 | **✅已修复(AQEX-49, 2026-09-11)** | CSV改为读写,MCGS重导 |

***

## 四、测试债务(5项)

| 编号 | 债务描述 | 来源依据 | 影响 | 优先级 | 责任人 | 目标版本 | 状态  |
| ----- | --- | --- | --- | --- | ----- | --- | --- |
| TD015 | 性能基准测试未执行:扫描周期与8连接并发负载未实测 | 性能基准测试方案v1.0已备但硬件未到货 | 实际运行可能扫描超时/HMI响应延迟,SAT无实测数据 | **P1** | 调试工程师 | 硬件到货后 | 待测试 |
| TD016 | Modbus通讯专项测试未执行:注射泵+流量计485通讯超时/Error场景测试 | 依赖TD003(FC4超时)实现;边界条件COM-01\~COM-05 | 通讯中断场景未验证,S3加药安全保护未确认 | **P2** | 调试工程师 | v1.0修复后 | 待测试 |
| TD017 | NC球阀动作报警测试用例未设计:V300.2/V300.3置位/复位/HMI显示测试 | 依赖TD001修复;SAT\_FAT用例未覆盖 | NC球阀报警功能验收无依据 | **P2** | 调试工程师 | v1.0修复后 | 待设计 |
| TD018 | 跨天断电恢复测试用例未设计:PWR-08/CLK-03跨天RTC场景 | 依赖TD005修复;边界条件PWR-08/CLK-03 | 跨天断电恢复验收无依据 | **P2** | 调试工程师 | v1.0修复后 | 待设计 |
| TD019 | 8台PLC版本一致性测试未设计:VW0版本号比对/HMI显示8台一致性 | 版本管理规范5.2节方法一/HMI集中读取比对 | 8台版本不一致检测无验收依据 | **P3** | 调试工程师 | release-1.1 | 待设计 |

***

## 五、文档债务(5项)

| 编号 | 债务描述 | 来源依据 | 影响 | 优先级 | 责任人 | 目标版本 | 状态  |
| ----- | --- | --- | --- | --- | --- | --- | --- |
| TD020 | PLC设计文档v9.3与网络架构IP不一致:设计文档v12.1节HMI示例IP=.10,网络架构规划v1.0为.100 | 网络架构v1.0 1.2节差异说明 | 现场实施混淆,IP配置错误导致通讯失败  | **P2** | PLC工程师 | 设计文档v9.4 | 待同步 |
| TD021 | FC19第82行注释残留"V0.5":代码已用V0.7但注释未更新 | 完整性校验报告P1【警告】;Story 1.6编址修复残留 | 注释与代码不一致,误导维护 | **P2** | PLC工程师 | v1.0 | 待修复 |
| TD022 | CHANGELOG.md未建立:版本管理规范第7章要求Keep a Changelog风格 | PLC程序版本管理规范v1.0第7章 | 版本变更无结构化记录,变更追溯困难 | **P1** | 配置管理 | v1.0发布 | 待建立 |
| TD023 | Git LFS配置未完成:版本管理规范第8章要求跟踪.mwp/.sdfp/.pdf/.docx/.xlsx | PLC程序版本管理规范v1.0第8章;.gitattributes未配置 | 大体积二进制文件污染仓库,Git操作变慢 | **P1** | 配置管理 | v1.0发布 | 待配置 |
| TD024 | 故障代码字典STL实现状态待更新:V303.4标注"部分实现",V300.2/V300.3/V303.6标注"预留接口"待修复后更新 | 故障代码字典v1.0;依赖TD001/TD002/TD003修复 | 字典与代码实现状态不同步 | **P3** | PLC工程师 | v1.0修复后  | 待更新 |

***

## 六、设计债务(4项)

| 编号 | 债务描述 | 来源依据 | 影响 | 优先级 | 责任人 | 目标版本 | 状态  |
| ----- | --- | --- | --- | --- | --- | --- | --- |
| TD025 | NC球阀无到位反馈DI:NC球阀得电拒动作无反馈,故障不可探测 | FMEA 5.1项11/12(P2,RPN=162);备品备件#18 | NC球阀拒动作时第二道漫溢保护失效 | **P2** | PLC工程师+硬件 | release-1.2 | 待评估 |
| TD026 | 漫溢保护液位计无延时确认:FC30/FC31 NETWORK1 I0.5/I0.7直接触发无TON滤波 | 边界条件SEN-01/SEN-02中风险;FMEA P2中#14 | 浪涌/浮球弹跳误触漫溢报警,误关阀 | **P1** | PLC工程师 | v1.0 | 待修复 |
| TD027 | 手动控制FC未实现:V2.4\~V3.3手动命令位无FC响应代码 | 边界条件OPR-03未覆盖;变量表4.4手动命令 | 手动操作无法执行,运行中切手动无效 | **P1** | PLC工程师 | release-1.1 | 待设计 |
| **TD029** | **【⚠v2.0 Python扫描新发现, 2026-09-12】** VD378(累计加药量Dosed_Volume_Total, FC13写)与MBUS_CTRL Error(VB378)物理重叠:MBUS_CTRL Error写VB378,同时VD378(VB378~VB381)是累计加药量REAL(4字节) | VD378=VB378~VB381的前2字节被MBUS Error每周期覆盖 | 累计加药量永远不准,HMI显示污染值 | **P0** | PLC工程师 | v1.0 | **✅已修复(AQEX-49, 2026-09-12)** | VD378迁到VD440 |
| **TD030** | **【⚠v2.0 新增, 2026-09-12】** VD10/VD14浓度参数与DT10 RTC时间戳(VB10~VB17)物理重叠:FC15写RTC覆盖浓度 | 每次S4完成时DT10写VB10~17,覆盖VD10/VD14,虽然冷启动重新初始化但运行中可能丢失 | 浓度计算FC13可能使用被RTC污染的VD10/VD14值 | **P0** | PLC工程师 | v1.0 | **✅已修复(AQEX-49, 2026-09-12)** | 浓度参数删除,DT10原地独占 |
| TD028 | 参数范围校验未实现:STL无VD20>0/VD48>0/VD28>VD32等关键参数范围校验 | 边界条件OPR-04高风险 | 参数越界设定导致T50 PT=0立即超时或换水周期=0 | **P2** | PLC工程师 | release-1.1 | 待设计 |

***

## 七、基础设施债务(2项)

| 编号 | 债务描述 | 来源依据 | 影响 | 优先级 | 责任人 | 目标版本 | 状态 |
| --- | --- | --- | --- | --- | --- | --- | --- |
| TD029  | 8台PLC版本号VW0写入未实现:版本管理规范1.3节要求FC0 NETWORK0首次扫描写入VW0(BCD编码) | PLC程序版本管理规范v1.0第1.3节;FC0未实现VW0赋值 | 8台PLC版本号无法显示,HMI无法比对一致性 | **P1** | PLC工程师 | v1.0 | 待实现 |
| TD030  | 8台PLC同步下装工具/脚本与备份归档目录未建立:版本管理规范5.2节方法二version\_check.sh、achieve/目录 | PLC程序版本管理规范v1.0第5.2节/第8章 | 8台同步下装无工具支持,版本巡检无脚本,旧版.mwp无归档 | **P3** | 配置管理 | release-1.1 | 待建立 |
| TD031  | FC3\_NETWORK4报警确认处理缺V0.3上升沿门控:L248-251写了`LD V0.3; EU; S V1.3; R V0.3`,但后面L254-333的`LD Vxxx; R Vxxx, 1`复位逻辑**不在EU保护范围内**,每周期无条件执行 | 2026-09-04联机调试发现:PLC冷启动FC0置V303.5(RTC丢失)=1后,FC3\_NETWORK4同一周期立即R V303.5=0;FC21/FC13任何报警位置位后同一周期被清;VW2=99但VW6=0,报警灯/蜂鸣器不工作,状态机卡死 | **P0** | PLC工程师 | v1.3.0 | ✅已修复(2026-09-04):NETWORK4开头加`JMP 40`门控+`LBL 40`跳转目标 | <br /> |
| <br /> | TD032 | FC4\_NETWORK6任务4 MBUS\_MSG缺M11.6门控:EN/First条件为`VW290=4`常通,任务4进入后每个扫描周期First=1,MBUS\_MSG反复触发 | 2026-09-04联机调试发现:从站收到乱序命令后M10.3不置位,VW290永远卡4,FC21/FC13永远等不到M12.0;手动注射泵VW390卡3(回零中),自动S3加药必触发S\_ERROR(VW6=64,10秒超时) | **P0** | PLC工程师 | v1.3.0 | ✅已修复(2026-09-04):EN/First各加`A M11.6 + AN M11.7`条件 |

***

## 八、高优先级债务清单(P0+P1,共14项)

> 以下14项债务为P0立即或P1高优先级,必须在v1.0发布前或release-1.1前偿还。其中TD001为P0安全缺陷(含V300.2+V300.3两位,对应FMEA P0立即修复的2项),优先级最高。

### 8.1 P0立即(1项)— v1.0发布前必修

| 编号 | 债务 | 偿还方案 | 截止日期 |
| ----- | --- | --- | --- |
| TD001 | NC球阀报警位V300.2/V300.3未置位 | FC30 NETWORK1补`S V300.2,1`;FC31 NETWORK1补`S V300.3,1`;FC3 NETWORK4/5补复位逻辑 | 2026-07-25 |

> 说明:TD001为单条债务但含V300.2+V300.3两位,实质为FMEA P0立即修复的2项(项1+项2),合并登记为一条债务。偿还后FMEA RPN=384最高风险项消除。

### 8.2 P1高(13项)— v1.0发布前或release-1.1前修复

| 编号 | 债务 | 偿还方案 | 目标版本 | 截止日期 |
| --- | --- | --- | --- | --- |
| TD002 | ~~V303.6流量开关瞬时异常未实现~~ | **2026-09-08已删除**：三个流量开关各自有独立报警位，不再需要汇总抖动检测 | v1.0 | 2026-09-08 |
| TD003 | FC4 Modbus通讯超时骨架未实现 | FC4实现Done/Error/超时计数→V303.4报警转S\_ERROR | v1.0 | 2026-07-30 |
| TD004 | 3个VD编址冲突未修复 | 专用迭代参数区步长迁移(VD10\~VD140按4字节对齐) | release-1.1 | 2026-08-15 |
| TD005 | FC0跨日RTC计算缺陷 | FC0 NETWORK4/5增加日期差换算或跨天转S\_ERROR | v1.0 | 2026-08-05 |
| TD006 | 阀B/阀C四态诊断缺延时确认 | FC31/FC32子状态3增加2\~3s确认延时 | v1.0 | 2026-07-30 |
| TD012 | FC13注射泵步数精度未校验 | FC13读取VW222位置反馈与VD\_Dose\_Steps核对,偏差超限报警 | v1.0 | 2026-08-05 |
| ~~TD013~~ | ~~FC12 S2/S3运行中停转未持续监测~~ | ~~S2/S3期间持续监测I0.3/I0.4,断流→V303.2~~ | ~~v1.0~~ | **已移除**（潜水泵1/2流量开关取消） |
| TD014 | 限位信号互斥校验未实现 | FC30/31/32增加开/关到位互斥校验,同时ON→报警 | v1.0 | 2026-07-30 |
| TD015 | 性能基准测试未执行 | 硬件到货后按性能基准测试方案v1.0执行 | 硬件到货后 | 2026-09-15 |
| TD022 | CHANGELOG.md未建立 | 建立CHANGELOG.md(Keep a Changelog风格),v1.0发布填充 | v1.0发布 | 2026-08-01 |
| TD023 | Git LFS配置未完成 | 配置.gitattributes跟踪.mwp/.sdfp/.pdf/.docx/.xlsx | v1.0发布 | 2026-08-01 |
| TD026 | 漫溢保护液位计无延时确认 | FC30/FC31 NETWORK1增加2\~3s TON确认延时 | v1.0 | 2026-08-05 |
| TD027 | 手动控制FC未实现 | 新增手动控制FC,实现V2.4\~V3.3响应+安全联锁 | release-1.1 | 2026-08-30 |
| TD029 | 8台PLC版本号VW0写入未实现 | FC0 NETWORK0首次扫描MOVW版本号到VW0(BCD编码) | v1.0 | 2026-08-01 |

***

## 九、债务偿还路线图

### 9.1 v1.0发布前必修(2026-07-18\~2026-08-05)

| 周次 | 偿还债务 | 说明 |
| --- | --- | --- |
| W30(7/19\~7/25) | TD001(P0) | NC球阀报警位修复,FMEA P0消除 |
| W31(7/26\~8/01) | TD002/TD003/TD006/TD013/TD014/TD022/TD023/TD029 | FMEA P1批量修复+版本管理基础设施建立 |
| W32(8/02\~8/05) | TD005/TD012/TD026 | FC0跨日RTC+步数精度+液位计延时 |
| W32末 | v1.0发布 | 发布检查清单14项(版本管理规范4.3节)  |

### 9.2 release-1.1迭代(2026-08-06\~2026-08-30)

| 周次 | 偿还债务 | 说明 |
| --- | --- | --- |
| W33~~W34(8/06~~8/15) | TD004/TD007/TD008 | VD编址冲突修复+跨FC写入冲突评审  |
| W34~~W35(8/13~~8/22) | TD027/TD028 | 手动控制FC+参数范围校验 |
| W35~~W36(8/20~~8/30) | TD015/TD019/TD030 | 性能测试+版本一致性测试+同步下装工具 |

### 9.3 release-1.2及长期(2026-09+)

| 债务 | 说明 |
| --- | --- |
| TD009/TD010/TD011 | 静态分析提示项分批整改(未定义变量/对齐/未使用) |
| TD016/TD017/TD018 | 测试用例设计(Modbus通讯/NC球阀报警/跨天恢复) |
| TD024/TD020 | 文档同步(故障代码字典/设计文档IP) |
| TD025 | NC球阀到位反馈DI硬件改动(需评估DI点数余量) |

***

## 十、债务度量与监控

### 10.1 债务度量指标

| 指标 | 当前值 | 目标值 | 度量频率 |
| --- | --- | --- | ---- |
| 债务总数 | 29项 | v1.0发布前≤16项 | 每周 |
| P0债务数 | 1项(TD001,含V300.2/V300.3两位) | 0项 | 每周 |
| P1债务数 | 13项 | v1.0发布前≤3项 | 每周 |
| 静态分析严重项  | 3项 | 0项(release-1.1) | 每次提交 |
| 静态分析警告项  | 59项 | ≤20项(release-1.1) | 每次提交 |
| FMEA未覆盖率 | 32% | <20%(v1.0后) | 每迭代  |

### 10.2 债务新增控制

- **新增债务审批**: 任何新增技术债务必须登记本清单,并经项目负责人确认;P0/P1债务新增触发变更单AQEX-CHG-B/O

- **债务偿还验证**: 偿还债务后必须执行静态分析+完整性校验回归,确认债务消除后方可标记"已偿还"

- **债务利息预警**: P0债务超1周未偿还、P1债务超2周未偿还,自动升级预警至项目负责人

### 10.3 债务与变更管理关联

| 债务偿还类型 | 变更等级 | 变更单类型 | 审批人 |
| --- | ---- | --- | --- |
| TD001(NC球阀报警,安全功能) | L4重大 | AQEX-CHG-B | 项目负责人+公司技术负责人 |
| TD004(VD编址迁移,多FC+编址) | L3重要 | AQEX-CHG-O | L3管理员 |
| TD027(手动控制FC,新增功能) | L3重要 | AQEX-CHG-R | 项目负责人 |
| TD022/TD023(CHANGELOG/Git LFS) | L1轻微 | AQEX-CHG-D | 文档负责人 |
| TD029(VW0版本号,FC0修改) | L2一般 | AQEX-CHG-O | L2维护 |

***

## 十一、债务清单维护规则

| 项 | 规则 |
| ---- | --- |
| 更新频率 | 每周至少1次(每周五);债务偿还/新增即时更新 |
| 版本号  | vX.Y,X=结构性重构,Y=债务增减/状态变更 |
| 债务编号 | TD001\~TD999顺序编号,不复用;已偿还债务保留编号标注"已偿还" |
| 来源追溯 | 每项债务必须引用具体报告问题编号(静态分析#/校验P#/FMEA项/边界条件XXX/版本管理规范章节) |
| 关联文档 | PLC代码静态分析报告v1.0、PLC代码完整性校验报告v1.0、FMEA失效模式分析v1.0、边界条件与异常场景清单v1.0、PLC程序版本管理规范v1.0 |
| 归档 | 历史版本存于`docs/achieve/debt/技术债务清单_vX.Y_<date>.md` |

***

**文档版本**: v1.0
**编制日期**: 2026-07-18
**下次更新**: 2026-07-25(每周五债务周报)
**审批人**: 项目负责人
