Yustnust/AQUA-EXPO/docs/commissioning/断电保持配置清单_v1.0.md

# 药液配置加注控制系统 — 断电保持配置清单 v1.0

**用途**: 现场调试工程师在STEP 7-Micro/WIN SMART中配置断电保持区时的"一页清单",可直接打印对照勾选
**适用范围**: 8套缸单元通用(每台PLC配置完全相同)
**配套文档**: STEP7项目配置与Modbus整定SOP_v1.0、HMI-PLC变量地址表_v1.0
**配置入口**: STEP7 SMART → 项目树 → CPU ST20 → 系统块 → 断电保持

---

## 一、配置前确认

| # | 确认项 | 标准 | 结果 |
|---|---|---|---|
| 1 | PLC型号 | CPU ST20 (6ES7-288-1ST20-0AA0) | □ |
| 2 | STEP7版本 | V2.5 或更高 | □ |
| 3 | 项目已创建 | AQUA_EXPO_Unit_X (X=1~8) | □ |
| 4 | 符号表已导入 | STEP7符号表_8套通用版_v1.0.csv | □ |
| 5 | FC/OB代码已粘贴 | 21个块全部就位 | □ |
| 6 | 编译无错误 | 0 Error, 0 Warning | □ |

**未达成以上6项前,不要继续配置断电保持区,否则后续修改会导致配置丢失。**

---

## 二、V区断电保持范围配置(必配,7段共188字节)

打开方式: 系统块 → 断电保持 → 在"范围"列表中逐条添加

### 2.1 必配范围(建议**2段连续**覆盖,比7段更简洁可靠)

> **v1.1 更新 2026-09-13**: VD_Vol_Target 原地址 VD370(VB370~VB373) 迁移至 VD584(VB584~VB587),
> 断电保持区建议改为 **VB1~VB600 连续覆盖 600 字节**,比之前 7 段配置更简单可靠,
> 一次配完工艺参数、阀门诊断、报警字、用户默认存储区、FC21调试计数器、VD584 全在范围内。

**最简方案（推荐）**: 配 2 段，全部覆盖 600 字节：

| 序 | 起始地址 | 元素数 | 用途 | 已配置 |
|---|---|---|---|---|
| 1 | **VB1** | **600** | **V区全保持 VB1~VB600(含工艺参数/阀门诊断/报警字/用户默认/FC21计数器/VD584)** | □ |
| 2 | M0.0 | 1 | M区位保持（可选） | □ |

**详细范围参考**（VB1~VB600 连续覆盖的各区）:

| 区段 | 字节数 | 内容 |
|---|---|---|
| VB1~VB9 | 9 | 状态位 + M_InitDone(V304.0) |
| VB10~VB17 | 8 | DT10 下缸满时间戳（独占） |
| VB18~VB199 | 182 | 实验参数 + 流量/浓度运算 + 状态机目标 |
| VB200~VB289 | 90 | Modbus 映射区 + 阀门诊断 |
| VB290~VB349 | 60 | 轮询计数器 + 报警字 + 诊断计算 |
| VB350~VB377 | 28 | AQEX-36 迁移参数（含 VD_Vol_Target 原 VD370） |
| VB378~VB413 | 36 | MBUS Error 区（⚠️ 保持不影响，FC0 冷启时清零） |
| VB414~VB499 | 86 | 迁移变量区（VW414/VD440/VD444/VD448/VD452） |
| VB456~VB539 | 84 | **用户默认存储区**（出厂硬编码 + 用户默认覆盖） |
| VB540~VB549 | 10 | 空闲 |
| VB550~VB583 | 34 | FC21 调试计数器（新位置，VB550~VB583） |
| VB584~VB587 | 4 | ⭐ **VD_Vol_Target 目标加药量（原 VD370 迁来）** |
| VB588~VB600 | 13 | 空闲 |

**合计**: V区 **600 字节** 连续保持 + M区可选 3 段，远超 ST20 上限。

**关键**: ⚠️ **不要包含 VB600~VB885（Modbus 库存储区）**——FC0 冷启动时 FILL 0 清零这个区域，断电保持会影响 FC4 重新初始化。

### 2.2 关键变量确认(以下变量必须在断电保持区内)

| 变量 | 地址 | 所在段 | 用途 | 失保持后果 |
|---|---|---|---|---|
| VW2_State | VW2 | 段1 | 状态机当前状态 | 断电后回S0,实验中断丢失 |
| VW6_AlarmCode | VW6 | 段1 | 当前最高优先级报警码 | 报警历史丢失 |
| VW8_CycleCount | VW8 | 段1 | 实验轮次计数 | 实验进度归零 |
| V0.x 命令位 | V0.0~V0.7 | 段1 | HMI下发命令 | 命令丢失重复触发风险 |
| V1.x 状态位 | V1.0~V1.7 | 段1 | PLC反馈状态 | HMI显示错误 |
| DT10 | DT10 | 段2 | 下缸变满时间戳 | 断电恢复无法重算已运行时长 |
| VW200~222 | VW200~VW222 | 段3 | Modbus寄存器映射 | 注射泵/流量计参数丢失 |
| VB300~303 | VB300~VB303 | 段5 | 32位报警字 | 报警状态丢失,可能误判无报警 |
| **VD374** | **VD374** | **段6** | **流量计降级值** | **通讯失败时无降级值可用** |
| VD350 | VD350 | 段6 | StepResolution | 注射泵分辨率丢失,加药量错误 |
| VD354 | VD354 | 段6 | CycleSetpoint | 换水周期设定丢失 |
| VD366 | VD366 | 段6 | 实验时长累加 | 实验进度归零 |
| VD584 | VD584 | 段6 | 目标抽取体积 | 加药计算基准丢失 |

---

## 三、M区位保持配置(可选,建议保持3段共24字节)

打开方式: 系统块 → 断电保持 → M区范围

### 3.1 建议保持范围(3段)

| 序 | 起始 | 结束 | 字节数 | 用途 | 已配置 |
|---|---|---|---|---|---|
| 1 | M0.0 | M0.7 | 1 | 急停锁存标志 | □ |
| 2 | M10.0 | M10.7 | 1 | 状态机首次进入脉冲标志 | □ |
| 3 | M11.0 | M11.7 | 1 | 边沿检测上一周期状态 | □ |

**注**: M区保持非必须(每次上电重新计算),但建议保持以避免抖动。

### 3.2 T/C位保持(不必配)

- 定时器T: **不保持** (每次上电重新计时,符合设计)
- 计数器C: **不保持** (VW8实验轮次用VW8保持,不用C)

---

## 四、配置验证流程(下载到PLC后必做)

### 4.1 验证前准备

| # | 准备项 | 确认 |
|---|---|---|
| 1 | 项目已编译无错误 | □ |
| 2 | PLC已下载程序(全部块) | □ |
| 3 | PLC处于RUN模式, RUN灯常亮 | □ |
| 4 | STEP7状态图已打开 | □ |
| 5 | HMI已连接(或暂用STEP7状态图代替) | □ |

### 4.2 断电保持验证步骤

| 步骤 | 操作 | 期望结果 | 实际结果 | 签字 |
|---|---|---|---|---|
| 1 | STEP7状态图写入 VW2 = 5 (S4状态) | VW2=5 | ___ | |
| 2 | STEP7状态图写入 VW6 = 99 (继电器故障) | VW6=99 | ___ | |
| 3 | STEP7状态图写入 VW8 = 7 (轮次计数) | VW8=7 | ___ | |
| 4 | STEP7状态图写入 V0.0 = 1 (启动命令) | V0.0=1 | ___ | |
| 5 | STEP7状态图写入 V1.6 = 1 (上缸满) | V1.6=1 | ___ | |
| 6 | STEP7状态图写入 VD350 = 0.2083 | VD350=0.2083 | ___ | |
| 7 | STEP7状态图写入 VD354 = 30.0 | VD354=30.0 | ___ | |
| 8 | STEP7状态图写入 VD374 = 1.5 (降级值) | VD374=1.5 | ___ | |
| 9 | STEP7状态图写入 VB300 = 0xFF (全部报警) | VB300=0xFF | ___ | |
| 10 | 等待10秒,确认所有值稳定 | 数值不变 | ___ | |
| 11 | **PLC断电** (拔电源或开关OFF) | PLC停止 | ___ | |
| 12 | 等待10秒 | — | ___ | |
| 13 | **PLC上电** | RUN灯常亮 | ___ | |
| 14 | 状态图读取 VW2 | 应=5 | ___ | |
| 15 | 状态图读取 VW6 | 应=99 | ___ | |
| 16 | 状态图读取 VW8 | 应=7 | ___ | |
| 17 | 状态图读取 V0.0 | 应=1 | ___ | |
| 18 | 状态图读取 V1.6 | 应=1 | ___ | |
| 19 | 状态图读取 VD350 | 应=0.2083 | ___ | |
| 20 | 状态图读取 VD354 | 应=30.0 | ___ | |
| 21 | 状态图读取 VD374 | 应=1.5 | ___ | |
| 22 | 状态图读取 VB300 | 应=0xFF | ___ | |

### 4.3 验证结果判定

- ✓ 全部22步数值保持一致 → **断电保持配置正确,可进入下一步调试**
- ✗ 任一步数值变为0 → **断电保持范围未覆盖该变量,需重新检查系统块配置**

---

## 五、常见配置错误与排查

### 5.1 错误1: 漏配段6 (VB350~VB377)

**现象**: 断电后 VD350/VD354/VD366/VD584/VD374 全部归零
**原因**: AQEX-36迁移的6个VD参数未纳入保持范围
**修复**: 系统块→断电保持→添加 VB350~VB377 范围→重新下载项目→重做4.2验证

### 5.2 错误2: 漏配段5 (VB300~VB349)

**现象**: 断电后报警字VB300~VB303清零,VW6报警码可能丢失
**原因**: 报警字区域未覆盖
**修复**: 添加 VB300~VB349 范围(含VD308~VD344诊断数据迁移区)

### 5.3 错误3: 段范围重叠或断点

**现象**: 配置后某些变量保持,某些丢失
**原因**: 范围设置错误,如VB0~VB19 + VB200~VB223 中间VB20~VB199未配(此处属正常,但需确认VB230~VB289和VB300~VB349也无遗漏)
**排查**: 打印本清单2.1节,逐段核对系统块中断电保持范围列表

### 5.4 错误4: 配置后未下载到PLC

**现象**: STEP7中配置正确,但断电后变量仍丢失
**原因**: 修改系统块后未重新下载项目到PLC
**修复**: 文件→下载→选择"系统块"→下载→PLC断电重启

### 5.5 错误5: RTC时间丢失

**现象**: 断电较长时间(>7天)后,DT10时间戳异常,M_Alarm_RTC_Lost置位
**原因**: CPU ST20超级电容典型保持7天/最小6天,长时间断电会丢失RTC
**修复**: 这是设计预期行为,见plc_simulator FC0冷启动分支,通过M_Alarm_RTC_Lost提示用户重新校时

---

## 六、配置签字确认

| # | 项目 | 确认 | 签字 | 日期 |
|---|---|---|---|---|
| 1 | 7段V区断电保持范围已配置 (188字节) | □ | | |
| 2 | 3段M区位保持已配置 (3字节, 可选) | □ | | |
| 3 | 项目已下载到PLC | □ | | |
| 4 | 22步断电保持验证全部通过 | □ | | |
| 5 | 长时间断电(>7天)RTC丢失处理已了解 | □ | | |

**单元编号**: ________  **PLC IP**: 192.168.2.________  **MAC**: __________________

**调试工程师签字**: ____________  **日期**: ____________

**复核工程师签字**: ____________  **日期**: ____________

---

## 附录A: 系统块断电保持界面操作流程

```
1. 打开STEP 7-Micro/WIN SMART
2. 项目树 → 双击"系统块"
3. 系统块对话框 → 左侧导航选择"断电保持"
4. 在"断电保持范围"区域:
   a. 点击"添加范围"按钮
   b. 起始地址: 输入VB0
   c. 元素数: 10 (对应VB0~VB9)
   d. 区域: V区
   e. 点击"确定"
5. 重复步骤4,添加其余6段范围:
   - VB10 / 10 / V区
   - VB200 / 24 / V区
   - VB230 / 60 / V区
   - VB300 / 50 / V区
   - VB350 / 28 / V区
   - VB500 / 100 / V区
6. 切换到M区,添加3段:
   - M0.0 / 1 / M区
   - M10.0 / 1 / M区
   - M11.0 / 1 / M区
7. 点击"确定"保存系统块配置
8. 文件 → 下载 → 勾选"系统块" → 下载
9. PLC断电重启,执行第4章验证流程
```

## 附录B: 断电保持范围总览图

```
V区地址空间 (ST20支持10KB)
├── VB0~VB9        [保持] 命令位+状态位
├── VB10~VB19      [保持] DT10时间戳
├── VB20~VB199     [非保持] 工作变量
├── VB200~VB223    [保持] Modbus映射区
├── VB224~VB229    [非保持] 流量计扩展
├── VB230~VB289    [保持] 阀门诊断
├── VB290~VB299    [非保持] 临时变量
├── VB300~VB349    [保持] 报警字+诊断数据
├── VB350~VB377    [保持] AQEX-36迁移参数(关键!)
├── VB378~VB499    [非保持] 扩展预留
├── VB500~VB599    [保持] 报警日志
└── VB600+         [非保持] 仿真器/调试用

合计断电保持: 188字节 (V区) + 3字节 (M区) = 191字节
```
