Yustnust/AQUA-EXPO/docs/hmi_preparation/画面变量绑定清单.md

# 画面变量绑定清单

**项目**：药液配置与加注控制系统 — HMI组态前期准备
**配套文档**：HMI-PLC变量地址表 v1.3、HMI画面架构规划文档 v9.3、报警字32位解析映射表
**适用范围**：8套缸单元通用（每套PLC变量地址一致，HMI通过8个连接PLC_01~PLC_08区分单元）
**用途**：HMI组态阶段画面UI元素与PLC变量的逐项绑定清单，HMI选型确定后按本清单逐画面组态

---

## 绑定总则

1. **单元编号前缀**：所有PLC变量实际绑定形式为 `U{单元号}_{变量名}`，如1号单元状态机为 `U1_VW2_StateMachine`（绑定PLC_01连接的VW2）。本清单为通用模板，表中"绑定PLC变量"列省略单元前缀，组态时按当前选中单元自动套前缀。
2. **连接映射**：HMI工程配置8个连接 PLC_01~PLC_08（IP 192.168.2.101~108），每个变量按当前画面选中单元绑定到对应连接的同名地址。
3. **HMI内部变量**：标记"HMI内部"的元素不读写PLC，存于HMI本地（如单元使能、选中单元号、连接状态）。
4. **DI/DO读取**：I区（DI）和Q区（DO）变量HMI可通过S7协议直接读取（只读），用于状态反馈显示。
5. **二次确认**：标记"二次确认"的写入类按钮需弹窗或长按确认，高优先级报警确认需高权限。

---

## 画面1｜8套总览首页

**说明**：8个单元卡片按1~8号固定网格排列，每卡片绑定相同模板（×8套）。卡片三态显示由"单元使能（HMI内部）×通讯在线（HMI连接状态）"驱动。

### 1.1 单元卡片模板（每卡片9个元素 × 8套 = 72个元素）

| 画面编号 | 画面名称 | UI元素类型 | UI元素标签 | 绑定PLC变量 | 读写 | 显示格式 | 报警阈值 |
|---|---|---|---|---|---|---|---|
| 1 | 8套总览 | 数值显示 | 流程状态 | VW2_StateMachine | R | 文本映射(0=S0初始化,1=S1进水,2=S2预循环,3=S3加药,4=S3.5静置,5=S4转移,6=S5运行,7=S6排水,8=S7结束,99=故障) | 99=故障红 |
| 1 | 8套总览 | 状态指示灯 | 上缸状态 | STA_TankA_State (V1.6) | R | 0=空(灰)/1=满(蓝) | — |
| 1 | 8套总览 | 状态指示灯 | 下缸状态 | STA_TankB_State (V1.7) | R | 0=空(灰)/1=满(蓝) | — |
| 1 | 8套总览 | 状态指示灯 | 急停状态 | I1.1 (DI_EStop) | R | ON=正常(绿)/OFF=急停触发(红) | OFF=红 |
| 1 | 8套总览 | 状态指示灯 | 报警状态 | VW6_AlarmCode | R | 0=无(绿)/99红闪/10~14红/20橙/21,30~66黄 | ≠0即报警 |
| 1 | 8套总览 | 数值显示 | 实验轮次 | VW8_RoundCount | R | 整数 | — |
| 1 | 8套总览 | 数值显示 | 实验时长 | VD_ExperimentDuration_Accum (VD366) | R | xxx.x min | — |
| 1 | 8套总览 | 状态指示灯 | 通讯状态 | HMI连接状态(内部) | R | 在线(绿)/离线(黄,通讯中断)/未使能(灰) | 离线=黄 |
| 1 | 8套总览 | 按钮 | 进入单元详情(导航) | HMI内部(选中单元号) | — | 点击跳转画面2 | — |

### 1.2 全局元素（3个）

| 画面编号 | 画面名称 | UI元素类型 | UI元素标签 | 绑定PLC变量 | 读写 | 显示格式 | 报警阈值 |
|---|---|---|---|---|---|---|---|
| 1 | 8套总览 | 文本显示 | 全局报警横幅 | 各使能单元VW6最高值 | R | "X号单元:报警文本"（按报警映射表文本） | 有报警即显示 |
| 1 | 8套总览 | 按钮 | 全局消音 | V0.4 CMD_Mute（所有使能单元） | RW | 二次确认，循环写各使能单元V0.4 | — |
| 公共 | 标题栏 | 状态指示灯 | 系统运行状态 | VB_SystemStatus (VB305) | R | 0=良好(绿)/1=故障(黄闪)/2=急停(红) | ≠0提示 |

> **注**：标题栏系统运行状态指示灯为公共模板，画面2~8随当前选中单元绑定 `U{X}_VB_SystemStatus`；画面1无选中单元概念，可绑定当前操作单元或所有使能单元中最高等级状态（取最大值）。

**画面1元素合计：75个**

---

## 画面2｜单元详情页（1~8号共用模板）

**说明**：从画面1点击卡片进入，顶部单元选择器切换1~8号。完整显示当前单元状态。

| 画面编号 | 画面名称 | UI元素类型 | UI元素标签 | 绑定PLC变量 | 读写 | 显示格式 | 报警阈值 |
|---|---|---|---|---|---|---|---|
| 2 | 单元详情 | 数值显示 | 当前单元号 | HMI内部(选中) | — | "当前操作：X号单元" | — |
| 2 | 单元详情 | 数值显示 | 状态机状态 | VW2_StateMachine | R | 文本映射(同画面1) | 99=故障 |
| 2 | 单元详情 | 状态指示灯 | 上缸状态 | STA_TankA_State (V1.6) | R | 空/满 | — |
| 2 | 单元详情 | 状态指示灯 | 下缸状态 | STA_TankB_State (V1.7) | R | 空/满 | — |
| 2 | 单元详情 | 数值显示 | 实验轮次 | VW8_RoundCount | R | 整数 | — |
| 2 | 单元详情 | 数值显示 | 注射泵状态码 | VW4_PumpStatus | R | 文本映射(0空闲/1运行/2抽液/3排液/其他错误) | 错误码=黄 |
| 2 | 单元详情 | 数值显示 | 当前进水量 | VD_Current_InletVolume (VD90) | R | xxx.xx L | — |
| 2 | 单元详情 | 数值显示 | 瞬时流速 | VD_FlowRate_Instant (VD94) | R | xx.xx L/min | — |
| 2 | 单元详情 | 数值显示 | 实验时长累加 | VD_ExperimentDuration_Accum (VD366) | R | xxx.x min | — |
| 2 | 单元详情 | 数值显示 | 目标抽取母液体积 | VD_Vol_Target (VD584) | R | xxx.x µL | — |
| 2 | 单元详情 | 数值显示 | 加药目标步数 | VD_Dose_Steps (VD102) | R | 整数 步 | — |
| 2 | 单元详情 | 数值显示 | S1实测时长 | VD_S1_Actual (VD70) | R | xx.x s | — |
| 2 | 单元详情 | 数值显示 | S4实测时长 | VD_S4_Actual (VD74) | R | xx.x s | — |
| 2 | 单元详情 | 数值显示 | S6实测时长 | VD_S6_Actual (VD78) | R | xx.x s | — |
| 2 | 单元详情 | 数值显示 | 本轮S2目标 | VD_S2_Target (VD120) | R | xx.x s | — |
| 2 | 单元详情 | 数值显示 | 本轮S3.5目标 | VD_RestTime_Target (VD124) | R | xx.x s | — |
| 2 | 单元详情 | 数值显示 | 本轮允许空等 | VD_CycleExtend_Target (VD128) | R | x.x min | — |
| 2 | 单元详情 | 状态指示灯 | 阀A开到位 | I8.0 (DI_ValveA_Open) | R | ON=开到位(绿) | — |
| 2 | 单元详情 | 状态指示灯 | 阀A关到位 | I8.1 (DI_ValveA_Close) | R | ON=关到位(绿) | — |
| 2 | 单元详情 | 状态指示灯 | 阀B开到位 | I8.2 (DI_ValveB_Open) | R | ON=开到位(绿) | — |
| 2 | 单元详情 | 状态指示灯 | 阀B关到位 | I8.3 (DI_ValveB_Close) | R | ON=关到位(绿) | — |
| 2 | 单元详情 | 状态指示灯 | 阀C开到位 | I8.4 (DI_ValveC_Open) | R | ON=开到位(绿) | — |
| 2 | 单元详情 | 状态指示灯 | 阀C关到位 | I8.5 (DI_ValveC_Close) | R | ON=关到位(绿) | — |
| 2 | 单元详情 | 状态指示灯 | 流量开关A | I0.0 (DI_FlowSwitch_A) | R | ON=有流(绿)/OFF=无流 | — |
| 2 | 单元详情 | 状态指示灯 | 流量开关B | I0.1 (DI_FlowSwitch_B) | R | ON=有流/OFF=无流 | — |
| 2 | 单元详情 | 状态指示灯 | 流量开关C | I0.2 (DI_FlowSwitch_C) | R | ON=有流/OFF=无流 | — |

| 2 | 单元详情 | 状态指示灯 | 上缸液位高位 | I0.5 (DI_LevelA_High) | R | ON=高位警戒(红) | ON=红(漫溢) |
| 2 | 单元详情 | 状态指示灯 | 上缸液位低位 | I0.6 (DI_LevelA_Low) | R | ON=已排空 | — |
| 2 | 单元详情 | 状态指示灯 | 下缸液位高位 | I0.7 (DI_LevelB_High) | R | ON=高位警戒(红) | ON=红(漫溢) |
| 2 | 单元详情 | 状态指示灯 | 下缸液位低位 | I1.0 (DI_LevelB_Low) | R | ON=已排空 | — |
| 2 | 单元详情 | 状态指示灯 | 急停状态 | I1.1 (DI_EStop) | R | ON=正常/OFF=急停(红) | OFF=红 |
| 2 | 单元详情 | 状态指示灯 | 安全继电器反馈 | I1.2 (DI_SafetyRelay_FB) | R | ON=正常/OFF=故障(红闪) | OFF=红闪 |
| 2 | 单元详情 | 状态指示灯 | 报警摘要 | VW6_AlarmCode | R | 0=无/≠0有报警(按级别色) | ≠0即报警 |
| 2 | 单元详情 | 按钮 | 进入手动控制(导航) | HMI内部 | — | 跳转画面3 | — |
| 2 | 单元详情 | 按钮 | 进入参数设置(导航) | HMI内部 | — | 跳转画面4 | — |
| 2 | 单元详情 | 按钮 | 进入报警详情(导航) | HMI内部 | — | 跳转画面5 | — |
| 2 | 单元详情 | 按钮 | 进入趋势曲线(导航) | HMI内部 | — | 跳转画面6 | — |

**画面2元素合计：36个**

---

## 画面3｜单元手动控制页

**说明**：调试与异常处理用。须先选单元，顶部固定显示"当前手动操作单元：X号"。仅手动模式、无急停、无禁止手动的高优先级报警时按钮可用。

| 画面编号 | 画面名称 | UI元素类型 | UI元素标签 | 绑定PLC变量 | 读写 | 显示格式 | 报警阈值 |
|---|---|---|---|---|---|---|---|
| 3 | 手动控制 | 数值显示 | 当前手动操作单元号 | HMI内部(选中) | — | "当前手动操作单元：X号" | — |
| 3 | 手动控制 | 按钮 | 启动实验 | V0.0 CMD_Start | RW | 二次确认，上升沿触发 | — |
| 3 | 手动控制 | 按钮 | 停止实验 | V0.2 CMD_Stop | RW | 二次确认 | — |
| 3 | 手动控制 | 按钮 | 报警确认 | V0.3 CMD_AckAlarm | RW | 二次确认 | — |
| 3 | 手动控制 | 按钮 | 消音 | V0.4 CMD_Mute | RW | 下降沿触发 | — |
| 3 | 手动控制 | 状态指示灯 | 启动握手 | STA_StartAck (V1.0) | R | ON=已接收 | — |
| 3 | 手动控制 | 状态指示灯 | 停止握手 | STA_StopAck (V1.2) | R | ON=已接收 | — |
| 3 | 手动控制 | 状态指示灯 | 报警确认握手 | STA_AlarmAckDone (V1.3) | R | ON=已执行 | — |
| 3 | 手动控制 | 状态指示灯 | 消音握手 | STA_MuteDone (V1.4) | R | ON=已执行 | — |
| 3 | 手动控制 | 状态指示灯 | 上缸状态 | STA_TankA_State (V1.6) | R | 空/满 | — |
| 3 | 手动控制 | 状态指示灯 | 下缸状态 | STA_TankB_State (V1.7) | R | 空/满 | — |
| 3 | 手动控制 | 状态指示灯 | 急停状态 | I1.1 (DI_EStop) | R | ON=正常/OFF=急停 | OFF=红 |
| 3 | 手动控制 | 状态指示灯 | 安全继电器反馈 | I1.2 (DI_SafetyRelay_FB) | R | ON=正常/OFF=故障 | OFF=红闪 |
| 3 | 手动控制 | 状态指示灯 | 报警状态 | VW6_AlarmCode | R | 0=无/≠0有报警 | ≠0即报警 |
| 3 | 手动控制 | 状态指示灯 | 阀A开到位 | I8.0 | R | ON=开到位 | — |
| 3 | 手动控制 | 状态指示灯 | 阀A关到位 | I8.1 | R | ON=关到位 | — |
| 3 | 手动控制 | 按钮 | 阀A手动开 | **V306.0** CMD_Manual_ValveA_Open | RW | 二次确认，仅S0态 | — |
| 3 | 手动控制 | 按钮 | 阀A手动关 | **V306.1** CMD_Manual_ValveA_Close | RW | 二次确认，仅S0态 | — |
| 3 | 手动控制 | 状态指示灯 | 阀B开到位 | I8.2 | R | ON=开到位 | — |
| 3 | 手动控制 | 状态指示灯 | 阀B关到位 | I8.3 | R | ON=关到位 | — |
| 3 | 手动控制 | 按钮 | 阀B手动开 | **V306.2** CMD_Manual_ValveB_Open | RW | 二次确认，需上缸满下缸空(调试模式V309.0=1可旁路) | — |
| 3 | 手动控制 | 按钮 | 阀B手动关 | **V306.3** CMD_Manual_ValveB_Close | RW | 二次确认 | — |
| 3 | 手动控制 | 状态指示灯 | 阀C开到位 | I8.4 | R | ON=开到位 | — |
| 3 | 手动控制 | 状态指示灯 | 阀C关到位 | I8.5 | R | ON=关到位 | — |
| 3 | 手动控制 | 按钮 | 阀C手动开 | **V306.4** CMD_Manual_ValveC_Open | RW | 二次确认，需下缸满(调试模式V309.0=1可旁路) | — |
| 3 | 手动控制 | 按钮 | 阀C手动关 | **V306.5** CMD_Manual_ValveC_Close | RW | 二次确认 | — |
| 3 | 手动控制 | 状态指示灯 | 流量开关A | I0.0 | R | ON=有流 | — |
| 3 | 手动控制 | 状态指示灯 | 流量开关B | I0.1 | R | ON=有流 | — |
| 3 | 手动控制 | 状态指示灯 | 流量开关C | I0.2 | R | ON=有流 | — |
| 3 | 手动控制 | 按钮 | 泵1手动启动 | **V306.6** CMD_Manual_Pump1_On | RW | 二次确认，仅S0态 | — |
| 3 | 手动控制 | 按钮 | 泵1手动停止 | **V306.7** CMD_Manual_Pump1_Off | RW | 二次确认 | — |
| 3 | 手动控制 | 按钮 | 泵2手动启动 | **V307.0** CMD_Manual_Pump2_On | RW | 二次确认，仅S0态 | — |
| 3 | 手动控制 | 按钮 | 泵2手动停止 | **V307.1** CMD_Manual_Pump2_Off | RW | 二次确认 | — |
| 3 | 手动控制 | 状态指示灯 | 上缸NC球阀 | Q0.5 (DO_NCValve_Top) | R | ON=已打开(允许进水) | — |
| 3 | 手动控制 | 状态指示灯 | 下缸NC球阀 | Q0.6 (DO_NCValve_Bottom) | R | ON=已打开(允许下缸液路) | — |
| 3 | 手动控制 | 数值输入 | 手动注射泵总加药量 | VD_ManualDose_Target (VD384) | RW | 单位 µL，循环模式下目标总量 | — |
| 3 | 手动控制 | 单选/开关 | 手动注射泵模式 | VW_ManualDose_Mode (VW388) | RW | 0=单次，1=循环 | — |
| 3 | 手动控制 | 数值显示 | 手动注射泵状态 | VW_ManualDose_State (VW390) | R | 0空闲/1抽液中/2排液中/3回零中/4完成/99错误 | — |
| 3 | 手动控制 | 按钮 | 手动注射泵启动 | **V307.2** CMD_Manual_SyringePump_Start | RW | 二次确认，脉冲触发 | — |
| 3 | 手动控制 | 按钮 | 手动注射泵停止/回零 | **V307.3** CMD_Manual_SyringePump_Stop | RW | 二次确认，脉冲触发 | — |
| 3 | 手动控制 | 数值显示 | 注射泵状态码 | VW4_PumpStatus | R | 文本映射(0就绪/1运行/2抽液/3排液/≥4错误) | 错误码=黄 |
| 3 | 手动控制 | 数值显示 | 注射泵位置反馈 | VW222 MB_Pump_Position | R | 整数 半步 | — |
| 3 | 手动控制 | 按钮 | 注射泵复位(高级) | VW202 MB_Pump_Reset | RW | 二次确认，写1复位；FC21已覆盖常用场景，仅维护级可见 | — |
| 3 | 手动控制 | 按钮 | 注射泵手动抽液(高级) | VW204 MB_Pump_Aspirate | RW | 二次确认+步数输入；FC21已覆盖常用场景，仅维护级可见 | — |
| 3 | 手动控制 | 按钮 | 注射泵手动排液(高级) | VW206 MB_Pump_Dispense | RW | 二次确认+步数输入；FC21已覆盖常用场景，仅维护级可见 | — |
| 3 | 手动控制 | 按钮 | 声音测试 | Q0.7（待PLC支持测试位） | — | 待PLC补充测试逻辑 | — |
| 3 | 手动控制 | 按钮 | 灯光测试 | Q8.0（待PLC支持测试位） | — | 待PLC补充测试逻辑 | — |
| 3 | 手动控制 | 静态文本 | 手动操作安全提示 | 无绑定 | — | "手动操作前请确认液路/液位/现场安全，避免空转、溢流或误动作" | — |
| 3 | 手动控制 | **切换按钮** | **调试模式开关** | **U1_V309_0_DebugMode (V309.0)** | **RW** | **二次确认，绿色=生产/橙色=调试，仅调试使用，生产前必须关闭** | **画面3右上角** |
| 3 | 手动控制 | **状态条幅** | **模式状态指示** | **U1_V309_0_DebugMode** | **R** | **绿条"生产模式"或橙条"⚠调试模式"** | **画面3顶部** |

> **v1.4更新（2026-09-03）**：手动命令位从V2.4~V3.7全面迁移至V306.0~V307.3（避开VW2状态机物理重叠），新增V309.0调试模式开关（用于空缸联机调试时旁路阀B/阀C液位联锁）。NC球阀联动逻辑保持不变：开阀A时Q0.5自动打开，开阀B/C时Q0.6自动打开。手动输出仍由M13.0~M13.4锁存（v1.2之前为M12.0~M12.4）。

**画面3元素合计：43个**

---

## 画面4｜参数设置页

**说明**：顶部选单元，显示该单元参数，修改后"保存到当前单元"。支持"复制到其他单元"（二次确认）。按浓度组/时间周期组/超时组/泵速度组分块。

| 画面编号 | 画面名称 | UI元素类型 | UI元素标签 | 绑定PLC变量 | 读写 | 显示格式 | 报警阈值 |
|---|---|---|---|---|---|---|---|
| 4 | 参数设置 | 数值显示 | 当前参数对象单元 | HMI内部(选中) | — | "当前参数对象：X号单元" | — |
| 4 | 参数设置 | 输入框 | 目标浓度 | VD_C_Set (VD10) | RW | x.x % | — |
| 4 | 参数设置 | 输入框 | 母液浓度 | VD_C_Stock (VD14) | RW | x.x % | — |
| 4 | 参数设置 | 输入框 | 注射泵单步分辨率 | VD_StepResolution (VD350) | RW | x.xxxx µL/步 | — |
| 4 | 参数设置 | 输入框 | 换水周期设定 | VD_CycleSetpoint (VD354) | RW | x.x min | — |
| 4 | 参数设置 | 输入框 | 实验时长目标 | VD_ExperimentTarget (VD24) | RW | x.x min | — |
| 4 | 参数设置 | 输入框 | 预循环标称时长S2 | VD_PreMixTime (VD28) | RW | x.x s | — |
| 4 | 参数设置 | 输入框 | 预循环压缩下限 | VD_PreMixTime_MinSafe (VD32) | RW | x.x s | — |
| 4 | 参数设置 | 输入框 | 静止等候标称S3.5 | VD_RestTime (VD36) | RW | x.x s | — |
| 4 | 参数设置 | 输入框 | 静止等候压缩下限 | VD_RestTime_Min (VD40) | RW | x.x s | — |
| 4 | 参数设置 | 输入框 | 换水周期顺延上限 | VD_CycleExtend_Max (VD44) | RW | x.x min | — |
| 4 | 参数设置 | 输入框 | 阀A动作超时 | VD_Timeout_ValveA (VD358) | RW | x.x s | — |
| 4 | 参数设置 | 输入框 | 阀B动作超时 | VD_Timeout_ValveB (VD362) | RW | x.x s | — |
| 4 | 参数设置 | 输入框 | 阀C动作超时 | VD_Timeout_ValveC (VD54) | RW | x.x s | — |
| 4 | 参数设置 | 输入框 | 预留-VD58 | VD_Timeout_Pump1 (VD58) | RW | x.x s | 原潜水泵1动作超时，水流开关取消后预留 |
| 4 | 参数设置 | 输入框 | 预留-VD62 | VD_Timeout_Pump2 (VD62) | RW | x.x s | 原潜水泵2动作超时，水流开关取消后预留 |
| 4 | 参数设置 | 输入框 | 阀A关闭延时验证 | VD_Delay_ValveA_Verify (VD66) | RW | x.x s | — |
| 4 | 参数设置 | 输入框 | 手动注射泵总加药量 | VD_ManualDose_Target (VD384) | RW | xxx.x µL | 手动模式目标总量 |
| 4 | 参数设置 | 单选/开关 | 手动注射泵模式 | VW_ManualDose_Mode (VW388) | RW | 0=单次/1=循环 | — |
| 4 | 参数设置 | 输入框 | 注射泵启动速度 | VD_PumpSpeed_Start (VD132) | RW | x.x Hz | 待确认映射 |
| 4 | 参数设置 | 输入框 | 注射泵最高速度 | VD_PumpSpeed_Max (VD136) | RW | x.x Hz | 待确认映射 |
| 4 | 参数设置 | 输入框 | 注射泵截止速度 | VD_PumpSpeed_Cutoff (VD140) | RW | x.x Hz | 待确认映射 |
| 4 | 参数设置 | 单选开关 | 报警确认模式 | M_AlarmAckMode (V200.0) | RW | 0=自动恢复/1=人工确认 | — |
| 4 | 参数设置 | 按钮 | 保存到当前单元 | HMI内部(触发写入上述RW变量) | RW | 二次确认 | — |
| 4 | 参数设置 | 按钮 | 复制到其他单元 | HMI内部 | — | 二次确认，弹窗选目标单元 | — |

**画面4元素合计：22个**

---

## 画面5｜报警与日志页

**说明**：当前报警大字显示+32位报警字指示灯阵列+确认/消音按钮+历史日志。按单元分组，支持筛选。

| 画面编号 | 画面名称 | UI元素类型 | UI元素标签 | 绑定PLC变量 | 读写 | 显示格式 | 报警阈值 |
|---|---|---|---|---|---|---|---|
| 5 | 报警日志 | 数值显示 | 当前报警码(大字) | VW6_AlarmCode | R | 整数，大字号，按级别配色 | ≠0显示 |
| 5 | 报警日志 | 文本显示 | 报警文本 | VW6映射(按报警映射表) | R | 中文短描述（如"安全继电器故障-立即检查动力回路"） | — |
| 5 | 报警日志 | 状态指示灯阵列 | 32位报警字阵列(32个指示灯) | VB300~VB303（4字节32位，脚本中用位运算解析V300.0~V303.7） | R | 按报警映射表颜色(99红闪/10~14红/20橙/21,30~66黄)，活动位点亮 | 任一位置位即报警 |(**v1.2新增** V303.2 S4 转移等待超时)
| 5 | 报警日志 | 按钮 | 报警确认 | V0.3 CMD_AckAlarm | RW | 二次确认（高优先级需高权限） | — |
| 5 | 报警日志 | 按钮 | 消音 | V0.4 CMD_Mute | RW | — | — |
| 5 | 报警日志 | 按钮 | 安全继电器故障确认 | V0.7 CMD_SafetyRelayAck | RW | 高权限+二次确认弹窗 | — |
| 5 | 报警日志 | 状态指示灯 | 报警确认握手 | STA_AlarmAckDone (V1.3) | R | ON=已执行 | — |
| 5 | 报警日志 | 状态指示灯 | 消音握手 | STA_MuteDone (V1.4) | R | ON=已执行 | — |
| 5 | 报警日志 | 状态指示灯 | 灯光输出状态 | Q8.0 (DO_Alarm_Light) | R | ON=灯光亮 | — |
| 5 | 报警日志 | 状态指示灯 | 声音输出状态 | Q0.7 (DO_Alarm_Sound) | R | ON=声音响 | — |
| 5 | 报警日志 | 报警日志列表 | 历史报警日志 | VB500~VB599（PLC日志缓冲区，6条×16字节） | R | 时间戳/单元号/报警码/动作(触发/消音/已知晓/复位) | — |

> **32位报警指示灯阵列说明**：本行计32个UI元素，由 VB300~VB303 四个字节解析 V300.0~V303.7 各位状态。具体每位颜色、文本、触发/复位条件详见《报警字32位解析映射表》。HMI组态时建议用脚本按VW6值区间统一着色，或用 `AND` 位运算逐位判断，避免逐位配置颜色表达式。

**画面5元素合计：42个**（含32位报警阵列按32个元素计）

---

## 画面6｜趋势曲线页

**说明**：选单元，选趋势类型与时间范围，X轴为轮次VW8，Y轴多曲线叠加。曲线上标注报警阈值线。

| 画面编号 | 画面名称 | UI元素类型 | UI元素标签 | 绑定PLC变量 | 读写 | 显示格式 | 报警阈值 |
|---|---|---|---|---|---|---|---|
| 6 | 趋势曲线 | 数值显示 | 当前单元号 | HMI内部(选中) | — | "趋势查看：X号单元" | — |
| 6 | 趋势曲线 | 曲线(X轴) | 实验轮次 | VW8_RoundCount | R | 整数(横轴) | — |
| 6 | 趋势曲线 | 曲线(Y轴) | 实验时长累加 | VD_ExperimentDuration_Accum (VD366) | R | xxx.x min | — |
| 6 | 趋势曲线 | 曲线(Y轴) | 实测T总时长 | VD_T_Rolling (VD112) | R | xx.x s | — |
| 6 | 趋势曲线 | 曲线(Y轴) | 实测S6排水时长 | VD_S6_Rolling (VD116) | R | xx.x s | — |
| 6 | 趋势曲线 | 曲线(Y轴) | S1实测时长 | VD_S1_Actual (VD70) | R | xx.x s | — |
| 6 | 趋势曲线 | 曲线(Y轴) | S4实测时长 | VD_S4_Actual (VD74) | R | xx.x s | — |
| 6 | 趋势曲线 | 曲线(Y轴) | S6实测时长 | VD_S6_Actual (VD78) | R | xx.x s | — |
| 6 | 趋势曲线 | 曲线(Y轴) | 本次进水量 | VD_Current_InletVolume (VD90) | R | xxx.xx L | — |
| 6 | 趋势曲线 | 曲线(Y轴) | 瞬时流速 | VD_FlowRate_Instant (VD94) | R | xx.xx L/min | — |
| 6 | 趋势曲线 | 数值显示 | T默认值参考 | VD_T_Default (VD144) | R | xx.x s | — |
| 6 | 趋势曲线 | 数值显示 | S6默认值参考 | VD_S6_Default (VD108) | R | xx.x s | — |
| 6 | 趋势曲线 | 选择框 | 时间范围选择 | HMI内部 | — | 最近1h/24h/7天/自定义 | — |

**画面6元素合计：13个**

---

## 画面7｜通讯与维护页

**说明**：集中查看8台PLC及每套PLC下2个485从站（注射泵、流量计）通讯状态。8套共16个从站。

| 画面编号 | 画面名称 | UI元素类型 | UI元素标签 | 绑定PLC变量 | 读写 | 显示格式 | 报警阈值 |
|---|---|---|---|---|---|---|---|
| 7 | 通讯维护 | 数值显示 | 当前查看单元号 | HMI内部(选中) | — | "通讯维护：X号单元" | — |
| 7 | 通讯维护 | 状态指示灯 | PLC通讯状态(×8套) | HMI连接状态(内部,PLC_01~08) | R | 在线(绿)/离线(黄)/未使能(灰) | 离线=黄 |
| 7 | 通讯维护 | 数值显示 | PLC IP地址(×8套) | HMI内部(配置) | — | 192.168.2.101~108 | — |
| 7 | 通讯维护 | 数值显示 | 最后通讯时间(×8套) | HMI内部(驱动层) | R | yyyy-mm-dd hh:mm:ss | — |
| 7 | 通讯维护 | 状态指示灯 | 注射泵从站状态 | M_CommStatus_Syringe (V304.1) + HMI CommStatus_PLC | R | 双AND：都=1绿，任一=0红 | AQEX-49新增PLC侧标志位，非推断 |
| 7 | 通讯维护 | 数值显示 | 注射泵连续失败计数 | VW_FC4_PumpFailCount (VW294) | R | 整数；0=正常，1~4=警告，≥5=已降级 | AQEX-49，U1_VW294_PumpContFail |
| 7 | 通讯维护 | 状态指示灯 | 流量计从站状态 | M_CommStatus_Flow (V304.2) + HMI CommStatus_PLC | R | 双AND：都=1绿，任一=0红 | AQEX-49新增PLC侧标志位，非推断 |
| 7 | 通讯维护 | 数值显示 | 流量计连续失败计数 | VW_FC4_FlowFailCount (VW296) | R | 整数；0=正常，1~4=警告，≥5=已降级 | AQEX-49，U1_VW296_FlowContFail |
| 7 | 通讯维护 | 数值显示 | 注射泵状态码 | VW4_PumpStatus | R | 文本映射(0空闲/1运行/2抽液/3排液/错误) | 错误码=黄 |
| 7 | 通讯维护 | 数值显示 | 注射泵位置反馈 | VW222 MB_Pump_Position | R | 整数 半步 | — |
| 7 | 通讯维护 | 数值显示 | 流量计当前计量值 | VD_FlowMeter_Current (VD86) | R | 整数(累计,低3位小数) | — |
| 7 | 通讯维护 | 数值显示 | 流量计快照值 | VD_FlowMeter_Snapshot (VD82) | R | 整数(差值法基准) | — |
| 7 | 通讯维护 | 数值显示 | 瞬时流速 | VD_FlowRate_Instant (VD94) | R | xx.xx L/min | — |
| 7 | 通讯维护 | 数值显示 | PLC时钟显示 | PLC RTC（待PLC支持读取） | R | yyyy-mm-dd hh:mm:ss | — |
| 7 | 通讯维护 | 按钮 | PLC时钟校准入口 | 写PLC RTC（待PLC支持） | RW | 二次确认 | — |
| 7 | 通讯维护 | 状态指示灯 | 初始化完成标志 | M_InitDone (V304.0) | R | ON=初始化完成(绿)/OFF=初始化中(黄) | — |
| 7 | 通讯维护 | 数值显示 | HMI工程版本 | HMI内部 | — | vX.X | — |
| 7 | 通讯维护 | 数值显示 | PLC程序版本 | 待PLC侧补充版本变量 | R | vX.X | — |

**画面7元素合计：18个**

---

## 画面8｜系统设置页

**说明**：HMI自身设置、权限、单元使能配置。单元使能存HMI断电保持区，不写PLC。

| 画面编号 | 画面名称 | UI元素类型 | UI元素标签 | 绑定PLC变量 | 读写 | 显示格式 | 报警阈值 |
|---|---|---|---|---|---|---|---|
| 8 | 系统设置 | 开关 | 1号单元使能 | HMI内部 Unit1_Enabled | RW | ON=已使能/OFF=未接入(断电保持) | — |
| 8 | 系统设置 | 开关 | 2号单元使能 | HMI内部 Unit2_Enabled | RW | 同上 | — |
| 8 | 系统设置 | 开关 | 3号单元使能 | HMI内部 Unit3_Enabled | RW | 同上 | — |
| 8 | 系统设置 | 开关 | 4号单元使能 | HMI内部 Unit4_Enabled | RW | 同上 | — |
| 8 | 系统设置 | 开关 | 5号单元使能 | HMI内部 Unit5_Enabled | RW | 同上 | — |
| 8 | 系统设置 | 开关 | 6号单元使能 | HMI内部 Unit6_Enabled | RW | 同上 | — |
| 8 | 系统设置 | 开关 | 7号单元使能 | HMI内部 Unit7_Enabled | RW | 同上 | — |
| 8 | 系统设置 | 开关 | 8号单元使能 | HMI内部 Unit8_Enabled | RW | 同上 | — |
| 8 | 系统设置 | 单选开关 | 报警确认模式 | M_AlarmAckMode (V200.0) | RW | 0=自动恢复/1=人工确认 | — |
| 8 | 系统设置 | 数值显示 | HMI系统时间 | HMI内部RTC | — | yyyy-mm-dd hh:mm:ss | — |
| 8 | 系统设置 | 按钮 | RTC校时入口 | 写HMI时间/同步PLC RTC | RW | 二次确认 | — |
| 8 | 系统设置 | 按钮 | 继电器故障高权限确认 | V0.7 CMD_SafetyRelayAck | RW | 高权限+二次确认弹窗 | — |
| 8 | 系统设置 | 输入框 | 画面亮度 | HMI内部 | RW | 0~100% | — |
| 8 | 系统设置 | 选择框 | 语言/单位 | HMI内部 | RW | 中文/English；L/mL | — |
| 8 | 系统设置 | 数值显示 | 用户权限设置入口 | HMI内部 | — | 操作员/维护/管理员 | — |
| 8 | 系统设置 | 数值显示 | 项目版本/HMI工程版本 | HMI内部 | — | 项目vX.X / 工程vX.X | — |

**画面8元素合计：16个**

---

## 汇总

| 画面 | 名称 | UI元素数 |
|---|---|---|
| 画面1 | 8套总览首页 | 75 |
| 画面2 | 单元详情页 | 36 |
| 画面3 | 单元手动控制页 | 35 |
| 画面4 | 参数设置页 | 24 |
| 画面5 | 报警与日志页 | 42 |
| 画面6 | 趋势曲线页 | 13 |
| 画面7 | 通讯与维护页 | 18 |
| 画面8 | 系统设置页 | 16 |
| **合计** | — | **259** |

> **注**：画面1的75个元素含8套卡片×9元素（72）+3全局元素；画面5的42个元素含32位报警指示灯阵列（按32个计）。实际组态时，画面1卡片为模板复用，画面5报警阵列为阵列控件，开发工作量低于元素总数。

---

**文档版本**：v1.3
**编制日期**：2026-07-15 / 2026-07-29 同步 v1.3 地址表 / 2026-08-17 新增手动注射泵控制绑定
**修订日期**: 2026-09-02
**修订内容**: v1.3 新增标题栏系统运行状态指示灯绑定(VB305，0=良好/1=故障/2=急停，AQEX-50)
**变量权威来源**：HMI-PLC变量地址表 v1.6
