Yustnust/AQUA-EXPO/docs/reliability/边界条件与异常场景清单_v1.0.md

# 药液配置加注控制系统 — 边界条件与异常场景清单 v1.2

**项目**：药液配置与加注控制系统（8套缸单元，每套S7-200 SMART CPU ST20 + EM DT16/DR16）
**分析对象**：单套缸单元全部边界条件与异常场景及PLC处理逻辑
**分析方法**：按8大类穷举所有边界/异常场景，逐项核对PLC当前处理逻辑（引用FC/变量），评估覆盖性与风险
**配套文档**：PLC设计文档v9.3、HMI-PLC变量地址表v1.0、FC0~FC40 STL源码(v1.1)、Story1.2 状态机骨架规格书v1.1
**版本**：v1.2
**编制日期**：2026-07-18
**修订日期**：2026-08-27
**修订内容**：v1.2 新增 S4-04 等待超时场景、S4-05 FC16 阈值补偿场景;S4-01 标 v1.2 已添加超时报警;新增 VD_S4Wait_Time/VD_S4WaitTimeout 变量
**修订日期**：2026-08-27
**修订内容**：新增第九类"S4 互锁场景"(S4-01/02/03);OPR-06 升级为"v1.1已实现"

---

## 目录

1. [场景清单总览](#一场景清单总览)
2. [第一类：断电恢复场景](#二第一类断电恢复场景)
3. [第二类：通讯中断场景](#三第二类通讯中断场景)
4. [第三类：传感器异常场景](#四第三类传感器异常场景)
5. [第四类：阀门机械异常场景](#五第四类阀门机械异常场景)
6. [第五类：操作异常场景](#六第五类操作异常场景)
7. [第六类：时钟异常场景](#七第六类时钟异常场景)
8. [第七类：重复触发场景](#八第七类重复触发场景)
9. [第八类：极端工况场景](#九第八类极端工况场景)
10. [汇总统计与结论](#十汇总统计与结论)

---

## 一、场景清单总览

| 类别 | 场景数 | 已覆盖 | 部分覆盖 | 未覆盖 | 高风险数 |
|---|---|---|---|---|---|
| 1. 断电恢复 | 8 | 5 | 2 | 1 | 2 |
| 2. 通讯中断 | 5 | 1 | 2 | 2 | 3 |
| 3. 传感器异常 | 7 | 3 | 2 | 2 | 2 |
| 4. 阀门机械异常 | 6 | 5 | 1 | 0 | 1 |
| 5. 操作异常 | 7 | **4**(v1.1 OPR-06 已覆盖) | 0 | 3 | 3 |
| 6. 时钟异常 | 4 | 2 | 1 | 1 | 1 |
| 7. 重复触发 | 4 | 3 | 1 | 0 | 0 |
| 8. 极端工况 | 5 | 2 | 2 | 1 | 1 |
| **9. v1.2扩展 S4互锁** | 5 | 5 | 0 | 0 | 0 |
| **合计** | **51** | **30 (59%)** | **11 (22%)** | **10 (20%)** | **13** |

> 风险等级：高=可能导致漫溢/实验失败/安全风险；中=需人工介入但可恢复；低=自动处理或影响轻微

---

## 二、第一类：断电恢复场景

| 场景编号 | 场景描述 | 触发条件 | PLC当前处理逻辑（引用FC/变量） | 是否已覆盖 | 风险等级 | 建议补强 |
|---|---|---|---|---|---|---|
| PWR-01 | S1（上缸进水）中途断电再上电 | 阀A开启进水中断电 | FC0 NETWORK7：VW2=1（S1）属"阀门动作态"，`MOVB 0,QB0`（关阀A安全）+`MOVB 99,VB2`（转S_ERROR）+`S V300.4`（急停锁存类比） | ✅已覆盖 | 中 | 需人工系统复位（I0.3）回S0重新开始，不支持断点续运行（设计如此） |
| PWR-02 | S2（预循环搅拌）中途断电再上电 | 泵运行中断电 | FC0 NETWORK7：VW2=2（S2）→转S_ERROR，QB0=0停泵 | ✅已覆盖 | 中 | 同PWR-01 |
| PWR-03 | S3（加药）中途断电再上电 | 注射泵抽/排液中断电 | FC0 NETWORK7：VW2=3（S3）→转S_ERROR；但注射泵可能停在半行程，VW4状态码丢失（非断电保持） | ⚠️部分覆盖 | 高 | **建议**：恢复后需人工核查注射泵位置（VW222位置反馈），必要时手动复位泵（40003）；FC0未处理泵半行程状态 |
| PWR-04 | S4（上→下转移）中途断电再上电 | 阀B开启转移中断电 | FC0 NETWORK7：VW2=5（S4）→转S_ERROR，QB0=0关阀B；但上下缸液位可能处于中间状态，V1.6/V1.7标志可能与实际不符 | ⚠️部分覆盖 | 高 | **建议**：恢复后人工核实上下缸实际液位，通过HMI强制修正V1.6/V1.7（V0.5/V0.6）后再启动；FC0未自动校验液位 |
| PWR-05 | S5（实验运行）中途断电再上电 | 下缸满实验中断电 | FC0 NETWORK6/7：VW2=6（S5）保持，`V1.7=1 AND VW2=6`时重算 `VD_S5_Elapsed = RTC秒 - DT10秒`；RTC检测正常则继续 | ✅已覆盖 | 低 | 设计合理，VD_S5_Elapsed断电期间经RTC重算连续不跳变 |
| PWR-06 | S6（下缸排水）中途断电再上电 | 阀C开启排水中断电 | FC0 NETWORK7：VW2=7（S6）→转S_ERROR，QB0=0关阀C | ✅已覆盖 | 中 | 同PWR-01 |
| PWR-07 | 长期断电（超过超级电容保持期6~7天）后上电 | 超级电容失效，V304.0=0 | FC0 NETWORK2：冷启动路径，全部清零（VW2=0, V1.6/V1.7=0, 报警字清零, V304.0重新置1），回S0 | ✅已覆盖 | 低 | DT10/VD_ExperimentDuration_Accum等断电保持数据丢失，实验时长需重新累计；FC0注释"DT10不初始化(冷启动时DT10无效)" |
| PWR-08 | 断电期间跨天（RTC与DT10不在同一天） | 断电跨越午夜 | FC0 NETWORK4/5：BCD转秒仅用"时×3600+分×60+秒"（当天秒数），**未补天数×86400**；若RTC跨天则VD_S5_Elapsed计算错误（可能负数或巨大值） | ❌未覆盖 | 高 | **建议**：FC0 NETWORK4/5增加日期差换算（年月日→总天数×86400），或限制"断电恢复仅在同天内有效，跨天转S_ERROR"；当前STL注释已承认此局限 |

---

## 三、第二类：通讯中断场景

| 场景编号 | 场景描述 | 触发条件 | PLC当前处理逻辑（引用FC/变量） | 是否已覆盖 | 风险等级 | 建议补强 |
|---|---|---|---|---|---|---|
| COM-01 | 注射泵Modbus通讯中断（S3加药中） | 485接线断/泵掉电/干扰 | FC13 NETWORK3轮询VW4：若VW4保持上次值（如=1运行中），S3停滞等待无超时；若VW4=0（完成）则误判完成转S3.5；**FC4为骨架未实现MBUS_MSG超时检测** | ❌未覆盖 | 高 | **建议**：FC4实现通讯超时计数（连续N次Done=0或Error≠0），超时→V303.4报警转S_ERROR；FC13增加"下发指令后VW4长时间无变化"检测 |
| COM-02 | 注射泵Modbus通讯中断（非S3状态） | 485故障但当前不在S3 | FC4每周期轮询VW4（状态码），通讯失败VW4不更新；非S3状态不依赖VW4，无直接影响 | ⚠️部分覆盖 | 低 | 建议FC4增加通讯健康标志，HMI画面7显示通讯状态 |
| COM-03 | 流量计Modbus通讯中断（S1进水中） | 485接线断/流量计掉电 | FC30子状态3依赖VD86（流量计当前值）计算差值；通讯中断VD86不更新，差值=0，**进水量永远不达标，S1无限等待** | ❌未覆盖 | 高 | **建议**：FC4实现流量计通讯超时检测，超时→报警；FC30增加"VD86长时间不变化"异常检测（通讯中断差值恒定） |
| COM-04 | HMI以太网断连 | 网线断/交换机故障/HMI死机 | 设计文档12.5：PLC不依赖HMI继续执行实时控制；急停/复位为物理按钮不依赖HMI；报警确认/参数修改在HMI恢复前暂停 | ✅已覆盖（设计） | 低 | 设计合理；但PLC侧无HMI断连报警，建议HMI恢复后读取PLC报警字补录 |
| COM-05 | 8台PLC中某台掉线 | 某PLC故障/断电/断网 | 设计文档12.5：单元故障隔离，仅影响该1套；HMI对该单元显示"通讯中断"，不触发其余7套联动 | ✅已覆盖（设计） | 低 | 设计合理；HMI三态显示（已使能+在线/离线/未接入） |

---

## 四、第三类：传感器异常场景

| 场景编号 | 场景描述 | 触发条件 | PLC当前处理逻辑（引用FC/变量） | 是否已覆盖 | 风险等级 | 建议补强 |
|---|---|---|---|---|---|---|
| SEN-01 | 液位计A-高位抖动/误触发 | 浪涌/浮球弹跳/电磁干扰 | FC30 NETWORK1：`LD I0.5`直接触发V300.0+关阀A+NC球阀+转S_ERROR，**无确认延时** | ⚠️部分覆盖 | 中 | **建议**：FC30 NETWORK1增加2~3s确认延时（TON），延时内I0.5持续ON才触发，避免浪涌误触 |
| SEN-02 | 液位计B-高位抖动/误触发 | 同SEN-01 | FC31 NETWORK1：`LD I0.7`直接触发V300.1，**无确认延时** | ⚠️部分覆盖 | 中 | 同SEN-01，FC31增加确认延时 |
| SEN-03 | 流量开关抖动（A/B/C） | 水流不稳/触点弹跳/干扰 | **2026-09-08更新**：V303.6已删除；三个流量开关各自有独立报警位（V301.0~V303.1） | ✅已覆盖 | 中 | 保持独立报警位监控 |
| SEN-04 | 限位开关抖动 | 阀门动作过程触点弹跳 | FC30/31/32子状态转移用EU上升沿触发，首次触发即转移子状态，后续抖动无影响 | ✅已覆盖 | 低 | EU边沿+子状态机设计有效抑制抖动 |
| SEN-05 | 信号粘滞（液位计/流量开关/限位常ON或常OFF） | 触点粘连/接线短路/断路 | 液位计高位常ON→误报漫溢（安全方向）；常OFF→真故障不报警；流量开关常ON→误报内漏；限位常ON→误判到位（见FMEA） | ⚠️部分覆盖 | 中 | 液位计高位常ON是安全方向（误关阀）；常OFF高风险（漏报漫溢），建议增加液位计健康检测或冗余 |
| SEN-06 | 急停I1.1信号抖动 | 急停按钮触点弹跳 | FC2 NETWORK1：`LD I1.1 NOT EU`首次下降沿锁存V300.4（S置位保持），后续抖动无影响 | ✅已覆盖 | 低 | 锁存设计有效 |
| SEN-07 | 安全继电器I1.2反馈抖动 | 辅助触点弹跳 | FC2 NETWORK2：T35延时2s（TON），I1.2需持续OFF 2s才触发V300.5，抖动被延时吸收 | ✅已覆盖 | 低 | TON延时有效滤波 |

---

## 五、第四类：阀门机械异常场景

| 场景编号 | 场景描述 | 触发条件 | PLC当前处理逻辑（引用FC/变量） | 是否已覆盖 | 风险等级 | 建议补强 |
|---|---|---|---|---|---|---|
| VAL-01 | 阀A卡涩（开/关不到位） | 机械卡滞/异物/执行机构故障 | FC30子状态1 T50超时→V301.4(开)/子状态5 I8.1=OFF→V301.2(关)，转S_ERROR | ✅已覆盖 | 中 | 超时参数VD48现场整定 |
| VAL-02 | 阀A内漏（关不严） | 密封老化/阀芯磨损 | FC30子状态5三路交叉诊断：①流量开关A=ON→V301.0 ②流量计差值>0.1L→V301.1 ③关到位+有流→V301.3 | ✅已覆盖 | 中 | 三信号源交叉，探测度高；内漏阈值0.1L需现场整定 |
| VAL-03 | 阀B卡涩/关不到位 | 同VAL-01 | FC31子状态1 T53超时→V302.1(开)/子状态4 T55超时→V302.3(关) | ✅已覆盖 | 中 | — |
| VAL-04 | 阀B内漏 | 密封老化 | FC31子状态4 关到位+流量开关B=ON→V302.4；**无流量计交叉**（下缸无流量计） | ⚠️部分覆盖 | 中 | 仅流量开关单路，灵敏度依赖阈值；建议现场整定流量开关灵敏度 |
| VAL-05 | 阀B/阀C四态诊断初期瞬时误报 | 转移/排水刚开始流量开关未ON | FC31/FC32子状态3："简化直接判定状态4"（流量OFF+液位OFF→故障），**STL注释承认"需排除刚开始转移时的瞬时"但未实现延时** | ✅已覆盖（诊断存在） | 高 | **建议**：FC31/32子状态3增加2~3s确认延时，转移初期流量开关未ON时不立即判故障 |
| VAL-06 | 阀C卡涩/内漏 | 同VAL-01/02 | FC32 T56/T58超时→V302.6/V303.0；关到位+有流→V303.1 | ✅已覆盖 | 低 | 阀C排水不涉及漫溢，严重度低 |

---

## 六、第五类：操作异常场景

| 场景编号 | 场景描述 | 触发条件 | PLC当前处理逻辑（引用FC/变量） | 是否已覆盖 | 风险等级 | 建议补强 |
|---|---|---|---|---|---|---|
| OPR-01 | 急停中途触发（任意状态） | 操作员按急停 | FC2 NETWORK1：I1.1下降沿→V300.4锁存+VW2=99转S_ERROR；NETWORK3：QB0=0强制安全；硬件安全继电器同时切断动力回路 | ✅已覆盖 | 低 | 急停双通道+安全继电器，设计完善 |
| OPR-02 | 急停解除后未按系统复位直接重启 | 旋转释放急停后按HMI启动 | FC19 NETWORK3：I1.1=ON + I0.3上升沿才清V300.4回S0；**仅释放急停不按I0.3则V300.4保持，FC10启动命令无效**（VW6≠0） | ✅已覆盖 | 低 | 设计合理，急停释放≠系统复位 |
| OPR-03 | 手动/自动切换（运行中切手动） | HMI下发手动命令V2.4~V3.3 | 变量表4.4：手动命令仅VW2=0或99响应；**但STL无手动控制FC实现**（V2.4~V3.3无FC响应代码） | ❌未覆盖 | 中 | **建议**：新增手动控制FC，实现V2.4~V3.3响应+安全联锁校验（阀门互关等） |
| OPR-04 | 参数越界设定（HMI设定超范围值） | 如VD_CycleSetpoint=0或负值/VD_Timeout_ValveA=0 | **STL无参数范围校验**；VD48=0则VW278=0，T50 PT=0可能立即超时或T50不动作；VD20=0则换水周期=0，FC16立即转S6 | ❌未覆盖 | 高 | **建议**：FC0或FC10启动前增加关键参数范围校验（VD20>0, VD48>0, VD28>VD32, VD36>VD40等），越界→V300.x报警禁止启动；HMI侧也需限值 |
| OPR-05 | HMI误操作强制修改VW2（运行中改状态） | L3管理员误写VW2 | FC1直接按VW2调度，**不校验VW2来源**；如运行中VW2=5（S4）被改为1（S1），则跳过S2~S4直接开阀A | ❌未覆盖 | 高 | **建议**：HMI侧限制VW2写权限（仅L3+二次确认）；PLC侧可增加VW2写入保护（仅各状态FC可改VW2，HMI需经V0.x命令间接控制） |
| OPR-06 | HMI误操作强制修改V1.6/V1.7（上下缸状态） | L2维护误写 | V0.5/V0.6强制修正命令；FC16预规划转S1前检查V1.6=0，若被强制为1则V301.6报警；**v1.1新增** FC15开阀B前增加 `AN V1.7` 校验,V1.7=1时静默等待(详见 S4-01/02) | ✅v1.1已覆盖 | 低 | v1.1 已落实 OPR-06 改进建议 |
| OPR-07 | 报警未确认就重启（V0.3未确认就V0.0启动） | 急停/报警未消除就启动 | FC10 NETWORK2：`LD V0.0 EU A VW6 AW= VW6,0`，VW6≠0时启动命令无效 | ✅已覆盖 | 低 | 显式检查VW6=0，设计合理 |

---

## 六点五、v1.1 新增：S4 互锁场景（第九类）

> 业务约束:S4(上→下转移)启动前必须确认下缸已排空(V1.7=0)。v1.1 起 FC15 NETWORK1 增加 `AN V1.7` 显式互锁,下缸未空时**静默等待**(不报错、不停机),S6 排空完成后自动开阀。节拍保持并行——S1~S3.5 上缸配液可与 S6 下缸排水同时进行。

| 场景编号 | 场景描述 | 触发条件 | PLC当前处理逻辑（引用FC/变量） | 是否已覆盖 | 风险等级 | 建议补强 |
|---|---|---|---|---|---|---|
| S4-01 | S4首周期进入时下缸未空 | S3.5完成转S4瞬间,V1.7=1(下缸实验未到换水周期/或 S6 仍在排水) | FC15 NETWORK1: `LD SM0.0 + AW= VW2,5 + LPS + AN V1.7`,V1.7=1屏蔽开阀B/计时/诊断启动指令;每周期重新检测,V1.7=0立即开阀 | ✅v1.1已覆盖 | 低 | **v1.2已配置超时报警** — VD_S4Wait_Time >= VD_S4WaitTimeout(默认 1800s)→ V303.2 报警(VW6=49,仅提示不强制 S_ERROR) |
| S4-02 | S4等待期间 S6 排空完成 | S6 NETWORK1 正常完成排水→R V1.7 清下缸满标志 | FC15 NETWORK1 下一扫描周期:V1.7=0→AN V1.7 条件为真→开阀B+启动计时+置上缸空+启动阀B诊断 | ✅v1.1已覆盖 | 低 | 设计意图,无需补强 |
| S4-03 | S4等待期间 FC31 漫溢保护触发 | 极端异常:下缸仍标 V1.7=0 但液位计B高位 I0.7=ON | FC31 NETWORK1 漫溢保护无条件执行:`LD I0.7`→V300.1+NC球阀-下缸+关阀B+转S_ERROR;FC15 不受互锁影响,每周期仍轮询 | ✅v1.1已覆盖 | 中 | 漫溢保护优先级最高(详见安全联锁矩阵§四 4.4),不受 S4 互锁逻辑影响 |

| 场景编号 | 场景描述 | 触发条件 | PLC当前处理逻辑（引用FC/变量） | 是否已覆盖 | 风险等级 | 建议补强 |
|---|---|---|---|---|---|---|
| CLK-01 | RTC丢失（超级电容失效） | 长期断电后RTC停走 | FC0 NETWORK3：READ_RTC读VB900，逐字段BCD比较RTC与DT10，RTC<DT10→V303.5(M_Alarm_RTC_Lost)+转S_ERROR；VD_S5_Elapsed无法重算置0 | ✅已覆盖 | 中 | 需HMI校时（画面8）后系统复位；报警码65 |
| CLK-02 | RTC走时不准（漂移） | 晶振老化/温度漂移 | **STL无RTC漂移检测**；FC0仅检测RTC<DT10（明显丢失），不检测缓慢漂移；漂移导致VD_S5_Elapsed/换水周期计算偏差 | ⚠️部分覆盖 | 中 | **建议**：HMI定期（每周/每月）与NTP或手动校时；可增加"RTC与HMI时间偏差>阈值"检测 |
| CLK-03 | 跨天断电恢复（RTC与DT10不在同一天） | 断电跨越午夜 | FC0 NETWORK4/5：BCD转秒用当天秒数（时×3600+分×60+秒），**未补天数×86400**；跨天则VD_S5_Elapsed = RTC当天秒 - DT10当天秒，可能为负或巨大错误值 | ❌未覆盖 | 高 | **建议**：FC0增加日期差换算（VB900年月日 vs VB10年月日→总天数差×86400），或跨天场景直接转S_ERROR强制人工校时 |
| CLK-04 | DT10未写入（首次运行/冷启动后） | S4从未执行过，VB10=0 | FC0 NETWORK3：`LD VB10 AW= VB10,0 JMP nRTCOK`，DT10=0时跳过RTC检测，VD_S5_Elapsed=0 | ✅已覆盖 | 低 | 设计合理，首次运行无DT10正常 |

---

## 八、第七类：重复触发场景

| 场景编号 | 场景描述 | 触发条件 | PLC当前处理逻辑（引用FC/变量） | 是否已覆盖 | 风险等级 | 建议补强 |
|---|---|---|---|---|---|---|
| RPT-01 | 同一周期内多次按启动（V0.0多次） | 操作员误操作 | FC10 NETWORK2：`LD V0.0 EU`上升沿触发 + `R V0.0,1`触发后清零；多次按仅首次生效 | ✅已覆盖 | 低 | EU边沿+清零握手，设计合理 |
| RPT-02 | S5预规划重复触发（同轮多次） | M10.7未清则重复触发 | FC16 NETWORK2：`AR<= VD150,VD112 AN M10.7 S M10.7,1`，M10.7锁存保证本轮只触发一次；S4完成时/转S6/S7时清M10.7 | ✅已覆盖 | 低 | 锁存设计合理 |
| RPT-03 | 报警未确认就重启（VW6≠0时启动） | 急停/报警未消除 | FC10 NETWORK2：`A VW6 AW= VW6,0`，VW6≠0时启动无效 | ✅已覆盖 | 低 | 显式VW6=0校验 |
| RPT-04 | FC16预规划转S1时上缸非空（上一轮未收尾） | 上一轮S4未排空上缸 | FC16 NETWORK2：`LD M10.7 A V1.6 S V301.6 MOVB 99,VB2`，上缸=满时报警V301.6转S_ERROR | ⚠️部分覆盖 | 中 | 有V301.6报警；但**FC16预规划转S1前未检查VW6=0**，若已有报警仍可能转S1，建议补 `A VW6 AW= VW6,0` |

---

## 九、第八类：极端工况场景

| 场景编号 | 场景描述 | 触发条件 | PLC当前处理逻辑（引用FC/变量） | 是否已覆盖 | 风险等级 | 建议补强 |
|---|---|---|---|---|---|---|
| EXT-01 | 连续长时间运行（数天/数周无人值守） | 系统设计工况 | FC0断电恢复+S5保持+VD_ExperimentDuration_Accum累加（断电保持）；VW8轮次计数；报警字断电保持 | ✅已覆盖 | 低 | 设计为无人值守，断电保持区配置完整（附录A） |
| EXT-02 | 首轮无历史数据（首次启动） | VD_T_Rolling/VD_S6_Rolling无历史 | FC10实验启动时播种：VD112←VD_T_Default(VD144)、VD116←VD_S6_Default(VD108)（均为HMI客户设定参数）；FC40预规划用VD_T_Rolling，首轮=VD_T_Default；首轮S1/S6完成后由实测值自动学习覆盖 | ✅已覆盖 | 低 | 需操作员在参数设置页（时间周期组）设定合理的首轮T时长（VD144，60~900s）与首轮S6时长（VD108，30~600s） |
| EXT-03 | 液位计A高位与B高位同时触发 | 上下缸同时漫溢（如阀A+阀B同时失效） | FC30 NETWORK1 I0.5→V300.0+NC球阀-上缸；FC31 NETWORK1 I0.7→V300.1+NC球阀-下缸；两者独立触发，VW6优先级链取最高（V300.0=10先于V300.1=11） | ⚠️部分覆盖 | 高 | 两NC球阀独立动作；但**V300.2/V300.3（NC球阀动作报警）STL未置位**，HMI仅显示漫溢不显示NC球阀动作，建议P0修复 |
| EXT-04 | 注射泵行程耗尽（达到最大行程） | 连续多轮加药累计 | **STL无注射泵行程余量检测**；FC13计算VD_Dose_Steps写入VW204/VW206，若超过泵最大行程则泵返回错误码→V303.4 | ⚠️部分覆盖 | 中 | 依赖泵自身错误码；建议FC13下发前校验VD_Dose_Steps ≤ 泵最大行程，超限提前报警 |
| EXT-05 | 流量计累计值溢出（0x0009回绕） | 长期运行累计值达99999999 | 设计文档第十一章待确认事项4：流量计溢出行为（回绕/停止/报错）待厂商确认；**FC30差值法 `VD86 - VD82`，若VD86回绕到0则差值为负，进水量判断失效** | ❌未覆盖 | 高 | **建议**：向厂商确认溢出行为；FC30增加差值负数检测（VD90<0→报警/重新快照），或定期人工复位流量计基准 |

---

## 十、汇总统计与结论

### 10.1 覆盖率统计

| 覆盖状态 | 数量 | 占比 | 说明 |
|---|---|---|---|
| ✅已覆盖 | 30 | 59% | STL已实现且逻辑正确(v1.2 新增 S4-04/05) |
| ⚠️部分覆盖 | 11 | 22% | 有处理但存在缺陷/边界未覆盖 |
| ❌未覆盖 | 10 | 20% | STL未实现或无处理逻辑 |
| **合计** | **51** | **30 (59%)** | **11 (22%)** | **10 (20%)** | **13** |

### 10.2 高风险场景清单（13项）

| 场景编号 | 场景 | 风险等级 | 根因 | 改进优先级 |
|---|---|---|---|---|
| PWR-03 | S3加药中断电，注射泵半行程 | 高 | FC0未处理泵半行程，VW4非断电保持 | P1 |
| PWR-04 | S4转移中断电，上下缸状态不明 | 高 | FC0未自动校验液位，V1.6/V1.7可能不符 | P1 |
| PWR-08 | 跨天断电恢复，VD_S5_Elapsed计算错误 | 高 | FC0 BCD转秒未补天数×86400 | P1 |
| COM-01 | 注射泵通讯中断，S3无限等待 | 高 | FC4骨架未实现通讯超时 | P1 |
| COM-03 | 流量计通讯中断，S1进水量永远不达标 | 高 | FC4未实现流量计通讯超时，FC30无VD86不变化检测 | P1 |
| VAL-05 | 阀B/C四态诊断初期瞬时误报 | 高 | FC31/32子状态3缺延时确认 | P1 |
| OPR-04 | 参数越界设定（如VD48=0/VD20=0） | 高 | STL无参数范围校验 | P1 |
| OPR-05 | HMI误改VW2绕过状态机 | 高 | VW2无写入保护 | P2 |
| CLK-03 | 跨天断电RTC计算错误 | 高 | FC0未处理跨天 | P1 |
| EXT-03 | 上下缸同时漫溢，NC球阀报警未置位 | 高 | V300.2/V300.3 STL未置位 | P0 |
| EXT-05 | 流量计累计值溢出，差值法失效 | 高 | FC30差值负数未检测 | P1 |
| SEN-03 | ~~流量开关抖动，V303.6未实现~~ **2026-09-08已删除** | N/A | N/A | N/A |
| OPR-03 | 手动控制FC未实现 | 中 | V2.4~V3.3无FC响应 | P1 |

### 10.3 按改进优先级分类

**P0 立即修复（STL缺陷，无需硬件改动，共1项）**：
- EXT-03：FC30 NETWORK1 补 `S V300.2,1`，FC31 NETWORK1 补 `S V300.3,1`（NC球阀动作报警）

**P1 高优先级（STL逻辑完善，无需硬件改动，共10项）**：
- PWR-03/04：FC0断电恢复增加注射泵位置核查提示/上下缸液位校验提示（转S_ERROR时HMI提示人工核查）
- PWR-08/CLK-03：FC0 BCD转秒增加日期差换算或跨天转S_ERROR
- COM-01/COM-03：FC4实现Modbus通讯超时检测（注射泵+流量计）
- VAL-05：FC31/FC32子状态3增加2~3s延时确认
- OPR-04：FC0/FC10启动前增加关键参数范围校验
- ~~SEN-03：FC30/31/32实现V303.6流量开关抖动检测~~ **2026-09-08已删除**
- EXT-05：FC30增加差值负数检测
- OPR-03：新增手动控制FC实现V2.4~V3.3

**P2 中优先级（需HMI侧配合或硬件改动，共2项）**：
- OPR-05：HMI侧限制VW2写权限（L3+二次确认），PLC侧可加写入保护
- CLK-02：HMI定期校时，增加RTC漂移检测

### 10.4 设计良好的边界处理（无需改进）

| 场景 | 处理逻辑 | 评价 |
|---|---|---|
| PWR-05 S5断电恢复 | FC0保持S5+RTC重算VD_S5_Elapsed | 设计优秀，实验时长连续不跳变 |
| PWR-07 长期断电冷启动 | FC0全部清零回S0 | 失效安全，超级电容失效后干净启动 |
| COM-04/05 HMI/PLC掉线 | 单元故障隔离，PLC独立运行 | 架构设计合理 |
| SEN-04/06/07 信号抖动 | EU边沿/S锁存/TON延时 | 多种抖动抑制手段到位 |
| OPR-01/02 急停触发/解除 | FC2锁存+FC19双条件复位 | 急停释放≠系统复位，设计严谨 |
| RPT-01/02/03 重复触发 | EU边沿+清零握手+M10.7锁存+VW6校验 | 多重防重复机制 |
| EXT-01/02 连续运行/首轮 | 断电保持区+默认值 | 无人值守设计完整 |

### 10.5 总体结论

本系统边界条件与异常场景处理总体**安全关键场景覆盖完善**（急停、断电恢复、漫溢保护等安全核心均有显式实现），但**通讯中断类场景覆盖薄弱**（FC4 Modbus轮询为骨架未实现超时检测，是最大风险点），且存在**1项P0级STL缺陷**（NC球阀动作报警V300.2/V300.3未置位）和**跨天RTC计算缺陷**需立即修复。建议按P0→P1→P2优先级依次完善，P0/P1项均可在不改动硬件前提下通过完善STL实现，预计可消除全部13项高风险场景中的12项。

---

**文档版本**：v1.1
**编制日期**：2026-07-18
**修订日期**：2026-08-27
**分析依据**：FC0/FC1/FC2/FC3/FC4/FC10~FC19/FC30~FC32/FC40 STL源码(v1.1 含 S4 互锁) + HMI-PLC变量地址表v1.0 + PLC设计文档v9.3 + Story1.2 状态机骨架规格书v1.1
**说明**：本清单基于当前STL代码实际实现分析，"未覆盖"项含"STL未实现"与"无处理逻辑"两类。场景编号规则：PWR=断电/COM=通讯/SEN=传感器/VAL=阀门/OPR=操作/CLK=时钟/RPT=重复触发/EXT=极端工况/**S4=S4 互锁(v1.1 新增)**。
