Yustnust/AQUA-EXPO/docs/commissioning/备品备件清单_v1.0.md

# 药液配置加注控制系统 — 备品备件清单 v1.3

**项目**: 药液配置加注控制系统
**适用范围**: 8套缸单元（每套1台西门子S7-200 SMART CPU ST20 + EM DT16/DR16扩展）+ 1台昆仑通态MCGS 12寸HMI集中监控
**用途**: 网络与采购工程师的备件采购、库存管理、维护领用依据；保障8套单元长期无人值守运行，关键故障可现场快速更换
**版本**: v1.3
**日期**: 2026-07-18
**配套文档**: BOM清单v2、药液配置加注控制系统_PLC设计文档v9.3、HMI-PLC变量地址表v1.0、设备维护手册v1.0、网络架构与IP规划v1.0

---

## 一、备件总则

### 1.1 备件配置原则

1. **关键优先**：直接导致单元停机或安全风险的关键器件（A类）必须现场常备1套，确保4小时内可更换。
2. **数量与套数挂钩**：8套单元同型号器件总量按 `单套用量×8` 核算备件基数；同型号器件按总量的5%~20%配置备件（A类取高限，C类取低限）。
3. **公共设备单独核算**：HMI、交换机等公共设备仅1台/套，备件按"整机1+核心模块1"原则配置。
4. **采购周期匹配**：长采购周期器件（进口/定制）备件量适当上浮；短采购周期器件（国产标准件）可降低备件量。
5. **与BOMv2对齐**：本清单物料名称/规格/单套用量严格对齐BOM清单v2，型号细化中"待确认"项需现场到货后填实。
6. **分期兼容**：首期1套阶段按1套基数+全量8套上限核算；全量8套阶段按本表"8套总用量"列重新核算备件量。

### 1.2 备件等级定义

| 等级 | 定义 | 备件要求 | 采购周期要求 |
|---|---|---|---|
| **A关键** | 直接导致单元停机或安全风险，无替代方案，故障后无法继续运行 | 必须现场备1套以上，确保4小时内更换 | 采购周期>2周的，备件量翻倍 |
| **B重要** | 影响单元功能或冗余度，故障后可降级运行但需尽快更换 | 建议现场备1套，确保48小时内更换 | 按正常采购周期备货 |
| **C一般** | 不影响主流程，可采购周期内到货，或同型号器件可临时借用 | 库存预警，按需采购 | 采购周期<2周可零库存 |

---

## 二、备件分类清单

### 2.1 PLC及扩展模块（A类关键）

| # | 物料名称 | 型号规格 | 单套用量 | 8套总用量 | 建议备件数 | 备件等级 | 采购周期 | 参考供应商 | 备注 |
|---|---|---|---|---|---|---|---|---|---|
| 1 | PLC主机CPU模块 | 西门子 S7-200 SMART CPU ST20（标准型，内置RTC，超级电容保持7天，本体12DI/8DO+以太网口+RS485口） | 1台 | 8台 | 1台 | **A** | 2~4周 | 西门子授权代理商（北京/上海/深圳本地代理） | 8套PLC程序完全相同，备件可互换；故障时直接换机+下装程序+导入IP/系统块；配套存储卡见#3 |
| 2 | 数字量扩展模块 | EM DT16（8DI+8DO晶体管输出）或 EM DR16（8DI+8DO继电器输出） — 与整机选型一致 | 1块 | 8块 | 1块 | **A** | 2~4周 | 西门子授权代理商 | DI点数已用满无冗余，扩展模块故障将导致8点DI/DO失效；待确认整机最终采用DT16还是DR16，备件型号需对齐 |
| 3 | PLC存储卡（SIMATIC Memory Card） | 西门子SIMATIC Memory Card 256MB（用于程序/配方/数据记录归档，CPU ST20支持） | 1张 | 8张 | 1张 | B | 2~3周 | 西门子授权代理商 | 用于程序断电归档与日志记录；首期1套可暂不配，全量8套建议每台配1张；备件1张用于程序下装介质 |
| 4 | 后备电池模块 | 待确认 — CPU ST20本体超级电容保持典型7天/最小6天；如需更长断电保持（>7天）需配后备电池模块（BA_MODULE，需查询ST20兼容性） | 0~1 | 0~8 | 0 | C | 2~4周 | 西门子授权代理商 | ST20默认超级电容，无需电池；如现场断电>7天风险高，需确认ST20是否支持外接电池模块（待西门子技术确认）；本项暂不强制备件 |
| 5 | PLC本体以太网口备件 | CPU本体集成，无独立模块；故障时更换整机CPU（见#1） | — | — | — | A | — | — | 集成于CPU，无法单独更换，按#1整机备件处理 |
| 6 | PLC本体RS485口备件 | CPU本体集成Port0，无独立模块；故障时更换整机CPU（见#1） | — | — | — | A | — | — | 同上 |

### 2.2 继电器与电气元件（A/B类）

| # | 物料名称 | 型号规格 | 单套用量 | 8套总用量 | 建议备件数 | 备件等级 | 采购周期 | 参考供应商 | 备注 |
|---|---|---|---|---|---|---|---|---|---|
| 7 | 中间继电器（DO输出驱动） | 24V DC线圈，2组转换触点（DPDT），8A触点容量，DIN导轨安装 — 如欧姆龙MY2NJ-DC24 + PYF08底座，或施耐德RXM2AB2BD + RXZE2S2 | 9个 | 72个 | 8个 | B | 1~2周 | 欧姆龙/施耐德/正泰/德力西代理 | 每套9个对应9个DO点（潜水泵×2、电动球阀×3、NC球阀×2、声/光报警×2）；故障率高，备件按总量10%配置 |
| 8 | 中间继电器（DI有源信号转换） | 24V DC线圈，2组转换触点，DIN导轨安装 — 同#7型号可统一 | 6个 | 48个 | 5个 | B | 1~2周 | 同#7 | 每套6个对应阀A/B/C开到位/关到位6路有源信号转无源触点；与#7同型号可统一备件 |
| 9 | **v1.3** 安全继电器(MSR-P) | 双通道带短路检测,DC 24V 电源,带输出触点反馈,支持手动复位 — **MSR-P** 系列(原 PNOZ s4) | 1个 | 8个 | 1个 | **A** | 3~6周 | 昆仑通态/Schmersal/西门子代理 | 切断本单元潜水泵/注射泵/电动球阀动力回路;故障无法降级运行,必须立即更换;v1.3 升级为 MSR-P 双通道带短路检测,比 PNOZ s4 更高安全等级(PL e/Cat 4) |
| 10 | 接触器（动力回路切换） | 待确认 — 若安全继电器主触点直接切动力电则不需接触器；若需接触器扩容则按负载电流选型（潜水泵/注射泵/电动球阀总电流核算） | 0~3 | 0~24 | 1个 | B | 2~4周 | 施耐德LC1D系列/正泰CJX2系列 | 待控制柜方案与负载核算后确认是否需要；如采用，每套3个（潜水泵/注射泵/阀门总电源各1） |
| 11 | 微型断路器（MCB） | 24V DC控制回路2P/6A，220V动力回路1P+N/10A（按负载核算）C型曲线 — 如施耐德IC60N、正泰NXB-63 | 2~4个 | 16~32个 | 4个 | C | 1~2周 | 施耐德/正泰/德力西代理 | 配电保护元件，故障率低；备件按总量10%或最少4个 |
| 12 | 直流开关电源24VDC | 24V DC输出，容量按全负载核算（PLC+继电器+传感器+HMI电源，典型100~150W） — 如明纬NDR-120/240、西门子SITOP PSU100S | 1台 | 8台 | 1台 | **A** | 1~2周 | 明纬/西门子/朝阳代理 | 每套缸单元1台；故障导致整单元PLC/继电器/传感器失电停机；备件1台 |
| 13 | 直流开关电源12VDC（若HMI/传感器需12V） | 12V DC输出，容量按12V负载核算 — 如明纬LRS-50-12 | 0~1 | 0~1 | 0~1 | C | 1~2周 | 明纬/西门子代理 | 仅当HMI或部分传感器需12V时配置；待HMI选型确认电源规格后定 |
| 14 | 继电器插座 | 与#7/#8继电器配套底座，DIN导轨安装 — 如欧姆龙PYF08A | 15个 | 120个 | 10个 | C | 1~2周 | 同#7 | 与继电器配套，备件按总量8% |

### 2.3 执行机构（A/B类）

| # | 物料名称 | 型号规格 | 单套用量 | 8套总用量 | 建议备件数 | 备件等级 | 采购周期 | 参考供应商 | 备注 |
|---|---|---|---|---|---|---|---|---|---|
| 15 | 电动球阀A（上缸进水） | 电动球阀，带开到位/关到位限位反馈（有源正极输出），接口管径按上缸进水管选型 — BOMv2备注"勒隆阀门或同等产品"，具体型号待确认 | 1台 | 8台 | 1台 | **A** | 3~6周 | 勒隆阀门/同等厂商 | A/B/C三阀同型号（BOMv2第10项），备件可互换；故障导致无法进水/转移/排水，单元停机；同型号备件1台可覆盖3种用途 |
| 16 | 电动球阀B（上→下转移） | 同#15（与阀A同型号） | 1台 | 8台 | （含于#15） | **A** | 3~6周 | 同#15 | 同#15，备件1台可覆盖A/B/C任一故障 |
| 17 | 电动球阀C（下缸排水） | 同#15（与阀A同型号） | 1台 | 8台 | （含于#15） | **A** | 3~6周 | 同#15 | 同#15 |
| 18 | NC球阀（上缸失效安全保护） | 常闭型NC球阀，得电打开/失电关闭（失效安全），1/4-28或对应管径接口 — BOMv2第9项，具体型号待确认 | 1个 | 8个 | 2个 | B | 2~4周 | 待确认供应商 | 上缸第二道漫溢保护；平时常闭不动作，仅在阀A失效时触发；动作频次低但安全关键 |
| 19 | NC球阀（下缸失效安全保护） | 同#18（与上缸NC球阀同型号） | 1个 | 8个 | （含于#18） | B | 2~4周 | 同#18 | 同#18，备件2个可覆盖上下缸任一故障 |
| 20 | 潜水泵1（上缸搅拌） | 上缸搅拌潜水泵，型号按搅拌功率/流量选型 — 具体型号待确认 | 1台 | 8台 | 1台 | B | 2~4周 | 待确认供应商 | 潜水泵1/2同型号，备件1台可覆盖任一故障；故障导致S2预循环无法进行，单元降级 |
| 21 | 潜水泵2（上缸搅拌） | 同#20（与潜水泵1同型号） | 1台 | 8台 | （含于#20） | B | 2~4周 | 同#20 | 同#20 |

### 2.4 传感器（B/C类）

| # | 物料名称 | 型号规格 | 单套用量 | 8套总用量 | 建议备件数 | 备件等级 | 采购周期 | 参考供应商 | 备注 |
|---|---|---|---|---|---|---|---|---|---|
| 22 | 流量开关A（阀A进水监测） | 开关量输出，无源触点，常开型，管径按上缸进水管选型 — 具体型号待确认 | 1个 | 8个 | 2个 | B | 2~4周 | 待确认供应商 | 3个流量开关（A/B/C）同型号可统一备件（BOMv2第11项）；备件2个可覆盖任一故障 |
| 23 | 流量开关B（阀B转移监测） | 同#22 | 1个 | 8个 | （含于#22） | B | 2~4周 | 同#22 | 同#22 |
| 24 | 流量开关C（阀C排水监测） | 同#22 | 1个 | 8个 | （含于#22） | B | 2~4周 | 同#22 | 同#22 |
| 25 | 液位计A-高位（上缸防漫溢） | 高低位双点液位计，无源触点输出，常开型，材质耐药剂腐蚀 — 具体型号待确认 | 0.5个 | 4个 | 1个 | **A** | 2~4周 | 待确认供应商 | 高位直接触发漫溢报警，是安全关键；液位计A高低位共用1台双点液位计（BOMv2第12项按2个/8套=16个，即每缸A/B各1个含高低位双点） |
| 28 | 液位计A-低位（上缸排空判定） | 同#27（与A高位共用双点液位计） | 0.5个 | 4个 | （含于#27） | B | 2~4周 | 同#27 | 同#27，备件1台可覆盖A高低位 |
| 29 | 液位计B-高位（下缸防漫溢） | 同#27（与A同型号） | 0.5个 | 4个 | （含于#27） | **A** | 2~4周 | 同#27 | 同#27，备件1台可覆盖B高低位 |
| 30 | 液位计B-低位（下缸排空判定） | 同#27（与B高位共用双点液位计） | 0.5个 | 4个 | （含于#27） | B | 2~4周 | 同#27 | 同#27 |
| 31 | 流量计（上缸进水精确计量） | Modbus RTU 485通讯，量程按上缸进水流量选型 — BOMv2备注"K24或同等产品"，已确认协议 | 1台 | 8台 | 1台 | B | 3~6周 | K24流量计/同等厂商 | 故障导致差值法进水计量失效，S1无法精确判断进水量；进口件采购周期长，备件1台 |

### 2.5 注射泵（A类关键）

| # | 物料名称 | 型号规格 | 单套用量 | 8套总用量 | 建议备件数 | 备件等级 | 采购周期 | 参考供应商 | 备注 |
|---|---|---|---|---|---|---|---|---|---|
| 32 | 注射泵主机（柱塞式泵阀一体） | 柱塞式计量泵，含内部切换阀（抽取母液/排放流路切换），Modbus RTU 485通讯 — 南京润泽《泵阀一体MODBUS协议V1.7》已确认协议，具体型号待确认 | 1台 | 8台 | 1台 | **A** | 4~8周 | 南京润泽/同等厂商 | 故障导致S3加药无法进行，单元停机；定制件采购周期长，备件1台 |
| 33 | 进样器（5ml容量） | 5ml规格进样器（注射器），匹配注射泵主机，单步分辨率约0.2083µL/步（按5ml核实） | 1套 | 8套 | 2套 | B | 2~4周 | 同#32（南京润泽配套） | 易耗品，建议备件量上浮；不同容量进样器分辨率不同，需与泵主机匹配 |
| 34 | 进样器（其他容量，按加药量核实） | 待确认 — 若不同实验需不同浓度，可能需1ml/2ml/5ml/10ml多种规格 | 0~1套 | 0~8套 | 1套 | C | 2~4周 | 同#32 | 待实验需求确认后增配；首期按5ml单规格 |
| 35 | 步进电机（注射泵驱动） | 集成于注射泵主机内部，无独立模块；故障时更换整机（见#32） | — | — | — | A | — | — | 集成于泵主机，无法单独更换，按#32整机备件处理 |
| 36 | 注射泵通讯连接线 | RS485屏蔽双绞线 + 注射泵专用通讯接头，长度按柜内走线 | 1条 | 8条 | 2条 | C | 1~2周 | 同#32 | 易耗线缆，备件2条 |

### 2.6 HMI（公共设备，A/B类）

| # | 物料名称 | 型号规格 | 单套用量 | 8套总用量 | 建议备件数 | 备件等级 | 采购周期 | 参考供应商 | 备注 |
|---|---|---|---|---|---|---|---|---|---|
| 37 | 昆仑通态MCGS 12寸触摸屏 | 昆仑通态 TPC1211-T12CE（12.1寸，800×600，4GB Flash，256MB RAM，前IP66/后IP54）— 待供应商二轮确认具体型号（备选TPC1262Hi高配型） | 1台 | 1台 | 1台 | **A** | 2~4周 | 昆仑通态授权代理 | 公共设备1台，故障导致8单元集中监控全部不可用；备件1台预装组态工程可快速更换 |
| 38 | HMI屏用电源适配器 | 24V DC输入（由开关电源供电）或100~240V AC输入（直供），与TPC1211规格匹配 — 待HMI选型确认 | 1个 | 1个 | 1个 | B | 1~2周 | 同#37（昆仑通态配套） | 电源故障导致HMI无法启动，备件1个 |
| 39 | HMI组态工程备份（U盘/SD卡） | 8GB U盘或SD卡，预存最新组态工程+历史数据备份 — 如金士顿DT100 G3 8GB | 2个 | 2个 | 2个 | B | 1周 | 通用渠道 | 程序恢复与版本管理必备；1个现场使用，1个归档备份 |
| 40 | HMI触摸屏保护膜 | 12寸触摸屏专用保护膜，防刮防尘 | 2张 | 2张 | 4张 | C | 1周 | 通用渠道 | 易耗品，定期更换 |
| 41 | HMI组态软件（授权） | MCGS嵌入版组态软件，随屏提供或免费版 — 待确认授权方式 | 1套 | 1套 | 0 | C | — | 昆仑通态 | 随屏授权，备份在维护工程师PC上 |

### 2.7 网络与线缆（B/C类）

| # | 物料名称 | 型号规格 | 单套用量 | 8套总用量 | 建议备件数 | 备件等级 | 采购周期 | 参考供应商 | 备注 |
|---|---|---|---|---|---|---|---|---|---|
| 42 | 工业以太网交换机 | 9口及以上非网管型（BOMv2经济配置）或16口管理型（推荐）— 见网络架构与IP规划v1.0第四章选型建议 | 1台 | 1台 | 1台 | **A** | 2~4周 | 西门子/Moxa/三旺/研华代理 | 公共设备1台，故障导致HMI与8台PLC通讯全部中断；备件1台预配置可快速更换；与#37 HMI并列为最关键公共备件 |
| 43 | 屏蔽超五类网线（Cat5e STP） | 4对双绞线，整体铝箔+编织屏蔽，工业级，305m/箱 | 1批 | 1批 | 1箱（305m） | C | 1~2周 | 普康/安普/秋叶原代理 | 现场布线按距离核算用量；备件1箱用于故障更换与扩展 |
| 44 | 工业级RJ45水晶头 | 镀金触点，金属外壳，Cat5e/Cat6规格 — 100个/盒 | 1批 | 1批 | 1盒（100个） | C | 1周 | 通用渠道 | 易耗品，备件1盒 |
| 45 | RS485通讯电缆（屏蔽双绞线） | Modbus RTU用屏蔽双绞线，特性阻抗120Ω，每套单元独立1条总线 — 如Belden 9841或国产同等 | 1批 | 8批 | 2批 | B | 1~2周 | Belden/普康代理 | 每套缸独立485总线连接PLC Port0与注射泵+流量计；备件2批覆盖1~2条总线故障 |
| 46 | RS485终端匹配电阻 | 120Ω，每条总线两端各接1个 | 2个 | 16个 | 4个 | C | 1周 | 通用渠道 | 易耗品，备件按总量25% |
| 47 | 接线端子排 | DIN导轨安装，UK系列（如菲尼克斯UK-3N）或JUT系列，按现场点位核算 | 1批 | 8批 | 1批 | C | 1~2周 | 菲尼克斯/正泰代理 | 现场布线易耗，备件1批 |
| 48 | DIN导轨 | 35mm标准DIN导轨，镀锌，1m/根 | 1批 | 8批 | 2根 | C | 1周 | 通用渠道 | 安装基础件，备件2根 |
| 49 | 线槽与线号管 | PVC线槽 + 线号管（多种规格） | 1批 | 8批 | 1批 | C | 1周 | 通用渠道 | 布线辅材，备件1批 |
| 50 | 标签机及标签带 | 兄弟PT系列或同等，标签带3种规格 | 1套 | 1套 | 0（共用） | C | 1周 | 兄弟/锦宫代理 | 维护工具，整机1套共用，不按8套备件 |

### 2.8 易损件（C类）

| # | 物料名称 | 型号规格 | 单套用量 | 8套总用量 | 建议备件数 | 备件等级 | 采购周期 | 参考供应商 | 备注 |
|---|---|---|---|---|---|---|---|---|---|
| 51 | O型密封圈（阀门接口） | 与电动球阀A/B/C接口匹配，氟橡胶材质（耐药剂） — 具体规格按阀门型号待确认 | 若干 | 若干 | 1套（每型号10个） | C | 1~2周 | 同#15（阀门供应商配套） | 阀门拆卸维护易损；备件按每型号10个 |
| 52 | O型密封圈（注射泵接口） | 与注射泵进样器接口匹配 — 具体规格按泵型号待确认 | 若干 | 若干 | 1套（10个） | C | 1~2周 | 同#32（注射泵供应商配套） | 进样器更换易损；备件1套 |
| 53 | 管接头（快插/法兰） | 与上下缸水管路接口匹配，材质耐药剂 — 具体规格按管径待确认 | 若干 | 若干 | 1套（各规格5个） | C | 1~2周 | 待确认供应商 | 管路维护易损；备件按各规格5个 |
| 54 | 保险丝（24V DC回路） | 与开关电源/PLC保险丝座匹配，规格按负载选型 — 如5×20mm 5A/10A快断 | 若干 | 若干 | 1套（每规格20个） | C | 1周 | 通用渠道 | 易耗品，备件按每规格20个 |
| 55 | 保险丝（220V AC回路） | 与动力回路MCB配套或独立保险丝座，规格按负载选型 | 若干 | 若干 | 1套（每规格10个） | C | 1周 | 通用渠道 | 易耗品，备件按每规格10个 |
| 56 | **v1.3** 急停按钮(1 NO+1 NC) | 工业级急停按钮,**1 NO + 1 NC 强制导向型**(NC+NO 机械互锁),蘑菇头红色,自锁式 — 如施耐德 **XB5AS8445** | 1个 | 8个 | 1个 | B | 1~2周 | 施耐德/正泰代理 | 安全关键但故障率低,备件1个;急停按钮为易耗件(频繁操作);v1.3 改 1 NO+1 NC 接法,NC 进 MSR-P,NO 进 PLC I1.1 |
| 57 | 系统复位按钮 | 工业级复位按钮，常开点动，绿色或黑色 — 如施耐德XB4-BA31 | 1个 | 8个 | 1个 | C | 1~2周 | 施耐德/正泰代理 | 易耗件，备件1个 |
| 58 | 消音按钮 | 工业级按钮，常开点动，蓝色或黑色 | 1个 | 8个 | 1个 | C | 1~2周 | 同#57 | 易耗件，备件1个 |
| 59 | 报警蜂鸣器 | 无源触点驱动，工业级，70~85dB | 1个 | 8个 | 1个 | C | 1~2周 | 待确认供应商 | 易耗件，备件1个 |
| 60 | 报警指示灯 | 无源触点驱动，工业级，红色LED，旋转/频闪型 | 1个 | 8个 | 1个 | C | 1~2周 | 待确认供应商 | 易耗件，备件1个 |

---

## 三、备件汇总与等级统计

### 3.1 备件等级汇总

| 等级 | 物料数 | 8套总用量价值估算（相对） | 备件策略 |
|---|---|---|---|
| **A关键** | 11项（#1, #2, #9, #12, #15, #27, #29, #32, #37, #42, 急停安全相关） | 高 | 全部现场常备1套，4小时内可更换 |
| **B重要** | 16项（#3, #7, #8, #10, #13, #18, #20, #22~#24, #28, #30, #31, #33, #38, #39, #45, #56） | 中 | 建议现场备1套，48小时内可更换 |
| **C一般** | 33项（其余） | 低 | 库存预警，按需采购，采购周期内到货 |

### 3.2 关键A类备件速查

| # | 物料 | 备件数 | 故障影响 | 更换预估时长 |
|---|---|---|---|---|
| 1 | CPU ST20主机 | 1台 | 单元停机 | 30分钟（换机+下装程序+IP配置） |
| 2 | EM DT16/DR16扩展 | 1块 | 单元8点DI/DO失效 | 15分钟 |
| 9 | 安全继电器 | 1个 | 单元安全回路失效，必须停机 | 20分钟 |
| 12 | 24VDC开关电源 | 1台 | 单元全停 | 15分钟 |
| 15 | 电动球阀（A/B/C同型号） | 1台 | 对应阀门功能失效，单元停机 | 30~60分钟（含管路拆装） |
| 27/29 | 液位计（A/B同型号，含高低位双点） | 1台 | 漫溢保护失效，安全风险 | 30分钟 |
| 32 | 注射泵主机 | 1台 | 加药功能失效，单元停机 | 60分钟（含管路/485连接） |
| 37 | HMI触摸屏 | 1台 | 8单元集中监控全停 | 30分钟（含组态工程恢复） |
| 42 | 工业以太网交换机 | 1台 | HMI与8台PLC通讯全断 | 15分钟（含配置恢复） |

---

## 四、备件采购建议

### 4.1 首批采购量（随整机采购）

| 类别 | 首批采购策略 | 说明 |
|---|---|---|
| A关键备件 | **随整机采购时一次性配齐**，按本表"建议备件数"列 | 长采购周期进口件（CPU ST20、安全继电器、注射泵、电动球阀）必须随整机下单，避免投运后无备件等待 |
| B重要备件 | 随整机采购时按"建议备件数"80%配置 | 短采购周期件可后续补齐 |
| C一般备件 | 随整机采购时按"建议备件数"50%配置，或首期零库存 | 通用标准件可现场就近采购 |
| 公共设备备件（HMI/交换机） | **必须随整机各配1台备件** | 全量8套共用1台HMI/交换机，无备件风险最高 |

### 4.2 后续补货周期

| 备件等级 | 补货触发 | 补货周期 | 责任人 |
|---|---|---|---|
| A关键 | 备件数<1，立即补货 | 采购周期内（2~8周） | 网络与采购工程师 |
| B重要 | 备件数=0时补货 | 采购周期内（1~4周） | 网络与采购工程师 |
| C一般 | 库存预警（备件数<建议备件数50%）时补货 | 按需（1~2周） | 仓库管理员 |

### 4.3 最低库存预警

| 备件等级 | 最低库存阈值 | 预警动作 |
|---|---|---|
| A关键 | 备件数=1 | 立即触发补货流程，标记红色预警 |
| B重要 | 备件数=0 | 触发补货流程，标记黄色预警 |
| C一般 | 备件数<建议备件数50% | 月度盘点时补货，标记蓝色提示 |

### 4.4 采购周期与供应商管理

| 供应商类别 | 代表供应商 | 采购周期 | 管理建议 |
|---|---|---|---|
| 西门子PLC/扩展模块 | 西门子授权代理（北京/上海/深圳本地代理） | 2~4周 | 签订年度框架协议，锁定价格与交期 |
| 进口安全继电器（Pilz/Schmersal） | Pilz/Schmersal中国代理 | 3~6周 | 长周期件，备件量翻倍至2个 |
| 国产中间继电器（欧姆龙/施耐德/正泰） | 通用电气代理 | 1~2周 | 标准件，本地代理就近供货 |
| 注射泵/流量计（南京润泽/K24） | 厂商直接 | 4~8周 | 定制件，签订长期供货协议 |
| 阀门/泵（勒隆/待确认） | 厂商直接 | 3~6周 | 定制件，备件随整机配齐 |
| HMI（昆仑通态） | 昆仑通态授权代理 | 2~4周 | 备件1台预装组态工程 |
| 网络设备（西门子/Moxa） | 网络设备代理 | 2~4周 | 备件1台预配置VLAN/端口绑定 |
| 易耗品（保险丝/密封圈/按钮） | 通用渠道 | 1~2周 | 本地备货，零库存策略可行 |

---

## 五、备件存储与领用管理

### 5.1 备件存储要求

| 类别 | 存储环境 | 存储位置 | 备注 |
|---|---|---|---|
| PLC/扩展模块/HMI/交换机 | 防静电袋密封，温度-10~+50℃，湿度<70%RH | 防静电柜 | 静电敏感，必须防静电包装 |
| 安全继电器/接触器/中间继电器 | 干燥防尘，原包装 | 备件柜 | 防潮防尘 |
| 电动球阀/注射泵/流量计/传感器 | 原包装，防碰撞，干燥环境 | 备件货架 | 易碰撞件单独存放 |
| 密封圈/管接头 | 干燥避光，避免变形 | 备件盒 | 氟橡胶避光存储 |
| 保险丝/按钮/指示灯 | 干燥，分类标识 | 备件盒 | 按规格分类标识 |
| 网线/RS485线 | 防压扁，盘绕存储 | 备件架 | 避免重压变形 |

### 5.2 备件标识与台账

| 标识项 | 内容 | 标识方式 |
|---|---|---|
| 备件编号 | 与本清单#编号一致 | 标签机打印贴纸 |
| 物料名称/型号 | 完整型号规格 | 标签机打印 |
| 备件等级 | A/B/C（用颜色区分：A红/B黄/C蓝） | 彩色标签 |
| 入库日期 | YYYY-MM-DD | 标签 + 台账 |
| 库存数量 | 当前库存/预警阈值 | 台账实时更新 |
| 存储位置 | 柜号-层号-位号 | 标签 + 台账 |

### 5.3 备件领用流程

```
[领用流程]

1. 故障发生 → 维护工程师评估需更换器件
   ↓
2. 查备件台账确认库存
   ├─ 有库存 → 进入Step 3
   └─ 无库存 → 紧急采购（A类）/ 等待采购（B/C类）
   ↓
3. 填写《备件领用单》
   - 领用人/日期/单元编号/故障现象/更换器件编号
   - 维护工程师签字
   ↓
4. 仓库管理员核实后发放备件
   ↓
5. 更换完成后，维护工程师在《设备维护记录》登记
   - 故障原因/处理过程/更换件序列号/恢复时间
   ↓
6. 仓库管理员更新台账库存数
   ├─ 库存<预警阈值 → 触发补货流程（见4.3）
   └─ 库存正常 → 结束
   ↓
7. 故障件按以下方式处理：
   ├─ 在保修期内 → 返厂维修/换新
   ├─ 保修期外可修复 → 送修后入库备用
   └─ 不可修复 → 报废处理，记录报废原因
```

### 5.4 备件定期盘点

| 频次 | 盘点内容 | 责任人 |
|---|---|---|
| 每月 | 实物与台账核对，预警阈值检查 | 仓库管理员 |
| 每季度 | 备件有效期检查（如有），老化检查 | 仓库管理员 + 维护工程师 |
| 每年 | 全量盘点，备件策略评估，根据故障率调整备件量 | 网络与采购工程师 |

### 5.5 备件数据驱动优化

| 数据来源 | 用途 | 优化方向 |
|---|---|---|
| 《设备维护记录》故障率统计 | 识别高故障率器件 | 提升该器件备件等级与备件量 |
| 备件领用频次分析 | 识别零领用备件 | 降低或取消该备件备货 |
| 采购周期实际值 | 修正采购周期估算 | 调整最低库存阈值 |
| 故障停机时长统计 | 评估备件响应有效性 | 优化备件存储位置与领用流程 |

---

## 六、参考文档与待确认事项

### 6.1 参考文档

| 文档 | 章节 | 用途 |
|---|---|---|
| BOM清单v2 | 全表 | 物料名称/规格/单套用量原始依据 |
| 药液配置加注控制系统_PLC设计文档v9.3 | 第二章I/O地址分配/第九章急停逻辑 | 器件功能与安全等级判定 |
| 药液配置加注控制系统_PLC设计文档v9.3 | 第十二章多机联网架构 | 8套单元架构与公共设备识别 |
| HMI-PLC变量地址表v1.0 | 第二章DI映射/第三章DO映射 | 器件点位与备件等级映射 |
| HMI选型技术问询单与备选方案对比v1.0 | 第二章备选方案对比 | HMI备件型号确认依据 |
| 设备维护手册v1.0 | 第二章维护周期总表/第六章备件管理 | 备件与维护衔接 |
| 网络架构与IP规划v1.0 | 第四章网络设备选型 | 交换机/网线备件规格 |

### 6.2 待确认事项

| # | 事项 | 责任方 | 影响 |
|---|---|---|---|
| 1 | EM扩展模块最终型号（EM DT16 还是 EM DR16） | 项目方/控制柜方案 | 备件#2型号定型 |
| 2 | 电动球阀A/B/C具体型号（勒隆阀门型号） | 阀门供应商 | 备件#15~#17型号定型，配套密封圈#51规格 |
| 3 | NC球阀具体型号 | 阀门供应商 | 备件#18/#19型号定型 |
| 4 | 潜水泵1/2具体型号 | 泵供应商 | 备件#20/#21型号定型 |
| 5 | 流量开关A/B/C具体型号 | 传感器供应商 | 备件#22~#24型号定型 |
| 6 | 液位计A/B具体型号 | 传感器供应商 | 备件#27~#30型号定型 |
| 7 | 注射泵主机具体型号（南京润泽型号） | 注射泵供应商 | 备件#32型号定型，配套进样器#33规格 |
| 8 | 流量计具体型号（K24具体型号） | 流量计供应商 | 备件#31型号定型 |
| 9 | HMI最终型号（TPC1211-T12CE 还是 TPC1262Hi） | HMI供应商二轮确认 | 备件#37型号定型 |
| 10 | 24VDC开关电源容量核算 | 控制柜方案确定后 | 备件#12型号定型 |
| 11 | 是否需要接触器（#10） | 控制柜方案 | 备件#10是否需要 |
| 12 | CPU ST20是否支持后备电池模块 | 西门子技术确认 | 备件#4是否需要 |
| 13 | 控制柜方案（8套独立小柜 还是 1个大柜8分区） | 现场勘察 | 影响备件存储位置与就近库存策略 |
| 14 | 进样器规格（5ml单规格 还是 多规格） | 实验需求确认 | 备件#33/#34数量与规格 |

---

**文档版本**: v1.0
**编制日期**: 2026-07-18
**修订日期**: 2026-09-03
**修订内容**: v1.3 安全继电器 #9 由 PNOZ s4 改为 MSR-P;急停按钮 #56 由 2NC 改为 1 NO+1 NC 强制导向型(Schneider XB5AS8445)
**编制人**: 网络与采购工程师
**下次更新触发**: BOM清单v3发布、备件型号待确认事项闭环、首批备件到货核对、年度盘点后根据故障率调整备件量
