Yustnust/AQUA-EXPO/docs/药液配置加注控制系统_BOM_购买清单.xlsx

药液配置与加注控制系统 — BOM（v2，按8套独立控制单元核算，同步至PLC设计文档v9.3，支持分期接入）
依据《药液配置加注控制系统_PLC设计文档》v9.3版整理，8套缸独立控制单元架构；v9.2取消温度计、pH计两个485从站；v9.3首期先实施1套、后续按需扩展至8套，按套采购条目备注标注"首期1套/全量8套"，公共设备首期即按全量8套规划容量；部分条目规格/型号及控制柜布置方案待现场确认，详见备注列
序号 | 类别 | 名称 | 规格 / 技术要求 | 数量 | 单位 | 备注
1 | 控制与人机界面 | PLC主机 | 西门子 S7-200 SMART CPU ST20（标准型，内置RTC） | 1 | 台 | 已有
2 |  | 数字量扩展模块 | EM DT16 或 EM DR16（8DI+8DO） | 1 | 台 | 本体12DI/8DO＋本模块后达20DI/16DO，覆盖单元所需20DI/9DO（v9新增3个就地按钮后DI总点数由17增至20），
3 |  | 本地集中触摸屏HMI | 工业触摸屏，10~15寸（建议12寸以上），支持S7-200 SMART以太网通讯（S7协议/Modbus TCP），支持8站点同时连接 | 1 | 台 | 现场1台集中管理8套缸单元，用于总览/报警详情/报警确认/参数设定/历史记录/手动调试；优先昆仑通态MCGS、威纶通、步科、显控等，需向厂家确认8站点同时通讯能力、变量点数、报警/历史记录容量；首期即采购1台，按8套满配选型（变量点数/连接数/容量），避免扩展时更换硬件
4 |  | HMI组态软件 | 随屏提供的组态工程软件，或免费版组态软件 | 1 | 套 | 优先选用随屏免费提供的组态软件（如昆仑通态MCGS嵌入版）；需确认S7-200 SMART以太网驱动支持方式、8站点授权、变量点数及报警/历史记录容量是否满足；首期即采购1套，授权按8套满配核算
6 |  | 网络布线材料 | 网线、水晶头、线槽等 | 1 | 批 | 随现场布线距离核算用量；首期按1套布线核算用量，扩展时追加；建议首期即按8套规划线槽和主干布线
7 |  | 就地操作面板 | 消音按钮＋报警确认/复位按钮＋系统复位按钮（急停解除专用，与报警确认按钮物理分离）＋对应状态指示灯，不含触摸屏 | 3个自复位按钮， 3个指示灯 | 套 | 每套缸单元1套，替代原就地触摸屏方案；急停按钮单独见本表第18项；【v9.3分期】首期1套，后续按需扩展至全量8套，扩展时按套追加
8 |  | 24V、12V直流开关电源 | 为PLC、传感器、继电器线圈供电，容量待核算 | 24V，？W1个 12V,？W1个 | 台 | 每套缸单元1台，容量需按全负载核算后选型；若最终采用集中大柜方案可能合并配电，待控制柜方案确定后调整；【v9.3分期】首期1套，后续按需扩展至全量8套，扩展时按套追加
9 | 阀门与执行机构 | NC电磁阀（常闭型） | 得电打开/失电关闭失效安全型，1/4-28或对应管径接口 | 2 | 个 | 每套缸2个（上缸、下缸各1个，独立第二道漫溢保护），共8套16个；【v9.3分期】首期1套，后续按需扩展至全量8套，扩展时按套追加
10 |  | 电动球阀（带限位反馈） | 自带开到位/关到位限位反馈信号（有源正极输出） | 3 | 个 | 每套缸对应阀A/B/C共3个，共8套24个，勒隆阀门或同等产品；【v9.3分期】首期1套，后续按需扩展至全量8套，扩展时按套追加
11 | 检测与传感元件 | 流量开关 | 开关量输出，无源触点 | 5 | 个 | 每套缸5个（阀A/B/C各1个＋潜水泵1/2各1个），共8套40个；【v9.3分期】首期1套，后续按需扩展至全量8套，扩展时按套追加
12 |  | 液位计（高低位双点） | 同时具备最高/最低两个判定点，无源触点输出 | 2 | 个 | 每套缸2个（对应上缸A、下缸B），共8套16个；【v9.3分期】首期1套，后续按需扩展至全量8套，扩展时按套追加
13 |  | 流量计+积算仪 | Modbus RTU 485通讯，量程按上缸进水流量选型 | 1 | 个 | 已有
14 | 泵类设备 | 潜水泵 | 上缸搅拌用，串接流量开关做运行反馈 | 2 | 台 | 每套缸2台，共8套16台；【v9.3分期】首期1套，后续按需扩展至全量8套，扩展时按套追加
15 |  | 注射泵（泵阀一体） | 柱塞式计量泵，Modbus RTU 485通讯，含内部切换阀 | 1 | 台 | 已有
16 | 安全与保护装置 | 急停按钮 | 工业级，至少2组独立常闭触点（1组接安全继电器，1组接PLC监测） | 1 | 个 | 每套缸1个，各自独立，不设总控室级联动急停；【v9.3分期】首期1套，后续按需扩展至全量8套，扩展时按套追加
17 |  | 安全继电器 | 强制导向型（force-guided），建议符合EN ISO 13849-1/IEC 60204-1标准 | 1 | 个 | 每套缸1个，切断该套单元潜水泵/注射泵/电动球阀动力回路；【v9.3分期】首期1套，后续按需扩展至全量8套，扩展时按套追加
18 | 电气辅材 | 中间继电器（DO输出驱动） | PLC数字量输出统一经继电器转换驱动负载，24V DC线圈 | 9 | 个 | 每套缸9个（对应9个DO点：潜水泵×2、电动球阀×3、NC电磁阀×2、声/光报警×2），共8套72个；【v9.3分期】首期1套，后续按需扩展至全量8套，扩展时按套追加
19 |  | 中间继电器（DI有源信号转换） | 阀门限位反馈为有源正极输出，需转换为无源触点接入PLC | 6 | 个 | 每套缸6个（阀A/B/C各自开到位/关到位共6路），共8套48个；【v9.3分期】首期1套，后续按需扩展至全量8套，扩展时按套追加
20 |  | 导轨、端子排、线槽 | 标准DIN导轨安装，含接线端子、线槽、标签 | 首期1 / 全量8 | 批 | 每套缸单元1批，共8批；若控制柜改为集中大柜方案可合并核算用量；【v9.3分期】首期1套，后续按需扩展至全量8套，扩展时按套追加
21 |  | RS485通讯电缆 | 屏蔽双绞线，每套单元1条独立总线，连接本单元PLC与2个485从站（注射泵/流量计） | 首期1 / 全量8 | 批 | 每套缸独立1批总线，共8批，不与其他单元共享总线；【v9.3分期】首期1套，后续按需扩展至全量8套，扩展时按套追加
23 | 报警装置 | 声音报警器 | 无源触点驱动，独立消音控制 | 1 | 个 | 每套缸1个，各自独立，不设总控室汇总报警；【v9.3分期】首期1套，后续按需扩展至全量8套，扩展时按套追加
24 |  | 灯光报警器/指示灯 | 无源触点驱动，独立消光控制（需就地面板按钮人工确认复位） | 1 | 个 | 每套缸1个，各自独立；【v9.3分期】首期1套，后续按需扩展至全量8套，扩展时按套追加
25 | 柜体 | 控制柜 | 含PLC、继电器、端子排等全部电气元件安装空间 | 1 | 台 | 布置方案（8套独立小柜就近安装 / 1个大柜内隔8个分区）待现场勘察玻璃缸实际摆放布局后确定；此处暂按独立小柜方案列8台，若改集中大柜需合并调整；【v9.3分期】首期1套，后续按需扩展至全量8套，扩展时按套追加
