Yustnust/AQUA-EXPO/achieve/药液配置加注控制系统_BOM清单.xlsx

药液配置与加注控制系统 — BOM（
依据《药液配置加注控制系统_PLC设计文档》整理，部分条目规格/型号待现场确认，详见备注列
序号 | 类别 | 名称 | 规格 / 技术要求 | 数量 | 单位 | 备注
1 | 控制与人机界面 | PLC主机 | 西门子 S7-200 SMART CPU ST20（标准型，内置RTC） | 1 | 台
2 |  | 数字量扩展模块 | 本体DI/DO点数不足17DI/9DO时配置，具体规格按最终点数核算，EM DT16 或 EM DR16（8DI+8DO） | 1 | 台 | 选型待定，视CPU本体点数核算
3 |  | HMI触摸屏 | 昆仑通态 MCGS 12寸，含组态软件 | 1 | 台
 |  | 24V、12V直流开关电源 | 为PLC、传感器、继电器线圈供电，容量待核算 | 1 | 台 | 容量需按全负载核算后选型
4 | 阀门与执行机构 | NC电磁阀（常闭型） | 得电打开/失电关闭失效安全型，1/4-28或对应管径接口 | 2 | 个 | 上缸、下缸各1个，独立第二道漫溢保护
5 |  | 电动球阀（带限位反馈） | 自带开到位/关到位限位反馈信号（有源正极输出） | 3 | 个 | 对应阀A/B/C，勒隆阀门或同等产品
6 | 检测与传感元件 | 流量开关 | 开关量输出，无源触点 | 5 | 个 | 阀A/B/C各1个 + 潜水泵1/2各1个
7 |  | 液位计（高低位双点） | 同时具备最高/最低两个判定点，无源触点输出 | 2 | 个 | 对应上缸(A)、下缸(B)
8 |  | 流量计 | Modbus RTU 485通讯，量程按上缸进水流量选型 | 1 | 个 | 已确认协议，型号K24或同等产品
9 |  | 温度计 | Modbus RTU 485通讯 | 1 | 个 | 接口文档待补充
10 |  | pH计 | Modbus RTU 485通讯 | 1 | 个 | 接口文档待补充
11 | 泵类设备 | 潜水泵 | 上缸搅拌用，串接流量开关做运行反馈 | 2 | 台
12 |  | 注射泵（泵阀一体） | 柱塞式计量泵，Modbus RTU 485通讯，含内部切换阀 | 1 | 台 | 已确认Modbus协议，配套进样器规格按加药量核实
13 | 安全与保护装置 | 急停按钮 | 工业级，至少2组独立常闭触点（1组接安全继电器，1组接PLC监测） | 1 | 个
14 |  | 安全继电器 | 强制导向型（force-guided），建议符合EN ISO 13849-1/IEC 60204-1标准 | 1 | 个 | 切断潜水泵/注射泵/电动球阀动力回路
15 | 电气辅材 | 中间继电器（DO输出驱动） | PLC数字量输出统一经继电器转换驱动负载，24V DC线圈 | 9 | 个 | 对应9个DO点：潜水泵×2、电动球阀×3、NC电磁阀×2、声/光报警×2
16 |  | 中间继电器（DI有源信号转换） | 阀门限位反馈为有源正极输出，需转换为无源触点接入PLC | 6 | 个 | 对应阀A/B/C各自开到位/关到位共6路
17 |  | 导轨、端子排、线槽 | 标准DIN导轨安装，含接线端子、线槽、标签 | 1 | 批
18 |  | RS485通讯电缆 | 屏蔽双绞线，连接PLC与4个485从站（注射泵/温度计/pH计/流量计） | 1 | 批
19 |  | RS485终端匹配电阻 | 120Ω，总线两端各接1个 | 2 | 个
20 | 报警装置 | 声音报警器 | 无源触点驱动，独立消音控制 | 1 | 个
21 |  | 灯光报警器/指示灯 | 无源触点驱动，独立消光控制（需人工确认复位） | 1 | 个
22 | 柜体 | 控制柜 | 含PLC、继电器、端子排等全部电气元件安装空间 | 1 | 台 | 尺寸待布局图确定
23
说明：本清单为核心控制类元件清单，不含管路、接头、支架等安装辅材；标注"待定/待确认"的条目需完成相应技术文档确认后再定型号。
