Yustnust/AQUA-EXPO/(list of files, cad)

Other CAD files:
plc/stl/modbus_test/OB1_MAIN.stl
plc/stl_gbk/OB1_MAIN.stl
plc/stl/OB1_MAIN.stl
plc/stl/FC12_State_S2_PreMix.stl
plc/stl/modbus_test/FC99_TestFlow.stl
plc/stl_gbk/FC30_ValveA_Diag.stl
plc/stl/FC11_State_S1_Inlet.stl
plc/stl_gbk/FC13_State_S3_Dosing.stl
plc/stl/SBR25_ColdStart.stl
plc/stl_gbk/FC3_AlarmHandling.stl
plc/stl/FC3_AlarmHandling.stl
plc/stl_gbk/FC12_State_S2_PreMix.stl
plc/stl/FC14_State_S35_Rest.stl
plc/stl_gbk/FC14_State_S35_Rest.stl
plc/stl/FC30_ValveA_Diag.stl
plc/stl_gbk/FC11_State_S1_Inlet.stl
plc/stl/FC13_State_S3_Dosing.stl
plc/stl_gbk/SBR26_WarmRecovery.stl
plc/stl/FC18_State_S7_End.stl
plc/stl_gbk/FC16_State_S5_Run.stl
plc/stl/FC16_State_S5_Run.stl
plc/stl_gbk/FC2_EStopHandling.stl
plc/stl/FC19_State_Error.stl
plc/stl_gbk/FC18_State_S7_End.stl
plc/stl/SBR26_WarmRecovery.stl
plc/stl_gbk/FC10_State_S0_Init.stl
plc/stl/FC2_EStopHandling.stl
plc/stl_gbk/FC19_State_Error.stl
plc/stl/FC10_State_S0_Init.stl
plc/stl_gbk/FC4_ModbusPolling.stl
plc/stl/FC21_ManualSyringePump.stl
plc/stl_gbk/FC21_ManualSyringePump.stl
plc/stl/FC0_SysInit.stl
plc/stl_gbk/SBR25_ColdStart.stl
plc/stl/FC4_ModbusPolling.stl
plc/stl_gbk/FC0_SysInit.stl
plc/stl/FC15_State_S4_Transfer.stl
plc/stl_gbk/FC1_StateDispatcher.stl
plc/stl/FC17_State_S6_Drain.stl
plc/stl_gbk/FC17_State_S6_Drain.stl
plc/stl/FC1_StateDispatcher.stl
plc/stl_gbk/FC22_RTC_Sync.stl
plc/stl/FC20_ManualControl.stl
plc/stl_gbk/FC15_State_S4_Transfer.stl
plc/stl/FC22_RTC_Sync.stl
plc/stl_gbk/FC20_ManualControl.stl
plc/stl/FC31_ValveB_Diag.stl
plc/stl_gbk/FC32_ValveC_Diag.stl
plc/stl/FC32_ValveC_Diag.stl
plc/stl_gbk/FC31_ValveB_Diag.stl
plc/stl/FC40_RhythmCorrection.stl
plc/stl_gbk/FC40_RhythmCorrection.stl
_fc0_old.stl
