Yustnust/AQUA-EXPO/docs/commissioning/STEP7项目配置与Modbus整定SOP_v1.0.md

# 药液配置与加注控制系统 — STEP7项目配置清单与Modbus整定SOP v1.0

**配套文档**：《HMI-PLC变量地址表 v1.0》、《PLC-IO接线端子图 v1.0》、《Modbus通讯报文规格书 v1.0》
**适用范围**：8套缸单元PLC项目创建与现场配置
**Story**：AQEX-5 Story 1.1 I/O配置与接线实现

***

## 目录

1. [STEP7项目创建清单](#一step7项目创建清单)
2. [系统块配置](#二系统块配置)
3. [断电保持区配置](#三断电保持区配置重要)
4. [通讯端口配置](#四通讯端口配置)
5. [Modbus参数现场整定SOP](#五modbus参数现场整定sop)
6. [待厂商确认项跟踪表](#六待厂商确认项跟踪表)

***

## 一、STEP7项目创建清单

### 1.1 软件版本

- STEP 7-Micro/WIN SMART V2.5 或更高
  -操作系统：Windows 7/10 64位

### 1.2 项目创建步骤

| 步骤 | 操作 | 说明 |
| -- | --- | --- |
| 1  | 文件→新建 | 项目名：AQUA\_EXPO\_Unit\_X（X=1\~8） |
| 2  | PLC类型→CPU ST20 | 6ES7-288-1ST20-0AA0 |
| 3  | 添加扩展模块EM DT16  | 槽位1，6ES7-288-2DE08-0AA0 |
| 4  | 添加扩展模块EM DR16  | 槽位2，6ES7-288-2DR16-0AA0 |
| 5  | 配置系统块 | 见第二节 |
| 6  | 配置断电保持 | 见第三节，**关键** |
| 7  | 配置通讯端口 | 见第四节 |
| 8  | 创建符号表 | 导入变量地址表生成的CSV |
| 9  | 创建FC/OB | 逐个新建并粘贴STL代码（21个FC+OB1） |
| 10 | 编译 | 无错误才能下载 |
| 11 | 下载到PLC | 通过以太网下载 |
| 12 | 现场整定 | 按第五节SOP |

### 1.3 符号表自动生成

**方法**：用变量地址表生成的CSV模板直接导入STEP7符号表。

CSV格式：

```
符号,地址,数据类型,注释
DI_FlowSwitch_A,I0.0,BOOL,流量开关A-阀A进水
DI_FlowSwitch_B,I0.1,BOOL,流量开关B-上下转移
...
```

变量总数：73个（19DI + 9DO + 8命令位 + 8状态位 + 6VW + 24VD + 其他）

### 1.4 FC/OB创建顺序

按依赖关系创建：

| 顺序 | 类型 | 编号 | 名称 | 文件 |
| -- | -- | --- | --- | --- |
| 1  | OB | OB1 | MAIN | OB1\_MAIN.stl |
| 2  | FC | FC0 | PowerOn\_Init | FC0\_PowerOn\_Init.stl |
| 3  | FC | FC1 | State\_Dispatch | FC1\_StateDispatch.stl |
| 4  | FC | FC2 | EStop\_Handling | FC2\_EStopHandling.stl |
| 5  | FC | FC3 | Alarm\_Handling | FC3\_AlarmHandling.stl |
| 6  | FC | FC4 | Modbus\_Polling | FC4\_ModbusPolling.stl |
| 7  | FC | FC10\~FC19 | State\_Sxx | 10个状态FC |
| 8  | FC | FC20 | Manual\_Control | FC20\_ManualControl.stl |
| 9  | FC | FC30\~FC32 | Valve\_Diag | 3个阀门诊断FC |
| 10 | FC | FC40 | Rhythm\_Correction | FC40\_RhythmCorrection.stl |

***

## 二、系统块配置

打开方式：项目树→CPU ST20→系统块

### 2.1 通讯端口

| 端口 | 协议 | 参数 | 说明 |
| --- | --- | --- | --- |
| 以太网口 | TCP/IP | IP: 192.168.2.10X / 掩码: 255.255.255.0 / 网关: 192.168.2.1 | X=1\~8,8套PLC独立IP |
| 串口(P0) | Modbus RTU | 9600/8/N/1 | 用于MBUS\_CTRL(主站) |

### 2.2 数字量输入滤波

| DI组 | 滤波时间 | 原因 |
| --- | --- | --- |
| I0.0\~I0.7 | 6.4ms  | 流量开关/液位计有抖动,需滤波 |
| I1.0\~I8.0 | 12.8ms | 急停/安全继电器/阀门反馈,需更稳定 |
| I8.5\~I2.7 | 6.4ms  | 按钮/预留 |

### 2.3 脉冲捕获

- 所有DI：**禁用**（本设计无高速计数需求）

### 2.4 数字量输出

- 脉冲输出：**禁用**（无PTO/PWM需求）

- STOP模式下输出状态：**全部OFF**（失效安全）

### 2.5 模拟量输入（如有）

- 本设计无AI模块，跳过

### 2.6 日期时间

- 启用RTC（实时时钟）：**是**

- RTC电池：CPU本体内置超级电容，断电保持≥7天

### 2.7 安全

- 启用密码保护：**是**（L3管理员权限）

- 密码等级：等级4（完全控制，含上传/下载）

- 上传需密码：**是**

### 2.8 启动模式

- 启动模式：**暖启动**（RUN模式启动）

- 模块错误时动作：**STOP**（安全第一）

***

## 三、断电保持区配置（关键）

打开方式：系统块→断电保持

### 3.1 V区断电保持范围

**重要**：以下V区范围必须配置为断电保持，否则断电后数据丢失。

| 起始地址 | 结束地址 | 字节数 | 用途 | 关联Story |
| --- | --- | --- | --- | --- |
| VB0 | VB9 | 10 | 命令位+状态位(V0/V1区) | AQEX-7 |
| VB10 | VB19 | 10 | 时间戳DT10\~DT17 | AQEX-7 |
| VB200 | VB223 | 24 | Modbus映射区(VW200\~VW222) | AQEX-5 |
| VB230 | VB289 | 60 | 阀门诊断子状态/结果/PT(VW230\~VW288) | AQEX-7 |
| VB300 | VB349 | 50 | 报警字(VB300~~303)+诊断数据(VD308~~344) | AQEX-7 |
| **VB350** | **VB377** | **28** | **VD350\~374迁移参数(StepResolution/CycleSetpoint/Timeout/流量计降级值)** | **AQEX-36/AQEX-5** |
| VB500 | VB599 | 100 | 报警日志缓冲区 | AQEX-6 |

**注意 — 地址冲突规避**：

- **VB250\~VB253** 已被 HMI 参数 **VD250**（目标进水量）占用，禁止挪作他用。

- FC4 的 Modbus 轮询计数器已迁移至 **VB290\~VB297**：

  - VW290：轮询计数器

  - VW292：当前任务重试计数

  - VW294：注射泵连续失败计数

  - VW296：流量计连续失败计数

- 上述 VB290\~VB297 由 FC0 在首次扫描时初始化，无需断电保持。

### 3.2 配置操作

1. 系统块→断电保持
2. 在"断电保持"对话框中，逐个添加上述范围
3. 总计断电保持V区：**188字节**
4. ST20可用断电保持V区：**默认10KB**（足够）

### 3.3 配置验证

下载项目后，断电PLC再上电，检查：

- [ ] V0.0\~V0.7命令位保持

- [ ] V1.0\~V1.7状态位保持

- [ ] VW2状态机保持

- [ ] VW6报警码保持

- [ ] VD10\~VD140参数保持

- [ ] VD350\~VD374迁移参数保持(关键!,含流量计降级值VD374)

- [ ] VB300\~303报警字保持

- [ ] DT10\~DT17时间戳保持

### 3.4 M区位保持（可选）

| 起始 | 结束 | 用途 |
| ----- | ----- | --- |
| M0.0  | M0.7  | 急停锁存标志 |
| M10.0 | M10.7 | 状态机首次进入脉冲标志 |
| M11.0 | M11.7 | 边沿检测上一周期状态  |

**注**：M区位保持非必须（每次上电重新计算），但建议保持以避免抖动。

### 3.5 T/C位保持

- 定时器T：**不保持**（每次上电重新计时）

- 计数器C：按需保持（VW8实验轮次计数用VW8保持，不用C）

***

## 四、通讯端口配置

### 4.1 以太网口配置

| 参数 | 值 | 说明 |
| --- | --- | --- |
| IP地址 | 192.168.2.10X  | X=1\~8,每套独立 |
| 子网掩码 | 255.255.255.0  | — |
| 默认网关 | 192.168.2.1 | 如需跨网段访问 |
| 启用DHCP | 否 | 固定IP |
| 启用MODBUS TCP服务器 | 是(如HMI不支持S7协议) | 端口502 |
| 启用S7协议 | 是 | 端口102(默认) |

**8套PLC IP分配**：

| 单元  | IP地址 | MAC后缀(建议) |
| --- | --- | --- |
| 1号  | 192.168.2.101 | :01 |
| 2号  | 192.168.2.102 | :02 |
| ... | ... | ... |
| 8号  | 192.168.2.108 | :08 |

### 4.2 串口(P0)配置

| 参数 | 值 | 说明 |
| ---- | --- | --- |
| 协议 | Modbus RTU | 由MBUS\_CTRL指令配置 |
| 波特率  | 9600 | 由MBUS\_CTRL配置 |
| 数据位  | 8 | — |
| 停止位  | 1 | — |
| 校验 | 无 | 由MBUS\_CTRL配置 |
| 串口模式 | Modbus主站 | 由MBUS\_CTRL Mode=1 |

**注**：串口参数在FC4中通过MBUS\_CTRL指令动态配置，系统块中无需单独配置。

#### 4.2.1 DB9接线定义（CPU ST20 Port 0）

| DB9针脚 | 信号 | PLC侧定义 | 说明 |
| ----- | --- | --- | --- |
| Pin 3 | RS485 B | RS485信号B（部分厂商标为B-/B） | — |
| Pin 8 | RS485 A | RS485信号A（部分厂商标为A+/A） | — |
| Pin 5 | GND | 信号地 | 屏蔽层单端接地 |

**现场实测有效接线（1号单元，BPM32FC积算仪）**：

- PLC DB9 Pin 3 → 积算仪 A+

- PLC DB9 Pin 8 → 积算仪 B-

- PLC DB9 Pin 5 → 积算仪 GND

> 注意：不同厂商对 A/B 或 A+/B- 的标法可能相反。若通讯无数据，可先对调 Pin 3 与 Pin 8 测试。

### 4.3 HMI连接配置（昆仑通态MCGS侧）

| 连接编号 | PLC IP | 协议 | 端口 | 备注 |
| ---- | --- | --- | --- | ---- |
| 连接1  | 192.168.2.101 | S7 / Modbus TCP | 102 / 502 | 1号单元 |
| 连接2  | 192.168.2.102 | 同上 | 同上 | 2号单元 |
| ...  | ... | ... | ... | ...  |
| 连接8  | 192.168.2.108 | 同上 | 同上 | 8号单元 |

**协议选择**：

- 优先S7协议（昆仑通态支持）

- 若S7协议不支持8连接，PLC侧启用MBUS\_SERVER（Modbus TCP从站）

***

## 五、Modbus参数现场整定SOP

### 5.1 整定前准备

1. **接线检查**：

   - [ ] Modbus RTU通讯线屏蔽层单端接地（PLC侧）

   - [ ] DB9接头3/5/8脚焊接正确（Pin3→A+，Pin8→B-，Pin5→GND，见4.2.1节）

   - [ ] 终端电阻120Ω已安装在总线两端（首末设备）

2. **设备上电**：

   - [ ] PLC上电，RUN灯常亮

   - [ ] 注射泵控制器上电

   - [ ] 流量计上电

3. **设备地址确认**：

   - [ ] 注射泵Modbus地址=1（按设备厂商手册配置）

   - [ ] 流量计Modbus地址=2

   - [ ] 总线无地址冲突

### 5.2 整定流程

#### 阶段1：单设备测试

**目标**：用Modbus Poll软件单独测试每个从站。

1. 断开其他设备，仅PLC+1个从站
2. 用Modbus Poll软件（PC直连PLC串口或USB转串口）：

   - 设置串口：9600/8/N/1

   - 设置从站地址：1（注射泵）

   - 读取40001（状态码，应返回0=空闲）
3. 若超时/错误：

   - 检查接线（2/3是否接反）

   - 检查波特率（9600是否与设备一致）

   - 检查校验位（无/偶/奇）

   - 检查从站地址
4. 重复测试从站2（流量计）

#### 阶段2：双设备总线测试

1. PLC+注射泵+流量计同时挂在Modbus总线
2. 用Modbus Poll分别测试2个从站
3. 若某个从站失败：

   - 检查终端电阻（120Ω）

   - 检查总线长度（≤1200m）

   - 检查分支长度（≤1m）

#### 阶段3：PLC轮询测试

1. PLC下载程序（含FC4）
2. 监控VW4（注射泵状态码）：应周期性更新
3. 监控VD86（流量计累计值）：应周期性更新
4. 监控VW204\~VW212（注射泵步数/速度）：应周期性更新
5. 用STEP7状态图监控VW250（轮询计数器0\~3循环）
6. 用STEP7状态图监控M10.0\~M10.3（Done位周期性变化）

#### 阶段4：故障注入测试

**测试1：注射泵断电**

1. 断开注射泵电源
2. 等待30秒（10秒超时×3次重试）
3. 观察：

   - V303.4置位（注射泵故障报警）

   - M10.4置位（连续5次失败后降级模式）

   - VW4保持上一有效值
4. 恢复注射泵电源
5. 观察：

   - V303.4复位（通讯恢复）

   - M10.4复位（退出降级模式）

   - VW4恢复实时更新

**测试2：流量计断电**

1. 断开流量计电源
2. 等待30秒
   ~~3. 观察：V303.6置位~~ **2026-09-08已删除**
   ~~4. 恢复：V303.6复位~~ **2026-09-08已删除**

**测试3：通讯线干扰**

1. 在Modbus线附近放置运行中的变频器
2. 观察VB379/VB384错误码是否增加
3. 若频繁超时：

   - 增加FC4超时时间（T50/T51从100→200，即20秒）

   - 加强屏蔽（双层屏蔽线）

   - 重新走线（远离动力线）

### 5.3 整定参数表

| 参数 | 默认值 | 调整范围 | 调整依据 |
| --- | --- | --- | --- |
| MBUS\_CTRL Timeout | 1000ms | 500\~3000ms | 总线响应时间 |
| FC4 T50/T51超时 | 10秒(100×100ms) | 5\~30秒 | 设备响应时间 |
| 重试次数 | 3次 | 2\~5次 | 总线稳定性  |
| 连续失败降级阈值 | 5次 | 3\~10次 | 容忍度 |
| 轮询周期 | \~1秒 | 0.5\~5秒 | 数据刷新需求 |

### 5.4 整定记录表

| 整定项 | 整定前 | 整定后 | 整定人 | 日期 |
| --- | --- | --- | --- | -- |
| 注射泵Timeout | 1000ms | — | — | —  |
| 流量计Timeout | 1000ms | — | — | —  |
| FC4 T50超时  | 10秒 | — | — | —  |
| FC4 T51超时  | 10秒 | — | — | —  |
| 重试次数 | 3次 | — | — | —  |
| 降级阈值 | 5次 | — | — | —  |

***

## 六、待厂商确认项跟踪表

以下参数需设备厂商确认后才能最终整定，FC4中已用默认值占位，待确认后调整。

### 6.1 注射泵（厂商：南京润泽，协议V1.7）

| 参数 | 默认值 | 待确认 | 关联Jira  | 状态  |
| --- | --- | --- | --- | --- |
| 单步分辨率 | 0.2083 µL/步 | 实际值（按5ml进样器核实） | AQEX-20 | 待回复 |
| 启动速度 | 50 Hz | 实际推荐值 | — | 待回复 |
| 最高速度 | 200 Hz | 实际最大值 | — | 待回复 |
| 截止速度 | 20 Hz | 实际推荐值 | — | 待回复 |
| Modbus寄存器41001状态码 | 已确认 | 状态码2/3的具体含义 | AQEX-23 | 待回复 |
| 步数寄存器40006/40007  | 已确认 | 双字写入顺序(低字/高字)  | — | 待回复 |

### 6.2 流量计（厂商：待定）

| 参数 | 默认值 | 待确认 | 关联Jira  | 状态  |
| --- | --- | --- | --- | --- |
| 清零功能 | 0x0017 | 是否支持远程清零 | AQEX-21 | 待回复 |
| 累计单位 | L | 实际配置(m³/L/mL) | AQEX-22 | 待回复 |
| 寄存器溢出行为  | 32位回绕  | 32位溢出后行为 | AQEX-23 | 待回复 |
| 瞬时流量地址 | 0x0017 | 是否支持瞬时流量 | — | 待回复 |
| Modbus地址 | 2 | 实际地址(可现场配置) | — | 待回复 |

### 6.3 昆仑通态MCGS（厂商：昆仑通态）

| 参数 | 默认值 | 待确认 | 关联Jira  | 状态  |
| --- | --- | --- | --- | --- |
| S7协议8连接支持 | 待定  | 是否支持8连接S7协议 | AQEX-24 | 待回复 |
| Modbus TCP从站 | 待定  | 若S7不支持8连接,需启用 | AQEX-24 | 待回复 |
| 12寸屏Flash容量  | 4GB | 实际存储容量 | — | 待回复 |
| 数据采样间隔 | 1分钟 | 最小支持间隔 | — | 待回复 |

### 6.4 处理流程

1. 厂商回复后，更新本表"实际值"列
2. 同步更新FC4中对应参数（如分辨率VW208等）
3. 同步更新变量地址表v1.1
4. 重新整定Modbus参数（按第五节SOP）
5. 在Jira对应任务单中评论确认结果，关闭AQEX-20\~24

***

## 附录A：8套PLC配置差异表

8套PLC程序完全相同，仅以下配置不同：

| 配置项 | 1号 | 2号 | 3号 | 4号 | 5号 | 6号 | 7号 | 8号 |
| --- | --- | --- | --- | --- | --- | --- | --- | --- |
| IP地址 | .101 | .102 | .103 | .104 | .105 | .106 | .107 | .108 |
| HMI连接号 | 1 | 2 | 3 | 4 | 5 | 6 | 7 | 8 |
| MAC后缀  | :01 | :02 | :03 | :04 | :05 | :06 | :07 | :08 |
| 控制柜编号  | CAB-01 | CAB-02 | CAB-03 | CAB-04 | CAB-05 | CAB-06 | CAB-07 | CAB-08 |
| 项目名 | AQUA\_EXPO\_Unit\_1 | ... | ... | ... | ... | ... | ... | AQUA\_EXPO\_Unit\_8 |

**注**：其他所有配置（系统块/断电保持/通讯参数/STL代码）完全相同。

***

## 附录B：项目导入Checklist

- [ ] STEP7-Micro/WIN SMART V2.5+已安装

- [ ] 新建项目，PLC类型选CPU ST20

- [ ] 添加EM DT16到槽位1

- [ ] 添加EM DR16到槽位2

- [ ] 系统块→通讯端口配置IP(192.168.2.10X)

- [ ] 系统块→断电保持配置全部范围(第三节)

- [ ] 系统块→DI滤波配置(6.4ms/12.8ms)

- [ ] 系统块→STOP模式输出全OFF

- [ ] 系统块→启动模式=暖启动

- [ ] 系统块→密码等级4(L3管理员)

- [ ] 符号表导入CSV(73个变量)

- [ ] 创建OB1+21个FC,粘贴STL代码

- [ ] 编译无错误

- [ ] 下载到PLC

- [ ] PLC RUN灯常亮

- [ ] Modbus整定(第五节SOP)

- [ ] 8套PLC按附录A分配IP

***

***

## 附录C：FC4\_ModbusPolling 实际调试日志与问题汇总

> 记录日期：2026-09-06 \~ 2026-09-08
> 调试对象：S7-200 SMART CPU ST20 + 注射泵（从站1）+ 流量计（从站2）
> 调试前状态：MCGS Pro 旧程序 Modbus 通讯正常；新 STL 程序 FC4 完全重写
> 调试后状态：VW4（注射泵状态码=96）、VD86（流量计瞬时流量）正常更新；Error=0；V303.4/V303.6 报警已删除

### C.1 最终稳定的 FC4 程序结构（STEP7 手动 LAD 绘制）

FC4 直接在 STEP7 中用 LAD 手动搭建。原因：STEP7 导入 STL 会合并 NETWORK、丢失代码、篡改 LBL 编号；且 LAD 中 MBUS\_MSG 的 Addr/Count/DataPtr 必须是常量，无法像 STL 那样用变量动态切换。

**NETWORK 1**：MBUS\_CTRL（初始化，9600/8/N/1，Timeout=1000ms）

```
LD SM0.0
CALL MBUS_CTRL, SM0.0, 9600, 16#00, 16#00, 1000, M11.0, VB378
```

**NETWORK 2\~4**：T101 2秒脉冲发生器（TON + 自复位）

```
LD  SM0.0
TON T101, 20          // PT=20 × 100ms = 2s

LD  T101
=   M14.6             // 脉冲输出（1个扫描周期）
R   T101, 1           // 自复位
```

**NETWORK 5**：参数选择（根据 VW290 任务号动态写入 VB400\~VW406）

- VW290=0 → VB400=1, VD402=16#A029（41001 注射泵状态）, VW406=1

- VW290=1 → VB400=2, VD402=16#9C49（40009 流量计流量）, VW406=2

**NETWORK 6**：MBUS\_MSG（单块，First 接 M14.6，动态参数来自 VB400\~VW406）

```
CALL MBUS_MSG, M14.6, 16#01, VB400, VD402, VW406, &VB410, M10.0, VB379
```

- First 接 M14.6（T101 的 1 扫描周期脉冲，自动实现"每 2 秒触发一次"）

- 从站地址、寄存器地址、数量全部来自 VB400\~VW406 变量（LAD 中用 MOV 赋值）

- **不再使用多个 MBUS\_MSG 调用**，彻底避免库状态机竞争

**NETWORK 8~~10 / 11~~13 / 15\~17**：任务完成/失败处理

- 任务0成功：R M10.0 → MOVW VW410, VW4 → INC VW500 → MOVW 1, VW290

- 任务0失败：INC VW292 → R M10.0

- 任务1成功：R M14.0 → MOVD VD410, VD86 → INC VW502 → MOVW 2, VW290

- 任务1失败：INC VW294 → R M14.0

- 任务2成功：R M10.1 → MOVW VW410, VW222 → INC VW504 → MOVW 0, VW290

- 任务2失败：INC VW296 → R M10.1

- 注射泵成功：MOVW VB410, VW4；SWAP VW4（16 位字交换）

- 流量计成功：MOVD VB410, VD86（32 位直接搬运，MBUS\_MSG 已处理字节顺序）

**任务切换已合并到各任务成功处理网络末尾**

**FC0 首次扫描配合**（冷启动路径内）：

```
FILL 0, VW600, 143    // VB600~VB885 清零（Modbus 库存储区）
MOVB 0, VB378         // 清 MBUS_CTRL Error
MOVB 0, VB379         // 清 MBUS_MSG Error
R M10.0, 6            // 清 M10.0~M10.5（Done 位）
R M11.0, 1            // 清 MBUS_CTRL Done 位
```

### C.2 踩过的坑（按时间顺序）

| #  | 现象 | 根因 | 修复 |
| -- | --- | --- | --- |
| 1  | FC4 下载后程序变样（NETWORK 合并、指令丢失、LBL 被重新编号）  | **STEP7 导入 STL 有 bug**：它会尝试重新解析 STL，合并 NETWORK、丢失代码、把 LBL 改名 | **不在 STEP7 中导入 stl 文件**，改为 LAD 手动搭建 FC4 |
| 2  | PLC 下载后直接 STOP，报扫描看门狗超时（错误码 001A） | FC4 内 JMP 21 向后跳到 LBL 21 形成死循环 | 删除 LBL 21 和中间代码，JMP 21 改为 MOVW 0, VW290 |
| 3  | MBUS\_MSG 报 Error=6（Modbus 忙） | **库存储区有残留状态机**（断电保持），上一次 STOP/RUN 后库状态未清零 | FC0 首次扫描 FILL 0, VW600, 143；PLC 物理断电复位（STOP→RUN 不够） |
| 4  | MBUS\_MSG 报 Error=6 且频繁跳变 | 多个 MBUS\_MSG 块同时触发，库状态机竞争 | **重构为单 MBUS\_MSG 块**，通过变量动态选择参数 |
| 5  | MBUS\_MSG 报 Error=3（超时） | A/B 线序接反；未共地；或从站响应慢 | 对调 A/B 线；共地；Timeout 调到 3000ms+ |
| 6  | T63/T37 定时器不工作（恒为 0） | **定时器冲突**：T37 被 FC11\_State\_S1\_Inlet 占用；T40 被 FC15\_State\_S4\_Transfer 占用 | 换用空闲定时器 **T101**（100ms 时基，PT=20 即 2s） |
| 7  | VW290 固定为 0，T101 在计数但 MBUS\_MSG 不触发 | M14.7 计算顺序错误导致 T101 驱动失效；TON 指令栈操作问题 | 把 M14.7 的计算放到 T101 驱动之前；T101 改为直接 SM0.0 驱动 |
| 8  | MBUS\_MSG 寄存器地址 Error | MBUS\_MSG 的 Addr 参数**必须用十六进制常量**（16#9C49 = 40009），不能用十进制（40009 会被解析为 INT） | 统一用 16# 前缀，如 `16#9C49`, `16#A029` |
| 9  | MBUS\_MSG 的 Error 引脚报错 | **Error 必须接 BYTE 地址**，不能接字地址 | VB379, VB380 都是 VB 字节 |
| 10 | MBUS\_MSG 的 Count 参数 Error | Count 必须是**整数常量**，不能是浮点数 | `VW406` 存 INT |
| 11 | MBUS\_MSG 第一次成功后 Done=1 保持，第二次写请求无法触发 | **写 Done 位必须手动清零**，否则 NOT M20.2 恒为 0 | R M10.0, 1 在每次使用前执行 |
| 12 | 注射泵状态码读出来是 24576，不是 96 | 16 位字的字节顺序反了 | **SWAP VW4**（每个扫描周期执行会导致数据跳变，只应在 Done 上升沿执行一次，或干脆不 SWAP——MBUS\_MSG 已自动处理 16 位顺序） |
| 13 | 流量计 VD86 读出来是 6307840 而非 833 | 32 位浮点数据的字节顺序需要**交换高低字 + SWAP 字内字节** | 但 S7-200 SMART 实际**无需手动 SWAP**（MBUS\_MSG 自动处理 16 位），直接 MOVD 即可 |
| 14 | LDN 指令用于字操作数报编译错误 36 | LDN 是位指令，不能用于字地址 | 改用 LDW<> / LDW= 等字比较指令 |
| 15 | FC21 使用 LPS/ALD/LPP 嵌套导致 PLC 栈溢出 STOP | 第二次 ALD 执行时栈深度不足 | 删除 LPS/ALD/LPP 嵌套，改为平面 AND 串联 |
| 16 | MBUS\_CTRL 的 Mode 引脚接错 | Mode 是**输入触点**，RTU 模式应接常开触点如 SM0.0 | `CALL MBUS_CTRL, SM0.0, 9600, ...` |
| 17 | FC4 同时读写 V303.4 和 V303.6，与 FC3 冲突 | 静态分析报告警告 | FC4 删除对 V303.4/V303.6 的写操作，FC3 也删除 V303.6（2026-09-08） |
| 18 | Modbus 轮询计数器和 HMI VD250 地址冲突 | VW250/VW252 与 HMI 目标进水量 VD250 重叠 | **迁移到 VW290/VW292/VW294/VW296** |
| 19 | 注射泵抽液/排液后状态变 100，需等 VW192 回到 96 | 注射泵就绪态 = 96（不是 64）；连续发命令会导致状态混乱 | 写命令前检查 VW192=96（M21.4=1）；用强停 40002=1 可强制恢复 |
| 20 | 注射泵复位电流不足，活塞无动作 | 电源或复位参数问题 | 检查 24V 电源电流，调整复位电流参数 |
| 21 | 注射泵上电默认状态 96，无需复位命令 | 连续发命令反而会导致状态混乱 | 上电后等待 1-2s 再发送命令 |
| 22 | MBUS\_MSG 读 First 脉冲间隔必须 > Timeout | 读 First 间隔 = T37 周期 2s < MBUS\_CTRL Timeout 1000ms，导致读请求被反复取消 | T37 改成 T101（2s PT=20），或 Timeout 降到 500ms |
| 23 | FC3 NETWORK 7 的 V303.6 抖动检测**误报**严重 | C240 计数器和 M11.3\~M11.5 状态标志掉电保持有残留值；阈值 5 偏低 | 先后尝试：FC0 初始化清零、阈值改 10、均无法根治；**最终方案：删除 V303.6 报警**，三个流量开关各自有独立报警位 |
| 24 | PLC STOP → RUN 后 FC4 不执行 M14.5/M14.7 触发 | SM0.1 仅首次扫描 ON，但 M14.5/M14.7 是标志位需手动触发 | 在 RUN 后手动置位 M14.5 一次即可启动轮询链 |

### C.3 关键地址分配速查表（已验证无冲突）

| 变量 | 地址 | 类型 | 说明 |
| --- | --- | ----- | --- |
| MBUS\_CTRL | — | — | 存储区 **VB600\~VB885**（286 字节=143 字） |
| MBUS\_CTRL Error | VB378 | BYTE  | <br /> |
| MBUS\_CTRL Done  | M11.0 | BIT | <br /> |
| MBUS\_MSG Error  | VB379（注射泵）/ VB380（流量计） | BYTE  | **必须是 VB，不能是 VW** |
| MBUS\_MSG Done | M10.0（注射泵）/ M14.0（流量计） | BIT | 每周期 Done 必须手动 R 清零 |
| MBUS\_MSG First  | M14.6 | BIT | T101 脉冲（1 扫描周期） |
| 轮询任务号 | VW290 | INT | 0=注射泵, 1=流量计 |
| 参数存储 | VB400\~VW406 | 混合 | VB400=从站地址, VD402=寄存器地址, VW406=数量 |
| 数据缓冲 | VB410\~ | — | MBUS\_MSG 读回来的数据 |
| 注射泵状态 | VW4 | INT | 96=就绪, 64=空闲, 100=运动中 |
| 流量计流量 | VD86 | REAL  | MBUS\_MSG 直接 MOVD，无需手动 SWAP |
| 定时器 | T101 | 100ms | PT=20（2 秒脉冲） |
| T101 避免冲突 | — | — | T37 被 FC11 用；T40 被 FC15 用；T63/T42 空闲，T101 也空闲 |

### C.4 最终确定的编程原则（避免下次重踩）

1. **STEP7 不要导入 STL**：FC4/FC99 等复杂 FC 直接用 LAD 手动绘制。STL 导入会合并 NETWORK、丢失代码、篡改 LBL。
2. **单 MBUS\_MSG 块，参数动态选择**：避免多块库状态机竞争。
3. **First 脉冲必须是 1 扫描周期**：TON+自复位的 M14.6 天然满足，不要加 P/EU 触点。
4. **Done 必须手动清零**：R M10.0, 1 在每次使用前执行，不要依赖自动复位。
5. **库存储区首次扫描必须清零**：FILL 0, VW600, 143。V 区断电不丢，残留状态机是 Error=6 的头号元凶。
6. **Error 引脚必须接 VB 字节**，Count 必须是整数常量，Addr 必须用 16# 十六进制。
7. **定时器使用前必须检查其他 FC 是否占用**：STEP7 没有全局搜索定时器用法的快捷方式，需要逐个 FC 打开看。
8. **32 位浮点数据不要手动 SWAP**：MBUS\_MSG 已自动处理 16 位字顺序；如果读取数据明显是字节反序，检查从站是否返回大端/小端。
9. **STL 指令限制**：不支持 L# 前缀、LDN 不能用于字类型、JMP/LBL 只能数字 0\~255、RTC 用 TODR 不用 READ\_RTC（LAD 才用 READ\_RTC）。
10. **Modbus RTU 总线上只能有一个 Master**：PLC 与调试工具（Modbus Poll）不能同时在线。
11. **V303.6 流量开关瞬时异常报警已删除**（2026-09-08）：三个流量开关各自有独立报警位 V301.0\~V303.1，抖动检测逻辑（2 秒窗口≥5 次翻转）误报严重且无法根治。
12. **FC0 冷启动路径和断电恢复路径都要做必要初始化**：Modbus 库存储区清零不区分冷启动/断电恢复，STOP→RUN 后库状态机必须复位。

### C.5 S7-200 SMART RTU 接线确认（实际调通的线序）

| PLC 端 | 说明 | 对端 |
| --- | --- | --- |
| Port 0 Pin 3 | A+（数据线 +） | 从站 DA+ |
| Port 0 Pin 8 | B-（数据线 -） | 从站 DB- |
| Port 0 Pin 5 | GND（共地） | 从站 GND |

线序错误现象：MBUS\_MSG 立即报 Error=3（超时），无其他错误码。对调 A/B 线或共地后立即正常。

***

**文档结束**

**待办事项**：

1. 厂商回复后更新第六节待确认项
2. 现场整定完成后填写5.4整定记录表
3. 8套PLC批量配置按附录A执行
4. ~~V303.6 流量开关瞬时异常报警已删除（2026-09-08），原整定记录表相关行同步删除~~
