Yustnust/AQUA-EXPO/docs/commissioning/PLC-IO接线端子图_v1.0.md

# 药液配置与加注控制系统 — PLC I/O 接线端子图 v1.0

**配套文档**：《HMI-PLC变量地址表 v1.0》第二/三章、《PLC设计文档》第二章
**适用硬件**：西门子 S7-200 SMART CPU ST20 (6ES7-288-1ST20-0AA0) + EM DT16 (6ES7-288-2DE08-0AA0) + EM DR16 (6ES7-288-2DR16-0AA0)
**单元编号**：本图适用于1~8号任一单元（区别仅在IP地址）
**Story**：AQEX-5 Story 1.1 I/O配置与接线实现

---

## 目录

1. [硬件配置总览](#一硬件配置总览)
2. [本体ST20端子分配](#二本体st20端子分配)
3. [扩展模块EM DT16端子分配](#三扩展模块em-dt16端子分配仅di)
4. [扩展模块EM DR16端子分配](#四扩展模块em-dr16端子分配di-do混合)
5. [供电与接地](#五供电与接地)
6. [中间继电器接线](#六中间继电器接线有源信号转换)
7. [屏蔽与走线](#七屏蔽与走线规范)

---

## 一、硬件配置总览

### 1.1 模块清单

| 位置 | 模块型号 | 订货号 | DI | DO | 备注 |
|---|---|---|---|---|---|
| 本体 | CPU ST20 | 6ES7-288-1ST20-0AA0 | 12 | 8 | DC/DC/DC |
| 扩展1 | EM DT16 | 6ES7-288-2DE08-0AA0 | 8 | — | 纯DI扩展(信号板槽位空) |
| 扩展2 | EM DR16 | 6ES7-288-2DR16-0AA0 | 8 | 8 | DI+继电器DO混合 |
| **合计** | — | — | **28** | **16** | 实际使用 19DI + 9DO |

### 1.2 物理地址映射规则

- 本体DI: I0.0~I0.7, I1.0~I8.0 (12点)
- 本体DO: Q0.0~Q0.7 (8点)
- EM DT16 DI: I8.5~I2.7 (8点)
- EM DR16 DI: I3.0~I3.7 (8点) — **本设计未使用,全部预留**
- EM DR16 DO: Q2.0~Q2.7 (8点) — **本设计未使用,全部预留**

**注**：本设计实际只用本体12DI+8DO + EM DT16 8DI = 19DI+8DO，EM DR16为预留扩展（首期1套配齐，后续如需扩展泵2手动/报警扩展/备用阀门可启用）。

### 1.3 接线原则速查

| 信号类型 | 接入方式 | 是否需中间继电器 |
|---|---|---|
| 无源常开触点（流量开关/液位计/按钮） | 直接接入PLC自身24VDC回路 | 否 |
| 急停常闭触点 | 直接接入（常闭型，ON=正常） | 否 |
| 安全继电器强制导向触点 | 直接接入 | 否 |
| 阀门限位反馈（有源正极输出） | **必须经中间继电器转换** | **是** |
| DO驱动负载 | **必须经继电器转换** | **是** |
| 安全继电器线圈 | DO驱动，强制导向型 | — |

---

## 二、本体ST20端子分配

### 2.1 DI端子（I0.0~I8.0，共12点）

**电源**：所有无源触点型DI共用PLC本体24VDC传感器电源（L+ / M）。

| 端子号 | PLC地址 | 符号 | 信号来源 | 信号类型 | 线径mm² | 颜色 | 接线说明 |
|---|---|---|---|---|---|---|---|
| 0.0 | I0.0 | DI_FlowSwitch_A | 流量开关A | 无源常开 | 0.75 | 蓝 | 触点一端→I0.0，另端→24V L+ |
| 0.1 | I0.1 | DI_FlowSwitch_B | 流量开关B | 无源常开 | 0.75 | 蓝 | 同上 |
| 0.2 | I0.2 | DI_FlowSwitch_C | 流量开关C | 无源常开 | 0.75 | 蓝 | 同上 |
| 0.5 | I0.5 | DI_LevelA_High | 液位计A-高位 | 无源常开 | 0.75 | 蓝 | 同上 |
| 0.6 | I0.6 | DI_LevelA_Low | 液位计A-低位 | 无源常开 | 0.75 | 蓝 | 同上 |
| 0.7 | I0.7 | DI_LevelB_High | 液位计B-高位 | 无源常开 | 0.75 | 蓝 | 同上 |
| 1.0 | I1.0 | DI_LevelB_Low | 液位计B-低位 | 无源常开 | 0.75 | 蓝 | 同上 |
| 1.1 | I1.1 | DI_EStop | 急停反馈 | **常开 NO** | 0.75 | 蓝 | 急停按钮 NO 触点(v1.3 接法);ON=急停触发,OFF=正常 |
| 1.2 | I1.2 | DI_SafetyRelay_FB | 安全继电器反馈 | 干接点 | 0.75 | 蓝 | MSR-P 13/14 反馈触点(v1.3 替换 PNOZ s4);急停触发时闭合,ON=动力已切断确认 |
| 1.3 | I8.0 | DI_ValveA_Open | 阀A开到位 | **继电器转换后** | 0.75 | 蓝 | 来自中间继电器KA1常开 |

**公共端**：1M接24V 0V (M)，2M接24V 0V (M)。

### 2.2 DO端子（Q0.0~Q0.7，共8点，晶体管输出）

**重要**：ST20 DO为晶体管输出，**严禁直接驱动负载**，必须经中间继电器隔离。

| 端子号 | PLC地址 | 符号 | 驱动中间继电器 | 继电器触点负载 | 线径mm² | 颜色 |
|---|---|---|---|---|---|---|
| 0.0 | Q0.0 | DO_Pump1 | KA1 | 潜水泵1接触器线圈 | 0.75 | 红 |
| 0.1 | Q0.1 | DO_Pump2 | KA2 | 潜水泵2接触器线圈 | 0.75 | 红 |
| 0.2 | Q0.2 | DO_ValveA | KA3 | 电动球阀A开/关接触器 | 0.75 | 红 |
| 0.3 | Q0.3 | DO_ValveB | KA4 | 电动球阀B开/关接触器 | 0.75 | 红 |
| 0.4 | Q0.4 | DO_ValveC | KA5 | 电动球阀C开/关接触器 | 0.75 | 红 |
| 0.5 | Q0.5 | DO_NCValve_Top | KA6 | NC球阀-上缸 | 0.75 | 红 |
| 0.6 | Q0.6 | DO_NCValve_Bottom | KA7 | NC球阀-下缸 | 0.75 | 红 |
| 0.7 | Q0.7 | DO_Alarm_Sound | KA8 | 报警蜂鸣器 | 0.75 | 红 |

**公共端**：1L+接24V L+，2L+接24V L+，1M/2M接24V 0V (M)。

**注**：Q8.0(DO_Alarm_Light)在本体已无端子可用，迁移至EM DR16的Q2.0输出（见4.3节）。

---

## 三、扩展模块EM DT16端子分配（仅DI）

**模块位置**：扩展槽位1
**型号**：6ES7-288-2DE08-0AA0（8DI，DC24V）
**地址**：I8.5~I2.7

| 端子号 | PLC地址 | 符号 | 信号来源 | 信号类型 | 线径mm² | 颜色 |
|---|---|---|---|---|---|---|
| 2.0 | I8.5 | DI_ValveC_Close | 阀C关到位 | **继电器转换后** | 0.75 | 蓝 |
| 2.1 | I0.4 | DI_Btn_Mute | 消音按钮 | 无源常开点动 | 0.75 | 蓝 |
| 2.2 | I2.2 | —（备用） | 预留 | — | — | — |
| 2.3 | I0.3 | DI_Btn_SystemReset | 系统复位按钮 | 无源常开点动 | 0.75 | 蓝 |
| 2.4 | I2.4 | —（预留扩展） | — | — | — | — |
| 2.5 | I2.5 | —（预留扩展） | — | — | — | — |
| 2.6 | I2.6 | —（预留扩展） | — | — | — | — |
| 2.7 | I2.7 | —（预留扩展） | — | — | — | — |

**公共端**：1M接24V 0V (M)。

**预留说明**：I2.4~I2.7共4点预留，用于：
- 注射泵故障反馈（来自泵控制器无源触点）
- 注射泵到位反馈（抽液/排液完成）
- 流量计故障反馈
- 第9~16号扩展单元使能信号（如启用）

---

## 四、扩展模块EM DR16端子分配（DI+DO混合）

**模块位置**：扩展槽位2
**型号**：6ES7-288-2DR16-0AA0（8DI + 8继电器DO）
**地址**：DI为I3.0~I3.7（**本设计未使用，全部预留**），DO为Q2.0~Q2.7

### 4.1 DI端子（I3.0~I3.7，全部预留）

| 端子号 | PLC地址 | 用途 |
|---|---|---|
| 3.0~3.7 | I3.0~I3.7 | 预留扩展（未接线） |

### 4.2 DO端子（Q2.0~Q2.7，继电器输出）

**重要**：EM DR16为继电器输出，可直接驱动小功率负载（≤2A/点），但仍建议经中间继电器隔离以保护PLC。

| 端子号 | PLC地址 | 符号 | 驱动中间继电器 | 继电器触点负载 | 线径mm² | 颜色 |
|---|---|---|---|---|---|---|
| 2.0 | Q2.0 | DO_Alarm_Light | KA9 | 报警指示灯 | 0.75 | 红 |
| 2.1 | Q2.1 | —（预留） | — | — | — | — |
| 2.2 | Q2.2 | —（预留） | — | — | — | — |
| 2.3 | Q2.3 | —（预留） | — | — | — | — |
| 2.4 | Q2.4 | —（预留） | — | — | — | — |
| 2.5 | Q2.5 | —（预留） | — | — | — | — |
| 2.6 | Q2.6 | —（预留） | — | — | — | — |
| 2.7 | Q2.7 | —（预留） | — | — | — | — |

**预留说明**：Q2.1~Q2.7共7点预留，用于：
- 第2台潜水泵扩展（如启用）
- 注射泵启停控制（如不通过Modbus）
- 远程指示灯（绿灯运行/黄灯暂停）
- 第9~16号单元扩展

### 4.3 关于Q8.0(DO_Alarm_Light)的迁移说明

变量地址表第三章标注Q8.0为报警灯光。但ST20本体只有Q0.0~Q0.7共8点DO，Q8.0实际不存在。**本设计将DO_Alarm_Light迁移至EM DR16的Q2.0输出**，符号和地址需在STEP7符号表中同步更新：

| 变量表原地址 | 实际地址 | 符号 | 说明 |
|---|---|---|---|
| Q8.0 | **Q2.0** | DO_Alarm_Light | 报警灯光，迁移至EM DR16 |

**待办**：下次变量地址表迭代时同步更新Q8.0→Q2.0。

---

## 五、供电与接地

### 5.1 供电回路

```
┌─────────────────────────────────────────────────────────┐
│  AC220V总电源 → 断路器QF1(2P 16A)                       │
│      ├→ 开关电源AC220V/DC24V(10A)                        │
│      │     ├→ PLC本体L+/M(24V DC供电)                    │
│      │     ├→ 传感器电源(DI公共端)                       │
│      │     ├→ 中间继电器线圈电源(KA1~KA9)                │
│      │     └→ HMI供电                                    │
│      ├→ 安全继电器线圈(AQEX-9 急停回路,220V)             │
│      └→ 负载电源(泵/阀/报警器,经接触器/继电器隔离)       │
└─────────────────────────────────────────────────────────┘
```

### 5.2 接地规范

| 接地点 | 接地类型 | 接地电阻 | 说明 |
|---|---|---|---|
| PLC本体PE端子 | 保护接地 | ≤4Ω | 必须接地，导线≥2.5mm²黄绿 |
| 开关电源PE | 保护接地 | ≤4Ω | 与PLC共地 |
| 屏蔽层接地 | 屏蔽接地 | — | 单端接地（PLC侧），避免地环路 |
| 安全继电器PE | 保护接地 | ≤4Ω | 独立接地点 |
| 控制柜PE排 | 等电位接地 | ≤1Ω | 所有PE汇总至PE排 |

### 5.3 电源容量核算

| 负载 | 电流 | 数量 | 小计 |
|---|---|---|---|
| PLC本体 | 0.3A | 1 | 0.3A |
| EM DT16 | 0.05A | 1 | 0.05A |
| EM DR16 | 0.1A | 1 | 0.1A |
| HMI(昆仑通态12寸) | 0.5A | 1 | 0.5A |
| 中间继电器线圈 | 0.04A | 9 | 0.36A |
| 传感器(DI功耗) | 0.01A | 19 | 0.19A |
| **合计** | — | — | **1.5A** |

**结论**：开关电源选10A规格，余量8.5A，满足扩展需求。

---

## 六、中间继电器接线（有源信号转换）

### 6.1 阀门限位反馈转换（4路，KA10~KA13）

阀门限位反馈为**有源正极输出**（24VDC），不能直接接入PLC DI（PLC DI共享24V回路，会短路）。必须经中间继电器转换：

```
阀门限位反馈(有源24V+)
       │
       ↓
    KA10线圈(24V)
       │
    0V(阀门公共)
       
KA10常开触点:
    一端 → 24V L+
    另端 → PLC I8.0(I8.1/I8.2/I8.3/I8.4同理)
```

| 中间继电器 | 线圈电源 | 触点接入 | 对应DI |
|---|---|---|---|
| KA10 | 阀A限位24V+ | 常开→I8.0 | DI_ValveA_Open |
| KA11 | 阀A限位24V+(关到位另一组) | 常开→I8.1 | DI_ValveA_Close |
| KA12 | 阀B限位24V+ | 常开→I8.2 | DI_ValveB_Open |
| KA13 | 阀B限位24V+(关到位另一组) | 常开→I8.3 | DI_ValveB_Close |
| KA14 | 阀C限位24V+ | 常开→I8.4 | DI_ValveC_Open |
| KA15 | 阀C限位24V+(关到位另一组) | 常开→I8.5 | DI_ValveC_Close |

**选型**：DC24V线圈，触点≥5A，导轨式（如欧姆龙MY2NJ-DC24 + PYF08A底座）。

### 6.2 DO驱动中间继电器（9路，KA1~KA9）

DO晶体管输出驱动中间继电器线圈，继电器触点接通负载电源：

| 中间继电器 | 线圈由DO驱动 | 触点驱动负载 | 触点规格 |
|---|---|---|---|
| KA1 | Q0.0 | 潜水泵1接触器KM1线圈(AC220V) | 5A/AC250V |
| KA2 | Q0.1 | 潜水泵2接触器KM2线圈 | 5A/AC250V |
| KA3 | Q0.2 | 电动球阀A接触器 | 5A/AC250V |
| KA4 | Q0.3 | 电动球阀B接触器 | 5A/AC250V |
| KA5 | Q0.4 | 电动球阀C接触器 | 5A/AC250V |
| KA6 | Q0.5 | NC球阀-上缸 | 5A/AC250V |
| KA7 | Q0.6 | NC球阀-下缸 | 5A/AC250V |
| KA8 | Q0.7 | 报警蜂鸣器 | 5A/AC250V |
| KA9 | Q2.0 | 报警指示灯 | 5A/AC250V |

**选型**：DC24V线圈，触点≥5A/AC250V，导轨式（如欧姆龙MY2NJ-DC24 + PYF08A底座）。

### 6.3 安全继电器（AQEX-9 急停回路）

| 元件 | 型号建议 | 接线 |
|---|---|---|
| 安全继电器 | PNOZ s4(750104) 或同等级 | 线圈AC220V，由急停回路供电 |
| 急停按钮 | 双通道强制导向(4组触点) | 第1组→急停回路,第2组→I1.1,第3组→安全继电器输入,第4组→预留 |
| 安全继电器反馈 | 强制导向触点13/14 | →I1.2(DI_SafetyRelay_FB) |
| 安全继电器输出 | 主触点 | 串接在动力回路KM1/KM2/KM3上 |

**详见**：AQEX-9 急停双通道+安全继电器反馈设计文档。

---

## 七、屏蔽与走线规范

### 7.1 屏蔽线缆要求

| 信号类型 | 线缆类型 | 屏蔽要求 | 屏蔽层接地 |
|---|---|---|---|
| DI/DO信号线 | RVV 0.75mm²多芯 | 一般不需屏蔽 | — |
| Modbus通讯线 | 屏蔽双绞线 | **必须屏蔽** | 单端接地(PLC侧) |
| 模拟量(如有) | 屏蔽双绞线 | **必须屏蔽** | 单端接地 |
| 急停回路 | RVV 1.0mm² | 不需屏蔽 | — |
| 安全继电器反馈 | RVV 0.75mm² | 建议屏蔽 | 单端接地 |

### 7.2 走线规范

1. **强电弱电分离**：AC220V动力线与DC24V控制线分槽敷设，最小间距50mm
2. **Modbus通讯线独立走线**：不与动力线共槽，必须穿金属管或独立线槽
3. **急停回路独立**：急停回路不与其他信号共线，使用独立线管
4. **线缆颜色规范**：
   - DC24V正极：红色
   - DC24V负极：蓝色
   - AC220V相线：红色（带黄色热缩标记）
   - AC220V零线：蓝色（带绿色热缩标记）
   - 保护接地：黄绿双色
   - 急停回路：橙色（专用识别）
5. **端子编号**：所有端子贴号码管，编号规则：PLC地址-顺序号（如I0.0-1）
6. **线缆标识**：每根线缆两端贴标签，标注：源-目的-线号

### 7.3 接线顺序SOP

1. 先接PE保护接地线（最粗，2.5mm²黄绿）
2. 再接AC220V电源进线（带电前必断QF1）
3. 然后接DC24V控制电源（开关电源输出）
4. 最后接DI/DO信号线
5. Modbus通讯线最后接，且必须断电状态下接
6. 急停回路接线后必须用万用表通断测试

### 7.4 接线检查清单（送电前必查）

- [ ] 所有PE端子已可靠接地，接地电阻≤4Ω
- [ ] AC220V/DC24V电源极性正确，无短路
- [ ] 所有DI信号线与端子号对应
- [ ] 所有DO经中间继电器隔离，无直接驱动负载
- [ ] 急停按钮按下时I1.1=OFF（万用表测通断）
- [ ] 安全继电器线圈已接线，反馈触点接I1.2
- [ ] Modbus通讯线屏蔽层单端接地（PLC侧）
- [ ] 所有端子螺丝已紧固（扭矩0.5~0.6 N·m）
- [ ] 线缆号码管/标签齐全清晰
- [ ] 控制柜门接地簧片已安装

---

## 附录A：完整端子对照表（按物理顺序）

| 物理位置 | 端子号 | PLC地址 | 符号 | 方向 | 备注 |
|---|---|---|---|---|---|
| 本体 | 0.0 | I0.0 | DI_FlowSwitch_A | DI | 无源 |
| 本体 | 0.1 | I0.1 | DI_FlowSwitch_B | DI | 无源 |
| 本体 | 0.2 | I0.2 | DI_FlowSwitch_C | DI | 无源 |
| 本体 | 0.5 | I0.5 | DI_LevelA_High | DI | 无源 |
| 本体 | 0.6 | I0.6 | DI_LevelA_Low | DI | 无源 |
| 本体 | 0.7 | I0.7 | DI_LevelB_High | DI | 无源 |
| 本体 | 1.0 | I1.0 | DI_LevelB_Low | DI | 无源 |
| 本体 | 1.1 | I1.1 | DI_EStop | DI | 常闭 |
| 本体 | 1.2 | I1.2 | DI_SafetyRelay_FB | DI | 强制导向 |
| 本体 | 1.3 | I8.0 | DI_ValveA_Open | DI | 经KA10 |
| 本体 | 0.0 | Q0.0 | DO_Pump1 | DO | 经KA1 |
| 本体 | 0.1 | Q0.1 | DO_Pump2 | DO | 经KA2 |
| 本体 | 0.2 | Q0.2 | DO_ValveA | DO | 经KA3 |
| 本体 | 0.3 | Q0.3 | DO_ValveB | DO | 经KA4 |
| 本体 | 0.4 | Q0.4 | DO_ValveC | DO | 经KA5 |
| 本体 | 0.5 | Q0.5 | DO_NCValve_Top | DO | 经KA6 |
| 本体 | 0.6 | Q0.6 | DO_NCValve_Bottom | DO | 经KA7 |
| 本体 | 0.7 | Q0.7 | DO_Alarm_Sound | DO | 经KA8 |
| EM DT16 | 2.0 | I8.5 | DI_ValveC_Close | DI | 经KA15 |
| EM DT16 | 2.1 | I0.4 | DI_Btn_Mute | DI | 无源 |
| EM DT16 | 2.2 | I2.2 | (备用) | DI | — |
| EM DT16 | 2.3 | I0.3 | DI_Btn_SystemReset | DI | 无源 |
| EM DR16 | 2.0 | Q2.0 | DO_Alarm_Light | DO | 经KA9 |

---

## 附录B：变更记录

| 版本 | 日期 | 变更内容 | 关联Story |
|---|---|---|---|
| v1.0 | 2025-XX-XX | 初版发布,完成I/O接线端子分配 | AQEX-5 |

---

**文档结束**

**待办事项**：
1. 阀门限位反馈中间继电器KA10~KA15实际选型（依阀门厂商触点容量）
2. Q8.0→Q2.0变更需同步变量地址表v1.1
3. EM DR16预留扩展点(I3.0~3.7, Q2.1~2.7)启用时需更新本图
4. 现场接线完成后需按7.4节检查清单逐项核对
