Yustnust/AQUA-EXPO/docs/commissioning/8台PLC批量部署SOP_v1.0.md

# 药液配置加注控制系统 — 8台PLC批量部署SOP v1.0

**用途**: 现场调试工程师将首期1套验证通过的程序批量部署到8台PLC的标准作业流程
**适用范围**: 首期1套验收通过后,2~8号单元的复制部署
**配套文档**: STEP7符号表_8套通用版_v1.0.csv、断电保持配置清单_v1.0.md、PLC首次下装与上电调试Checklist_v1.0.md、网络架构与IP规划_v1.0.md
**核心原则**: 8套PLC程序完全相同,差异**仅在IP地址**(192.168.2.101~108)

---

## 一、部署前确认

### 1.1 首期1套验收状态确认(前置条件)

| # | 验收项 | 标准 | 结果 | 签字 |
|---|---|---|---|---|
| 1 | 1号单元SAT验收 | 101用例全部通过 | □ | |
| 2 | 1号单元连续运行 | 24小时无异常 | □ | |
| 3 | 1号单元程序版本 | 已纳入Git版本控制(commit ID: _________) | □ | |
| 4 | 1号单元符号表 | 已导出最终版CSV | □ | |
| 5 | 1号单元系统块配置 | 断电保持22步验证通过 | □ | |
| 6 | 1号单元硬件版本 | CPU ST20 + EM DT16 + EM DR16 | □ | |

**⚠ 警告**: 首期1套未完成验收前,禁止启动2~8号批量部署,否则将重复返工。

### 1.2 2~8号硬件就绪状态确认

| # | 单元 | PLC序列号 | MAC地址 | IP地址 | 硬件就绪 | 接线完成 |
|---|---|---|---|---|---|---|
| 1 | 2号 | _________ | _________ | 192.168.2.102 | □ | □ |
| 2 | 3号 | _________ | _________ | 192.168.2.103 | □ | □ |
| 3 | 4号 | _________ | _________ | 192.168.2.104 | □ | □ |
| 4 | 5号 | _________ | _________ | 192.168.2.105 | □ | □ |
| 5 | 6号 | _________ | _________ | 192.168.2.106 | □ | □ |
| 6 | 7号 | _________ | _________ | 192.168.2.107 | □ | □ |
| 7 | 8号 | _________ | _________ | 192.168.2.108 | □ | □ |

### 1.3 调试工具与人员

| # | 工具/人员 | 数量 | 确认 |
|---|---|---|---|
| 1 | 编程笔记本电脑(含STEP7 V2.5+) | 1 | □ |
| 2 | 8口工业交换机(临时调试用) | 1 | □ |
| 3 | 网线(Cat5e STP) | 8+1根 | □ |
| 4 | USB转RS485(Modbus调试) | 1 | □ |
| 5 | 万用表 | 2 | □ |
| 6 | 1号PLC项目文件(模板) | 1 | □ |
| 7 | 符号表CSV | 1 | □ |
| 8 | 调试工程师 | 2人(1人PC操作+1人现场确认) | □ |
| 9 | 对讲机 | 2 | □ |

---

## 二、批量部署策略

### 2.1 部署策略选择

**推荐方案: 串行部署(逐台验证)**

| 策略 | 描述 | 优势 | 劣势 | 推荐 |
|---|---|---|---|---|
| 串行部署 | 2号→3号→...→8号,每台验证通过再下一台 | 故障隔离好,易定位 | 耗时较长(每台~1.5h) | **推荐** |
| 并行部署 | 2~8号同时下装 | 速度快 | 故障定位难,需多人多PC | 不推荐 |
| 分组部署 | 2人分2组,每组4台 | 平衡速度与隔离 | 中等 | 备选 |

**本SOP按串行部署编写,并行/分组可参考执行。**

### 2.2 单台部署预估时间

| 阶段 | 工作内容 | 预估时间 |
|---|---|---|
| 1. 硬件接线复核 | DI/DO/485/网络接线检查 | 15 min |
| 2. 项目文件准备 | 复制1号项目,改IP,改项目名 | 5 min |
| 3. 程序下装 | 编译→下装(全部块+系统块) | 5 min |
| 4. 上电自检 | RUN灯/通讯/状态图初始值 | 10 min |
| 5. IO打点 | 20DI+9DO+485逐点核对 | 30 min |
| 6. 单元功能验证 | 急停+Modbus+断电恢复抽样 | 20 min |
| 7. 签字移交 | 验证清单填写 | 5 min |
| **单台合计** | | **~90 min** |
| **8台总计** | | **~12小时(2工作日)** |

### 2.3 部署顺序与里程碑

```
Day 1 上午: 2号单元部署 + 验证
Day 1 下午: 3号单元部署 + 验证
Day 2 上午: 4号+5号单元部署
Day 2 下午: 6号+7号单元部署
Day 3 上午: 8号单元部署 + 全网联调
Day 3 下午: 8单元联调验证(总览页/通讯/报警联动)
```

---

## 三、单台部署SOP(以N号单元为例,N=2~8)

### 3.1 阶段1: 硬件接线复核(15 min)

| 步骤 | 操作 | 标准 | 结果 |
|---|---|---|---|
| 1 | PLC外观检查 | 无破损、扩展模块卡扣到位 | □ |
| 2 | 接地检查 | PE≤4Ω,接地线≥2.5mm² | □ |
| 3 | 24VDC供电 | L+/M极性正确,电压24±0.5V | □ |
| 4 | DI接线(20点) | 按IO核对表逐点打勾 | □ |
| 5 | DO接线(9点) | 全部经继电器转换,触点侧不接电 | □ |
| 6 | RS485接线 | Port0接注射泵+流量计,屏蔽单端接地 | □ |
| 7 | 以太网接线 | RJ45连接至交换机,网线标识清晰 | □ |
| 8 | 急停回路 | I1.1常闭触点接线,双通道独立 | □ |

### 3.2 阶段2: 项目文件准备(5 min)

#### 3.2.1 复制1号项目为N号模板

| 步骤 | 操作 |
|---|---|
| 1 | 文件→打开: AQUA_EXPO_Unit_1.smart(1号验收版) |
| 2 | 文件→另存为: AQUA_EXPO_Unit_N.smart (N=2~8) |
| 3 | 项目树→CPU ST20→系统块→通讯端口 |

#### 3.2.2 修改IP地址(关键!)

```
原IP: 192.168.2.101 (1号)
新IP: 192.168.2.10N (N=2~8, 即102~108)
子网掩码: 255.255.255.0 (不变)
网关: 192.168.2.1 (不变)
```

| # | 修改项 | 原值 | 新值 | 确认 |
|---|---|---|---|---|
| 1 | IP地址 | 192.168.2.101 | 192.168.2.10N | □ |
| 2 | 项目名 | AQUA_EXPO_Unit_1 | AQUA_EXPO_Unit_N | □ |
| 3 | PLC名称(可选) | PLC_1 | PLC_N | □ |
| 4 | 符号表 | 不修改(8套通用) | — | □ |
| 5 | STL代码 | 不修改(8套通用) | — | □ |
| 6 | 断电保持范围 | 不修改(7段V区+3段M区) | — | □ |

**⚠ 关键检查**: 除IP地址外,**所有其他配置必须与1号完全一致**。任何其他差异都需记录并复核。

### 3.3 阶段3: 程序下装(5 min)

#### 3.3.1 下装前编译验证

| # | 检查项 | 标准 | 结果 |
|---|---|---|---|
| 1 | 全部21个块编译 | 0 Error | □ |
| 2 | 警告数 | 0 Warning(或≤1号验收时数量) | □ |
| 3 | 符号表完整性 | 130+变量全部就位 | □ |
| 4 | 断电保持范围 | 7段V区+3段M区已配 | □ |

#### 3.3.2 下装操作

```
1. PC直连PLC以太网口(临时IP设为192.168.2.200,与目标PLC同网段)
2. PLC上电(此时PLC无程序,STOP灯慢闪)
3. STEP7: PLC → 查找CPU → 应自动发现192.168.2.10N
4. 文件 → 下载
   - 勾选: 程序块(全部)
   - 勾选: 系统块(含IP配置+断电保持)
   - 勾选: 数据块(如有)
5. 点击"下载" → 确认PLC模式切换 → 等待下载完成(约30秒)
6. PLC自动重启 → RUN灯常亮
```

#### 3.3.3 下装后自检

| # | 检查项 | 期望 | 实际 |
|---|---|---|---|
| 1 | PLC RUN灯 | 常亮(绿色) | ___ |
| 2 | PLC STOP灯 | 熄灭 | ___ |
| 3 | PLC ERR灯 | 熄灭 | ___ |
| 4 | PC ping PLC IP | 通(响应<1ms) | ___ |
| 5 | STEP7在线读取 VW2 | =0 (S0初始化) | ___ |
| 6 | STEP7在线读取 VW6 | =0 (无报警) | ___ |

### 3.4 阶段4: IO打点验证(30 min)

#### 3.4.1 DI打点(18点)

操作方式: 现场逐点触发传感器/按钮,STEP7状态图监控对应I点位变1

| # | 地址 | 符号 | 触发方式 | 期望 | 实际 | 签字 |
|---|---|---|---|---|---|---|
| 1 | I0.0 | DI_FlowSwitch_A | 阀A开启+水流过 | =1 | ___ | |
| 2 | I0.1 | DI_FlowSwitch_B | 阀B开启+水流过 | =1 | ___ | |
| 3 | I0.2 | DI_FlowSwitch_C | 阀C开启+水流过 | =1 | ___ | |
| 4 | I0.5 | DI_LevelA_High | 上缸注水至高位 | =1 | ___ | |
| 5 | I0.6 | DI_LevelA_Low | 上缸排空 | =1 | ___ | |
| 6 | I0.7 | DI_LevelB_High | 下缸注水至高位 | =1 | ___ | |
| 7 | I1.0 | DI_LevelB_Low | 下缸排空 | =1 | ___ | |
| 8 | I1.1 | DI_EStop | 正常状态 | =1(常闭) | ___ | |
| 9 | I1.1 | DI_EStop | 按下急停 | =0 | ___ | |
| 10 | I1.2 | DI_SafetyRelay_FB | 继电器正常 | =1 | ___ | |
| 11 | I8.0 | DI_ValveA_Open | 阀A全开 | =1 | ___ | |
| 12 | I8.1 | DI_ValveA_Close | 阀A全关 | =1 | ___ | |
| 13 | I8.2 | DI_ValveB_Open | 阀B全开 | =1 | ___ | |
| 14 | I8.3 | DI_ValveB_Close | 阀B全关 | =1 | ___ | |
| 15 | I8.4 | DI_ValveC_Open | 阀C全开 | =1 | ___ | |
| 16 | I8.5 | DI_ValveC_Close | 阀C全关 | =1 | ___ | |
| 17 | I0.4 | DI_Btn_Mute | 按消音按钮 | =1(点动) | ___ | |
| 18 | I0.3 | DI_Btn_SystemReset | 按复位按钮 | =1(点动) | ___ | |

#### 3.4.2 DO打点(9点)

操作方式: STEP7状态图强制写入Q点位,现场确认继电器/负载动作

| # | 地址 | 符号 | 强制值 | 期望现场 | 实际 | 签字 |
|---|---|---|---|---|---|---|
| 1 | Q0.0 | DO_Pump1 | =1 | 潜水泵1启动 | ___ | |
| 2 | Q0.1 | DO_Pump2 | =1 | 潜水泵2启动 | ___ | |
| 3 | Q0.2 | DO_ValveA | =1 | 阀A开启 | ___ | |
| 4 | Q0.3 | DO_ValveB | =1 | 阀B开启 | ___ | |
| 5 | Q0.4 | DO_ValveC | =1 | 阀C开启 | ___ | |
| 6 | Q0.5 | DO_NCValve_Top | =1 | NC阀上动作 | ___ | |
| 7 | Q0.6 | DO_NCValve_Bottom | =1 | NC阀下动作 | ___ | |
| 8 | Q0.7 | DO_Alarm_Sound | =1 | 蜂鸣器响 | ___ | |
| 9 | Q8.0 | DO_Alarm_Light | =1 | 指示灯亮 | ___ | |

**打点完成后,务必将所有强制Q点清除!**(PLC→修改→取消强制全部)

#### 3.4.3 RS485总线验证

| # | 检查项 | 期望 | 实际 |
|---|---|---|---|
| 1 | 注射泵上电 | 控制器指示灯正常 | ___ |
| 2 | 流量计上电 | 显示屏正常 | ___ |
| 3 | PLC读VW4(泵状态) | 周期更新(0/1/2/3) | ___ |
| 4 | PLC读VD86(流量计值) | 周期更新 | ___ |
| 5 | VW250轮询计数器 | 0→1→2→3循环 | ___ |

### 3.5 阶段5: 单元功能抽样验证(20 min)

#### 3.5.1 急停功能验证

| 步骤 | 操作 | 期望 | 实际 |
|---|---|---|---|
| 1 | 按下急停按钮 | I1.1=0, V300.4=1, VW6=12, 报警响 | ___ |
| 2 | HMI显示急停触发 | 红色报警横幅 | ___ |
| 3 | 释放急停按钮 | I1.1=1, V300.4保持=1(锁存) | ___ |
| 4 | 按系统复位按钮 | V300.4=0, VW6=0, 报警清除 | ___ |

#### 3.5.2 断电恢复验证(抽样)

| 步骤 | 操作 | 期望 | 实际 |
|---|---|---|---|
| 1 | 状态图写入 VW2=5, VD366=10.5 | 数值稳定 | ___ |
| 2 | PLC断电 | — | ___ |
| 3 | 等待10秒 | — | ___ |
| 4 | PLC上电 | RUN灯亮,VW2=5, VD366=10.5 | ___ |

#### 3.5.3 Modbus通讯验证(抽样)

| 步骤 | 操作 | 期望 | 实际 |
|---|---|---|---|
| 1 | 监控VW4(泵状态码) | 0=空闲(无动作时) | ___ |
| 2 | 监控VD86(流量计值) | 与流量计显示一致 | ___ |
| 3 | 注射泵断电 | V303.4=1(5次失败后) | ___ |
| 4 | 注射泵恢复 | V303.4=0, VW4恢复更新 | ___ |

### 3.6 阶段6: 部署签字(5 min)

| # | 项目 | 确认 | 签字 | 日期 |
|---|---|---|---|---|
| 1 | 硬件接线复核完成 | □ | | |
| 2 | IP地址正确(192.168.2.10N) | □ | | |
| 3 | 程序下装成功,无错误 | □ | | |
| 4 | IO打点20DI+9DO+485全部通过 | □ | | |
| 5 | 急停/断电恢复/Modbus抽样通过 | □ | | |
| 6 | 与1号单元无配置差异(除IP外) | □ | | |

**N号单元PLC IP**: 192.168.2.________  
**调试工程师**: ____________  **日期**: ____________  
**复核工程师**: ____________  **日期**: ____________

---

## 四、8台部署后的全网联调

### 4.1 HMI 8连接验证

| # | 连接名 | 目标IP | 单元使能 | HMI读取VW2 | 状态 |
|---|---|---|---|---|---|
| 1 | PLC_01 | 192.168.2.101 | TRUE | ___ | □ |
| 2 | PLC_02 | 192.168.2.102 | TRUE | ___ | □ |
| 3 | PLC_03 | 192.168.2.103 | FALSE | ___ | □(灰显) |
| 4 | PLC_04 | 192.168.2.104 | FALSE | ___ | □(灰显) |
| 5 | PLC_05 | 192.168.2.105 | FALSE | ___ | □(灰显) |
| 6 | PLC_06 | 192.168.2.106 | FALSE | ___ | □(灰显) |
| 7 | PLC_07 | 192.168.2.107 | FALSE | ___ | □(灰显) |
| 8 | PLC_08 | 192.168.2.108 | FALSE | ___ | □(灰显) |

**注**: 首期仅1~2号单元使能,3~8号灰显。后续按现场实际分批使能。

### 4.2 8单元独立状态验证

每台PLC独立置 VW2=5(S4),HMI总览页应显示8个卡片均为"S4-转移中":

| # | 单元 | VW2 | HMI显示 | 实际 |
|---|---|---|---|---|
| 1 | 1号 | 5 | S4-转移中 | ___ |
| 2 | 2号 | 5 | S4-转移中 | ___ |
| 3 | 3号 | 5 | S4-转移中 | ___ |
| 4 | 4号 | 5 | S4-转移中 | ___ |
| 5 | 5号 | 5 | S4-转移中 | ___ |
| 6 | 6号 | 5 | S4-转移中 | ___ |
| 7 | 7号 | 5 | S4-转移中 | ___ |
| 8 | 8号 | 5 | S4-转移中 | ___ |

验证完成后,逐台清零 VW2=0。

### 4.3 报警联动验证

任一单元触发急停,HMI应:
- 该单元卡片显示红色"急停"标识
- 顶部报警横幅显示具体单元+报警类型
- 其他单元不受影响(数据隔离验证)

| # | 操作 | 期望 | 实际 |
|---|---|---|---|
| 1 | 3号PLC急停按下 | HMI 3号卡片红色+横幅 | ___ |
| 2 | 其他1~8号 | 不受影响 | ___ |
| 3 | 3号急停释放+复位 | 3号卡片恢复正常 | ___ |

### 4.4 数据隔离验证

| # | 操作 | 期望 | 实际 |
|---|---|---|---|
| 1 | 1号PLC写 VW8=11 | HMI 1号显示轮次=11,其他单元不变 | ___ |
| 2 | 2号PLC写 VW8=22 | HMI 2号显示轮次=22,其他单元不变 | ___ |
| 3 | 8号PLC写 VW8=88 | HMI 8号显示轮次=88,其他单元不变 | ___ |

---

## 五、常见部署问题与排查

### 5.1 IP冲突

**现象**: 第二台PLC下装后,HMI/PC连接混乱
**原因**: 忘记修改IP,两台PLC都是192.168.2.101
**排查**:
- STEP7: PLC→查找CPU,应只发现1个192.168.2.10N
- 临时拔掉其他PLC网线,逐台确认
**修复**: 重新下装系统块,确保IP正确

### 5.2 程序下装失败

**现象**: 下装报错"无法连接CPU"
**排查**:
| 检查项 | 期望 | 处理 |
|---|---|---|
| PC IP同网段 | 192.168.2.200 | 修改PC网卡IP |
| PLC上电 | RUN/STOP灯亮 | 检查24V供电 |
| 网线连通 | ping通 | 换网线/换交换机口 |
| 防火墙 | 关闭 | Windows防火墙关 |
| STEP7版本 | V2.5+ | 升级STEP7 |

### 5.3 RS485通讯不通

**现象**: VW4/VW86不更新,V303.4置位
**排查**:
| 检查项 | 期望 | 处理 |
|---|---|---|
| 接线2/3/5脚 | DB9正确 | 重新焊DB9 |
| 从站地址 | 泵=1, 流量计=2 | 检查设备配置 |
| 波特率 | 9600 | 与设备一致 |
| 终端电阻 | 总线两端120Ω | 加装 |
| 屏蔽接地 | PLC侧单端接地 | 重新接地 |

### 5.4 断电保持失效

**现象**: PLC断电后VW2/VW6归零
**原因**: 系统块断电保持范围未下装,或下装后未断电重启
**修复**:
1. 重新打开项目,确认系统块→断电保持7段V区+3段M区已配
2. 重新下装(勾选系统块)
3. PLC断电→上电,重做断电保持配置清单4.2节验证

### 5.5 HMI连接不上PLC

**现象**: HMI某连接红色"通讯中断"
**排查**:
| 检查项 | 期望 | 处理 |
|---|---|---|
| PLC IP正确 | 192.168.2.10N | 重新下装系统块 |
| PLC运行 | RUN灯亮 | 上电/清错 |
| HMI配置 | IP+协议+TSAP正确 | 见MCGS通讯配置SOP |
| 防火墙 | 关闭 | — |
| 物理连接 | HMI↔交换机↔PLC | 换线/换口 |

---

## 六、部署完成交付

### 6.1 部署进度总表

| # | 单元 | IP | 部署日期 | 调试人 | 验收人 | 状态 |
|---|---|---|---|---|---|---|
| 1 | 1号 | 192.168.2.101 | _________ | _________ | _________ | □ 完成 |
| 2 | 2号 | 192.168.2.102 | _________ | _________ | _________ | □ 完成 |
| 3 | 3号 | 192.168.2.103 | _________ | _________ | _________ | □ 完成 |
| 4 | 4号 | 192.168.2.104 | _________ | _________ | _________ | □ 完成 |
| 5 | 5号 | 192.168.2.105 | _________ | _________ | _________ | □ 完成 |
| 6 | 6号 | 192.168.2.106 | _________ | _________ | _________ | □ 完成 |
| 7 | 7号 | 192.168.2.107 | _________ | _________ | _________ | □ 完成 |
| 8 | 8号 | 192.168.2.108 | _________ | _________ | _________ | □ 完成 |

### 6.2 全网联调验证

| # | 验证项 | 结果 | 签字 |
|---|---|---|---|
| 1 | HMI 8连接状态 | □ 全部正常 | |
| 2 | 8单元独立状态显示 | □ 全部正常 | |
| 3 | 报警联动验证 | □ 通过 | |
| 4 | 数据隔离验证 | □ 通过 | |
| 5 | 连续运行24小时 | □ 无异常 | |

### 6.3 交付物清单

| # | 交付物 | 形式 | 确认 |
|---|---|---|---|
| 1 | 8份单元部署记录单(本文档3.6节) | 纸质签字 | □ |
| 2 | 8台PLC IP地址台账 | Excel | □ |
| 3 | 8台PLC SN/MAC台账 | Excel | □ |
| 4 | 8台PLC程序备份(.smart文件) | Git仓库 | □ |
| 5 | 全网联调验证报告 | 本文档4章签字 | □ |
| 6 | 遗留问题清单 | 文档 | □ |

### 6.4 项目经理签字

**部署范围**: 1~8号单元全部完成  
**部署周期**: _________ 至 _________  
**调试工程师**: ____________  
**项目经理**: ____________  **日期**: ____________  
**客户代表**: ____________  **日期**: ____________

---

## 附录A: 8台PLC项目文件命名规范

```
plc/
├── projects/                          (新建子目录)
│   ├── AQUA_EXPO_Unit_1.smart         (1号,验收基准版)
│   ├── AQUA_EXPO_Unit_2.smart         (2号)
│   ├── AQUA_EXPO_Unit_3.smart         (3号)
│   ├── AQUA_EXPO_Unit_4.smart         (4号)
│   ├── AQUA_EXPO_Unit_5.smart         (5号)
│   ├── AQUA_EXPO_Unit_6.smart         (6号)
│   ├── AQUA_EXPO_Unit_7.smart         (7号)
│   └── AQUA_EXPO_Unit_8.smart         (8号)
├── stl/                                (8套通用STL源码)
└── spec/                               (8套通用设计规格)
```

**版本管理**: 每次程序变更,8个.smart文件必须同步更新,Git提交时commit message注明"8套同步"。

## 附录B: 部署快速检查卡(可打印随身)

```
┌─────────────────────────────────────┐
│  N号单元部署快速检查卡                 │
├─────────────────────────────────────┤
│ □ 1. 硬件接线复核 (15min)            │
│ □ 2. 项目文件复制+改IP (5min)        │
│ □ 3. 编译下装 (5min)                 │
│ □ 4. IO打点 20DI+9DO+485 (30min)    │
│ □ 5. 急停/断电/Modbus抽样 (20min)    │
│ □ 6. 签字移交 (5min)                 │
├─────────────────────────────────────┤
│ 关键差异点(仅IP):                    │
│ 1号=192.168.2.101                    │
│ N号=192.168.2.10N                    │
│ 其他配置8套完全相同!                  │
├─────────────────────────────────────┤
│ 出问题先查:                          │
│ 1. IP是否冲突                        │
│ 2. 断电保持是否下装                  │
│ 3. 8套程序是否一致(仅IP不同)         │
└─────────────────────────────────────┘
```
