Yustnust/AQUA-EXPO/docs/commissioning/IO现场接线核对表_v1.0.md

# 药液配置加注控制系统 — IO现场接线核对表 v1.0

**项目**: 药液配置加注控制系统
**适用范围**: 8套缸单元通用(每套1台PLC,IO地址相同)
**用途**: 现场接线施工与调试阶段的逐点核对表,施工方按表接线,调试方按表打点核对
**配套文档**: PLC设计文档v9.3第二章I/O地址分配表、HMI-PLC变量地址表v1.0第二/三章

---

## 一、使用说明

### 1.1 核对流程

```
施工方接线 → 调试方逐点核对 → 发现问题记录 → 整改 → 复核 → 签字确认
```

### 1.2 核对方法

| 类型 | 核对方法 |
|---|---|
| DI(数字量输入) | 现场触发信号源→PLC变量表监控对应I点状态变化 |
| DO(数字量输出) | PLC强制Q点ON→现场确认继电器吸合+负载动作 |
| 公共端 | 万用表测量公共端电压,确认SRC/SINK接法 |

### 1.3 状态标记

- ✅ 合格: 接线正确,功能正常
- ❌ 不合格: 接线错误或功能异常(记录问题处理)
- ⚠️ 待确认: 需进一步核实(如信号类型/接法)

---

## 二、DI数字量输入核对表(17点使用+1点备用)

### 2.1 DI公共端接线

| # | 端子 | 接线 | 电压 | 确认 | 签字 |
|---|---|---|---|---|---|
| 1 | 1M(本体0~7公共端) | 接0V(SRC型)/24V(SINK型) | ___V | □ | |
| 2 | 2M(本体8~11公共端) | 同1M | ___V | □ | |
| 3 | 1M(扩展0~7公共端) | 同本体1M | ___V | □ | |

**⚠️ SRC/SINK选型确认**: 本项目DI信号源为无源触点(流量开关/液位计/急停/安全继电器)和有源经继电器转换信号(阀门限位),建议采用**SRC型(漏型)接法**,1M/2M接0V,信号端接24V。

### 2.2 DI逐点核对表

| # | PLC地址 | 符号 | 信号源 | 信号类型 | 线号 | 端子号 | 触发方式 | 期望状态 | 实测 | 核对 | 签字 |
|---|---|---|---|---|---|---|---|---|---|---|---|
| 1 | I0.0 | DI_FlowSwitch_A | 流量开关A | 无源常开 | FS_A_NO | I0.0 | 吹气/水流动 | ON | ___ | □✅□❌ | |
| 2 | I0.1 | DI_FlowSwitch_B | 流量开关B | 无源常开 | FS_B_NO | I0.1 | 吹气/水流动 | ON | ___ | □✅□❌ | |
| 3 | I0.2 | DI_FlowSwitch_C | 流量开关C | 无源常开 | FS_C_NO | I0.2 | 吹气/水流动 | ON | ___ | □✅□❌ | |

| 6 | I0.5 | DI_LevelA_High | 液位计A-高位 | 无源常开 | LV_AH_NO | I0.5 | 手动抬浮子 | ON | ___ | □✅□❌ | |
| 7 | I0.6 | DI_LevelA_Low | 液位计A-低位 | 无源常开 | LV_AL_NO | I0.6 | 手动降浮子 | ON | ___ | □✅□❌ | |
| 8 | I0.7 | DI_LevelB_High | 液位计B-高位 | 无源常开 | LV_BH_NO | I0.7 | 手动抬浮子 | ON | ___ | □✅□❌ | |
| 9 | I1.0 | DI_LevelB_Low | 液位计B-低位 | 无源常开 | LV_BL_NO | I1.0 | 手动降浮子 | ON | ___ | □✅□❌ | |
| 10 | I1.1 | DI_EStop | 急停反馈 | **常闭** | ES_NC | I1.1 | 释放急停 | **ON(常闭)** | ___ | □✅□❌ | |
| 11 | I1.2 | DI_SafetyRelay_FB | 安全继电器反馈 | 强制导向 | SR_FB | I1.2 | 继电器吸合 | ON | ___ | □✅□❌ | |
| 12 | I8.0 | DI_ValveA_Open | 阀A开到位 | 有源→继电器 | VA_O | I8.0 | 手动开阀到位 | ON | ___ | □✅□❌ | |
| 13 | I8.1 | DI_ValveA_Close | 阀A关到位 | 有源→继电器 | VA_C | I8.1 | 手动关阀到位 | ON | ___ | □✅□❌ | |
| 14 | I8.2 | DI_ValveB_Open | 阀B开到位 | 有源→继电器 | VB_O | I8.2 | 手动开阀到位 | ON | ___ | □✅□❌ | |
| 15 | I8.3 | DI_ValveB_Close | 阀B关到位 | 有源→继电器 | VB_C | I8.3 | 手动关阀到位 | ON | ___ | □✅□❌ | |
| 16 | I8.4 | DI_ValveC_Open | 阀C开到位 | 有源→继电器 | VC_O | I8.4 | 手动开阀到位 | ON | ___ | □✅□❌ | |
| 17 | I8.5 | DI_ValveC_Close | 阀C关到位 | 有源→继电器 | VC_C | I8.5 | 手动关阀到位 | ON | ___ | □✅□❌ | |
| 18 | I0.4 | DI_Btn_Mute | 消音按钮 | 无源常开点动 | BTN_M | I0.4 | 按下 | ON(点动) | ___ | □✅□❌ | |
| 19 | I2.2 | —(备用) | 预留 | — | — | I2.2 | — | — | — | □N/A | |
| 20 | I0.3 | DI_Btn_SystemReset | 系统复位按钮 | 无源常开点动 | BTN_R | I0.3 | 按下 | ON(点动) | ___ | □✅□❌ | |

### 2.3 DI接线关键确认点

| # | 关键确认项 | 标准 | 确认 | 签字 |
|---|---|---|---|---|
| 1 | 急停I1.1**常闭**触点 | 释放状态=ON,按下=OFF | □ | |
| 2 | 急停双通道独立回路 | 不经PLC,直接切动力电 | □ | |
| 3 | 安全继电器I1.2强制导向 | 使用强制导向型触点 | □ | |
| 4 | 阀门限位经中间继电器 | 有源信号必须隔离 | □ | |
| 5 | 消音/复位按钮点动 | 松开即OFF | □ | |

---

## 三、DO数字量输出核对表(9点)

### 3.1 DO公共端接线

| # | 端子 | 接线 | 电压 | 确认 | 签字 |
|---|---|---|---|---|---|
| 1 | 1L+(本体0~5公共端) | 接24VDC正极 | ___V | □ | |
| 2 | 2L+(本体6~7公共端) | 接24VDC正极 | ___V | □ | |
| 3 | 3L+(扩展0~7公共端) | 接24VDC正极 | ___V | □ | |

### 3.2 DO逐点核对表

| # | PLC地址 | 符号 | 负载 | 继电器型号 | 线圈端子 | 触点端子 | 强制ON后 | 实测 | 核对 | 签字 |
|---|---|---|---|---|---|---|---|---|---|---|
| 1 | Q0.0 | DO_Pump1 | 潜水泵1 | 普通继电器 | K1_A1 | K1_NO | 继电器吸合,泵1运行(220V) | ___ | □✅□❌ | |
| 2 | Q0.1 | DO_Pump2 | 潜水泵2 | 普通继电器 | K2_A1 | K2_NO | 继电器吸合,泵2运行 | ___ | □✅□❌ | |
| 3 | Q0.2 | DO_ValveA | 电动球阀A | 普通继电器 | K3_A1 | K3_NO | 继电器吸合,阀A开启 | ___ | □✅□❌ | |
| 4 | Q0.3 | DO_ValveB | 电动球阀B | 普通继电器 | K4_A1 | K4_NO | 继电器吸合,阀B开启 | ___ | □✅□❌ | |
| 5 | Q0.4 | DO_ValveC | 电动球阀C | 普通继电器 | K5_A1 | K5_NO | 继电器吸合,阀C开启 | ___ | □✅□❌ | |
| 6 | Q0.5 | DO_NCValve_Top | NC球阀-上缸 | 普通继电器 | K6_A1 | K6_NO | 继电器吸合,NC阀得电(打开) | ___ | □✅□❌ | |
| 7 | Q0.6 | DO_NCValve_Bottom | NC球阀-下缸 | 普通继电器 | K7_A1 | K7_NO | 继电器吸合,NC阀得电 | ___ | □✅□❌ | |
| 8 | Q0.7 | DO_Alarm_Sound | 报警蜂鸣器 | 无源触点 | K8_A1 | K8_NO | 继电器吸合,蜂鸣器响 | ___ | □✅□❌ | |
| 9 | Q8.0 | DO_Alarm_Light | 报警指示灯 | 无源触点 | K9_A1 | K9_NO | 继电器吸合,指示灯亮 | ___ | □✅□❌ | |

### 3.3 DO接线关键确认点

| # | 关键确认项 | 标准 | 确认 | 签字 |
|---|---|---|---|---|
| 1 | 所有DO经继电器转换 | 不直驱负载 | □ | |
| 2 | 安全继电器型号 | 强制导向型,220V线圈 | □ | |
| 3 | NC球阀失电安全 | 失电=关闭(常闭型) | □ | |
| 4 | 报警声音/灯光独立 | Q0.7/Q8.0独立控制 | □ | |

---

## 四、RS485 Modbus接线核对

### 4.1 注射泵485接线

| # | 端子 | 接线 | 确认 | 签字 |
|---|---|---|---|---|
| 1 | PLC Port0 D+ | 注射泵485 D+ | □ | |
| 2 | PLC Port0 D- | 注射泵485 D- | □ | |
| 3 | 站号配置 | 注射泵站号=01 | □ | |
| 4 | 波特率配置 | 9600 | □ | |
| 5 | 数据位/停止位/校验 | 8/N/1 | □ | |

### 4.2 流量计485接线

| # | 端子 | 接线 | 确认 | 签字 |
|---|---|---|---|---|
| 1 | PLC Port0 D+ | 流量计485 D+(并联) | □ | |
| 2 | PLC Port0 D- | 流量计485 D-(并联) | □ | |
| 3 | 站号配置 | 流量计站号=02 | □ | |
| 4 | 波特率配置 | 9600 | □ | |
| 5 | 终端电阻 | 总线末端120Ω(视距离) | □ | |

---

## 五、问题记录与整改

| # | 地址/端子 | 问题描述 | 整改措施 | 整改人 | 复核结果 | 签字 |
|---|---|---|---|---|---|---|
| 1 | | | | | □合格□不合格 | |
| 2 | | | | | □合格□不合格 | |
| 3 | | | | | □合格□不合格 | |
| 4 | | | | | □合格□不合格 | |
| 5 | | | | | □合格□不合格 | |

---

## 六、核对完成确认

### 6.1 核对结果统计

| 类型 | 总点数 | 合格 | 不合格 | 待确认 | 合格率 |
|---|---|---|---|---|---|
| DI | 19 | ___ | ___ | ___ | ___% |
| DO | 9 | ___ | ___ | ___ | ___% |
| 485 | 2从站 | ___ | ___ | ___ | ___% |
| **合计** | **30** | ___ | ___ | ___ | ___% |

### 6.2 签字确认

| 角色 | 姓名 | 签字 | 日期 |
|---|---|---|---|
| 施工方(接线) | | | |
| 调试方(核对) | | | |
| 项目经理 | | | |

**⚠️ 所有30点全部合格(100%)后方可进入IO打点测试与单机调试阶段。**

---

## 附录:常见接线问题速查

| 现象 | 可能原因 | 排查方法 |
|---|---|---|
| DI信号始终ON | 信号源常闭/接线错误 | 查信号源触点类型,确认公共端接法 |
| DI信号始终OFF | 信号源常开/断线/公共端未接 | 万用表测通断,查1M/2M接线 |
| 急停I1.1逻辑反 | 常闭/常开接反 | 确认急停第二组常闭触点 |
| DO无输出 | 1L+/2L+未接24V | 万用表测公共端电压 |
| 继电器不吸合 | 线圈极性反/断线 | 测线圈电压,确认A1/A2接法 |
| 485通讯失败 | D+/D-接反/站号冲突 | 对调D+/D-,查站号唯一性 |
| 阀门限位无信号 | 有源信号未隔离 | 确认经中间继电器转换 |

---

**文档版本**: v1.0
**创建日期**: 2026-07-15
**说明**: 本表为8套通用模板,每套单元调试时打印一份逐项核对签字。首期1套核对完成后的经验用于优化后续7套接线施工。
