Yustnust/AQUA-EXPO/docs/commissioning/性能基准测试方案_v1.0.md

# 药液配置加注控制系统 — 性能基准测试方案 v1.0

| 项目 | 内容 |
|---|---|
| 文档名称 | 性能基准测试方案 |
| 版本号 | v1.0 |
| 编制日期 | 2026-07-18 |
| 适用范围 | 8套缸单元(每套1台S7-200 SMART CPU ST20 + EM DT16/DR16)及1台本地集中HMI的性能量化验证 |
| PLC型号 | 西门子 S7-200 SMART CPU ST20(标准型,12KB工作内存,内置RTC,超级电容保持) |
| 主程序结构 | OB1(主循环)每周期调度 FC0(初始化,SM0.1触发)/FC2(急停)/FC4(Modbus轮询)/FC3(报警)/FC1(状态调度→FC10~FC19);FC40(节奏纠偏)在S5态由FC16触发 |
| 配套文档 | 《药液配置加注控制系统_PLC设计文档》v9.3;《HMI-PLC变量地址表》v1.0;《SAT_FAT验收测试用例》v1.0;《FC0_SysInit.stl》《FC4_ModbusPolling.stl》《OB1_MAIN.stl》《FC1_StateDispatcher.stl》 |
| 测试目的 | 在 SAT_FAT 验收用例(已覆盖功能正确性)的基础上,补充量化性能指标测试,验证系统在扫描周期、Modbus轮询、S7通讯、8连接并发、HMI刷新、内存占用、极限工况等场景下的性能表现是否满足设计要求 |
| 与 SAT_FAT 关系 | 本方案不重复 SAT_FAT 的功能用例(参见 SAT_FAT v1.0 第3~11章共106个用例),仅补充 SAT_FAT 未量化的性能指标。SAT_FAT 第11章"长时稳定性测试"中已有的24小时连续运行用例(TC-11-001)在本方案第5章作为并发压力测试的一部分引用复测,不另设重复用例 |

---

## 目录

1. [测试目的与合格判据总表](#第1章-测试目的与合格判据总表)
2. [PLC扫描周期测试](#第2章-plc扫描周期测试)
3. [Modbus RTU注射泵通讯测试](#第3章-modbus-rtu注射泵通讯测试)
4. [S7协议HMI通讯测试](#第4章-s7协议hmi通讯测试)
5. [8连接并发压力测试](#第5章-8连接并发压力测试)
6. [HMI画面刷新率测试](#第6章-hmi画面刷新率测试)
7. [内存与资源占用](#第7章-内存与资源占用)
8. [极限工况测试](#第8章-极限工况测试)
9. [测试工具清单](#第9章-测试工具清单)
10. [测试报告模板](#第10章-测试报告模板)

---

## 第1章 测试目的与合格判据总表

### 1.1 测试目的

本测试方案针对 AQUA-EXPO 系统在工厂调试与现场验收阶段需要量化的性能指标,提供可操作的测试方法、记录表格与合格判据,具体目标:

1. **量化PLC扫描周期**:确认 OB1 每周期执行 FC0/FC2/FC3/FC4/FC1 全部逻辑所需时间,保证实时控制响应。
2. **量化Modbus轮询性能**:确认 FC4 通过 CPU 本体 RS485(Port0)轮询注射泵(站号0x01,寄存器41001)与流量计(站号0x02,寄存器0x0009)的请求-响应耗时与稳定性。
3. **量化HMI单站点访问性能**:确认 HMI 通过 S7 协议(或 Modbus TCP,待HMI选型确认)读写 V 区的耗时。
4. **量化8连接并发性能**:确认 1台HMI同时连接8台PLC(192.168.2.101~108)时的并发响应、丢包率、长时稳定性。
5. **量化HMI画面刷新率**:确认主监控/趋势/报警/参数各画面的实际刷新周期与操作响应延迟。
6. **量化内存与资源占用**:确认 PLC 工作内存、断电保持区、HMI 内存与存储的占用率与长时泄漏情况。
7. **量化极限工况表现**:确认最大报警并发、最快换水周期、最长实验时长、参数边界值下的系统行为。

### 1.2 合格判据总表

| 序号 | 性能指标 | 目标值 | 合格判据 | 来源/备注 |
|---|---|---|---|---|
| 1 | PLC单扫描周期(空载) | < 5 ms | 连续1000次采样最大值 ≤ 5 ms | **待确认**;S7-200 SMART CPU ST20典型为1~3ms,设计未明确,建议取5ms |
| 2 | PLC单扫描周期(S5运行中) | < 8 ms | 连续1000次采样最大值 ≤ 8 ms | **待确认**;S5态含FC40节奏纠偏触发计算,建议放宽至8ms |
| 3 | PLC单扫描周期(8报警同时活动) | < 10 ms | 连续1000次采样最大值 ≤ 10 ms | **待确认**;8报警活动时FC3优先级链遍历最长,建议10ms |
| 4 | Modbus单次轮询耗时(注射泵41001) | < 100 ms | 单次请求→响应耗时 P95 ≤ 100 ms | 9600bps/8N1,8字节请求+11字节响应 ≈ 20ms理论值 |
| 5 | Modbus单次轮询耗时(流量计0x0009) | < 100 ms | 单次请求→响应耗时 P95 ≤ 100 ms | 同上 |
| 6 | Modbus一轮2从站轮询周期 | < 500 ms | 注射泵+流量计各1次完成总耗时 ≤ 500 ms | 单从站失败重试不超1次,见3.2 |
| 7 | Modbus超时阈值 | 注射泵2000ms/流量计1000ms | 超时后 V303.4=1(注射泵)/对应报警位置位 | 来自变量地址表11.1节"通讯超时"建议值 |
| 8 | Modbus通讯中断恢复时间 | < 10 s | 从断线恢复到 V303.4 清零且重新读到有效数据 ≤ 10 s | **待确认**;恢复后需完整1轮轮询成功 |
| 9 | HMI单次读写V区耗时 | < 50 ms | 单次S7读/写1个VD变量 ≤ 50 ms P95 | **待确认**;HMI选型确认后实测 |
| 10 | HMI轮询8台PLC一周耗时 | < 2 s | 8台PLC各读关键变量集(总览页约8变量/单元)总耗时 ≤ 2 s | **待确认**;关键变量集见变量地址表13.1节 |
| 11 | HMI连接建立时间 | < 3 s | HMI上电到8台PLC全部"在线" ≤ 3 s(每台 ≤ 500 ms) | **待确认** |
| 12 | HMI断线重连时间 | < 5 s | 单台PLC断网恢复后HMI重新显示"在线" ≤ 5 s | **待确认**;含HMI驱动层重连探测周期 |
| 13 | 8连接并发单PLC响应延迟 P95 | < 100 ms | 8台同时被HMI轮询时,单PLC单次请求响应 P95 ≤ 100 ms | **待确认** |
| 14 | 8连接并发丢包率 | < 0.1% | 连续1小时S7读写请求失败次数/总次数 ≤ 0.1% | **待确认** |
| 15 | 8连接24小时连续运行 | 0次未预期S_ERROR | 24小时内8台PLC均无未预期 S_ERROR,无 HMI 通讯中断>30s | 引用 SAT_FAT TC-11-001,扩展为8台并发 |
| 16 | HMI主监控画面刷新率 | < 1 s | 总览页8单元卡片状态刷新间隔 ≤ 1 s | **待确认**;工业HMI典型1~2s |
| 17 | HMI趋势画面刷新率 | < 2 s | 趋势曲线数据更新间隔 ≤ 2 s | **待确认**;含历史数据读取 |
| 18 | HMI报警画面刷新率 | < 500 ms | 新报警从PLC置位到HMI弹出 ≤ 500 ms | 报警优先级最高,刷新应最快 |
| 19 | HMI参数画面操作响应延迟 | < 1 s | 操作员设定 VD 参数后PLC回写确认 ≤ 1 s | 含二次确认操作 |
| 20 | PLC工作内存占用率 | < 70% | OB1+所有FC编译后占用 ≤ 12KB×70% = 8.4KB | CPU ST20工作内存12KB |
| 21 | PLC断电保持区占用率 | < 80% | 实际使用VB0~VB599/DT10范围 ≤ 配置保持区的80% | 见变量地址表附录A |
| 22 | HMI内存占用 | < 70% | 运行时内存占用 ≤ 设备规格的70% | **待确认**;HMI选型后实测 |
| 23 | HMI存储占用(历史/报警) | < 80% | 24小时运行后存储占用 ≤ 设备规格的80% | **待确认** |
| 24 | 24小时内存泄漏检测 | 0 显著增长 | PLC扫描周期/HMI内存24小时前后变化 ≤ 10% | **待确认** |
| 25 | 最大报警并发 | ≥ 8 同时活动 | 8个不同报警位同时置位,FC3优先级链正确,扫描周期≤10ms | 8套每套1个报警同时触发 |
| 26 | 最快换水周期 | VD_CycleSetpoint 下限值 | 在 VD_CycleSetpoint = VD_T_Rolling+VD_S6_Rolling(理论下限)下完成S1~S6无S_ERROR | **待确认**;下限值现场实测核定 |
| 27 | 最长实验时长 | ≥ VD_ExperimentTarget | VD_ExperimentDuration_Accum 累加至 VD_ExperimentTarget 后正确转 S7 | 默认 VD_ExperimentTarget=480min(8h),可设更长 |

> **"待确认"标注说明**:本表中标注"待确认"的指标值,在 HMI 选型(AQEX-24,见变量地址表14.2节)确认、现场实测后,由调试工程师与客户共同核定最终目标值并升版至 v1.1。核定前按本表建议值执行测试,实测结果如实记录,作为核定依据。

---

## 第2章 PLC扫描周期测试

### 2.1 测试目的

测量 OB1 主循环每扫描周期的实际执行时间,验证在不同负载条件下扫描周期是否满足实时控制要求。S7-200 SMART CPU ST20 的扫描周期直接影响:
- 阀门/泵 DO 输出的响应延迟(扫描周期越长,DI→DO 响应越慢)
- Modbus 轮询触发频率(FC4 每周期调用,扫描周期决定轮询密度)
- HMI 命令位(V0.x)响应延迟(HMI 写命令后,PLC 下一周期才响应)
- 急停响应(I1.1 触发后,FC2 在同一周期内强制 VW2=99,延迟 ≤ 1 个扫描周期)

### 2.2 测试方法

提供两种方法,优先采用方法A(硬件示波器法,精度高),方法B(STL内嵌计时器法)作为补充/无示波器时使用。

#### 2.2.1 方法A:SM0.6时钟脉冲+Q点翻转示波器法

**原理**:利用 S7-200 SMART 的 SM0.6(2Hz 时钟脉冲,500ms 周期)在 OB1 首尾翻转一个空闲 Q 点,通过示波器测量 Q 点脉冲宽度反映扫描周期。

> **注**:SM0.6 为 2Hz 时钟(2个完整周期/秒),在每个扫描周期开始时其状态被采样。若扫描周期远小于500ms(预期<10ms),则 SM0.6 在多个连续扫描周期内状态不变。因此本方法实际利用 SM0.6 作为"周期开始时刻标记",通过示波器测量 OB1 首次置位 Q 点到末尾复位 Q 点的时间差。

**STL片段示例(测试用,正式下装前移除)**:

```
// 在 OB1 NETWORK 1 之前插入测试NETWORK(占用空闲Q点,如Q1.1)
// 注意: Q0.0~Q8.0 已被DO占用(见变量地址表第三章),Q1.1需确认扩展模块未使用
// 或使用 M 区中间位 + 示波器接 PLC 输出端子(经继电器转换)
NETWORK 0: 扫描周期测试-Q点翻转(测试用,正式版移除)
LD     SM0.0
S      Q1.1, 1                     // 周期开始置位Q1.1

// ... OB1 正常 NETWORK 1~6 ...

NETWORK 7: 扫描周期测试-Q点复位(测试用,正式版移除)
LD     SM0.0
R      Q1.1, 1                     // 周期结束复位Q1.1
```

**测试步骤**:
1. 在 STEP 7-Micro/WIN SMART 中,在 OB1 最前和最后各插入一个 NETWORK,置位/复位 Q1.1(或选定的空闲 M 位经空闲 DO 输出)。
2. 编译下装,PLC 进入 RUN。
3. 示波器探头接 Q1.1 对应的继电器触点输出端(经继电器转换,见变量地址表第三章接线原则)。
4. 设置示波器触发为上升沿,时基 1ms/div,采集 1000 个脉冲。
5. 示波器统计功能读取脉冲宽度(=扫描周期)的最大值、最小值、平均值、P95。
6. 分别在 2.3 节三种负载条件下测试,每次采集 ≥ 1000 个样本。

> **注意事项**:
> - Q1.1 必须是空闲点,ST20本体8DO(Q0.0~Q0.7)+扩展8DO,需确认扩展模块对应地址。建议优先用扩展模块的空闲 DO 点。
> - 继电器转换会引入 1~5ms 跳动误差,若需更高精度,改用方法B。
> - SM0.6 在本方案中不直接作为测量信号(因其周期500ms远大于扫描周期),仅作时基参考。

#### 2.2.2 方法B:STL内嵌计时器累加法

**原理**:利用 S7-200 SMART 的 SMW22(扫描周期字,单位 ms,系统自动更新)直接读取,或用定时器 T32(1ms 时基)在 OB1 首尾读取差值。

**STL片段示例(方法B-1,使用SMW22)**:

```
// SMW22: 上一次扫描周期(ms),系统自动更新
// 在 OB1 末尾 NETWORK 中读取并累加到记录区
NETWORK 8: 扫描周期记录(测试用)
LD     SM0.0
MOVW   SMW22, VW980                // 当前扫描周期(ms)→VW980
// 若需统计最大值:
LDW>   SMW22, VW982                // 与历史最大值比较
MOVW   SMW22, VW982                // 更新最大值
// 若需统计累加次数:
INCW   VW984                       // 采样次数+1
// HMI 可读 VW980(当前)/VW982(最大)/VW984(次数) 实时监控
```

**STL片段示例(方法B-2,使用T32高精度计时)**:

```
// T32: 1ms 时基定时器,可测亚毫秒级
// 在 OB1 首尾读取 T32 当前值差
NETWORK 0: 扫描周期测试-T32启动(测试用)
LD     SM0.0
TON    T32, 32767                  // T32 启动(1ms时基,PT设最大值使其不复位)
MOVW   T32, VW990                  // 周期开始T32值→VW990

// ... OB1 正常 NETWORK 1~6 ...

NETWORK 7: 扫描周期测试-T32结束(测试用)
LD     SM0.0
MOVW   T32, VW992                  // 周期结束T32值→VW992
-I     VW990, VW992                // VW992 = 扫描周期(ms)
// 注意: T32在扫描中持续走,无需复位
```

**测试步骤**:
1. 在 OB1 插入测试 NETWORK,使用 VW980~VW994 作为测试记录区(需在系统块中断电保持区外,避免冲突)。
2. 编译下装,PLC 进入 RUN。
3. 通过 STEP 7 状态图表或 HMI 读取 VW980(当前扫描周期)、VW982(历史最大)、VW984(采样次数)。
4. 让 PLC 连续运行 ≥ 10 分钟(采样次数 ≥ 60000),记录 VW982 最大值。
5. 在不同负载条件下重复测试。

> **精度说明**:SMW22 为系统字,精度 1ms,适合测量 1ms 以上的扫描周期。T32 精度 1ms 但在扫描中持续走,差值法精度同 1ms。两者均能满足本方案 ≤ 10ms 量级的测量需求。

### 2.3 不同负载下测试条件

#### 2.3.1 空载条件

- PLC 程序已下装 RUN,VW2=0(S0 初始化完成态)
- 无 HMI 通讯(HMI 断网或未启动)
- 无 Modbus 通讯(RS485 总线断开或从站不上电)
- 无 DI 触发(所有 I 点保持空闲态)
- 无活动报警(VB300~VB303=0,VW6=0)

#### 2.3.2 S5运行中条件

- VW2=6(S5 实验运行中),V1.7=1(下缸满),VD_S5_Elapsed 累加中
- FC16(S5状态)每周期调用,FC40(节奏纠偏)在 S5 上升沿触发一次
- HMI 通讯在线(HMI 总览页持续轮询)
- Modbus 通讯在线(FC4 每周期调用,2个从站轮询)
- DI 模拟正常实验态:流量开关/液位计保持 S5 应有状态
- 无活动报警

#### 2.3.3 8报警同时活动条件

- VW2=99(S_ERROR),或保持运行态强制报警位
- 通过状态图表强制 8 个报警位同时置位(模拟8套每套1个报警并发场景,本测试在单PLC上模拟8个不同报警位同时活动):
  - V300.0(上缸漫溢)
  - V300.4(急停锁存)
  - V300.5(安全继电器故障)
  - V300.6(节奏严重滞后)
  - V301.0(阀A关后仍有流)
  - V302.0(阀B四态诊断异常)
  - V302.5(阀C四态诊断异常)
  - V303.4(注射泵故障)
- FC3 优先级链遍历全部 8 位,计算 VW6(预期=99,最高级)
- HMI 通讯在线
- Modbus 通讯在线(若从站故障,V303.4 会触发)

### 2.4 测试记录表格

| 用例ID | 负载条件 | 测试方法 | 采样次数 | 最小值(ms) | 平均值(ms) | 最大值(ms) | P95(ms) | 目标值(ms) | 通过/失败 | 测试人 | 测试日期 |
|---|---|---|---|---|---|---|---|---|---|---|---|
| TC-PERF-02-001 | 空载 | 方法A/B | 1000 | | | | | ≤5 | | | |
| TC-PERF-02-002 | S5运行中 | 方法A/B | 1000 | | | | | ≤8 | | | |
| TC-PERF-02-003 | 8报警同时活动 | 方法A/B | 1000 | | | | | ≤10 | | | |

### 2.5 合格判据

1. **空载**:连续 1000 次采样最大值 ≤ 5 ms(待确认)。
2. **S5运行中**:连续 1000 次采样最大值 ≤ 8 ms(待确认)。
3. **8报警同时活动**:连续 1000 次采样最大值 ≤ 10 ms(待确认)。
4. **无突变**:任一负载条件下,扫描周期最大值/平均值比 ≤ 3(无突发尖峰)。
5. **测试代码移除**:测试结束后,OB1 中插入的测试 NETWORK 必须全部移除,重新下装正式版程序,验证扫描周期恢复至正常水平。

---

## 第3章 Modbus RTU注射泵通讯测试

### 3.1 测试目的

测量 FC4 通过 CPU 本体 RS485(Port0)轮询注射泵(站号0x01)与流量计(站号0x02)的通讯性能,验证:
- 单次轮询请求→响应耗时(报文往返时间)
- 一轮2从站轮询周期(注射泵+流量计各1次)
- 超时阈值(注射泵2000ms/流量计1000ms,见变量地址表11.1节)的正确触发
- 通讯中断后的恢复时间
- 长时连续轮询的稳定性

### 3.2 FC4轮询周期测量

**FC4 实现现状**(见 FC4_ModbusPolling.stl):
- NETWORK 1:每周期调用 MBUS_CTRL 初始化主站(Mode=1 RTU, Baud=9600, Parity=0, Port=0)
- NETWORK 2:用 VW250 作为轮询从站计数器(0=注射泵,1=流量计),基于 MBUS_MSG 的 Done 位顺序执行
- 注射泵:读 41001(0x03E8)→写入 VW4(MB_Pump_Status)
- 流量计:读 40010(0x0009)→写入 VD86(MB_Flow_Total)

> **注**:FC4 当前为骨架,实际 MBUS_MSG 参数(站号/地址/功能码)由 Story 1.1 细化。本测试基于 Story 1.1 完成后的实际代码执行。

**测试方法**:

#### 3.2.1 报文往返时间测量(串口抓包法)

**工具**:RS485 通讯抓包器(USB转RS485+串口监听软件,如串口调试助手/Modbus Poll 自带抓包)

**步骤**:
1. RS485 抓包器并联接入 PLC Port0 与从站之间(T形分接,A/B 双线)。
2. 串口监听软件设置 9600/8/N/1,启用时间戳(毫秒精度)。
3. PLC RUN,FC4 持续轮询。
4. 抓取 ≥ 100 次完整请求-响应报文对。
5. 计算每对的"请求最后一字节发出 → 响应第一字节到达"时间差,即从站响应延迟。
6. 计算每对的"请求第一字节发出 → 响应最后一字节接收"总耗时,即单次轮询耗时。

**报文结构(9600bps 理论耗时)**:
- 注射泵读41001(FC03读1寄存器):请求8字节(地址+功能码+起始地址2+数量2+CRC2)≈ 8.3ms,响应7字节(地址+功能码+字节数+数据2+CRC2)≈ 7.3ms,理论总耗时 ≈ 15.6ms + 从站处理延迟(典型 5~30ms)
- 流量计读0x0009(FC03读2寄存器,32位累计值):请求8字节 ≈ 8.3ms,响应9字节(地址+功能码+字节数+数据4+CRC2)≈ 9.4ms,理论总耗时 ≈ 17.7ms + 从站处理延迟

#### 3.2.2 STL内嵌耗时测量法

**STL片段示例(测试用,在FC4中插入)**:

```
// 在 FC4 NETWORK 2 注射泵轮询分支前后插入T33(1ms时基)读取
// 注: T33为TON类型,1ms时基,需选用未占用定时器
NETWORK 2.1: 注射泵轮询耗时测量(测试用)
LD     SM0.0
LPS
AW=    VW250, 0                    // 当前轮询注射泵
TON    T33, 32767                  // T33启动(1ms时基)
MOVW   T33, VW960                  // 请求发出前T33值→VW960

// ... MBUS_MSG 调用 ...

LD     M10.0                       // MBUS_MSG Done位
MOVW   T33, VW962                  // 响应接收后T33值→VW962
-I     VW960, VW962                // VW962 = 单次轮询耗时(ms)
R      T33, 1                      // 复位T33,准备下次
LPP

// 流量计同理,用 T34 + VW964/VW966
```

#### 3.2.3 连续轮询稳定性测量

**步骤**:
1. PLC RUN,FC4 持续轮询 ≥ 1 小时。
2. 用 STL 内嵌法或串口抓包记录每轮(注射泵+流量计)的耗时。
3. 统计 P50/P95/P99/最大值/失败次数。
4. 失败次数定义:MBUS_MSG Done 位返回但 Error ≠ 0,或超时未返回。

### 3.3 超时阈值验证

**依据**:变量地址表 11.1 节"通讯超时"建议值:注射泵 2000ms、流量计 1000ms。FC4 实际超时由 MBUS_MSG 指令的内部超时(默认值)或 Story 1.1 实现的外部超时逻辑(VD_Timeout 相关)决定。

> **注**:VD_Timeout_ValveA/B/C 等为阀门动作超时(见变量地址表 6.3 节),与 Modbus 通讯超时不同。Modbus 通讯超时在变量地址表中标注为"建议值",实际实现位置待 Story 1.1 确认。

**测试步骤**:
1. PLC RUN,Modbus 通讯正常。
2. 断开注射泵 RS485 连线(或关闭从站电源)。
3. 用秒表/STL计时器测量从断开到 V303.4=1(注射泵故障报警)的时间,应 ≤ 2000ms(注射泵超时阈值)。
4. 记录实际超时时间。
5. 恢复从站,观察 V303.4 清除时间。
6. 流量计同理,断开后超时应 ≤ 1000ms(对应报警位待 Story 1.1 确认,流量计故障是否映射到 V303.4 或独立位)。

### 3.4 通讯中断恢复时间测试

**测试步骤**:
1. PLC RUN,Modbus 通讯正常,V303.4=0。
2. 断开 RS485 总线主缆(模拟通讯中断),V303.4 置位。
3. 等待 30 秒。
4. 恢复 RS485 总线连接。
5. 用秒表测量从恢复连接到 V303.4 清零且 VW4(注射泵状态码)读到有效值(0/1/2/3,非错误码)的时间。
6. 重复 3 次,记录平均值。

### 3.5 测试记录表格

#### 3.5.1 单次轮询耗时记录

| 用例ID | 从站 | 寄存器 | 采样次数 | 最小值(ms) | 平均值(ms) | P95(ms) | P99(ms) | 最大值(ms) | 失败次数 | 目标值(ms) | 通过/失败 |
|---|---|---|---|---|---|---|---|---|---|---|---|
| TC-PERF-03-001 | 注射泵 | 41001(FC03读1) | 100 | | | | | | | ≤100 | |
| TC-PERF-03-002 | 流量计 | 0x0009(FC03读2) | 100 | | | | | | | ≤100 | |

#### 3.5.2 一轮2从站轮询周期记录

| 用例ID | 测试条件 | 采样轮数 | 平均周期(ms) | 最大周期(ms) | 失败轮数 | 目标值(ms) | 通过/失败 |
|---|---|---|---|---|---|---|---|
| TC-PERF-03-003 | 1小时连续轮询 | 3600 | | | | ≤500 | |

#### 3.5.3 超时与恢复时间记录

| 用例ID | 测试项 | 第1次(ms) | 第2次(ms) | 第3次(ms) | 平均(ms) | 目标值 | 通过/失败 |
|---|---|---|---|---|---|---|---|
| TC-PERF-03-004 | 注射泵超时触发 V303.4 | | | | | ≤2000ms | |
| TC-PERF-03-005 | 流量计超时触发(对应报警位) | | | | | ≤1000ms | |
| TC-PERF-03-006 | 通讯中断恢复时间 | | | | | ≤10s | |

### 3.6 测试工具

- **Modbus Poll**(Witte Software):PC 端 Modbus 主站模拟软件,可作为从站给 PLC 应答,也可作为主站读取 PLC(若 PLC 配为 Modbus TCP 服务器)。用于 FAT 阶段无真实从站时模拟,以及测量单次请求响应耗时。
- **Modbus Slave**(Witte Software):PC 端 Modbus 从站模拟软件,配置站号0x01(注射泵)/0x02(流量计),预置 41001/0x0009 寄存器值,响应 PLC 轮询。
- **串口调试助手**(如友善串口调试助手/SSCOM):RS485 报文抓包与时间戳记录。
- **USB转RS485适配器**:并联接入总线抓包。
- **秒表/计时器**:超时与恢复时间测量(精度 0.1s)。
- **STEP 7-Micro/WIN SMART 状态图表**:强制 V303.4、读取 VW4/VD86/VW250 等变量。

---

## 第4章 S7协议HMI通讯测试

### 4.1 测试目的

测量 HMI 通过以太网(S7协议或 Modbus TCP,待HMI选型确认,见变量地址表14.2节)访问 PLC V 区的性能,验证:
- HMI 单次读/写 V 区变量的耗时
- HMI 轮询 8 台 PLC 一周的耗时
- HMI 与单台 PLC 连接建立时间
- 单台 PLC 断网后的 HMI 重连时间

> **协议依赖说明**:本测试方案以 S7 协议为主(变量地址表 12.4 节推荐),若 HMI 选型确认采用 Modbus TCP,则第4~5章测试方法不变,工具改用 Modbus Poll 替代 S7 协议测试工具,合格判据不变。

### 4.2 HMI单次读写V区耗时测试

**测试方法(方法A:网络抓包法)**:

1. Wireshark 抓包 PC 接入 HMI 与 PLC 之间交换机的镜像口(或用具备镜像功能的网管型交换机)。
2. Wireshark 过滤器设置:`host 192.168.2.10 and host 192.168.2.101`(HMI 与 PLC#1 之间)。
3. HMI 运行,持续轮询 PLC#1。
4. 抓取 ≥ 100 次 S7 读请求-响应报文对(典型为 S7 协议的 Job/Ack_Data 帧)。
5. 计算每对的"请求发出 → 响应接收"时间差,即单次读耗时。
6. 写操作同理(HMI 设定 VD 参数时触发)。

**测试方法(方法B:HMI内部计时法)**:

1. HMI 工程中,在变量读取脚本前后插入系统时间戳读取(HMI 组态软件通常提供 `GetTickCount()` 或类似函数)。
2. 记录 ≥ 100 次读取的时间差。
3. 该方法依赖 HMI 组态软件脚本能力,若不支持则用方法A。

**测试变量集**:
- 单变量读:VW2(状态机,1个WORD)
- 多变量读(总览页典型集):VW2 + V1.6 + V1.7 + I1.1 + VW6 + VW8 + VD96(共7变量,约 12 字节)
- 写单变量:VD10(VD_C_Set,1个REAL)

### 4.3 HMI轮询8台PLC一周耗时测试

**测试方法**:
1. HMI 工程配置 8 个 PLC 连接(PLC_01~PLC_08,见变量地址表12.2节)。
2. HMI 总览页(画面1)读取每单元 7 个变量(见4.2节多变量集)。
3. Wireshark 抓包,过滤器:`host 192.168.2.10`(HMI 全部流量)。
4. 测量 HMI 完成 8 台 PLC 各 1 次读取的总耗时(从 PLC#1 第1次请求到 PLC#8 最后1次响应)。
5. 重复 ≥ 20 轮,记录平均/最大。

**测试条件**:
- 8 台 PLC 全部在线,IP 192.168.2.101~108 全部 ping 通。
- HMI 总览页处于打开状态(变量主动轮询)。
- 首期若仅 1 套单元实施(见设计文档12.7节),则本测试在全量 8 套接入后执行,首期可用 1 台 PLC 测试单连接性能,8 台并发测试待后续扩展时补测。

### 4.4 HMI连接建立时间测试

**测试方法**:
1. HMI 断电关机。
2. 启动 HMI,同时启动 Wireshark 抓包。
3. 测量从 HMI 第1个 TCP SYN 包到 8 台 PLC 全部完成 S7 连接建立(COTP Connect 响应)的时间。
4. 单台 PLC 连接建立时间 = 该 PLC 的 SYN→Connect 响应时间。
5. 全部 8 台在线时间 = 最后1台 PLC Connect 响应时间 - HMI 启动时间。
6. 重复 3 次。

### 4.5 HMI断线重连时间测试

**测试方法**:
1. 8 台 PLC + HMI 全部在线通讯正常。
2. 拔掉 PLC#1 的网线(或在该 PLC 侧 STOP 模式)。
3. HMI 应在驱动层重连探测周期内检测到通讯中断,显示"通讯中断"(黄色,见设计文档12.7节三态显示)。
4. 测量从断网到 HMI 显示"通讯中断"的时间(检测时间)。
5. 恢复 PLC#1 网线(或 RUN 模式)。
6. 测量从恢复到 HMI 重新显示"在线"(彩色)的时间(重连时间)。
7. 对 8 台 PLC 分别测试,记录每台结果。

### 4.6 测试记录表格

#### 4.6.1 单次读写耗时记录

| 用例ID | 操作类型 | 变量集 | 字节数 | 采样次数 | 平均(ms) | P95(ms) | 最大(ms) | 目标值(ms) | 通过/失败 |
|---|---|---|---|---|---|---|---|---|---|
| TC-PERF-04-001 | 读单变量 | VW2 | 2 | 100 | | | | | ≤50 |
| TC-PERF-04-002 | 读多变量(总览页) | 7变量 | 12 | 100 | | | | | ≤50 |
| TC-PERF-04-003 | 写单变量 | VD10 | 4 | 100 | | | | | ≤50 |

#### 4.6.2 8台轮询一周耗时记录

| 用例ID | 测试条件 | 采样轮数 | 平均(ms) | 最大(ms) | 目标值(ms) | 通过/失败 |
|---|---|---|---|---|---|---|
| TC-PERF-04-004 | 8台在线,总览页打开 | 20 | | | ≤2000 | |

#### 4.6.3 连接建立与断线重连记录

| 用例ID | 测试项 | PLC编号 | 第1次(s) | 第2次(s) | 第3次(s) | 平均(s) | 目标值 | 通过/失败 |
|---|---|---|---|---|---|---|---|---|
| TC-PERF-04-005 | 8台全部连接建立 | 全部8台 | | | | | ≤3 | |
| TC-PERF-04-006 | 单台断线检测 | PLC#1 | | | | | ≤5(待确认) | |
| TC-PERF-04-007 | 单台重连恢复 | PLC#1 | | | | | ≤5 | |
| TC-PERF-04-008 | 单台断线检测 | PLC#2~8 | | | | | ≤5 | |
| TC-PERF-04-009 | 单台重连恢复 | PLC#2~8 | | | | | ≤5 | |

---

## 第5章 8连接并发压力测试

### 5.1 测试目的

验证 1 台 HMI 同时连接 8 台 PLC(192.168.2.101~108)的并发性能,包括:
- 单 PLC 响应延迟分布(8台同时被轮询时,单台响应是否退化)
- 8 连接丢包率(请求失败次数/总次数)
- 长时间稳定性(连续 24 小时,与 SAT_FAT TC-11-001 互补)

### 5.2 单PLC响应延迟分布测试

**测试方法**:
1. 8 台 PLC 全部在线,IP 192.168.2.101~108。
2. HMI 总览页打开,8 个连接并发轮询。
3. Wireshark 抓包,过滤器 `host 192.168.2.10`。
4. 持续抓包 ≥ 10 分钟(每台 PLC 被轮询 ≥ 600 次)。
5. 按目标 PLC 分组,统计每台 PLC 的请求-响应时间分布(P50/P95/P99/最大)。
6. 比较单连接(4章)与8连接并发时的响应延迟差异。

### 5.3 丢包率测试

**测试方法**:
1. 8 台 PLC 全部在线。
2. Wireshark 持续抓包 1 小时。
3. 统计 HMI 发出的 S7 请求总数与收到的响应总数。
4. 丢包率 = (请求总数 - 响应总数) / 请求总数 × 100%。
5. 若 HMI 组态软件有"通讯质量统计"或"重试次数"日志,作为辅助验证。

### 5.4 长时间稳定性测试(24小时)

**与 SAT_FAT TC-11-001 关系**:SAT_FAT TC-11-001 为单套 PLC 24 小时连续运行,本测试扩展为 8 台 PLC 同时被 HMI 轮询的 24 小时并发稳定性,引用 SAT_FAT TC-11-001 的判定准则并扩展。

**测试方法**:
1. 8 台 PLC 全部 RUN,均处于 S5(实验运行中)态或正常循环态。
2. HMI 总览页持续轮询 8 台 PLC。
3. 连续运行 24 小时,每小时记录:
   - 8 台 PLC 各自的 VW2(状态)、VW6(报警码)、VW8(轮次)、VD96(实验时长)
   - HMI 8 个连接的通讯状态(在线/中断)
   - HMI 报警/趋势页是否有新报警
   - 各 PLC 扫描周期(VW980~VW984 测试记录区,见2.2.2节)
4. 24 小时结束后统计:
   - 8 台 PLC 是否均无未预期 S_ERROR(VW2=99 非人工触发)
   - HMI 是否有通讯中断 > 30 秒
   - 任一 PLC 扫描周期最大值是否超出 2.3 节目标值
   - HMI 内存占用是否显著增长(见第7章)

### 5.5 测试记录表格

#### 5.5.1 单PLC响应延迟分布(8连接并发)

| 用例ID | PLC编号 | 采样次数 | P50(ms) | P95(ms) | P99(ms) | 最大(ms) | 目标值P95(ms) | 通过/失败 |
|---|---|---|---|---|---|---|---|---|
| TC-PERF-05-001 | PLC#1 | 600 | | | | | ≤100 | |
| TC-PERF-05-002 | PLC#2 | 600 | | | | | ≤100 | |
| TC-PERF-05-003 | PLC#3 | 600 | | | | | ≤100 | |
| TC-PERF-05-004 | PLC#4 | 600 | | | | | ≤100 | |
| TC-PERF-05-005 | PLC#5 | 600 | | | | | ≤100 | |
| TC-PERF-05-006 | PLC#6 | 600 | | | | | ≤100 | |
| TC-PERF-05-007 | PLC#7 | 600 | | | | | ≤100 | |
| TC-PERF-05-008 | PLC#8 | 600 | | | | | ≤100 | |

#### 5.5.2 丢包率记录

| 用例ID | 测试时长 | 请求总数 | 响应总数 | 失败次数 | 丢包率 | 目标值 | 通过/失败 |
|---|---|---|---|---|---|---|---|
| TC-PERF-05-009 | 1小时 | | | | | <0.1% | |

#### 5.5.3 24小时并发稳定性

| 用例ID | PLC编号 | 24h内S_ERROR次数 | 24h内通讯中断>30s次数 | 24h内扫描周期最大值(ms) | 通过/失败 |
|---|---|---|---|---|---|
| TC-PERF-05-010 | PLC#1 | | | | |
| TC-PERF-05-011 | PLC#2 | | | | |
| TC-PERF-05-012 | PLC#3 | | | | |
| TC-PERF-05-013 | PLC#4 | | | | |
| TC-PERF-05-014 | PLC#5 | | | | |
| TC-PERF-05-015 | PLC#6 | | | | |
| TC-PERF-05-016 | PLC#7 | | | | |
| TC-PERF-05-017 | PLC#8 | | | | |

### 5.6 测试工具

- **Wireshark**:以太网抓包,S7协议/Modbus TCP报文分析,带时间戳统计。
- **网管型交换机(支持端口镜像)**:用于将 HMI 流量镜像到抓包 PC。
- **HMI 组态软件通讯日志**:若 HMI 驱动层提供通讯质量/重试日志,作为丢包率辅助验证。
- **STEP 7-Micro/WIN SMART 状态图表**:监控 8 台 PLC 各自变量。
- **ping 命令**:8 台 PLC 网络连通性快速验证。

---

## 第6章 HMI画面刷新率测试

### 6.1 测试目的

测量 HMI 各画面的实际刷新周期与操作响应延迟,验证:
- 主监控画面(画面1-总览页8单元卡片)刷新率
- 趋势曲线画面(画面6)刷新率
- 报警日志画面(画面5)刷新率
- 参数设置画面(画面4)操作响应延迟
- 变量数量与刷新率的关系

> **画面编号依据**:见变量地址表第13章 HMI-PLC 变量交互总表。

### 6.2 各画面刷新率测试

#### 6.2.1 主监控画面(画面1-总览页)

**变量集**(每单元卡片,见变量地址表13.1节):VW2、V1.6、V1.7、I1.1、VW6、VW8、VD96,共7变量/单元 × 8单元 = 56变量/页。

**测试方法**:
1. HMI 打开画面1,8 台 PLC 在线。
2. 在 PLC#1 侧用状态图表强制 VW2 由 6 变为 7(S5→S6 状态切换)。
3. 用秒表测量从 PLC 强制到 HMI 总览页 PLC#1 卡片状态显示更新的时间。
4. 重复 10 次,记录平均/最大。
5. 同步在 8 台 PLC 同时切换状态,测量并发刷新延迟。

#### 6.2.2 趋势曲线画面(画面6)

**变量集**(见变量地址表13.6节):VD70/VD74/VD78(实测时长)、VD90(进水量)、VD94(流速)、VD96(实验时长)、VD112/VD116(滚动T/S6),共8变量。

**测试方法**:
1. HMI 打开画面6,PLC 运行中。
2. 测量趋势曲线数据点的更新间隔(从 PLC 数据变化到曲线刷新)。
3. 若 HMI 组态软件支持,读取趋势采样周期配置值。
4. 用秒表测量 10 次刷新的实际间隔。

#### 6.2.3 报警日志画面(画面5)

**变量集**(见变量地址表13.5节):VW6(当前报警码)、VB300~VB303(报警字)。

**测试方法**:
1. HMI 打开画面5。
2. PLC 侧强制 V300.0=1(上缸漫溢报警)。
3. 用秒表测量从 PLC 报警位置位到 HMI 报警画面弹出新报警的时间。
4. 重复 10 次,记录平均/最大。
5. 报警刷新应最快,因报警涉及安全提示。

#### 6.2.4 参数设置画面(画面4)

**变量集**(见变量地址表13.4节):VD10~VD66(全部设定参数)、VD132~VD140(泵速度)、M_AlarmAckMode(V200.0)。

**测试方法**:
1. HMI 打开画面4。
2. 操作员在 HMI 设定 VD_C_Set(VD10)由 5.0 改为 6.0,点击"确认"(若HMI配置二次确认,则含二次确认)。
3. 用秒表测量从点击"确认"到 PLC 侧 VD10 实际更新为 6.0 的时间(通过状态图表监控)。
4. 重复 10 次,记录平均/最大。

### 6.3 变量数与刷新率关系测试

**测试方法**:
1. 在 HMI 工程中,创建一个测试画面,绑定 PLC#1 的 N 个变量(N=10/50/100/200)。
2. 分别测量 N=10/50/100/200 时的画面刷新周期。
3. 记录变量数与刷新周期的对应关系,作为 HMI 工程优化依据。

### 6.4 操作响应延迟测试

**测试项**:
- 按钮点击响应(如手动控制页 V2.4 手动开阀A命令下发,见变量地址表4.4节)
- 画面切换响应(画面1→画面2 单元详情页切换时间)
- 二次确认弹窗响应(高优先级报警确认 V0.3,见设计文档8.2节)

### 6.5 测试记录表格

#### 6.5.1 各画面刷新率记录

| 用例ID | 画面 | 变量数 | 测试10次平均(ms) | 最大(ms) | 目标值(ms) | 通过/失败 |
|---|---|---|---|---|---|---|
| TC-PERF-06-001 | 画面1-总览页 | 56 | | | ≤1000 | |
| TC-PERF-06-002 | 画面6-趋势曲线 | 8 | | | ≤2000 | |
| TC-PERF-06-003 | 画面5-报警日志 | 5 | | | ≤500 | |
| TC-PERF-06-004 | 画面4-参数设置(操作响应) | 1(写VD10) | | | ≤1000 | |

#### 6.5.2 变量数与刷新率关系记录

| 用例ID | 变量数N | 刷新周期(ms) | 备注 |
|---|---|---|---|
| TC-PERF-06-005 | 10 | | |
| TC-PERF-06-006 | 50 | | |
| TC-PERF-06-007 | 100 | | |
| TC-PERF-06-008 | 200 | | |

#### 6.5.3 操作响应延迟记录

| 用例ID | 操作项 | 10次平均(ms) | 最大(ms) | 目标值(ms) | 通过/失败 |
|---|---|---|---|---|---|
| TC-PERF-06-009 | 按钮 V2.4 命令下发 | | | ≤500 | |
| TC-PERF-06-010 | 画面1→画面2切换 | | | ≤1000 | |
| TC-PERF-06-011 | V0.3 报警确认(二次确认) | | | ≤1000 | |

### 6.6 测试工具

- **秒表/计时器**:操作响应延迟测量(精度 0.1s,如需更高精度用视频帧分析法)。
- **HMI 组态软件运行时日志**:若 HMI 提供"变量更新时间戳"或"操作日志",作为辅助。
- **STEP 7-Micro/WIN SMART 状态图表**:监控 PLC 侧变量更新时刻。
- **视频录像(手机/相机,60fps)**:对操作-响应过程录像,帧分析法精确至 16.7ms,适合亚秒级测量。

---

## 第7章 内存与资源占用

### 7.1 PLC工作内存占用测试

**测试目的**:验证 OB1+所有FC编译后占用 CPU ST20 工作内存 ≤ 70%(8.4KB/12KB)。

**测试方法**:
1. STEP 7-Micro/WIN SMART 中,执行"PLC→编译"。
2. 编译输出窗口显示"程序内存使用量 X 字节 / 12288 字节"(CPU ST20 工作内存12KB)。
3. 记录程序代码占用 + 数据占用 + 系统开销。
4. 计算占用率 = 占用量 / 12288 × 100%。

### 7.2 PLC断电保持区占用测试

**测试目的**:验证实际使用的断电保持V区范围 ≤ 配置保持区的80%。

**测试方法**:
1. 在系统块→断电保持中核对配置范围(见变量地址表附录A):VB0~VB9、VB10~VB149、VB150~VB199、VB200~VB229、VB230~VB289、VB300~VB304、VB305~VB349、VB500~VB599、DT10。
2. 统计实际使用地址范围(见变量地址表附录B快速索引)。
3. 计算占用率 = 实际使用字节数 / 配置保持区总字节数 × 100%。

### 7.3 HMI内存与存储占用测试

**测试目的**:验证 HMI 运行时内存占用 ≤ 70%,24小时运行后存储占用 ≤ 80%。

**测试方法**:
1. HMI 工程下装,启动运行。
2. 通过 HMI 组态软件的系统监控功能(若支持)或 HMI 系统设置页查看:
   - 运行时内存占用(MB 或 %)
   - 存储占用(报警记录/历史趋势/工程文件)
3. 24 小时连续运行后再次记录,计算存储增长。
4. 若 HMI 无内置监控,通过组态软件下装时的"工程大小"估算。

### 7.4 长时间运行内存泄漏检测

**测试目的**:验证 PLC 扫描周期与 HMI 内存在 24 小时运行后无显著增长(≤ 10%)。

**测试方法**:
1. PLC 启动后,记录初始扫描周期(用2.2.2节方法B,记录 VW980~VW984)。
2. HMI 启动后,记录初始内存占用。
3. 连续运行 24 小时(S5态循环换水)。
4. 24小时后再次记录扫描周期与 HMI 内存。
5. 计算变化率 = (终值 - 初值) / 初值 × 100%。

**判定准则**:
- PLC 扫描周期变化率 ≤ 10%(无突变尖峰,无明显增长趋势)
- HMI 内存变化率 ≤ 10%(无内存泄漏)

> **PLC 侧说明**:S7-200 SMART 无动态内存分配,扫描周期增长通常源于:
> - 报警日志缓冲区(VB500~VB599)写入量增加(FC3 NETWORK6,见 SAT_FAT TC-08-011)
> - 历史数据累加(VD_T_Rolling、VD_S6_Rolling 等滚动变量)
> 若扫描周期增长 > 10%,需排查上述变量写入逻辑。

### 7.5 测试记录表格

| 用例ID | 测试项 | 初始值 | 24h后值 | 变化率 | 目标值 | 通过/失败 |
|---|---|---|---|---|---|---|
| TC-PERF-07-001 | PLC工作内存占用 | — KB | —(编译时静态) | — | ≤70% | |
| TC-PERF-07-002 | PLC断电保持区占用 | — 字节 | —(静态) | — | ≤80% | |
| TC-PERF-07-003 | HMI内存占用(初始) | — MB | — MB | —% | ≤70% | |
| TC-PERF-07-004 | HMI存储占用(24h后) | — MB | — MB | —% | ≤80% | |
| TC-PERF-07-005 | PLC扫描周期变化率 | — ms | — ms | —% | ≤10% | |
| TC-PERF-07-006 | HMI内存变化率 | — MB | — MB | —% | ≤10% | |

---

## 第8章 极限工况测试

### 8.1 测试目的

验证系统在边界条件下的行为符合设计预期,包括:
- 最大报警并发(8套同时活动报警)
- 最快换水周期(短 VD_CycleSetpoint 设定值)
- 最长实验时长(长 VD_ExperimentTarget 设定值)
- 参数边界值设定(VD 区各参数上下限)

### 8.2 最大报警并发测试

**测试目的**:验证 8 个不同报警位同时置位时,FC3 优先级链正确遍历,VW6 正确反映最高优先级,扫描周期不超标。

**测试方法**:
1. PLC RUN,无活动报警。
2. 通过状态图表一次性强制 8 个报警位同时置位(对应8套每套1个报警并发场景):
   - V300.0(上缸漫溢,代码10)
   - V300.4(急停锁存,代码14)
   - V300.5(安全继电器故障,代码99)
   - V300.6(节奏严重滞后,代码20)
   - V301.0(阀A关后仍有流,代码30)
   - V302.0(阀B四态诊断异常,代码40)
   - V302.5(阀C四态诊断异常,代码45)
   - V303.4(注射泵故障,代码64)
3. 观察下一扫描周期:
   - VW6 应 = 99(最高优先级为安全继电器故障)
   - Q8.0=1(灯光常亮)
   - Q0.7=1(声音报警)
   - FC3 优先级链遍历全部 8 位
4. 同时用 2.2 节方法测量扫描周期,确认 ≤ 10ms(8报警同时活动判据)。
5. 逐个清除报警位(按优先级从低到高),观察 VW6 跟随更新。

### 8.3 最快换水周期测试

**测试目的**:验证在 VD_CycleSetpoint 设定为理论下限值时,S1~S6 流程能完整执行无 S_ERROR。

**理论下限值计算**:
- VD_CycleSetpoint 下限 ≈ VD_T_Rolling(S1+S2+S3+S3.5 标称总时长) + VD_S6_Rolling(S6 排水时长)
- 默认参数:VD_PreMixTime=120s + VD_RestTime=60s + S1估算60s + S3估算30s = 270s + VD_S6_Default 估算30s = 300s ≈ 5min
- 即 VD_CycleSetpoint 下限约为 5min(默认参数下),实际下限需现场实测核定。

**测试方法**:
1. 将 VD_CycleSetpoint 设为下限值(待确认,默认参数下建议 5min)。
2. 启动实验,VW2=0→S1→S2→S3→S3.5→S4→S5→S6→S5 循环。
3. 观察 3 个完整循环,确认:
   - 每轮 S1~S6 状态切换正常,无 S_ERROR
   - VD_S5_Elapsed 在 S5 态累加,达到 VD_CycleSetpoint×60 后转 S6
   - VD_T_Rolling、VD_S6_Rolling 滚动更新
   - DT10 每轮更新
   - FC40 节奏纠偏不触发人工介入报警(V300.6=0),或仅触发 V300.7 滞后提示(可接受)
4. 若触发 V300.6(严重滞后人工介入),说明 VD_CycleSetpoint 设定过短,需上调。

### 8.4 最长实验时长测试

**测试目的**:验证 VD_ExperimentDuration_Accum 累加至 VD_ExperimentTarget 后正确转 S7,且长时间运行无累计误差。

**测试方法**:
1. 将 VD_ExperimentTarget 设为较短测试值(如 30min,缩短测试时长)。
2. 启动实验,VW2 进入 S5 循环。
3. 持续运行,观察 VD_ExperimentDuration_Accum 累加(仅下缸满期间累加,见设计文档第十章)。
4. 当 VD_ExperimentDuration_Accum ≥ VD_ExperimentTarget 时,确认:
   - VW2 由 6 转为 8(S7 实验结束)
   - QB0=0(所有输出停)
   - VD96 锁定最终值
   - HMI 提示"实验时长已达标,实验结束"
5. 需 HMI 确认 CMD_Start(V0.0)后才能回 S0(不自动重启)。
6. 累计误差验证:对比 VD_ExperimentDuration_Accum 与秒表实测下缸满总时长,误差 ≤ 1%(以 PLC RTC 为基准)。

### 8.5 参数边界值设定测试

**测试目的**:验证 VD 区各参数在边界值设定时的系统行为。

**测试边界值清单**(基于变量地址表6章):

| 参数 | 地址 | 默认值 | 下限测试值 | 上限测试值 | 测试要点 |
|---|---|---|---|---|---|
| VD_C_Set | VD10 | 5.0% | 0.1% | 99.9% | VD_Dose_Steps 计算不溢出 |
| VD_C_Stock | VD14 | 100.0% | 1.0% | 100.0% | VD_C_Set < VD_C_Stock 否则 VD_Vol_Target 异常 |
| VD_StepResolution | VD18 | 0.2083µL/步 | 0.01 | 10.0 | VD_Dose_Steps 不超注射泵最大行程 |
| VD_CycleSetpoint | VD20 | 30.0min | 5.0(待确认) | 1440(24h) | 8.3节最快换水周期 |
| VD_ExperimentTarget | VD24 | 480.0min | 1.0 | 10080(7天) | 8.4节最长实验时长 |
| VD_PreMixTime | VD28 | 120.0s | 30.0(MinSafe) | 600.0 | S2 计时正常 |
| VD_PreMixTime_MinSafe | VD32 | 30.0s | 10.0 | VD_PreMixTime | 必须小于 VD_PreMixTime |
| VD_RestTime | VD36 | 60.0s | 15.0(Min) | 600.0 | S3.5 计时正常 |
| VD_RestTime_Min | VD40 | 15.0s | 5.0 | VD_RestTime | 必须小于 VD_RestTime |
| VD_CycleExtend_Max | VD44 | 5.0min | 0.0 | 30.0 | 第2层纠偏上限 |
| VD_Timeout_ValveA/B/C | VD48/50/54 | 60.0s | 10.0 | 300.0 | 阀门超时保护 |
| VD_Timeout_Pump1/2 | VD58/62 | 10.0s | — | — | 预留未用（原泵超时保护，水流开关取消） |
| VD_Delay_ValveA_Verify | VD66 | 5.0s | 1.0 | 30.0 | 阀A延时验证 |

**测试方法**:
1. 对每个参数,分别设为下限和上限测试值。
2. 启动实验,观察系统行为是否符合设计预期。
3. 重点关注:
   - 数值计算不溢出(VD_Dose_Steps 不超注射泵最大步数,设计文档未明确最大步数,待确认)
   - 纠偏逻辑不出现负数或除零(VD_RestTime_Min < VD_RestTime,VD_PreMixTime_MinSafe < VD_PreMixTime)
   - 计时器 PT 转换值(VW252/254/278/280/282/284 等,见变量地址表附录A)不超 TON 指令 PT 上限(32767)

### 8.6 测试记录表格

| 用例ID | 测试项 | 测试条件 | 预期结果 | 实测结果 | 通过/失败 |
|---|---|---|---|---|---|
| TC-PERF-08-001 | 8报警同时活动 | 8位强制置位 | VW6=99,扫描周期≤10ms | | |
| TC-PERF-08-002 | 最快换水周期(5min) | VD_CycleSetpoint=5min | 3轮S1~S6无S_ERROR | | |
| TC-PERF-08-003 | 最长实验时长(30min测试) | VD_ExperimentTarget=30min | VD96≥30时转S7,误差≤1% | | |
| TC-PERF-08-004 | VD_C_Set=0.1% | VD10=0.1 | VD_Dose_Steps 计算不溢出 | | |
| TC-PERF-08-005 | VD_C_Set=99.9% | VD10=99.9,VD_C_Stock=100 | VD_Dose_Steps 不超最大行程 | | |
| TC-PERF-08-006 | VD_CycleSetpoint=1440min | VD20=1440 | S5态正常累加,无溢出 | | |
| TC-PERF-08-007 | VD_PreMixTime=MinSafe | VD28=VD32=30 | S2 计时正常,纠偏第1层满 | | |
| TC-PERF-08-008 | VD_Timeout_ValveA=10s | VD48=10 | 阀A超时报警正常触发 | | |

---

## 第9章 测试工具清单

### 9.1 硬件工具清单

| 序号 | 工具名称 | 型号/规格 | 用途 | 必需/可选 |
|---|---|---|---|---|
| 1 | 数字示波器 | 2通道以上,带宽≥10MHz,带统计功能 | 第2章扫描周期Q点翻转测量 | 必需(方法A) |
| 2 | 数字万用表 | 通用型,可测24VDC/通断 | DO 点位检测、继电器触点验证 | 必需 |
| 3 | USB转RS485适配器 | 自动收发控制,支持9600~115200bps | 第3章Modbus报文抓包 | 必需 |
| 4 | RS485通讯抓包器(或T形分接器) | 与USB转RS485配合 | 第3章总线并联监听 | 必需 |
| 5 | 网管型交换机(支持端口镜像) | 9口以上,1Gbps | 第4~5章HMI流量镜像抓包 | 必需 |
| 6 | 抓包PC(笔记本) | 双网卡(以太网+USB) | Wireshark 抓包 + STEP 7 状态图表 | 必需 |
| 7 | 秒表/计时器 | 精度0.1s | 第3/6章耗时测量 | 必需 |
| 8 | 视频录像设备(手机/相机) | 60fps以上 | 第6章操作响应帧分析法 | 可选 |
| 9 | 编程PC | 以太网口,STEP 7-Micro/WIN SMART | PLC程序下装、状态图表监控 | 必需 |
| 10 | 信号发生器/短接线 | DI 模拟用 | 第2章负载条件模拟 | 必需 |
| 11 | 24VDC稳压电源 | 提供 PLC DI 回路电源 | DI 模拟时供电 | 必需 |
| 12 | 中间继电器组 | 用于阀门限位反馈有源→无源转换 | DI 模拟阀位反馈 | 必需 |
| 13 | 急停按钮+安全继电器组件 | 强制导向型 | 急停场景模拟 | 必需 |

### 9.2 软件工具清单

| 序号 | 工具名称 | 版本 | 用途 | 必需/可选 |
|---|---|---|---|---|
| 1 | STEP 7-Micro/WIN SMART | V2.5及以上 | PLC程序下装、状态图表监控、变量强制、编译内存统计 | 必需 |
| 2 | Wireshark | 4.x | 第4~5章以太网S7/Modbus TCP抓包分析 | 必需 |
| 3 | Modbus Poll | V9及以上 | 第3章Modbus主站模拟、单次请求响应测量 | 必需 |
| 4 | Modbus Slave | V7及以上 | 第3章Modbus从站模拟(注射泵站号0x01/流量计站号0x02) | 必需(FAT阶段) |
| 5 | 串口调试助手 | 任意(如SSCOM、友善串口调试助手) | 第3章RS485报文抓包与时间戳记录 | 必需 |
| 6 | HMI 组态软件 | 与HMI选型一致(如昆仑通态MCGS) | HMI工程下装、运行时监控、变量绑定 | 必需 |
| 7 | HMI 测试模式/调试模式 | HMI组态软件自带 | 第6章画面刷新率/操作响应测试 | 必需(若HMI支持) |
| 8 | ping 命令 | 操作系统自带 | 8台PLC网络连通性快速验证 | 必需 |
| 9 | Excel/WPS表格 | 任意 | 测试数据记录、统计、图表生成 | 必需 |

### 9.3 测试脚本清单

| 序号 | 脚本名称 | 实现位置 | 用途 | 何时插入/移除 |
|---|---|---|---|---|
| 1 | OB1扫描周期测试-Q点翻转(STL) | OB1 NETWORK 0/7 | 第2章方法A,示波器测扫描周期 | 测试时插入,测试后移除 |
| 2 | OB1扫描周期测试-SMW22记录(STL) | OB1 NETWORK 8 | 第2章方法B,SMW22读取累加 | 测试时插入,测试后移除 |
| 3 | OB1扫描周期测试-T32差值(STL) | OB1 NETWORK 0/7 | 第2章方法B,T32高精度差值 | 测试时插入,测试后移除 |
| 4 | FC4单次轮询耗时测量(STL) | FC4 NETWORK 2.1 | 第3章Modbus单次轮询耗时测量 | 测试时插入,测试后移除 |
| 5 | HMI变量读取耗时测量脚本 | HMI工程(脚本区) | 第4章方法B,HMI内部计时 | 测试时插入,测试后移除 |
| 6 | HMI变量数-刷新率测试画面 | HMI工程(测试画面) | 第6章变量数与刷新率关系 | 测试时插入,测试后移除 |

> **重要**:所有测试脚本使用 VW960~VW999、VD960~VD999 等地址区作为测试记录区(需确认与正式变量地址表不冲突,见变量地址表附录A,正式变量最大地址 VB599/DT10,故 VW960~VW999 在 V960~V999 区域空闲)。测试结束后必须全部移除,重新下装正式版程序,并验证无残留。

---

## 第10章 测试报告模板

### 10.1 测试报告封面

| 项目 | 内容 |
|---|---|
| 测试报告名称 | AQUA-EXPO 药液配置加注控制系统性能基准测试报告 |
| 测试报告版本 | v1.0(对应测试方案v1.0) |
| 测试日期 | YYYY-MM-DD ~ YYYY-MM-DD |
| 测试地点 | □ 工厂 FAT □ 现场 SAT |
| 测试负责人 | |
| 测试人员 | |
| 客户代表 | |
| 调试工程师 | |
| PLC开发工程师 | |
| HMI型号/版本 | (待HMI选型确认后填) |
| PLC程序版本 | (对应Story1.2~1.7交付版本) |

### 10.2 测试结果汇总表

| 章节 | 测试项 | 用例数 | 通过数 | 失败数 | 通过率 |
|---|---|---|---|---|---|
| 第2章 | PLC扫描周期测试 | 3 | | | |
| 第3章 | Modbus RTU注射泵通讯测试 | 6 | | | |
| 第4章 | S7协议HMI通讯测试 | 9 | | | |
| 第5章 | 8连接并发压力测试 | 17 | | | |
| 第6章 | HMI画面刷新率测试 | 11 | | | |
| 第7章 | 内存与资源占用 | 6 | | | |
| 第8章 | 极限工况测试 | 8 | | | |
| **合计** | | **60** | | | |

### 10.3 各项测试结果记录表

#### 10.3.1 第2章 PLC扫描周期测试结果

| 用例ID | 负载条件 | 目标值(ms) | 实测最大值(ms) | 实测P95(ms) | 通过/失败 | 备注 |
|---|---|---|---|---|---|---|
| TC-PERF-02-001 | 空载 | ≤5 | | | | |
| TC-PERF-02-002 | S5运行中 | ≤8 | | | | |
| TC-PERF-02-003 | 8报警同时活动 | ≤10 | | | | |

#### 10.3.2 第3章 Modbus通讯测试结果

| 用例ID | 测试项 | 目标值 | 实测平均 | 实测最大 | 通过/失败 | 备注 |
|---|---|---|---|---|---|---|
| TC-PERF-03-001 | 注射泵单次轮询 | ≤100ms | | | | |
| TC-PERF-03-002 | 流量计单次轮询 | ≤100ms | | | | |
| TC-PERF-03-003 | 一轮2从站周期 | ≤500ms | | | | |
| TC-PERF-03-004 | 注射泵超时触发 | ≤2000ms | | | | |
| TC-PERF-03-005 | 流量计超时触发 | ≤1000ms | | | | |
| TC-PERF-03-006 | 通讯中断恢复 | ≤10s | | | | |

#### 10.3.3 第4章 HMI通讯测试结果

| 用例ID | 测试项 | 目标值 | 实测平均 | 实测最大 | 通过/失败 | 备注 |
|---|---|---|---|---|---|---|
| TC-PERF-04-001~003 | 单次读写V区 | ≤50ms | | | | |
| TC-PERF-04-004 | 8台轮询一周 | ≤2s | | | | |
| TC-PERF-04-005 | 8台连接建立 | ≤3s | | | | |
| TC-PERF-04-006~009 | 断线检测/重连 | ≤5s | | | | |

#### 10.3.4 第5章 8连接并发压力测试结果

| 用例ID | 测试项 | 目标值 | 实测结果 | 通过/失败 | 备注 |
|---|---|---|---|---|---|
| TC-PERF-05-001~008 | 8台单PLC响应P95 | ≤100ms | | | |
| TC-PERF-05-009 | 1小时丢包率 | <0.1% | | | |
| TC-PERF-05-010~017 | 24小时并发稳定性 | 0次未预期S_ERROR | | | |

#### 10.3.5 第6章 HMI画面刷新率测试结果

| 用例ID | 画面/操作 | 目标值 | 实测平均(ms) | 实测最大(ms) | 通过/失败 |
|---|---|---|---|---|---|
| TC-PERF-06-001 | 画面1-总览页 | ≤1000ms | | | |
| TC-PERF-06-002 | 画面6-趋势曲线 | ≤2000ms | | | |
| TC-PERF-06-003 | 画面5-报警日志 | ≤500ms | | | |
| TC-PERF-06-004 | 画面4-参数设置 | ≤1000ms | | | |
| TC-PERF-06-009~011 | 操作响应 | ≤500~1000ms | | | |

#### 10.3.6 第7章 内存与资源占用测试结果

| 用例ID | 测试项 | 目标值 | 实测值 | 通过/失败 | 备注 |
|---|---|---|---|---|---|
| TC-PERF-07-001 | PLC工作内存 | ≤70% | | | |
| TC-PERF-07-002 | PLC断电保持区 | ≤80% | | | |
| TC-PERF-07-003 | HMI内存 | ≤70% | | | |
| TC-PERF-07-004 | HMI存储(24h) | ≤80% | | | |
| TC-PERF-07-005 | PLC扫描周期变化率 | ≤10% | | | |
| TC-PERF-07-006 | HMI内存变化率 | ≤10% | | | |

#### 10.3.7 第8章 极限工况测试结果

| 用例ID | 测试项 | 目标值/预期 | 实测结果 | 通过/失败 | 备注 |
|---|---|---|---|---|---|
| TC-PERF-08-001 | 8报警同时活动 | VW6=99,扫描≤10ms | | | |
| TC-PERF-08-002 | 最快换水周期 | 3轮S1~S6无S_ERROR | | | |
| TC-PERF-08-003 | 最长实验时长 | 转S7,误差≤1% | | | |
| TC-PERF-08-004~008 | 参数边界值 | 符合设计预期 | | | |

### 10.4 问题记录表

| 序号 | 问题描述 | 关联用例ID | 严重等级 | 发现日期 | 责任人 | 整改措施 | 整改期限 | 验证结果 |
|---|---|---|---|---|---|---|---|---|
| 1 | | | | | | | | |
| 2 | | | | | | | | |
| 3 | | | | | | | | |

> **严重等级定义**(与 SAT_FAT 一致):
> - **致命**:导致安全功能失效、急停失效、状态机死锁、数据丢失等,必须立即整改,拒收。
> - **严重**:性能指标严重超标、功能异常但有规避措施,限期整改。
> - **一般**:性能指标轻微超标、不影响安全与核心功能,记录跟踪。

### 10.5 结论判定

| 判定项 | 标准 | 实测 | 结论 |
|---|---|---|---|
| 必测项通过率 | 100% | | □ 通过 □ 不通过 |
| 致命问题数 | 0 | | □ 通过 □ 不通过 |
| 严重问题数 | ≤ 2(限期整改) | | □ 通过 □ 不通过 |
| 性能指标达标率 | ≥ 90% | | □ 通过 □ 不通过 |
| 24小时并发稳定性 | 0次未预期S_ERROR | | □ 通过 □ 不通过 |

**综合结论**:

□ 全部通过,性能符合设计要求,同意交付

□ 部分不通过,限期整改后复验

□ 不通过,需重大整改

### 10.6 签字页

| 角色 | 姓名 | 签字 | 日期 |
|---|---|---|---|
| 测试负责人 | | | |
| 调试工程师 | | | |
| PLC开发工程师 | | | |
| HMI开发工程师 | | | |
| 客户代表 | | | |
| 质量检验员 | | | |

---

## 附录A:测试方案与SAT_FAT用例互补说明

本测试方案与《SAT_FAT验收测试用例》v1.0 的关系:

| SAT_FAT 章节 | SAT_FAT 内容 | 本方案对应章节 | 关系 |
|---|---|---|---|
| 第3章 | DI/DO点位强制测试 | — | 不重复,SAT_FAT已覆盖功能正确性 |
| 第4章 | 状态机验收 | — | 不重复 |
| 第5章 | 阀门诊断验收 | — | 不重复 |
| 第6章 | 节奏纠偏验收 | 第8章(最快换水周期) | 本方案补充极限工况,不重复纠偏逻辑 |
| 第7章 | 急停验收 | — | 不重复 |
| 第8章 | 报警验收 | 第8章(8报警同时活动) | 本方案补充并发报警性能,不重复报警逻辑 |
| 第9章 | 断电恢复验收 | — | 不重复 |
| 第10章 | Modbus通讯功能验收 | 第3章(Modbus通讯性能) | 本方案补充通讯耗时/超时/恢复时间量化,不重复功能 |
| 第11章 | 长时稳定性(24h单套) | 第5章(24h 8套并发) | 本方案扩展为8套并发,引用TC-11-001判定准则 |

> **本方案不重复 SAT_FAT 的功能用例**,仅补充 SAT_FAT 未量化的性能指标。测试时,先执行 SAT_FAT 全部【必测】项确认功能正确,再执行本方案性能测试。

## 附录B:待确认事项追踪表

本方案中标注"待确认"的事项,需在 HMI 选型(AQEX-24)确认、现场实测后核定:

| 序号 | 待确认事项 | 影响章节 | 责任人 | 核定期限 | 状态 |
|---|---|---|---|---|---|
| 1 | PLC扫描周期目标值(<5ms/<8ms/<10ms) | 第1/2章 | PLC开发工程师 | FAT前 | 待确认 |
| 2 | HMI选型确认(S7协议或Modbus TCP) | 第4/5章 | HMI开发工程师 | — | 待确认(变量地址表14.2节) |
| 3 | HMI单次读写V区耗时目标值(<50ms) | 第1/4章 | HMI开发工程师 | HMI选型后 | 待确认 |
| 4 | HMI连接建立/重连时间目标值 | 第1/4章 | HMI开发工程师 | HMI选型后 | 待确认 |
| 5 | 8连接并发单PLC响应P95目标值 | 第1/5章 | 调试工程师 | 现场8套接入后 | 待确认 |
| 6 | HMI画面刷新率目标值 | 第1/6章 | HMI开发工程师 | HMI选型后 | 待确认 |
| 7 | HMI内存/存储规格 | 第7章 | HMI开发工程师 | HMI选型后 | 待确认 |
| 8 | 最快换水周期下限值 | 第8章 | 调试工程师 | 现场 | 待确认 |
| 9 | 注射泵最大行程步数(影响VD_Dose_Steps边界) | 第8章 | PLC开发工程师 | — | 待确认(设计文档第十一章1) |
| 10 | Modbus通讯超时实际实现位置(FC4 Story 1.1) | 第3章 | PLC开发工程师 | Story 1.1完成 | 待确认 |

---

**文档版本**:v1.0
**编制日期**:2026-07-18
**配套文档版本**:PLC设计文档v9.3、HMI-PLC变量地址表v1.0、SAT_FAT验收测试用例v1.0、FC0/FC4/OB1/FC1 STL源码
**下次更新触发**:HMI选型确认(AQEX-24)、Story 1.1完成(FC4细化)、FAT/SAT执行后实测反馈、待确认事项闭环
