Yustnust/AQUA-EXPO/docs/commissioning/数据备份与恢复方案_v1.0.md

# 药液配置加注控制系统 — 数据备份与恢复方案 v1.0

**项目**: 药液配置与加注控制系统(AQUA-EXPO)
**适用范围**: 8套缸单元(每套1台S7-200 SMART CPU ST20 + EM DT16/DR16,PLC IP 192.168.2.101~108)+ 1台昆仑通态MCGS 12寸集中HMI(IP 192.168.2.10)
**用途**: 定义系统所有关键数据(PLC程序/参数/HMI组态/历史数据)的备份对象、备份介质、备份频率、恢复步骤与应急预案,作为运维工程师备份与恢复工作的执行依据
**配套文档**:
- 《HMI-PLC变量地址表 v1.0》(断电保持区定义、附录A)
- 《药液配置加注控制系统_PLC设计文档 v9.3》(系统组成、断电恢复逻辑)
- 《HMI数据量估算与存储时长测算 v1.0》(历史数据存储容量)
- 《设备维护手册 v1.0》(周期维护已含备份项,本方案与之衔接不重复操作细节)
- 《昆仑通态MCGS组态实施指南 v1.0》(.mcp工程、配方、报警、用户权限)
- 《PLC首次下装与上电调试Checklist v1.0》(系统块断电保持配置、首装流程)
**版本号规则说明**: 本项目《PLC程序版本管理规范》暂未单独发布,本方案暂定如下版本号规则:
- PLC程序版本号格式:`V主版本.次版本.修订号`(如 V1.0.0 首版、V1.0.1 修订、V1.1.0 功能新增);重大架构变更升主版本号
- 文档版本号格式:`v主版本.次版本`(如 v1.0、v1.1)
- 待《PLC程序版本管理规范》正式发布后,以其规则为准,本方案相应升版

**文档版本**: v1.0
**创建日期**: 2026-07-18

---

## 目录

1. [备份对象分类与重要性](#一备份对象分类与重要性)
2. [PLC程序备份](#二plc程序备份)
3. [PLC参数备份](#三plc参数备份)
4. [HMI组态备份](#四hmi组态备份)
5. [HMI历史数据备份](#五hmi历史数据备份)
6. [备份介质与存储](#六备份介质与存储)
7. [恢复操作SOP](#七恢复操作sop)
8. [备份计划与责任](#八备份计划与责任)
9. [应急预案](#九应急预案)

---

## 一、备份对象分类与重要性

按数据类型与失效影响分为4类。所有备份均按"3-2-1原则"(见第六章)保存。

### 1.1 备份对象总表

| 类别 | 对象 | 存储位置 | 重要性 | 丢失影响 | 备份频率 |
|---|---|---|---|---|---|
| ① PLC程序工程文件 | OB1/FC0~FC40全部STL源工程、系统块、数据块、注释、符号表 | STEP 7-Micro/WIN SMART工程文件(*.mwp),工控机硬盘 | 最高 | PLC程序损坏/丢失→对应单元完全停机;8台PLC程序相同,丢失源工程等于全系统失去维护能力 | 程序变更即备份+每月1次+半年全量 |
| ② PLC断电保持V区参数 | VD10~VD140设定值(浓度/时间/超时/泵速)、VW8实验轮次、VB300~VB303报警字、VW2状态机、VW6报警码、DT10时间戳、单元使能等(详见变量表附录A) | PLC内部EEPROM/超级电容保持区(典型7天/最小6天)、CPU ST20本体 | 高 | 参数丢失→实验数据失连续、状态机需复位、报警历史中断、需重新录入30余项设定值 | 每月1次+参数变更即备份+半年全量 |
| ③ HMI组态工程文件 | MCGS工程文件(*.mcp)、8连接S7驱动配置、728变量绑定、8画面、32位报警配置、3级用户权限、配方、单元使能、脚本 | HMI本体Flash + McgsPro组态PC硬盘 | 最高 | 组态损坏→8单元集中监控瘫痪,但PLC仍可独立运行;重新组态需1~3天 | 工程变更即备份+每月1次+半年全量 |
| ④ HMI历史数据 | 报警历史(8单元×256点)、7趋势曲线×8单元×1分钟采样、审计日志(L2/L3操作)、配方版本 | HMI本体Flash `\HardDisk\History\`(SQLite/二进制)+ U盘导出CSV | 中 | 历史趋势/报警追溯/合规审计能力丧失;PLC实时控制不受影响 | 每月U盘导出+每季度审计日志+每年全量 |

### 1.2 与《设备维护手册》衔接说明

《设备维护手册 v1.0》已含下列周期性备份动作:
- 每周维护: HMI审计日志U盘导出、历史数据/趋势曲线检查(维护手册§4.2)
- 每月维护: HMI历史数据U盘导出、PLC程序STEP 7上载保存、HMI工程导出.mcp、参数配置画面4导出(维护手册§5.4)
- 每半年维护: PLC程序全量上载、HMI工程全量导出、历史数据全量导出、参数配方导出、审计日志导出、异地存储(维护手册§7.3)

本方案是上述备份动作的**操作规范与扩展说明**,规定:
1. 每类备份的具体操作步骤、菜单路径、命名规范、字段格式
2. 备份介质的3-2-1存储策略与保留周期
3. 恢复操作的SOP与回滚方案
4. 应急预案与最小可运行配置

不在维护手册执行周期内重复列动作本身,只在本方案第八章"备份计划与责任"中给出与维护手册的对齐表。

---

## 二、PLC程序备份

8套PLC程序完全相同(变量地址表§1.1、PLC设计文档§12.7),区别仅在IP地址(192.168.2.101~108)。备份策略按"1份源工程+8份含IP差异的现场实例"管理。

### 2.1 STEP 7-Micro/WIN SMART 上传(从PLC读项目)

**用途**: 将运行中PLC的程序块/数据块/系统块读取到PC,生成可编辑工程文件。

**前置条件**:
- STEP 7-Micro/WIN SMART V2.0及以上已安装于调试PC
- PC与目标PLC同网段(192.168.2.x,x≠101~108),网线物理连通
- PLC处于RUN或STOP状态均可,推荐RUN状态上传以获取最新运行参数
- 已通知操作员此PLC即将进行上传操作(无需停机,但建议在停机时执行)

**操作步骤**:
1. 打开 STEP 7-Micro/WIN SMART
2. 菜单 `通信` → 弹出"通信"对话框 → `设置PG/PC接口` → 选择 `TCP/IP`(网卡) → `查找CPU`
3. 在搜索结果中双击目标PLC(显示IP 192.168.2.10X,对应单元号X)
4. 菜单 `PLC` → `上传` → 弹出"上传"对话框
5. 勾选上传内容:
   - ☑ 程序块(主程序/子程序/中断程序)
   - ☑ 数据块
   - ☑ 系统块(含IP/断电保持配置,关键!)
   - ☐ 菜单(可选,含HMI注释)
6. 点击 `上传`,等待进度条完成,显示"上传成功"
7. 在工程中 `文件` → `另存为` → 按本方案§2.3命名规范保存为 `.mwp` 文件
8. 关闭工程前 `PLC` → `信息` → 记录 PLC 程序校验和(Checksum)、固件版本、最后修改时间

**验证方法**:
- 打开保存的 .mwp,`PLC` → `编译`,应显示 `0 error, 0 warning`
- `视图` → `符号表` 检查符号(如 `VD_C_Set`、`M_Alarm_Overflow_A`)是否完整
- `视图` → `数据块` 检查 VD10~VD140 等默认值是否与变量表§6一致
- `视图` → `系统块` → `断电保持` 检查配置范围是否与变量表附录A一致

### 2.2 STEP 7-Micro/WIN SMART 下载(写项目到PLC)

**用途**: 将PC上的工程文件写入PLC,用于程序更新或恢复。

**前置条件**:
- 已完成维护手册§12.1安全确认:急停按下、220V动力回路断路器OFF、挂牌
- 仅24VDC控制回路可带电,220V必须断电
- 已备份当前PLC运行程序(按§2.1上传并存档),作为回滚依据
- 已记录当前PLC的IP地址(下载系统块会覆盖IP,需确保系统块中IP与目标PLC一致)

**操作步骤**:
1. 打开 STEP 7-Micro/WIN SMART,打开目标 .mwp 工程文件
2. `PLC` → `编译`,确认 `0 error, 0 warning`
3. `视图` → `系统块` → `通信接口` 确认 IP=192.168.2.10X 与目标PLC单元号一致
4. `视图` → `系统块` → `断电保持` 确认范围与变量表附录A一致(VB0~VB9/VB10~VB149/VB150~VB199/VB200~VB229/VB230~VB289/VB300~VB303/VB304/VB305~VB349/VB500~VB599,DT10)
5. 菜单 `PLC` → `下载` → 弹出"下载"对话框
6. 勾选下载内容:
   - ☑ 程序块
   - ☑ 数据块
   - ☑ 系统块
   - ☑ 强制值(如有强制表则勾选,通常不勾)
7. 点击 `下载`,PLC自动切换至STOP模式,等待下载完成
8. 下载完成后弹出"是否切换至RUN模式?" → 选 `是`
9. 验证 PLC RUN灯常绿、ERR灯灭
10. `PLC` → `信息` → 确认扫描周期 <10ms、无错误

**验证方法**:
- 按维护手册§5.1执行断电保持测试(断电30秒再上电,V304.0=1,数据保持)
- 按维护手册§3.1巡检项3.1确认 PLC RUN灯/EM指示灯/HMI通讯正常
- 按维护手册§5.3确认485通讯(查V303.4注射泵报警状态)正常

### 2.3 项目文件命名规范

| 文件类型 | 命名格式 | 示例 |
|---|---|---|
| PLC源工程(主) | `AQUA-EXPO_PLC_Main_V{X.Y.Z}_{YYYYMMDD}.mwp` | `AQUA-EXPO_PLC_Main_V1.0.0_20260718.mwp` |
| PLC单元实例(从PLC上传) | `AQUA-EXPO_PLC_U{NN}_V{X.Y.Z}_{YYYYMMDD}.mwp` | `AQUA-EXPO_PLC_U01_V1.0.0_20260718.mwp` |
| PLC单元实例(下载前快照) | `AQUA-EXPO_PLC_U{NN}_PreDownload_{YYYYMMDD}.mwp` | `AQUA-EXPO_PLC_U03_PreDownload_20260718.mwp` |
| 系统块备份 | `AQUA-EXPO_PLC_U{NN}_SysBlock_{YYYYMMDD}.mwp`(随主工程一并) | — |

**说明**:
- `NN` 为2位单元号(01~08)
- `X.Y.Z` 为程序版本号(见文首版本号规则说明)
- `YYYYMMDD` 为备份当日日期
- 8台PLC程序相同,故 `Main` 主工程文件1份即可代表8台;但 `U{NN}` 单元实例在每次实际下装/上传后均单独存档,以追溯每台PLC的实际下装历史(含IP/系统块差异)
- `.mwp` 为 STEP 7-Micro/WIN SMART 项目文件扩展名(项目方约定)

### 2.4 存储位置

| 层级 | 路径 | 说明 |
|---|---|---|
| 主存 | `D:\AQUA-EXPO_Backup\PLC\` | 调试PC工控机硬盘,日常备份主存 |
| 副本1 | `\\NAS\AQUA-EXPO\PLC\` | 实验室局域网NAS,自动同步 |
| 副本2(异地) | U盘 `AQUA-EXPO_Backup\PLC\` 每半年异地存档 | 3-2-1原则的异地副本 |

目录结构示例:
```
D:\AQUA-EXPO_Backup\PLC\
  ├─ Main\                       # 主源工程(8台共用)
  │   ├─ AQUA-EXPO_PLC_Main_V1.0.0_20260718.mwp
  │   └─ AQUA-EXPO_PLC_Main_V1.0.1_20260910.mwp
  ├─ U01\                        # 1号单元实例
  │   ├─ AQUA-EXPO_PLC_U01_V1.0.0_20260718.mwp
  │   └─ AQUA-EXPO_PLC_U01_PreDownload_20260910.mwp
  ├─ U02\ ... U08\
  └─ _Archive\                   # 年度归档
      └─ 2026\AQUA-EXPO_PLC_All_20261231.zip
```

### 2.5 8台PLC版本一致性核对方法

由于8套PLC程序完全相同,需定期核对8台PLC当前运行的程序版本是否一致,防止"局部更新导致版本漂移"。

**核对方法(每半年1次,与维护手册§7.3全量备份同步执行)**:

1. 对8台PLC逐台执行§2.1上传,生成8份 .mwp
2. 在 STEP 7-Micro/WIN SMART 中,`PLC` → `信息` → 记录每台的:
   - 程序校验和(Checksum,16进制,如 `0x1A2B`)
   - 程序块大小(字节)
   - 数据块大小
   - 固件版本
   - 系统块版本
3. 将8台记录填入下表,核对全部字段一致:

| 单元号 | IP地址 | 程序校验和 | 程序块大小 | 数据块大小 | 固件版本 | 系统块IP | 一致性 |
|---|---|---|---|---|---|---|---|
| U01 | 192.168.2.101 | 0x____ | ___B | ___B | V__ | 192.168.2.101 | □一致 |
| U02 | 192.168.2.102 | 0x____ | ___B | ___B | V__ | 192.168.2.102 | □一致 |
| ... | ... | ... | ... | ... | ... | ... | ... |
| U08 | 192.168.2.108 | 0x____ | ___B | ___B | V__ | 192.168.2.108 | □一致 |

**判定标准**:
- 8台程序校验和必须一致 → 程序逻辑完全相同
- 程序块大小、数据块大小必须一致 → 防止"只下了部分块"
- 固件版本一致 → 防止跨版本行为差异
- 系统块IP各自不同 → 这是预期差异(每台IP不同),不视为不一致

**不一致处理**:
- 若某台校验和与其余7台不同 → 用主源工程按§2.2重新下装该台(注意系统块IP保持原值)
- 若多台不一致且无主源工程 → 警报升级,启动第七章§7.5整机灾难恢复流程

---

## 三、PLC参数备份

PLC断电保持V区参数是实验运行的核心数据,丢失将导致实验数据失连续、需重新录入30余项设定值。CPU ST20超级电容保持典型7天/最小6天,长期断电(>7天)将丢失V区数据(变量表§10)。本节定义参数的备份方法、字段格式与恢复步骤。

### 3.1 备份对象(参数范围)

按变量表附录A断电保持区配置,本方案需备份以下V区段:

| 地址段 | 内容 | 字段数 | 类型 |
|---|---|---|---|
| VB0~VB9 | 系统命令位/状态位/状态机VW2/泵状态VW4/报警码VW6/轮次VW8 | 10字节 | BOOL/INT混合 |
| VB10~VB149 | HMI设定参数VD10~VD66 + 实测值VD70~VD102 + 纠偏VD104~VD140 | 140字节 | REAL为主 |
| VB150~VB199 | 纠偏中间变量VD150~VD190 + 断电恢复中间量VD194/VW198 | 50字节 | REAL/INT混合 |
| VB200~VB229 | Modbus寄存器映射缓冲VW200~VW228 | 30字节 | INT/WORD |
| VB230~VB289 | 阀门诊断子状态/PT转换值VW230~VW289 | 60字节 | INT/WORD |
| VB300~VB303 | 报警字VB300~VB303(32位按位编码) | 4字节 | DWORD |
| VB304 | M_InitDone初始化完成标志(V304.0) | 1字节 | BOOL |
| VB305~VB349 | 阀门诊断数据VD308~VD344 | 45字节 | REAL/DWORD |
| VB500~VB599 | 报警日志缓冲区(FC3 NETWORK6) | 100字节 | 结构化 |
| DT10 | DT_TankB_FullTime下缸满时间戳 | 8字节 | DT |

**重点保护参数**(必备份,丢失影响最大):
- VD10~VD66 设定值(浓度/时间周期/超时保护)→ 实验配方参数
- VD132~VD140 注射泵速度参数 → 与泵硬件相关,需重新核实
- VW8 实验轮次计数 → 实验进度
- VB300~VB303 报警字 → 当前未确认报警状态
- VW2 状态机 → 当前流程状态
- DT10 下缸满时间戳 → 换水周期计算基准

### 3.2 备份方法A:HMI配方导出(推荐,操作员可执行)

**前提**: MCGS组态已实现配方管理功能(见MCGS组态实施指南§5.1报警配置之外,需组态时增加配方画面与导出按钮)。

**操作步骤**:
1. 在HMI主菜单切换至 `画面4 参数设置页`
2. 顶部选择目标单元(1~8号)
3. 点击画面右下角 `导出配方` 按钮(组态时实现,需L2维护权限)
4. 在弹出对话框选择 U盘路径 `\UDisk\Recipe\`
5. 输入文件名(自动生成 `AQUA-EXPO_Recipe_U{NN}_{YYYYMMDD}.csv`)→ 确认
6. U盘弹出提示后,拔出U盘插入PC核验CSV内容

**CSV字段格式**:
```csv
单元号,地址,符号,类型,值,单位,默认值,备注
1,VD10,VD_C_Set,REAL,5.0,%,5.0,目标浓度设定值
1,VD14,VD_C_Stock,REAL,100.0,%,100.0,母液浓度
1,VD18,VD_StepResolution,REAL,0.2083,µL/步,0.2083,注射泵单步分辨率
1,VD20,VD_CycleSetpoint,REAL,30.0,min,30.0,换水周期设定值
1,VD24,VD_ExperimentTarget,REAL,480.0,min,480.0,实验时长目标设定值
1,VD28,VD_PreMixTime,REAL,120.0,s,120.0,潜水泵预循环标称时长
... (按变量表§6完整列出)
1,VW8,实验轮次计数,INT,12,次,—,当前实验轮次
1,VB300,报警字1,HEX,0x00,位,—,V300.0~V300.7
1,VB301,报警字2,HEX,0x00,位,—,V301.0~V301.7
1,VB302,报警字3,HEX,0x00,位,—,V302.0~V302.7
1,VB303,报警字4,HEX,0x00,位,—,V303.0~V303.7
1,VW2,状态机当前状态,INT,5,—,—,0/1~8/99
1,DT10,DT_TankB_FullTime,DT,2026-07-18 14:30:00,—,—,下缸满时刻
```

### 3.3 备份方法B:Modbus读取V区导出CSV(自动化,可定时)

**前提**: PLC侧已配置 Modbus TCP Server(若选用 Modbus TCP方案,见MCGS组态实施指南附录B:OB1调用MBUS_SERVER,HoldStart=VB0,MaxHold=200映射VB0~VB399,端口502)。若项目选用S7协议,本方法不适用,改用方法A或C。

**操作步骤**:
1. 在工控机PC上使用 Modbus Poll 工具(Modbus调试通用工具),或编写Python脚本(基于 `pymodbus` 库)
2. 连接目标PLC:IP=192.168.2.10X,端口=502,单元号=1
3. 读取保持寄存器40001~400200(对应VB0~VB399,共200字=400字节)
4. 导出为CSV,按地址段切分(便于人工核对)

**Python脚本示例(仅供参考,实际部署需调试)**:
```python
from pymodbus.client import ModbusTcpClient
import csv, datetime

UNIT_IPS = [f"192.168.2.{i}" for i in range(101, 109)]
PORT = 502
START_REG = 1   # 40001
NUM_REGS = 200  # VB0~VB399
VARIABLE_MAP = {
    # (寄存器偏移, 长度字, 符号, 类型, 单位)
    (1, 1, "VW2_状态机", "INT", "—"),
    (3, 1, "VW4_泵状态码", "INT", "—"),
    (4, 1, "VW6_报警码", "INT", "—"),
    (5, 1, "VW8_实验轮次", "INT", "次"),
    (6, 2, "VD10_目标浓度设定", "REAL", "%"),
    (8, 2, "VD14_母液浓度", "REAL", "%"),
    # ... 完整映射按变量表填写
    (151, 2, "VB300_报警字1", "DWORD", "位"),
    (152, 2, "VB302_报警字3", "DWORD", "位"),
}

for idx, ip in enumerate(UNIT_IPS, 1):
    client = ModbusTcpClient(ip, port=PORT)
    if not client.connect():
        print(f"U{idx:02d} ({ip}) 连接失败")
        continue
    rr = client.read_holding_registers(START_REG, NUM_REGS, slave=1)
    if rr.isError():
        print(f"U{idx:02d} 读取失败: {rr}")
        client.close()
        continue
    regs = rr.registers
    today = datetime.date.today().isoformat().replace("-", "")
    fname = f"AQUA-EXPO_PLC_U{idx:02d}_Param_{today}.csv"
    with open(fname, "w", newline="", encoding="utf-8-sig") as f:
        w = csv.writer(f)
        w.writerow(["单元号","Modbus寄存器","V区地址","符号","类型","值(原始)","值(解析)","单位"])
        for offset, length, symbol, dtype, unit in VARIABLE_MAP.items():
            reg_vals = regs[offset:offset+length]
            raw = " ".join(f"0x{v:04X}" for v in reg_vals)
            # REAL解析(32位浮点): 高字在前
            if dtype == "REAL" and length == 2:
                import struct
                val = struct.unpack(">f", struct.pack(">HH", reg_vals[0], reg_vals[1]))[0]
                parsed = f"{val:.4f}"
            elif dtype == "INT":
                val = reg_vals[0] if reg_vals[0] < 0x8000 else reg_vals[0] - 0x10000
                parsed = str(val)
            else:
                parsed = raw
            w.writerow([f"U{idx:02d}", f"4{START_REG+offset:05d}", 
                       f"V{offset*2}~", symbol, dtype, raw, parsed, unit])
    client.close()
    print(f"U{idx:02d} 备份完成: {fname}")
```

**注意**:
- Modbus 保持寄存器按字(WORD)对齐,VD双字需读2个连续寄存器,REAL解析需按大端序(高字在前)
- DT10 时间戳不在 Modbus 保持寄存器映射范围(V区不含DT),需通过STEP 7方法C单独备份
- 实际部署前需在测试环境验证寄存器映射地址正确性

### 3.4 备份方法C:STEP 7-Micro/WIN SMART 状态表导出(精确,人工执行)

**用途**: 在 STEP 7 调试PC上,通过状态表(状态图)在线读取并导出V区参数,适用于离线备份或方法A不可用时。

**操作步骤**:
1. STEP 7-Micro/WIN SMART 连接目标PLC(§2.1步骤1~3)
2. `视图` → `状态表` → 打开"状态表"窗口
3. 在状态表中按变量表§6/§7/§8 逐行录入需监控的变量:

| 地址 | 格式 | 当前值 | 新值 |
|---|---|---|---|
| VD10 | 浮点 | ___ | |
| VD14 | 浮点 | ___ | |
| VD18 | 浮点 | ___ | |
| VD20 | 浮点 | ___ | |
| VD24 | 浮点 | ___ | |
| VD28 | 浮点 | ___ | |
| ... (按变量表完整列出) | | | |
| VW8 | 有符号 | ___ | |
| VW2 | 有符号 | ___ | |
| VW6 | 有符号 | ___ | |
| VB300 | 十六进制 | ___ | |
| VB301 | 十六进制 | ___ | |
| VB302 | 十六进制 | ___ | |
| VB303 | 十六进制 | ___ | |

4. `调试` → `读取全部` → "当前值"列填充实际值
5. `文件` → `导出` → 选择CSV格式 → 保存为 `AQUA-EXPO_PLC_U{NN}_StateTable_{YYYYMMDD}.csv`
6. 重复以上步骤备份DT10:`PLC` → `信息` → 记录 `RTC当前时间` 与 `DT10`值(若STEP7支持DT显示)

**状态表导出CSV字段格式**:
```csv
地址,格式,当前值,新值,注释
VD10,浮点,5.0,,目标浓度设定值
VD14,浮点,100.0,,母液浓度
VW8,有符号,12,,实验轮次计数
VB300,十六进制,0x00,,报警字1
```

### 3.5 参数恢复(下装)步骤

**前置条件**:
- 已确认待恢复PLC的IP与目标单元号对应
- 已备份当前PLC参数(防止恢复失败回滚,按§3.2/3.3/3.4任一方法备份当前值)
- 已通知操作员此PLC即将进行参数恢复操作
- PLC处于STOP或S0初始化态(避免运行中改参数引发状态机异常)

**操作步骤(以STEP 7状态表写入为例)**:
1. STEP 7 连接目标PLC
2. `视图` → `状态表` → 打开备份的CSV文件(或将CSV内容粘贴至状态表)
3. 在"新值"列填入待恢复的参数值(从备份CSV复制)
4. `调试` → `写入全部` → PLC将"新值"写入V区
5. `调试` → `读取全部` → 验证"当前值"列已更新为新值
6. **关键参数人工复核**:VD10(目标浓度)/VD14(母液浓度)/VD18(步分辨率)/VD132~140(泵速) → 与实验配方核对一致
7. **报警字复核**:VB300~VB303应为0(无未确认报警)或与备份一致;若有未确认报警,确认报警根本原因已消除后再清除
8. **状态机复核**:VW2若需恢复至运行态,按§3.6回滚说明评估风险(通常恢复至S0后由操作员重新启动实验)

### 3.6 回滚方案

| 回滚场景 | 触发条件 | 操作 |
|---|---|---|
| 参数写入失败 | STEP7提示写入错误 | 检查PLC连接/STOP状态;重试;若仍失败,断电重启PLC后重试 |
| 参数写入后状态机异常 | VW2=99(S_ERROR)且报警码非预期 | 立即用"恢复前快照"按§3.5步骤还原原参数;若仍异常,按§7.2整机程序恢复 |
| 实验中断需继续 | VW8轮次与断电前一致,DT10有效 | 状态机恢复至断电前态(VW2=断电前值);按PLC设计文档§10断电恢复逻辑验证 |
| 实验需重新开始 | 参数恢复后无法继续原实验 | VW2强制写0(S0),VW8清零,DT10清零;按SOP重新启动实验 |
| 参数恢复后PLC死机 | ERR灯亮,无法通讯 | 断电重启PLC;若仍死机,按§7.1 PLC程序损坏恢复流程 |

**回滚验证清单**:
- [ ] 当前参数与恢复前快照逐项对比(允许DT10/VD96实测值差异)
- [ ] 状态机VW2回到预期态
- [ ] 报警字VB300~VB303符合预期(无新增报警)
- [ ] HMI画面1~7显示与PLC实际状态一致
- [ ] 注射泵/流量计485通讯正常(V303.4=0,VW4合理)

---

## 四、HMI组态备份

HMI组态工程是8单元集中监控的核心,损坏将导致监控瘫痪(但PLC仍可独立运行)。组态文件含:工程主文件、配方、报警配置、用户权限、脚本、8连接S7驱动配置。

### 4.1 MCGS工程文件备份(.mcp)

**前提**: 已安装 McgsPro 组态软件(昆仑通态官方,免费,见组态实施指南§1.1)。

**操作步骤**:
1. 在HMI本体或组态PC上打开McgsPro
2. `文件` → `打开工程` → 选择当前运行的工程(默认名 `AQUA-EXPO_HMI`,见组态实施指南§1.2)
3. `文件` → `工程另存为` → 选择U盘路径 `\UDisk\MCGS\`
4. 文件名按§4.4命名规范保存为 `.mcp`
5. 同时执行 `文件` → `导出` → 选择"全部"(含画面/变量/脚本/用户/配方)→ 导出为独立包 `.pkg`(若McgsPro支持)
6. 验证:在另一台PC上用McgsPro打开备份的 .mcp,确认8画面/728变量/32报警/3级权限完整

**备份内容核对清单**:
- [ ] 8画面(总览/详情/报警/参数/系统/手动/趋势/通讯)完整
- [ ] 8连接S7驱动配置(IP 192.168.2.101~108、机架0、槽1)
- [ ] 728变量绑定(91变量×8单元)完整
- [ ] 32位报警配置(8组×32位)文本/级别/处置建议
- [ ] 3级用户权限(操作员L1/维护L2/管理员L3)
- [ ] 配方(10组)与单元使能标志
- [ ] 趋势曲线7条×8单元配置(采样间隔60秒)
- [ ] RTC同步脚本、动态显隐脚本、超时注销脚本
- [ ] U盘导出脚本、定时自动导出配置

### 4.2 配方文件备份

**操作步骤**:
1. McgsPro `工具` → `配方管理` → 打开配方编辑器
2. 选中所有配方组(浓度组/时间组/超时组/泵速组等)
3. 右键 → `导出` → 选择CSV格式 → 保存至U盘 `\UDisk\Recipe\`
4. 文件名:`AQUA-EXPO_HMI_Recipe_V{X.Y}_{YYYYMMDD}.csv`

**配方CSV字段格式**(与§3.2一致,便于与PLC参数备份交叉校验):
```csv
配方组,配方版本,地址,符号,值,单位,默认值
浓度组,V1,VD10,VD_C_Set,5.0,%,5.0
浓度组,V1,VD14,VD_C_Stock,100.0,%,100.0
浓度组,V1,VD18,VD_StepResolution,0.2083,µL/步,0.2083
时间组,V1,VD20,VD_CycleSetpoint,30.0,min,30.0
... (按变量表§6完整列出)
```

### 4.3 报警配置与用户权限备份

**报警配置备份**:
1. McgsPro `工具` → `报警配置` → 打开报警编辑器
2. `文件` → `导出` → 保存报警配置为 `AQUA-EXPO_HMI_Alarm_V{X.Y}_{YYYYMMDD}.xml`或 `.csv`(取决于McgsPro支持格式)
3. 内容含:32位报警×8单元的报警文本/级别(最高级/漫溢级/节奏级/一般级)/颜色/声音/确认方式/处置建议

**用户权限配置备份**:
1. McgsPro `工具` → `用户管理` → 打开用户编辑器
2. `文件` → `导出` → 保存用户列表为 `AQUA-EXPO_HMI_Users_V{X.Y}_{YYYYMMDD}.csv`
3. 内容含:用户名/用户组(L1/L2/L3)/密码哈希(McgsPro导出时脱敏)/可操作画面/可操作控件权限等级

**用户权限CSV字段格式**:
```csv
用户名,用户组,可见画面,可操作控件等级,备注
operator1,操作员L1,1/2/5/6/8,1,日常操作员
maintenance1,维护L2,全部,2,维护工程师
admin,管理员L3,全部,3,系统管理员
```

**注**:
- 密码本身不导出明文,只导出用户名与权限;恢复时需重新设置密码(详见§7.3)
- 每季度密码更换(维护手册§6.3)后需重新备份用户权限

### 4.4 HMI组态命名规范

| 文件类型 | 命名格式 | 示例 |
|---|---|---|
| MCGS工程主文件 | `AQUA-EXPO_HMI_V{X.Y}_{YYYYMMDD}.mcp` | `AQUA-EXPO_HMI_v1.0_20260718.mcp` |
| MCGS工程包(全部导出) | `AQUA-EXPO_HMI_Pkg_V{X.Y}_{YYYYMMDD}.pkg` | `AQUA-EXPO_HMI_Pkg_v1.0_20260718.pkg` |
| 配方 | `AQUA-EXPO_HMI_Recipe_V{X.Y}_{YYYYMMDD}.csv` | `AQUA-EXPO_HMI_Recipe_v1.0_20260718.csv` |
| 报警配置 | `AQUA-EXPO_HMI_Alarm_V{X.Y}_{YYYYMMDD}.xml` | `AQUA-EXPO_HMI_Alarm_v1.0_20260718.xml` |
| 用户权限 | `AQUA-EXPO_HMI_Users_V{X.Y}_{YYYYMMDD}.csv` | `AQUA-EXPO_HMI_Users_v1.0_20260718.csv` |
| HMI下载前快照 | `AQUA-EXPO_HMI_PreDownload_{YYYYMMDD}.mcp` | `AQUA-EXPO_HMI_PreDownload_20260718.mcp` |

### 4.5 存储位置

| 层级 | 路径 | 说明 |
|---|---|---|
| 主存 | `D:\AQUA-EXPO_Backup\HMI\` | 组态PC硬盘 |
| 副本1 | `\\NAS\AQUA-EXPO\HMI\` | 实验室NAS |
| 副本2(异地) | U盘 `AQUA-EXPO_Backup\HMI\` 每半年异地存档 | 异地副本 |

目录结构示例:
```
D:\AQUA-EXPO_Backup\HMI\
  ├─ Project\                    # .mcp工程文件
  │   ├─ AQUA-EXPO_HMI_v1.0_20260718.mcp
  │   └─ AQUA-EXPO_HMI_PreDownload_20260718.mcp
  ├─ Recipe\                     # 配方
  ├─ Alarm\                      # 报警配置
  ├─ Users\                      # 用户权限
  └─ _Archive\                   # 年度归档
```

---

## 五、HMI历史数据备份

历史数据含报警历史、趋势曲线、审计日志、配方版本。HMI数据量测算(HMI数据量估算与存储时长测算v1.0):241MB/年,4GB Flash可存8.3年,8GB可存33年。即便容量充足,仍需定期导出至外部介质,防止HMI硬件损坏导致历史数据全失。

### 5.1 导出格式与内容

| 数据类型 | 导出格式 | 单条字段 | 单元日数据量 | 8单元年数据量 |
|---|---|---|---|---|
| 报警历史 | CSV(SQLite底层,导出为CSV) | 时间戳(8B)+单元号(1B)+报警码(2B)+描述(30B)+状态(1B)+操作员(8B)=50B | 8KB | 2.9MB |
| 趋势曲线(1分钟采样) | CSV / SQLite二进制 | 时间戳(4B)+数值(4B)=8B | 650KB | 237MB |
| 审计日志 | CSV | 时间戳(8B)+用户(8B)+权限(1B)+单元(1B)+操作类型(2B)+内容(50B)+结果(1B)=70B | 3.5KB | 1.25MB |
| 配方版本 | CSV(静态) | 参数表 | — | 16KB(10组配方) |

### 5.2 导出频率与归档策略

**与HMI组态实施指南§10.2定时自动导出配置一致**:

| 周期 | 操作 | 范围 | 介质 | 责任人 |
|---|---|---|---|---|
| 每月 | 自动定时导出(每月1日00:00) | 上月全部数据(报警/趋势/审计) | HMI本体 `\UDisk\Auto\`(需插入U盘) | 操作员检查 |
| 每月 | 人工U盘导出(备自动导出失败) | 上月全部数据 | U盘 `\UDisk\Export\` | 操作员(维护手册§5.4) |
| 每季度 | 审计日志专项导出(合规) | 当季度L2/L3操作记录 | U盘 → NAS归档 | 维护工程师(维护手册§6.3) |
| 每年 | U盘全量备份 | 含工程文件+历史数据全量 | U盘 → NAS → 异地 | 维护工程师(维护手册§7.3) |
| 重大变更前 | 工程文件+当前参数快照 | 参数/逻辑修改前导出 | U盘+NAS | 变更执行人 |

**月度归档策略**:
- 每月初将上月 `\UDisk\Auto\` 数据移动至 NAS `\\NAS\AQUA-EXPO\HMI_History\Monthly\{YYYYMM}\`
- 按月命名:`AQUA-EXPO_HMI_Hist_{YYYYMM}.csv`(或按数据类型拆分为 `Alarm_`/`Trend_`/`Audit_` 前缀)
- 月度数据保留期:与HMI本体循环覆盖策略配合,导出后HMI本体可循环覆盖

**年度归档策略**:
- 每年1月初归档上一年全量数据至 NAS `\\NAS\AQUA-EXPO\HMI_History\Yearly\{YYYY}\`
- 打包为 `AQUA-EXPO_HMI_Hist_{YYYY}.zip`(含Alarm/Trend/Audit/Recipe子目录)
- 年度数据保留期:永久(NAS容量充足,241MB/年×10年仅2.4GB)

### 5.3 存储容量规划

依据HMI数据量估算文档§3.3:

| 配置 | HMI本体存储时长 | 备注 |
|---|---|---|
| 4GB Flash(2GB历史区) | 8.3年 | 推荐配置(经济型TPC1211-T12CE) |
| 8GB Flash | 33年 | 高配型(TPC1262Hi),预留余量 |
| 10秒采样(若需高频) | 1.4年(4GB)/5.7年(8GB) | 仅在调试期短期启用 |

**容量阈值告警**:
- HMI本体存储占用 ≥80% 时,在HMI通讯维护页(画面8)显示告警提示
- 占用 ≥90% 时,操作员立即按§5.2执行月度导出并清空HMI本体旧数据(若McgsPro支持手动清空;不支持则等循环覆盖自动处理)

**U盘容量规划**:
- 单次月度导出量约 0.66MB(8单元×30天)→ U盘16GB足够存放20年以上月度数据
- 年度全量备份含工程文件约 50MB + 历史数据 241MB → U盘16GB足够

### 5.4 历史数据完整性验证

每次导出后需验证CSV完整性:

| 验证项 | 方法 | 标准 |
|---|---|---|
| 文件可读 | 用Excel/文本编辑器打开CSV | 无乱码、无截断 |
| 记录条数 | 统计行数 | 与HMI画面7趋势曲线显示的采样点数一致 |
| 时间范围 | 检查首尾时间戳 | 覆盖预期月份(如7月数据应为7-01 00:00 ~ 7-31 23:59) |
| 单元完整性 | 8个单元均有数据 | 1~8号单元记录数大致均衡(运行单元数应等于使能单元数) |
| 关键报警 | 检查报警历史 | 当月发生的最高级/漫溢级报警均有记录 |

---

## 六、备份介质与存储

### 6.1 推荐备份介质

| 介质类型 | 用途 | 容量要求 | 说明 |
|---|---|---|---|
| 工控机硬盘 | PLC/HMI主存储 | ≥100GB(可用) | 调试PC兼作备份主机,日常备份主存 |
| U盘 | 现场导出与异地副本 | 16GB×2(维护手册§10.3) | 操作员日常导出;1用1备,防丢 |
| 实验室NAS | 网络副本 | ≥1TB | 自动同步+月度归档;支持RAID1 |
| (可选)外置硬盘 | 年度异地归档 | 500GB | 每年异地存档1次,存放于机房或档案室 |

**介质管理要求**:
- U盘专盘专用,贴标签 `AQUA-EXPO_Backup_001/002`
- U盘定期杀毒,使用前先扫描(防止PLC/HMI USB口感染)
- NAS开启RAID1冗余+定期快照,防止勒索病毒/误删
- 异地副本与现场物理距离≥500米(或不同建筑物),防止火灾/水浸

### 6.2 3-2-1备份原则

| 原则 | 本方案落地 |
|---|---|
| **3** 份数据副本 | ①工控机硬盘主存 ②NAS网络副本 ③U盘/异地副本 |
| **2** 种不同介质 | 工控机硬盘/NAS(在线介质)+ U盘/外置硬盘(离线介质) |
| **1** 份异地 | 每半年异地存档1份(外置硬盘或异地NAS) |

**实施细节**:
- 工控机硬盘 → NAS:由工控机定时同步脚本(Windows任务计划,每周日凌晨02:00执行 `robocopy`)
- NAS → 异地:每半年(7月初、1月初)由维护工程师手动拷贝至外置硬盘,送至异地档案室存放
- 离线U盘:每月导出后,U盘留在现场机柜内(防丢上锁),旧U盘每半年替换为新盘

### 6.3 备份命名与目录结构

**总目录结构**:
```
D:\AQUA-EXPO_Backup\                  # 工控机主存
  ├─ PLC\                              # PLC程序与参数
  │   ├─ Main\                         # 主源工程(8台共用)
  │   ├─ U01\ ... U08\                 # 8台单元实例
  │   ├─ Param\                        # 参数备份CSV
  │   │   ├─ AQUA-EXPO_PLC_U01_Param_20260718.csv
  │   │   └─ ...
  │   └─ _Archive\                     # 年度归档
  ├─ HMI\                              # HMI组态
  │   ├─ Project\ Recipe\ Alarm\ Users\
  │   └─ _Archive\
  ├─ HMI_History\                      # HMI历史数据
  │   ├─ Monthly\202607\202608\
  │   └─ Yearly\2026\
  ├─ _Log\                             # 备份执行日志
  │   └─ BackupLog_{YYYYMMDD}.txt
  └─ _RestoreTest\                     # 恢复演练记录(每年一次)
      └─ RestoreTest_{YYYYMMDD}.md
```

**NAS镜像目录结构**(`\\NAS\AQUA-EXPO\`)与工控机主存完全一致,由 `robocopy` 镜像同步。

### 6.4 保留周期

| 备份类型 | 频率 | 保留周期 | 说明 |
|---|---|---|---|
| 日备 | 每日(仅HMI审计日志,若启用) | 7天 | 滚动覆盖 |
| 周备 | 每周(审计日志+HMI历史检查) | 4周 | 滚动覆盖 |
| 月备 | 每月(PLC程序+参数+HMI工程+历史数据) | 12月 | 滚动覆盖,过期移至归档 |
| 半年备 | 每半年(全量备份+异地存档) | 2年(4个周期) | 含异地副本 |
| 年备 | 每年(全量+归档) | 永久 | NAS容量充足,不删除 |

**过期处理**:
- 月备超过12月 → 移至 `_Archive\` 子目录,保留至年度归档生成后删除
- 半年备超过2年 → 仅保留年度归档版,删除半年备
- 年备永久保留,不删除

---

## 七、恢复操作SOP

### 7.1 场景A:PLC程序损坏恢复(单台)

**故障现象**: PLC ERR灯亮、无法通讯、程序丢失、固件损坏等。

**前置条件**:
- 备份文件可用:主源工程 `AQUA-EXPO_PLC_Main_V{X.Y.Z}_{YYYYMMDD}.mwp`
- 备份文件可用:目标单元实例 `AQUA-EXPO_PLC_U{NN}_V{X.Y.Z}_{YYYYMMDD}.mwp`(含正确IP)
- 已确认硬件无物理损坏(电源/网线/扩展模块正常)
- 维护手册§12.1安全规程已执行(急停按下、220V断电、挂牌)

**操作步骤**:
1. STEP 7-Micro/WIN SMART 连接目标PLC(§2.1步骤1~3)
2. `PLC` → `信息` → 读取故障代码(若可通讯);若完全不可通讯,跳至步骤5
3. `PLC` → `清除` → 选择"程序块+数据块+系统块"→ 清空PLC(慎用,此操作不可逆)
4. 若不可通讯:断电重启PLC,长按RUN/STOP按钮进入STOP模式,再尝试通讯
5. 打开单元实例 .mwp 文件(§2.3命名规范),含正确的IP 192.168.2.10X
6. 按§2.2执行下载(系统块+程序块+数据块)
7. 下载完成后,`PLC` → `切换至RUN` → RUN灯常绿、ERR灯灭
8. 按§3.5恢复参数(从最近一次参数备份CSV恢复)
9. `PLC` → `设置RTC` → 同步PC当前时间(若RTC丢失)
10. 验证(见下)

**验证方法**:
- STEP 7 `PLC` → `信息`:扫描周期<10ms、无错误、程序校验和与备份记录一致
- 按维护手册§5.1执行断电保持测试:断电30秒再上电,V304.0=1,数据保持
- 按维护手册§5.3执行Modbus通讯测试:注射泵VW4、流量计VD86通讯正常
- HMI画面1总览页:该单元卡片恢复"在线"彩色显示

**回滚方案**:
- 若下载后PLC仍ERR:断电→检查扩展模块总线连接器→重新下装→仍ERR则怀疑硬件故障,联系PLC技术支持
- 若参数恢复后状态机异常:按§3.6回滚至S0,重新启动实验
- 若通讯仍异常:检查网线/IP/防火墙,排除网络问题

### 7.2 场景B:PLC参数丢失恢复(单台)

**故障现象**: 长期断电(>7天超级电容保持期)后PLC上电,V区参数恢复为默认值,实验数据失连续。

**前置条件**:
- 备份文件可用:最近一次参数备份CSV(按§3.2/3.3/3.4任一方法)
- PLC程序本体完好(RUN灯常绿、ERR灯灭)
- 已确认报警根本原因(如断电原因已排除)

**操作步骤**:
1. STEP 7 连接目标PLC
2. `视图` → `状态表` → 读取当前V区值,确认丢失(对比备份CSV)
3. 按§3.5执行参数恢复(从备份CSV填入新值→写入全部)
4. 关键参数人工复核(§3.5步骤6):VD10/VD14/VD18/VD132~140
5. **报警字处理**:VB300~VB303若为0则无未确认报警;若非0,逐位检查:
   - V300.5(继电器故障):最高级,需人工现场检修安全继电器后才能清除
   - V300.4(急停锁存):需现场系统复位按钮I0.3清除
   - V303.5(RTC丢失):若PLC RTC时间早于DT10,触发此报警,需先校时再清除
6. **状态机处理**:
   - 若实验未启动或需重新开始:VW2强制写0(S0),VW8清零,DT10清零,按SOP重启实验
   - 若实验进行中且DT10有效:VW2恢复至断电前态(从备份),按PLC设计文档§10断电恢复逻辑验证(下缸=满期间累加VD96)
7. `PLC` → `设置RTC` → 同步PC当前时间(若RTC异常)
8. 验证(见下)

**验证方法**:
- STEP 7 状态表:VD10~VD66设定值与备份CSV逐项一致
- HMI画面4参数设置页:显示值与设定值一致
- HMI画面1总览页:VW2状态机显示正确、VW6报警码=0(或预期值)、VW8轮次正确
- HMI画面6趋势曲线页:VD96实验时长累加值连续(若实验继续)

**回滚方案**:
- 按§3.6回滚方案执行
- 若实验数据无法连续:接受实验中断,VW2写0重新开始,记录为"参数丢失致实验中断"事件

### 7.3 场景C:HMI组态损坏恢复

**故障现象**: HMI黑屏/卡死/组态丢失/无法启动/触摸失效等。注意:HMI故障不影响PLC实时控制(PLC设计文档§12.5)。

**前置条件**:
- 备份文件可用:`AQUA-EXPO_HMI_V{X.Y}_{YYYYMMDD}.mcp` 及配方/报警/用户配置备份
- HMI硬件无物理损坏(电源/屏幕正常)
- McgsPro组态PC可用

**操作步骤**:
1. 在组态PC上打开McgsPro,打开备份的 .mcp 工程文件
2. `工程` → `检查` → 编译验证无错误(若有错误,按组态实施指南§11 checklist排查)
3. 组态PC通过USB或网线连接HMI本体(McgsPro下载方式取决于HMI型号)
4. `工具` → `下载` → 选择"全部"(工程/配方/报警/用户/脚本)
5. 等待下载完成(728变量+8画面+32报警+脚本,预计10~30分钟)
6. HMI本体重启,验证启动正常
7. 恢复用户密码:每个用户名重新设置密码(因导出CSV不含明文密码)
8. 恢复单元使能标志:在画面8系统设置页,勾选当前已接入的单元(首期1号=TRUE,2~8号=FALSE)
9. 恢复RTC:HMI开机时间 → 同步至8台PLC(组态实施指南§9脚本)
10. 验证(见下)

**验证方法**:
- HMI启动正常,无报错弹窗
- 画面1总览页:8单元卡片显示正常(已使能+在线→彩色;未使能→灰色)
- 画面4参数设置页:VD10~VD66显示值与PLC实际一致(需PLC未丢失参数)
- 画面5报警日志页:当前报警VW6显示正确
- 画面7趋势曲线页:7条曲线显示正常
- L1/L2/L3三级用户登录测试通过

**回滚方案**:
- 若新工程下载后HMI异常:重新下载"恢复前快照" `AQUA-EXPO_HMI_PreDownload_{YYYYMMDD}.mcp`
- 若HMI本体硬件故障(屏幕破裂/主板损坏):按维护手册§9.5返修或更换备件,组态重新下装
- HMI恢复期间,PLC按本地逻辑继续运行(PLC设计文档§12.5),急停/系统复位/消音按钮物理操作不受影响

### 7.4 场景D:HMI历史数据恢复

**故障现象**: HMI本体历史数据丢失(硬盘损坏/循环覆盖误删/McgsPro异常),需从备份恢复查询能力。

**前置条件**:
- 备份文件可用:NAS或U盘上的月度/年度历史数据CSV
- HMI本体已恢复运行(场景C已完成)
- 历史数据为查询/追溯用途,不直接影响实时控制

**操作步骤**:
1. 在工控机PC或HMI本体上,从NAS/U盘拷贝目标月份CSV至本地查询目录
2. 用Excel或SQLite工具打开CSV(若McgsPro支持导入历史数据,可通过组态实施指南§10脚本反向导入)
3. 按需筛选:
   - 按时间范围:`时间戳 BETWEEN 'YYYY-MM-DD' AND 'YYYY-MM-DD'`
   - 按单元号:`单元号 = N`
   - 按报警类型:`报警码 IN (10,11,12,...)`
4. 导出分析报告(可选):按维护需求生成报警统计/趋势分析报告

**验证方法**:
- CSV文件完整可读(§5.4完整性验证)
- 关键时间点的数据存在(如当月发生的最高级报警记录)
- 与HMI本体当前实时数据衔接(无大段时间断档)

**回滚方案**:
- 历史数据恢复为只读查询用途,不写入HMI本体(防止污染当前数据)
- 若需恢复至HMI本体供画面7趋势曲线显示:仅在McgsPro明确支持时执行,且先备份HMI本体当前数据
- 数据丢失不可恢复时,记录为"HMI历史数据丢失致追溯中断"事件,在审计日志中标注

### 7.5 场景E:整机灾难恢复(8台PLC+HMI全失)

**故障现象**: 实验室火灾/水浸/盗窃/大规模雷击等导致8台PLC与HMI全部损坏或数据全失。

**前置条件**:
- 异地备份可用:外置硬盘或异地NAS含最近半年全量备份
- 备件可用:1台PLC备件(CPU ST20+EM DT16/DR16)、1台HMI备件(维护手册§10.1)
- 硬件现场已恢复供电与网络

**操作步骤(按优先级)**:

**优先级1:恢复1号单元最小可运行配置(目标:24小时内恢复单单元实验能力)**

1. 取1台PLC备件,按维护手册§12.1安装到1号控制柜
2. 按IO现场接线核对表v1.0完成20DI+9DO接线
3. 接入485总线(注射泵+流量计)
4. STEP 7 设置IP=192.168.2.101(系统块配置)
5. 按变量表附录A配置断电保持区(系统块→断电保持)
6. 打开主源工程 `AQUA-EXPO_PLC_Main_V{X.Y.Z}_{YYYYMMDD}.mwp` → 下载(§2.2)
7. 按§3.5从参数备份CSV恢复1号单元参数(VD10~VD140、VW8等)
8. 校时:`PLC` → `设置RTC` → 同步PC当前时间
9. 取1台HMI备件,按组态实施指南§1~§11完成MCGS工程下装(`AQUA-EXPO_HMI_V{X.Y}_{YYYYMMDD}.mcp`)
10. 恢复单元使能:画面8勾选1号=TRUE,其余=FALSE
11. 按PLC首次下装与上电调试Checklist v1.0执行5天调试流程(到货→安装→IO打点→单机功能→联动调试)
12. 1号单元SAT验收通过 → 最小可运行配置恢复完成

**优先级2:恢复其余7台PLC(目标:1~2周内恢复全系统)**

13. 重复步骤1~8,将IP分别配置为192.168.2.102~108(对应2~8号单元)
14. 每台PLC按各自参数备份CSV恢复参数(8套参数可能略有差异,如VD18步分辨率因进样器规格不同)
15. HMI画面8勾选2~8号单元使能=TRUE(随接入进度逐个勾选)

**优先级3:恢复历史数据追溯能力**

16. 从异地备份恢复历史数据CSV至NAS
17. 在HMI本体/工控机查询历史数据(场景D)

**验证方法**:
- 8台PLC程序校验和与主源工程记录一致(§2.5)
- 8台PLC IP分别为192.168.2.101~108,均能ping通
- HMI画面1总览页8单元全部"在线+彩色"
- 按SAT_FAT验收测试用例v1.0对1号单元执行101用例验收
- 急停/系统复位/消音物理按钮测试通过(每台独立)

**回滚方案**:
- 整机灾难恢复无回滚可能,按"先恢复单单元、再扩展"策略降低风险
- 若某台PLC恢复失败,跳过该单元继续恢复其余7台(单机故障隔离原则,PLC设计文档§12.5)
- 恢复过程中若备件耗尽,记录缺失单元,优先保障实验关键单元

---

## 八、备份计划与责任

### 8.1 备份计划表(与设备维护手册对齐)

| 周期 | 备份动作 | 备份对象 | 责任人 | 执行依据 | 验收人 |
|---|---|---|---|---|---|
| **每日** | (无独立备份动作,操作员巡检) | — | 操作员 | 维护手册§3 | — |
| **每周** | HMI审计日志U盘导出 | ④审计日志 | 操作员 | 维护手册§4.2 | 维护工程师 |
| **每月** | HMI历史数据U盘导出 | ④报警/趋势/审计 | 操作员 | 维护手册§5.4+本方案§5.2 | 维护工程师 |
| **每月** | PLC程序STEP 7上载+保存 | ①PLC源工程 | 维护工程师 | 维护手册§5.4+本方案§2.1 | 维护工程师 |
| **每月** | HMI工程文件导出.mcp | ③HMI组态 | 维护工程师 | 维护手册§5.4+本方案§4.1 | 维护工程师 |
| **每月** | 参数配置画面4导出 | ②PLC参数 | 维护工程师 | 维护手册§5.4+本方案§3.2 | 维护工程师 |
| **每月** | 工控机→NAS自动同步 | ①②③④全量 | 维护工程师 | 本方案§6.2 | 维护工程师 |
| **每季度** | 审计日志专项导出+合规归档 | ④审计日志 | 维护工程师 | 维护手册§6.3+本方案§5.2 | 项目经理 |
| **每季度** | 用户密码更换后用户权限重备份 | ③用户权限 | 维护工程师 | 维护手册§6.3+本方案§4.3 | 维护工程师 |
| **每半年** | PLC程序全量上载(8台) | ①8台PLC实例 | 维护工程师 | 维护手册§7.3+本方案§2.1 | 维护工程师 |
| **每半年** | HMI工程全量导出 | ③HMI组态 | 维护工程师 | 维护手册§7.3+本方案§4.1 | 维护工程师 |
| **每半年** | 历史数据全量导出 | ④历史数据 | 维护工程师 | 维护手册§7.3+本方案§5.2 | 维护工程师 |
| **每半年** | 参数配方全量导出 | ②配方 | 维护工程师 | 维护手册§7.3+本方案§3.2/4.2 | 维护工程师 |
| **每半年** | 异地副本存档(外置硬盘) | ①②③④全量 | 维护工程师 | 本方案§6.2 | 项目经理 |
| **每半年** | 8台PLC版本一致性核对 | ①程序一致性 | 维护工程师 | 本方案§2.5 | 维护工程师 |
| **每年** | 全量备份(含工程+历史数据) | ①②③④全量 | 维护工程师 | 维护手册§8.3+本方案§5.2 | 项目经理 |
| **每年** | 年度归档(NAS→永久) | ④历史数据 | 维护工程师 | 本方案§5.2 | 项目经理 |
| **每年** | 恢复演练(模拟1场景) | 任选1场景 | 维护工程师 | 本方案§7+§8.3 | 项目经理 |
| **变更触发** | 工程文件+参数快照备份 | ①②③ | 变更执行人 | 本方案§7前 | 维护工程师 |

### 8.2 责任人清单

| 角色 | 备份职责 | 联系方式(填写) |
|---|---|---|
| 操作员 | 每周/每月HMI导出执行+检查 | ___ |
| 维护工程师(白班) | 每月/季度/半年/年备份执行+NAS同步+恢复 | ___ |
| 维护工程师(夜班) | 紧急备份/恢复响应 | ___ |
| 项目经理 | 异地存档监督+恢复演练验收 | ___ |
| PLC技术支持 | PLC程序/参数恢复疑难 | ___ |
| HMI技术支持 | HMI组态/历史数据恢复疑难 | ___ |

### 8.3 备份执行检查清单(每月备份用)

每月备份执行时,维护工程师按下表逐项打勾签字:

| # | 备份项 | 执行日期 | 备份文件名 | 验证结果 | 签字 |
|---|---|---|---|---|---|
| 1 | PLC程序上载(8台,若有变更) | ___ | AQUA-EXPO_PLC_U{NN}_*.mwp | □编译0错 □校验和一致 | |
| 2 | PLC参数导出(8台) | ___ | AQUA-EXPO_PLC_U{NN}_Param_*.csv | □字段完整 □值合理 | |
| 3 | HMI工程导出 | ___ | AQUA-EXPO_HMI_v*_*_*.mcp | □8画面 □728变量 □32报警 | |
| 4 | HMI配方导出 | ___ | AQUA-EXPO_HMI_Recipe_*.csv | □10组配方 | |
| 5 | HMI用户权限导出 | ___ | AQUA-EXPO_HMI_Users_*.csv | □3级权限 | |
| 6 | HMI历史数据导出 | ___ | AQUA-EXPO_HMI_Hist_{YYYYMM}.csv | □8单元 □记录完整 | |
| 7 | 工控机→NAS同步 | ___ | robocopy日志 | □无失败 | |
| 8 | 8台PLC版本一致性核对(每半年) | ___ | 一致性表 | □8台校验和一致 | |
| 9 | 异地存档(每半年) | ___ | 外置硬盘 | □已交付档案室 | |
| 10 | 备份日志记录 | ___ | BackupLog_{YYYYMMDD}.txt | □已记录 | |

### 8.4 备份失败处理

| 失败现象 | 可能原因 | 处理措施 |
|---|---|---|
| STEP 7 上载失败 | PLC通讯异常/STEP7版本不兼容 | 检查网线/IP/防火墙;升级STEP7至V2.5+;若仍失败联系PLC技术支持 |
| Modbus 读取超时 | PLC未配置Modbus TCP Server/端口被占用 | 改用方法A或C;检查MBUS_SERVER配置;检查端口502占用 |
| HMI U盘导出失败 | U盘格式不支持/容量不足/HMI脚本异常 | 格式化U盘为FAT32;更换U盘;检查McgsPro导出脚本日志 |
| NAS同步失败 | 网络中断/权限不足/NAS磁盘满 | 检查网络;重新映射网络驱动器;清理NAS旧文件;联系IT |
| 备份文件损坏 | 存储介质故障/病毒 | 用第二份副本恢复;杀毒;更换介质重备份 |
| HMI工程编译错误 | 组态文件版本不兼容/变量丢失 | 用上一版本 .mcp 恢复;重新导入变量CSV模板 |
| 恢复后PLC异常 | 参数恢复错误/系统块配置丢失 | 按§3.6回滚;重新下载系统块;联系PLC技术支持 |

**备份失败上报流程**:
1. 操作员发现 → 立即通知维护工程师
2. 维护工程师30分钟内响应 → 1小时内修复或上报
3. 若24小时内无法修复 → 上报项目经理,启动应急预案(§9)
4. 备份失败期间 → 严禁对PLC/HMI进行程序变更或参数修改(防止变更无备份可回滚)

---

## 九、应急预案

### 9.1 备份不可用时的应急处置

**场景**: 需恢复时发现备份文件损坏/丢失/版本不匹配。

**处置原则**: 优先保障PLC安全运行,牺牲历史数据完整性,后续逐步重建。

| 备份失效场景 | 应急处置 |
|---|---|
| PLC源工程损坏 | 用8台PLC中任一台上传获取运行程序(若PLC本体完好);若8台PLC均损坏,联系原PLC工程师从邮件/版本库找回源工程;启动现场重编程(预计1~2周) |
| PLC参数备份损坏 | 用变量表§6的"默认值"列作为初始参数;按现场实际浓度/时间需求重新录入;实验需重新开始(VW8清零) |
| HMI工程损坏 | 用组态实施指南重新组态(预计1~3天);PLC可独立运行,无HMI期间通过物理按钮操作 |
| 历史数据损坏 | 接受数据丢失;从HMI本体当前数据开始重新积累;不影响实时控制 |
| 异地副本损坏 | 检查NAS副本;若NAS也损坏,从工控机硬盘副本恢复;启动数据重建(§9.3) |

### 9.2 数据重建优先级

整机灾难后,按以下优先级重建数据(对应§7.5优先级):

| 优先级 | 重建对象 | 重建来源 | 预计耗时 |
|---|---|---|---|
| P0(立即) | PLC运行程序(主源工程) | 异地备份/邮件/版本库 | 2小时(若有备份)~2周(若无) |
| P1(24h内) | 1号单元PLC参数(默认值) | 变量表§6默认值列 | 1小时 |
| P1(24h内) | HMI最小可运行组态(仅1号单元) | 组态实施指南 | 1天 |
| P2(1周内) | 8台PLC参数(逐台录入) | 变量表§6 + 现场实测 | 1~2天 |
| P2(1周内) | HMI完整组态(8单元) | 组态实施指南 | 1~3天 |
| P3(1月内) | 历史数据(从当前开始重新积累) | HMI本体实时记录 | 持续累积 |
| P4(长期) | 历史数据追溯(若异地备份可恢复) | 异地备份恢复查询 | 按需 |

### 9.3 最小可运行配置

整机灾难时,以下为"最小可运行配置",保障核心实验能力:

| 配置项 | 最小配置 | 说明 |
|---|---|---|
| PLC | 1台CPU ST20 + EM DT16/DR16 | 仅1号单元运行 |
| PLC程序 | 主源工程 .mwp | 8台相同,1份即可 |
| PLC参数 | 变量表§6默认值 | 浓度5%/周期30min/实验480min等 |
| HMI | 1台昆仑通态MCGS 12寸 | 仅组态1号单元(画面1~7) |
| 单元使能 | 仅1号=TRUE | 其余7号=FALSE |
| 网络 | 1台非网管交换机 + 2根网线 | PLC#1 + HMI |
| 485从站 | 1台注射泵 + 1台流量计 | 仅1号单元的2个从站 |
| 急停/复位/消音按钮 | 各1套 | 1号单元就地面板 |
| 安全继电器 | 1个(强制导向型220V) | 1号单元急停回路 |

**最小可运行配置能力**:
- 1号单元完整执行S0~S7实验流程
- 急停/系统复位物理回路完整
- HMI显示1号单元实时状态、报警、参数、趋势
- 不支持2~8号单元(灰显"未接入")
- 历史数据从恢复时刻开始记录

**升级路径**:
- 备件到位 → 接入第2台PLC → HMI画面8勾选2号使能 → 重复至8台全接入
- 全部接入后按§7.5验证清单与SAT_FAT验收测试用例执行全系统验收

### 9.4 应急联系方式

| 角色 | 姓名 | 电话 | 备注 |
|---|---|---|---|
| 维护工程师(白班) | | | 日常备份/恢复 |
| 维护工程师(夜班) | | | 紧急响应 |
| 项目经理 | | | 重大决策/资源协调 |
| PLC技术支持 | | | PLC疑难 |
| HMI技术支持 | | | HMI疑难 |
| 异地档案室 | | | 异地副本取用 |
| 厂商PLC(西门子) | 400-810-4288 | 西门子技术支持热线 |
| 厂商HMI(昆仑通态) | 010-82895960 | 昆仑通态技术支持 |

### 9.5 应急预案演练

| 演练项 | 频率 | 责任人 | 验收 |
|---|---|---|---|
| 单台PLC程序恢复演练 | 每年1次 | 维护工程师 | 在备件PLC上模拟恢复,记录耗时与问题 |
| HMI组态恢复演练 | 每年1次 | 维护工程师 | 在备件HMI上模拟恢复,验证8画面完整 |
| 整机灾难恢复桌面推演 | 每年1次 | 项目经理+维护工程师 | 模拟8台全失场景,演练决策流程 |
| 异地副本取用演练 | 每年1次 | 维护工程师 | 验证异地副本可读性+取用时效 |

**演练记录**:
- 演练完成后填写 `_RestoreTest\RestoreTest_{YYYYMMDD}.md`,记录:
  - 演练场景、执行步骤、实际耗时、遇到问题、改进措施
- 演练发现的问题纳入下次本方案修订(版本升级触发条件)

---

**文档版本**: v1.0
**创建日期**: 2026-07-18
**下次更新触发**:
- 《PLC程序版本管理规范》正式发布后,以其版本号规则替换本方案文首说明
- 现场首次恢复演练后,根据演练发现的问题修订
- 备份介质/工具升级(如NAS更换、McgsPro版本升级)后修订
- 新增/调整备份对象(如新增第9台PLC)后修订
- 配套文档(变量表/PLC设计文档/组态指南)升版后同步更新引用
