Yustnust/AQUA-EXPO/docs/commissioning/网络架构与IP规划_v1.0.md

# 药液配置加注控制系统 — 网络架构与IP规划 v1.0

**项目**: 药液配置加注控制系统
**适用范围**: 8套缸单元（每套1台西门子S7-200 SMART CPU ST20 + EM DT16/DR16扩展）+ 1台昆仑通态MCGS 12寸HMI通过以太网集中监控8台PLC的工业以太网网络规划、调试与维护
**用途**: 网络与采购工程师及现场调试工程师的网络方案、IP编址、设备选型、调试与故障排查依据；与《HMI-PLC变量地址表_v1.0》第十二章、PLC设计文档v9.3第十二章配套使用
**版本**: v1.0
**日期**: 2026-07-18
**配套文档**: HMI-PLC变量地址表v1.0、药液配置加注控制系统_PLC设计文档v9.3、HMI选型技术问询单与备选方案对比v1.0、BOM清单v2

---

## 一、IP编址总则

### 1.1 编址原则

1. **网段统一**：8台PLC与1台HMI统一规划于 `192.168.2.0/24` 同一网段，避免跨网段路由，降低故障面。
2. **PLC地址与单元编号一一对应**：PLC#N 的 IP 末位为 `100+N`（即1号=101、8号=108），便于故障定位与运维记忆。
3. **HMI地址紧邻PLC段头**：HMI IP `192.168.2.100`，与PLC段 101~108 物理相邻、视觉清晰。
4. **预留地址段**：网段内 192.168.2.1（网关/管理IP）、.2~.9（网络设备）、.10~.99（调试与上位机预留）、.109~.254（扩展预留）。
5. **子网掩码统一**：C类 `255.255.255.0`，无网关需求场景下网关可填 `192.168.2.1` 但不强制启用。

### 1.2 与历史文档的差异说明

> PLC设计文档v9.3第12.2节与变量地址表v12.1节中HMI示例IP为 `192.168.2.10`。本规划根据现场调试便利性调整为 `192.168.2.100`（紧邻PLC段），并相应将预留段 .10~.99 用于调试/上位机。两版差异仅在HMI末位（10→100），PLC地址段不变。如现场已按 `.10` 实施，可在交换机/HMI侧同步切换，不影响PLC侧配置。

---

## 二、网络拓扑

### 2.1 拓扑结构（星型）

```
                      ┌──────────────────────────────┐
                      │   现场本地集中触摸屏 HMI          │
                      │   昆仑通态 MCGS 12寸             │
                      │   IP: 192.168.2.100            │
                      │   MAC: 00:1E:10:XX:XX:91 (示意)  │
                      └───────────────┬──────────────┘
                                      │ 屏蔽超五类网线 (Cat5e STP)
                                      │ ≤ 80 m
                                      ▼
              ┌───────────────────────────────────────────────┐
              │       工业以太网交换机 (16口管理型建议)            │
              │       IP: 192.168.2.2 (管理VLAN)                 │
              │       MAC: 00:1F:9E:XX:XX:01 (示意)              │
              │       防护等级: IP30/IP40 (机柜内安装)             │
              └──┬─────┬─────┬─────┬─────┬─────┬─────┬─────┬──┬──┘
                 │     │     │     │     │     │     │     │  │
                 ▼     ▼     ▼     ▼     ▼     ▼     ▼     ▼  ▼
              PLC#1  PLC#2  PLC#3  PLC#4  PLC#5  PLC#6  PLC#7  PLC#8  调试/上位机预留
              .101   .102   .103   .104   .105   .106   .107   .108   .200~.210
               │     │     │     │     │     │     │     │
               ▼     ▼     ▼     ▼     ▼     ▼     ▼     ▼
            各缸单元（1套缸单元 = 1台PLC + 注射泵 + 流量计RS485 + 阀门/泵/传感器）
            ※ 每套PLC本体RS485口(Port0)独立挂接本单元注射泵+流量计2个Modbus RTU从站，
               不经过以太网转发，详见PLC设计文档v9.3第二章2.3节
```

### 2.2 拓扑说明

| 项目 | 说明 |
|---|---|
| 拓扑类型 | 星型，单交换机集中转发；不采用级联（8套缸同处一实验室，距离不远，BOMv2第5项已确认无需级联或光纤） |
| 交换机口数 | 推荐 **16口管理型**（8口PLC+1口HMI+1口调试+1口上位机+4口预留扩展），最低9口（按BOMv2第5项）。本规划按16口核算便于扩展 |
| 网线类型 | 屏蔽超五类（Cat5e STP）或六类（Cat6 U/FTP），工业抗干扰环境优先STP/FTP |
| 单段长度 | ≤ 80 m（实验室内部走线，远小于100 m上限，留余量） |
| 冗余 | 单交换机无冗余；现场若对可用性要求高，可双交换机级联+链路聚合（首期不建议） |
| 接地 | 交换机金属外壳、PLC机柜、HMI外壳、屏蔽层单端接地（PE≤4Ω） |

### 2.3 MAC地址管理

| 设备 | MAC格式 | 记录方式 |
|---|---|---|
| HMI | 00:1E:10:XX:XX:XX | 到货时记录实际MAC，纳入资产台账 |
| PLC#1~#8 | 00:0E:08:XX:XX:XX（西门子OUI，示意） | 到货时按SN/MAC对应单元编号登记，见《PLC首次下装与上电调试Checklist》1.1节 |
| 交换机 | 00:1F:9E:XX:XX:XX | 同上 |

**说明**：实际MAC以设备铭牌为准，本规划仅示意格式。MAC地址在交换机端口绑定（见第六章VLAN/隔离规划）时可防止IP冲突与未授权设备接入。

---

## 三、IP地址分配表

### 3.1 主设备IP分配

| # | 设备名 | IP地址 | 子网掩码 | 网关 | 用途 | 连接端口 | 线缆规格 |
|---|---|---|---|---|---|---|---|
| 1 | HMI（昆仑通态MCGS 12寸） | 192.168.2.100 | 255.255.255.0 | 192.168.2.1 | 集中监控8台PLC，参数设定/报警/历史记录 | 交换机Port1 | Cat5e STP |
| 2 | PLC#1（1号缸单元） | 192.168.2.101 | 255.255.255.0 | 192.168.2.1 | 1号缸单元控制（ST20+EM DT16/DR16） | 交换机Port2 | Cat5e STP |
| 3 | PLC#2（2号缸单元） | 192.168.2.102 | 255.255.255.0 | 192.168.2.1 | 2号缸单元控制 | 交换机Port3 | Cat5e STP |
| 4 | PLC#3（3号缸单元） | 192.168.2.103 | 255.255.255.0 | 192.168.2.1 | 3号缸单元控制 | 交换机Port4 | Cat5e STP |
| 5 | PLC#4（4号缸单元） | 192.168.2.104 | 255.255.255.0 | 192.168.2.1 | 4号缸单元控制 | 交换机Port5 | Cat5e STP |
| 6 | PLC#5（5号缸单元） | 192.168.2.105 | 255.255.255.0 | 192.168.2.1 | 5号缸单元控制 | 交换机Port6 | Cat5e STP |
| 7 | PLC#6（6号缸单元） | 192.168.2.106 | 255.255.255.0 | 192.168.2.1 | 6号缸单元控制 | 交换机Port7 | Cat5e STP |
| 8 | PLC#7（7号缸单元） | 192.168.2.107 | 255.255.255.0 | 192.168.2.1 | 7号缸单元控制 | 交换机Port8 | Cat5e STP |
| 9 | PLC#8（8号缸单元） | 192.168.2.108 | 255.255.255.0 | 192.168.2.1 | 8号缸单元控制 | 交换机Port9 | Cat5e STP |
| 10 | 调试口（调试用笔记本接入点） | 192.168.2.200（DHCP可选） | 255.255.255.0 | 192.168.2.1 | 现场STEP 7-Micro/WIN SMART下装/调试，临时接入 | 交换机Port10 | Cat5e STP |
| 11 | 上位机预留（数据采集/远程维护） | 192.168.2.201 | 255.255.255.0 | 192.168.2.1 | 预留未来SCADA/远程网关接入；首期不接入 | 交换机Port11 | Cat5e STP |
| 12 | 工业以太网交换机（管理IP） | 192.168.2.2 | 255.255.255.0 | — | 交换机管理访问（仅管理型） | — | — |
| 13 | 网关（若需跨网段，首期不启用） | 192.168.2.1 | 255.255.255.0 | — | 预留路由出口 | — | — |

### 3.2 端口分配与VLAN对应

| 交换机端口 | 接入设备 | VLAN | 速率/双工 | 风暴抑制 | 备注 |
|---|---|---|---|---|---|
| Port1 | HMI | VLAN10(运行) | 100M/全双工auto | 启用 | 主监控节点 |
| Port2~Port9 | PLC#1~#8 | VLAN10(运行) | 100M/全双工auto | 启用 | 各PLC独立端口 |
| Port10 | 调试口 | VLAN20(调试) | auto | 启用 | 默认VLAN20，按需切换至VLAN10 |
| Port11 | 上位机预留 | VLAN10(运行) | auto | 启用 | 首期不接 |
| Port12~Port16 | 预留扩展 | — | — | — | 后续单元/设备扩展 |

---

## 四、网络设备选型建议

### 4.1 工业以太网交换机

| 参数 | 推荐配置 | 备选 | 说明 |
|---|---|---|---|
| 端口数 | 16口（8电口PLC+1电口HMI+1调试+1上位机+5预留） | 9口（BOMv2最低配置） | 16口为推荐，便于扩展；9口为BOMv2经济配置 |
| 端口类型 | 10/100Base-T(X) RJ45（满足PLC/HMI 100M需求） | 含2个千兆SFP上联口（可选） | 千兆上联用于未来接SCADA |
| 管理类型 | **管理型（L2网管）** | 非网管型（BOMv2经济方案） | 管理型支持VLAN/端口绑定/风暴抑制/镜像，便于调试与安全；非网管型首期可用但缺乏诊断手段 |
| 防护等级 | IP30（机柜内）/IP40（更高防护） | — | 实验室机柜内安装，IP30足够；现场裸装需IP40+ |
| 工作温度 | -10~+60℃（工业级） | -40~+75℃（宽温型） | 实验室常温环境，工业级即可 |
| 电源 | 24VDC冗余双电源（与PLC供电同源） | 单24VDC电源 | 冗余电源提升可靠性 |
| 协议支持 | IEEE 802.3/802.3u/802.3x流控，STP/RSTP | — | STP用于避免环网误接 |
| 安装方式 | DIN导轨安装（与PLC同柜） | 19英寸机架 | 控制柜DIN导轨安装优先 |
| 参考品牌 | 西门子SCALANCE X108/X116、Moxa EDS-2008/2016、三旺S2700系列、研华EKI-2528 | — | 国产优先降本，进口品牌稳定性更佳 |

**结论建议**：首期可选 9口非网管型（满足BOMv2经济配置），全量8套扩展阶段升级为 16口管理型。若预算允许，首期即按 16口管理型采购，避免扩展时更换硬件（与BOMv2第5项备注"必须选9口及以上，避免扩展时更换"原则一致）。

### 4.2 网线选型

| 类型 | 规格 | 用途 | 推荐场景 |
|---|---|---|---|
| 屏蔽超五类（Cat5e STP/SFTP） | 4对双绞线，整体铝箔+编织屏蔽 | PLC/HMI↔交换机连接 | **首选**，工业抗干扰环境 |
| 六类非屏蔽（Cat6 UTP） | 4对双绞线，十字骨架 | 短距离室内连接，干扰较小 | 实验室环境可用 |
| 六类屏蔽（Cat6 SFTP） | 双重屏蔽 | 高干扰环境或长距离 | 距交换机>50m或变频器旁 |
| 工业级RJ45插头 | 镀金触点，金属外壳 | 网线端接 | 优于普通PC用RJ45 |
| 工业级RJ45防尘盖 | IP65防护 | 未使用端口防尘 | 机柜外露端口必备 |

**线缆颜色建议**：HMI↔交换机用蓝色，PLC↔交换机用灰色，调试口用黄色，便于现场识别。

### 4.3 RJ45防尘与机柜布线规范

| 项目 | 要求 |
|---|---|
| RJ45接头 | 工业级镀金接头，压接后做拉力测试（≥50N不脱落） |
| 未用端口 | 交换机/HMI/PLC未使用RJ45口必须盖防尘盖，防止水汽/灰尘进入 |
| 线缆标识 | 两端线号管标识"PLC#1→SW-P2"等，配套标签机打印 |
| 走线槽 | 强电（220V动力）与弱电（网络/485）分槽敷设，间距≥100mm；交叉时垂直90°交叉 |
| 弯曲半径 | 网线弯曲半径≥6倍线径（约48mm），避免急弯 |
| 端接冗余 | 每条网线两端各预留0.5m，便于维护时重新压接 |
| 机柜进出 | 机柜进出线孔用防火泥/护线圈封堵，防尘防鼠 |
| 屏蔽接地 | STP网线屏蔽层在交换机侧单端接地（PE排），避免地环流 |

---

## 五、VLAN与隔离规划

### 5.1 VLAN划分方案

| VLAN ID | 用途 | 包含端口 | IP段 | 说明 |
|---|---|---|---|---|
| VLAN10 | 运行网 | Port1（HMI）、Port2~9（PLC#1~8）、Port11（上位机预留） | 192.168.2.100~108, .201 | 主业务网络，承载S7/Modbus TCP通讯 |
| VLAN20 | 调试网 | Port10（调试口） | 192.168.2.200（DHCP可选） | 调试笔记本接入，默认与运行网隔离 |
| VLAN1（默认） | 管理网 | 交换机管理口 | 192.168.2.2 | 仅交换机管理访问，逻辑隔离 |

### 5.2 隔离策略

| 隔离对象 | 隔离方式 | 实施方法 |
|---|---|---|
| 调试网 ↔ 运行网 | VLAN隔离 | 调试口默认VLAN20，调试时若需访问运行网PLC，按需临时切至VLAN10或建立VLAN间路由（管理型交换机支持） |
| 运行网 ↔ 办公网 | 物理隔离 | 不接入厂区办公网；远程维护通过VPN网关在上位机预留口接入（Port11） |
| 交换机管理 ↔ 业务 | 802.1Q + ACL | 管理IP仅允许指定维护终端访问，业务端口不响应管理报文 |

### 5.3 是否需VLAN的决策建议

| 场景 | 是否需要VLAN | 理由 |
|---|---|---|
| 首期1套单元、调试与运行可共用 | 否 | 9口非网管型交换机即可，无VLAN能力 |
| 全量8套运行+调试频繁 | **是** | 调试操作（如下装程序、强制变量）不应干扰运行单元通讯；VLAN隔离降低误操作风险 |
| 接入厂区SCADA/远程维护 | **是** | 必须VLAN或防火墙隔离，防止办公网攻击面蔓延至PLC |
| 监管合规要求（如GMP/审计） | **是** | 需独立调试日志记录与访问控制 |

**结论建议**：全量8套阶段必须采用管理型交换机+VLAN隔离；首期1套可用非网管型过渡。

---

## 六、S7协议 vs Modbus TCP方案对比与切换策略

### 6.1 协议方案对比

| 对比项 | S7协议（推荐） | Modbus TCP（备选） |
|---|---|---|
| 原生支持 | S7-200 SMART CPU本体以太网口原生支持 | S7-200 SMART需调用MBUS_SERVER指令实现TCP服务器 |
| HMI驱动要求 | HMI需具备S7-200 SMART驱动（昆仑通态/威纶通/西门子原生支持） | 所有主流HMI均支持，通用性最好 |
| PLC侧工作量 | 无需额外编程，STEP 7-Micro/WIN SMART中配置PG/PC接口即可 | 需在PLC程序中调用MBUS_SERVER指令，配置V区→Modbus寄存器映射表，约1天开发量 |
| 通讯效率 | 高（西门子优化协议，ISO-on-TCP，102端口） | 中（Modbus TCP 502端口，请求-响应模式） |
| 变量访问方式 | 直接读写V区/M区/I/Q/DB，按符号或地址访问 | 仅映射至保持寄存器4xxxxx，BOOL需映射至线圈或位操作 |
| 数据类型支持 | BOOL/INT/REAL/DWORD等全类型，原生REAL | 寄存器16位，REAL需双寄存器拼装，BOOL打包处理 |
| 8连接数限制 | 受HMI驱动授权限制，昆仑通态需向厂商确认（变量地址表14.2节待确认事项第7项） | 通常无连接数硬限制，HMI作客户端可并发轮询8台 |
| 诊断手段 | STEP 7-Micro/WIN SMART在线连接状态、HMI驱动层连接状态 | Modbus Poll工具、Wireshark抓包，异常码易定位 |
| 长期维护 | 与西门子生态深度集成，维护资料丰富 | 通用协议，第三方维护方便，但映射表需同步维护 |

### 6.2 8连接数限制分析

S7-200 SMART CPU ST20本体以太网口**最多支持8个以太网连接**（含PG/HMI/OP/Open IE等），具体分配：

| 连接类型 | 默认数量 | 说明 |
|---|---|---|
| PG（编程器） | 1 | STEP 7-Micro/WIN SMART在线调试占用 |
| HMI/OP | 4~8（取决于CPU固件版本，ST20典型为8） | HMI连接占用，8台HMI连接需CPU固件V2.5以上支持 |
| Open IE（PUT/GET/Modbus TCP） | 8（与HMI共享总数） | 启用Modbus TCP Server时占用此额度 |

**关键限制点**：
- **每台PLC只与1台HMI建立1条连接**（HMI侧共建立8条连接至8台PLC，每台PLC侧仅占1个HMI连接资源），PLC侧连接数无瓶颈。
- **真正的瓶颈在HMI侧**：昆仑通态MCGS嵌入式组态软件的S7驱动是否支持同时建立8个站点连接，需向厂商确认（《HMI选型技术问询单》Q1已问询，待回复）。
- 若HMI侧S7驱动仅支持4连接，则必须启用Modbus TCP方案。

### 6.3 协议切换策略

```
[决策流程]

Step 1: HMI选型确认（依据HMI选型技术问询单厂商回复）
   ├─ Q1回复"支持8连接S7" → 采用S7协议（首选）
   └─ Q1回复"不支持8连接S7" → 进入Step 2

Step 2: 评估Modbus TCP方案
   ├─ PLC侧启用MBUS_SERVER，将V区映射至Modbus保持寄存器
   ├─ HMI侧改用Modbus TCP客户端驱动，连接8台PLC的502端口
   └─ 配置变量地址表第十一章Modbus映射表 → PLC程序

Step 3: 混合方案（备选）
   ├─ HMI对1~4号PLC用S7协议，5~8号PLC用Modbus TCP
   └─ 不推荐，维护复杂度高

[切换实施步骤（从S7切至Modbus TCP）]
1. PLC侧程序：在OB1调用MBUS_SERVER指令，绑定Port0/某V区缓冲
2. PLC侧配置：系统块→Modbus TCP端口502，Max Hold/Max AI参数按变量表11章核算
3. HMI侧：组态软件中删除S7驱动，新增Modbus TCP客户端，建立8个设备连接
4. HMI侧：变量绑定由V区地址改写为Modbus寄存器4xxxxx地址（按11章映射表）
5. 调试：见第七章网络调试步骤
```

### 6.4 推荐方案

**首选S7协议**：昆仑通态MCGS TPC1211-T12CE经问询确认支持8连接后采用，理由：
- PLC侧零额外编程，开发周期短
- REAL数据类型原生支持，无需拼装
- 与西门子生态兼容性最佳

**备选Modbus TCP**：若昆仑通态S7驱动8连接能力不满足，PLC侧启用MBUS_SERVER，按变量地址表第十一章映射表配置（V区→4xxxxx）。

---

## 七、网络调试步骤

### 7.1 调试工具准备

| 工具 | 用途 | 来源 |
|---|---|---|
| 笔记本电脑+网线 | 调试接入 | 《PLC首次下装与上电调试Checklist》1.2节 |
| STEP 7-Micro/WIN SMART | PLC在线/Ping诊断/连接测试 | 西门子官网 |
| Ping（系统自带） | 连通性测试 | Windows/Linux |
| Modbus Poll / Modscan | Modbus TCP轮询测试 | 第三方免费工具 |
| Wireshark | 抓包分析协议/异常 | 开源工具 |
| iperf3 | 8并发带宽压力测试（可选） | 开源工具 |

### 7.2 第1步：物理层与连通性测试（ping）

| # | 测试项 | 命令/方法 | 期望结果 | 异常处理 |
|---|---|---|---|---|
| 1 | PLC上电后网卡UP | 观察PLC以太网口指示灯 | 绿色常亮（链路）+黄色闪烁（数据） | 检查网线/交换机端口/PLC供电 |
| 2 | 交换机端口UP | 观察交换机端口指示灯 | 对应端口亮 | 检查网线压接/端口使能 |
| 3 | HMI↔交换机连通 | HMI界面进入网络设置查看IP配置 | 192.168.2.100配置成功 | 检查HMI网络设置 |
| 4 | 调试机ping HMI | `ping 192.168.2.100` | 4包全部<1ms响应 | 检查调试机IP段（须在192.168.2.x） |
| 5 | 调试机ping PLC#1 | `ping 192.168.2.101` | <1ms响应 | 检查PLC系统块→组态以太网口IP |
| 6 | 调试机ping 8台PLC | 依次ping .101~.108 | 全部<1ms响应 | 单台不通→查该PLC IP/网线 |
| 7 | 长时延/丢包测试 | `ping -t 192.168.2.101`（持续5分钟） | 0%丢包，平均<1ms | 丢包→查网线压接/交换机端口/干扰 |
| 8 | MTU确认 | `ping -l 1472 -f 192.168.2.101` | 不分片通过 | 若失败调整MTU或检查中间设备 |

### 7.3 第2步：S7协议连接测试

| # | 测试项 | 方法 | 期望结果 | 异常处理 |
|---|---|---|---|---|
| 1 | STEP 7-Micro/WIN SMART在线 | 编程软件→通信→查找CPU | 找到192.168.2.101 | 检查PG/PC接口配置 |
| 2 | 单PLC在线状态读取 | 在线→状态表读取VW2 | 读到状态机当前值 | 检查通信驱动 |
| 3 | 单PLC变量写入测试 | 强制V0.0=1 | PLC响应（V1.0=1） | 检查写权限/系统块配置 |
| 4 | HMI单PLC连接测试 | HMI组态1个PLC_01连接，读取VW2 | HMI显示状态机值 | 检查HMI驱动配置/IP |
| 5 | HMI 8并发连接测试 | HMI组态8个PLC连接，全部上线 | 8单元卡片显示在线 | 见第4步专项压力测试 |

### 7.4 第3步：Modbus TCP轮询测试（若启用）

| # | 测试项 | 方法 | 期望结果 | 异常处理 |
|---|---|---|---|---|
| 1 | PLC侧MBUS_SERVER调用确认 | 在线监视PLC程序 | MBUS_SERVER指令ENO=1 | 检查HoldStart/Max Hold参数 |
| 2 | Modbus Poll单点读取 | SlaveIP=.101，Port=502，FC03，地址按映射表 | 返回VW2值 | 检查映射表/功能码 |
| 3 | 8台PLC Modbus并发轮询 | 启动8个Modbus Poll实例，分别连8台PLC | 8实例均正常返回 | 检查连接数限制 |
| 4 | 异常码分析 | 故意读非法地址 | 返回Modbus异常码02（非法地址） | 确认映射表正确 |

### 7.5 第4步：8并发连接压力测试

| # | 测试项 | 方法 | 期望指标 | 结论判定 |
|---|---|---|---|---|
| 1 | HMI↔8 PLC并发S7连接 | HMI工程运行，8单元卡片同时刷新 | 8单元均在线，刷新<500ms | 通过 |
| 2 | 趋势曲线1分钟采样8单元并发 | HMI趋势页运行1小时 | 8单元曲线完整无断点 | 通过 |
| 3 | 8 PLC同时被HMI+调试机访问 | 调试机ping 8 PLC同时HMI刷新 | 调试机/HMI均无超时 | 通过 |
| 4 | 8 PLC连接数饱和测试 | 8 HMI连接+1 PG连接+1 Modbus TCP连接（共10尝试） | 前8连接成功，第9+拒绝（按S7-200 SMART连接上限） | 符合CPU连接数限制 |
| 5 | 长时间稳定性 | HMI连续运行24小时，8单元在线 | 0次断线/重连 | 通过 |
| 6 | 带宽占用 | iperf3 UDP打流测试 | 8 PLC+HMI总流量<2Mbps（远低于100M带宽） | 通过 |

### 7.6 第5步：网络切换测试

| # | 测试项 | 方法 | 期望结果 |
|---|---|---|---|
| 1 | 拔插HMI网线 | HMI运行中断网5秒后恢复 | HMI自动重连8 PLC，无人工干预 |
| 2 | 拔插单PLC网线 | 1号PLC断网10秒后恢复 | HMI显示"1号通讯中断"→自动恢复，其余7单元不受影响 |
| 3 | 交换机重启 | 重启交换机30秒 | 8 PLC+HMI全部自动恢复连接 |
| 4 | PLC重启 | 重启1台PLC | HMI显示该单元通讯中断→PLC上线后恢复 |

---

## 八、网络故障排查指引

### 8.1 常见故障速查表

| 现象 | 可能原因 | 排查命令/方法 | 解决措施 |
|---|---|---|---|
| 单台PLC ping不通 | 网线压接不良/网线断/PLC IP未配置/端口DOWN | `ping IP`；查PLC系统块IP；查交换机端口灯 | 重新压接RJ45；配置PLC IP；更换交换机端口 |
| 全部PLC ping不通 | 交换机故障/调试机IP段错误/交换机断电 | `ping 192.168.2.2`（交换机管理IP）；`ipconfig`查调试机IP | 检查交换机供电；修正调试机IP至192.168.2.x段 |
| HMI ping通但S7连不上 | HMI驱动未配置/PG/PC接口占用/PLC连接数满 | STEP 7在线测试；查HMI驱动日志 | 关闭STEP 7释放PG连接；检查PLC连接数 |
| HMI某单元"通讯中断" | 该PLC掉线/网线松动/IP冲突 | `ping 192.168.2.10X`；`arp -a`查MAC冲突 | 修复该PLC网络；解决IP冲突 |
| HMI显示某单元数据不动 | S7连接假死/PLC扫描周期阻塞 | STEP 7在线查看PLC RUN灯/STOP状态 | 重启PLC；检查程序死循环 |
| 丢包率高 | 网线质量差/干扰/交换机背板带宽不足 | `ping -t IP`；查网线与强电距离 | 换STP屏蔽线；远离变频器/强电 |
| 延迟>100ms | 广播风暴/环路/交换机过载 | Wireshark抓包看广播包比例 | 启用风暴抑制；查STP环路 |
| Modbus TCP返回异常码02 | 寄存器地址超出MBUS_SERVER映射范围 | 核对变量地址表第十一章映射表 | 调整HoldStart/Max Hold参数 |
| Modbus TCP连接被拒 | PLC连接数满/502端口未开放 | `telnet 192.168.2.101 502` | 减少并发连接数；检查MBUS_SERVER调用 |
| 偶发性通讯中断（夜间） | 网络设备重启/UPS切换/温度异常 | 查HMI连接日志时间分布 | 加UPS稳压；查机柜温度 |

### 8.2 常用排查命令

```bash
# 1. 连通性测试（Windows调试机）
ping 192.168.2.101              # 单次4包
ping -t 192.168.2.101           # 持续ping，Ctrl+C停止
ping -l 1472 -f 192.168.2.101   # MTU不分片测试

# 2. ARP表查看（IP冲突排查）
arp -a                          # 查看IP-MAC对应表，发现同一IP对应多个MAC即冲突

# 3. 端口连通性（Modbus TCP 502端口）
telnet 192.168.2.101 502        # 连接成功=端口开放

# 4. 路由表
route print                     # 查看本机路由，确认无错误默认路由

# 5. 网卡状态
ipconfig /all                   # 查看IP/掩码/网关/MAC

# 6. Linux调试机抓包
sudo tcpdump -i eth0 host 192.168.2.101 and port 502 -nn

# 7. Wireshark过滤器（S7协议）
s7comm                          # S7协议过滤
tcp.port == 102                 # S7 ISO-on-TCP端口
tcp.port == 502                 # Modbus TCP端口
modbus                          # Modbus协议过滤
```

### 8.3 故障排查流程

```
现象：HMI显示某单元通讯中断
  │
  ├─ Step1: 调试机ping该PLC IP
  │    ├─ ping通 → 网络OK，转Step2
  │    └─ ping不通 → 检查网线/交换机端口/PLC IP/供电
  │
  ├─ Step2: STEP 7在线连接该PLC
  │    ├─ 在线成功 → PLC正常，转Step3
  │    └─ 在线失败 → PLC停机/连接数满，检查RUN灯/连接资源
  │
  ├─ Step3: HMI工程检查该单元驱动配置
  │    ├─ 配置正确 → 转Step4
  │    └─ 配置错误 → 修正IP/单元使能
  │
  └─ Step4: Wireshark抓包分析
       ├─ HMI有请求、PLC有响应 → 检查HMI变量绑定
       └─ HMI无请求 → 检查HMI驱动层/单元使能变量
```

---

## 九、网络安全建议

### 9.1 PLC侧安全配置

| # | 安全项 | 配置方法 | 优先级 |
|---|---|---|---|
| 1 | **修改PLC默认密码** | STEP 7-Micro/WIN SMART→系统块→保护→访问权限，设置Level 4密码（非空、非弱口令），密码长度≥8位含数字字母 | **高（必须）** |
| 2 | **关闭PLC Web服务器** | 系统块→Web服务器→取消勾选"启用Web服务器"（S7-200 SMART部分固件支持Web，默认关闭） | **高（必须）** |
| 3 | **禁用PUT/GET（如不使用）** | 系统块→通信→"允许PUT/GET通信访问"按需勾选；S7协议HMI连接不需要PUT/GET，应禁用 | 高 |
| 4 | **限制Modbus TCP连接数** | MBUS_SERVER指令Max Hold/连接数参数按需配置，不超出实际需求 | 中 |
| 5 | **关闭不必要的TCP服务** | 系统块中仅保留PG/PC接口和HMI接口，禁用Open IE多余服务 | 中 |
| 6 | **配置PLC固件为最新稳定版** | 检查西门子官网是否有ST20固件升级包，按需升级 | 中 |

### 9.2 HMI侧安全配置

| # | 安全项 | 配置方法 | 优先级 |
|---|---|---|---|
| 1 | **HMI开机密码** | MCGS组态→用户管理→设置3级权限（操作员/维护/管理员），见HMI用户权限矩阵v1.0 | **高（必须）** |
| 2 | **HMI默认密码修改** | 出厂默认密码（如888888/admin）必须修改为强密码 | **高（必须）** |
| 3 | **HMI禁用USB自动运行** | 防止U盘病毒，仅允许管理员授权U盘导出数据 | 高 |
| 4 | **HMI关闭远程桌面/TELNET** | MCGS Windows CE环境如开放远程桌面，须关闭或限制IP | 中 |
| 5 | **HMI审计日志开启** | 启用操作审计日志，记录L2/L3权限所有操作（见HMI数据量估算2.3节） | 中 |

### 9.3 网络层安全

| # | 安全项 | 配置方法 | 优先级 |
|---|---|---|---|
| 1 | **交换机端口绑定MAC** | 管理型交换机→端口安全→绑定PLC/HMI MAC，防止未授权设备接入 | 高 |
| 2 | **VLAN隔离调试与运行** | 调试口默认VLAN20，按需切换；运行网VLAN10不暴露调试入口 | 高 |
| 3 | **交换机管理密码** | 修改默认admin/admin密码；启用SSH禁用TELNET | **高（必须）** |
| 4 | **不接入办公网/互联网** | 运行网物理隔离，远程维护通过上位机预留口VPN接入 | **高（必须）** |
| 5 | **风暴抑制** | 交换机端口启用广播/组播/未知单播风暴抑制（建议阈值5%） | 中 |
| 6 | **SNMP只读社区字符串修改** | 若启用SNMP监控，修改默认public为强字符串，禁用SNMPv1 | 中 |

### 9.4 物理防护

| # | 防护项 | 要求 | 优先级 |
|---|---|---|---|
| 1 | **控制柜上锁** | 8套PLC控制柜/HMI安装柜上锁，钥匙由维护工程师专人保管 | **高（必须）** |
| 2 | **机柜进出线孔封堵** | 防火泥/护线圈封堵，防尘防鼠防虫 | 高 |
| 3 | **交换机/HMI未用端口盖防尘盖** | 防止灰尘/水汽/异物进入RJ45口 | 中 |
| 4 | **防雷接地** | 机柜PE接地≤4Ω，进线加装浪涌保护器（实验室环境可选） | 中 |
| 5 | **环境监控** | 机柜内加装温湿度计（可选），异常报警 | 低 |
| 6 | **设备标识** | HMI/PLC/交换机贴资产标签+IP标签，便于运维识别 | 中 |

### 9.5 安全审计与变更管理

| # | 审计项 | 频次 | 责任人 |
|---|---|---|---|
| 1 | PLC/HMI/交换机密码定期更换 | 每季度 | 维护工程师 |
| 2 | HMI审计日志U盘导出归档 | 每季度 | 维护工程师（见HMI数据量估算5.2节） |
| 3 | 网络拓扑/IP表变更登记 | 每次变更 | 网络与采购工程师 |
| 4 | PLC程序/组态工程版本管理 | 每次下装 | 维护工程师 |
| 5 | 未授权接入排查（交换机MAC表核对） | 每月 | 维护工程师 |

---

## 十、参考文档与待确认事项

### 10.1 参考文档

| 文档 | 章节 | 用途 |
|---|---|---|
| HMI-PLC变量地址表v1.0 | 第十一章Modbus从站寄存器映射 | Modbus TCP切换时的寄存器映射依据 |
| HMI-PLC变量地址表v1.0 | 第十二章8套PLC网络编址规范 | IP编址原始依据（本规划在此基础细化） |
| 药液配置加注控制系统_PLC设计文档v9.3 | 第十二章多机联网与本地集中HMI架构 | 拓扑/IP/协议选型原则 |
| HMI选型技术问询单与备选方案对比v1.0 | 第二章备选方案对比/2.6 Modbus TCP备选方案 | HMI协议能力确认与备选方案 |
| HMI数据量估算与存储时长测算v1.0 | 第二章数据量分类估算 | 8并发连接的数据量依据 |
| BOM清单v2 | 第5项工业以太网交换机 | 交换机选型基础配置 |
| PLC首次下装与上电调试Checklistv1.0 | 1.1到货验收/1.2调试工具 | MAC记录与调试工具 |
| 设备维护手册v1.0 | 第二章维护周期总表/每日巡检 | 网络设备日常巡检衔接 |

### 10.2 待确认事项

| # | 事项 | 责任方 | 影响 |
|---|---|---|---|
| 1 | 昆仑通态MCGS TPC1211-T12CE的S7驱动是否支持8连接 | HMI供应商 | 决定S7/Modbus TCP方案选择 |
| 2 | HMI实际MAC地址 | 到货登记 | 端口绑定配置 |
| 3 | 8台PLC实际MAC地址 | 到货登记 | 端口绑定配置 |
| 4 | 交换机最终型号（9口非网管/16口管理型） | 采购决策 | VLAN/隔离能力 |
| 5 | 控制柜布置方案（8套独立小柜/1个大柜内8分区） | 现场勘察 | 影响网线长度与交换机数量 |
| 6 | 是否需接入厂区SCADA/远程维护 | 项目方 | 影响VLAN与上位机预留口配置 |
| 7 | HMI IP最终定稿（.100 vs .10） | 网络与采购工程师 | 本规划用.100，与PLC设计文档.10差异需确认 |
| 8 | 子网掩码/网关是否需调整 | 现场网络环境 | 默认255.255.255.0 |

---

**文档版本**: v1.0
**编制日期**: 2026-07-18
**编制人**: 网络与采购工程师
**下次更新触发**: HMI选型确认（AQEX-24回复）、交换机型号定稿、控制柜方案确定、8套扩展阶段调试完成后
