Yustnust/AQUA-EXPO/docs/commissioning/设备维护手册_v1.0.md

# 药液配置加注控制系统 — 设备维护手册 v1.0

**项目**: 药液配置与加注控制系统
**适用范围**: 8套缸单元通用
**用途**: 设备维护工程师的定期维护/故障处理/备件管理依据,保障系统长期稳定运行
**配套文档**: 报警现场处置操作指引v1.0、现场调试SOPv1.0、HMI-PLC变量地址表v1.0、BOM清单

---

## 一、设备概述

### 1.1 系统组成

| 单元 | 设备 | 数量(8套) | 说明 |
|---|---|---|---|
| 控制核心 | S7-200 SMART CPU ST20 | 8台 | 含RTC+超级电容 |
| IO扩展 | EM DT16/DR16 | 8块 | 8DI+8DO |
| 人机界面 | 昆仑通态MCGS 12寸 | 1台 | 集中监控8单元 |
| 执行机构 | 电动球阀A/B/C | 8×3=24台 | 上缸进水/转移/下缸排水 |
| 执行机构 | 潜水泵1/2 | 8×2=16台 | 上缸搅拌 |
| 执行机构 | NC球阀(上/下) | 8×2=16台 | 失效安全保护 |
| 执行机构 | 注射泵 | 8台 | 柱塞式计量泵,加药 |
| 传感器 | 流量开关A/B/C | 8×3=24个 | 开关量流量监测 |
| 传感器 | 液位计A高位/低位 | 8×2=16个 | 上缸液位 |
| 传感器 | 液位计B高位/低位 | 8×2=16个 | 下缸液位 |
| 传感器 | 流量计 | 8台 | 精确计量(Modbus) |
| 安全器件 | 急停按钮 | 8个 | 双通道常闭 |
| 安全器件 | 安全继电器 | 8个 | 强制导向型 |
| 安全器件 | 系统复位按钮 | 8个 | 急停后复位 |

### 1.2 维护原则

1. **预防为主**: 按周期定期检查,防止故障发生
2. **安全优先**: 维护前断电+急停,挂牌操作
3. **记录可追溯**: 每次维护记录时间/内容/人员/结果
4. **备件先行**: 关键备件常备,避免停机等待
5. **分级维护**: 日常(操作员)/周/月/季/年分级

---

## 二、维护周期总表

| 周期 | 维护内容 | 责任人 | 预计耗时 |
|---|---|---|---|
| 每日 | 外观巡检+报警检查+液位确认 | 操作员 | 15分钟 |
| 每周 | 急停/复位/消音功能测试+HMI日志导出 | 操作员 | 30分钟 |
| 每月 | RTC校时+断电保持测试+接线紧固+485稳定性 | 维护工程师 | 2小时 |
| 每季度 | 安全继电器测试+NC阀动作+阀门润滑+密码更换 | 维护工程师 | 4小时 |
| 每半年 | 注射泵校准+流量计校准+PLC除尘+全量备份 | 维护工程师 | 1天 |
| 每年 | 全系统深度维护+传感器校准+电缆检查+文档更新 | 维护工程师 | 2天 |

---

## 三、每日维护

### 3.1 巡检内容

| # | 检查项 | 标准 | 异常处理 | 确认 |
|---|---|---|---|---|
| 1 | PLC RUN灯 | 常绿 | ERR亮→查报警 | □ |
| 2 | EM扩展模块指示灯 | 正常 | 异常→查接线 | □ |
| 3 | HMI通讯状态 | 8单元在线 | 离线→查网络 | □ |
| 4 | 当前报警码VW6 | =0(无报警) | ≠0→查报警指引 | □ |
| 5 | 状态机VW2 | 正常运行态(1~7) | =99→查急停 | □ |
| 6 | 上下缸液位 | 与V1.6/V1.7一致 | 不符→强制修正 | □ |
| 7 | 阀门状态(停机时) | 全关 | 未关→手动关 | □ |
| 8 | 现场无异响/异味/漏水 | 正常 | 异常→停机检查 | □ |
| 9 | 24VDC供电电压 | 22.8~25.2V | 超限→查电源 | □ |
| 10 | 220V动力回路 | 正常 | 跳闸→查负载 | □ |

### 3.2 日常记录

| 日期 | 巡检人 | 报警情况 | 异常处理 | 签字 |
|---|---|---|---|---|
| ___-___ | | | | |
| ___-___ | | | | |

---

## 四、每周维护

### 4.1 功能测试(停机时)

| # | 测试项 | 方法 | 期望 | 实测 | 签字 |
|---|---|---|---|---|---|
| 1 | 急停按钮 | 按下急停 | I1.1=OFF,VW2=99 | ___ | |
| 2 | 急停复位 | 释放+按I0.3 | VW2=0(S0) | ___ | |
| 3 | 系统复位按钮 | 按下I0.3 | V300.4=0 | ___ | |
| 4 | 消音按钮 | 按下I0.4 | Q0.7=0 | ___ | |
| 5 | 报警蜂鸣器 | 强制Q0.7=1 | 蜂鸣器响 | ___ | |
| 6 | 报警指示灯 | 强制Q8.0=1 | 指示灯亮 | ___ | |

### 4.2 数据管理

| # | 操作 | 确认 |
|---|---|---|
| 1 | HMI审计日志U盘导出 | □ |
| 2 | 检查历史数据存储正常 | □ |
| 3 | 检查趋势曲线记录正常 | □ |

---

## 五、每月维护

### 5.1 PLC系统

| # | 维护项 | 方法 | 标准 | 确认 |
|---|---|---|---|---|
| 1 | RTC校时 | HMI画面8→RTC校时(L3) | 误差<60秒 | □ |
| 2 | 断电保持测试 | 断电30秒再上电 | V304.0=1,数据保持 | □ |
| 3 | 扫描周期检查 | STEP 7监控 | <10ms | □ |
| 4 | PLC内存检查 | STEP 7诊断 | 无错误 | □ |

### 5.2 电气系统

| # | 维护项 | 方法 | 标准 | 确认 |
|---|---|---|---|---|
| 1 | 接线端子紧固 | 逐个用螺丝刀紧固 | 无松动 | □ |
| 2 | 24VDC电源电压 | 万用表测量 | 22.8~25.2V | □ |
| 3 | 220V动力回路 | 绝缘电阻测试 | >0.5MΩ | □ |
| 4 | 接地检查 | 万用表测接地电阻 | <4Ω | □ |

### 5.3 通讯系统

| # | 维护项 | 方法 | 标准 | 确认 |
|---|---|---|---|---|
| 1 | 485总线稳定性 | 查V303.4注射泵报警 | 无频繁报警 | □ |
| 2 | 注射泵通讯 | 读VW4状态码 | 0/1/2/3正常 | □ |
| 3 | 流量计通讯 | 读VD86计量值 | 数值合理 | □ |
| 4 | HMI-PLC通讯 | 查HMI画面1 | 8单元在线 | □ |

### 5.4 数据备份

| # | 备份项 | 方式 | 确认 |
|---|---|---|---|
| 1 | HMI历史数据 | U盘导出 | □ |
| 2 | PLC程序 | STEP 7上载+保存 | □ |
| 3 | HMI工程文件 | 导出.mcp | □ |
| 4 | 参数配置 | 画面4导出 | □ |

---

## 六、每季度维护

### 6.1 安全器件

| # | 维护项 | 方法 | 标准 | 确认 |
|---|---|---|---|---|
| 1 | 安全继电器功能测试 | 急停+监测I1.2 | 2秒内反馈 | □ |
| 2 | 继电器故障模拟测试 | 急停+断I1.2 | V300.5=1,码99 | □ |
| 3 | 急停双通道测试 | 分别断两通道 | 均能触发 | □ |
| 4 | NC球阀-上缸动作 | 强制Q0.5=1 | 阀门动作 | □ |
| 5 | NC球阀-下缸动作 | 强制Q0.6=1 | 阀门动作 | □ |
| 6 | NC阀失电安全测试 | 断电 | 阀门关闭 | □ |

### 6.2 机械维护

| # | 维护项 | 方法 | 标准 | 确认 |
|---|---|---|---|---|
| 1 | 阀A/B/C机械润滑 | 加注润滑脂 | 动作顺畅 | □ |
| 2 | 阀门限位开关检查 | 手动开/关到位 | I8.0~I8.5正确 | □ |
| 3 | 潜水泵检查 | 听运转声音 | 无异响 | □ |
| 4 | 管路密封检查 | 目视+手摸 | 无渗漏 | □ |
| 5 | 缸体清洁 | 擦拭内外壁 | 无附着物 | □ |

### 6.3 权限管理

| # | 维护项 | 确认 |
|---|---|---|
| 1 | L2/L3密码更换 | □ |
| 2 | 审计日志审查 | □ |
| 3 | 用户账号清理(离职人员) | □ |

---

## 七、每半年维护

### 7.1 计量设备校准

| # | 设备 | 校准方法 | 校准周期 | 确认 |
|---|---|---|---|---|
| 1 | 注射泵 | 厂家校准或称重法核实步数精度 | 半年 | □ |
| 2 | 流量计 | 厂家校准或标准容器比对 | 半年 | □ |
| 3 | 液位计 | 手动抬/降浮子核实触发点 | 半年 | □ |

### 7.2 PLC深度维护

| # | 维护项 | 方法 | 确认 |
|---|---|---|---|
| 1 | PLC除尘 | 断电+压缩空气吹扫 | □ |
| 2 | PLC散热风扇(如有) | 检查运转 | □ |
| 3 | EM扩展总线连接器 | 重新插拔 | □ |
| 4 | 电池/超级电容检查 | 断电24h测试保持 | □ |

### 7.3 全量备份

| # | 备份项 | 确认 |
|---|---|---|
| 1 | PLC程序全量上载 | □ |
| 2 | HMI工程全量导出 | □ |
| 3 | 历史数据全量导出 | □ |
| 4 | 参数配方导出 | □ |
| 5 | 审计日志导出 | □ |
| 6 | 备份文件异地存储 | □ |

---

## 八、年度维护

### 8.1 全系统深度维护

| # | 维护项 | 标准 | 确认 |
|---|---|---|---|
| 1 | 全部阀门拆检 | 密封完好,动作顺畅 | □ |
| 2 | 潜水泵拆检 | 叶轮无磨损,密封完好 | □ |
| 3 | 缸体检查 | 无裂纹,无渗漏 | □ |
| 4 | 管路检查 | 无堵塞,无老化 | □ |
| 5 | 电缆检查 | 无破损,绝缘合格 | □ |
| 6 | 接线端子全检 | 无氧化,紧固 | □ |
| 7 | PLC固件版本 | 检查更新 | □ |
| 8 | HMI固件版本 | 检查更新 | □ |

### 8.2 传感器校准

| # | 传感器 | 校准方法 | 确认 |
|---|---|---|---|
| 1 | 流量开关A/B/C | 吹气测试触发 | □ |
| 2 | 液位计A/B高/低位 | 浮子触发测试 | □ |
| 3 | 流量计 | 标准容器比对 | □ |

### 8.3 文档更新

| # | 更新项 | 确认 |
|---|---|---|
| 1 | 本维护手册更新(根据年度经验) | □ |
| 2 | 报警处置指引更新 | □ |
| 3 | SOP更新 | □ |
| 4 | 备件清单更新 | □ |

---

## 九、常见故障处理

### 9.1 PLC类故障

| 故障现象 | 可能原因 | 排查步骤 | 处理措施 |
|---|---|---|---|
| PLC ERR灯亮 | 程序错误/硬件故障 | STEP 7诊断 | 查错误码,对应处理 |
| PLC不上电 | 24V电源故障 | 测供电电压 | 检查电源/断路器 |
| 通讯中断 | 网线/IP冲突 | ping测试 | 检查网线/IP配置 |
| 扩展模块无响应 | 总线连接器松动 | 重新插拔 | 更换连接器 |
| RTC不准 | 超级电容失效 | 断电测试 | 更换电容/电池 |
| 断电保持丢失 | 保持区配置错误 | 查系统块 | 重新配置下装 |

### 9.2 阀门类故障

| 故障现象 | 可能原因 | 排查步骤 | 处理措施 |
|---|---|---|---|
| 阀门不动作 | 继电器故障/机械卡滞 | 测DO输出/手动操作 | 更换继电器/润滑 |
| 阀门关不严 | 密封损坏/异物 | 拆检 | 更换密封/清理 |
| 限位无反馈 | 限位开关故障/接线 | 万用表测 | 更换限位/修复接线 |
| 阀门动作慢 | 机械润滑不足/电压低 | 加润滑脂/测电压 | 润滑/查电源 |

### 9.3 泵类故障

| 故障现象 | 可能原因 | 排查步骤 | 处理措施 |
|---|---|---|---|
| 潜水泵不启动 | 继电器/电源/泵故障 | 测DO/测电压/听声音 | 更换继电器/泵 |
| 泵启动无流 | 管路堵塞/泵损坏 | 检查管路/拆泵 | 清理/更换 |
| 注射泵通讯失败 | 485接线/站号 | 查接线/站号 | 修复/重配 |
| 注射泵动作异常 | 状态码报错 | 查VW4状态码 | 按泵手册处理 |

### 9.4 传感器故障

| 故障现象 | 可能原因 | 排查步骤 | 处理措施 |
|---|---|---|---|
| 流量开关无信号 | 接线/开关故障 | 万用表测通断 | 修复接线/更换 |
| 液位计误动作 | 浮子卡滞/接线 | 手动操作浮子 | 清理/更换 |
| 流量计读数异常 | 通讯/校准 | 查VD86/校准 | 修复通讯/校准 |

### 9.5 HMI类故障

| 故障现象 | 可能原因 | 排查步骤 | 处理措施 |
|---|---|---|---|
| HMI黑屏 | 电源/背光 | 测供电 | 更换电源/返修 |
| HMI通讯中断 | 网络/PLC | ping PLC | 检查网络/PLC |
| 画面卡顿 | 内存/工程 | 重启HMI | 优化工程/返修 |
| 触摸不准 | 触摸屏校准 | HMI校准 | 重新校准/返修 |

---

## 十、备件清单

### 10.1 关键备件(必常备)

| # | 备件名称 | 规格 | 建议库存 | 更换周期 | 说明 |
|---|---|---|---|---|---|
| 1 | S7-200 SMART CPU ST20 | 标准型 | 1台 | — | PLC主机 |
| 2 | EM DT16/DR16扩展 | 8DI+8DO | 1块 | — | IO扩展 |
| 3 | 安全继电器 | 强制导向型220V | 2个 | 5年 | 急停回路 |
| 4 | 中间继电器 | 24V线圈 | 10个 | 3年 | DO转换/限位隔离 |
| 5 | 电动球阀A/B/C | DN25(核实) | 各1台 | 5年 | 阀门 |
| 6 | NC球阀(上/下) | DN15(核实) | 各2个 | 3年 | 失效安全保护 |
| 7 | 潜水泵1/2 | 24V/核实流量 | 各1台 | 2年 | 搅拌泵 |
| 8 | 急停按钮 | 双通道常闭 | 2个 | 3年 | 安全器件 |
| 9 | 系统复位按钮 | 常开点动 | 2个 | 3年 | 复位 |
| 10 | 消音按钮 | 常开点动 | 2个 | 3年 | 消音 |

### 10.2 易损备件

| # | 备件名称 | 规格 | 建议库存 | 更换周期 |
|---|---|---|---|---|
| 1 | 流量开关A/B/C | 常开 | 各2个 | 2年 |
| 2 | 液位计A/B高/低位 | 常开浮子 | 各2个 | 3年 |
| 3 | 注射泵 | SY11全陶瓷 | 1台 | 3年(或按厂家) |
| 4 | 流量计 | 微小流量485 | 1台 | 3年 |
| 5 | 24VDC开关电源 | 50W | 1台 | 5年 |
| 6 | 断路器(24V/220V) | 核实规格 | 各2个 | 5年 |

### 10.3 消耗品

| # | 名称 | 规格 | 建议库存 |
|---|---|---|---|
| 1 | 润滑脂 | 阀门用 | 1罐 |
| 2 | 线号标签 | 多规格 | 1套 |
| 3 | 接线端子 | 核实规格 | 1套 |
| 4 | 网线 | CAT6 | 5根 |
| 5 | 485通讯线 | 屏蔽双绞 | 10米 |
| 6 | U盘 | 16GB | 2个 |

---

## 十一、维护记录表

### 11.1 月度维护记录

| 月份 | 维护日期 | 维护人 | 维护内容 | 发现问题 | 处理结果 | 签字 |
|---|---|---|---|---|---|---|
| 1月 | | | | | | |
| 2月 | | | | | | |
| 3月 | | | | | | |
| 4月 | | | | | | |
| 5月 | | | | | | |
| 6月 | | | | | | |
| 7月 | | | | | | |
| 8月 | | | | | | |
| 9月 | | | | | | |
| 10月 | | | | | | |
| 11月 | | | | | | |
| 12月 | | | | | | |

### 11.2 备件更换记录

| 日期 | 单元号 | 更换备件 | 更换原因 | 更换人 | 签字 |
|---|---|---|---|---|---|
| | | | | | |
| | | | | | |

---

## 十二、维护安全规程

### 12.1 维护前安全确认

| # | 安全项 | 确认 |
|---|---|---|
| 1 | 通知相关人员维护时间 | □ |
| 2 | 急停按钮按下(切动力电) | □ |
| 3 | 挂"维护中,禁止合闸"警示牌 | □ |
| 4 | 测量确认无电后操作 | □ |
| 5 | 穿戴PPE(绝缘鞋/护目镜) | □ |

### 12.2 维护后恢复

| # | 恢复项 | 确认 |
|---|---|---|
| 1 | 接线恢复并紧固 | □ |
| 2 | 警示牌拆除 | □ |
| 3 | 急停释放 | □ |
| 4 | 系统复位 | □ |
| 5 | 功能测试通过 | □ |
| 6 | 通知相关人员恢复运行 | □ |

### 12.3 特殊作业安全

| 作业 | 安全要求 |
|---|---|
| 电气作业 | 断电+验电+挂牌+两人作业 |
| 高处作业 | 系安全带(如需登高) |
| 有限空间 | 上下缸内作业需通风+监护 |
| 带电作业 | 仅24VDC可带电,220V必须断电 |

---

## 附录A:维护工具清单

| # | 工具 | 用途 |
|---|---|---|
| 1 | 万用表 | 电压/通断测量 |
| 2 | 绝缘电阻表 | 绝缘测试 |
| 3 | 十字/一字螺丝刀 | 接线端子 |
| 4 | 内六角扳手套装 | 阀门/泵拆装 |
| 5 | 活动扳手 | 管路拆装 |
| 6 | 压线钳 | 端子压接 |
| 7 | 热风枪 | 热缩管 |
| 8 | 手电筒 | 柜内照明 |
| 9 | 对讲机 | 通讯 |
| 10 | 笔记本电脑+STEP 7 | PLC诊断 |
| 11 | U盘 | 数据导出 |
| 12 | 润滑脂 | 阀门润滑 |

---

## 附录B:紧急联系方式

| 角色 | 姓名 | 电话 | 说明 |
|---|---|---|---|
| 维护工程师(白班) | | | 日常维护 |
| 维护工程师(夜班) | | | 紧急维修 |
| 项目经理 | | | 重大故障 |
| PLC技术支持 | | | PLC疑难 |
| HMI技术支持 | | | HMI疑难 |
| 阀门厂家 | | | 阀门故障 |
| 泵厂家 | | | 泵故障 |
| 注射泵厂家(润泽) | | | 注射泵故障 |
| 流量计厂家 | | | 流量计故障 |

---

**文档版本**: v1.0
**创建日期**: 2026-07-15
**说明**: 本手册为设备维护工程师的完整维护指南,按周期执行并记录。年度维护后根据实际经验更新本手册。
