Yustnust/AQUA-EXPO/docs/commissioning/首期1套验收交付包_v1.0.md

# 药液配置加注控制系统 — 首期1套验收交付包 v1.0

**项目**: 药液配置与加注控制系统
**适用范围**: 首期1套单元(1号单元,192.168.2.101)
**用途**: 整合调试checklist+SAT测试用例+签字页+交付清单为完整交付包,首期1套到货即用
**配套文档**: PLC首次下装与上电调试Checklist、SAT_FAT验收测试用例、IO现场接线核对表、现场调试SOP

---

## 一、交付包概述

### 1.1 交付包结构

```
首期1套验收交付包
├── 第一部分: 交付清单(本文档第一章)
├── 第二部分: 调试流程执行记录(本文档第二章,引用Checklist)
├── 第三部分: SAT验收测试记录(本文档第三章,引用SAT用例)
├── 第四部分: 问题记录与处理(本文档第四章)
├── 第五部分: 交付签字确认(本文档第五章)
└── 附录: 相关文档引用
```

### 1.2 交付目标

| 项 | 目标 | 验收标准 |
|---|---|---|
| PLC程序 | 正常运行 | VW2状态机正常流转,VW6=0无报警 |
| IO系统 | 全部合格 | 20DI+9DO+485逐点打点100%通过 |
| 功能测试 | 101用例通过 | SAT必测用例101个全部通过 |
| 稳定性 | 连续运行24h | 无异常报警,无重启 |
| 文档 | 完整交付 | 本交付包签字确认 |

---

## 二、调试流程执行记录

### 2.1 调试进度跟踪

| 天数 | 阶段 | 计划完成项 | 实际完成 | 偏差 | 签字 |
|---|---|---|---|---|---|
| 第1天 | 硬件安装+下装 | 到货验收→安装→接线→下装 | □完成 □部分 | ___ | |
| 第2天 | IO打点 | 20DI+9DO+485逐点 | □完成 □部分 | ___ | |
| 第3天 | 单机功能 | 急停/报警/Modbus/断电恢复 | □完成 □部分 | ___ | |
| 第4天 | 联动调试 | S1~S6完整流程+阀门诊断 | □完成 □部分 | ___ | |
| 第5天 | SAT验收 | 101用例执行+签字 | □完成 □部分 | ___ | |

### 2.2 关键节点确认(引用调试Checklist)

**执行文档**: 《PLC首次下装与上电调试Checklist_v1.0》

#### 2.2.1 到货验收(第1天上午)

| # | 检查项 | 结果 | 签字 |
|---|---|---|---|
| 1 | PLC型号核对(CPU ST20+EM DT16) | □合格 □不合格 | |
| 2 | PLC外观/封条/配件 | □合格 □不合格 | |
| 3 | MAC地址记录 | MAC:___________ | |
| 4 | 序列号记录 | SN:___________ | |

#### 2.2.2 上电前安全确认(第1天,关键)

| # | 安全确认项 | 确认人签字 |
|---|---|---|
| 1 | 220V动力回路断路器OFF | _________ |
| 2 | 所有阀门手动关闭 | _________ |
| 3 | 上下缸无液体(空缸) | _________ |
| 4 | 急停按钮已按下(触发状态) | _________ |
| 5 | 现场无关人员撤离 | _________ |

#### 2.2.3 程序下装(第1天下午)

| # | 步骤 | 结果 | 签字 |
|---|---|---|---|
| 1 | IP配置(192.168.2.101) | □ | |
| 2 | 断电保持区配置(VB0~VB599+DT10) | □ | |
| 3 | 程序编译(0 error) | 编译结果:___ | |
| 4 | 程序下装(OB1+FC0~FC40) | □ | |
| 5 | PLC切换RUN | □ | |
| 6 | RTC校时 | □ | |

#### 2.2.4 IO打点(第2天)

**执行文档**: 《IO现场接线核对表_v1.0》

| 类型 | 总点数 | 合格 | 不合格 | 合格率 | 签字 |
|---|---|---|---|---|---|
| DI | 19 | ___ | ___ | ___% | |
| DO | 9 | ___ | ___ | ___% | |
| 485 | 2从站 | ___ | ___ | ___% | |
| **合计** | **30** | ___ | ___ | ___% | |

**⚠️ 30点全部100%合格后方可进入单机调试。**

---

## 三、SAT验收测试记录

### 3.1 测试执行总览

**执行文档**: 《SAT_FAT验收测试用例_v1.0》

| # | 测试组 | 用例数 | 通过 | 失败 | 阻塞 | 通过率 | 签字 |
|---|---|---|---|---|---|---|---|
| 1 | DI/DO测试 | 28 | ___ | ___ | ___ | ___% | |
| 2 | Story1.2状态机 | 12 | ___ | ___ | ___ | ___% | |
| 3 | Story1.3阀门诊断 | 15 | ___ | ___ | ___ | ___% | |
| 4 | Story1.4节奏纠偏 | 10 | ___ | ___ | ___ | ___% | |
| 5 | Story1.5急停 | 8 | ___ | ___ | ___ | ___% | |
| 6 | Story1.6报警 | 12 | ___ | ___ | ___ | ___% | |
| 7 | Story1.7断电恢复 | 8 | ___ | ___ | ___ | ___% | |
| 8 | Modbus通讯 | 6 | ___ | ___ | ___ | ___% | |
| 9 | 长时稳定性 | 2 | ___ | ___ | ___ | ___% | |
| **合计** | **9组** | **101** | ___ | ___ | ___ | ___% | |

### 3.2 关键测试项记录

#### 3.2.1 状态机完整流程(Story1.2核心)

| 测试项 | 期望 | 实测 | 通过 | 签字 |
|---|---|---|---|---|
| S0→S1启动 | V0.0置位后VW2=1 | ___ | □ | |
| S1进水完成 | VD90≥设定,阀A关,VW2=2 | ___ | □ | |
| S2预循环 | VD_S2_Target计时完成,VW2=3 | ___ | □ | |
| S3加药 | 注射泵抽排完成,VW2=4 | ___ | □ | |
| S3.5静置 | VD_RestTime_Target完成,VW2=5 | ___ | □ | |
| S4转移 | 阀B四态诊断正常,VW2=6 | ___ | □ | |
| S5运行 | VD_S5_Elapsed累加,达周期VW2=7 | ___ | □ | |
| S6排水 | 阀C四态诊断正常,VW2=5(新一轮) | ___ | □ | |
| S7结束 | VD96≥VD24,VW2=8 | ___ | □ | |
| 第二轮触发 | S5上升沿触发新S1 | ___ | □ | |

#### 3.2.2 急停与安全(Story1.5核心)

| 测试项 | 期望 | 实测 | 通过 | 签字 |
|---|---|---|---|---|
| 急停触发 | I1.1=OFF,VW2=99,V300.4=1 | ___ | □ | |
| 急停输出安全 | QB0=0,Q0.7=1 | ___ | □ | |
| 安全继电器反馈 | I1.2在2秒内到位 | ___ | □ | |
| 继电器故障模拟 | 急停+断I1.2→V300.5=1,码99 | ___ | □ | |
| 急停复位 | 释放+I0.3→V300.4=0,VW2=0 | ___ | □ | |
| 继电器高权限确认 | V0.7+I1.2→V300.5=0 | ___ | □ | |

#### 3.2.3 断电恢复(Story1.7核心)

| 测试项 | 期望 | 实测 | 通过 | 签字 |
|---|---|---|---|---|
| 冷启动 | V304.0=0,VW2=0(S0) | ___ | □ | |
| S5断电恢复 | V304.0=1,VD_S5_Elapsed重算 | ___ | □ | |
| S1断电恢复 | VW2=99(S_ERROR) | ___ | □ | |
| RTC丢失模拟 | RTC<DT10→V303.5=1 | ___ | □ | |

### 3.3 长时稳定性测试

| 测试项 | 时长 | 期望 | 实测 | 通过 | 签字 |
|---|---|---|---|---|---|
| 连续运行 | 24小时 | 无异常报警,无重启 | ___ | □ | |
| 多轮次运行 | ≥3轮换水 | VW8递增,无卡死 | ___ | □ | |

---

## 四、问题记录与处理

### 4.1 调试过程问题

| # | 问题描述 | 发生阶段 | 严重度 | 处理措施 | 处理人 | 复验结果 | 签字 |
|---|---|---|---|---|---|---|---|
| 1 | | | □高□中□低 | | | □通过□未通过 | |
| 2 | | | □高□中□低 | | | □通过□未通过 | |
| 3 | | | □高□中□低 | | | □通过□未通过 | |
| 4 | | | □高□中□低 | | | □通过□未通过 | |
| 5 | | | □高□中□低 | | | □通过□未通过 | |

### 4.2 遗留问题(如有)

| # | 问题描述 | 严重度 | 处理计划 | 责任人 | 完成期限 |
|---|---|---|---|---|---|
| 1 | | □高□中□低 | | | |
| 2 | | □高□中□低 | | | |

**⚠️ 高严重度遗留问题不得验收通过,必须处理完毕。**

---

## 五、交付签字确认

### 5.1 交付物清单确认

| 交付物 | 数量 | 确认 | 签字 |
|---|---|---|---|
| PLC程序(20个STL) | 20 | □已交付 | |
| PLC规格书(7份) | 7 | □已交付 | |
| 核心设计文档(3份) | 3 | □已交付 | |
| 变量地址表 | 1 | □已交付 | |
| HMI准备材料(11份) | 11 | □已交付 | |
| 调试准备文档(3份) | 3 | □已交付 | |
| SAT验收测试用例 | 1 | □已交付 | |
| PLC代码校验报告 | 1 | □已交付 | |
| 项目交付文档总索引 | 1 | □已交付 | |
| 设备维护手册 | 1 | □已交付 | |

### 5.2 验收结论

| 验收项 | 结论 | 签字 |
|---|---|---|
| IO系统(30点) | □合格 □不合格(合格率___%) | |
| SAT测试(101用例) | □通过 □部分通过(通过率___%) | |
| 稳定性(24h) | □通过 □未通过 | |
| 文档完整性 | □完整 □不完整 | |
| **综合验收结论** | □**验收通过** □**附条件通过** □**验收不通过** | |

### 5.3 各方签字

| 角色 | 姓名 | 签字 | 日期 |
|---|---|---|---|
| 调试工程师 | | | 2026-___-___ |
| 设备维护工程师 | | | 2026-___-___ |
| HMI组态工程师 | | | 2026-___-___ |
| 项目经理 | | | 2026-___-___ |
| 客户代表 | | | 2026-___-___ |
| 监理(如有) | | | 2026-___-___ |

---

## 六、附条件通过说明(如适用)

若验收结论为"附条件通过",需明确:

| # | 附条件项 | 完成期限 | 责任人 | 验收方式 |
|---|---|---|---|---|
| 1 | | | | |
| 2 | | | | |

**附条件项全部完成后,转为"验收通过"。**

---

## 七、后续扩展说明

### 7.1 首期1套→8套扩展

| 项 | 首期1套 | 后续7套 | 说明 |
|---|---|---|---|
| PLC程序 | 相同 | 相同 | 8套程序完全相同 |
| IP地址 | 192.168.2.101 | .102~.108 | 仅IP不同 |
| 调试流程 | 5天 | 每套2~3天 | 复用Checklist,无下装环节 |
| HMI组态 | 仅1号使能 | 增加使能 | 画面8勾选新单元 |
| 验收 | 本交付包 | 复用SAT用例 | 每套独立验收 |

### 7.2 后续7套调试计划

| 单元 | 计划日期 | 负责人 | 验收状态 |
|---|---|---|---|
| 2号 | 2026-___-___ | | □待调试 □进行中 □完成 |
| 3号 | 2026-___-___ | | □待调试 □进行中 □完成 |
| 4号 | 2026-___-___ | | □待调试 □进行中 □完成 |
| 5号 | 2026-___-___ | | □待调试 □进行中 □完成 |
| 6号 | 2026-___-___ | | □待调试 □进行中 □完成 |
| 7号 | 2026-___-___ | | □待调试 □进行中 □完成 |
| 8号 | 2026-___-___ | | □待调试 □进行中 □完成 |

---

## 附录:相关文档引用

| 文档 | 位置 | 用途 |
|---|---|---|
| PLC首次下装与上电调试Checklist | docs/commissioning/ | 调试流程执行 |
| IO现场接线核对表 | docs/commissioning/ | IO打点记录 |
| 现场调试SOP | docs/commissioning/ | 操作规范 |
| SAT_FAT验收测试用例 | docs/ | 测试用例执行 |
| PLC代码完整性校验报告 | docs/ | 代码质量追溯 |
| 项目交付文档总索引 | docs/ | 文档查阅入口 |
| 设备维护手册 | docs/ | 运维参考 |

---

**文档版本**: v1.0
**创建日期**: 2026-07-15
**说明**: 本交付包为首期1套验收完整记录,调试工程师逐项执行并签字。验收通过后归档,作为项目交付凭证。
