Yustnust/AQUA-EXPO/docs/commissioning/PLC首次下装与上电调试Checklist_v1.0.md

# 药液配置加注控制系统 — PLC首次下装与上电调试Checklist v1.3

**项目**: 药液配置加注控制系统
**适用范围**: 首期1套单元(后续7套复用本流程)
**用途**: PLC从到货验收到联动调试完成的完整流程,含每步安全确认点。现场调试工程师按本checklist逐项执行并打勾签字。
**配套文档**: PLC设计文档v9.3、HMI-PLC变量地址表v1.0、SAT_FAT验收测试用例v1.1、Story1.2 状态机骨架规格书v1.1

---

## 一、调试前准备(到货当日)

### 1.1 到货验收

| # | 检查项 | 标准 | 结果 | 签字 |
|---|---|---|---|---|
| 1 | PLC主机型号核对 | CPU ST20 + EM DT16/DR16扩展 | □合格 □不合格 | |
| 2 | PLC外观检查 | 无破损、无受潮、接口无变形 | □合格 □不合格 | |
| 3 | PLC封条完整性 | 原厂封条完好 | □合格 □不合格 | |
| 4 | 配件齐全 | 编程电缆、说明手册、合格证 | □合格 □不合格 | |
| 5 | MAC地址记录 | 记录MAC用于IP规划(192.168.2.101) | MAC:___________ | |
| 6 | 序列号记录 | 记录SN用于质保登记 | SN:___________ | |

### 1.2 调试工具准备

| # | 工具 | 用途 | 确认 |
|---|---|---|---|
| 1 | 笔记本电脑 | STEP 7-Micro/WIN SMART编程 | □ |
| 2 | 网线 | PC↔PLC以太网连接 | □ |
| 3 | USB转RS485 | Modbus从站调试 | □ |
| 4 | 万用表 | 电压/通断测量 | □ |
| 5 | 编程电缆 | PLC本体RS485口调试 | □ |
| 6 | 十字螺丝刀 | 接线端子操作 | □ |
| 7 | 小一字螺丝刀 | 继电器接线 | □ |
| 8 | 标签机 | 线号标识 | □ |
| 9 | 对讲机 | 调试通讯(HMI处与PLC处) | □ |

### 1.3 安全准备

| # | 安全项 | 确认 |
|---|---|---|
| 1 | 急停按钮已安装且功能正常 | □ |
| 2 | 系统复位按钮已安装 | □ |
| 3 | 220V动力回路断路器处于OFF | □ |
| 4 | 24VDC控制回路断路器处于OFF | □ |
| 5 | 现场清理无杂物,设备周围1米净空 | □ |
| 6 | 灭火器就位 | □ |
| 7 | 调试人员PPE(绝缘鞋/护目镜)穿戴 | □ |

---

## 二、硬件安装与接线检查(第1天上午)

### 2.1 PLC安装

| # | 检查项 | 标准 | 结果 | 签字 |
|---|---|---|---|---|
| 1 | PLC导轨安装 | DIN35导轨,水平安装,散热空间≥50mm | □ | |
| 2 | EM扩展模块安装 | 卡扣到位,总线连接器插入 | □ | |
| 3 | 接地连接 | PE接地≤4Ω,接地线≥2.5mm² | □ | |
| 4 | 电源接线 | 24VDC供电(L+/M),极性正确 | □ | |
| 5 | 以太网口接线 | RJ45网线连接至交换机 | □ | |
| 6 | RS485口接线 | Port0接注射泵+流量计485总线 | □ | |

### 2.2 DI接线检查(20点,详见IO核对表)

| # | 检查项 | 标准 | 结果 |
|---|---|---|---|
| 1 | I0.0~I0.3 共19点接线 | 按变量表地址表逐点核对 | □ |
| 2 | 公共端1M/2M接线 | 1M接0V(SRC型)/24V(SINK型)按实际 | □ |
| 3 | **v1.3** 急停 I1.1 接 NO 触点 | 急停按钮 NO 动端 → I1.1,NC 动端 → MSR-P 通道 | □ |
| 4 | 安全继电器反馈I1.2接线 | 强制导向触点接入 | □ |
| 5 | 阀门限位反馈I8.0~I8.5接线 | 经中间继电器转换(有源信号) | □ |

### 2.3 DO接线检查(9点,详见IO核对表)

| # | 检查项 | 标准 | 结果 |
|---|---|---|---|
| 1 | Q0.0~Q8.0 共9点接线 | 全部经继电器转换,不直驱负载 | □ |
| 2 | 公共端1L+/2L+接线 | 接24VDC正极 | □ |
| 3 | 继电器线圈接线 | 线圈接DO,触点接负载电源 | □ |
| 4 | 安全继电器接线 | 强制导向型,220V线圈规格 | □ |

### 2.4 ⚠️ 上电前安全确认(关键)

| # | 安全确认项 | 确认人签字 |
|---|---|---|
| 1 | **220V动力回路断路器处于OFF** | _________ |
| 2 | **所有阀门手动处于关闭状态** | _________ |
| 3 | **上下缸无液体(空缸)** | _________ |
| 4 | **急停按钮已按下(触发状态)** | _________ |
| 5 | **现场无关人员撤离** | _________ |

**⚠️ 以上5项全部签字确认后,方可进入下一步上电。**

---

## 三、PLC下装与基础通信(第1天下午)

### 3.1 PLC上电

| # | 步骤 | 标准 | 结果 | 签字 |
|---|---|---|---|---|
| 1 | 24VDC控制回路断路器ON | PLC RUN指示灯亮(绿色) | □ | |
| 2 | PLC ERR指示灯 | 应熄灭(无故障) | □ | |
| 3 | PLC本体与EM扩展通讯 | EM模块指示灯正常 | □ | |
| 4 | 量测PLC供电电压 | 24VDC±5%(22.8~25.2V) | 实测:___V | |

### 3.2 PC连接与IP配置

| # | 步骤 | 标准 | 结果 | 签字 |
|---|---|---|---|---|
| 1 | PC网线连接PLC以太网口 | PC IP设为192.168.2.x(x≠101~108) | □ | |
| 2 | ping 192.168.2.101 | 默认IP,需修改为本单元IP | ping结果:___ | |
| 3 | STEP 7-Micro/WIN SMART连接 | 通信→设置PG/PC→TCP/IP→连接 | □ | |
| 4 | 修改PLC IP | 192.168.2.101(1号单元) | □ | |
| 5 | 系统块下装 | 含IP/断电保持配置 | □ | |
| 6 | PLC断电重启 | IP生效,ping 192.168.2.101通 | □ | |

### 3.3 断电保持区配置(关键)

| # | 配置项 | 地址范围 | 确认 |
|---|---|---|---|
| 1 | V区断电保持范围1 | VB0~VB199(系统命令/状态/参数) | □ |
| 2 | V区断电保持范围2 | VB200~VB399(报警字/纠偏/断电恢复) | □ |
| 3 | V区断电保持范围3 | VB400~VB599(日志缓冲) | □ |
| 4 | DT区断电保持 | DT10(下缸满时间戳) | □ |
| 5 | 系统块下装 | 上述配置写入PLC | □ |

### 3.4 程序下装

| # | 步骤 | 标准 | 结果 | 签字 |
|---|---|---|---|---|
| 1 | 打开PLC主程序工程 | AQUA-EXPO/plc/下全部.stl文件 | □ | |
| 2 | 编译程序 | 0 error, 0 warning | 编译结果:___ | |
| 3 | 程序下装(全部块) | OB1+FC0~FC40下装成功 | □ | |
| 4 | PLC切换至RUN模式 | RUN灯亮,STOP灯灭 | □ | |
| 5 | 查看PLC信息 | 无错误,扫描周期<10ms | 扫描周期:___ms | |

### 3.5 RTC校时

| # | 步骤 | 标准 | 结果 | 签字 |
|---|---|---|---|---|
| 1 | 读取PLC RTC时间 | 确认RTC工作 | 当前RTC:___ | |
| 2 | 设置PLC RTC时间 | 同步PC当前时间(秒级) | □ | |
| 3 | 验证RTC写入 | 重新读取确认 | □ | |

---

## 四、IO打点测试(第2天)

### 4.1 DI打点测试(逐点)

**测试方法**: 现场触发每个DI信号源,在PLC状态表/变量表监控对应I点状态。

| # | 地址 | 信号源 | 触发方式 | 期望 | 实测 | 签字 |
|---|---|---|---|---|---|---|
| 1 | I0.0 | 流量开关A | 吹气/水流动 | ON | ___ | |
| 2 | I0.1 | 流量开关B | 同上 | ON | ___ | |
| 3 | I0.2 | 流量开关C | 同上 | ON | ___ | |
| 4 | I0.5 | 液位计A高位 | 手动抬浮子 | ON | ___ | |
| 5 | I0.6 | 液位计A低位 | 同上 | ON | ___ | |
| 6 | I0.7 | 液位计B高位 | 同上 | ON | ___ | |
| 7 | I1.0 | 液位计B低位 | 同上 | ON | ___ | |
| 8 | I1.1 | 急停反馈(NO) | 释放急停 | **OFF(v1.3 NO 释放=OFF)** | ___ |
| 9 | I1.2 | 安全继电器反馈 | 继电器吸合 | ON | ___ | |
| 10 | I8.0 | 阀A开到位 | 手动开阀到位 | ON | ___ | |
| 11 | I8.1 | 阀A关到位 | 手动关阀到位 | ON | ___ | |
| 12 | I8.2 | 阀B开到位 | 手动开阀到位 | ON | ___ | |
| 13 | I8.3 | 阀B关到位 | 手动关阀到位 | ON | ___ | |
| 14 | I8.4 | 阀C开到位 | 手动开阀到位 | ON | ___ | |
| 15 | I8.5 | 阀C关到位 | 手动关阀到位 | ON | ___ | |
| 16 | I0.4 | 消音按钮 | 按下 | ON(点动) | ___ | |
| 17 | I0.3 | 系统复位按钮 | 按下 | ON(点动) | ___ | |

### 4.2 DO打点测试(逐点)

**测试方法**: PLC强制Q点ON,现场确认对应继电器吸合+负载动作。

| # | 地址 | 负载 | 强制ON后 | 实测 | 签字 |
|---|---|---|---|---|---|
| 1 | Q0.0 | 潜水泵1 | 继电器吸合,泵1运行 | ___ | |
| 2 | Q0.1 | 潜水泵2 | 继电器吸合,泵2运行 | ___ | |
| 3 | Q0.2 | 阀A | 继电器吸合,阀A开启 | ___ | |
| 4 | Q0.3 | 阀B | 继电器吸合,阀B开启 | ___ | |
| 5 | Q0.4 | 阀C | 继电器吸合,阀C开启 | ___ | |
| 6 | Q0.5 | NC阀-上缸 | 继电器吸合,NC阀得电 | ___ | |
| 7 | Q0.6 | NC阀-下缸 | 继电器吸合,NC阀得电 | ___ | |
| 8 | Q0.7 | 报警声音 | 蜂鸣器响 | ___ | |
| 9 | Q8.0 | 报警灯光 | 指示灯亮 | ___ | |

### 4.3 ⚠️ DO打点安全确认

| # | 安全确认项 | 确认人签字 |
|---|---|---|
| 1 | **220V动力回路断路器保持OFF(仅测试继电器吸合)** | _________ |
| 2 | **上下缸无液体(NC阀测试不会泄漏)** | _________ |
| 3 | **阀A手动阀关闭(进水阀即使开启也不会进水)** | _________ |

---

## 五、单机功能调试(第3天)

### 5.1 急停功能测试

| # | 测试项 | 步骤 | 期望 | 实测 | 签字 |
|---|---|---|---|---|---|
| 1 | 急停触发(NO 闭合) | 按下急停 | **I1.1=ON**(v1.3 NO 触发),VW2=99,V300.4=1 | ___ |
| 2 | 急停输出安全 | 同上 | QB0=0(全关),Q0.7=1(报警声) | ___ | |
| 3 | 安全继电器动作 | 同上 | I1.2反馈到位(2秒内) | ___ | |
| 4 | 急停释放 | 旋转释放 | I1.1=ON,V300.4保持(锁存) | ___ | |
| 5 | 系统复位 | 按I0.3复位 | V300.4=0,VW2=0(回S0) | ___ | |
| 6 | 继电器故障模拟 | 急停+断开I1.2 | 2秒后V300.5=1,报警码99 | ___ | |

### 5.1.5 MSR-P 手动复位 S2 按钮测试(v1.3 新增)

| # | 测试项 | 操作 | 期望 | 实测 | 签字 |
|---|---|---|---|---|---|
| 1 | MSR-P 锁存保持 | 急停按下后释放急停 | K3/K4 主触点保持断开(MSR-P 手动复位模式下不解锁) | ___ | |
| 2 | S2 复位按钮解锁 | 按 S2(MSR-P 复位) | K3/K4 主触点重新吸合(可听声音/万用表测通) | ___ | |
| 3 | 通道间短路检测 | 短接 MSR-P S11-S12(模拟 NC 触点熔焊) | MSR-P 报故障,主触点保持断开 | ___ | |
| 4 | NC 单独断线检测 | 断开 NC 触点 1 根线 | MSR-P 报故障(通道 1 输入异常) | ___ | |

**注**:S2 复位按钮是 MSR-P 硬件自带的,与 PLC I0.3 系统复位按钮**串联使用**——必须先按 S2 解除 MSR-P 锁存,再按 I0.3 解除 PLC 锁存。

### 5.2 报警功能测试

| # | 测试项 | 步骤 | 期望 | 实测 | 签字 |
|---|---|---|---|---|---|
| 1 | 漫溢报警 | 触发I0.5(液位A高) | V300.0=1,VW6=10 | ___ | |
| 2 | 消音功能 | 按I0.4 | Q0.7=0,V1.4=1 | ___ | |
| 3 | 报警确认 | V0.3置位 | V1.3=1,灯光条件消失后灭 | ___ | |
| 4 | 自动恢复模式 | V200.0=0,条件消失 | 报警位自动复位 | ___ | |
| 5 | 人工确认模式 | V200.0=1 | 需V0.3确认才复位 | ___ | |

### 5.3 Modbus通讯测试

| # | 测试项 | 步骤 | 期望 | 实测 | 签字 |
|---|---|---|---|---|---|
| 1 | 注射泵通讯 | 查VW4状态码 | 0(空闲)或1(运行) | ___ | |
| 2 | 注射泵动作 | 写VW204抽液步数 | 泵执行,VW4变2→0 | ___ | |
| 3 | 流量计通讯 | 查VD86当前计量值 | 数值合理且增长 | ___ | |
| 4 | 通讯超时 | 断开485 | V303.4=1(注射泵报警) | ___ | |

### 5.4 断电恢复测试

| # | 测试项 | 步骤 | 期望 | 实测 | 签字 |
|---|---|---|---|---|---|
| 1 | 冷启动 | PLC首次上电 | V304.0=0,VW2=0(S0) | ___ | |
| 2 | 断电恢复 | 运行中断电再上电 | V304.0=1,按状态恢复 | ___ | |
| 3 | S5断电恢复 | S5运行中断电 | VD_S5_Elapsed重算 | ___ | |
| 4 | S1断电恢复 | S1运行中断电 | VW2=99(S_ERROR) | ___ | |
| 5 | RTC丢失模拟 | 改RTC早于DT10 | V303.5=1,转S_ERROR | ___ | |

---

## 六、联动调试(第4天)

### 6.1 ⚠️ 联动前安全确认

| # | 安全确认项 | 确认人签字 |
|---|---|---|
| 1 | **上下缸已清洁,可进水** | _________ |
| 2 | **上游纯净水供应正常** | _________ |
| 3 | **下水道排水通畅** | _________ |
| 4 | **现场配备吸水拖把/毛巾** | _________ |
| 5 | **220V动力回路断路器ON(泵阀需动力)** | _________ |
| 6 | **急停按钮可触及,操作员就位** | _________ |

### 6.2 S1上缸进水测试

| # | 测试项 | 步骤 | 期望 | 实测 | 签字 |
|---|---|---|---|---|---|
| 1 | 启动实验 | V0.0置位 | VW2=1(S1),阀A开 | ___ | |
| 2 | 流量计快照 | 查VD82 | 阀A开瞬间值记录 | ___ | |
| 3 | 进水过程 | 监控VD90进水量 | 数值增长 | ___ | |
| 4 | 进水完成 | VD90≥设定值 | 阀A关,VW2=2(S2) | ___ | |
| 5 | 阀A关到位验证 | 延时后查I0.0 | I0.0=OFF(无流) | ___ | |

### 6.3 S2~S6完整流程测试

| # | 测试项 | 期望 | 实测 | 签字 |
|---|---|---|---|---|
| 1 | S2预循环 | 泵1/2运行,VD_S2_Target计时完成→S3 | ___ | |
| 2 | S3加药 | 注射泵抽/排液完成,VW4=0→S3.5 | ___ | |
| 3 | S3.5静置 | VD_RestTime_Target计时完成→S4 | ___ | |
| 4 | S4转移 | 阀B开,四态诊断正常,下缸满→S5 | ___ | |
| 5 | S5运行 | VD_S5_Elapsed累加,达周期→S6 | ___ | |
| 6 | S6排水 | 阀C开,四态诊断正常,下缸空→S4 | ___ | |
| 7 | 第二轮启动 | S5上升沿触发新一轮S1 | ___ | |
| 8 | 实验结束 | VD96≥VD24,VW2=8(S7) | ___ | |

### 6.4 阀门诊断测试

| # | 测试项 | 步骤 | 期望 | 实测 | 签字 |
|---|---|---|---|---|---|
| 1 | 阀A开超时 | 断开I8.0反馈 | V301.4=1,VW6=34 | ___ | |
| 2 | 阀A关到位仍有流 | 关阀后保持I0.0=ON | V301.3=1,VW6=33 | ___ | |
| 3 | 阀A关后仍有流 | T51期间保持I0.0=ON | V301.0=1,VW6=30 | ___ | |
| 3 | 阀B诊断 | S4断开流量开关B | V302.0=1 | ___ | |
| 4 | 阀C诊断 | S6断开流量开关C | V302.5=1 | ___ | |

---

## 七、验收(第5天)

### 7.1 SAT验收测试

| # | 测试组 | 用例数 | 通过 | 失败 | 签字 |
|---|---|---|---|---|---|
| 1 | DI/DO测试 | 28 | ___ | ___ | |
| 2 | Story1.2状态机 | 12 | ___ | ___ | |
| 3 | Story1.3阀门诊断 | 15 | ___ | ___ | |
| 4 | Story1.4节奏纠偏 | 10 | ___ | ___ | |
| 5 | Story1.5急停 | 8 | ___ | ___ | |
| 6 | Story1.6报警 | 12 | ___ | ___ | |
| 7 | Story1.7断电恢复 | 8 | ___ | ___ | |
| 8 | Modbus通讯 | 6 | ___ | ___ | |
| 9 | 长时稳定性 | 2 | ___ | ___ | |

**详见SAT_FAT验收测试用例v1.0,101个必测用例逐项执行。**

### 7.2 验收签字

| 角色 | 姓名 | 签字 | 日期 |
|---|---|---|---|
| 调试工程师 | | | |
| 设备维护 | | | |
| 项目经理 | | | |
| 客户代表 | | | |

---

## 八、问题记录与处理

| # | 问题描述 | 发生阶段 | 严重度 | 处理措施 | 状态 | 签字 |
|---|---|---|---|---|---|---|
| 1 | | | | | | |
| 2 | | | | | | |
| 3 | | | | | | |

---

## 附录:调试进度时间表

| 天数 | 阶段 | 主要工作 |
|---|---|---|
| 第1天 | 硬件安装+下装 | 到货验收→安装→接线检查→PLC上电→程序下装 |
| 第2天 | IO打点 | 20 DI + 9 DO逐点测试 |
| 第3天 | 单机功能 | 急停/报警/Modbus/断电恢复 |
| 第4天 | 联动调试 | S1~S6完整流程+阀门诊断 |
| 第5天 | SAT验收 | 101用例执行+签字交付 |

**说明**: 首期1套预计5天完成调试。后续7套复用本流程,每套约2~3天(无下装环节,程序相同)。

---

**文档版本**: v1.0
**创建日期**: 2026-07-15
**说明**: 本checklist为首期1套调试流程,现场调试工程师按此逐项执行并签字。后续7套复用本流程。
