Yustnust/AQUA-EXPO/docs/commissioning/故障代码字典_v1.0.md

# 药液配置加注控制系统 — 故障代码字典 v1.0

**项目**：AQUA-EXPO 药液配置加注控制系统
**适用PLC**：西门子 S7-200 SMART CPU ST20（8套缸单元通用，各PLC程序完全相同，仅IP不同）
**配套文档**：
- HMI-PLC变量地址表 v1.0（第九章 报警标志与报警码定义）
- 报警字32位解析映射表 v1.0
- 报警现场处置操作指引 v1.0
- PLC设计文档 v9.3
- STL源码：FC0/FC2/FC3/FC11/FC12/FC13/FC16/FC19/FC30/FC31/FC32/FC40

**编制日期**：2026-07-18
**版本**：v1.0
**编制人**：现场调试工程师

---

## 一、适用范围

本文档适用于8套缸单元（IP 192.168.2.101~108）的全部报警诊断。各PLC程序完全相同，报警字地址一致，仅单元编号与IP不同。本字典覆盖 `VW6` 报警码表的全部31个编码（0=无报警，其余30条报警），每条均基于实际STL源码与变量表交叉核验，含触发条件、可能原因、排查步骤、恢复方法、预防措施与关联变量。

## 二、使用说明

### 2.1 如何根据VW6码查字典

1. 在HMI画面5（报警日志页）或画面2（单元详情页）查看 `VW6` 当前值。
2. 跳转到本字典"第三章 故障代码详表"，按报警码定位条目（建议配合附录A快速索引表）。
3. 按条目内"现场排查步骤"逐项执行，参照"关联变量"在画面2/4/6/7交叉核对DI/VD参数。
4. 处置完毕后按"恢复方法"操作复位；若为强制人工确认类（漫溢级/节奏级/继电器故障），还需在HMI画面5下发V0.3或V0.7命令。

### 2.2 报警分级与响应时效

| 等级 | VW6编码段 | HMI颜色 | 响应时效 | 强制人工确认 | 复位主导 |
|---|---|---|---|---|---|
| 最高级 | 99 | 红色闪烁 | 立即（秒级） | 是（HMI二次确认+高权限） | V0.7 + I1.2 |
| 漫溢级 | 10~14 | 红色 | 立即（分钟级） | 是 | V0.3 + DI恢复 |
| 节奏级 | 20 | 橙色 | 尽快（小时内） | 是 | V0.3 + 节奏恢复 |
| 一般级 | 21, 30~66 | 黄色 | 择机（班次内） | 按 `M_AlarmAckMode`（V200.0） | 自动 / V0.3 |

### 2.3 优先级链（FC3 NETWORK1 实现）

```
99 (V300.5) > 10~14 (V300.0~V300.4) > 20 (V300.6) > 21 (V300.7)
            > 30~36 (V301.0~V301.6) > 40~47 (V302.0~V302.7) > 60~65 (V303.0~V303.5)
```

`VW6` 始终保存当前最高优先级未确认报警码（FC3 NETWORK1 用 LD压栈+条件JMP 逐位赋值，JMP到 `nAlarmCodeDone` 跳出）。

### 2.4 复位模式说明（M_AlarmAckMode，V200.0）

| 模式 | 值 | 一般故障级（V301.x/V302.x/V303.x，VW6=21/30~66） | 高优先级（V300.0~V300.6，VW6=10~14/20/99） |
|---|---|---|---|
| 自动恢复 | 0 | 条件消失后FC3 NETWORK5自动R复位→VW6重算为0→自动消光 | **不受此模式影响**，仍强制人工确认 |
| 人工确认 | 1 | 条件消失后需HMI下发V0.3确认→FC3 NETWORK4复位报警位 | 同上，强制人工确认 |

### 2.5 消音/消光分离原则

| 操作 | 命令源 | 效果 | 不影响 |
|---|---|---|---|
| 消音 | I0.4就地按钮 OR V0.4 HMI命令 | 关Q0.7声音，置M_Sound_Latched | 灯光Q8.0、报警锁存位、VW6、状态机 |
| 消光（报警确认） | V0.3 HMI报警确认 | 根本原因消失后关Q8.0灯光、清报警锁存位、VW6=0 | — |
| 新报警重鸣 | VW6由0变非0 | 清M_Sound_Latched，Q0.7重新鸣响 | 操作员需再次消音 |

---

## 三、故障代码详表

> 编排顺序：0 → 99 → 10~14 → 20~21 → 30~36 → 40~47 → 60~66
> 每条统一表格格式：报警码 / 符号 / 位地址 / 优先级 / 触发条件 / 可能原因 / 排查步骤 / 恢复方法 / 预防措施 / 关联变量

---

### 3.0 报警码 0：无报警

| 项 | 内容 |
|---|---|
| **报警码** | 0 |
| **报警符号** | — |
| **报警位地址** | — |
| **优先级** | — |
| **触发条件** | FC3 NETWORK1：全部32位报警字VB300~VB303均为0，末尾 `MOVW 0, VW6` 赋值0 |
| **可能原因** | — |
| **现场排查步骤** | — |
| **恢复方法** | — |
| **预防措施** | — |
| **关联变量** | VW6=0；Q8.0灯光由FC3 NETWORK2自动消光（V200.0=0时）；Q0.7自动关声音 |

---

### 3.1 报警码 99：安全继电器/接触器故障

| 项 | 内容 |
|---|---|
| **报警码** | 99 |
| **报警符号** | M_Alarm_SafetyRelay |
| **报警位地址** | V300.5 |
| **优先级** | **最高级**（红色闪烁） |
| **触发条件** | FC2 NETWORK2：急停锁存后（V300.4=1）且安全继电器反馈I1.2=OFF，T35延时2秒（PT=20，100ms时基）到达上升沿 → `S V300.5, 1`。逻辑含义：急停按下后，安全继电器主触点应在2秒内断开220V/380V动力回路并通过I1.2辅助触点反馈"已断开"信号；2秒未反馈则判定主触点粘连或继电器故障 |
| **可能原因** | **机械原因**：①安全继电器主触点粘连（电弧烧蚀）②继电器机械机构卡死 ③继电器线圈断线/烧毁 |
| | **电气原因**：①220V/380V动力回路短路导致触点熔焊 ②I1.2反馈接线断线/松脱 ③I1.2反馈回路中间继电器故障 ④安全继电器电源（220V线圈）失电 |
| | **软件或操作原因**：①现场未执行急停按钮测试但I1.2反馈触点选型错误（常开/常闭反接）②T35延时参数过短（默认2秒，机械动作慢的继电器可能误报） |
| **现场排查步骤** | 1. HMI画面5查看报警码99红闪，确认继电器故障最高级报警；画面2确认VW2=99（S_ERROR）<br>2. 现场查看安全继电器线圈是否得电（指示灯）<br>3. 用万用表测量I1.2端子电压：ON=24V（动力回路已断开确认），OFF=0V<br>4. 检查继电器主触点状态：断电后用万用表通断挡测主触点，正常应为开路<br>5. 检查220V动力回路绝缘，排除短路<br>6. 检查I1.2反馈接线（强制导向触点→中间继电器→PLC DI）<br>7. 确认急停按钮I1.1状态（应已OFF，即急停已按下） |
| **恢复方法** | 1. 排除机械/电气故障（更换继电器/修复接线/处理短路）<br>2. 旋转释放急停按钮（I1.1恢复ON）<br>3. L3管理员登录HMI，画面5点击"继电器高权限确认"，输入密码二次验证<br>4. PLC执行FC19 NETWORK4：`LD V0.7 EU A I1.2 R V300.5` —— 必须I1.2=ON（反馈确实正常）才清除V300.5<br>5. V300.5清除后，下一周期FC19 NETWORK2不再跳过，可按现场I0.3系统复位按钮回S0<br>**注意**：禁止用系统复位按钮I0.3直接清除V300.5；若I1.2仍OFF（检修未完成），V0.7无法清除报警 |
| **预防措施** | ①每月执行1次急停按钮测试，验证I1.2反馈时序<2秒 ②每年检查继电器主触点烧蚀情况，必要时更换 ③I1.2反馈回路接线端子定期紧固 ④T35延时参数（默认2秒）现场整定，机械慢的继电器可适当延长至3秒（修改FC2 NETWORK2 PT值） |
| **关联变量** | V300.5（报警位）；V300.4（急停锁存，前置条件）；I1.1（急停反馈）；I1.2（安全继电器反馈）；T35（2秒延时，PT=20）；V0.7（CMD_SafetyRelayAck）；VW2（应=99 S_ERROR） |

---

### 3.2 报警码 10：上缸漫溢（液位计A-高位）

| 项 | 内容 |
|---|---|
| **报警码** | 10 |
| **报警符号** | M_Alarm_Overflow_AHigh |
| **报警位地址** | V300.0 |
| **优先级** | 漫溢级（红色） |
| **触发条件** | FC30 NETWORK1（漫溢保护，全程最高优先级）：`LD I0.5 S V300.0, 1` —— S1/S2期间液位计A-高位 I0.5=ON，立即置位V300.0并联动：S Q0.5（NC球阀-上缸得电关闭第二道保护）、R Q0.2（关阀A）、`MOVB 99, VB2`（转S_ERROR）、Diag_Result_A=2故障 |
| **可能原因** | **机械原因**：①阀A关不到位/卡滞（球体磨损、密封失效）②上缸排水口堵塞 ③管路背压异常导致进水不停 |
| | **电气原因**：①液位计A-高位探头误动作（受潮/接线短路）②液位计探头表面结垢导致提前触发 ③I0.5输入端子接线松脱误接通 |
| | **软件或操作原因**：①VD_Timeout_ValveA超时参数过长，进水过多才报警 ②VD316（目标进水量）设定过大超出缸体容量 ③流量开关A失效，阀A未关仍持续进水 |
| **现场排查步骤** | 1. HMI画面5查看报警码10红，画面2确认VW2=99、上缸状态V1.6<br>2. 现场查看上缸实际液位，确认是否真的接近漫溢<br>3. 检查阀A是否已关闭到位（手摸/听水流声），PLC已自动R Q0.2关阀<br>4. 确认NC球阀-上缸Q0.5已得电（应已自动动作，关闭第二道保护）<br>5. 检查液位计A-高位探头：用万用表测I0.5端子电压，确认是否误通<br>6. 检查液位计探头表面是否结垢，擦拭清洁<br>7. 排查阀A机械：手电动切换，手动操作阀A检查是否灵活<br>8. 检查上缸排水口是否堵塞 |
| **恢复方法** | 1. 现场降低上缸液位（手动排水或等待NC阀泄流），使I0.5=OFF<br>2. 消音（I0.4按钮或HMI V0.4）<br>3. 排查并消除阀A机械/电气故障<br>4. HMI画面5点击"报警确认"下发V0.3<br>5. PLC执行FC3 NETWORK4：`LD V300.0 AN I0.5 R V300.0` —— 必须I0.5=OFF才复位<br>6. V300.0复位后下一周期VW6重算<br>7. 现场按I0.3系统复位按钮回S0（FC19 NETWORK3） |
| **预防措施** | ①每周清洁液位计A探头表面 ②每月测试液位计A-高位动作可靠性 ③VD316目标进水量设定值与缸体容量留≥20%余量 ④VD_Timeout_ValveA（默认60秒）现场整定 ⑤VD_Delay_ValveA_Verify（默认5秒）确保延时验证生效 |
| **关联变量** | V300.0（报警位）；I0.5（液位计A-高位）；Q0.2（阀A输出，应=0）；Q0.5（NC阀-上缸，应=1）；VW2（应=99）；VD316（目标进水量）；VD_Timeout_ValveA（VD48，阀A超时）；VD_Delay_ValveA_Verify（VD66，延时验证） |

---

### 3.3 报警码 11：下缸漫溢（液位计B-高位）

| 项 | 内容 |
|---|---|
| **报警码** | 11 |
| **报警符号** | M_Alarm_Overflow_BHigh |
| **报警位地址** | V300.1 |
| **优先级** | 漫溢级（红色） |
| **触发条件** | FC31 NETWORK1（漫溢保护，全程最高优先级）：`LD I0.7 S V300.1, 1` —— S4期间液位计B-高位 I0.7=ON，立即置位V300.1并联动：S Q0.6（NC球阀-下缸得电）、R Q0.3（关阀B）、`MOVB 99, VB2`（转S_ERROR）、Diag_Result_B=2故障 |
| **可能原因** | **机械原因**：①阀B关不到位/卡滞 ②下缸排水阀C故障导致下缸液位累积 ③上缸→下缸转移量超出下缸容量 |
| | **电气原因**：①液位计B-高位探头误动作 ②I0.7接线受潮/短路 ③液位计探头结垢 |
| | **软件或操作原因**：①VD_Timeout_ValveB超时参数过长 ②阀B四态诊断异常未及时处理继续转移 ③S5期间下缸持续满未及时排水 |
| **现场排查步骤** | 1. HMI画面5查看报警码11红，画面2确认VW2=99、下缸状态V1.7<br>2. 现场查看下缸实际液位，确认是否接近漫溢<br>3. 检查阀B是否已关闭（PLC已自动R Q0.3）<br>4. 确认NC球阀-下缸Q0.6已得电<br>5. 检查液位计B-高位探头I0.7是否误通<br>6. 检查阀C是否能正常排水（S6是否可正常进入）<br>7. 排查阀B机械，手动操作检查灵活性<br>8. 检查下缸排水口是否堵塞 |
| **恢复方法** | 1. 现场降低下缸液位（手动通过阀C排水），使I0.7=OFF<br>2. 消音<br>3. 排查并消除阀B/阀C故障<br>4. HMI画面5报警确认V0.3<br>5. PLC执行FC3 NETWORK4：`LD V300.1 AN I0.7 R V300.1` —— 必须I0.7=OFF才复位<br>6. 现场按I0.3系统复位按钮回S0 |
| **预防措施** | ①每周清洁液位计B探头 ②每月测试液位计B-高位动作可靠性 ③S4转移期间VW268诊断结果实时监测 ④下缸容量与单轮转移量留≥20%余量 |
| **关联变量** | V300.1（报警位）；I0.7（液位计B-高位）；Q0.3（阀B输出，应=0）；Q0.6（NC阀-下缸，应=1）；VW2（应=99）；VD_Timeout_ValveB（VD50）；VW268（Diag_Result_B） |

---

### 3.4 报警码 12：NC球阀-上缸动作

| 项 | 内容 |
|---|---|
| **报警码** | 12 |
| **报警符号** | M_Alarm_NCValve_Top |
| **报警位地址** | V300.2 |
| **优先级** | 漫溢级（红色） |
| **触发条件** | **【STL实现说明】** 当前STL中未找到对V300.2的显式置位语句。设计意图：当阀A失效保护触发时（如阀A关不到位/内漏等），Q0.5（NC球阀-上缸）得电动作作为第二道保护，应同步置位V300.2作为报警指示。当前FC30 NETWORK1仅在I0.5=ON（上缸漫溢）时 `S Q0.5, 1`，未同步置位V300.2。需在后续Story补充：在阀A关闭诊断失败（V301.0~V301.3触发）时联动S Q0.5 + S V300.2。**调试时核实**：若现场仅触发V300.0（漫溢）但Q0.5已动作，需补充V300.2置位逻辑 |
| **可能原因** | **机械原因**：①阀A球体磨损导致关不严 ②阀A密封圈老化 ③阀A执行机构卡滞 |
| | **电气原因**：①阀A电源故障（继电器触点异常） ②阀A电动执行器烧毁 ③I8.1关到位反馈失效 |
| | **软件或操作原因**：①VD_Delay_ValveA_Verify延时不足，瞬时波动误判 ②阀A关闭后流量开关A误报有流（I0.0受干扰） |
| **现场排查步骤** | 1. HMI画面5查看报警码12红，画面2确认VW2=99<br>2. 现场查看NC球阀-上缸Q0.5是否已得电（指示灯）<br>3. 检查阀A机械状态：手动操作阀A，检查是否关到位<br>4. 检查阀A执行机构电源（继电器触点）<br>5. 检查阀A关到位反馈I8.1是否正常<br>6. 检查流量开关A I0.0是否误报有流<br>7. 若V300.0（漫溢）同时触发，优先处理漫溢原因<br>8. 测试阀A密封性（关闭后保压观察） |
| **恢复方法** | 1. 修复阀A机械/电气故障，使阀A正常关闭<br>2. 消音<br>3. HMI画面5报警确认V0.3<br>4. **注意**：FC3 NETWORK4注释明确"漫溢级（V300.2/3 NC阀）不由FC3复位，由FC19系统复位按钮/HMI高权限确认处理"。实际复位依赖V0.3确认+系统复位I0.3<br>5. 现场按I0.3系统复位按钮回S0 |
| **预防措施** | ①每季度测试阀A密封性 ②每年更换阀A密封圈 ③VD_Delay_ValveA_Verify现场整定避免瞬时误判 ④Q0.5 NC球阀动作可靠性月度测试 |
| **关联变量** | V300.2（报警位）；Q0.5（NC阀-上缸输出）；Q0.2（阀A输出）；I8.1（阀A关到位）；I0.0（流量开关A）；VD_Delay_ValveA_Verify（VD66） |

---

### 3.5 报警码 13：NC球阀-下缸动作

| 项 | 内容 |
|---|---|
| **报警码** | 13 |
| **报警符号** | M_Alarm_NCValve_Bottom |
| **报警位地址** | V300.3 |
| **优先级** | 漫溢级（红色） |
| **触发条件** | **【STL实现说明】** 当前STL中未找到对V300.3的显式置位语句。设计意图：当阀B故障或液位计B最高报警触发时，Q0.6（NC球阀-下缸）得电动作作为第二道保护，应同步置位V300.3。当前FC31 NETWORK1仅在I0.7=ON（下缸漫溢）时 `S Q0.6, 1`，未同步置位V300.3。需在后续Story补充：在阀B诊断失败（V302.0/V302.4等触发）时联动S Q0.6 + S V300.3。**调试时核实** |
| **可能原因** | **机械原因**：①阀B球体磨损导致关不严 ②阀B密封圈老化 ③阀B执行机构卡滞 |
| | **电气原因**：①阀B电源故障 ②阀B电动执行器烧毁 ③I8.3关到位反馈失效 |
| | **软件或操作原因**：①阀B四态诊断状态4瞬时误判 ②流量开关B I0.1受干扰 |
| **现场排查步骤** | 1. HMI画面5查看报警码13红，画面2确认VW2=99<br>2. 现场查看NC球阀-下缸Q0.6是否已得电<br>3. 检查阀B机械状态：手动操作检查灵活性<br>4. 检查阀B电源与执行机构<br>5. 检查阀B关到位反馈I8.3<br>6. 检查流量开关B I0.1<br>7. 若V300.1（漫溢）同时触发，优先处理漫溢原因<br>8. 测试阀B密封性 |
| **恢复方法** | 1. 修复阀B机械/电气故障<br>2. 消音<br>3. HMI画面5报警确认V0.3<br>4. **注意**：FC3 NETWORK4注释明确V300.3不由FC3复位，由FC19系统复位处理<br>5. 现场按I0.3系统复位按钮回S0 |
| **预防措施** | ①每季度测试阀B密封性 ②每年更换阀B密封圈 ③Q0.6 NC球阀动作可靠性月度测试 ④VW268（Diag_Result_B）异常立即停机检查 |
| **关联变量** | V300.3（报警位）；Q0.6（NC阀-下缸输出）；Q0.3（阀B输出）；I8.3（阀B关到位）；I0.1（流量开关B）；I0.7（液位计B-高位）；VW268（Diag_Result_B） |

---

### 3.6 报警码 14：急停触发锁存

| 项 | 内容 |
|---|---|
| **报警码** | 14 |
| **报警符号** | M_EStop_Latch |
| **报警位地址** | V300.4 |
| **优先级** | 漫溢级（红色） |
| **触发条件** | FC2 NETWORK1：`LD I1.1 NOT EU S V300.4, 1` —— 急停按钮I1.1（常闭触点，ON=正常，OFF=急停触发）的下降沿（即NOT后EU上升沿，按下急停瞬间）锁存V300.4，并联动：`MOVB 99, VB2`（转S_ERROR）、`R M10.7`（清预规划标志）。FC0 NETWORK7 阀门动作态断电时也会 `S V300.4, 1`（类比急停，需人工复位） |
| **可能原因** | **机械原因**：①急停按钮物理按下（正常操作） ②急停按钮触点老化误断 |
| | **电气原因**：①急停按钮接线断路 ②急停回路电源故障 ③I1.1端子松脱 |
| | **软件或操作原因**：①现场正常急停操作（如维护、紧急情况） ②阀门动作态断电自动触发（FC0） ③误碰急停按钮 |
| **现场排查步骤** | 1. HMI画面5查看报警码14红，画面2确认VW2=99、急停状态I1.1<br>2. 现场确认急停原因（正常操作/紧急情况/误碰/接线故障）<br>3. 检查急停按钮I1.1状态：万用表测I1.1端子，OFF=急停按下，ON=正常<br>4. 若I1.1=OFF：旋转释放急停按钮，确认I1.1恢复ON<br>5. 若I1.1=ON但V300.4仍锁存：正常现象，需系统复位按钮<br>6. 检查急停按钮触点是否老化（使用万用表通断挡）<br>7. 若V300.5（继电器故障）同时触发，优先处理继电器故障 |
| **恢复方法** | 1. 排除急停原因（紧急情况已处理/维护完成/接线修复）<br>2. 旋转释放急停按钮（I1.1恢复ON）<br>3. **现场按下物理系统复位按钮I0.3**（HMI不直接下发复位命令）<br>4. PLC执行FC19 NETWORK3：`LD I1.1 A I0.3 EU R V300.4` —— 必须I1.1=ON + V300.5=0 + I0.3上升沿才复位<br>5. FC19同步：R V1.6（上缸=空）、R V1.7（下缸=空）、`MOVB 0, VB2`（回S0）、VW6=0、R Q0.7<br>6. **注意**：若V300.5=1（继电器故障），FC19 NETWORK2会跳过系统复位，必须先清除V300.5 |
| **预防措施** | ①每月测试急停按钮动作可靠性 ②急停按钮加装防护罩防误碰 ③急停回路接线端子定期紧固 ④断电恢复策略（FC0）已将阀门动作态断电转S_ERROR，避免半开状态 |
| **关联变量** | V300.4（报警位）；I1.1（急停反馈，常闭）；I0.3（系统复位按钮）；V300.5（继电器故障，互锁）；VW2（应=99）；V1.6/V1.7（复位时强制置空）；M10.7（预规划标志，急停时清） |

---

### 3.7 报警码 20：配液节奏严重滞后

| 项 | 内容 |
|---|---|
| **报警码** | 20 |
| **报警符号** | M_Alarm_ScheduleLag |
| **报警位地址** | V300.6 |
| **优先级** | 节奏级（橙色） |
| **触发条件** | FC40 NETWORK5（第2层扣减顺延换水周期）：`LD SM0.0 AR<= VD158, VD170 JMP nLayer2OK` 失败时（即Delta缺口 > 第2层额度VD170=VD_CycleExtend_Max×60秒），三层纠偏全部用尽 → `S V300.6, 1` + `MOVB 99, VB2`（转S_ERROR）+ `MOVB 4, VB184`（Result=4人工介入）。三层额度：第0层=VD_RestTime-VD_RestTime_Min（压缩静止等候）；第1层=VD_PreMixTime-VD_PreMixTime_MinSafe（压缩S2）；第2层=VD_CycleExtend_Max×60秒（顺延周期） |
| **可能原因** | **机械原因**：①循环泵效率下降，S2搅拌时间被持续拉长 ②阀A/B/C动作变慢，单轮耗时增加 ③管路堵塞导致排水/进水变慢 |
| | **电气原因**：①注射泵Modbus通讯偶发超时拖累S3 ②流量计读数漂移导致VD_T_Rolling失真 |
| | **软件或操作原因**：①VD_CycleSetpoint设定过短，无法容纳S1~S3.5+静止等候总时长 ②VD_T_Rolling滚动均值被历史异常值污染 ③VD_PreMixTime_MinSafe/VD_RestTime_Min设定过大，纠偏空间不足 ④VD_CycleExtend_Max设定过小，顺延额度不足 |
| **现场排查步骤** | 1. HMI画面5查看报警码20橙，画面2确认VW2=99<br>2. HMI画面6趋势曲线查看VD_T_Rolling（滚动T）与VD_S6_Rolling变化趋势，定位异常升高的轮次<br>3. HMI画面6查看VD70（S1实测）/VD74（S4实测）/VD78（S6实测），定位哪一阶段耗时异常<br>4. 现场检查循环泵运转声音<br>5. 检查阀A/B/C动作时间是否变长（限位开关响应）<br>6. 检查注射泵Modbus通讯是否偶发超时（画面7通讯状态）<br>7. 评估VD_CycleSetpoint（VD20，默认30min）是否需调大<br>8. 评估VD_PreMixTime_MinSafe（VD32，默认30s）/VD_RestTime_Min（VD40，默认15s）是否可压缩<br>9. 评估VD_CycleExtend_Max（VD44，默认5min）是否可调大 |
| **恢复方法** | 1. L2维护登录HMI，画面4调整时间周期参数：<br> - 增大 VD_CycleSetpoint（VD20）扩展周期预算<br> - 适当下调 VD_PreMixTime_MinSafe（VD32）/VD_RestTime_Min（VD40）增加纠偏空间<br> - 适当增大 VD_CycleExtend_Max（VD44）扩展顺延额度<br>2. 若为机械/电气原因（泵/阀效率下降），先排除设备故障<br>3. 消音<br>4. HMI画面5报警确认V0.3<br>5. PLC执行FC3 NETWORK4：节奏滞后级"条件消失（新一轮开始）由FC40重置，FC3不直接处理"，但V0.3确认时若V300.6已由FC40清除，NETWORK1重算VW6<br>6. 现场按I0.3系统复位按钮回S0 |
| **预防措施** | ①每周分析画面6趋势曲线，识别T_Rolling异常早期信号 ②循环泵/阀门年度检修保持效率 ③VD_CycleSetpoint与VD_T_Rolling保持≥10%余量 ④VD_CycleExtend_Max现场整定至换水周期的15~20% ⑤Modbus通讯稳定性月度检查 |
| **关联变量** | V300.6（报警位）；VD150（VD_Available）；VD154（VD_Needed）；VD158（VD_Delta缺口）；VD162/VD166/VD170（三层额度）；VD28（VD_PreMixTime）；VD32（VD_PreMixTime_MinSafe）；VD36（VD_RestTime）；VD40（VD_RestTime_Min）；VD44（VD_CycleExtend_Max）；VD20（VD_CycleSetpoint）；VD112（VD_T_Rolling）；VD116（VD_S6_Rolling）；VW184（纠偏结果，=4） |

---

### 3.8 报警码 21：配液节奏滞后提示

| 项 | 内容 |
|---|---|
| **报警码** | 21 |
| **报警符号** | M_Alarm_ScheduleLag_Warn |
| **报警位地址** | V300.7 |
| **优先级** | 一般级（黄色），按 M_AlarmAckMode |
| **触发条件** | FC40 NETWORK5 nLayer2OK分支：`LD SM0.0 AR<= VD158, VD170 JMP nLayer2OK` 成功时（Delta缺口 ≤ 第2层额度，顺延可覆盖），执行 `MOVR VD158, VD128 /R 60.0, VD128`（VD_CycleExtend_Target=Delta÷60转min），`MOVB 3, VB184`（Result=3滞后提示），然后 `LD SM0.0 AN V300.7 S V300.7, 1`（仅在预规划未触发过滞后提示时才置位，避免二次校正重复报警）。**不转S_ERROR，系统继续运行** |
| **可能原因** | **机械原因**：①潜水泵/阀门轻微效率下降 ②管路部分堵塞 |
| | **电气原因**：①Modbus通讯偶发延迟 ②传感器读数轻微漂移 |
| | **软件或操作原因**：①VD_CycleSetpoint设定边界（刚够覆盖典型T，无冗余） ②VD_PreMixTime/VD_RestTime标称值偏大 ③首轮使用VD_T_Default/VD_S6_Default导致预规划偏差 |
| **现场排查步骤** | 1. HMI画面5查看报警码21黄，画面2确认VW2正常运行（非99）<br>2. HMI画面6查看当前轮次VD_CycleExtend_Target（VD128，顺延量）<br>3. 观察后续轮次是否自恢复（VD_T_Rolling逐步收敛）<br>4. 若持续触发并升级为V300.6（严重滞后），转报警码20处置<br>5. 评估VD_CycleSetpoint是否需微调 |
| **恢复方法** | 1. 自动恢复模式（V200.0=0）：条件消失（新一轮无顺延需求，VD_CycleExtend_Target=0）后FC3 NETWORK5自动R复位V300.7<br>2. 人工确认模式（V200.0=1）：HMI画面5报警确认V0.3 + 条件消失<br>3. 通常1个换水周期内（约30分钟）自恢复<br>4. 无需系统复位，状态机不停机 |
| **预防措施** | ①监控VD_CycleExtend_Target趋势，频繁非零时主动调整VD_CycleSetpoint ②首轮VD_T_Default/VD_S6_Default设定保守值避免首轮触发 ③泵/阀定期维护保持效率稳定 |
| **关联变量** | V300.7（报警位）；VD128（VD_CycleExtend_Target，应>0）；VW184（应=3）；V200.0（M_AlarmAckMode）；VD44（VD_CycleExtend_Max）；VD20（VD_CycleSetpoint） |

---

### 3.9 报警码 30：阀A关后延时验证仍有流

| 项 | 内容 |
|---|---|
| **报警码** | 30 |
| **报警符号** | M_Alarm_ValveA_CloseFlow |
| **报警位地址** | V301.0 |
| **优先级** | 一般级（黄色） |
| **触发条件** | FC30 NETWORK1（子状态5延时验证3项并行校验）：T51延时到达（PT=VW280=VD_Delay_ValveA_Verify×10，默认5秒）后，`LD T51 A I0.0 S V301.0, 1` —— 阀A关闭后延时验证期间，流量开关A I0.0=ON（仍有水流）则置位V301.0。同时检查V301.2/V301.3，任一报警转S_ERROR（2026-09-14已删除V301.1差值法内漏判定） |
| **可能原因** | **机械原因**：①阀A球体未完全关闭（机械限位偏差） ②阀A密封圈磨损 ③阀A执行机构卡滞未到位 |
| | **电气原因**：①流量开关A I0.0误通（受潮/接线短路） ②流量开关A灵敏度设置过高 ③阀A关到位反馈I8.1失效 |
| | **软件或操作原因**：①VD_Delay_ValveA_Verify（默认5秒）延时不足，关阀后水流惯性未消 ②流量开关A阈值设定过低 |
| **现场排查步骤** | 1. HMI画面5查看报警码30黄，画面2确认VW2=99<br>2. 现场听阀A处是否有水流声<br>3. 检查阀A是否完全关闭（手动操作验证）<br>4. 检查流量开关A I0.0状态：万用表测I0.0端子<br>5. 检查阀A关到位反馈I8.1（若I8.1=ON且I0.0=ON，则阀A关到位但有流，可能密封泄漏；若I8.1=OFF，则阀A未关到位）<br>6. 检查VD_Delay_ValveA_Verify（VD66）延时设定是否合理<br>7. 检查流量开关A灵敏度（如可调） |
| **恢复方法** | 1. 修复阀A机械/密封故障，或修复流量开关A误通<br>2. 消音<br>3. 自动模式（V200.0=0）：I0.0=OFF后FC3 NETWORK5自动R V301.0<br>4. 人工模式（V200.0=1）：I0.0=OFF后HMI画面5报警确认V0.3，FC3 NETWORK4复位<br>5. 若已转S_ERROR，需现场按I0.3系统复位按钮回S0 |
| **预防措施** | ①每季度测试阀A密封性（关闭后保压观察） ②每年更换阀A密封圈 ③VD_Delay_ValveA_Verify现场整定至水流惯性完全消除（建议5~10秒） ④流量开关A灵敏度年度校准 |
| **关联变量** | V301.0（报警位）；I0.0（流量开关A）；I8.1（阀A关到位）；T51（延时验证计时器）；VW280（PT转换值）；VD66（VD_Delay_ValveA_Verify，默认5秒）；VW266（Diag_Result_A，应=2）；VW260（Diag_State_A，应=5） |

---

### 3.10 报警码 31：已删除（原阀A内漏-流量计计量值仍增长）

| 项 | 内容 |
|---|---|
| **状态** | 2026-09-14 已删除 |
| **原报警码** | 31 |
| **原报警符号** | M_Alarm_ValveA_Leak |
| **原报警位地址** | V301.1 |
| **删除原因** | 流量计差值法内漏判定（VD312=VD86−VD308>0.1L）现场误报率高，且阀A关后仍有流（V301.0）与阀A关到位仍有流（V301.3）已能覆盖内漏场景。删除后保留VD308快照供HMI查看，但不再用VD312触发报警。 |
| **替代检测** | ①V301.0 阀A关后仍有流（流量开关A=ON）<br>②V301.3 阀A关到位但仍有流（I8.1=ON 且 I0.0=ON） |

---

### 3.11 报警码 32：阀A关到位超时

| 项 | 内容 |
|---|---|
| **报警码** | 32 |
| **报警符号** | M_Alarm_ValveA_CloseTimeout |
| **报警位地址** | V301.2 |
| **优先级** | 一般级（黄色） |
| **触发条件** | FC30 NETWORK8（S5延时验证4项并行校验）：T51延时到达后，`LD T51 LPS AN I8.1 S V301.2, 1` —— T51延时验证期间I8.1（阀A关到位反馈）=OFF，判定关到位超时。**注意**：与FC30 NETWORK4（S1等待开到位）的T50超时机制不同，V301.2是关阀后超时（T51阶段），V301.4是开阀超时（T50阶段） |
| **可能原因** | **机械原因**：①阀A执行机构卡滞 ②阀A机械限位偏差 ③阀A球体磨损导致到位困难 |
| | **电气原因**：①阀A电动执行器电源故障 ②I8.1关到位反馈限位开关失效 ③I8.1接线松脱/断线 ④I8.1有源信号→继电器转换环节故障 |
| | **软件或操作原因**：①VD_Timeout_ValveA（默认60秒）设定过短 ②阀A限位反馈经继电器转换延时过长 |
| **现场排查步骤** | 1. HMI画面5查看报警码32黄，画面2确认VW2=99、I8.1状态<br>2. 现场观察阀A执行机构是否动作（电动执行器指示灯/声音）<br>3. 手动操作阀A检查机械是否卡滞<br>4. 检查阀A关到位限位开关I8.1：万用表测I8.1端子，ON=24V（已到位），OFF=0V<br>5. 检查I8.1有源信号→中间继电器→PLC DI转换环节（继电器线圈/触点）<br>6. 检查VD_Timeout_ValveA（VD48，默认60秒）是否合理<br>7. 检查阀A电源（继电器触点接通220V） |
| **恢复方法** | 1. 修复阀A机械/电气故障<br>2. 消音<br>3. 自动模式：I8.1=ON后FC3 NETWORK5自动R V301.2<br>4. 人工模式：I8.1=ON后HMI画面5报警确认V0.3，FC3 NETWORK4复位<br>5. 若已转S_ERROR，需I0.3系统复位按钮回S0 |
| **预防措施** | ①每季度测试阀A关到位限位开关动作可靠性 ②VD_Timeout_ValveA现场整定（阀A实际关阀时间×1.5倍） ③阀A电动执行器年度检修 ④I8.1继电器转换环节定期检查 |
| **关联变量** | V301.2（报警位）；I8.1（阀A关到位反馈）；T51（延时验证）；VW280（PT转换值）；VD66（VD_Delay_ValveA_Verify）；VD48（VD_Timeout_ValveA，关阀超时基准）；VW266（Diag_Result_A，应=2） |

---

### 3.12 报警码 33：阀A关到位仍有流（交叉验证内漏）

| 项 | 内容 |
|---|---|
| **报警码** | 33 |
| **报警符号** | M_Alarm_ValveA_CloseLeak |
| **报警位地址** | V301.3 |
| **优先级** | 一般级（黄色） |
| **触发条件** | FC30 NETWORK8（S5延时验证4项并行校验）：T51延时到达后，`LD T51 LPS A I8.1 A I0.0 S V301.3, 1` —— 阀A关到位反馈I8.1=ON AND 流量开关A I0.0=ON（仍有流），交叉验证内漏。**与V301.0（关后流）区别**：V301.3要求I8.1=ON（已到位）+I0.0=ON，确认是密封泄漏而非未关到位；**与V301.1（内漏）区别**：V301.1基于流量计累计值，V301.3基于流量开关 |
| **可能原因** | **机械原因**：①阀A密封圈老化/破损 ②阀A球体表面磨损 ③阀A装配预紧力不足 |
| | **电气原因**：①流量开关A I0.0误通（受潮/接线短路） ②流量开关A灵敏度设置过高 ③I8.1限位开关提前误通 |
| | **软件或操作原因**：①VD_Delay_ValveA_Verify延时不足，关阀后水流惯性未消 ②流量开关A阈值设定过低 |
| **现场排查步骤** | 1. HMI画面5查看报警码33黄，画面2确认VW2=99、I8.1与I0.0状态<br>2. 现场听阀A处是否有水流声（I8.1=ON但I0.0=ON说明已关到位但密封渗漏）<br>3. 用量杯接阀A出水口验证渗漏量<br>4. 检查流量开关A I0.0是否误通<br>5. 检查阀A关到位限位开关I8.1是否提前误通（机械限位偏差）<br>6. 检查VD_Delay_ValveA_Verify延时设定<br>7. 检查流量开关A灵敏度 |
| **恢复方法** | 1. 修复阀A密封（更换密封圈/研磨球体）或修复流量开关A误通<br>2. 消音<br>3. 自动模式：I0.0=OFF后FC3 NETWORK5自动R V301.3（条件 `AN I0.0`）<br>4. 人工模式：I0.0=OFF后HMI画面5报警确认V0.3<br>5. 若已转S_ERROR，需I0.3系统复位按钮回S0 |
| **预防措施** | ①每季度测试阀A密封性（I8.1=ON状态下保压观察） ②每年更换阀A密封圈 ③流量开关A灵敏度年度校准 ④VD_Delay_ValveA_Verify现场整定至水流惯性完全消除 |
| **关联变量** | V301.3（报警位）；I8.1（阀A关到位，应=1）；I0.0（流量开关A，应=0但实际=1）；T51（延时验证）；VD66（VD_Delay_ValveA_Verify）；VW266（Diag_Result_A，应=2） |

---

### 3.13 报警码 34：阀A开到位超时

| 项 | 内容 |
|---|---|
| **报警码** | 34 |
| **报警符号** | M_Alarm_ValveA_OpenTimeout |
| **报警位地址** | V301.4 |
| **优先级** | 一般级（黄色） |
| **触发条件** | FC30 NETWORK4（S1等待开到位）：T50开到位超时计时器（PT=VW278=VD_Timeout_ValveA×10，默认60秒）到达，`LD T50 S V301.4, 1` + `MOVB 99, VB2`（转S_ERROR） + `MOVB 2, VB266`（Diag_Result_A=2故障）。开阀A指令下发后T50开始计时，I8.0（开到位反馈）=ON上升沿则转S2并复位T50；T50到达则报警 |
| **可能原因** | **机械原因**：①阀A执行机构卡滞无法开到位 ②阀A机械限位偏差 ③阀A球体磨损 |
| | **电气原因**：①阀A电动执行器电源故障 ②I8.0开到位反馈限位开关失效 ③I8.0接线松脱 ④I8.0有源信号→继电器转换环节故障 |
| | **软件或操作原因**：①VD_Timeout_ValveA（默认60秒）设定过短 ②FC11 NETWORK1开阀指令S Q0.2未生效 |
| **现场排查步骤** | 1. HMI画面5查看报警码34黄，画面2确认VW2=99、I8.0状态<br>2. 现场观察阀A执行机构是否动作（电动执行器指示灯/声音）<br>3. 检查Q0.2是否已置位（PLC开阀指令是否发出）<br>4. 手动操作阀A检查机械是否卡滞<br>5. 检查I8.0开到位限位开关：万用表测I8.0端子<br>6. 检查I8.0有源信号→继电器转换环节<br>7. 检查VD_Timeout_ValveA（VD48）是否合理<br>8. 检查阀A电源（继电器触点接通220V） |
| **恢复方法** | 1. 修复阀A机械/电气故障<br>2. 消音<br>3. 自动模式：I8.0=ON后FC3 NETWORK5自动R V301.4（条件 `A I8.0`）<br>4. 人工模式：I8.0=ON后HMI画面5报警确认V0.3<br>5. 若已转S_ERROR，需I0.3系统复位按钮回S0 |
| **预防措施** | ①每季度测试阀A开到位限位开关动作可靠性 ②VD_Timeout_ValveA现场整定（阀A实际开阀时间×1.5倍） ③阀A电动执行器年度检修 ④I8.0继电器转换环节定期检查 |
| **关联变量** | V301.4（报警位）；I8.0（阀A开到位反馈）；T50（开到位超时计时器）；VW278（PT转换值=VD48×10）；VD48（VD_Timeout_ValveA，默认60秒）；Q0.2（阀A输出，应=1）；VW260（Diag_State_A，应=1）；VW266（Diag_Result_A，应=2） |

---

### 3.14 报警码 35：阀A开到位无流

| 项 | 内容 |
|---|---|
| **报警码** | 35 |
| **报警符号** | M_Alarm_ValveA_OpenNoFlow |
| **报警位地址** | V301.5 |
| **优先级** | 一般级（黄色） |
| **触发条件** | FC30 NETWORK5（S2开启完成检查）：阀A开到位I8.0=ON但流量开关A I0.0=OFF，T52延时2秒确认（PT=20，100ms时基，避免瞬时波动），`LD T52 S V301.5, 1` + `MOVB 99, VB2`（转S_ERROR） + `MOVB 2, VB266`（故障）。即开到位2秒后仍无水流则报警 |
| **可能原因** | **机械原因**：①上游供水压力不足/停水 ②管路堵塞（过滤网/阀门上游） ③阀A虽开到位但实际开度极小（球体磨损） |
| | **电气原因**：①流量开关A I0.0失效（机械触点氧化） ②流量开关A接线断线 ③流量开关A电源故障 |
| | **软件或操作原因**：①T52确认延时2秒不足（开阀后水流建立慢） ②流量开关A灵敏度设定过低（流量小时不动作） |
| **现场排查步骤** | 1. HMI画面5查看报警码35黄，画面2确认VW2=99、I8.0与I0.0状态<br>2. 现场检查上游供水压力（压力表）<br>3. 检查管路是否堵塞（过滤网、阀A上游）<br>4. 检查流量开关A I0.0：万用表测端子，应有水流时ON=24V<br>5. 检查流量开关A接线与电源<br>6. 检查流量开关A灵敏度（如可调）<br>7. 检查阀A实际开度（球体位置） |
| **恢复方法** | 1. 恢复上游供水/清除堵塞/修复流量开关<br>2. 消音<br>3. 自动模式：I0.0=ON后FC3 NETWORK5自动R V301.5（条件 `A I0.0`）<br>4. 人工模式：I0.0=ON后HMI画面5报警确认V0.3<br>5. 若已转S_ERROR，需I0.3系统复位按钮回S0 |
| **预防措施** | ①每周检查上游供水压力 ②过滤网季度清洗 ③流量开关A灵敏度年度校准 ④T52确认延时（2秒）现场整定（供水压力低时可延长至3~5秒） |
| **关联变量** | V301.5（报警位）；I8.0（阀A开到位，应=1）；I0.0（流量开关A，应=1但实际=0）；T52（2秒确认计时器）；VW260（Diag_State_A，应=2）；VW266（Diag_Result_A，应=2） |

---

### 3.15 报警码 36：S1启动上缸非空

| 项 | 内容 |
|---|---|
| **报警码** | 36 |
| **报警符号** | M_Alarm_ValveA_S1Start |
| **报警位地址** | V301.6 |
| **优先级** | 一般级（黄色） |
| **触发条件** | FC16 NETWORK2（预规划上升沿触发）：`LD M10.7 A V1.6 S V301.6, 1` —— S5期间预规划触发（M10.7=1，本轮已触发过预规划）准备启动新一轮S1上缸配液时，检查V1.6（上缸状态）=1（非空，异常），置位V301.6 + `MOVB 99, VB2`（转S_ERROR）。正常应为V1.6=0（上缸已排空），异常说明上一轮S4转移未完成或V1.6软件标志与实际不符 |
| **可能原因** | **机械原因**：①阀B故障导致上一轮S4转移未排空上缸 ②阀B关不严导致上缸持续有水 |
| | **电气原因**：①I0.6液位计A-低位失效（误报已排空） ②V1.6软件标志与实际液位不符（断电恢复数据错乱） |
| | **软件或操作原因**：①S4转移未完成就触发预规划（时序异常） ②断电恢复后V1.6状态错乱 ③HMI强制修正V1.6=1（误操作） |
| **现场排查步骤** | 1. HMI画面5查看报警码36黄，画面2确认VW2=99、V1.6状态<br>2. 现场查看上缸实际液位（玻璃缸可见）<br>3. 检查上一轮S4转移是否完成（VW8轮次计数、VD74 S4实测时长）<br>4. 检查阀B是否关到位（I8.3）<br>5. 检查液位计A-低位I0.6是否正常工作<br>6. 检查V1.6软件标志是否与实际液位一致<br>7. 检查是否HMI误操作强制V1.6=1<br>8. 检查断电恢复日志（VW198初始化步骤） |
| **恢复方法** | 1. 现场确认上缸实际液位：若上缸有水，先通过阀B/手动排水排空<br>2. L2维护登录HMI，画面2强制修正上缸状态V0.5（CMD_ForceTankA_Empty）置上缸=空<br>3. PLC执行：R V1.6（上缸=空）<br>4. 消音<br>5. 自动模式：V1.6=0后FC3 NETWORK5自动R V301.6（条件 `AN V1.6`）<br>6. 人工模式：V1.6=0后HMI画面5报警确认V0.3<br>7. 若已转S_ERROR，需I0.3系统复位按钮回S0 |
| **预防措施** | ①S4转移完成确认机制（VW268诊断结果=1才转S5） ②液位计A-低位I0.6月度测试 ③V1.6软件标志与实际液位定期核对 ④断电恢复策略FC0保持V1.6状态，避免错乱 |
| **关联变量** | V301.6（报警位）；V1.6（上缸状态，应=0但实际=1）；M10.7（预规划已触发标志）；V0.5（CMD_ForceTankA_Empty，强制修正命令）；I0.6（液位计A-低位）；VW268（Diag_Result_B，上一轮S4诊断结果）；VD74（VD_S4_Actual，S4实测时长） |

---

### 3.16 报警码 40：阀B四态诊断异常

| 项 | 内容 |
|---|---|
| **报警码** | 40 |
| **报警符号** | M_Alarm_ValveB_Diag |
| **报警位地址** | V302.0 |
| **优先级** | 一般级（黄色） |
| **触发条件** | FC31 NETWORK6（S3四态诊断状态4）：`LD I0.1 NOT AN I0.6 S V302.0, 1` —— S4期间阀B开启转移中（VW262=3运行中），流量开关B I0.1=OFF AND 液位计A-低位I0.6=OFF（状态4：流量开关OFF+液位低位OFF，设备故障），置位V302.0 + `MOVB 99, VB2` + Diag_Result_B=2。**四态诊断**：状态1/2=流量开关ON（正常转移中）；状态3=流量开关OFF+液位低位ON（正常排空，关阀）；状态4=流量开关OFF+液位低位OFF（异常） |
| **可能原因** | **机械原因**：①阀B虽开但管路堵塞（流量开关B无流） ②上缸实际已空但液位计A-低位失效未触发 ③上缸液位计A-低位探头位置偏高 |
| | **电气原因**：①流量开关B I0.1失效（误报OFF） ②液位计A-低位I0.6失效（误报OFF） ③I0.1/I0.6接线松脱 |
| | **软件或操作原因**：①四态诊断状态4瞬时误判（未加延时确认） ②阀B开启初期流量开关尚未ON的过渡期 |
| **现场排查步骤** | 1. HMI画面5查看报警码40黄，画面2确认VW2=99、I0.1与I0.6状态<br>2. 现场检查上缸实际液位（应已排空，但I0.6=OFF说明未检测到低位）<br>3. 检查流量开关B I0.1：阀B开启后应有水流，万用表测I0.1端子<br>4. 检查液位计A-低位I0.6：上缸排空后应ON，验证探头位置与功能<br>5. 检查阀B是否正常开启（Q0.3=1且I8.2=1开到位）<br>6. 检查管路是否堵塞（阀B上下游）<br>7. 检查四态诊断状态4是否加延时确认（FC31注释提示需补延时） |
| **恢复方法** | 1. 修复流量开关B/液位计A-低位故障或清除管路堵塞<br>2. 消音<br>3. 自动模式：I0.1=ON（流量开关B恢复）OR I0.6=ON（液位低位恢复）后FC3 NETWORK5自动R V302.0（条件 `A I0.1 O A I0.6`）<br>4. 人工模式：上述条件消失后HMI画面5报警确认V0.3<br>5. 若已转S_ERROR，需I0.3系统复位按钮回S0 |
| **预防措施** | ①每季度测试流量开关B与液位计A-低位动作可靠性 ②四态诊断状态4加2~3秒延时确认（修改FC31 STL避免瞬时误判） ③上缸液位计A-低位探头位置年度核对 ④管路过滤网季度清洗 |
| **关联变量** | V302.0（报警位）；I0.1（流量开关B）；I0.6（液位计A-低位）；VW262（Diag_State_B，应=3）；VW268（Diag_Result_B，应=2）；Q0.3（阀B输出）；I8.2（阀B开到位） |

---

### 3.17 报警码 41：阀B开到位超时

| 项 | 内容 |
|---|---|
| **报警码** | 41 |
| **报警符号** | M_Alarm_ValveB_OpenTimeout |
| **报警位地址** | V302.1 |
| **优先级** | 一般级（黄色） |
| **触发条件** | FC31 NETWORK4（S1等待开到位）：T53开到位超时计时器（PT=VW274=VD_Timeout_ValveB×10，默认60秒）到达，`LD T53 S V302.1, 1` + `MOVB 99, VB2` + Diag_Result_B=2。开阀B指令下发后T53开始计时，I8.2（开到位反馈）=ON上升沿则转S2并复位T53；T53到达则报警 |
| **可能原因** | **机械原因**：①阀B执行机构卡滞 ②阀B机械限位偏差 ③阀B球体磨损 |
| | **电气原因**：①阀B电动执行器电源故障 ②I8.2开到位反馈限位开关失效 ③I8.2有源信号→继电器转换环节故障 |
| | **软件或操作原因**：①VD_Timeout_ValveB（默认60秒）设定过短 ②FC15开阀指令S Q0.3未生效 |
| **现场排查步骤** | 1. HMI画面5查看报警码41黄，画面2确认VW2=99、I8.2状态<br>2. 现场观察阀B执行机构是否动作<br>3. 检查Q0.3是否已置位<br>4. 手动操作阀B检查机械是否卡滞<br>5. 检查I8.2开到位限位开关与继电器转换环节<br>6. 检查VD_Timeout_ValveB（VD50）<br>7. 检查阀B电源 |
| **恢复方法** | 1. 修复阀B机械/电气故障<br>2. 消音<br>3. 自动模式：I8.2=ON后FC3 NETWORK5自动R V302.1（条件 `A I8.2`）<br>4. 人工模式：I8.2=ON后HMI画面5报警确认V0.3<br>5. 若已转S_ERROR，需I0.3系统复位按钮回S0 |
| **预防措施** | ①每季度测试阀B开到位限位开关动作可靠性 ②VD_Timeout_ValveB现场整定（阀B实际开阀时间×1.5倍） ③阀B电动执行器年度检修 |
| **关联变量** | V302.1（报警位）；I8.2（阀B开到位反馈）；T53（开到位超时计时器）；VW274（PT转换值=VD50×10）；VD50（VD_Timeout_ValveB，默认60秒）；Q0.3（阀B输出，应=1）；VW262（Diag_State_B，应=1）；VW268（Diag_Result_B，应=2） |

---

### 3.18 报警码 42：阀B开到位无流

| 项 | 内容 |
|---|---|
| **报警码** | 42 |
| **报警符号** | M_Alarm_ValveB_OpenNoFlow |
| **报警位地址** | V302.2 |
| **优先级** | 一般级（黄色） |
| **触发条件** | FC31 NETWORK4（T54流量开关超时）：T54流量开关超时计时器（PT=VW274=VD_Timeout_ValveB×10）到达且I0.1=OFF，`LD T54 AN I0.1 S V302.2, 1` + 转S_ERROR + Diag_Result_B=2。**或** FC31 NETWORK5（S2开启完成检查）：`LD I8.2 AN I0.1 S V302.2, 1` —— 阀B开到位I8.2=ON但流量开关B I0.0=OFF（无流），立即报警（无延时） |
| **可能原因** | **机械原因**：①上缸已空但阀B开启后无水可流（液位计A-低位误判提前关阀） ②管路堵塞 ③阀B虽开到位但实际开度极小 |
| | **电气原因**：①流量开关B I0.1失效 ②流量开关B接线断线 ③I8.2限位开关提前误通 |
| | **软件或操作原因**：①T54超时设定不足 ②流量开关B灵敏度设定过低 |
| **现场排查步骤** | 1. HMI画面5查看报警码42黄，画面2确认VW2=99、I8.2与I0.1状态<br>2. 现场检查上缸是否真的有水（液位计A状态）<br>3. 检查管路是否堵塞<br>4. 检查流量开关B I0.1与接线<br>5. 检查阀B实际开度<br>6. 检查I8.2是否提前误通<br>7. 检查VD_Timeout_ValveB |
| **恢复方法** | 1. 修复流量开关B/管路堵塞/阀B机械故障<br>2. 消音<br>3. 自动模式：I0.1=ON后FC3 NETWORK5自动R V302.2（条件 `A I0.1`）<br>4. 人工模式：I0.1=ON后HMI画面5报警确认V0.3<br>5. 若已转S_ERROR，需I0.3系统复位按钮回S0 |
| **预防措施** | ①每季度测试流量开关B动作可靠性 ②管路过滤网季度清洗 ③流量开关B灵敏度年度校准 ④VD_Timeout_ValveB现场整定 |
| **关联变量** | V302.2（报警位）；I8.2（阀B开到位，应=1）；I0.1（流量开关B，应=1但实际=0）；T54（流量开关超时计时器）；VW274（PT转换值）；VD50（VD_Timeout_ValveB）；VW262（Diag_State_B）；VW268（Diag_Result_B，应=2） |

---

### 3.19 报警码 43：阀B关到位超时

| 项 | 内容 |
|---|---|
| **报警码** | 43 |
| **报警符号** | M_Alarm_ValveB_CloseTimeout |
| **报警位地址** | V302.3 |
| **优先级** | 一般级（黄色） |
| **触发条件** | FC31 NETWORK7（S4等待关到位）：T55关到位超时计时器（PT=VW274=VD_Timeout_ValveB×10）到达且I8.3=OFF，`LD T55 AN I8.3 S V302.3, 1` + 转S_ERROR + Diag_Result_B=2。阀B关阀指令下发后（S3状态触发：I0.6=ON且I0.1=OFF，上缸已排空且流量开关B=OFF），T55开始计时，I8.3（关到位）=ON且I0.1=OFF则正常完成；T55到达且I8.3=OFF则报警 |
| **可能原因** | **机械原因**：①阀B执行机构卡滞 ②阀B机械限位偏差 ③阀B球体磨损 |
| | **电气原因**：①阀B电动执行器电源故障 ②I8.3关到位反馈限位开关失效 ③I8.3有源信号→继电器转换环节故障 |
| | **软件或操作原因**：①VD_Timeout_ValveB设定过短 ②关阀指令R Q0.3未生效 |
| **现场排查步骤** | 1. HMI画面5查看报警码43黄，画面2确认VW2=99、I8.3状态<br>2. 现场观察阀B执行机构是否动作<br>3. 检查Q0.3是否已复位（关阀指令）<br>4. 手动操作阀B检查机械是否卡滞<br>5. 检查I8.3关到位限位开关与继电器转换环节<br>6. 检查VD_Timeout_ValveB<br>7. 检查阀B电源 |
| **恢复方法** | 1. 修复阀B机械/电气故障<br>2. 消音<br>3. 自动模式：I8.3=ON后FC3 NETWORK5自动R V302.3（条件 `A I8.3`）<br>4. 人工模式：I8.3=ON后HMI画面5报警确认V0.3<br>5. 若已转S_ERROR，需I0.3系统复位按钮回S0 |
| **预防措施** | ①每季度测试阀B关到位限位开关动作可靠性 ②VD_Timeout_ValveB现场整定 ③阀B电动执行器年度检修 |
| **关联变量** | V302.3（报警位）；I8.3（阀B关到位反馈）；T55（关到位超时计时器）；VW274（PT转换值）；VD50（VD_Timeout_ValveB）；Q0.3（阀B输出，应=0）；VW262（Diag_State_B，应=4）；VW268（Diag_Result_B，应=2） |

---

### 3.20 报警码 44：阀B关到位仍有流（内漏）

| 项 | 内容 |
|---|---|
| **报警码** | 44 |
| **报警符号** | M_Alarm_ValveB_CloseLeak |
| **报警位地址** | V302.4 |
| **优先级** | 一般级（黄色） |
| **触发条件** | FC31 NETWORK7（S4等待关到位）：`LD I8.3 A I0.1 S V302.4, 1` —— 阀B关到位反馈I8.3=ON AND 流量开关B I0.1=ON（仍有流），判定内漏，置位V302.4 + 转S_ERROR + Diag_Result_B=2。即关到位后仍有水流通过，密封泄漏 |
| **可能原因** | **机械原因**：①阀B密封圈老化/破损 ②阀B球体表面磨损 ③阀B装配预紧力不足 |
| | **电气原因**：①流量开关B I0.1误通 ②流量开关B灵敏度设置过高 ③I8.3限位开关提前误通 |
| | **软件或操作原因**：①流量开关B阈值设定过低 ②阀B关到位后水流惯性未消 |
| **现场排查步骤** | 1. HMI画面5查看报警码44黄，画面2确认VW2=99、I8.3与I0.1状态<br>2. 现场听阀B处是否有水流声<br>3. 用量杯接阀B出水口验证渗漏量<br>4. 检查流量开关B I0.1是否误通<br>5. 检查阀B关到位限位开关I8.3是否提前误通<br>6. 检查阀B密封圈外观<br>7. 测试阀B密封性（关闭后保压观察） |
| **恢复方法** | 1. 修复阀B密封或修复流量开关B误通<br>2. 消音<br>3. 自动模式：I0.1=OFF后FC3 NETWORK5自动R V302.4（条件 `AN I0.1`）<br>4. 人工模式：I0.1=OFF后HMI画面5报警确认V0.3<br>5. 若已转S_ERROR，需I0.3系统复位按钮回S0 |
| **预防措施** | ①每季度测试阀B密封性（I8.3=ON状态下保压观察） ②每年更换阀B密封圈 ③流量开关B灵敏度年度校准 |
| **关联变量** | V302.4（报警位）；I8.3（阀B关到位，应=1）；I0.1（流量开关B，应=0但实际=1）；VW262（Diag_State_B，应=4）；VW268（Diag_Result_B，应=2） |

---

### 3.21 报警码 45：阀C四态诊断异常

| 项 | 内容 |
|---|---|
| **报警码** | 45 |
| **报警符号** | M_Alarm_ValveC_Diag |
| **报警位地址** | V302.5 |
| **优先级** | 一般级（黄色） |
| **触发条件** | FC32 NETWORK5（S3四态诊断状态4）：`LD I0.2 NOT AN I1.0 S V302.5, 1` —— S6期间阀C开启排水（VW264=3运行中），流量开关C I0.2=OFF AND 液位计B-低位I1.0=OFF（状态4：流量开关OFF+液位低位OFF，设备故障），置位V302.5 + `MOVB 99, VB2` + MOVW 2, VW270（Diag_Result_C=2故障）。**与阀B四态诊断对称**：状态1/2=流量开关ON（正常排水中）；状态3=流量开关OFF+液位低位ON（正常排空，关阀）；状态4=流量开关OFF+液位低位OFF（异常） |
| **可能原因** | **机械原因**：①阀C虽开但管路堵塞 ②下缸实际已空但液位计B-低位失效未触发 ③下缸液位计B-低位探头位置偏高 |
| | **电气原因**：①流量开关C I0.2失效（误报OFF） ②液位计B-低位I1.0失效（误报OFF） ③I0.2/I1.0接线松脱 |
| | **软件或操作原因**：①四态诊断状态4瞬时误判 ②阀C开启初期流量开关尚未ON的过渡期 |
| **现场排查步骤** | 1. HMI画面5查看报警码45黄，画面2确认VW2=99、I0.2与I1.0状态<br>2. 现场检查下缸实际液位（应已排空，但I1.0=OFF说明未检测到低位）<br>3. 检查流量开关C I0.2：阀C开启后应有水流，万用表测I0.2端子<br>4. 检查液位计B-低位I1.0：下缸排空后应ON，验证探头位置与功能<br>5. 检查阀C是否正常开启（Q0.4=1且I8.4=1开到位）<br>6. 检查管路是否堵塞（阀C下游排水口）<br>7. 检查四态诊断状态4是否加延时确认 |
| **恢复方法** | 1. 修复流量开关C/液位计B-低位故障或清除管路堵塞<br>2. 消音<br>3. 自动模式：I0.2=ON OR I1.0=ON后FC3 NETWORK5自动R V302.5（条件 `A I0.2 O A I1.0`）<br>4. 人工模式：上述条件消失后HMI画面5报警确认V0.3<br>5. 若已转S_ERROR，需I0.3系统复位按钮回S0 |
| **预防措施** | ①每季度测试流量开关C与液位计B-低位动作可靠性 ②四态诊断状态4加2~3秒延时确认 ③下缸液位计B-低位探头位置年度核对 ④排水管路季度清洗 |
| **关联变量** | V302.5（报警位）；I0.2（流量开关C）；I1.0（液位计B-低位）；VW264（Diag_State_C，应=3）；VW270（Diag_Result_C，应=2）；Q0.4（阀C输出）；I8.4（阀C开到位） |

---

### 3.22 报警码 46：阀C开到位超时

| 项 | 内容 |
|---|---|
| **报警码** | 46 |
| **报警符号** | M_Alarm_ValveC_OpenTimeout |
| **报警位地址** | V302.6 |
| **优先级** | 一般级（黄色） |
| **触发条件** | FC32 NETWORK3（S1等待开到位）：T56开到位超时计时器（PT=VW276=VD_Timeout_ValveC×10，默认60秒）到达，`LD T56 S V302.6, 1` + `MOVB 99, VB2` + `MOVW 2, VW270`（Diag_Result_C=2故障）。开阀C指令下发后T56开始计时，I8.4（开到位反馈）=ON上升沿则转S2并复位T56；T56到达则报警 |
| **可能原因** | **机械原因**：①阀C执行机构卡滞 ②阀C机械限位偏差 ③阀C球体磨损 |
| | **电气原因**：①阀C电动执行器电源故障 ②I8.4开到位反馈限位开关失效 ③I8.4有源信号→继电器转换环节故障 |
| | **软件或操作原因**：①VD_Timeout_ValveC（默认60秒）设定过短 ②FC17开阀指令S Q0.4未生效 |
| **现场排查步骤** | 1. HMI画面5查看报警码46黄，画面2确认VW2=99、I8.4状态<br>2. 现场观察阀C执行机构是否动作<br>3. 检查Q0.4是否已置位<br>4. 手动操作阀C检查机械是否卡滞<br>5. 检查I8.4开到位限位开关与继电器转换环节<br>6. 检查VD_Timeout_ValveC（VD54）<br>7. 检查阀C电源 |
| **恢复方法** | 1. 修复阀C机械/电气故障<br>2. 消音<br>3. 自动模式：I8.4=ON后FC3 NETWORK5自动R V302.6（条件 `A I8.4`）<br>4. 人工模式：I8.4=ON后HMI画面5报警确认V0.3<br>5. 若已转S_ERROR，需I0.3系统复位按钮回S0 |
| **预防措施** | ①每季度测试阀C开到位限位开关动作可靠性 ②VD_Timeout_ValveC现场整定（阀C实际开阀时间×1.5倍） ③阀C电动执行器年度检修 |
| **关联变量** | V302.6（报警位）；I8.4（阀C开到位反馈）；T56（开到位超时计时器）；VW276（PT转换值=VD54×10）；VD54（VD_Timeout_ValveC，默认60秒）；Q0.4（阀C输出，应=1）；VW264（Diag_State_C，应=1）；VW270（Diag_Result_C，应=2） |

---

### 3.23 报警码 47：阀C开到位无流

| 项 | 内容 |
|---|---|
| **报警码** | 47 |
| **报警符号** | M_Alarm_ValveC_OpenNoFlow |
| **报警位地址** | V302.7 |
| **优先级** | 一般级（黄色） |
| **触发条件** | FC32 NETWORK3（T57流量开关超时）：T57流量开关超时计时器（PT=VW276=VD_Timeout_ValveC×10）到达且I0.2=OFF，`LD T57 AN I0.2 S V302.7, 1` + 转S_ERROR + Diag_Result_C=2。**或** FC32 NETWORK4（S2开启完成检查）：`LD I8.4 AN I0.2 S V302.7, 1` —— 阀C开到位I8.4=ON但流量开关C I0.2=OFF（无流），立即报警 |
| **可能原因** | **机械原因**：①下缸已空但阀C开启后无水可排（液位计B-低位误判提前关阀） ②排水管路堵塞 ③阀C虽开到位但实际开度极小 |
| | **电气原因**：①流量开关C I0.2失效 ②流量开关C接线断线 ③I8.4限位开关提前误通 |
| | **软件或操作原因**：①T57超时设定不足 ②流量开关C灵敏度设定过低 |
| **现场排查步骤** | 1. HMI画面5查看报警码47黄，画面2确认VW2=99、I8.4与I0.2状态<br>2. 现场检查下缸是否真的有水（液位计B状态）<br>3. 检查排水管路是否堵塞<br>4. 检查流量开关C I0.2与接线<br>5. 检查阀C实际开度<br>6. 检查I8.4是否提前误通<br>7. 检查VD_Timeout_ValveC |
| **恢复方法** | 1. 修复流量开关C/管路堵塞/阀C机械故障<br>2. 消音<br>3. 自动模式：I0.2=ON后FC3 NETWORK5自动R V302.7（条件 `A I0.2`）<br>4. 人工模式：I0.2=ON后HMI画面5报警确认V0.3<br>5. 若已转S_ERROR，需I0.3系统复位按钮回S0 |
| **预防措施** | ①每季度测试流量开关C动作可靠性 ②排水管路季度清洗 ③流量开关C灵敏度年度校准 ④VD_Timeout_ValveC现场整定 |
| **关联变量** | V302.7（报警位）；I8.4（阀C开到位，应=1）；I0.2（流量开关C，应=1但实际=0）；T57（流量开关超时计时器）；VW276（PT转换值）；VD54（VD_Timeout_ValveC）；VW264（Diag_State_C）；VW270（Diag_Result_C，应=2） |

---

### 3.24 报警码 60：阀C关到位超时

| 项 | 内容 |
|---|---|
| **报警码** | 60 |
| **报警符号** | M_Alarm_ValveC_CloseTimeout |
| **报警位地址** | V303.0 |
| **优先级** | 一般级（黄色） |
| **触发条件** | FC32 NETWORK6（S4等待关到位）：T58关到位超时计时器（PT=VW276=VD_Timeout_ValveC×10）到达且I8.5=OFF，`LD T58 AN I8.5 S V303.0, 1` + 转S_ERROR + MOVW 2, VW270（Diag_Result_C=2故障）。阀C关阀指令下发后（S3状态触发：I1.0=ON且I0.2=OFF，下缸已排空且流量开关C=OFF），T58开始计时，I8.5（关到位）=ON且I0.2=OFF则正常完成；T58到达且I8.5=OFF则报警 |
| **可能原因** | **机械原因**：①阀C执行机构卡滞 ②阀C机械限位偏差 ③阀C球体磨损 |
| | **电气原因**：①阀C电动执行器电源故障 ②I8.5关到位反馈限位开关失效 ③I8.5有源信号→继电器转换环节故障 |
| | **软件或操作原因**：①VD_Timeout_ValveC设定过短 ②关阀指令R Q0.4未生效 |
| **现场排查步骤** | 1. HMI画面5查看报警码60黄，画面2确认VW2=99、I8.5状态<br>2. 现场观察阀C执行机构是否动作<br>3. 检查Q0.4是否已复位（关阀指令）<br>4. 手动操作阀C检查机械是否卡滞<br>5. 检查I8.5关到位限位开关与继电器转换环节<br>6. 检查VD_Timeout_ValveC<br>7. 检查阀C电源 |
| **恢复方法** | 1. 修复阀C机械/电气故障<br>2. 消音<br>3. 自动模式：I8.5=ON后FC3 NETWORK5自动R V303.0（条件 `A I8.5`）<br>4. 人工模式：I8.5=ON后HMI画面5报警确认V0.3<br>5. 若已转S_ERROR，需I0.3系统复位按钮回S0 |
| **预防措施** | ①每季度测试阀C关到位限位开关动作可靠性 ②VD_Timeout_ValveC现场整定 ③阀C电动执行器年度检修 |
| **关联变量** | V303.0（报警位）；I8.5（阀C关到位反馈）；T58（关到位超时计时器）；VW276（PT转换值）；VD54（VD_Timeout_ValveC）；Q0.4（阀C输出，应=0）；VW264（Diag_State_C，应=4）；VW270（Diag_Result_C，应=2） |

---

### 3.25 报警码 61：阀C关到位仍有流（内漏）

| 项 | 内容 |
|---|---|
| **报警码** | 61 |
| **报警符号** | M_Alarm_ValveC_CloseLeak |
| **报警位地址** | V303.1 |
| **优先级** | 一般级（黄色） |
| **触发条件** | FC32 NETWORK6（S4等待关到位）：`LD I8.5 A I0.2 S V303.1, 1` —— 阀C关到位反馈I8.5=ON AND 流量开关C I0.2=ON（仍有流），判定内漏，置位V303.1 + 转S_ERROR + MOVW 2, VW270（Diag_Result_C=2故障）。即关到位后仍有水流通过，密封泄漏 |
| **可能原因** | **机械原因**：①阀C密封圈老化/破损 ②阀C球体表面磨损 ③阀C装配预紧力不足 |
| | **电气原因**：①流量开关C I0.2误通 ②流量开关C灵敏度设置过高 ③I8.5限位开关提前误通 |
| | **软件或操作原因**：①流量开关C阈值设定过低 ②阀C关到位后水流惯性未消 |
| **现场排查步骤** | 1. HMI画面5查看报警码61黄，画面2确认VW2=99、I8.5与I0.2状态<br>2. 现场听阀C处是否有水流声<br>3. 用量杯接阀C出水口验证渗漏量<br>4. 检查流量开关C I0.2是否误通<br>5. 检查阀C关到位限位开关I8.5是否提前误通<br>6. 检查阀C密封圈外观<br>7. 测试阀C密封性（关闭后保压观察） |
| **恢复方法** | 1. 修复阀C密封或修复流量开关C误通<br>2. 消音<br>3. 自动模式：I0.2=OFF后FC3 NETWORK5自动R V303.1（条件 `AN I0.2`）<br>4. 人工模式：I0.2=OFF后HMI画面5报警确认V0.3<br>5. 若已转S_ERROR，需I0.3系统复位按钮回S0 |
| **预防措施** | ①每季度测试阀C密封性（I8.5=ON状态下保压观察） ②每年更换阀C密封圈 ③流量开关C灵敏度年度校准 |
| **关联变量** | V303.1（报警位）；I8.5（阀C关到位，应=1）；I0.2（流量开关C，应=0但实际=1）；VW264（Diag_State_C，应=4）；VW270（Diag_Result_C，应=2） |

---

### 3.26 报警码 49：S4 转移等待超时（v1.2 新增）

| 项 | 内容 |
|---|---|
| **触发条件** | FC15 NETWORK 1 等待计时分支: S4 入口 V1.7=1(下缸未排空)持续时间 >= VD_S4WaitTimeout(默认 1800s=30min, HMI 可调)→ S V303.2,1; MOVW 49,VW6 |
| **可能原因** | ①S6 排水故障(阀C卡死/流量开关C失灵/下缸液位计B低位故障)<br>②S6 排水超慢(液体粘度高/排水管路异常)<br>③HMI 强制修正 V1.7=0 异常(S4 已完成但下缸状态未更新)<br>④液位计 B 漂移导致下缸一直显示"满" |
| **响应行为** | 仅提示, **不强制 S_ERROR**; 系统继续等待 S4 互锁, 操作员收到 HMI 提示后: <br>① 排查 S6 排水<br>② 必要时手动 R V1.7 强制下缸=空(通过 HMI)<br>③ 调整 VD_S4WaitTimeout(放宽/收紧) |
| **恢复方法** | 1. 排查 S6 排水异常(见可能原因)<br>2. 消音<br>3. S4 完成时 FC15 NETWORK 3 自动 R V303.2 + 触发转 S5<br>4. 若 S4 仍卡死, 操作员可在 HMI 强制 R V1.7 跳过互锁(应急, 需 L3 权限) |
| **预防措施** | ①定期测试 S6 排水功能<br>②VD_S4WaitTimeout 现场整定(根据 S6 历史最长排水时间+2x 余量)<br>③若 S4 等待频繁, 考虑排查 S6 排水慢的根因(液体粘度/管路/泵效率)<br>④FC15 NETWORK 1 改转液阈值(VD_S4Wait_Time)由 HMI 监控, 趋势曲线追踪 |
| **关联变量** | V303.2(报警位); VD380(VD_S4Wait_Time 等待时长,秒); VD382(VD_S4WaitTimeout 阈值,秒,默认 1800); T61(超时计时器); T62(1s 累加); V1.7(下缸状态); FC15 NETWORK 1(等待计时分支) |

---

### 3.28 报警码 64：注射泵通讯/动作异常

| 项 | 内容 |
|---|---|
| **报警码** | 64 |
| **报警符号** | M_Alarm_SyringePump |
| **报警位地址** | V303.4 |
| **优先级** | 一般级（黄色） |
| **触发条件** | FC13 NETWORK3（轮询注射泵状态码）：`LD SM0.0 LPS AW>= VW4, 4 S V303.4, 1` + `MOVB 99, VB2`（转S_ERROR） —— S3加药期间轮询注射泵状态码VW4（映射自Modbus寄存器41001），状态码≥4（非0/1/2/3正常值）视为错误码，置位V303.4。**Modbus通讯超时无响应**：FC4 ModbusPolling STL注释明确"完整的轮询时序、错误处理、超时检测由Story 1.1补充"，当前FC4为骨架，超时检测未实现。**注意**：VW4=0表示空闲/完成，=1运行中，=2抽液中，=3排液中，≥4为错误码 |
| **可能原因** | **机械原因**：①注射泵丝杆卡滞 ②注射泵阀门切换故障 ③注射器规格不匹配 |
| | **电气原因**：①注射泵485接线断线/松脱 ②注射泵站号/波特率配置错误 ③Modbus通讯受干扰 ④注射泵电源故障 ⑤485总线终端电阻未接 |
| | **软件或操作原因**：①VW204/VW206抽液/排液步数超出最大行程 ②VD_StepResolution设定错误导致步数计算异常 ③注射泵未先执行复位指令（40003） ④Modbus通讯超时阈值未设定 |
| **现场排查步骤** | 1. HMI画面5查看报警码64黄，画面2确认VW2=99、VW4具体值<br>2. HMI画面7通讯维护页查看Modbus通讯状态<br>3. 现场检查注射泵485接线（A/B极性、终端电阻120Ω）<br>4. 检查注射泵站号（40001）与波特率（40019=0x0000=9600）配置<br>5. 检查注射泵电源与指示灯<br>6. 检查VW204/VW206抽液/排液步数是否超出最大行程<br>7. 检查VD_StepResolution（VD18，默认0.2083 µL/步）<br>8. 检查注射泵是否已执行复位指令（40003=1）<br>9. 现场观察注射泵动作状态 |
| **恢复方法** | 1. 修复注射泵机械/电气故障或通讯故障<br>2. 必要时重启注射泵并执行复位指令（VW202=1）<br>3. 消音<br>4. 自动模式：VW4=0（空闲正常）且通讯恢复后FC3 NETWORK5自动R V303.4（条件 `AW= VW4, 0`）<br>5. 人工模式：VW4=0且通讯恢复后HMI画面5报警确认V0.3<br>6. 若已转S_ERROR，需I0.3系统复位按钮回S0 |
| **预防措施** | ①每月测试注射泵Modbus通讯稳定性 ②485总线屏蔽线接地年度检查 ③终端电阻现场核对 ④VD_StepResolution按进样器规格现场核实 ⑤注射泵复位指令（40003）开机必执行一次 ⑥Story 1.1补充Modbus通讯超时检测逻辑 |
| **关联变量** | V303.4（报警位）；VW4（注射泵状态码，应=0但实际≥4）；VW204（MB_Pump_Aspirate抽液步数）；VW206（MB_Pump_Dispense排液步数）；VW202（MB_Pump_Reset复位指令）；VD18（VD_StepResolution）；VD102（VD_Dose_Steps）；VW222（MB_Pump_Position位置反馈） |

---

### 3.29 报警码 65：RTC时钟丢失

| 项 | 内容 |
|---|---|
| **报警码** | 65 |
| **报警符号** | M_Alarm_RTC_Lost |
| **报警位地址** | V303.5 |
| **优先级** | 一般级（黄色） |
| **触发条件** | FC0 NETWORK3（断电恢复路径 - RTC丢失检测）：断电恢复（V304.0=1）时 `READ_RTC VB900`，逐字段BCD比较RTC（VB900~VB905）与DT10（VB10~VB15）：年→月→日→时→分→秒。若任一字段RTC<DT10，跳转nRTCError：`LD SM0.1 S V303.5, 1` + `MOVR 0.0, VD178`（VD_S5_Elapsed无法重算=0）+ `MOVB 99, VB2`（转S_ERROR）+ `MOVW 8, VW198`（步骤=8 RTC错误）。**注意**：DT10未写入（VB10=0）时跳过检测 |
| **可能原因** | **机械原因**：①CPU ST20超级电容失效（长期断电超过7天） ②CPU RTC晶振老化 |
| | **电气原因**：①CPU板载电池（如有）耗尽 ②超级电容充电回路故障 |
| | **软件或操作原因**：①设备长期断电（超过保持期7天） ②首次开机V304.0=1但DT10未初始化（首次开机应为冷启动V304.0=0，但若超级电容失效可能误进入断电恢复路径） ③BCD转秒逻辑跨天场景未补天数×86400（FC0注释明确） |
| **现场排查步骤** | 1. HMI画面5查看报警码65黄，画面2确认VW2=99、VW198（应=8 RTC错误）<br>2. HMI画面8查看PLC当前RTC时间，对比DT10（VB10~VB17）<br>3. 评估设备断电时长：若超过7天，超级电容已失效<br>4. 检查CPU ST20超级电容状态（如有指示）<br>5. 检查是否首次开机误进入断电恢复路径（V304.0状态）<br>6. 检查BCD转秒逻辑（VD186=RTC秒，VD190=DT10秒，跨天场景）<br>7. 现场确认PLC硬件RTC是否需更换电池 |
| **恢复方法** | 1. L3管理员登录HMI，画面8点击"RTC校时"同步HMI时间至PLC<br>2. PLC RTC时间更新为当前时间（晚于DT10）<br>3. 消音<br>4. **注意**：FC3 NETWORK4 V0.3确认时 `LD V303.5 R V303.5, 1` 直接复位（无附加DI条件，由HMI校时后手动确认清除）；FC3 NETWORK5自动模式不复位（V303.5需HMI校时后确认）<br>5. HMI画面5报警确认V0.3，PLC执行FC3 NETWORK4复位V303.5<br>6. 现场按I0.3系统复位按钮回S0<br>7. **注意**：RTC丢失后VD_S5_Elapsed无法重算，FC0已转S_ERROR，需校时后系统复位 |
| **预防措施** | ①避免设备长期断电超过7天 ②定期（每月）开机检查RTC时间准确性 ③现场配置UPS保障PLC供电 ④BCD转秒逻辑跨天场景补天数×86400（修改FC0 NETWORK4/5） |
| **关联变量** | V303.5（报警位）；VB900~VB907（RTC读取结果）；VB10~VB17（DT10时间戳）；VD186（VD_RTC_Now_Sec）；VD190（VD_DT10_Sec）；VD194（VD_RTC_DT_Diff）；VD178（VD_S5_Elapsed，应=0）；V304.0（M_InitDone）；VW198（初始化步骤，应=8） |

---

## 四、附录A：按优先级排序的快速索引表

### 4.1 最高级（红色闪烁，VW6=99）

| VW6 | 符号 | 位地址 | 触发FC | 复位主导 |
|---|---|---|---|---|
| 99 | M_Alarm_SafetyRelay | V300.5 | FC2 NETWORK2（T35 2秒延时） | FC19 NETWORK4（V0.7+I1.2） |

### 4.2 漫溢级（红色，VW6=10~14）

| VW6 | 符号 | 位地址 | 触发FC | 复位主导 |
|---|---|---|---|---|
| 10 | M_Alarm_Overflow_AHigh | V300.0 | FC30 NETWORK1（I0.5=ON） | FC3 NETWORK4（V0.3+I0.5=OFF） |
| 11 | M_Alarm_Overflow_BHigh | V300.1 | FC31 NETWORK1（I0.7=ON） | FC3 NETWORK4（V0.3+I0.7=OFF） |
| 12 | M_Alarm_NCValve_Top | V300.2 | **当前STL未实现置位**，预留接口（Q0.5动作联动） | FC19系统复位 |
| 13 | M_Alarm_NCValve_Bottom | V300.3 | **当前STL未实现置位**，预留接口（Q0.6动作联动） | FC19系统复位 |
| 14 | M_EStop_Latch | V300.4 | FC2 NETWORK1（I1.1下降沿）/ FC0 NETWORK7（断电） | FC19 NETWORK3（I0.3+I1.1=ON） |

### 4.3 节奏级（橙色，VW6=20）

| VW6 | 符号 | 位地址 | 触发FC | 复位主导 |
|---|---|---|---|---|
| 20 | M_Alarm_ScheduleLag | V300.6 | FC40 NETWORK5（三层纠偏用尽） | FC3 NETWORK4 + FC40重置 |

### 4.4 一般级（黄色，VW6=21/30~66）

| VW6 | 符号 | 位地址 | 触发FC | 复位主导 |
|---|---|---|---|---|
| 21 | M_Alarm_ScheduleLag_Warn | V300.7 | FC40 NETWORK5（第2层顺延触发） | 自动 / FC3 NETWORK4 |
| 30 | M_Alarm_ValveA_CloseFlow | V301.0 | FC30 NETWORK8（T51+I0.0=ON） | 自动 / FC3 NETWORK4（I0.0=OFF） |
| 31 | M_Alarm_ValveA_Leak | V301.1 | FC30 NETWORK8（T51+VD312>0.1L） | 自动 / FC3 NETWORK4（I0.0=OFF） |
| 32 | M_Alarm_ValveA_CloseTimeout | V301.2 | FC30 NETWORK8（T51+I8.1=OFF） | 自动 / FC3 NETWORK4（I8.1=ON） |
| 33 | M_Alarm_ValveA_CloseLeak | V301.3 | FC30 NETWORK8（I8.1=ON+I0.0=ON） | 自动 / FC3 NETWORK4（I0.0=OFF） |
| 34 | M_Alarm_ValveA_OpenTimeout | V301.4 | FC30 NETWORK4（T50超时） | 自动 / FC3 NETWORK4（I8.0=ON） |
| 35 | M_Alarm_ValveA_OpenNoFlow | V301.5 | FC30 NETWORK5（T52+I0.0=OFF） | 自动 / FC3 NETWORK4（I0.0=ON） |
| 36 | M_Alarm_ValveA_S1Start | V301.6 | FC16 NETWORK2（M10.7+V1.6=1） | 自动 / FC3 NETWORK4（V1.6=0） |
| 40 | M_Alarm_ValveB_Diag | V302.0 | FC31 NETWORK6（I0.1=OFF+I0.6=OFF） | 自动 / FC3 NETWORK4（I0.1或I0.6=ON） |
| 41 | M_Alarm_ValveB_OpenTimeout | V302.1 | FC31 NETWORK4（T53超时） | 自动 / FC3 NETWORK4（I8.2=ON） |
| 42 | M_Alarm_ValveB_OpenNoFlow | V302.2 | FC31 NETWORK4/5（T54+I0.1=OFF / I8.2=ON+I0.1=OFF） | 自动 / FC3 NETWORK4（I0.1=ON） |
| 43 | M_Alarm_ValveB_CloseTimeout | V302.3 | FC31 NETWORK7（T55+I8.3=OFF） | 自动 / FC3 NETWORK4（I8.3=ON） |
| 44 | M_Alarm_ValveB_CloseLeak | V302.4 | FC31 NETWORK7（I8.3=ON+I0.1=ON） | 自动 / FC3 NETWORK4（I0.1=OFF） |
| 45 | M_Alarm_ValveC_Diag | V302.5 | FC32 NETWORK5（I0.2=OFF+I1.0=OFF） | 自动 / FC3 NETWORK4（I0.2或I1.0=ON） |
| 46 | M_Alarm_ValveC_OpenTimeout | V302.6 | FC32 NETWORK3（T56超时） | 自动 / FC3 NETWORK4（I8.4=ON） |
| 47 | M_Alarm_ValveC_OpenNoFlow | V302.7 | FC32 NETWORK3/4（T57+I0.2=OFF / I8.4=ON+I0.2=OFF） | 自动 / FC3 NETWORK4（I0.2=ON） |
| 60 | M_Alarm_ValveC_CloseTimeout | V303.0 | FC32 NETWORK6（T58+I8.5=OFF） | 自动 / FC3 NETWORK4（I8.5=ON） |
| 61 | M_Alarm_ValveC_CloseLeak | V303.1 | FC32 NETWORK6（I8.5=ON+I0.2=ON） | 自动 / FC3 NETWORK4（I0.2=OFF） |
| 64 | M_Alarm_SyringePump | V303.4 | FC13 NETWORK3（VW4≥4）+ **Modbus超时待Story1.1** | 自动 / FC3 NETWORK4（VW4=0） |
| 65 | M_Alarm_RTC_Lost | V303.5 | FC0 NETWORK3（RTC<DT10） | FC3 NETWORK4（V0.3+HMI校时） |

### 4.5 总计

- **总报警码数量**：28个（含0=无报警）
- **实际报警条目**：27条
- **按优先级分布**：最高级1条 / 漫溢级5条 / 节奏级1条 / 一般级20条

### 4.6 STL实现状态汇总

| 状态 | 报警码 | 说明 |
|---|---|---|
| 已实现 | 99, 10, 11, 14, 20, 21, 30~36, 40~47, 60, 61, 64, 65 | 触发逻辑与复位逻辑均已在STL中实现 |
| **预留接口（未实现置位）** | 12, 13 | 当前STL无显式置位语句，需后续Story补充 |
| **部分实现** | 64 | 状态码错误已实现，Modbus通讯超时检测由Story 1.1补充 |
| **已删除** | ~~66~~ | V303.6流量开关瞬时异常报警已删除（2026-09-08）。三个流量开关各自有独立报警位（V301.0~V303.1），不再需要汇总抖动检测 |

---

## 五、附录B：报警确认与复位流程图（文字描述）

### 5.1 通用报警处置流程

```
[1] 报警触发
     ↓ FC2/FC30/FC31/FC32/FC40/FC11/FC12/FC13/FC16/FC0置位V300.x~V303.x
     ↓ FC3 NETWORK1 优先级链计算VW6（最高优先级未确认报警码）
     ↓ FC3 NETWORK2 灯光Q8.0常亮 + 新报警VW6由0变非0清M_Sound_Latched使Q0.7重鸣

[2] HMI识别
     ↓ HMI画面5读取VW6值，按本字典定位报警码条目
     ↓ HMI画面5报警指示灯阵列显示VB300~VB303所有活动报警位
     ↓ HMI画面2交叉确认DI状态（I0.x/I1.x/I8.5等）

[3] 消音（可选，不影响处置）
     ↓ I0.4就地按钮 OR HMI画面5 V0.4命令
     ↓ FC3 NETWORK3: R Q0.7（关声音）+ S M11.1（消音标志）+ S V1.4（握手）
     ↓ 灯光Q8.0、报警锁存位、VW6、状态机不变

[4] 现场检查与处置
     ↓ 按本字典"现场排查步骤"逐项执行
     ↓ 修复机械/电气/软件故障

[5] 条件消除（DI恢复正常）
     ↓ I0.x/I1.x/I8.5等DI反馈恢复正常
     ↓ V300.x/V301.x/V302.x/V303.x报警位条件已消失

[6] 报警复位（按优先级与模式）
     ├─ 最高级（VW6=99）：FC19 NETWORK4 V0.7 EU + I1.2=ON → R V300.5
     ├─ 漫溢级（VW6=10/11/14）：FC3 NETWORK4 V0.3 EU + DI=OFF → R V300.x
     ├─ 漫溢级（VW6=12/13 NC阀）：FC19系统复位按钮处理
     ├─ 节奏级（VW6=20）：FC3 NETWORK4 V0.3确认 + FC40新一轮重置
     └─ 一般级（VW6=21/30~66）：
         ├─ 自动模式（V200.0=0）：FC3 NETWORK5自动R复位（条件消失）
         └─ 人工模式（V200.0=1）：FC3 NETWORK4 V0.3确认 + 条件消失

[7] VW6重算与消光
     ↓ FC3 NETWORK1 下一周期重算VW6
     ↓ 若所有报警位均复位 → VW6=0
     ↓ FC3 NETWORK2: VW6=0 + 自动模式 → R Q8.0（消光）+ R Q0.7 + R M11.1

[8] 系统复位（若已转S_ERROR）
     ↓ 现场按下物理系统复位按钮I0.3
     ↓ FC19 NETWORK3: I1.1=ON + I0.3 EU + V300.5=0 → R V300.4 + R V1.6/V1.7 + VW2=0（S0）+ VW6=0 + R Q0.7
     ↓ 状态机回S0初始化，恢复运行
```

### 5.2 最高级/漫溢级紧急处置流程

```
[1] 99红闪 / 10~14红 报警触发
     ↓ FC2 NETWORK1/2 或 FC30 NETWORK1 或 FC31 NETWORK1 置位V300.5/V300.0~V300.4
     ↓ VW2=99（转S_ERROR），QB0=0（强制安全输出）

[2] 立即消音（不影响处置）
     ↓ I0.4就地按钮 OR HMI V0.4

[3] 现场确认是否需进一步急停
     ├─ 漫溢严重 / 继电器故障 → 现场按急停按钮I1.1=OFF（若未触发）
     └─ 无需急停 → 直接现场检查处理

[4] 现场检查与处置（按本字典"现场排查步骤"）
     ↓ 检查液位/阀机械/继电器/接线
     ↓ 修复故障

[5] 报警确认（按本字典"恢复方法"）
     ├─ VW6=99：L3管理员HMI V0.7 + I1.2=ON（FC19 NETWORK4）
     ├─ VW6=10/11：HMI V0.3 + I0.5/I0.7=OFF（FC3 NETWORK4）
     └─ VW6=14：现场I0.3系统复位按钮（FC19 NETWORK3）

[6] 系统复位
     ↓ 现场按I0.3系统复位按钮
     ↓ FC19 NETWORK3: VW2=0（回S0）+ V1.6/V1.7=0 + VW6=0

[7] 恢复运行
     ↓ HMI画面1总览页确认单元状态绿色
     ↓ 重新启动实验V0.0（CMD_Start）
```

### 5.3 一般级报警处置流程

```
[1] 21/30~66 黄 报警触发
     ↓ FC30/FC31/FC32/FC12/FC13/FC40/FC0置位V300.7/V301.x/V302.x/V303.x
     ↓ FC3 NETWORK1重算VW6（若高于当前VW6则更新）

[2] HMI识别（画面5查看VW6与指示灯阵列）
     ↓ 按本字典定位报警码条目

[3] 消音（可选）

[4] 现场检查与处置（按本字典"现场排查步骤"）

[5] 条件消除与复位
     ├─ 自动模式（V200.0=0）：
     │   ↓ DI条件消失
     │   ↓ FC3 NETWORK5自动R复位V301.x/V302.x/V303.x
     │   ↓ FC3 NETWORK1重算VW6=0
     │   ↓ FC3 NETWORK2自动R Q8.0消光
     │   ↓ 通常不转S_ERROR，系统继续运行（除VW6=20严重滞后外）
     └─ 人工模式（V200.0=1）：
         ↓ DI条件消失
         ↓ HMI画面5报警确认V0.3
         ↓ FC3 NETWORK4复位V301.x/V302.x/V303.x
         ↓ FC3 NETWORK1重算VW6=0
         ↓ FC3 NETWORK2消光

[6] 若已转S_ERROR（如VW6=20/32/34/35等触发转S_ERROR的报警）
     ↓ 现场按I0.3系统复位按钮回S0
```

### 5.4 急停与系统复位专项流程

```
[1] 急停按下
     ↓ I1.1=OFF（常闭触点断开）
     ↓ FC2 NETWORK1: I1.1 NOT EU S V300.4（急停锁存）+ VW2=99（转S_ERROR）
     ↓ FC2 NETWORK3: QB0=0（强制安全输出）+ S Q0.7（声音）

[2] 安全继电器反馈延时校验（FC2 NETWORK2）
     ↓ V300.4=1 AND I1.2=OFF → T35开始计时（2秒）
     ├─ 2秒内I1.2=ON（动力回路已断开）→ T35未到达，不报警
     └─ 2秒后I1.2仍OFF → T35到达EU → S V300.5（继电器故障最高级报警）

[3] 急停解除与系统复位
     ↓ 现场排查急停原因，处理完毕
     ↓ 旋转释放急停按钮 → I1.1=ON
     ↓ HMI显示黄色"急停已释放，等待系统复位"
     ↓ 检查V300.5是否=1：
         ├─ V300.5=1（继电器故障）→ FC19 NETWORK2跳过系统复位，转NETWORK4
         │   ↓ L3管理员HMI V0.7 + I1.2=ON → R V300.5
         │   ↓ 再按I0.3系统复位按钮
         └─ V300.5=0（无继电器故障）→ FC19 NETWORK3
             ↓ I1.1=ON + I0.3 EU + V300.5=0 → R V300.4 + VW2=0 + VW6=0
             ↓ 状态机回S0

[4] 恢复运行
     ↓ HMI画面1确认单元状态绿色
     ↓ 重新启动实验V0.0
```

---

## 六、文档维护

### 6.1 版本与更新触发

- **本版本**：v1.0（2026-07-18 初版）
- **下次更新触发**：
  1. 报警码12/13/66的STL实现补充后（预留接口落地）
  2. 注射泵Modbus通讯超时检测（Story 1.1）实现后
  3. 四态诊断状态4延时确认逻辑补充后
  4. BCD转秒跨天场景天数补全逻辑补充后
  5. HMI选型确认后通讯协议相关参数更新
  6. 现场调试发现新报警触发条件或参数整定值

### 6.2 与配套文档的关系

- **上位文档**：HMI-PLC变量地址表v1.0 第九章（报警标志与报警码定义）
- **平级文档**：报警字32位解析映射表v1.0（HMI组态素材）、报警现场处置操作指引v1.0（操作员手册）
- **下位文档**：各FC STL源码（FC0/FC2/FC3/FC11/FC12/FC13/FC16/FC19/FC30/FC31/FC32/FC40）
- **本字典比现场处置指引更细一层**：增加原因分类（机械/电气/软件）、关联变量（VD参数/VI状态）、预防措施、STL实现状态标注

### 6.3 调试要点提示

1. **首次调试必查项**：V300.2/V300.3两个预留接口位的STL实现状态，若现场触发Q0.5/Q0.6动作但未报警，需补充置位逻辑。（V303.6已于2026-09-08删除）
2. **参数整定优先级**：VD_Delay_ValveA_Verify（5秒）、VD_Timeout_ValveA/B/C（60秒）、T35（2秒继电器反馈）、T52（2秒开到位无流确认）—— 这些参数现场实测后需整定至合理值。
3. **内漏阈值0.1L**：FC30 NETWORK8 硬编码 `AR> VD312, 0.1`，需根据现场实际渗漏允许值修改STL。
4. **断电恢复策略**：FC0 NETWORK7 阀门动作态（S1~S6）断电转S_ERROR，仅S0/S5/S7/S_ERROR可恢复，调试时务必验证。
5. **报警确认模式**：V200.0现场建议默认=1（人工确认模式），避免一般故障级报警自动复位导致操作员忽略故障；最高级/漫溢级/节奏级不受此模式影响。

---

**文档版本**：v1.0
**编制日期**：2026-07-18
**编制人**：现场调试工程师
**适用范围**：8套缸单元通用（PLC#1~#8，IP 192.168.2.101~108）
**权威编码来源**：FC3 NETWORK1 STL（JMP标签 nCode10~nCode66 逐位赋值）+ HMI-PLC变量地址表v1.0 第九章
**总报警码数量**：29个（含0=无报警），其中实际报警条目28条，按优先级：最高级1 + 漫溢级5 + 节奏级1 + 一般级21
