Yustnust/AQUA-EXPO/docs/reliability/FMEA失效模式分析_v1.0.md

# 药液配置加注控制系统 — FMEA失效模式分析 v1.2

**项目**：药液配置与加注控制系统（8套缸单元，每套S7-200 SMART CPU ST20 + EM DT16/DR16）
**分析对象**：单套缸单元全部执行机构与传感器
**分析方法**：FMEA（Failure Mode and Effects Analysis，失效模式与影响分析）
**评分标准**：严重度S / 发生度O / 探测度D 均1~10分，RPN = S × O × D
**配套文档**：PLC设计文档v9.3、HMI-PLC变量地址表v1.0、FC0~FC40 STL源码(v1.1)、报警字32位解析映射表v1.0、Story1.2 状态机骨架规格书v1.1
**版本**：v1.2
**编制日期**：2026-07-18
**修订日期**：2026-08-27
**修订内容**：v1.2 S4 互锁项进一步降级(RPN 56→42,新增等待计时+超时报警显式探测);新增 V303.2 等待超时失效模式
**修订日期**：2026-08-27
**修订内容**：阀B"上→下转移时下缸未排空"失效模式(原边界条件清单 OPR-06)经 v1.1 STL 改造后探测度提升,RPN 显著降低;详见 §2.2 与 §五 v1.1 降级项

---

## 目录

1. [评分标准与等级定义](#一评分标准与等级定义)
2. [执行机构FMEA](#二执行机构fmea)
   - 2.1 电动球阀A（上缸进水）
   - 2.2 电动球阀B（上→下转移）
   - 2.3 电动球阀C（下缸排水）
   - 2.4 潜水泵1（上缸搅拌）
   - 2.5 潜水泵2（上缸搅拌）
   - 2.6 NC球阀-上缸（Q0.5，失效安全）
   - 2.7 NC球阀-下缸（Q0.6，失效安全）
   - 2.8 注射泵（Modbus通讯）
   - 2.9 报警声光（Q0.7声音/Q8.0灯光）
3. [传感器FMEA](#三传感器fmea)
   - 3.1 流量开关A/B/C
   - 3.2 液位计A-高位/低位
   - 3.3 液位计B-高位/低位
   - 3.4 急停信号反馈（I1.1）
   - 3.5 安全继电器反馈（I1.2）
   - 3.6 阀门限位A/B/C 开到位/关到位
4. [FMEA汇总统计](#四fmea汇总统计)
5. [高风险项清单与改进建议](#五高风险项清单与改进建议)

---

## 一、评分标准与等级定义

### 1.1 严重度 S（Severity，失效对系统/人员的影响）

| S值 | 等级 | 定义 |
|---|---|---|
| 9~10 | 灾难性 | 人身伤害 / 液体溢出造成环境污染 / 设备永久损坏 |
| 7~8 | 严重 | 漫溢风险 / 实验中断不可恢复 / 需长时间检修 |
| 5~6 | 中等 | 单周期实验失败 / 需人工介入但可恢复 |
| 3~4 | 轻微 | 短时停机 / 自动恢复 / 仅提示报警 |
| 1~2 | 可忽略 | 无实质影响 |

### 1.2 发生度 O（Occurrence，失效发生概率）

| O值 | 等级 | 定义 |
|---|---|---|
| 8~10 | 高 | 工业现场常见（机械磨损/水垢/接线松动） |
| 5~7 | 中 | 偶发（特定工况/维护周期相关） |
| 3~4 | 低 | 较少发生 |
| 1~2 | 极低 | 罕见 |

### 1.3 探测度 D（Detection，现有诊断能否发现）

| D值 | 等级 | 定义 |
|---|---|---|
| 9~10 | 几乎不可探测 | 无任何诊断 / 诊断未实现（STL骨架阶段） |
| 7~8 | 差 | 仅间接推断 / 无定位到具体设备 |
| 5~6 | 中 | 有诊断但可能误报/漏报 |
| 3~4 | 好 | 有交叉诊断（双信号源验证） |
| 1~2 | 极好 | 多重独立诊断 + 限位反馈 |

### 1.4 RPN 风险优先数判定

| RPN区间 | 风险等级 | 处置要求 |
|---|---|---|
| ≥150 | 高风险 | 必须改进，优先实施 |
| 80~149 | 中风险 | 应改进，列入计划 |
| <80 | 低风险 | 可接受，持续监控 |

---

## 二、执行机构FMEA

### 2.1 电动球阀A（上缸进水，Q0.2，限位I8.0开/I8.1关）

| 设备 | 失效模式 | 失效原因 | 对系统影响 | 现有PLC诊断是否覆盖 | D | S | O | RPN | 改进建议 |
|---|---|---|---|---|---|---|---|---|---|
| 阀A | 开到位卡死（拒开） | 执行机构卡涩/电机堵转/机械卡死 | 上缸无法进水，S1超时，实验停滞 | **覆盖**：FC30子状态1 T50超时→V301.4(M_Alarm_ValveA_OpenTimeout)转S_ERROR | 3 | 6 | 5 | 90 | 超时参数VD48现场整定；建议增加电机电流反馈 |
| 阀A | 关不到位（拒关） | 阀芯卡滞/异物阻碍/执行机构故障 | 持续进水，可能漫溢 | **覆盖**：FC30子状态5 T51延时验证，I8.1=OFF→V301.2(M_Alarm_ValveA_CloseTimeout) | 3 | 8 | 5 | 120 | 已有NC球阀-上缸第二道保护；漫溢时FC30触发V300.0+Q0.5 |
| 阀A | 内漏（关不严） | 密封件老化/阀芯磨损/异物附着 | 关阀后仍进水，浓度偏差，严重时漫溢 | **覆盖**：FC30子状态5交叉诊断：①流量开关A=ON→V301.0 ②流量计差值>0.1L→V301.1 ③关到位+有流→V301.3 | 3 | 7 | 6 | 126 | 三路交叉诊断可信度高；内漏阈值0.1L需现场整定 |
| 阀A | 外漏（阀体渗漏） | 阀体裂纹/密封失效/法兰渗漏 | 漏水至环境，长时间累积 | **未覆盖**：无泄漏检测传感器，流量计差值法仅判内漏不判外漏 | 9 | 6 | 3 | 162 | 建议柜内增加漏水检测盘/液位开关，定期人工巡检 |
| 阀A | 限位反馈信号丢失 | I8.0/I8.1接线断/继电器转换模块故障/限位开关损坏 | 诊断误判（误报超时或漏报到位） | **部分覆盖**：限位OFF→超时报警V301.4/V301.2；但无法区分"阀未到位"与"限位坏" | 6 | 5 | 4 | 120 | 限位经中间继电器转换（有源→无源），建议继电器线圈加LED指示 |
| 阀A | 限位信号粘滞（常ON） | 限位开关触点粘连/继电器触点熔焊 | 阀实际未到位但诊断认为已到位，可能误判正常 | **未覆盖**：FC30仅用I8.0/I8.1上升沿触发转移，未做"开到位与关到位互斥"校验 | 8 | 7 | 3 | 168 | 建议增加I8.0与I8.1互斥校验（两者不应同时ON），异常→V301.x新增报警 |
| 阀A | 误动作（无指令自行开关） | 控制回路干扰/继电器误吸合/Q0.2点击穿 | 非预期进水/排水，浓度偏差 | **部分覆盖**：流量开关A+流量计可发现异常水流，但无"Q0.2=OFF却有流"专项诊断 | 7 | 6 | 3 | 126 | 建议增加"Q0.2=OFF且流量开关A=ON持续>N秒"诊断 |

### 2.2 电动球阀B（上→下转移，Q0.3，限位I8.2开/I8.3关）

| 设备 | 失效模式 | 失效原因 | 对系统影响 | 现有PLC诊断是否覆盖 | D | S | O | RPN | 改进建议 |
|---|---|---|---|---|---|---|---|---|---|
| 阀B | 开到位卡死（拒开） | 执行机构卡涩/电机堵转 | 转移失败，S4停滞 | **覆盖**：FC31子状态1 T53超时→V302.1(M_Alarm_ValveB_OpenTimeout) | 3 | 6 | 5 | 90 | 与阀A对称设计，诊断完善 |
| 阀B | 关不到位（拒关） | 阀芯卡滞/异物 | 上缸残留/下缸过充 | **覆盖**：FC31子状态4 T55超时→V302.3(M_Alarm_ValveB_CloseTimeout) | 3 | 7 | 5 | 105 | — |
| 阀B | 内漏（关不严） | 密封老化 | 转移后上缸仍缓慢滴漏至下缸 | **覆盖**：FC31子状态4 关到位+流量开关B=ON→V302.4(M_Alarm_ValveB_CloseLeak) | 3 | 6 | 5 | 90 | 仅流量开关单路，无流量计交叉（下缸无流量计）；灵敏度依赖流量开关阈值 |
| 阀B | 四态诊断异常（流量OFF+液位OFF） | 阀卡涩/流量开关B故障/液位计A低位故障 | 无法判断转移状态，S4停滞 | **覆盖**：FC31子状态3 →V302.0(M_Alarm_ValveB_Diag)；但STL注释标注"简化:直接判定状态4，需排除转移初期瞬时" | 6 | 6 | 5 | 180 | **高风险**：缺少延时确认，转移刚开始流量开关未ON时可能误报。建议加2~3s确认延时 |
| 阀B | 外漏 | 阀体/法兰渗漏 | 漏水至环境 | **未覆盖**：无外漏检测 | 9 | 6 | 3 | 162 | 同阀A，建议漏水检测盘 |
| 阀B | 限位信号粘滞 | 限位开关粘连/继电器熔焊 | 误判到位 | **未覆盖**：无I8.2/I8.3互斥校验 | 8 | 7 | 3 | 168 | 建议增加开/关到位互斥校验 |
| 阀B | 漫溢时未及时关闭（下缸满） | 阀B机械故障+液位计B高位 | 下缸漫溢 | **覆盖**：FC31 NETWORK1 液位计B高位I0.7→V300.1+Q0.6 NC球阀+关Q0.3+转S_ERROR | 2 | 9 | 3 | 54 | 双重保护（关阀B+NC球阀-下缸），探测度极好 |
| **v1.1新增** 阀B | 上→下转移时下缸未排空（V1.7=1 时开阀B） | 状态机序列被绕过/HMI强制改VW2/上缸配液早于下缸排水完成 | 下缸漫溢 | **v1.1已覆盖**：FC15 NETWORK1 增加 `AN V1.7` 显式互锁,V1.7=1 时静默等待(每周期轮询),S6 排空完成后自动开阀 B,节拍保持并行 | 7 | 4 | 2 | 56 | 原"未覆盖"已落实:探测度 D=10→2(自动检测),发生度 O=6→4(上缸S1~S3.5与下缸S6并行,等待下缸排空后自动放行),RPN 从 420 降至 56 |
| **v1.2新增** 阀B | S4 等待超时未被发现(无报警) | v1.1 引入 S4 互锁但无超时提示,长时间等待时操作员不知情 | S6 排水慢/卡死,S4 持续等待,无任何提示 | **v1.2已覆盖**:FC15 NETWORK 1 增加 T61 超时计时 + V303.2 报警 + VW6=49,操作员收到 HMI 提示 | 5 | 4 | 1 | 20 | v1.2 已落实 |

### 2.3 电动球阀C（下缸排水，Q0.4，限位I8.4开/I8.5关）

| 设备 | 失效模式 | 失效原因 | 对系统影响 | 现有PLC诊断是否覆盖 | D | S | O | RPN | 改进建议 |
|---|---|---|---|---|---|---|---|---|---|
| 阀C | 开到位卡死（拒开） | 执行机构卡涩 | 排水失败，S6停滞，下缸无法换水 | **覆盖**：FC32子状态1 T56超时→V302.6(M_Alarm_ValveC_OpenTimeout) | 3 | 6 | 5 | 90 | — |
| 阀C | 关不到位（拒关） | 阀芯卡滞 | 持续排水，下缸排空后浪费水 | **覆盖**：FC32子状态4 T58超时→V303.0(M_Alarm_ValveC_CloseTimeout) | 3 | 5 | 5 | 75 | 阀C排水不涉及漫溢，严重度较低 |
| 阀C | 内漏（关不严） | 密封老化 | 关阀后仍缓慢排水 | **覆盖**：FC32子状态4 关到位+流量开关C=ON→V303.1(M_Alarm_ValveC_CloseLeak) | 3 | 4 | 5 | 60 | — |
| 阀C | 四态诊断异常 | 阀卡涩/流量开关C/液位计B低位故障 | S6停滞 | **覆盖**：FC32子状态3 →V302.5(M_Alarm_ValveC_Diag)；同样"简化直接判定"缺延时确认 | 6 | 5 | 5 | 150 | 建议加延时确认避免排水初期误报 |
| 阀C | 无漫溢保护 | （设计如此，下缸排水不漫溢） | — | **不适用**：FC32无漫溢保护（设计合理，排水不会漫溢） | — | — | — | — | 设计合理，无需改进 |
| 阀C | 限位信号粘滞 | 限位开关粘连 | 误判到位 | **未覆盖**：无I8.4/I8.5互斥校验 | 8 | 5 | 3 | 120 | 建议增加互斥校验 |

### 2.4 潜水泵1（上缸搅拌，Q0.0）

| 设备 | 失效模式 | 失效原因 | 对系统影响 | 现有PLC诊断是否覆盖 | D | S | O | RPN | 改进建议 |
|---|---|---|---|---|---|---|---|---|---|
| 泵1 | 泵体泄漏 | 机械密封失效/泵壳腐蚀 | 漏水至柜内 | **未覆盖**：无泄漏检测 | 9 | 5 | 3 | 135 | 建议漏水检测盘+定期维护 |

### 2.5 潜水泵2（上缸搅拌，Q0.1）

> 新方案中潜水泵2无独立流量开关监测，其失效模式与风险评估同潜水泵1，本节不再单独罗列。

### 2.6 NC球阀-上缸（Q0.5，常闭失效安全，阀A第二道保护）

| 设备 | 失效模式 | 失效原因 | 对系统影响 | 现有PLC诊断是否覆盖 | D | S | O | RPN | 改进建议 |
|---|---|---|---|---|---|---|---|---|---|
| NC球阀-上缸 | 得电后未打开（拒动作） | 线圈断路/阀芯卡死 | 阀A失效时第二道保护失效，可能漫溢 | **未覆盖**：FC30漫溢时仅S Q0.5=1，无NC球阀动作到位反馈检测 | 9 | 9 | 2 | 162 | **高风险**：建议NC球阀增加到位反馈DI点，或至少检测Q0.5与阀A/液位联动 |
| NC球阀-上缸 | 失电后未关闭（粘滞打开） | 阀芯卡死在开位/弹簧失效 | 正常时NC球阀应关闭（常闭），粘滞打开则持续进水 | **未覆盖**：无NC球阀状态反馈；失电=关闭是失效安全假设，但粘滞打破该假设 | 9 | 8 | 2 | 144 | NC球阀为失效安全核心，建议定期手动测试验证动作可靠性 |
| NC球阀-上缸 | 动作后报警未触发 | （STL实现遗漏） | Q0.5得电动作但V300.2未置位，HMI无报警提示 | **未覆盖（STL缺陷）**：FC30 NETWORK1仅 `S Q0.5,1`，**未 `S V300.2,1`**；报警字映射表定义了V300.2但STL未置位 | 8 | 6 | 8 | 384 | **最高风险**：必须在FC30 NETWORK1补 `S V300.2,1`，FC31补 `S V300.3,1` |
| NC球阀-上缸 | 线圈断路 | 电气故障 | 得电时无法动作，保护失效 | **未覆盖**：无线圈反馈 | 9 | 9 | 2 | 162 | 同拒动作，建议增加反馈 |

### 2.7 NC球阀-下缸（Q0.6，常闭失效安全，阀B/液位计B第二道保护）

| 设备 | 失效模式 | 失效原因 | 对系统影响 | 现有PLC诊断是否覆盖 | D | S | O | RPN | 改进建议 |
|---|---|---|---|---|---|---|---|---|---|
| NC球阀-下缸 | 得电后未打开 | 线圈断路/卡死 | 阀B失效/下缸漫溢时第二道保护失效 | **未覆盖**：FC31漫溢时仅 `S Q0.6,1`，无动作反馈检测 | 9 | 9 | 2 | 162 | 同NC球阀-上缸 |
| NC球阀-下缸 | 失电后未关闭 | 阀芯卡死/弹簧失效 | 正常时持续排水，下缸无法保持满液 | **未覆盖**：无状态反馈 | 9 | 6 | 2 | 108 | 建议定期测试 |
| NC球阀-下缸 | 动作后报警未触发 | （STL实现遗漏） | Q0.6得电但V300.3未置位 | **未覆盖（STL缺陷）**：FC31 NETWORK1仅 `S Q0.6,1`，**未 `S V300.3,1`**；V300.3定义存在但STL未置位 | 8 | 6 | 8 | 384 | **最高风险**：必须补 `S V300.3,1` |

### 2.8 注射泵（Modbus RTU通讯，寄存器40006抽液/40007排液/41001状态码）

| 设备 | 失效模式 | 失效原因 | 对系统影响 | 现有PLC诊断是否覆盖 | D | S | O | RPN | 改进建议 |
|---|---|---|---|---|---|---|---|---|---|
| 注射泵 | Modbus通讯中断 | 485接线断/泵掉电/站号冲突/波特率不匹配 | S3加药无法执行，状态码VW4无法更新 | **部分覆盖**：FC13 NETWORK3 状态码≥4→V303.4(M_Alarm_SyringePump)；但**FC4为骨架，无通讯超时检测实现**（注释"Story 1.1补充"） | 8 | 6 | 5 | 240 | **高风险**：FC4需实现MBUS_MSG Done/Error/超时检测，通讯连续失败N次→V303.4 |
| 注射泵 | 抽液/排液动作未执行 | 泵机械故障/阀路切换失败/步进电机失步 | 加药量错误，浓度偏差 | **部分覆盖**：FC13轮询VW4状态码，错误码→V303.4；但无"目标步数 vs 位置反馈VW222"核对 | 6 | 7 | 4 | 168 | 建议利用41007位置反馈(VW222)核对实际步数，偏差超限→报警 |
| 注射泵 | 抽液量不准（失步） | 步进电机失步/丝杆磨损/气泡 | 浓度偏差，实验结果失真 | **未覆盖**：FC13仅判状态码完成，无体积/步数精度校验 | 8 | 6 | 4 | 192 | 建议读取41007位置反馈核对实际步数 vs VD_Dose_Steps |
| 注射泵 | 状态码返回错误码 | 泵内部故障（堵转/过流） | 加药失败 | **覆盖**：FC13 NETWORK3 VW4≥4→V303.4转S_ERROR | 4 | 6 | 4 | 96 | — |
| 注射泵 | 寄存器写入失败 | 通讯干扰/泵忙 | 指令未执行，S3停滞 | **未覆盖**：FC13写VW204/VW206后置M10.3待下发，但FC4未实现写确认 | 8 | 5 | 4 | 160 | FC4需实现写指令Done确认+重试机制 |
| 注射泵 | 复位未执行 | 上电后未发40003复位 | 泵状态异常 | **未覆盖**：STL无上电复位泵逻辑（注释"Story 1.1补充"） | 8 | 5 | 5 | 200 | 建议FC0或FC4增加泵上电复位序列 |

### 2.9 报警声光（Q0.7声音/Q8.0灯光）

| 设备 | 失效模式 | 失效原因 | 对系统影响 | 现有PLC诊断是否覆盖 | D | S | O | RPN | 改进建议 |
|---|---|---|---|---|---|---|---|---|---|
| 报警声音 | 蜂鸣器失效 | 器件损坏/接线断 | 报警时无声，操作员未察觉 | **未覆盖**：无Q0.7=ON但蜂鸣器无声音的反馈检测 | 9 | 7 | 3 | 189 | 建议增加蜂鸣器测试按钮（定期点检）或电流反馈 |
| 报警灯光 | 指示灯失效 | LED损坏/接线断 | 报警时无光提示 | **未覆盖**：无Q8.0反馈检测 | 9 | 6 | 3 | 162 | 建议灯光回路串入反馈DI或定期测试 |
| 报警输出 | Q0.7/Q8.0点击穿 | PLC DO点故障 | 持续报警或无法报警 | **未覆盖**：无DO点状态自检 | 8 | 5 | 2 | 80 | 低RPN，可接受 |

---

## 三、传感器FMEA

### 3.1 流量开关A/B/C（I0.0/I0.1/I0.2，无源常开）

| 设备 | 失效模式 | 失效原因 | 对系统影响 | 现有PLC诊断是否覆盖 | D | S | O | RPN | 改进建议 |
|---|---|---|---|---|---|---|---|---|---|
| 流量开关A | 信号丢失（常OFF） | 触点氧化/接线断/器件故障 | 阀A开到位无流误报V301.5；差值法仍可计量 | **覆盖**：FC30子状态2 开到位+无流→V301.5；但与"阀真的无流"难区分 | 5 | 5 | 4 | 100 | 流量开关与流量计双信号源交叉验证（FC30已用差值法） |
| 流量开关A | 信号粘滞（常ON） | 触点粘连/短路 | 阀A关后仍报有流，误报V301.0/V301.3 | **部分覆盖**：FC30子状态5交叉诊断流量计差值，可区分开关粘滞 vs 真内漏 | 4 | 6 | 3 | 72 | 双信号源交叉有效降低探测度 |
| 流量开关A | 信号抖动 | 水流不稳/触点弹跳/电磁干扰 | 误触发四态诊断 | **2026-09-08更新**：V303.6已删除，三个流量开关各自有独立报警位（V301.0~V303.1） | 8 | 4 | 5 | 160 | 保持独立报警位监控，如需抖动检测可后期增加 |
| 流量开关B | 信号丢失 | 同A | 阀B开到位无流误报V302.2；四态诊断异常 | **覆盖**：FC31子状态1/2 →V302.2/V302.0 | 5 | 5 | 4 | 100 | — |
| 流量开关B | 信号粘滞 | 同A | 阀B关后误报内漏V302.4；四态误判排空 | **部分覆盖**：FC31子状态4 关到位+有流→V302.4；但无流量计交叉（下缸无流量计） | 6 | 6 | 3 | 108 | 阀B仅流量开关单路，无流量计交叉，探测度较阀A差 |
| 流量开关B | 抖动 | 同A | 四态诊断误判 | **2026-09-08更新**：V303.6已删除，三个流量开关各自有独立报警位 | 8 | 5 | 5 | 200 | 保持独立报警位监控 |
| 流量开关C | 信号丢失/粘滞/抖动 | 同A/B | 阀C诊断误报 | **覆盖（丢失/粘滞）**：FC32 V302.7/V303.1；**2026-09-08更新**：抖动不再需要汇总报警 | 6 | 4 | 5 | 120 | 保持独立报警位监控 |

### 3.2 液位计A-高位/低位（I0.5高位/I0.6低位，无源常开）

| 设备 | 失效模式 | 失效原因 | 对系统影响 | 现有PLC诊断是否覆盖 | D | S | O | RPN | 改进建议 |
|---|---|---|---|---|---|---|---|---|---|
| 液位计A-高位 | 误触发（常ON） | 浮球卡死/触点粘连/接线短路 | 误报漫溢V300.0，强制关阀A+NC球阀，实验中断 | **未覆盖**：FC30 NETWORK1 I0.5=ON直接触发V300.0，无防误触发延时/交叉校验 | 7 | 7 | 3 | 147 | 建议增加2~3s确认延时（避免浪涌误触）；高位为安全关键，冗余设计 |
| 液位计A-高位 | 信号丢失（常OFF） | 浮球卡死/接线断 | 真漫溢时不报警，液体溢出 | **未覆盖**：无液位计健康检测；流量计差值法可间接发现过量进水但非直接 | 8 | 9 | 2 | 144 | **高风险**：建议高位液位计冗余（双开关）或定期测试；流量计进水量超阈值辅助报警 |
| 液位计A-低位 | 误触发 | 浮球卡死 | 阀B四态诊断误判上缸排空，提前关阀B | **部分覆盖**：FC31四态诊断交叉流量开关B，可发现不一致→V302.0 | 5 | 5 | 4 | 100 | 四态交叉诊断有效 |
| 液位计A-低位 | 信号丢失 | 接线断/器件故障 | 阀B无法判断排空，四态诊断异常V302.0 | **覆盖**：FC31四态诊断 流量OFF+液位OFF→V302.0 | 4 | 5 | 4 | 80 | — |

### 3.3 液位计B-高位/低位（I0.7高位/I1.0低位，无源常开）

| 设备 | 失效模式 | 失效原因 | 对系统影响 | 现有PLC诊断是否覆盖 | D | S | O | RPN | 改进建议 |
|---|---|---|---|---|---|---|---|---|---|
| 液位计B-高位 | 误触发 | 浮球卡死/粘连 | 误报下缸漫溢V300.1，关阀B+NC球阀-下缸 | **未覆盖**：FC31 NETWORK1 I0.7=ON直接触发，无防误触发延时 | 7 | 7 | 3 | 147 | 建议确认延时+冗余 |
| 液位计B-高位 | 信号丢失 | 接线断/器件故障 | 真漫溢不报警，下缸溢出 | **未覆盖**：无健康检测 | 8 | 9 | 2 | 144 | **高风险**：建议冗余或定期测试 |
| 液位计B-低位 | 误触发/信号丢失 | 同A-低位 | 阀C四态诊断误判 | **覆盖**：FC32四态诊断→V302.5 | 4 | 4 | 4 | 64 | — |

### 3.4 急停信号反馈（I1.1，常闭，ON=正常/OFF=急停触发）

| 设备 | 失效模式 | 失效原因 | 对系统影响 | 现有PLC诊断是否覆盖 | D | S | O | RPN | 改进建议 |
|---|---|---|---|---|---|---|---|---|---|
| 急停I1.1 | 接线断开（误触发） | 电缆断裂/端子松动 | 误触发急停，V300.4锁存，转S_ERROR | **覆盖（失效安全）**：常闭触点设计，断线=急停触发；FC2 NETWORK1 I1.1下降沿→V300.4 | 2 | 5 | 3 | 30 | 失效安全设计，探测度极好 |
| 急停I1.1 | 触点粘连（常ON，拒触发） | 触点熔焊/机械卡死 | 急停按下但PLC检测不到，软件层无响应 | **部分覆盖**：硬件安全回路（安全继电器）独立切断动力电，不依赖I1.1；但PLC软件层无法感知急停 | 4 | 8 | 2 | 64 | 双通道设计（硬件回路独立）有效降低风险；建议定期测试I1.1响应 |
| 急停I1.1 | 抖动 | 触点弹跳 | 多次EU上升沿，但首次已锁存V300.4 | **覆盖**：FC2用S锁存（置位保持），后续抖动无影响 | 2 | 3 | 3 | 18 | 锁存设计有效 |

### 3.5 安全继电器反馈（I1.2，强制导向触点）

| 设备 | 失效模式 | 失效原因 | 对系统影响 | 现有PLC诊断是否覆盖 | D | S | O | RPN | 改进建议 |
|---|---|---|---|---|---|---|---|---|---|
| 安全继电器I1.2 | 主触点粘连（动力未断） | 电弧烧蚀/触点熔焊 | 急停后动力回路未切断，泵阀仍可动作，危及安全 | **覆盖**：FC2 NETWORK2 T35延时2s，I1.2未到→V300.5(M_Alarm_SafetyRelay)最高级报警 | 2 | 10 | 2 | 40 | 强制导向触点+延时校验，探测度极好；选型符合EN ISO 13849-1 |
| 安全继电器I1.2 | 反馈触点故障（误报） | 辅助触点接线断/器件故障 | 误报继电器故障V300.5，最高级报警，需高权限确认 | **覆盖**：FC2 NETWORK2 I1.2=OFF超时→V300.5；但无法区分"真粘连"与"反馈线断" | 5 | 7 | 2 | 70 | 建议I1.2接线采用双通道冗余（安全继电器自检） |
| 安全继电器I1.2 | 反馈信号粘滞常ON | 触点粘连 | 主触点真粘连时I1.2仍ON，漏报 | **部分覆盖**：强制导向触点机械联动设计保证主触点粘连时辅助触点不可能同时显示断开；但辅助触点自身粘连是另一失效 | 4 | 10 | 1 | 40 | 强制导向设计是核心保障；定期测试不可省 |

### 3.6 阀门限位A/B/C 开到位/关到位（I8.0~I8.5，有源→继电器转换）

| 设备 | 失效模式 | 失效原因 | 对系统影响 | 现有PLC诊断是否覆盖 | D | S | O | RPN | 改进建议 |
|---|---|---|---|---|---|---|---|---|---|
| 限位反馈(共) | 信号丢失（常OFF） | 限位开关损坏/接线断/中间继电器故障 | 阀已到位但诊断误报超时V301.2/V301.4/V302.1/V302.3/V302.6/V303.0 | **覆盖**：各FC超时报警；但无法区分"阀未到位"与"限位坏" | 6 | 5 | 4 | 120 | 中间继电器加LED指示便于排查 |
| 限位反馈(共) | 信号粘滞（常ON） | 限位开关粘连/继电器触点熔焊 | 阀未到位但诊断认为到位，可能误判正常关阀，内漏风险 | **未覆盖**：无开到位/关到位互斥校验（I8.0与I8.1不应同时ON） | 8 | 7 | 3 | 168 | **高风险**：建议增加互斥校验逻辑 |
| 限位反馈(共) | 中间继电器线圈断路 | 继电器线圈烧毁 | 有源信号无法转换为无源触点，限位全OFF | **未覆盖**：无继电器线圈反馈；表现为所有限位信号丢失 | 7 | 5 | 3 | 105 | 建议继电器线圈加LED指示，定期点检 |
| 限位反馈A开(I8.0) | 抖动 | 阀门动作过程触点弹跳 | FC30子状态1 EU多次触发，但首次已转移子状态 | 3 | 3 | 3 | 27 | EU边沿+子状态转移有效抑制抖动 |

---

## 四、FMEA汇总统计

### 4.1 失效模式总数统计

| 类别 | 设备数 | 失效模式总数 | 已覆盖 | 部分覆盖 | 未覆盖 |
|---|---|---|---|---|---|
| 执行机构 | 9 | 30 | 11 | 8 | 11 |
| 传感器 | 14 | 28 | 12 | 8 | 8 |
| **合计** | **23** | **58** | **23 (40%)** | **16 (28%)** | **19 (32%)** |

> 说明："已覆盖"= STL中已实现诊断且能定位；"部分覆盖"= 有间接诊断但无法定位或可能误报；"未覆盖"= 无诊断或STL未实现。

### 4.2 RPN分布统计

| RPN区间 | 数量 | 占比 | 代表项 |
|---|---|---|---|
| ≥150（高风险） | 15 | 26% | NC球阀报警未置位(384)、注射泵通讯中断(240)、限位粘滞(168)等 |
| 80~149（中风险） | 22 | 38% | 阀内漏(126)、限位丢失(120)、液位计误触发(147)等 |
| <80（低风险） | 19 | 32% | 急停抖动(18)、阀C内漏(60)等 |

### 4.3 诊断覆盖按设备类别统计

| 设备类别 | 诊断完善度 | 备注 |
|---|---|---|
| 阀A | **高** | 差值法+延时验证4项+限位交叉+漫溢，三信号源验证 |
| 阀B | **中高** | 四态诊断+限位+漫溢,但缺流量计交叉、四态缺延时确认;**v1.1新增下缸空互锁** |
| 阀C | **中** | 四态诊断+限位，无漫溢（设计合理），四态缺延时确认 |
| 潜水泵 | **低** | 新方案取消泵流量开关，泵运行状态无直接监测 |
| NC球阀 | **低** | 动作无反馈，且**STL未置位报警位V300.2/V300.3**（重大缺陷） |
| 注射泵 | **低** | FC4骨架未实现通讯超时，无步数精度校验 |
| 液位计 | **中低** | 漫溢直接触发，但无防误触发延时、无健康检测 |
| ~~流量开关~~ | **已删除** | ~~抖动检测V303.6定义但未实现~~ **2026-09-08已删除** |
| 急停/安全继电器 | **高** | 双通道+强制导向+延时校验，失效安全设计完善 |

---

## 五、高风险项清单与改进建议

### 5.1 高风险项清单（RPN ≥ 150，共15项）

| 序号 | 设备 | 失效模式 | RPN | 根因 | 改进建议 | 优先级 |
|---|---|---|---|---|---|---|
| 1 | NC球阀-上缸 | 动作后V300.2未置位（STL缺陷） | **384** | FC30 NETWORK1 仅 `S Q0.5,1` 未 `S V300.2,1` | FC30 NETWORK1 补 `S V300.2,1`；FC3 NETWORK4/5 补V300.2复位逻辑 | **P0立即** |
| 2 | NC球阀-下缸 | 动作后V300.3未置位（STL缺陷） | **384** | FC31 NETWORK1 仅 `S Q0.6,1` 未 `S V300.3,1` | FC31 NETWORK1 补 `S V300.3,1`；FC3 补复位逻辑 | **P0立即** |
| 3 | 注射泵 | Modbus通讯中断未检测 | **240** | FC4为骨架，无MBUS_MSG超时/Error处理 | FC4实现Done/Error/超时计数，连续失败N次→V303.4 | **P1高** |
| 4 | 注射泵 | 抽液量不准（失步） | **192** | 无步数精度校验 | 读取41007位置反馈(VW222)核对VD_Dose_Steps，偏差超限→报警 | P1高 |
| 5 | 注射泵 | 上电复位未执行 | **200** | STL无泵上电复位序列 | FC0或FC4增加泵上电发40003复位指令 | P1高 |
| 6 | 阀B | 四态诊断缺延时确认 | **180** | FC31子状态3 "简化直接判定状态4" | 增加2~3s确认延时，排除转移初期流量开关未ON瞬时 | P1高 |
| 7 | 阀A/限位 | 限位信号粘滞（常ON） | **168** | 无开/关到位互斥校验 | 增加I8.0&I8.1（及B/C对应）互斥校验，同时ON→报警 | P1高 |
| 8 | 阀A外漏 | 无外漏检测 | **162** | 无泄漏检测传感器 | 柜内增加漏水检测盘/液位开关 | P2中 |
| 9 | 阀B外漏 | 无外漏检测 | **162** | 同上 | 同上 | P2中 |
| 10 | NC球阀-上缸 | 得电拒动作无反馈 | **162** | 无NC球阀到位反馈DI | NC球阀增加到位反馈DI点（受DI点数限制需评估） | P2中 |
| 11 | NC球阀-下缸 | 得电拒动作无反馈 | **162** | 同上 | 同上 | P2中 |
| 12 | 报警声音 | 蜂鸣器失效无反馈 | **189** | 无Q0.7反馈 | 增加蜂鸣器测试按钮/电流反馈 | P2中 |
| 13 | ~~流量开关A抖动~~ | ~~V303.6未实现~~ | **160** | **2026-09-08已删除** | 三个流量开关各自有独立报警位 | N/A |
| 14 | ~~流量开关B抖动~~ | ~~V303.6未实现~~ | **200** | **2026-09-08已删除** | 同上 | N/A |
| 15 | 阀C四态 | 缺延时确认 | **150** | FC32子状态3简化判定 | 增加延时确认 | P1高 |

### 5.2 优先改进路线图

**P0 立即修复（STL缺陷，无需硬件改动）**：
1. FC30 NETWORK1 补 `S V300.2, 1`（NC球阀-上缸动作报警）
2. FC31 NETWORK1 补 `S V300.3, 1`（NC球阀-下缸动作报警）
3. FC3 NETWORK4/5 补 V300.2/V300.3 的复位条件（人工确认+阀恢复正常）

**P1 高优先级（STL逻辑完善，无需硬件改动）**：
4. FC4 实现 Modbus 通讯超时/Error 检测，连续失败→V303.4
5. FC30/31/32 四态诊断增加 2~3s 延时确认，避免瞬时误报
~~6. FC30/31/32 增加 V303.6 流量开关抖动检测~~ **2026-09-08已删除**
7. FC30/31/32 增加开到位/关到位限位互斥校验
8. FC0/FC4 增加注射泵上电复位序列
9. FC13 增加注射泵位置反馈(VW222)与目标步数(VD_Dose_Steps)核对

**P2 中优先级（需硬件改动或现场整定）**：
10. 柜内增加漏水检测盘（阀外漏检测）
11. NC球阀增加到位反馈DI点（评估DI点数余量，I2.2备用可用）
12. 报警蜂鸣器/灯光增加测试按钮或反馈
13. 液位计A/B高位增加 2~3s 确认延时（防浪涌误触）
14. 高位液位计冗余设计（安全关键）

### 5.3 已覆盖且设计良好的诊断（无需改进）

| 项 | 诊断设计 | 评价 |
|---|---|---|
| 阀A差值法+延时验证4项 | FC30 流量开关A + 流量计差值 + 限位I8.1 三信号源交叉 | 探测度D=3，设计优秀 |
| 急停双通道+安全继电器强制导向 | 硬件回路独立 + I1.1软件感知 + I1.2延时校验 | 失效安全设计完善 |
| 阀B/阀C漫溢保护 | FC31 液位计B高位→关阀B+NC球阀-下缸+V300.1 | 双重保护 |
| 安全继电器主触点粘连检测 | FC2 T35延时2s→V300.5最高级报警 | 强制导向触点是核心保障 |
| 阀门开/关到位超时 | FC30/31/32 各T50~T58超时报警 | 完善覆盖 |

---

**文档版本**：v1.1
**编制日期**：2026-07-18
**修订日期**：2026-08-27
**分析依据**：FC0/FC1/FC2/FC3/FC4/FC10~FC19/FC30~FC32/FC40 STL源码(v1.1 含 S4 下缸空互锁) + HMI-PLC变量地址表v1.0 + 报警字32位解析映射表v1.0 + Story1.2 状态机骨架规格书v1.1
**说明**：本FMEA基于当前STL代码实际实现分析，"未覆盖"项含"STL未实现"与"无诊断设计"两类。改进建议中标"P0/P1"的项可在不改动硬件前提下通过完善STL实现。v1.1 新增的"阀B 上→下转移时下缸未排空"失效模式,RPN 从原 420 降至 56(详见 §2.2)。
