Yustnust/AQUA-EXPO/docs/commissioning/现场调试SOP_v1.0.md

# 药液配置加注控制系统 — 现场调试SOP v1.0

**项目**: 药液配置加注控制系统
**适用范围**: 8套缸单元(首期1套,后续扩展至8套)
**用途**: 现场调试工程师与操作员的标准操作程序,覆盖开机/日常运行/参数设置/手动操作/急停复位全流程
**配套文档**: PLC设计文档v9.3、报警现场处置操作指引v1.0、HMI用户权限矩阵v1.0

---

## 一、开机SOP

### 1.1 首次开机(每日/长期断电后)

| 步骤 | 操作 | 确认项 | 签字 |
|---|---|---|---|
| 1 | 检查上下缸无液体 | 空缸状态 | □ |
| 2 | 检查所有阀门手动关闭 | 阀A/B/C关闭 | □ |
| 3 | 检查急停按钮释放状态 | I1.1=ON(正常) | □ |
| 4 | 合上24VDC控制回路断路器 | PLC RUN灯亮 | □ |
| 5 | 查看PLC RUN/ERR指示灯 | RUN绿/ERR灭 | □ |
| 6 | 合上220V动力回路断路器 | 泵阀可供电 | □ |
| 7 | HMI上电(选型确认后) | HMI启动正常 | □ |
| 8 | 查看HMI画面1总览 | 单元通讯在线 | □ |
| 9 | 查看PLC状态(VW2) | =0(S0初始化)或断电恢复态 | □ |
| 10 | 查看报警码(VW6) | =0(无报警) | □ |

**⚠️ 异常处理**: 若VW6≠0或VW2=99(S_ERROR),按"报警现场处置操作指引"处理,不得强行启动。

### 1.2 断电恢复开机(短期断电后)

| 步骤 | 操作 | 确认项 |
|---|---|---|
| 1 | 合上24VDC控制回路 | PLC RUN |
| 2 | 查看V304.0 M_InitDone | =1(断电恢复) |
| 3 | 查看VW2状态 | S0/S5/S7/S_ERROR可恢复;S1~S6转S_ERROR |
| 4 | 若VW2=6(S5) | 查看VD_S5_Elapsed已重算,继续运行 |
| 5 | 若VW2=99(S_ERROR) | 按急停复位SOP处理 |
| 6 | 合上220V动力回路 | 泵阀可供电 |
| 7 | 查看V303.5 RTC报警 | 若=1需RTC校时 |

---

## 二、日常运行SOP

### 2.1 启动实验

**前置条件**: VW2=0(S0),VW6=0(无报警),上下缸空,上游纯净水供应正常

| 步骤 | 操作 | 权限 | 确认 |
|---|---|---|---|
| 1 | HMI画面2确认当前单元号 | L1 | □ |
| 2 | 确认参数设置正确(画面4) | L2 | □ |
| 3 | 点击"启动实验"按钮 | L1 | □ |
| 4 | 二次确认弹窗"确认启动?" | L1 | □ |
| 5 | PLC执行V0.0置位 | — | □ |
| 6 | 确认VW2=1(S1进水) | L1 | □ |
| 7 | 监控画面2实时数据 | L1 | □ |

### 2.2 运行监控

**操作员日常监控要点**(画面1总览/画面2详情):

| 监控项 | 正常值 | 异常处理 |
|---|---|---|
| 流程状态VW2 | 1~7(运行中) | =99查报警 |
| 报警码VW6 | 0(无报警) | ≠0查报警指引 |
| 上缸状态V1.6 | 随流程变化 | 与实际液位核对 |
| 下缸状态V1.7 | 随流程变化 | 与实际液位核对 |
| 实验轮次VW8 | 递增 | 不增查S5→S6转换 |
| 实验时长VD96 | 递增 | 不增查下缸是否满 |
| 通讯状态 | 在线 | 离线查网络/PLC |

### 2.3 停止实验

**正常停止**(达到实验目标自动停止):
- VD96≥VD24 → VW2=8(S7)
- HMI显示"实验结束,需人工确认重启"

**手动停止**(操作员主动停止):

| 步骤 | 操作 | 权限 |
|---|---|---|
| 1 | 画面2点击"停止实验" | L1 |
| 2 | 二次确认 | L1 |
| 3 | PLC执行V0.2置位 | — |
| 4 | 确认VW2=8(S7) | L1 |

### 2.4 消音操作

**场景**: 报警蜂鸣器响起,需消音(不影响报警处理)

| 方式 | 操作 | 效果 |
|---|---|---|
| 就地物理消音 | 按I0.4消音按钮 | Q0.7=0(声音关),灯光保持 |
| HMI消音 | 画面2/5点击"消音" | V0.4置位,Q0.7=0 |

**注**: 消音只关声音,不消除报警。报警确认(消光)需单独操作。

### 2.5 报警确认(消光)

**前置条件**: 报警根本原因已消除(如液位下降/阀门修复)

| 步骤 | 操作 | 权限 |
|---|---|---|
| 1 | 画面5查看报警详情 | L1 |
| 2 | 现场确认报警条件已消除 | L1 |
| 3 | 点击"报警确认"按钮 | L1 |
| 4 | PLC执行V0.3置位 | — |
| 5 | 确认V1.3=1,灯光条件消失后灭 | L1 |

**特殊**: 继电器故障(99)需L3管理员+V0.7高权限确认。

---

## 三、参数设置SOP

### 3.1 浓度参数设置(L3管理员)

**场景**: 实验目标浓度变更

| 步骤 | 操作 | 确认 |
|---|---|---|
| 1 | 画面8登录L3管理员权限 | □ |
| 2 | 进入画面4参数设置→浓度组 | □ |
| 3 | 修改VD_C_Set(目标浓度) | 新值:___% |
| 4 | 修改VD_C_Stock(母液浓度,如变更) | 新值:___% |
| 5 | 修改VD_StepResolution(如换进样器) | 新值:___µL/步 |
| 6 | 点击"保存参数" | □ |
| 7 | 二次确认弹窗 | □ |
| 8 | PLC写入VD10/14/18 | □ |

### 3.2 时间周期参数设置(L2维护)

**场景**: 调整换水周期/实验时长/预循环时长等

| 参数 | 地址 | 默认值 | 调整场景 |
|---|---|---|---|
| 换水周期 | VD20 | 30.0min | 实验节奏调整 |
| 实验目标时长 | VD24 | 480.0min | 实验总时长变更 |
| 预循环时长 | VD28 | 120.0s | 搅拌充分度调整 |
| 预循环下限 | VD32 | 30.0s | 纠偏压缩下限 |
| 静止等候 | VD36 | 60.0s | 沉降时间调整 |
| 静止下限 | VD40 | 15.0s | 纠偏压缩下限 |
| 顺延上限 | VD44 | 5.0min | 纠偏顺延最大幅度 |

**操作**: 画面4→时间周期组→修改→保存→二次确认

### 3.3 超时保护参数设置(L2维护)

**场景**: 现场阀门/泵响应时间调整

| 参数 | 地址 | 默认值 | 说明 |
|---|---|---|---|
| 阀A超时 | VD48 | 60.0s | 阀A动作超时保护 |
| 阀B超时 | VD50 | 60.0s | 阀B动作超时保护 |
| 阀C超时 | VD54 | 60.0s | 阀C动作超时保护 |
| 泵1超时 | VD58 | 10.0s | 泵1启动超时 |
| 泵2超时 | VD62 | 10.0s | 泵2启动超时 |
| 阀A验证延时 | VD66 | 5.0s | 阀A关后延时验证 |

### 3.4 报警模式设置(L3管理员)

**场景**: 切换自动恢复/人工确认模式

| 模式 | V200.0 | 说明 |
|---|---|---|
| 自动恢复 | 0 | 一般级报警条件消失自动复位 |
| 人工确认 | 1 | 所有报警需V0.3确认才复位 |

**注**: 漫溢级(10~14)+节奏严重(20)+继电器故障(99)始终强制人工确认,不受此设置影响。

---

## 四、手动操作SOP(L2维护)

### 4.1 进入手动模式

**前置条件**: VW2=0(S0)或VW2=99(S_ERROR),L2维护权限

| 步骤 | 操作 | 确认 |
|---|---|---|
| 1 | 画面8登录L2维护权限 | □ |
| 2 | 进入画面3手动控制 | □ |
| 3 | 确认VW2=0或99(非运行态) | □ |
| 4 | 运行中(VW2=1~7)手动按钮灰色禁用 | □ |

### 4.2 手动阀门操作

**阀A(上缸进水)操作**:

| 步骤 | 操作 | 联锁校验 | 确认 |
|---|---|---|---|
| 1 | 点击"手动开阀A" | 二次确认 | □ |
| 2 | PLC执行V2.4置位 | — | □ |
| 3 | 确认I8.0(开到位)变ON | 60秒内 | □ |
| 4 | 点击"手动关阀A" | 二次确认 | □ |
| 5 | PLC执行V2.5置位 | — | □ |
| 6 | 确认I8.1(关到位)变ON | 60秒内 | □ |

**阀B(上→下转移)操作**:

| ⚠️ 联锁要求 | 上缸必须满(V1.6=1)且下缸必须空(V1.7=0) |
|---|---|

| 步骤 | 操作 | 确认 |
|---|---|---|
| 1 | 确认V1.6=1且V1.7=0 | □ |
| 2 | 点击"手动开阀B" | □ |
| 3 | 确认I8.2(开到位) | □ |
| 4 | 转移完成后关阀B | □ |
| 5 | 确认I8.3(关到位) | □ |

**阀C(下缸排水)操作**:

| ⚠️ 联锁要求 | 下缸必须满(V1.7=1) |
|---|---|

| 步骤 | 操作 | 确认 |
|---|---|---|
| 1 | 确认V1.7=1 | □ |
| 2 | 点击"手动开阀C" | □ |
| 3 | 确认I8.4(开到位) | □ |
| 4 | 排空后关阀C | □ |
| 5 | 确认I8.5(关到位) | □ |

### 4.3 手动泵操作

| 步骤 | 操作 | 确认 |
|---|---|---|
| 1 | 点击"手动启潜水泵1" | □ |
| 2 | PLC执行V3.2置位 | □ |
| 3 | 确认Q0.0=1（泵运行，听声音/观察水流） | □ |
| 4 | 点击"手动停潜水泵1" | □ |
| 5 | PLC执行V3.3置位 | □ |

### 4.4 NC球阀操作(应急)

**⚠️ 仅在阀A/B失效保护场景手动操作**

| 阀 | 操作 | 效果 |
|---|---|---|
| NC球阀-上缸 | 得电 | 打开(阀A失效时第二道保护) |
| NC球阀-下缸 | 得电 | 打开(阀B/液位B报警时保护) |

**注**: NC阀为常闭型,失电=关闭(安全态),得电=打开。正常运行时失电。

---

## 五、急停与复位SOP

### 5.1 急停触发

**场景**: 紧急情况(漫溢/设备故障/人员安全)

| 步骤 | 操作 | 效果 |
|---|---|---|
| 1 | 现场拍下急停按钮 | I1.1=OFF |
| 2 | PLC硬件回路切断动力电 | 泵阀立即失电 |
| 3 | PLC软件锁存V300.4=1 | VW2=99(S_ERROR) |
| 4 | PLC输出安全QB0=0 | NC阀失电关闭 |
| 5 | 报警蜂鸣器响Q0.7=1 | 声音报警 |
| 6 | 安全继电器反馈I1.2 | 2秒内到位,否则V300.5=1(继电器故障) |

### 5.2 急停解除与系统复位

**前置条件**: 急停原因已排除,设备安全可恢复

| 步骤 | 操作 | 确认项 | 签字 |
|---|---|---|---|
| 1 | 现场排除急停原因 | 设备无异常 | □ |
| 2 | 旋转释放急停按钮 | I1.1=ON(恢复) | □ |
| 3 | HMI显示黄色"急停已释放,等待系统复位" | V300.4=1(锁存保持) | □ |
| 4 | 确认V300.5=0(无继电器故障) | 若=1需先处理继电器故障 | □ |
| 5 | 现场按下系统复位按钮I0.3 | 点动 | □ |
| 6 | PLC清除V300.4=0 | FC19执行 | □ |
| 7 | VW2回到0(S0) | 初始化态 | □ |
| 8 | HMI显示正常(S0) | 可重新启动 | □ |

**⚠️ 注意**:
- 急停复位必须现场物理按钮,HMI不直接下发复位命令
- 继电器故障(V300.5=1)同时存在时,系统复位无效,需先HMI高权限确认
- 复位后VW2=0,需重新启动实验(V0.0)

### 5.3 继电器故障高权限确认

**场景**: V300.5=1(报警码99),安全继电器主触点粘连/故障

| 步骤 | 操作 | 权限 | 确认 |
|---|---|---|---|
| 1 | 现场检查动力回路 | 维修人员 | □ |
| 2 | 确认安全继电器修复,I1.2=ON | 维修人员 | □ |
| 3 | HMI画面8登录L3管理员 | L3 | □ |
| 4 | 画面5点击"继电器高权限确认" | L3 | □ |
| 5 | 输入密码二次验证 | L3 | □ |
| 6 | PLC执行: V0.7+I1.2双确认 | — | □ |
| 7 | V300.5=0(继电器故障清除) | — | □ |
| 8 | 按急停复位SOP继续系统复位 | L1 | □ |

---

## 六、HMI权限登录SOP

### 6.1 登录权限

| 步骤 | 操作 | 确认 |
|---|---|---|
| 1 | 画面8系统设置→权限标签页 | □ |
| 2 | 点击对应权限登录按钮(操作员/维护/管理员) | □ |
| 3 | 输入密码 | □ |
| 4 | 确认登录成功,底部状态栏显示权限 | □ |

### 6.2 注销权限

| 场景 | 操作 |
|---|---|
| 主动注销 | 画面8点击"注销" |
| 超时注销 | L2/L3登录后15分钟无操作自动降级L1 |

### 6.3 密码管理

| 规则 | 说明 |
|---|---|
| 初始密码 | 首次登录强制修改 |
| 密码更换 | L2/L3每90天强制更换 |
| 密码强度 | L3需8位含大小写+数字+符号 |
| 错误锁定 | 连续3次错误锁定5分钟 |

---

## 七、RTC校时SOP(L3管理员)

### 7.1 场景

- 首次开机
- V303.5=1(RTC丢失报警)
- 长期断电后RTC不准
- 定期校时(建议每月1次)

### 7.2 操作

| 步骤 | 操作 | 确认 |
|---|---|---|
| 1 | 画面8登录L3管理员 | □ |
| 2 | 查看HMI系统时间 | 当前:___ |
| 3 | 查看PLC RTC时间(画面7) | PLC:___ |
| 4 | 点击"RTC校时"按钮 | □ |
| 5 | 二次确认弹窗 | □ |
| 6 | HMI时间同步至PLC | □ |
| 7 | 验证PLC RTC已更新 | □ |
| 8 | 若V303.5=1,画面5报警确认 | □ |

---

## 八、单元使能配置SOP(L3管理员)

### 8.1 首期1套验证

| 步骤 | 操作 | 确认 |
|---|---|---|
| 1 | 画面8登录L3管理员 | □ |
| 2 | 单元使能标签页 | □ |
| 3 | 1号单元开关置ON | □ |
| 4 | 2~8号单元保持OFF(未接入) | □ |
| 5 | 画面1仅1号卡片彩色,2~8号灰色 | □ |

### 8.2 后续扩展至8套

| 步骤 | 操作 | 确认 |
|---|---|---|
| 1 | 新单元PLC上电+IP配置(192.168.2.10x) | □ |
| 2 | 画面8勾选新单元使能 | □ |
| 3 | 画面1新单元卡片转为彩色显示 | □ |
| 4 | 无需重新下装HMI工程 | □ |

---

## 九、关机SOP

### 9.1 正常关机

| 步骤 | 操作 | 确认 |
|---|---|---|
| 1 | 确认VW2=0(S0)或VW2=8(S7) | 非运行态 | □ |
| 2 | 断开220V动力回路断路器 | 泵阀失电 | □ |
| 3 | 断开24VDC控制回路断路器 | PLC停机 | □ |
| 4 | HMI关机(如有) | — | □ |

### 9.2 紧急关机

**场景**: 紧急情况无法等待正常流程

| 步骤 | 操作 |
|---|---|
| 1 | 按下急停按钮(切动力电) |
| 2 | 断开220V动力回路断路器 |
| 3 | 断开24VDC控制回路断路器 |
| 4 | 处理紧急情况 |

---

## 十、定期维护SOP

### 10.1 每日检查

| 检查项 | 确认 |
|---|---|
| PLC RUN灯常绿 | □ |
| HMI通讯正常 | □ |
| 无活动报警(VW6=0) | □ |
| 上下缸无异常液位 | □ |
| 阀门手动关闭正常(停机时) | □ |

### 10.2 每周检查

| 检查项 | 确认 |
|---|---|
| 急停按钮功能测试(停机时) | □ |
| 系统复位按钮功能测试 | □ |
| 消音按钮功能测试 | □ |
| 报警蜂鸣器/指示灯测试 | □ |
| HMI审计日志导出备份 | □ |

### 10.3 每月检查

| 检查项 | 确认 |
|---|---|
| RTC校时(L3) | □ |
| PLC断电保持测试(模拟断电恢复) | □ |
| 接线端子紧固 | □ |
| 485总线通讯稳定性 | □ |
| 参数备份(画面4导出) | □ |

### 10.4 每季度检查

| 检查项 | 确认 |
|---|---|
| 安全继电器功能测试 | □ |
| NC球阀动作测试 | □ |
| 阀门机械润滑 | □ |
| 密码更换(L2/L3) | □ |

---

## 附录:权限快速参考

| 操作 | L1操作员 | L2维护 | L3管理员 |
|---|---|---|---|
| 启动/停止实验 | ✅ | ✅ | ✅ |
| 消音 | ✅ | ✅ | ✅ |
| 报警确认(消光) | ✅ | ✅ | ✅ |
| 强制修正上下缸状态 | ❌ | ✅ | ✅ |
| 手动阀门/泵操作 | ❌ | ✅ | ✅ |
| 时间周期/超时参数 | ❌ | ✅ | ✅ |
| 浓度参数 | ❌ | ❌ | ✅ |
| 报警模式切换 | ❌ | ❌ | ✅ |
| 单元使能配置 | ❌ | ❌ | ✅ |
| RTC校时 | ❌ | ❌ | ✅ |
| 继电器故障确认 | ❌ | ❌ | ✅ |

---

**文档版本**: v1.0
**创建日期**: 2026-07-15
**说明**: 本SOP为现场调试工程师与操作员的标准操作程序,首期1套调试时按此执行并培训操作员。后续扩展时内容不变,仅单元使能配置增加。
