Yustnust/AQUA-EXPO/docs/reference/McgsProHelp_text/物联网/18.3_远程调试.txt

===  ===

18.3
远程调试
物联网触摸屏接入公网后，通过
MCGS
调试助手，可以在“
PC/
手机客户端
VPN
服务器
触摸屏”三者之间建立
VPN
通道，实现远程调试功能。
18.3.1
服务器部署
使用远程调试功能需要部署
VPN
服务器，服务器地址支持
IP
和域名。用户可以使用厂家提供的公用
VPN
服务器，或者选择自建
VPN
服务器。
Ø
公用
VPN
服务器
l
公用
VPN
服务器地址：
pub.mcgscloud.com
l
公用
VPN
服务器密码：无
Ø
自建
VPN
服务器：
自建
VPN
服务器方法，请致电触摸屏厂家或联系当地销售
获取。
18.3.2
客户端安装
电脑端
MCGS
调试助手支持
Win7
及以上版本，安装步骤如下：
Ø
安装流程
（
1
）拷贝客户端安装程序“
MCGS
调试助手
.exe
”到电脑，双击安装程序，选择安装路径后点击“下一步”。
图
18.3-1
选择安装路径
（
2
）选择是否创建桌面快捷方式，点击“下一步”。
图
18.3-2
创建快捷方式
（
3
）点击“安装”按钮，等待
MCGS
调试助手安装完成。
图
18.3-3
完成安装
（
4
）安装完成后，通过创建的桌面快捷方式或
Windows
开始菜单，启动
MCGS
调试助手。
18.3.3
客户端配置
触摸屏需要接入
VPN
服务器，然后才能进行远程调试。下面讲解如何配置触摸屏物联网参数和
MCGS
调试助手。
Ø
配置物联网参数
（
1
）参数配置
触摸屏上电启动时按照提示点击触摸屏，进入系统配置界面。在系统配置界面依次点击“系统参数设置
→ 物联网”，配置触摸屏物联网参数。
图
18.3-4
配置物联网参数
功能解释：
l
服务地址：触摸屏接入的
VPN
服务器地址，默认接入公用
VPN
服务器“
pub.mcgscloud.com
”（公用
VPN
服务器无服务密码），用户也可使用自建服务器，服务地址支持域名和
IP
。
l
设备名称：触摸屏在
MCGS
调试助手中显示的名称，默认为空，首次使用时需要用户自行设置。
l
用户名：触摸屏的管理凭据，默认为空，区分大小写。首次使用时需要用户自行设置。
l
密码：触摸屏的管理凭据，默认为空，区分大小写。首次使用时需要用户自行设置。
l
VNC
密码：
VNC
浏览触摸屏运行画面的密码凭据，区分大小写。默认
VNC
密码为“
11111111
”，用户可自行修改。
（
2
）设备上线
触摸屏物联网参数配置完成，且成功通过
4G
或
WiFi
接入公网。勾选下图“开机自动上线”，触摸屏启动后将自动接入指定
VPN
服务器，用户也可手动点击“上线”或“下线”按钮，接入或断开服务器连接。
图
18.3-5
设备上线
注意：触摸屏处于“在线”状态，才能通过
MCGS
调试助手对其进行远程调试。
（
3
）导出设备信息
将
U
盘（
FAT32
格式）插入触摸屏，点击下图“导出”按钮，导出设备信息到“
U
盘根目录 →
DeviceList.csv
”。支持使用同一个
U
盘，在不同触摸屏上导出设备信息。
图
18.3-6
导出设备信息
（
4
）用户可以组态
VPN
驱动，实现在工程运行时监控和配置触摸屏的物联网参数，触摸屏的
VPN
功能不依赖
VPN
驱动。
VPN
驱动使用说明参考该驱动的“设备帮助”。
Ø
导入设备信息
（
1
）在电脑端运行“
MCGS
调试助手”，进入设置界面，点击导入按钮
，选择事先导出的设备信息文件“
DeviceList.csv
”，点击“确认”导入设备信息。
图
18.3-7
导入设备信息
通过导出按钮
，用户可以将已导入
MCGS
调试助手的设备信息重新导出。
Ø
配置服务器
为了使
MCGS
调试助手远程联机触摸屏，图
18.3-7
配置的
VPN
服务地址，与图
18.3-4
配置的服务地址必须一致。本次测试采用默认公用
VPN
服务器“
pub.mcgscloud.com
”。由于公用
VPN
服务器无密码，“服务密码”留空。
Ø
三方程序
对触摸屏进行远程调试需要
VPN
和
VNC
功能支持。安装电脑端
MCGS
调试助手，将自动安装
VPN
应用和
VNC
应用。
Ø
用户登录
（
1
）在电脑端
MCGS
调试助手登录选择“远程调试”，并输入用户名和密码，点击“登录”。注意，
MCGS
调试助手登录用户名和密码必须和图
18.3-4
一致。
（
2
）如下图，登录成功后，
MCGS
调试助手显示设备列表。点击图中的“类型”、“联网”、“设备编号”、“设备名称”、“状态”、“内网
IP
”、“
ICCID
”，可对当前设备列表进行排序。
图
18.3-9
设备列表
功能解释：
l
联机：联机在线设备，设备联机成功后，才可以对设备进行远程调试
l
VNC
：对已联机设备进行
VNC
浏览
l
穿透：对已联机设备进行串口穿透
l
保存：保存当前在线设备列表信息至本地
l
刷新：刷新设备列表状态
l
注销：注销登录
l
搜索：输入关键字，调试助手将在设备编号
/
设备名称
/ICCID
中，搜索并显示包含搜索关键字的设备
（
3
）鼠标选中“在线”设备，点击菜单栏“联机”按钮，联机成功后，设备状态显示为“联机”。如下图所示，本次联机的内网
IP
为：
10.9.43.3
图
18.3-10
设备联机
（
4
）设备联机成功后，在电脑的“网络连接”中可以看到虚拟网卡“
TAP-Windows
Adapter V9
”处于连接状态，如下图所示。
图
18.3-11
查看虚拟网卡
使用远程调试功能，必须先通过
MCGS
调试助手联机该触摸屏。
特别提示：
l
如果不导入设备信息到
MCGS
调试助手，在触摸屏接入
VPN
服务器后，用户仍然可以在
MCGS
调试助手登录界面直接输入“用户名”和“密码”，登录查看
“
在线”
的触摸屏设备。
18.3.4
远程下载
本节主要讲解在电脑端远程下载触摸屏工程。
（
1
）如图
18.3-10
，“联机”触摸屏的内网
IP
为：
10.9.43.3
；触摸屏
LAN
口
IP
保持默认：
200.200.200.190
。
（
2
）运行触摸屏组态软件，完成工程组态后，按下“
F5
”键，进入下载配置。
（
3
）如下图所示，在“目标机名”位置输入联机触摸屏的
LAN
口
IP
或内网
IP
，通讯测试正常后，点击“工程下载”即可远程将工程下载到触摸屏；如果触摸屏中的工程支持上传，还可点击“工程上传”，上传触摸屏中工程到电脑。
图
18.3-12
远程下载工程
18.3.5
远程监控
本节主要讲解在电脑端通过
VNC
远程监控触摸屏画面。
如下图所示，触摸屏联机成功，选中联机设备，点击
MCGS
调试助手菜单栏中的“
VNC
”按钮，显示联机设备运行画面，用户可以点击
VNC
画面进行操作。
图
18.3-13 VNC
浏览触摸屏画面
注意：
l
如果用户在触摸屏中设置了
VNC
密码（触摸屏
VNC
密码设置参考图
18.3-4
），启动
VNC
浏览时，需要手动输入
VNC
密码。
l
启动
VNC
浏览时，可能会出现图
18.3-14
所示的警告画面，点击“
Continue
”即可。
图
18.3-14
警告提示
l
点击图
18.3-15
中的
VNC
设置按钮，可以设置
VNC
画质。
图
18.3-15 VNC
画质设置
18.3.6
网口穿透
本节主要讲解远程通过触摸屏
LAN
口进行
PLC
穿透的方法。
实现网口穿透需要将
PLC
通过网线接入触摸屏
LAN
口，且二者保持在同一网段。本节教程以
Smart200
为例，设置
Smart200 IP
地址：
200.200.200.178
；触摸屏
IP
：
200.200.200.190
。
（
1
）电脑端运行
MCGS
调试助手，触摸屏“联机”成功。
（
2
）电脑端运行
Smart200
组态软件
STEP7
，如下图所示，在
STEP7
的“通信”页面选择虚拟网卡“
TAP-Windows Adapter V9
”。
图
18.3-16
选择网卡
（
3
）在“
TAP-Windows Adapter V9
”网卡下添加
CPU
，输入
Smart200
的
IP
地址“
200.200.200.178
”。
图
18.3-17
添加
CPU
（
4
）选择添加的
PLC
，点击下图所示的“下载”按钮，就可以远程将
PLC
程序下载到
Smart200
。
图
18.3-18
下载
PLC
程序
（
5
）同理，通过网口穿透还可以上传
PLC
工程，以及进行
PLC
在线调试。
18.3.7
串口穿透
本节主要讲解远程通过触摸屏串口进行
PLC
穿透的方法。
实现
PLC
串口穿透需要将
PLC
接入触摸屏通讯串口。本节教程以三菱
FX2N PLC
为例，先将
FX2N
通过
RS422
接入触摸屏的
COM9
串口。
（
1
）电脑端运行
MCGS
调试助手，联机触摸屏，获取内网
IP
：
10.9.43.3
。
（
2
）如下图所示，依次进入串口穿透界面 → 安装虚拟串口（仅首次使用串口穿透才需要安装）→ 检查内网
IP
是否正确 → 选择
HMI
串口（本次测试
FX2N
通过
RS422
接入触摸屏
COM9
）→
开启穿透。
图
18.3-19
开启串口穿透
（
2
）串口穿透界面左下角提示“穿透开启成功”，运行三菱
PLC
编程软件
GX Works2
，进入连接目标设置。“
COM
端口”选择图
18.3-19
中的虚拟串口“
COM3
”，设置完成点击“确定”。
图
18.3-20
设置串口参数
（
3
）点击“通信测试”，显示成功与
FX2N
连接。
图
18.3-21
通信测试
（
4
）通过
GX Works2
编程软件的菜单栏 → 在线 →
PLC
写入，远程将工程下载到
FX2N
。
图
18.3-22
下载工程到
FX2N
注意：通过串口下载
PLC
工程时，除了选择正确的
COM
口，部分
PLC
组态软件可能还会要求输入目标
PLC
的串口通讯参数（波特率、数据位、停止位、校验方式）。
串口穿透支持列表：
序号
品牌
型号
串口穿透
1
三菱
FX3U
支持
2
三菱
FX2N
支持
3
欧姆龙
CJ2M-CPU33
支持
4
欧姆龙
CJ2M-CPU13
支持
5
欧姆龙
CP1H
支持
6
信捷
XC3
支持
7
永宏
FATEK-FBs
支持
8
台达
台达
DVP-48EH
支持
9
LG
LG_MasterK
编程口
支持
10
和利时
LM
支持
11
松下
FP-X C14T
支持
12
西门子
S7-200PPi
支持
如果用户需要串口穿透其他型号
PLC
，请致电设
备厂商或联系当地销售及技术人员确认。
18.3.8
保存列表
MCGS
调试助手提供保存设备列表到本地的功能
。
如下图所示，当设备列表中出现未保存在本地的设备时，点击菜单栏的“保存”按钮，可将当前设备列表中的设备保存至本地。
图
18.3-23
保存设备列表到本地
18.3.9
手机调试
在安卓手机中安装“
MCGS
调试助手
.apk
”后
,
实现通过手机对物联网触摸屏进行远程调试。
以华为手机为例，通过手机进行远程调试方法如下。
Ø
安装流程
（
1
）拷贝安卓客户端“
MCGS
调试助手
.apk
”到手机存储，点击“
MCGS
调试助手
.apk
→ 继续安装”，安装完成后会自动在手机桌面生成快捷图标。
图
18.3-24
安装
MCGS
调试助手
（
2
）在手机端点击
，启动
MCGS
调试助手。首次启动助手可能会弹出提示框“是否忽略电池优化”，点击“允许”即可。
Ø
安卓客户端配置
安卓客户端配置方法与
PC
端类似，配置步骤如下：
（
1
）设备导入和服务器配置
如下图所示，手机端运行
MCGS
调试助手，点击“设置”，导入设备列表文件
DeviceList.csv
；服务器地址默认采用公用
VPN
服务器
pub.mcgscloud.com
，服务密码为空。
图
18.3-26
设备导入和服务器配置
注意：
首次导入设备文件时，系统会询问是否允许“调试助手”访问您设备上的照片、媒体内容和文件，请选择“始终允许”，如下图所示。
图
18.3-27
允许助手访问文件
（
2
）安装
VPN
应用和
VNC
应用
远程调试需要
VPN
和
VNC
功能支持，安卓平台需要用户手动安装“
VPN
应用”和“
VNC
应用”。以
VPN
应用安装方法为例，如下图，点击
VPN
应用旁边的“安装”按钮，在软件安装界面选择“继续安装”，完成
VPN
应用安装流程。
图
18.3-28
安装
VPN
应用
注意：
首次安装
VPN
应用，系统会询问是否允许“调试助手”访问您设备上的照片、媒体内容和文件，请选择“始终允许”，并在弹出的“安装外部来源应用”界面，打开选项“允许安装应用”，如图
18.3-29
所示。
图
18.3-29
开放安装权限
（
3
）“
VNC
应用”安装方法与“
VPN
应用”相同，
VNC
应用和
VPN
应用安装完成后，在
MCGS
调试助手界面点击“确认”，完成手机调试助手配置。
（
4
）
VPN
应用安装完成后，需要手动为程序 “
OpenVPN for Android
”赋予关联启动权限。仍然以华为手机为例，进入“手机管家 → 应用启动管理”，找到“
OpenVPN for Android
”，设置“允许关联启动”项为打开状态，操作流程如下图所示。
图
18.3-30
设置
OpenVPN
关联启动
注意：
用户可以通过手机自带的软件管家，开启“
OpenVPN for Android
”的关联启动权限权限。部分其他手机厂商关联启动权限设置方法如下：
l
小米手机：手机管家
→ 应用管理 → 权限 → 自启动管理，找到“
OpenVPN for Android
”，打开程序自启动权限。
l
vivo / IQOO
：
i
管家 → 应用管理 → 权限管理 → 权限 → 自启动
→ 关联启动，找到“
OpenVPN for Android
”，允许程序关联启动。
l
oppo
手机：手机管家 → 权限隐私 → 关联启动管理，找到“
OpenVPN for Android
”，允许程序关联启动。
Ø
手机调试
（
1
）如下图，在手机
MCGS
调试助手登录，输入用户名和密码（用户名和密码需要与图
18.3-4
一致），点击“登录”进入设备列表界面。选中“在线”设备，点击“联机”，设备联机成功后，设备状态也将显示“联机”，联机成功后可以向左滑动触摸屏，查看设备内网
IP
，本次获得的内网
IP
地址为“
10.9.55.2”
图
18.3-31
手机联机设备
注意：
首次联机设备，系统会要求赋予“
OpenVPN for Android”
权限，请按照下图所示，选择信任此应用，并允许
OpenVPN
for Android
设置
VPN
连接。
图
18.3-32
建立
VPN
连接
（
2
）联机成功后，选中已联机设备，点击图
18.3-31
中的“
VNC
”按钮，再按照下图所示操作，开启
VNC
浏览。
图
18.3-33
启动
VNC
浏览
（
3
）如下图，手机
VNC
显示联机触摸屏设备的运行画面。点击图中的
，还可以设置
VNC
画质。
图
18.3-34
手机
VNC
浏览
特别提示：
l
如果不导入设备信息到手机端
MCGS
调试助手，在触摸屏接入
VPN
服务器后，用户仍然可以在
MCGS
调试助手登录界面直接输入“用户名”和“密码”，登录查看
“
在线”
的触摸屏设备。
