Yustnust/AQUA-EXPO/docs/reference/McgsProHelp_text/物联网/18.4_本地调试.txt

===  ===

18.4
本地调试
18.4.1 PC
本地调试
只要是具
备
LAN
口的触摸屏，都可以在
PC
端运行
MCGS
调试助手进行本地调试。通过触摸屏
LAN
口进行本地调
试，步骤如下：
Ø
IP
设置
如下图，将触摸
屏
LAN
口
IP
、电脑
IP
地址设置为同一网
段，并用网
线连接触摸屏
LAN
口和
电脑。
18.4-1
IP
设置
Ø
连接触摸屏
电脑端运行
MCGS
调试助手，选择“本地调试”，输入触摸屏
LAN
口
IP
地址，点击连接，显示触摸屏列表。
Ø
本地调试
本地调试无需联机操作，选中设备后，用户可直接点击
“
VNC
”或“穿透”，实现
VNC
浏览和串口穿透功能，
VNC
功能参考章节
18.3.5
，网口穿透参考章节
18.3.6
，串口穿透参考章节
18.3.7
。
18.4.2
手机本地调试
用户可以利用具备
WiFi
功能的触摸屏，或者通过触摸屏的
LAN
口，对触摸屏使用手机进行本地调试。下面讲解通过安卓手机对
WiFi
屏进行本地调试。
Ø
连接
WiFi
手机和触摸屏通过
WiFi
连接到同一个路由器，如下图所示，手机和触摸屏均连接同一个
WiFi
，触摸屏
WiFi
网卡
IP
地址为：
192.168.3.57
。
图
18.4-2
连接
WiFi
Ø
连接触摸屏
手机端运行
MCGS
调试助手，选择“本地调试”，输入触摸屏
WiFi
网卡
IP
地址后，点击“连接”，显示设备列表。
Ø
本地调试
本地调试无需联机操作，选中设备后，用户可直接点击
“
VNC
”，实现
VNC
浏览触摸屏，
VNC
功能参考章节
18.3.5
。
